MitjaGrecky/Shtuka-druka/hardware/README.md

# Hardware

KiCad 10 projects. Each board is generated by Python scripts in its `gen/` folder; CI (`.github/workflows/kicad.yml`)
runs ERC, DRC with schematic parity and exports BOM, Gerbers and placement files on every push.
Board map and reasoning: `docs/ru/29_board_map.md`.

| Board | What | Status | Spec |
|---|---|---|---|
| [`m1-screen-knobs`](m1-screen-knobs/) | 8 encoders with touch and 13-LED rings under the screen | rev 0.1, routing (see `UNROUTED`, `QUILTER.md`) | `docs/ru/30_m1_screen_knobs.md` |
| [`w1-levels`](w1-levels/) | Volume pots, P48 buttons, window for M5 | rev 0.1, routed | `docs/ru/31_w1_levels.md` |

License: CERN Open Hardware Licence Version 2 - Strongly Reciprocal (CERN-OHL-S-2.0), see `LICENSE`.
