MitjaGrecky/Shtuka-druka/hardware/for-routing/README.md

# Платы для самостоятельной разводки в EasyEDA Pro

*Подготовлено 12.11.2026. Что здесь: платы «Штуки Дрюка» с готовой схемой, контуром, крепёжными отверстиями и расстановкой деталей, которые задаёт панель. Осталось развести дорожки. Правила: [RULES.md](RULES.md), как платы соединяются: [SYSTEM.md](SYSTEM.md), детали: [COMPONENTS.md](COMPONENTS.md).*

## Состояние папки

| Плата | Что | Слои | Размер, мм | Готовность |
|---|---|---|---|---|
| [M1](M1/) | Модуль 8 ручек экрана, кольца из 12 огней, драйверы LP5864 | 4 | 224 × 34 | готова к разводке, импорт в EasyEDA проверен (M1_v2) |
| [W1](W1/) | Громкости, кнопки P48, окно под M5 | 2 | 92 × 126 | готова к разводке, импорт в EasyEDA проверен (W1_v4) |
| [M3](M3/) | Модуль Tempo + Swing: 2 энкодера, кольца из 12 огней, один LP5864, без касания (P102) | 2 | 92 × 34 | готова к разводке, импорт в EasyEDA проверен (M3_v5, rev 0.2: кольца r 15 по макету); собрана на ПК (KiCad 10, `tools/pack_easyeda.py`) |
| [M4](M4/) | Модуль FX Mix + Filter: 2 энкодера, кольца из 12 огней, один LP5864 | 2 | 70 × 34 | rev 0.2: кольца r 15 по макету, плата шире; импорт проверен (M4_v3) |
| [M5](M5/) | Модуль Gain 1 + 2 на наклоне в окне W1: кольца из 11 огней + 2 огня Clip, один LP5864 | 2 | 84 × 34 | rev 0.2: до x 99 (В1), кольца r 10,5; импорт проверен (M5_v3); окно в W1 расширяет облако |
| [W2](W2/) | Индикаторы уровня L и R на наклоне: 2 × 14 огней, два LP5864 | 2 | 35 × 126 | готова к разводке, импорт в EasyEDA проверен (W2_v4); DRC — в CI |
| [W3](W3/) | System на наклоне: Save, Project (по 2 огня), огонь записи у кармана USB/SD; один LP5864, один 74HC165 | 2 | 92 × 48 | импорт проверен (W3_v2); Power — панельная кнопка на проводе к Mini-ITX (В9), не на плате |
| [P1](P1/) | Левая дека: 19 кнопок по 2 огня, 2 × LP5864, 3 × 74HC165, мультиплексор I²C TCA9546A, шины к P2, M3, W1 | 2 | 92 × 258 | импорт проверен (P1_v2); по предложениям P99–P101 |
| [P4](P4/) | Правая дека: 20 кнопок по 2 огня, кроссфейдер (ADS1115), колесо (AS5600), мультиплексор I²C, шины к P2 и W3 | 2 | 92 × 293 | импорт проверен (P4_v2); по P99–P101, P104; деталь кроссфейдера не выбрана (P90) |
| [R2](R2/) | Управление у задней стенки: RP2350, хаб USB2514B, MIDI (DIN на гайках по кабелям, R141), 8 CV/Gate (2 × DAC80504), 4 CV-входа, синхро; 20 гнёзд 3,5 мм по 3D-модели (R142) | 4 | 175 × 103 (L, окно под DIN) | rev 0.4: расставлена, не разведена; импорт в EasyEDA — впереди |
| [P3](P3/) | Дека дорожек с ручками Level (R128: бывший M2 на этой же плате): 21 кнопка по 2 огня, 8 энкодеров с кольцами по 12 огней и касанием, 6 × LP5864, мультиплексор I²C, шины к P2, M4, W2 | 4 | 67,5 × 258 | rev 0.4, импорт проверен (P3_v5); по P99–P101 |
| M2 | ручки Level — на плате P3 (R128); `hardware/m2-levels` остаётся источником блока | — | — | отдельно не делается |
| P2 | хост | — | — | не по этому ТЗ |

Аудио (A1, R1), управление (R2), питание (PW) и наушники (F1) в эту папку не входят: по ним ещё нет утверждённых деталей.

## Что лежит в папке каждой платы

| Файл | Зачем |
|---|---|
| `<ID>_kicad7.zip` | **Это импортируем в EasyEDA Pro** (проект KiCad, формат 7: схема, плата, библиотеки) |
| `BOM.csv` | Список деталей в формате JLCPCB (Comment, Designator, Footprint, LCSC Part #) |
| `BOM_notes.csv` | То же с пометкой, проверен ли номер LCSC |
| `netlist.net` | Нетлист из схемы: сверка с тем, что получится в EasyEDA |
| `schematic.pdf` | Схема для чтения |
| `outline.dxf` | Контур платы с вырезами |
| `preview_top.png`, `preview_bottom.png` | Как выглядит плата |
| `board.json` | Размеры, отверстия, разъёмы (машинно читаемо) |

## Как открыть в EasyEDA Pro

**13.11.2026 все платы, кроме M1, импортированы заново по пунктам 7–8 ниже и проверены `tools/eda/eda_verify.py`** (цепи = netlist,
значения и LCSC на плате = design.py, DRC EasyEDA — только неразведённые связи; у W1, разведённой облаком, DRC 0). Проекты: M3_v5, M4_v3,
M5_v3, W1_v4, W2_v4, W3_v2, P1_v2, P3_v5, P4_v2; M1_v2 — референс (M1 не перепаковывалась). Старые проекты — в корзине Windows.

1. На стартовой странице EasyEDA Pro: **Файл → Импорт → KiCad** и выбрать `<ID>_kicad7.zip`. EasyEDA Pro принимает KiCad **ниже версии 10**; наши файлы в формате 7. Если импорт не примет архив целиком, соберите его сами упаковщиком KiCad (в KiCad: Файл → Архив проекта) и импортируйте результат.
2. После импорта проверьте: число деталей совпадает с BOM; в проекте две вкладки (схема и плата); размер платы по контуру совпадает с карточкой. Это первая проверка импорта; если что-то не так, пришлите мне скриншот, подправлю генератор.
3. Выгрузите нетлист (Allegro .tel) и сверьте его с `netlist.net`: число цепей и выводов должно совпасть. Расхождение значит, что импорт потерял соединение.
4. В схеме архива нет символов `PWR_FLAG`: EasyEDA превращает их в флаги с одним именем и замыкает +5V, +3V3 и GND (проверено 12.11.2026). Для KiCad они не нужны, цепи от этого не меняются.
5. **Заливки меди после импорта пересчитываются заново**: проверьте их и сделайте «Пересчитать все» (Менеджер заливок) после разводки.
6. Назначьте номера деталей LCSC там, где в BOM пусто: поиск в библиотеке EasyEDA по названию детали.
7. **Сразу после импорта, до разводки (проверено на M3, 13.11.2026):**
   - **Design → Import Changes from Schematic → Apply Changes**, затем Ctrl+S. Импорт из KiCad раздаёт деталям одного корпуса
     значение первой из них (у M3 на плате было C4 10u вместо 4.7u, C6 1u вместо 1n, C7 1u вместо 100n, R3 4.7k вместо 10k) —
     этот шаг берёт значения и LCSC из схемы. Детали не двигаются, цепи не меняются: в списке изменений только свойства.
     После него на сборочных слоях (Top/Bottom Assembly) видны имена библиотечных деталей — это не шелкография, на плату не идёт.
   - **Design → Design Rule → Physics → Via Size**: наружный диаметр мин. 0,5 / по умолч. 0,6 мм, отверстие (Via Inner Diameter)
     мин. 0,3 / по умолч. 0,3 мм. Импорт ставит их наоборот (наружный 0,3, отверстие 0,6), и автороутер EasyEDA отказывается работать.
   - Имена цепей схемы и платы в архиве уже согласованы (без «/», питание `+5V`, `GND`, `+3V3`, без цепей одиночных выводов),
     поэтому в DRC EasyEDA нет «Netlist Error». Остаются только «Clearance Error in the same footprint» у сборок резисторов
     4 × 0402 (RN): у корпуса площадки ближе общей нормы EasyEDA — так задумано производителем, не ошибка платы.
8. Автороутер EasyEDA на плотных платах (M3: LP5864 с шагом 0,4 мм) застревает на 70–80 % и дальше не идёт; дорожку по умолчанию
   для него лучше поставить 0,2 мм (Design Rule → Physics → Track). Разводку ведёт пользователь, см. «Порядок работы».

## Порядок работы (проверенный на M1/W1)

1. Сначала цепи, где важна форма (кольца огней, веера у драйверов): они уже нарисованы и закреплены, не двигать.
2. Потом питание и земля (в 4 слоях внутренний слой GND целиком).
3. Потом сигналы, самые длинные последними.
4. Встроенный автороутер EasyEDA: включить «Игнорировать сети» для GND/+5V, трассировать только внешние слои. Подробности в навыке `easyeda-pro` (раздел 10).
5. Перед отправкой: DRC, пересчёт заливок, сверка нетлиста с `netlist.net`.

## Как перегенерировать

`python3 tools/build_for_routing.py [M1 W1 ...]` из корня репозитория. Нужны KiCad 7+ (kicad-cli, pcbnew) и playwright. Исходные данные плат: `hardware/*/gen/design.py`.
