MitjaGrecky/Shtuka-druka/hardware/for-routing/SYSTEM.md

# Как платы соединяются

*По решениям R119–R124 (карта плат, документ 29; шина модулей, документ 30).*

## Шина модулей 2 × 7, шаг 1,27 мм (R123)

Одинакова на всех модулях энкодеров и на W1 (P82, ждёт ответа). Нечётные выводы в одном ряду, чётные в другом.

| Вывод | Сигнал | Вывод | Сигнал |
|---|---|---|---|
| 1 | +5V (огни) | 2 | +5V |
| 3 | GND | 4 | GND |
| 5 | +3V3 | 6 | GND |
| 7 | SDA | 8 | SCL |
| 9 | INT (открытый сток, активный 0) | 10 | GND |
| 11 | SR_LOAD (защёлка регистров, активный 0) | 12 | SR_CLK |
| 13 | SR_OUT (к хосту) | 14 | SR_IN (от следующего модуля) |

Подтяжки I²C и INT стоят на плате хоста; на модулях места под них оставлены, не запаиваются.

## Цепочка кнопок и энкодеров

Сдвиговые регистры 74HC165, вход подтянут к +3,3 В. Хост читает биты после защёлки: первым регистром своей платы, потом регистры следующего модуля (через SR_IN → SR_OUT). Порядок бит на M1: E1 A, E1 B, E1 кнопка, E2 A, … E8 кнопка (24 бита). На W1: D7 = P48 1, D6 = P48 2, D5–D0 = 1, затем регистры M5.

## Адреса I²C

| Устройство | Адрес | Где |
|---|---|---|
| LP5864 (драйвер огней) | адрес задаётся выводами ADDR1/ADDR0 (биты 1 0 0 ADDR1 ADDR0; A = 00, B = 01, C = 10, D = 11), на плате они заведены на GND или +3V3; числовой адрес сверить по даташиту | M1 и модули: A–D |
| CY8CMBR3108 (касание) | 0x37 | M1 (и M2): два модуля с касанием на разных шинах (R124) |
| ADS1115 | 0x48 | W1 |
| IS31FL3218 | 0x54 | W1 |

Больше четырёх LP5864 на одной шине быть не может: платы, где драйверов больше, нужно разводить по разным шинам или ставить коммутатор шины. **Это открытый вопрос системы** (в запись решений не вносил, предложение в `notes/handoff.md`).

## Питание

+5 В огней: до ≈ 0,7 А на модуль в худшем случае (всё белым на полную), обычно ≈ 0,1 А; +3,3 В: логика, регистры, касание. Прошивка ограничивает общий ток.
