MitjaGrecky/Shtuka-druka/hardware/for-routing/M1/IMPORT_CHECK.md

# M1: проверка импорта в EasyEDA Pro V3.2.209 (12.11.2026)

Импорт `M1_kicad7.zip` (KiCad 7) прошёл, проект открылся: схема и плата.

| Проверка | Результат |
|---|---|
| Детали | 163 из 163 (совпадают с `netlist.net`) |
| Цепи (выгрузка Allegro .tel против `netlist.net`) | 143 совпали полностью |
| Питание | **ОШИБКА**: GND (69 выводов), +3V3 (52), +5V (19) склеились в одну цепь `power_+3V3` (140 выводов; C1.1 и C1.2 в одной цепи) |
| Плата (контур 224 x 34, 7 отверстий, 8 энкодеров) | открылась, расположение сохранено |

Вывод: в схеме импорт принимает KiCad-символы питания (`power:GND`, `power:+3V3`, `power:+5V` со скрытым выводом) и склеивает их.
Нетлист платы после импорта не проверен (цепи платы EasyEDA берёт из `.kicad_pcb`, нужно сравнить на панели Net).
Предположение (не проверено): заменить символы питания на глобальные метки (`global_label`) или на порты питания EasyEDA в генераторе схемы.

## Причина и исправление (12.11.2026, вечер)
- ПК проверил через API: цепи **платы** после импорта верны (M1 146/146, W1 35/35), склейка только в **схеме**.
- Причина (ПК): три символа `PWR_FLAG` импортируются как флаги с одним именем `power_PWR_FLAG`, одно имя = одна цепь, поэтому +5V, +3V3 и GND замыкаются.
- Исправление: `tools/pack_for_routing.py` убирает `PWR_FLAG` из схемы в архиве для EasyEDA (в репозитории схема не меняется).
  Проверка в KiCad: схема из нового архива даёт те же цепи, что `netlist.net` (M1 149/149, W1 45/45).
- До повторной проверки в EasyEDA: в старых проектах M1_kicad7 / W1_kicad7 не делать «Обновить плату из схемы». Новые архивы импортировать заново.

## Повторная проверка (12.11.2026, ПК, через API)
Новые архивы без `PWR_FLAG`, проекты M1_v2 и W1_v2: схема и плата совпали с `netlist.net` полностью
(M1 146/146, W1 35/35 цепей с 2 и более выводами; 163/163 и 38/38 деталей). **M1 и W1 готовы к разводке в EasyEDA.**
