MitjaGrecky/Shtuka-druka/mockup/shtuka_druka_mockup_1to1.pdf

# SHTUKA DRUKA

Cardboard mockup 1:1 - panel v7 - body 515 x 460 mm, 68 mm front, 143 mm rear

PRINTING

Print at 100% / Actual size. Do NOT use "Fit to page". A4 paper.

Every sheet has a 100 mm bar at the bottom. Measure it before cutting.

JOINING SHEETS

Sheets overlap by 10 mm. On a sheet with a neighbour to the right or above,

the shaded GLUE band shows where the next sheet goes.

Trim the next sheet along its CUT edge, lay it on the band, align the drawing

and the 50 mm grid lines, glue. The mini map (top right) shows the sheet position.

PARTS

Top panel | 515 x 300 | 1 | printed
Screen panel | 515 x 150 | 1 | printed, cut out screen
Rear shelf | 515 x 30 | 1 | printed (rear jack labels)
Side profile | 460 x 143 | 2 | printed
Rear panel | 515 x 143 | 1 | printed
Front panel | 515 x 68 | 1 | printed
Base | 515 x 460 | 1 | cut by ruler
Wrist rest | 221.5 x 70, h 58/24 | 1 set | profile printed

ASSEMBLY

1. Glue the printed sheets onto cardboard (3-5 mm), then cut along the thick outer lines.
2. Base 515 x 460. Glue both side profiles on its left and right edges, standing up.
3. Glue the front panel (68 high) and rear panel (143 high) between the sides.

With board thickness t, shorten front, rear, top and screen panels by 2t in width.

4. Glue the top panel flat at 68 mm, the screen panel on the 30 deg slope, the rear shelf on top.
5. Glue the wrist rest in front of the device, between x = 110 and 331.5 mm (under the pads).
6. Knobs: bottle caps or coins on the circles. Wheel: 38 mm lid. Pads: 25.5 x 21 mm pieces.

WHAT TO CHECK

Sit as you normally work. Reach Capture, the 8 screen knobs, the wheel and Filter without stretching.

Two fingers on one pad: is 25.5 mm wide enough? Do palms on the touch strip get in the way?

Wheel next to the slope: is there room for your knuckles? Is the screen readable?

Do your wrists rest comfortably while playing the pads? Note anything awkward.

Positions from layout_v7.json (doc 27, decision R107). Internals are estimates.

SHTUKA DRUKA - cardboard mockup 1:1

Top panel - 1 pc - sheet 1 of 4 (column 1, row 1 from bottom)

CHECK: this bar must measure exactly 100 mm. If not, reprint at 100% / Actual size.

- Rec | ▶ Play | ■ Stop
Restart | Metronome | Tap
Capture | Resample
Undo | Redo | Delete
Duplicate | Double | New
◄ | touch strip 181.5 mm

FRONT EDGE

GLUE - next sheet (column 2) goes here

GLUE - next sheet (row 2) goes here

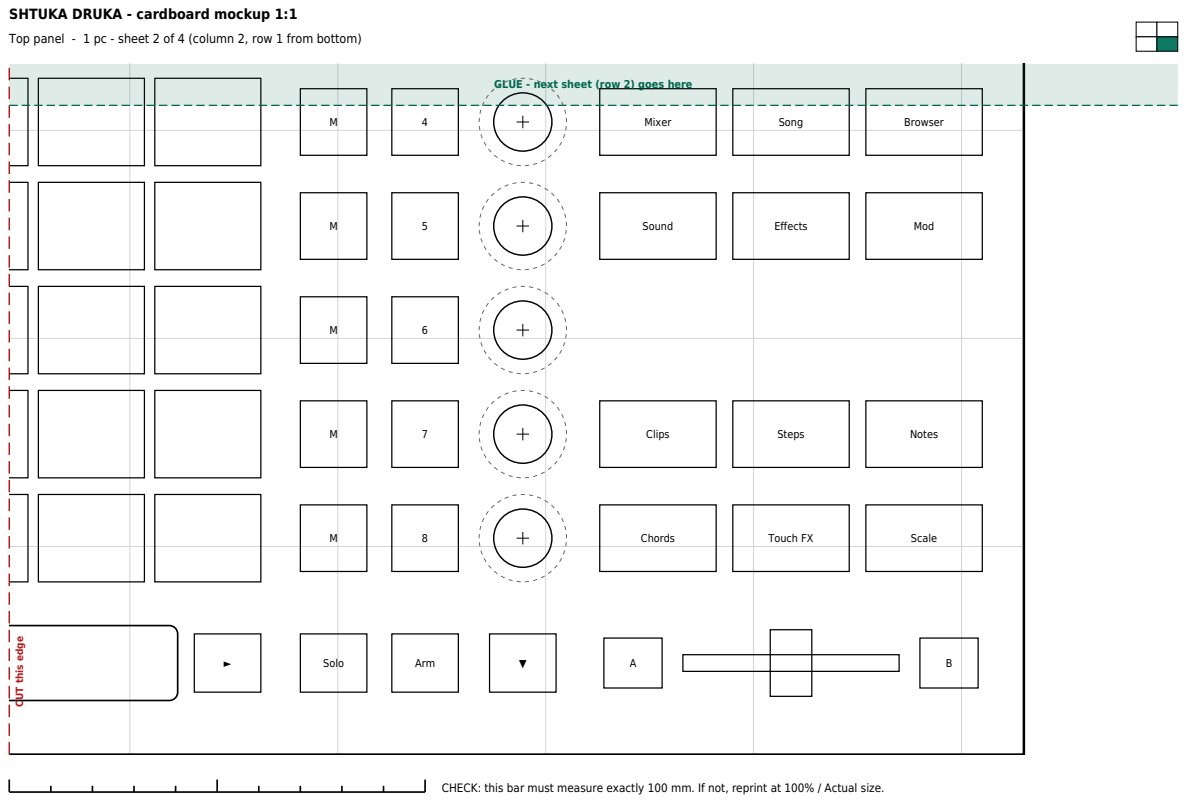
[picture p1: page 3]
touch strip 181.5 mm; Solo; Arm; Chords; Touch FX; Scale; Clips; Steps; Notes; Sound; Effects; Mod; Mixer; Song; Browser; FRONT EDGE

Top panel - 1 pc - sheet 2 of 4 (column 2, row 1 from bottom)

GLUE - next sheet (row 2) goes here

CUT this edge

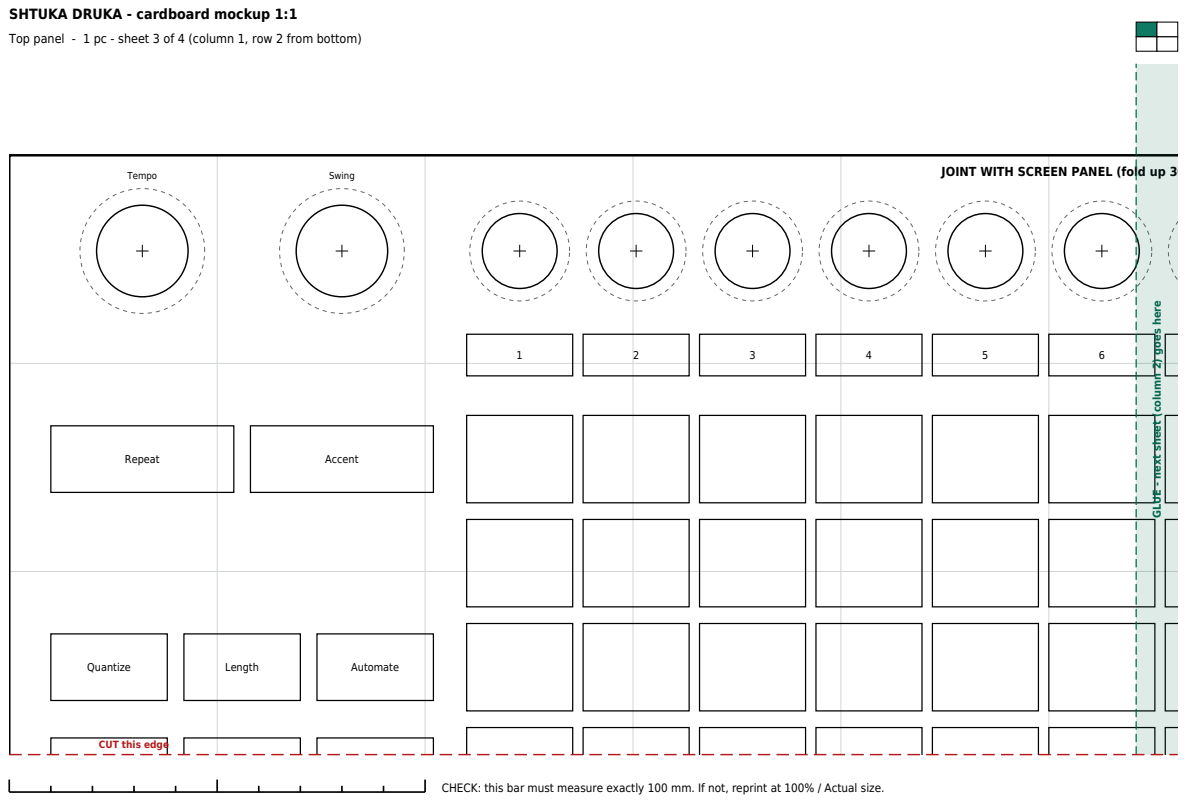
[picture p2: page 4]
Quantize; Length; Automate; Repeat; Accent; Tempo; Swing

Top panel - 1 pc - sheet 3 of 4 (column 1, row 2 from bottom)

JOINT WITH SCREEN PANEL (fold up 30 deg) GLUE ⁻ next sheet (column 2⁾ goes here

CUT this edge

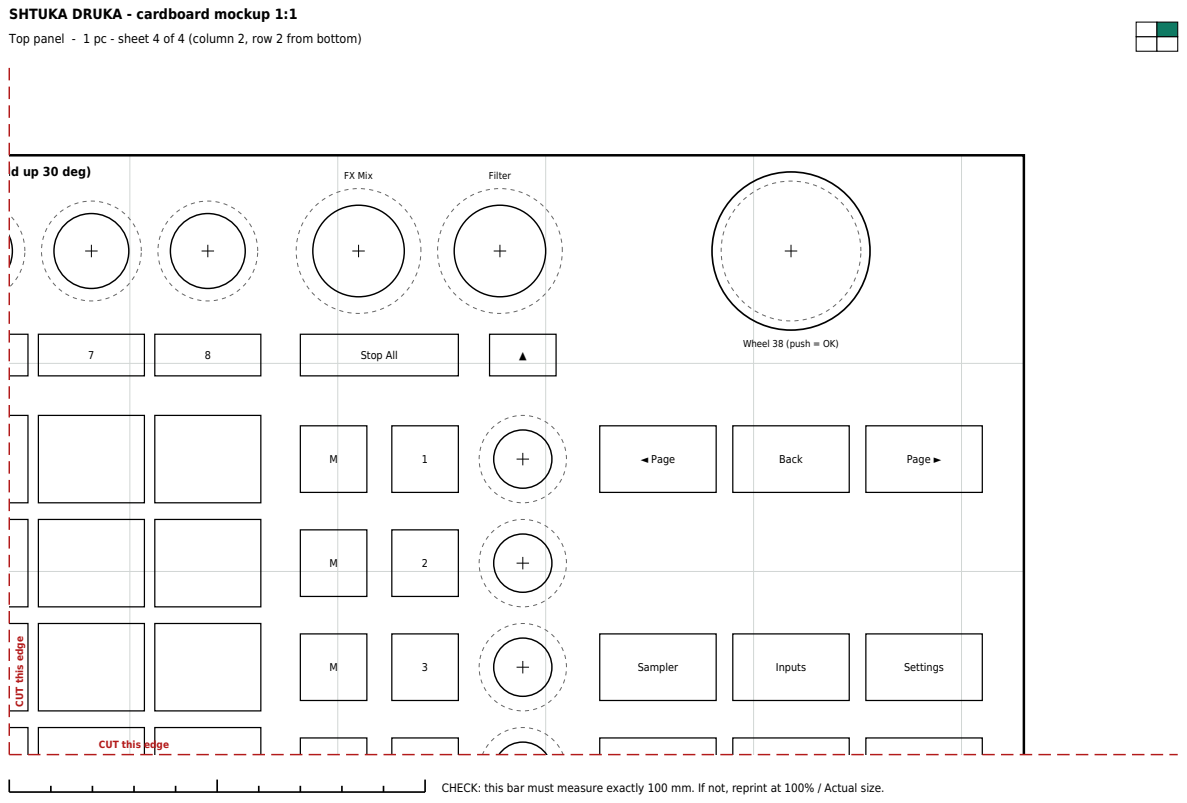
[picture p3: page 5]
Stop All; FX Mix; Filter; Sampler; Inputs; Settings; ◄ Page; Back; Page ►

Top panel - 1 pc - sheet 4 of 4 (column 2, row 2 from bottom)

JOINT WITH SCREEN PANEL (fold up 30 deg) CUT this edge

Wheel 38 (push = OK)

CUT this edge

Screen panel (30 deg slope) - 1 pc - sheet 1 of 2 (column 1, row 1 from bottom)

Main | Cue Mix
Phones 1 | Phones 2
Gain 1 | Gain 2
P48 | P48
CUT | OUT: screen window 223 x 141

dashed = active area 217.5 x 135.6 (10.1", 1280 x 800)

dotted = touch glass 239 x 147 behind the panel (Waveshare 10.1DP-CAPLCD)

ticks = screen columns, same x as the knobs and pad columns

GLUE - next sheet (column 2) goes here

Screen panel (30 deg slope) - 1 pc - sheet 2 of 2 (column 2, row 1 from bottom)

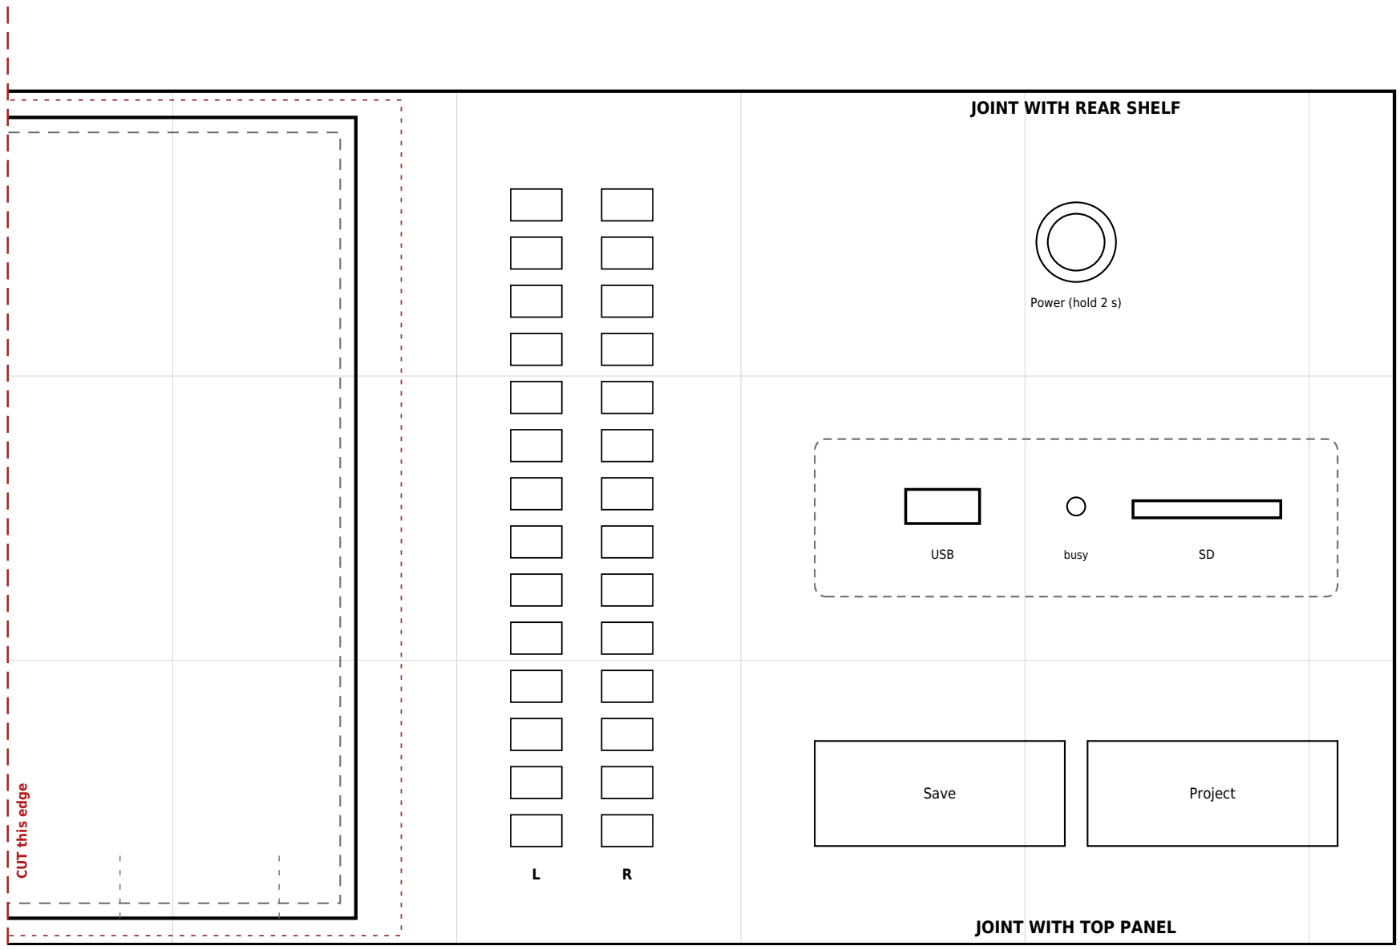
[picture p4: figure]
Save; Project; USB; busy; Power (hold 2 s); JOINT; WITH TOP PANEL; WITH REAR SHELF; CUT this edge

Rear shelf (rear jack labels, R73) - 1 pc - sheet 1 of 2 (column 1, row 1 from bottom)

Audio In

Mic/Line 1-2, Hi-Z 1-2

Line 1-8, Phono L R, GND

Audio Out

Main L R, Aux L R

RCA L R

JOINT WITH SCREEN PANEL

GLUE - next sheet (column 2) goes here

Rear shelf (rear jack labels, R73) - 1 pc - sheet 2 of 2 (column 2, row 1 from bottom)

Control

MIDI In 1-2, Out 1-4, TRS In, O1, O2

Clock, Reset, CV In 1-4, CV 1-8

Power / USB

LAN, USB-A, USB-C (PC)

DC 12-24V, On/Off

JOINT WITH SCREEN PANEL

CUT this edge

Side profile - 2 pcs - sheet 1 of 2 (column 1, row 1 from bottom)

Mini-ITX, ~45 high

panel PCB layer

FRONT 68

SIDE PROFILE - cut 2 (flip the second one)

GLUE - next sheet (column 2) goes here

Side profile - 2 pcs - sheet 2 of 2 (column 2, row 1 from bottom)

audio board

battery bay (right side)

rear jack board

REAR 143

### 30 deg

CUT this edge

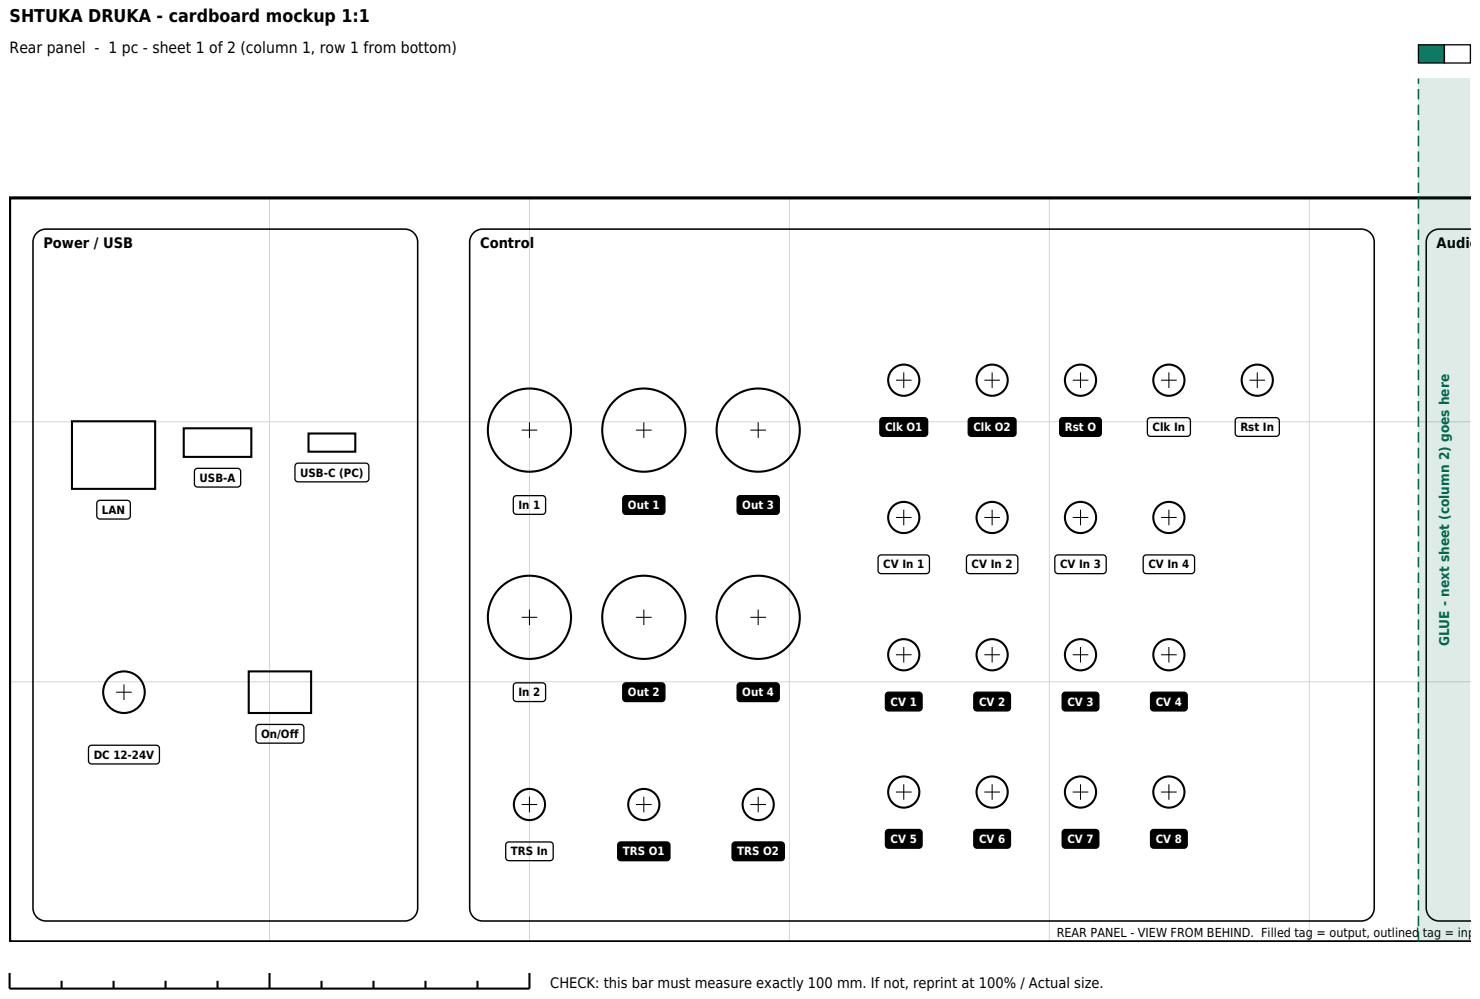
[picture p5: page 12]
Power / USB; LAN; USB-A; USB-C (PC); On/Off; Control; Out 1; Out 3; Out 2; Out 4; TRS In; TRS O1; TRS O2; Clk O1; Clk O2; Rst O; Clk In; Rst In; Audio Out

Rear panel - 1 pc - sheet 1 of 2 (column 1, row 1 from bottom)

REAR PANEL - VIEW FROM BEHIND. Filled tag = output, outlined tag = input. Circles = hole diameters. GLUE ⁻ next sheet (column 2⁾ goes here

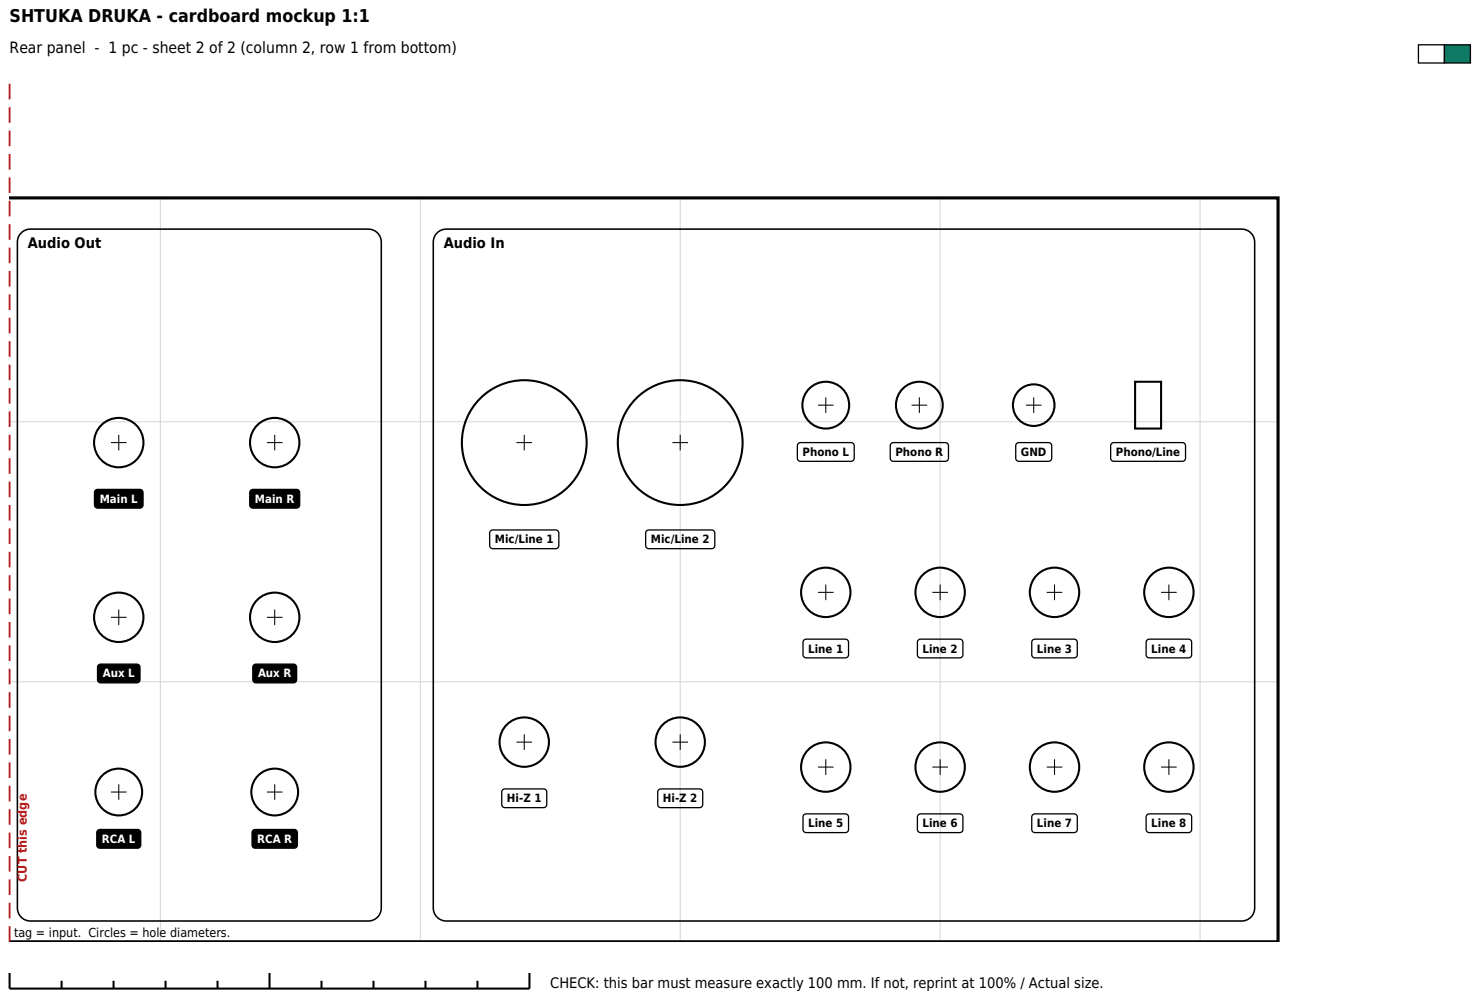
[picture p6: page 13]
Audio Out; Main L; Main R; Aux L; Aux R; RCA L; RCA R; Audio In; Mic/Line 1; Mic/Line 2; Phono L; Phono R; GND; Phono/Line; Line 1; Line 2; Line 3; Line 4; Line 5; Line 6; Line 7; Line 8

Rear panel - 1 pc - sheet 2 of 2 (column 2, row 1 from bottom)

REAR PANEL - VIEW FROM BEHIND. Filled tag = output, outlined tag = input. Circles = hole diameters. CUT this edge

Front panel - 1 pc - sheet 1 of 2 (column 1, row 1 from bottom)

Phones 1 | Phones 2

wrist rest goes here (x 110-331.5, as wide as the pad grid)

FRONT PANEL - VIEW FROM FRONT GLUE ⁻ next sheet (column 2⁾ goes here

Front panel - 1 pc - sheet 2 of 2 (column 2, row 1 from bottom)

FRONT PANEL - VIEW FROM FRONT CUT this edge

Wrist rest + parts cut by ruler - profile: 2 pcs - sheet 1 of 1 (column 1, row 1 from bottom)

WRIST REST PROFILE - cut 2

58

24

70

device side

CUT BY RULER (no template needed):

Base of the device 515 x 460

Wrist rest top 221.5 x 78 (sloped)

Wrist rest back 221.5 x 58

Wrist rest front 221.5 x 24

Wrist rest base 221.5 x 70
