MitjaGrecky/Shtuka-druka/docs/ru/README.md

# Штука Дрюка: документы — карта

*Что где лежит и что из этого стоит читать. Решения — в [`decisions/`](decisions/README.md), они главнее любого документа. Обновлено 06.11.2026.*

**Статусы:** **рабочий** — по нему сейчас делаем; **справка** — исследование, из которого выросли решения, читать нужный раздел, когда возвращаемся к теме; **частично** — часть разделов заменена (указано, какие); **архив** — заменён целиком, лежит в [`archive/`](archive/).

Номера документов не меняются: на них ссылаются решения («13, раздел 3.5»).

## Рабочие: по ним делаем сейчас

| № | Документ | Блок решений | Что внутри |
|---|---|---|---|
| 27 | [Панель v7](27_panel_v7_layout.md) | 03_panel | Действующая раскладка: дизайн-система, блоки в мм, проверки, объём при глубине 460 мм |
| 24 | [Какие кнопки нужны](24_panel_buttons_list.md) | 02_controls | Состав органов (75 кнопок, 22 энкодера…) по сценариям; логика Rec (раздел 6) |
| 29 | [Карта плат](29_board_map.md) | 08_boards | Какие платы, где, размеры, связи между ними |
| 30 | [M1 — ручки экрана](30_m1_screen_knobs.md) | 08_boards | Первая плата: кольца огней, касание, разъём модулей, плата, свет, файлы |
| 31 | [W1 Levels](31_w1_levels.md) | 08_boards | Следующая плата: потенциометры громкостей, P82–P85 |
| 32 | [Реальные детали в корпусе](32_fit_real_parts.md) | 04_enclosure | Кроссфейдер, колесо, экран, USB-A по даташитам; P90–P96 |
| 33 | [M1 — разбор и выводы](33_m1_review.md) | 08_boards | Почему M1 не разводится (тесно у U1), слабые места, ошибки планирования, 1/2/4 драйвера, пакет улучшений |
| 34 | [Платы задней стенки](34_rear_boards_research.md) | 06_audio, 05_io, 07_compute_power | R1, A1, R2, F1, PW: что на какой плате, живые микросхемы вместо снятых THAT, фантом, MIDI 3,3 В, CV, питание 19 В для Mini-ITX, номера LCSC |
| 19 | [Протокол SDP v0](19_panel_protocol.md) | 08_boards | Обмен платы ↔ вычислитель: кадр, сообщения, задержки, безопасность |
| 20 | [Звуковая карта для компьютера](20_usb_audio_interface.md) | 06_audio | Два порта xcore.ai, каналы, тактирование, 48/96 кГц |
| 21 | [Аудиоплата](21_audio_board.md) | 06_audio | **Частично:** блок-схема, тактирование, управление — действуют; микросхемы (раздел 2) заменены документом 28 |
| 28 | [Входы и преобразователи](28_mic_inputs_and_converters.md) | 06_audio | Входы с двумя путями, Cirrus Logic Pro (R116–R118) |
| 15 | [Аудиовыходы](15_outputs_research.md) | 06_audio, 05_io | Набор выходов, уровни, педальная петля |
| 16 | [Эффекты и открытый проект](16_effects_and_open_source.md) | 09_software, 01_project | Назначаемые эффекты, лицензии, урок самодельных прошивок |
| 18 | [Замер мощности](18_benchmark_m93.md) | 07_compute_power | Как мерить дорожки на M93; результат на Dell (раздел 5); ждёт запуска |

## Справка: исследования, из которых выросли решения

| № | Документ | Блок решений | Когда открывать |
|---|---|---|---|
| 09 | [Органы управления](09_controls_research.md) | 02_controls, 03_panel | Энкодеры (1), колесо (2), кнопки (3), кроссфейдер и полосы (4), сетка (5), 16+ дорожек (6). Раздел 6.2 и колесо по сетке из 6.3 устарели (R15, R94) |
| 11 | [Входы, выходы, форматы](11_io_formats_research.md) | 05_io, 06_audio | Входы (2), MIDI/CV/синхро (4), USB (5), хранилище (6), форматы (7), питание и земля (8). Раздел 3 заменён документом 15 |
| 13 | [Корпус и компоновка](13_enclosure_layout_research.md) | 04_enclosure, 05_io | Габариты конкурентов (1), нормы (2), **задняя панель (3) — действует**, Kickstarter (5). Макет v3 (раздел 4) устарел |
| 12 | [Вычислительная мощность](12_compute_research.md) | 07_compute_power | Платформы, бенчмарки, сменный модуль (5, 6) |
| 10 | [RGB и экран](10_rgb_and_screen_research.md) | 03_panel, 08_boards | Драйверы и шум (2, 4), светопроводы (5), экран (6). Расчёт раздела 3 сделан для старого варианта B |
| 22 | [Кнопки и навигация у других](22_buttons_navigation_research.md) | 02_controls | Как устроены чужие панели, общий «язык кнопок» |
| 23 | [Разбор v4 и наброски v5](23_v4_explained_v5_proposals.md) | 02_controls | **Принципы пользователя** (раздел 0, R89), частота (6, R90), фильтр высоты (7, R91), Push (8, R92), ориентация сетки (9, R93). Наброски v5 устарели |
| 25 | [Панель v5 в мм](25_panel_v5_layout.md) | 03_panel | **Частично:** как рисуем ручки (2.1, R98), полоса под пэдами (2.3, R105). Сама раскладка заменена v7 |
| 08 | [Модель управления](08_interaction_model.md) | 02_controls | **Частично:** правила логики, язык светодиодов, дисплей. Страницы-глаголы и «8 дорожек = 8 строк» устарели (R94, R11) |
| 06 | [Эргономика грувбоксов](06_ergonomics_research.md) | 01_project | Что нужно, что лишнее; классификация функций |
| 04 | [Отзывы о грувбоксах](04_doc_groovebox_reviews.md) | 01_project | Что хвалят, что раздражает, чего не хватает |
| 03 | [Открытые проекты](03_doc_open_source_analysis.md) | 09_software | OTTO, Zynthian, SamplerBox, разбор кода Behringer Kick |

## Архив: заменены целиком

| № | Документ | Чем заменён |
|---|---|---|
| 05 | [Панель v1](archive/05_panel_layout_draft.md) | v7 (27) |
| 07 | [Панель v2](archive/07_panel_layout_v2.md) | v7 (27) |
| 17 | [Аудит и макет v4](archive/17_layout_v4_ergonomics.md) | v5 → v7 (R94, R107); нормы эргономики из раздела 1 собраны в навыке `shtuka-druka-design-rules` |
| 26 | [Панель v6](archive/26_panel_v6_layout.md) | v7 (27) |

Документы 00 (инструкции для Claude) и 02 (личные данные) в репозиторий не выкладываются (R77).

## Где ещё что лежит

- `hardware/<плата>/` — KiCad, генераторы `gen/*.py`, `QUILTER.md`, `UNROUTED`.
- `mockup/` — шаблоны 1:1 и скрипты раскладки `layout/`. `model3d/` — 3D-модель и `fit/` (проверка деталей в Blender).
- `notes/handoff.md` — очередь задач между облачной и локальной сессиями Claude.
