MitjaGrecky/Shtuka-druka/hardware/for-routing/W1/README.md

# W1: Levels (наклон слева), ревизия 0.1

| | |
|---|---|
| Размер | 92 × 126 мм, 2 слоя, 1,6 мм |
| Закреплено | 4 потенциометра RK09K (валом в точку панели), 2 кнопки P48 с огнями, 6 отверстий M2, разъёмы J1 (к P1) и J2 (к M5) |
| Вырез | окно 85 × 35 мм под модуль M5 rev 0.2 (перемычки слева 4,5 мм, справа 2,5 мм пропускают питание, I²C и регистры) |
| Сверху | потенциометры, кнопки, огни; снизу микросхемы и разъёмы |
| Микросхемы | ADS1115 (громкости), 74HC165 (кнопки P48), IS31FL3218 (огни P48) |
| Деталей | 38 |

В репозитории (`hardware/w1-levels`) эта плата уже разведена Freerouting; здесь она без дорожек, чтобы вы развели сами. Заливка GND с обеих сторон после трассировки, сшивка ≈ 4 мм. Силовые 0,3 мм (к выводу QFN с шагом 0,5 мм 0,4 мм не подходит).
