MitjaGrecky/Shtuka-druka/docs/ru/decisions/README.md

# Штука Дрюка: решения — индекс

*Единственное место, где видно, что решено. Если документ противоречит решениям, правы решения; из двух решений прав больший номер R. Последнее обновление: 06.11.2026 — журнал разбит на блоки (раньше один файл `14_decisions_log.md`, 50 КБ); добавлены предложения P97 (крепление M1) и P98 (M1 из двух ячеек).*

## Как пользоваться

1. Этот файл читать всегда: он короткий, здесь приоритеты и где что лежит.
2. Файл блока открывать, только если задача его касается. В каждом блоке сверху то, что ждёт ответа, потом «Действует», внизу «Заменено» (историю можно не читать).
3. Архив (`99_archive.md`): судьба старых предложений, закрытые вопросы, устаревшие документы. Нужен только для истории.

## Блоки

| Файл | О чём | Решения | Ждёт ответа |
|---|---|---|---|
| [01_project](01_project.md) | Зачем Штука, этапы, открытость, лицензии, язык надписей | R1–R9, R20, R25, R27, R28, R45, R69, R77 | — |
| [02_controls](02_controls.md) | Логика работы: сетка, дорожки, режимы, навигация, запись, принципы кнопок | R7, R11–R17, R46–R53, R89–R97, R99, R111, R112 | — |
| [03_panel](03_panel.md) | Раскладка панели и органы: v7, экран, полоса, ручки | R10, R13, R18, R41–R42, R50, R62–R63, R74–R75, R98, R100–R108, R110, R113 | — |
| [04_enclosure](04_enclosure.md) | Корпус, отсек аккумулятора, макет, посадка реальных деталей | R43, R44, R109 | P90–P96 |
| [05_io](05_io.md) | Гнёзда: аудио, MIDI, CV, синхро, USB, задняя панель | R3, R8, R22–R26, R32–R39, R55–R56, R60, R68, R71–R73, R78–R81, R144–R145 | — |
| [06_audio](06_audio.md) | Электрика звука: преобразователи, входы, выходы, генераторы, USB-аудио | R16, R64–R67, R82–R84, R87–R88, R114, R116–R118, R135–R137 | — |
| [07_compute_power](07_compute_power.md) | Mini-ITX, стенд разработки, аккумулятор и питание | R19, R36, R40, R58, R59, R76, R146, R147 | — |
| [08_boards](08_boards.md) | Карта плат, RP2350, протокол, огни, модули M1–M5, W1, кто разводит | R51, R54, R85, R86, R115, R119–R134, R138–R143, R148 | P75, P82–P85, P97, P98, P101–P105 |
| [09_software](09_software.md) | Система, обновления, SDK, дорожка и эффекты, хранение, экспорт | R21, R29–R31, R38, R47, R57, R61, R70 | — |
| [99_archive](99_archive.md) | История: что во что превратилось, закрытые вопросы, устаревшие документы | — | — |

Свободные номера: следующее решение **R149**, следующее предложение **P106**. Номера не переиспользуются.

## Приоритеты: что ждёт ответа

**1. Блокирует текущую плату M1**
- **P98** — M1 из двух одинаковых ячеек по 4 ручки (свой драйвер огней в каждой); прототип — одна ячейка. Решает, что разводим дальше. → [08_boards](08_boards.md)
- **P97** — крепление M1: вставки M2 в световоде, +3 отверстия (x ≈ 56, 112, 168). Нужно до финальной разводки. → [08_boards](08_boards.md)
- **P75** — кто разводит платы (Claude: схемы, скрипты, проверки; сложное — Quilter). Фактически так уже работаем, нужно формальное «да» или правка. → [08_boards](08_boards.md)

**2. Следующая плата W1 Levels** (документ 31)
- **P82–P85** — шина 2 × 7 вместо аналогового шлейфа, огни Clip на M5, кнопки P48, высота 8,5 мм. → [08_boards](08_boards.md)

**2а. Остальные цифровые платы** (ТЗ `hardware/for-routing/SPEC_boards.md`, 12.11.2026)
- **P99–P105** — мультиплексоры I²C на деках, шина дек 2 × 8, 2 огня на кнопку, модули без касания, M5 с огнями Clip, кроссфейдер и колесо на P4, карман USB/SD. → [08_boards](08_boards.md)

**3. Механика корпуса** (документ 32; нужно до картонного макета и заказа деталей)
- **P90–P96** — кроссфейдер, колесо, сдвиг экрана на 1 мм, USB-A в System, плата F1, разъёмы экрана (угловые HDMI или шлейф), слот SD. → [04_enclosure](04_enclosure.md)

## Открытые вопросы

| № | Вопрос | Когда нужен ответ | Где |
|---|---|---|---|
| В8 | Задняя панель после R32–R37: проверить раскладку на прототипе корпуса | на картонном макете (R43) | 13, раздел 3.5 |
| В9 | Сколько эталонных дорожек тянет M93 (уровень Pi 5) и N100. Dell i7-8650U: ≈ 64 на 8 потоках, стабильно только под Linux | до выбора платы Mini-ITX | 18 |

## Где мы сейчас

- Панель v7 принята предварительно (R107), карта плат — R119, R120.
- **Первая плата M1** (R121–R127): схема и расстановка готовы, разводка упёрлась в один драйвер на 104 огня (до 44 цепей в щели между энкодерами). Quilter job C остановлен 06.11 (2 ч, 0 разведённых кандидатов). Предложено деление на две ячейки (P98) и крепление (P97); анализ на ПК — `notes/handoff.md` #4.
- Дальше: W1 Levels (документ 31), картонный макет 1:1 (R43), проверка корпуса в Blender (`model3d/fit`).

## Правила ведения

- В R — только то, что сказал пользователь, лучше с цитатой «…». Свои выводы — в P. «Наверное», «скорее» — R с пометкой «предварительно».
- Короткое «да», «окей», «принимаю» на прямой вопрос о P — перенос P в R; строка P уходит из блока, в архив дописывается «Pn — как Rm».
- Новое R, отменяющее старое: старую строку не править по смыслу, перенести в «Заменено» своего блока со стрелкой «→ Rm», в устаревший документ — пометку «> **Обновление ДД.ММ.ГГГГ:** …».
- Каждое решение — ровно в одном блоке. Если касается двух, кладём туда, где его будут искать при работе, а в другом блоке ничего не дублируем.
- После изменения: обновить строку блока в таблице выше, приоритеты и «Где мы сейчас».
