MitjaGrecky/Shtuka-druka/hardware/for-routing/SPEC_boards.md

# ТЗ: принципиальные схемы цифровых плат (M3–M5, P1, P3, P4, W2, W3)

*Обновлено 13.11.2026 по решениям R128–R134: ручки Level (бывший M2) на плате P3, P99/P100 приняты (R129, R130), радиус колец по макету (R131), M5 до x 99 (R132), Power на проводе (R133), задел под нажатие колеса (R134).*

*12.11.2026, облако → локальная сессия. Исполнитель пишет генераторы и схемы. Источник координат — `mockup/layout/layout_v7.json`
(x — от левого края панели, y — от переднего края; кнопки и ручки заданы центром). Всё, что помечено **P101–P105**, —
предложения облака (ещё не решения пользователя): делать по ним, но так, чтобы их было легко поменять одной константой.*

## 1. Как делать (образец — W1)

- Каждая плата — своя папка `hardware/<id>-<name>/` с `gen/design.py` (детали, цепи, места), `gen/make_sch.py`, `gen/make_pcb.py`,
  `gen/check_netlist.py`, как у `hardware/w1-levels/`. Писатель схемы и платы — общий из `hardware/m1-screen-knobs/gen/`
  (W1 показывает, как его подключить). Повторяющиеся блоки лучше вынести в общий модуль `hardware/common/gen/kit.py`:
  разъём шины, LP5864 с обвязкой, цепочка 74HC165 с подтяжками, кнопка с 2 RGB, кольцо огней, отверстия.
- Формат файлов KiCad 7 (как сейчас), библиотека проекта — `hardware/m1-screen-knobs/lib/` (LP5864, XL-1615RGBC-RF,
  энкодер EC11E с кольцом, VQFN-32). Новые символы и посадочные места — туда же.
- **`PWR_FLAG` можно ставить** (для ERC KiCad): упаковщик для EasyEDA их убирает.
- Готовность схемы: ERC KiCad 10 без ошибок; `check_netlist.py` — нетлист схемы = `design.py`, 0 расхождений.
- Плата (желательно, если успеваете): контур, отверстия, закреплённые органы панели на своих местах (кнопки, огни, энкодеры, разъёмы),
  прочие детали рядами на нижней стороне, без разводки. Это и есть «макет с креплениями» для ручной разводки.
- Упаковка: добавить платы в `tools/boards_extra.py` (словарь `BOARDS` как в `tools/build_for_routing.py`), запустить
  `python tools/build_for_routing.py <ID>`; проверить импорт в EasyEDA через мост (как M1_v2).
- Надписи на плате только английские (R45). Детали — розничные (R28), номера LCSC брать из `hardware/for-routing/COMPONENTS.md`.

## 2. Общие узлы

| Узел | Деталь | LCSC | Как |
|---|---|---|---|
| Огни | XL-1615RGBC-RF (1 красный катод, 2 общий анод, 3 зелёный, 4 синий) | C965840 | Анод на линию SW драйвера, катоды на тройку CS |
| Драйвер огней | TI LP5864RSMR, VQFN-32 | C5220564 | 4 SW × 18 CS = 24 RGB. Выводы как в M1 rev 0.5 (`m1-screen-knobs/gen/design.py`, ветка `LP`): 1 VCC +5V, 15 VLED +5V, 25 VCAP, 26/27/33 GND, 28 SCL, 29 SDA, 30 ADDR0, 31 ADDR1, 32 VIO_EN +3V3, CS0–8 = выводы 2–10, CS9–17 = 16–24, SW0–3 = 11–14. Обвязка: 1 мкФ VCC, 4,7 мкФ VLED, 1 мкФ VCAP, 1 нФ VIO_EN. Адрес — ADDR1/ADDR0 на GND или +3V3 |
| Кнопки | Тактовая TS-1187A-B-A-B на землю | C318884 | Подтяжка 10 кОм (сборка 4 × 10 кОм C25725) к +3V3, вход 74HC165 |
| Подсветка кнопки (P84) | 2 × XL-1615 слева и справа от кнопки, ±6,5 мм от центра по x (у кнопок шириной 16 мм — ±5,5) | — | Оба огня кнопки на одной SW и одной тройке CS не обязательно; удобная раскладка — на усмотрение исполнителя |
| Чтение кнопок и энкодеров | 74HC165PW, TSSOP-16 | C80696 | Цепочка: Q7 первого регистра → SR_OUT разъёма; DS последнего ← SR_IN (подтяжка 10 кОм к +3V3); неиспользуемые входы на +3V3; 100 нФ на каждый |
| Энкодеры | Alps EC11E гладкий с кнопкой, `ShtukaDruka:RotaryEncoder_Switch_Touch` | — | A, B, кнопка → 74HC165; общий C и S2 на GND; MP — на касание (M2) или на GND (M3–M5) |
| Кольца | 12 огней на дуге 270°, пара колец = один LP5864, раскладка как `led_matrix()` M1 rev 0.5 | — | **Радиус кольца = поле `ring` в `layout_v7.json` / 2 (R131)**: M3, M4 — 15 мм; M5 и Level — 10,5 мм |
| Отверстия | M2, `MountingHole_2.2mm_M2` | — | По углам (2,6 мм от краёв) и не реже чем через 60 мм вдоль длинной стороны; не под органами панели |

**Шина модулей 2 × 7, 1,27 мм (R123)**, разъём C5372811 (выводной PZ127-2-07-Z; C3975190 — SMD-вариант, не брать): 1/2 +5V, 3/4/6/10 GND, 5 +3V3, 7 SDA, 8 SCL, 9 ~INT, 11 ~SR_LOAD, 12 SR_CLK,
13 SR_OUT (к хосту), 14 SR_IN (от следующего). Подтяжки I²C и INT — только на P2 (на модулях места DNP, как у M1).

**R130 (было P100) — шина дек 2 × 8, 1,27 мм (P2 ↔ P1, P3, P4):** выводы 1–14 как у шины модулей, 15 — AUX (не используется, резерв), 16 — GND.
По +5V через два провода шлейфа идёт ток огней деки и её модулей; посчитать худший случай и записать в README платы.

**R129 (было P99) — I²C через мультиплексор на каждой деке:** на P1, P3, P4 стоит TCA9546A (4 канала, TSSOP-16; адреса 0x70 P1, 0x71 P3, 0x72 P4,
A2–A0 перемычками). Канал 0 — устройства самой деки, каналы 1–3 — разъёмы модулей по одному на канал. Тогда на любом канале не больше
4 драйверов LP5864, а контроллеры касания (у всех 0x37) не встречаются. ~INT модулей идут насквозь на разъём деки. Номер LCSC TCA9546A
найти и записать в COMPONENTS.md со статусом «проверить». Вариант без мультиплексора — разные адреса LP5864 перемычками и не больше 4 на шину;
он не сходится для P3 (M2 сам по себе 4 драйвера).

**Цепочка регистров деки:** хост (P2) → SR_OUT деки; дека читает сначала свои кнопки, потом модули в порядке, указанном у платы ниже:
DS последнего регистра деки ← SR_OUT первого модуля; SR_IN первого модуля ← SR_OUT второго и т. д.; SR_IN последнего — подтяжка на модуле.

## 3. Платы

### M2 — Level 1–8: отменён как отдельный модуль (R128)
- Ручки Level 1–8 стоят на плате P3 (см. P3). Блок схемы — `hardware/m2-levels/gen/design.py`, P3 берёт его с переименованием.

### M3 — Tempo + Swing (модуль, 2 ручки)
- Ручки x 32 и 80, y 277, ⌀ 22, кольца 12 огней. Плата x 10–102, y 263–297 (92 × 34), как полоса M1.
- 1 × LP5864, 1 × 74HC165 (A, B, кнопка × 2, остальные входы +3V3), J1. **P102:** без касания (MP на GND).

### M4 — FX Mix + Filter (модуль, 2 ручки)
- Ручки x 355 и 389, y 277, ⌀ 22. Плата x 337–407, y 263–297 (70 × 34, rev 0.2). Состав как M3.

### M5 — Gain 1 + 2 (модуль на наклоне, в окне W1)
- Ручки x 32 и 80, y 379 (на наклоне, пересчёт s = (y − 300)/cos 30°), ⌀ 16; огни Clip 1 и Clip 2 (x 48 и 96, y 386, P83).
- Плата 84 × 34 мм, панель x 15–99 (R132, rev 0.2), по окну W1 (`w1-levels/gen/design.py`: `M5_X = (5, 89)`, окно до W1 x 89,5); J1 — напротив J2 W1.
- **P103:** кольца по 11 огней + 2 огня Clip = 24 RGB на одном LP5864. Без касания (P102). 1 × 74HC165.

### P1 — Left (дека)
- 19 кнопок: ● Rec, ▶ Play, ■ Stop, Restart, Metronome, Tap, Capture, Resample, Undo, Redo, Delete, Duplicate, Double, New, Quantize, Length, Automate, Repeat, Accent (координаты — `layout_v7.json`, группа x ≤ 102, y ≤ 252).
- Плата x 10–102, y 4–262. Огни: 38 RGB → 2 × LP5864 (**P101**: 2 огня на кнопку). 3 × 74HC165 (19 кнопок + 5 входов на +3V3).
- TCA9546A 0x70 (P99): канал 0 — свои LP5864; канал 1 — J2 к M3; канал 2 — J3 к W1 (через сгиб); канал 3 — свободен.
- Разъёмы: J1 к P2 (2 × 8, P100), J2 к M3 (2 × 7, у заднего края y ≈ 258), J3 к W1 (2 × 7, у заднего края). Цепочка: кнопки P1 → M3 → W1 (W1 сам продолжает на M5).

### P3 — Tracks (дека)
- 21 кнопка: Solo, Arm, Arrow ▼, Mute 1–8, Select 1–8, Stop All, Arrow ▲ (x 339–405).
- **R128:** ручки Level 8…1 (x 394,5, y 52 + 25k, ⌀ 14, кольца 12 огней r 10,5, касание CY8CMBR3108, 4 × LP5864) — на этой же плате.
- Плата x 339–406,5 (67,5 × 258), y 4–262, **4 слоя**, без выреза. Огни кнопок 42 RGB → 2 × LP5864. 3 × 74HC165 кнопок + регистры ручек.
- TCA9546A 0x71 (R129): канал 0 — свои LP5864; 1 — блок ручек Level (4 LP5864, касание); 2 — J3 к M4; 3 — J4 к W2 (через сгиб). Цепочка: кнопки P3 → ручки Level → M4 (W2 без кнопок, в цепочку не входит).

### P4 — Right (дека)
- 20 кнопок: Scene A, Scene B, Chords, Touch FX, Scale, Clips, Steps, Notes, Sound, Effects, Mod, Mixer, Song, Browser, Sampler, Inputs, Settings, Page ◄, Back, Page ►.
- Кроссфейдер (x 459, y 22, ход ≈ 45 мм; деталь не выбрана — P90): движок → RC 1 кОм/100 нФ → **ADS1115** (0x48) на канале 0 (**P104**: оцифровка на P4, как у W1, аналог по шлейфу не идёт). Поставить посадочное место ходового кроссфейдера 45 мм, в README — «деталь уточнить».
- Колесо (x 459, y 277, ⌀ 38): **AS5600** (SOIC-8, I²C 0x36) под магнитом колеса, канал 0. Плата P4 поэтому доходит до y 297 (вырез под M-модулей нет).
- **R134:** нажатие колеса — задел остаётся: вход регистра с подтяжкой и разъём JST PH 2 вывода; механизм выбрать позже.
- Плата x 413–505, y 4–297. Огни 40 RGB → 2 × LP5864. 3 × 74HC165 (20 + 4). TCA9546A 0x72: канал 0 — свои, 1 — J3 к W3.
- Разъёмы: J1 к P2 (2 × 8), J3 к W3 (2 × 7, через сгиб).

### W2 — Meters (наклон)
- 2 столбца по 14 огней: x 364 и 380, y 313–417 (центр 365, высота 104; шаг ≈ 7,4 мм по наклону). Плата x 355–390 по панели, вдоль наклона ≈ 120 мм.
- 28 RGB → 2 × LP5864 (L и R, по 14). Кнопок нет: SR_OUT ← SR_IN напрямую (дорожкой), чтобы цепочка не рвалась. J1 к P3.

### W3 — System (наклон)
- Кнопки Save, Project (2 RGB каждая), огонь записи. Плата x 413–505 по панели, вдоль наклона как W1.
- **R133:** Power (x 459, y 407, ⌀ 14) — панельная кнопка на проводе прямо к PWR_SW Mini-ITX, на W3 её нет; состояние не читается.
- **P105:** USB-A и SD (карман x 459, y 365) — розничный модуль-удлинитель USB-A + кардридер, на W3 только крепёж и вырез; электрически к W3 не подключается.
- 1 × LP5864 (5 RGB), 1 × 74HC165. J1 к P4.

### P2 — не в этом заходе
RP2350, 64 FSR-пэда, полоса — отдельная задача после ответа по P99/P100.

## 4. Что вернуть

- Папки плат с генераторами и схемами (`.kicad_sch`), ERC и `check_netlist` — в README каждой платы.
- Пакеты в `hardware/for-routing/<ID>/` через `tools/build_for_routing.py`, строка в таблице `hardware/for-routing/README.md`.
- Вопросы и расхождения с этим ТЗ — в `notes/handoff.md`, раздел ПК; сами решения в `docs/ru/decisions/` не менять.
