MitjaGrecky/Shtuka-druka/hardware/for-routing/RULES.md

# Правила разводки (для всех плат)

*Источники: `docs/ru/30_m1_screen_knobs.md` (раздел 7), `31_w1_levels.md` (раздел 3), возможности JLCPCB (https://api.jlcpcb.com/capabilities/Capabilities, проверено в работе над M1). Значения ниже — рабочие, с запасом над минимумами фабрики.*

## Общее

| Что | 2 слоя | 4 слоя |
|---|---|---|
| Толщина платы | 1,6 мм | 1,6 мм |
| Дорожка / зазор (сигнал) | 0,15 / 0,15 мм (минимум фабрики 0,127) | 0,12 / 0,13 мм (минимум 0,09) |
| Питание (+5 В, GND) | 0,3 мм | 0,3 мм |
| Переходное | 0,6 / 0,3 мм (диаметр / отверстие) | 0,45 / 0,2 мм |
| Отверстие переходного до дорожки | ≥ 0,254 мм (фабрика) | ≥ 0,254 мм |
| Медь до края платы | ≥ 0,3 мм | ≥ 0,3 мм |
| Заливка земли | с обеих сторон, сшивка переходными шагом ≈ 4 мм | внутренний слой 1 — сплошная GND |
| Слои | Top, Bottom | Top (огни, выводы энкодеров), In1 = GND, In2 и Bottom = сигналы |
| Сборка | двусторонняя на заводе (R115) | двусторонняя на заводе |

## Что нельзя двигать

* Детали, которые задаёт панель: энкодеры, потенциометры, кнопки, огни, разъёмы, отверстия. В импортированном файле они закреплены; в EasyEDA включите блокировку позиции.
* Дуги колец огней и веера у драйверов (M1): нарисованы скриптом, это самая тесная часть.
* Контур и вырезы.

## Особенности

* **Касание ручек (M1, M2):** под корпусом энкодера (12,4 × 8,8 мм) на **всех слоях** нет дорожек и переходных; медь земли вырезана под рамкой энкодера. Корпус и вал энкодера — электрод касания.
* **Огни:** общий анод (+5 В через SW-строки драйвера), катоды по три на огонь. Линии SW несут до ≈ 0,3 А на драйвер: ширина ≥ 0,25 мм.
* **Драйвер LP5864 (VQFN-32, шаг 0,4 мм):** выводы расходятся веером, который уже нарисован; не менять порядок выводов.
* **Высота:** детали сверху только энкодеры, огни, потенциометры и кнопки (то, что видно под обшивкой); микросхемы и разъёмы снизу.
* **Надписи на плате только английские** (R45).
* Лицензия: CERN-OHL-S-2.0. На шёлке оставить строку с названием платы и ревизией.
