MitjaGrecky/Shtuka-druka/notes/handoff.md

# Передача хода: облако ⇄ ПК

Формат записи: `- [ ] #N кому: задача. Контекст/файлы.` Закрытие: `- [x] #N результат (коммит/файл)`.
Старые закрытые записи переносить в «Архив». Решения здесь не принимаются, только предлагаются.

## Очередь: ПК (локальная сессия, KiCad MCP)
- [x] #25 ПК, 14.11: сделано — R2 rev 0.5, отчёт в «Отчётах». Было: #25 ПК (от облака, 14.11): **R2 — линии ATT1/ATT2 для реле-аттенюаторов R1.** Разъём «to A1/R1» расширить с 2×5 до **2×7**: пины 1–10 как были, 11 = ATT1, 12 = GND, 13 = ATT2, 14 = GND (ответная часть на R1 rev 0.3, `Conn_02x07`, PinHeader 2×7). Два GPIO RP2350 (3,3 В, по умолчанию низкий = без аттенюатора; при загрузке подтянуть вниз, как остальные линии), в README R2 — строка таблицы; прошивка/меню «входы» — позже. Проверить по CI, пуш с зелёным CI.
- [ ] #21 ПК (от облака, 14.11; ветка целиком в m1-two-cells, удаление ждёт слова пользователя): удалить временные ветки `ci-check-20`, `ci-check-22`, `ci-check-23` и `ci-check-24` и `ci-check-25` на GitHub (`git push origin --delete ci-check-20 ci-check-22 ci-check-23 ci-check-24 ci-check-25`; все целиком в m1-two-cells, CI зелёные). Облако через неё проверило CI до пуша в m1-two-cells (зелёный, прогон 43566595775), а удалять ветки прокси облака не даёт.
- [x] #19 (ПК, 13.11; ответ В11 — (а)): контур энкодера `ShtukaDruka:RotaryEncoder_Alps_EC11E-Switch_Vertical_H20mm_Ring` = корпус F.Fab 12,1 × 11,7 + 0,25
  с выступами только у выводов A B C, S1 S2 и лапок корпуса (у A и C фаска 0,3). Реальные зазоры до правки: корпус энкодера ↔ огонь ~1 мм, медь ≥ 0,44 мм.
  M3, M4, M5, P3 пересобраны (площадки 1:1 с прежними, другой только контур и порядок в файле), пакеты перепакованы.
  Проверка ПК многоугольниками контуров (как DRC; до правки она нашла те же 16 и 2): пересечений 0 на M3, M4, M5, P3 и на M1.
  `hardware/m2-levels`: оставлены `gen/design.py` (блок для P3) и README; файлы платы и генераторы убраны — CI больше не видит .kicad_pro.
  Облаку: подтвердить DRC M5 и P3 по CI. Было: (от облака, CI 43477566859): **перекрытие контуров энкодер ↔ огонь кольца** после R131 (r = 10,5): M5 — 2 ошибки DRC (напр. ENC2 / D13), P3 — 16 (ENC1–8 с огнями колец, напр. ENC5 / D92). У M3, M4 (r 15) ошибок нет; медь не задета — контур EC11E шире корпуса. Варианты (выбирает пользователь, вопрос в «Вопросах»): (а) поджать контур энкодера в библиотеке до корпуса 12 × 13 мм + 0,25; (б) убрать огни кольца под углами корпуса; (в) оставить и пометить исключением DRC. Ещё: `hardware/m2-levels/` по R128 уже не плата, а CI проверяет её как проект — по правилу «Версии» оставить только `gen/design.py` блока (убрать .kicad_pro/.kicad_pcb/.kicad_sch), чтобы CI её пропускал.
- [x] #17 (ПК, 13.11): `almost/` возвращена локально из 5f71d53 (21 файл), `git check-ignore` её видит, `git status` чист.
  #12 не начат: это разводка M1 (пользователь: «разводнюкой займёмся позже»), итоговый DRC — не на ПК.
  Было: ПК, **до или сразу после ближайшего `git pull`**: `hardware/m1-screen-knobs/almost/` убран из GitHub по слову пользователя (13.11): это его локальная копия, чтобы играть руками. Папка теперь в `.gitignore`. Pull удалит её из рабочей копии; вернуть локально, не добавляя в git: `git restore --source=5f71d53 --worktree -- hardware/m1-screen-knobs/almost` (или до pull скопировать папку в сторону и положить обратно). Проверить, что `git status` её не показывает.
- [x] #16 (ПК, 13.11, a7fa2ef): `boardkit.pin_name()` заменяет «/» на `{slash}` (так делают и `module_pcb.py`, и `m3-tempo-swing/gen/make_pcb.py`);
  P4 пересобрана: `unconnected-(U7-ALERT{slash}RDY-Pad2)`. На других платах выводов с «/» в пустых цепях нет. Проверка parity — CI.
  Было: ПК (от облака, CI 13.11, прогон 43427274603): P4 — 1 расхождение плата ↔ схема. Имена пустых цепей `unconnected-(…)` в `module_pcb.py` строить с заменой «/» на `{slash}`, как KiCad: на плате `unconnected-(U7-ALERT/RDY-Pad2)`, в схеме `ALERT{slash}RDY` (ADS1115 U7, вывод 2). Ошибок DRC у P4 нет.
- [x] #15 (ПК, 13.11): (1) W2 rev 0.1c — драйверы ровно между 7-м и 8-м огнём столбца (y 62,95), отверстия площадки 33 в 3,08 мм от площадок огней
  (было 0,73); EasyEDA **W2_v3** 40/40 и 40/40. (2) `boardkit.flip_bottom()`: KiCad 9+ — явно `FLIP_DIRECTION_TOP_BOTTOM`, KiCad 7 — `Flip(True)` + 180°;
  в KiCad 10 результат прежний (P1: 110 из 110 деталей площадка в площадку). Использует `module_pcb.py` и `m3-tempo-swing/gen/make_pcb.py`. (3) ждёт В1.
  Было: ПК (от облака, по CI 13.11): правки генераторов.
  (1) **W2: 6 ошибок DRC.** Переходные в центральной площадке (pad 33) LP5864 U1, U2 на нижней стороне — сквозные и выходят наверх
      прямо под огни D8 и D22: зазор 0,127 мм при норме 0,15 и «PTH inside courtyard». Сдвинуть U1/U2 вдоль столбца, чтобы переходные
      легли между огнями (шаг огней 8,58 мм), или убрать переходные из этой площадки на W2.
  (2) **Переворот нижних деталей зависит от версии KiCad.** `fp.Flip(pos, True)` в `common/gen/module_pcb.py`: в KiCad 7 это зеркало слева
      направо, в KiCad 9+ (`FLIP_DIRECTION`) — сверху вниз. Тот же генератор в KiCad 7 даёт нижние детали, повёрнутые на 180°
      (у разъёмов шины вывод 1 на другом конце). Эталон — сборка ПК (KiCad 10, проверена в EasyEDA). Предложение: явно задать
      направление переворота или после `Flip` в KiCad < 9 повернуть деталь на 180° (разъёмы J* — вокруг центра площадок).
      Так облако сделало копии для превью и проверило: все площадки шести плат совпали с файлами ПК.
  (3) P4 — вынесено в #16.
  (4) M5: 2 ошибки края (Clip 2), ждём ответ В1. Остальное в отчётах только предупреждения (см. отчёт облака по #14), править по желанию.
- [ ] #12 ПК: довести `quilter/results/I2_rev031_cand1_1/fixed.kicad_pcb` до готовой платы → `final.kicad_pcb` в той же папке (fixed не менять).
  (1) Развести 5 открытых связей: A_CS4, B_CS4, B_CS7, B_CS9, E7_A — убрать одну-две соседние трассы, провести заново, вернуть соседей;
  норма проекта (0,12 / зазор 0,13), тоньше 0,1 не опускаться. Вспомни, где роутер останавливался (в #11: сетка 0,05 и 0,025).
  (2) Острова земли GND на B.Cu и In1: все куски должны иметь переходные к In1, лишние островки без цепи убрать/зашить.
  (3) Длинные обходы энкодеров из #11 (E6_B 44,7 мм/8 via, SR_CLK 57,3 мм/8 via, E2_B 34 мм/4 via): переразвести короче, если можно без новых нарушений.
  (4) Итог: `kicad-cli pcb drc --schematic-parity` — цель: ошибок 0, неразведённых 0, parity 0. Картинка `final.png`, отчёт `final_drc_kicad10.rpt`.
  (5) Не заменять `hardware/m1-screen-knobs/almost/`: только предложить в отчёте (решает пользователь). Решения не менять, в Quilter не загружать.
- [x] #1 DRC повторён, цифры CI подтверждены (11 unconnected / 0 / 0). (263.7, 73.7) не место островов, а первая
  вершина контура зоны GND B.Cu. Острова: заливка B.Cu рвётся трассами у U1/U2/U4 на куски без GND-переходных. Подробно
  в «Отчётах» от 2026-11-06. Плата не менялась.
- [x] #4 Анализ M1 перед P98 готов, плата не менялась. Цифры облака подтверждены точно, но щели не узкое место
  (ёмкость в 2–4 раза больше нужды); узкое место — разветвление выводов U1. Подробно в «Отчётах» от 2026-11-06 (#4).
- [x] #5 закрыт отметкой (ПК, 07.11): причина падения D и D retry была в дугах (PCB_ARC); F с хордами прошёл (кандидат 1.1,
  97%). Бисекция не понадобилась. Было: ПК (ночной, запасной): если облако в 03:00 пометит все Quilter-задачи M1 rev 0.2 как упавшие (D, D retry, F; возможно G) —
  разобраться без пользователя. Факты: jobs D 6aee201427e5a51dd6530c07 и retry 6aee4c279d195808d04dfb3e упали (консоль:
  router unexpected error + board data could not be validated); F 6aee5986db018c21260eb2e4 = то же с хордами вместо дуг
  (`gen/make_quilter.py`, `arcs_to_chords`). Файлы: `C:\Users\karpa\Documents\ShtukaDruka\quilter\{D_rev02_route_only,F_chords,G_chords}`.
  Сделать: (1) прогнать DRC и `kicad-cli pcb export` на каждом файле, найти то, что Quilter «не валидирует» (лишние/дублирующиеся
  объекты, зоны, ключи, длинные имена цепей, вырезы, via на краю, нулевые трассы, дубли GND); (2) бисекция: убрать по классу
  (кольцевые трассы, vias, зоны, надписи) и найти минимальный состав, который проходит валидацию; (3) собрать вариант и
  положить в `quilter/H_*`; (4) отчёт в «Отчётах». Не загружать в Quilter сам, это делает облако.

## Очередь: облако (claude.ai)
- [ ] #26 облако (от ПК, 14.11): **A1 — сверка по даташитам** (`hardware/a1-digital/` rev 0.1, README «To check»). Конденсаторы и стяжки вокруг CS5308P/5304P/4308P по типовым
  схемам подключения (VMID, FILT, LDO, VDD_D, CONFIG в режиме SPI), тип 68 мкФ; PLL_AVDD и последовательность питания у XU316, кварц, домен 1,8 В, размер флеша, план портов
  под lib_xua (TDM-мастер, асинхронный USB, PDM); питание VDD1/VDD2, кварц и корпус ADuM4166; номера JLC для генераторов 24,576 и 22,5792 МГц;
  номер LCSC/посадка CS4308P. Правки — в `gen/design.py`, пересборка `make_sch.py` (`KICAD_SYMBOL_DIR=<repo>/hardware/common/sym7`), `tools/sch_netcheck.py hardware/a1-digital`.
  Не создавать новых временных веток: проверка через основную ветку.
- [x] #24 облако, 14.11: сделано — отчёт в «Отчётах» от 2026-11-14 (облако, #24); вопрос В16. R1 rev 0.2. Было: **R1 — сверка уровней и номиналов** (`hardware/r1-audio/` rev 0.1, README «To check»). Полная шкала
  CS5308P/CS5304P и буфер AN0635 (принято 2,0 Vrms дифф.), коэффициенты путей мик/Hi-Z (громкий/тихий +40 дБ), уровень линии на TRS
  комбо (нужен ли аттенюатор), сеть RIAA (сейчас приближённая — посчитать), рампа фантома, фильтр 49,9 Ом + 1 нФ. Правки — в `gen/design.py`,
  пересборка `make_sch.py`, `tools/sch_netcheck.py hardware/r1-audio`. Отдельно: CS4308P — токовый выход (AN0679), I-V на A1 (уточнение R136).
- [x] #23 облако, 14.11: сделано — отчёт в «Отчётах» от 2026-11-14 (облако, #23); вопросы В14, В15. PW rev 0.2.
- [x] #22 облако, 14.11: сделано — отчёт в «Отчётах» от 2026-11-14 (облако, #22). CI 43585144247 зелёный: R2 — 0 ошибок DRC, parity 0.
- [x] #20 облако, 14.11: сделано — отчёт в «Отчётах» от 2026-11-14 (облако, #20); вопросы В12, В13. R2 rev 0.2.
- [x] #18 облако, 13.11: сделано — отчёт в «Отчётах» от 2026-11-13 (облако, #18). Коммиты 37ae15e, 537891d, 4759897, b7de7e9; CI 43477566859 зелёный.
- [x] #2 Quilter job C остановлен 06.11 в 19:55 по решению пользователя: 2 ч, 6 размещений, роутер встал на 33/39,
  разведённых кандидатов 0. Причина тупика — один драйвер на 104 огня (см. P98), не настройки Quilter.
- [x] #6 облако: закрыто 13.11.2026, устарело: ночной Quilter F/G давно разобран. Было: в 03:00 проверить F; упал -> запустить G; упали все -> письмо в поддержку Quilter с id задач; затем прочесть отчёт ПК по…
- [x] #3 облако: закрыто 13.11.2026, устарело: рисунок для rev 0.2, M1 сейчас rev 0.5. Было: перегенерировать `hardware/m1-screen-knobs/mech/m1_fixed_vs_movable.png` (U1-U5 как зафиксированные якоря).…
- [x] #14 облако, 13.11: сделано (вместе с P4, добавленной ПК по ходу). Отчёт в «Отчётах» от 2026-11-13 (облако, #14). Коммиты 5939ba4, 554f658, fe5ed0b и следующий.
  CI теперь печатает полные отчёты ERC/DRC в лог (артефакт `kicad-out` из облака не скачать: прокси не пускает к хранилищу GitHub)
  и не проверяет папки `quilter/`, `quilter_raw/`. CI ещё красный из-за `hardware/m1-screen-knobs/almost/` (это #12).

## Вопросы пользователю (решает он)
- **В17 (14.11, ПК): P2 — как читаем 64 пэда (FSR, доки 09, 29).** Остальное в P2 понятно из документов (RP2350 панели, один драйвер огней на 99 RGB, 8 сцен, ◄ ►,
  разъёмы Trill Bar ×2, шины к P1/P3/P4 по R130, разъём M1, USB к хабу R2, INA226 от PW через PH 4 с подтяжками 3,3 В), а вот способ считывания решений не имеет.
  Предлагаю (а): **8 × аналоговый мультиплексор 74HC4051** (по 8 пэдов, делитель с резистором у каждого пэда) → **один 8-канальный АЦП по SPI ADC128S102** (12 бит, 8 каналов
  параллельно читают 8 мультиплексоров): полный проход 64 пэдов ≈ 130 мкс (до ~7 кГц), хватает на velocity и давление; адреса мультиплексоров общие (3 вывода GPIO), АЦП — SPI (4 вывода).
  Варианты: (б) строки-столбцы матрицей без АЦП на пэд — дешевле, но хуже давление и «призраки»; (в) пока без FSR на плате, сетка внешняя (как в доке 09 для прототипа) — плата P2 проще, пэды позже.
  Рекомендую (а). Скажите, брать (а), (б) или (в).
- ~~**В14.**~~ Ответ 14.11: (а) INA226 → R146. **В14 (14.11, облако, #23): как прошивка узнаёт, сколько можно на огни.** (а) INA226 на шине BUS (I²C к R2) — меряет вход целиком, огни ограничиваются по факту (рекомендую: работает с любым источником и аккумулятором); (б) I²C TPS25730 к R2 — читать договорённую мощность PD (только для USB-C); (в) только сигналы «какой источник» от трёх LM74700 и таблица лимитов в прошивке.
- ~~**В15.**~~ Ответ 14.11: да, 12 В — с урезанными огнями; позже, может, ограничим частоту процессора → R147. **В15 (14.11, облако, #23): DC 12 В.** Гнездо DC рассчитано на 5 А: от адаптера 12 В — 60 Вт, без огней уже впритык. Пишем в инструкции «адаптер 19–24 В», а 12 В — только с урезанными огнями?
- ~~**В16.**~~ Ответ 14.11: (б) реле-аттенюатор −12 дБ → R1 rev 0.3 (облако), ПК — #25. **В16 (14.11, облако, #24): линия на комбо-гнезде.** Тракт Mic/Line звучит до +13,6 dBu (+11,9 dBu — полная шкала громкого пути); профессиональная линия +24 dBu на TRS комбо упрётся. Варианты: (а) оставить: комбо — микрофон и инструменты, линии +24 dBu идут в линейные входы 1–8 (рекомендую); (б) добавить переключаемый аттенюатор −12 дБ на реле (+ реле, место, управление с R2).
- ~~**В12.**~~ Ответ 14.11: (а) полка R2b → R139. **В12 (14.11, облако, #20): угловые разъёмы R2.** DIN-5 SDS-50J, оба USB-C, USB-A и DC — угловые, на вертикальной плате у стенки смотрят вбок, а не наружу.
  Варианты: (а) **нижняя горизонтальная «полка» R2b** с угловыми разъёмами в один ряд (DIN 6 × 23 ≈ 140 мм + USB/DC ≈ 60 мм), соединена с R2 гребёнкой — DIN тогда в 1 ряд, не 2 × 3;
  (б) всё вертикального монтажа: DC Kycon KLDVHCX есть (на LCSC нет в наличии), USB-C вертикальный только на 3 А (PD до 60 Вт вместо 65–100), DIN-5 вертикальный не найден;
  (в) DIN-5 на панель (на гайках), провода к R2; USB и DC — как в (а) или (б). Рекомендую (а): всё паяется на заводе, ток 5 А сохраняется.
- ~~**В13.**~~ Ответ 14.11: да, за основу → R140. **В13 (14.11, облако, #20): задняя панель v1** (`docs/ru/img/rear_panel_v1.png`) — берём за основу? Зоны и ряды, подписи CLK/RESET, порядок: питание/USB, MIDI, CV/синхро, выходы, входы.
- ~~**В11.**~~ Ответ 13.11: (а) точный контур энкодера — сделано (#19). **В11 (13.11, облако):** M5 и P3 — контуры энкодеров перекрываются с огнями колец r 10,5 (18 ошибок DRC, медь цела). Как лечим: (а) поджать контур энкодера в библиотеке, (б) убрать огни у углов корпуса, (в) исключение DRC? Подробно — #19.
- P98 M1 из двух ячеек, P97 крепление M1 (вставки M2 в световоде, +3 отверстия), P75, P82–P85, P90–P96: список по приоритету в `docs/ru/decisions/README.md`.

### Стопка вопросов ПК (схемы по SPEC_boards, обновляется по ходу; ответ — строкой «В#: ...» сюда или в чат)
- ~~**В1.**~~ Ответ 13.11: (а) — M5 rev 0.2 до x 99 сделана, окно W1 — облаку (#18). Было: **M5, огонь Clip 2 у края.** По макету x 96, плата M5 (по окну W1) кончается на x 97: медь в 0,15 мм от края при норме 0,3 (DRC 2 ошибки).
  Варианты: (а) расширить M5 и окно W1 до x 99 (у W1 справа останется обод 2,5 мм); (б) сдвинуть Clip 2 на x 94. Рекомендую (а): панель не меняется.
- ~~**В2.**~~ Ответ 13.11: поле `ring` макета (r = ring/2, `kit.ring_r`): M3, M4 — 15 мм, M5 и Level — 10,5 мм. Было: **Радиус колец.** ТЗ: r = ⌀/2 + 3 (14 мм у ⌀ 22, 11 мм у ⌀ 16). В layout_v7 у колец своё поле `ring` (30 и 21 мм). Для M3/M4 сходится, у M5 кольцо выходит на ~1 мм шире макета.
  Что главнее: формула ТЗ или `ring` из макета? Рекомендую `ring` из макета (это то, что видно на панели).
- ~~**В3.**~~ Ответ 13.11: да, так (W2 126 мм вдоль наклона, шаг 8,58). Было: **W2 по наклону.** Столбцы индикаторов 104 мм в проекции = 120,1 мм вдоль наклона, поэтому плата 126 мм (как W1), а не «≈ 120», шаг огней 8,58 мм вдоль наклона («≈ 7,4» в ТЗ — это шаг в проекции). Подтвердить.
- ~~**В4.**~~ Ответ 13.11: P99 и P100 приняты → R129, R130 (там же R131–R134 — ответы В1, В2, В9, В10). Было: **Предложения P99–P105.** Для M3–M5 и W2 достаточно P102, P103. Для дек (P1, P3, P4) нужны ответы по **P99** (мультиплексор I²C TCA9546A на каждой деке) и **P100** (шлейф 2 × 8 к P2): без них схемы дек будут «по предложению».
- ~~**В5.**~~ Закрыт 13.11 решением **R128**: ручки Level (M2) на одной 4-слойной плате с P3, край x 406,5. Было: полоса ручек Level выходит за край P3 (x 405), а ▲/▼ стоят на P3. Окно в P3 под M2 и край P3 на x 409?
- ~~**В6.**~~ Закрыт 13.11: номера найдены в библиотеке EasyEDA (см. отчёт «номера деталей по библиотеке EasyEDA»). Было: **Номера LCSC** для 4,7 мкФ 0805, 1 нФ 0402 (и 560 Ом 0402 у M1/M2) в проекте не выбраны — в BOM стоит «выбрать деталь». Выбрать мне (через EasyEDA/LCSC) или облаку?
- ~~**В7.**~~ Ответ 13.11: удалить все 14 — сделано (файлы `.eprj2` в корзине Windows, папки `*_backup` EasyEDA не тронуты; в EasyEDA 10 рабочих проектов). Было: **Лишние проекты в EasyEDA:** M1_kicad7, W1_kicad7 (склеенное питание), M3_v1 (без цепей), M3_v1b, M3_v2 (служебный текст на плате), W2_v1, W2_v2 (старые ревизии), M2_v1 (склейка в схеме), M2_v2 и P3_v1 (до слияния R128), M3_v3, M4_v1, M5_v1, P3_v2 (до В1/В2). Рабочие: M1_v2, W1_v3, M3_v4, M4_v2, M5_v2, W2_v3, W3_v1, P1_v1, P4_v1, P3_v3. Удалить лишние? (без слова не удаляю)
- ~~**В9.**~~ Ответ 13.11: (б) — панельная кнопка на проводе к Mini-ITX, без платы. Было: **W3 и кнопка Power.** Карман USB-A + SD (92 × 24 по макету) во всю ширину колонки W3: плата с вырезом под него распалась бы на две.
  W3 сделана до кармана (Save, Project, огонь записи); Power (x 459, y 407) стоит за карманом. Варианты: (а) маленькая плата W3b под Power
  (тактовая кнопка + разъём 2 вывода к PWR_SW Mini-ITX + 2 отверстия); (б) панельная кнопка ⌀ 14 на проводе прямо к Mini-ITX, без платы.
  Рекомендую (б): меньше деталей, «гальванически только кнопка» как в ТЗ. Состояние Power модуль не читает (Mini-ITX видит кнопку сама).
- ~~**В10.**~~ Ответ 13.11: задел оставить, механизм нажатия выбрать позже. Было: **Нажатие колеса (P4).** В описании панели у колеса «нажатие — OK», в ТЗ его нет. Сделан задел: вход регистра WHEEL_PUSH (бит 21),
  подтяжка и разъём J4 (JST PH 2 вывода) для кнопки в механизме колеса. Механизм нажатия (кнопка где, как стоит над AS5600) — выбрать; задел убирается константой `WHEEL_PUSH`.
- ~~**В8.**~~ Ответ 13.11: оставить KiCad 10 (CI тоже KiCad 10). Было: **Формат плат в репозитории.** ПК пишет `.kicad_pcb` в формате KiCad 10 (облачный KiCad 7 их не откроет, но пересоберёт из `make_pcb.py`). Оставить так или ПК коммитит только генераторы, схему и пакет для EasyEDA?

## Отчёты
(новые записи сверху: дата, кто, что сделано, где результат)

### 2026-11-14, ПК: A1 rev 0.1 — схема цифровой аудиоплаты
- `hardware/a1-digital/` (608 деталей, 388 цепей): 2 × CS5308P + CS5304P (20 каналов), буферы Cirrus ×¼ на OPA1656 (R1 даёт 8 Vrms), ЦАП CS4308P с I-V каскадами (AN0679) на 8 каналов
  (Main, Aux → R1; Phones 1/2 → F1 по 2×6), два XU316 (A: TDM-мастер, SPI к преобразователям, порт A через хаб R2; B: порт B через ADuM4166, PDM), два генератора с разрешением,
  питание: TPS7A4701 3,3 В аналог, AP2112K 3,3 и 1,8 В, 2 × TLV62568 на ядра 0,9 В. ±12 В и +5 В — через разъём R1.
- Новые символы (CS5308P, CS5304P, CS4308P, XU316, ADuM4166) — `hardware/common/gen/ic_symbols.py` в проектной библиотеке; посадка XU316 — из библиотеки LCSC
  (конвертер `tools/eda/lcsc_fp.py` теперь умеет поверхностные площадки и повороты). `sch_netcheck`: 1889 выводов, 0. ERC — CI.
- Облаку — #26 (сверка по даташитам). Открыто: у CS4308P нет номера LCSC, генераторы без номеров.

### 2026-11-14, ПК: F1 rev 0.1 — схема наушников
- `hardware/f1-phones/` (52 детали): два гнезда **Neutrik NMJ6HCD2** (правоугольные, плата лежит горизонтально, P94) и по одному **OPA1622** на гнездо.
  Разностный каскад ×2 (10k / 20k, 0,1 %): 2 Vrms дифф. от A1 → 4 Vrms (R67: ≥ 4 В на 600 Ом). Громкость — цифровой аттенюатор ЦАП (R87), на F1 регуляторов нет.
  Тишина при включении: реле G6K-2 на каждое гнездо (замыкаются при MUTE и R2_OK, как на R1) + вывод EN у OPA1622 по MUTE (порог 0,78/0,82 В).
- Контракт разъёмов: от A1 — 2×6 (пары L+/L−/GND/R+/R−/GND на гнездо, 12 контактов) — **для схемы A1**; от PW — JST PH 4 (PW rev 0.5: «to F1» + 5 В
  на катушки); от R1 — JST PH 3 «to F1 (mute)» (R1 rev 0.4: MUTE, R2_OK, GND).
- Вопрос по замечанию codex про ориентацию: NMJ6HCD2 — гнездо для горизонтального монтажа, а F1 по P94 горизонтальная — сходится; вертикальной F1 в модели не требуется.
- `sch_netcheck`: F1 157 выводов, PW 577, R1 1216 — 0 расхождений. ERC — CI.

### 2026-11-14, ПК: R2 крепёж (rev 0.6) и M1 один исходник (R148)
- **M1.** Расхождение было из-за генератора: основной файл остался rev 0.3 (2 × IS31FL3741A, 8 отверстий 28/84/140/196, предшествует P97), а пакет EasyEDA
  собирается с `M1_LP=1` (rev 0.5: 4 × LP5864, 7 отверстий 56/112/168 = P97). **R148:** единственный исходник — rev 0.5; `M1_LP=1` теперь по умолчанию (`M1_LP=0` — старая rev 0.3),
  основной KiCad перегенерирован: 163 детали, 4 × LP5864, 7 отверстий, контур 224 × 34 — то же, что в пакете. Генератор под KiCad 10/Python 3.11 починен
  (f-строка, класс цепей, поля деталей, зоны, булевы операции). `sch_netcheck` M1: 765 выводов, 0. ERC перегенерированной схемы — только CI.
- **R2 rev 0.6.** 7 × M3 на стойках к стенке: углы (80, 4), (162, 4), (171, 99), (4, 99), полоса между TRS (23, 79) и два внутри (126,5, 56), (92,5, 34) в зазорах
  7,5 мм между колонками гнёзд. Усилие штекера держат гайки гнёзд, стойки — изгиб и тяга кабелей. Проверка: `pcb_geomcheck` 0 (первая попытка нашла два
  попадания на площадки — сдвинул), выводы = площадки, `sch_netcheck` 0. Точки уточнить с корпусом.

### 2026-11-14, ПК: разбор обзора codex (`compute-and-display-2026-11-14.md`)
Проверил замечания по своим файлам; подтвердились и исправлены:
- **R1 → A1, уровни:** R1 rev 0.2+ отдаёт 8 Vrms дифф. (схема Cirrus, усиление ¼), а `a1-digital/PLAN.md` писал «2 Vrms, усиление 1» — расхождение 12 дБ.
  План исправлен: на A1 буфер Cirrus (300 Ом / 1,2 кОм, 680 пФ, 68 мкФ на плечо), не усиление 1.
- **PW, INA226:** VIH = 0,7 × VS = 3,5 В при питании 5 В (проверено по таблице TI), подтяжки на P2 к 3,3 В. PW rev 0.4: датчик питается от своего
  3,3 В (AP2112K-3.3 от +5V). `sch_netcheck` 0.
- **#25:** способ управления выбран (74HC595 на DAC_SCK/DAC_SDI, защёлка GPIO 23, /OE GPIO 24 с подтяжкой вверх, GPIO 25 свободен; MUTE и R2_OK —
  прямые). Замечание «показать, какие линии общие и сколько GPIO освобождает» учтено в отчёте #25.
Остаётся открытым (решать вместе с пользователем / механикой):
- ~~R2: крепёж~~ — сделано, R2 rev 0.6: 7 × M3 (см. отчёт ниже; точки уточнить с корпусом).
- ~~M1: исходник~~ — сделано, **R148**: rev 0.5 единственный, основной файл перегенерирован.
- **P2: адрес INA226 0x40** может совпасть с LP5864 в одном сегменте I²C — при проектировании P2 выделить сегмент или переставить A0/A1 (0x41…).
- **Бюджет PD:** INA226 не знает, договорён контракт 65 или 100 Вт; нужен замер и консервативный профиль слабого источника (R147).
- **F1:** NMJ6HCD2 — гнездо горизонтального монтажа, а плата в модели вертикальная; решить ориентацию до схемы F1.
- **Вычислитель и экран** (ODROID-H5/H4 Ultra против ASRock N100DC-ITX; LESOWN 2560 × 1600, Waveshare EP, Wisecoco 4K): решения пользователя, тесты на xruns
  — отдельный стенд; не трогал.

### 2026-11-14, ПК: #25 — R2 rev 0.5, линии ATT1/ATT2
- Разъём «to A1/R1» теперь 2×7 (11 = ATT1, 13 = ATT2, чётные — GND), как на R1 rev 0.3.
- Свободных GPIO у RP2350A не было (30 из 30), поэтому вместо «двух GPIO» — **74HC595** (C5947) на линиях SPI ЦАПов (DAC_SCK, DAC_SDI):
  QA PH48_1, QB PH48_2, QC PHONO, QD ATT1, QE ATT2, три выхода запасных. GPIO 23 — защёлка, GPIO 24 — /OE (подтянут вверх:
  до команды прошивки выходы в третьем состоянии, линии держат стяжки 100k), GPIO 25 освободился.
  Прошивке: после старта вдвинуть нули, защёлкнуть, опустить /OE; обмен с ЦАПами регистр только сдвигает — после каждой записи
  в ЦАП перед защёлкой заново вдвигать байт состояния.
- `sch_netcheck` 0, `pcb_geomcheck` 0, пакет R2 пересобран. Дальше у ПК — схема A1 (план в `hardware/a1-digital/PLAN.md`).

### 2026-11-14, облако: R1 rev 0.3 — реле-аттенюатор на комбо-гнёздах (ответ на В16)
- Решение пользователя: аттенюатор −12 дБ на реле. На каждое комбо G6K-2F-Y после фантомных конденсаторов и 10 Ом, перед клампами и каскадом OPA1612:
  15k + 4,99k на ножку (0,1 %, ослабление 12,0 дБ); без питания — напрямую (микрофон). +24 dBu на комбо после аттенюатора = +12 dBu в каскад — в пределах 11,9 dBu полной шкалы громкого пути.
- Управление: ATT1/ATT2 от R2 (3,3 В) через 2N7002 + диод. Разъём R2→R1 теперь **2×7** (пины 11/13), R2 не трогал — #25 для ПК. Программно с R2 (меню «входы»), физического переключателя нет.
- Схема 444 детали, 264 цепи, netcheck 0. Проверка CI через ветку ci-check-25.

### 2026-11-14, ПК: R146, R147 — PW rev 0.3 с датчиком мощности
- В14 → **R146**: INA226 на шунте 5 мОм после выключателя (BUS_SW → BUS), адрес 0x40, кабель JST PH 4 (SDA, SCL, ALERT, GND) к **P2** —
  огни ведёт хаб панели, а у RP2350 на R2 свободных выводов нет. В15 → **R147**: адаптер 19–24 В, от 12 В — с урезанными огнями.
- `hardware/pw-power` rev 0.3: 185 деталей, `sch_netcheck` 0. Для P2 (когда до него дойдём): I²C к INA226 и подтяжки 3,3 В.
### 2026-11-14, облако: #24 — R1, сверка уровней и номиналов → rev 0.2
- **Полная шкала АЦП (главная находка).** По DS1397 (семейство CS5304P/8P) 0 dBFS = 2,0 Vrms дифф. **на выводах АЦП**, а рекомендованный буфер AN0635 (инвертирующий,
  1,2 кОм / 300 Ом, 68 мкФ) ослабляет в 4 раза: на его входе полная шкала **8 Vrms дифф.** В ревизии 0.1 принято 2 Vrms — все усиления на R1 были занижены в 4,17 раза.
  Теперь драйверы R1 отдают 8,33 Vrms (8 × 1249,9 / 1200, учтены 49,9 Ом). Фильтр 49,9 Ом + 1 нФ — 1,6 МГц, оставлен.
- **Пересчитаны пути:** линии 1–8 ×0,674 (FS +24,1 dBu, R135); Mic/Line — каскад на OPA1612 ×4,01 (499/332, шум Rg ниже), громкий ×0,681 (FS +11,9 dBu),
  тихий ×68,1 (+40 дБ, FS −28,1 dBu); Hi-Z ×1,37 / ×137 (+17,9 / −22,1 dBu); фоно-линия ×4,12 (+8,3 dBu).
  Каскад Mic/Line клипует около +13,6 dBu, **аттенюатор не нужен**, если комбо — микрофон и инструмент (вопрос В16).
  Клампы на линейных входах не ставим (+24 dBu = 17 Vpk превысит ±12 В).
- **RIAA посчитана:** 68,1k ∥ 47 нФ + 7,42k над 130 Ом + 470 мкФ (3180/318 мкс), 75 мкс пассивно 787 Ом + 100 нФ перед FDA; +35,0 дБ на 1 кГц,
  ошибка < 0,05 дБ в 20 Гц…20 кГц (номиналы), FS 36 мВ (7× запас к 5 мВ). С 0,1 % резисторами и 1 % C0G около ±0,1 дБ.
- **Фантом:** конденсатор Миллера 2,2 мкФ база–коллектор MMBTA92 вместо 10 мкФ на эмиттере; рампа ~0,1–0,2 с, ток базы 0,45 мА (≥ 11 мА при h21э 25);
  **MMBT3904 (40 В) заменён на MMBTA42 (300 В)** — его коллектор видит 48 В. Оценка расчётом, не симуляцией.
- **ЦАП:** CS4308P токовый выход 1,67 мА rms × 1,2 кОм = 2,0 Vrms дифф. (DS1317, AN0679), I–V на A1; R1 ×3,09 → 6,19 Vrms = +18,0 dBu. Уточнение R136 подтверждено.
- **Схема:** 426 деталей, 250 цепей, `sch_netcheck` 0 расхождений; `sym7.py` теперь берёт символы из установленной библиотеки KiCad и пропускает отсутствующие (+ MMBTA42).
  README R1: раздел «Level plan», «Still open» (оценка шума EIN, механика гнёзд, фоно/линия модель vs R118).
- Открыто: В16; реальный шум проверим на первой плате. Ветка проверена через `ci-check-24`, удалить — в #21.

### 2026-11-14, облако: #22 — DRC R2 по логу CI
- **CI печатал в лог только первые 400 строк** отчёта — у R2 547 нарушений, хвост терялся. Теперь в группе «DRC <плата>» каждый тип нарушения
  с числом (`COUNT [тип]: N`) и тремя примерами (`kicad.yml`, коммит 7a02641).
- **R2 до правок** (прогон 43584932948, без неразведённых связей): `drill_out_of_range` **2 ошибки** — переходные 0,2 мм в центральной площадке
  DAC80504 U9, U10 (посадка `..._ThermalVias`) при минимуме отверстия 0,3 мм; `net_conflict` 17 — имена однопиновых цепей
  `unconnected-(J17--PadTN)` с пустым именем вывода; шелкография 149 + 197; «библиотека не подключена» 199.
- **Правки:**
  (1) `boardkit.write_project(…, layers)`: у 4-слойных плат минимум отверстия 0,2 мм и переходного 0,45 мм — как в `RULES.md`
  (раньше всем платам ставились 2-слойные 0,3 / 0,5). Переписаны `.kicad_pro` R2, PW, P3 — меняются только эти два числа; вызовы в `module_pcb`,
  `make_sch` R2 и PW, `make_pcb` M3 передают `design.LAYERS`.
  (2) `boardkit.unconnected_net()`: у вывода без имени — `unconnected-(REF-PadN)`, как пишет KiCad; используется в `module_pcb` и генераторе M3;
  17 имён в файле платы R2 поправлены на месте (плату не пересобирал — она ПК, KiCad 10).
- **R2 после** (прогон 43585144247): **0 ошибок DRC, parity 0**; остались предупреждения — шелкография 149 + 197 (подписи поверх площадок,
  для заказа не мешают), библиотеки 199 (в CI нет таблиц библиотек). P3 и M3 тоже parity 0, без ошибок.

### 2026-11-14, ПК: R1 rev 0.1 — схема аудиоплаты у стенки
- `hardware/r1-audio/` (424 детали): каждый вход уходит на A1 дифференциальной парой с полной шкалой 2 Vrms; буферы Cirrus у АЦП/ЦАП —
  на A1 (AN0635, AN0679). Mic/Line 1–2 (NCJ6FI-V, фантом по каналу на MMBTA92, OPA1612 ×4, OPA1637 громкий/тихий), Hi-Z 1–2 (OPA1642,
  два пути), фоно (реле фоно/линия, RIAA на OPA1612), линии 1–8 (OPA1637, +24 dBu), выходы Main/Aux/RCA (OPA1612 ×3,09 → +18 dBu,
  импедансный баланс, реле G6K-2 по MUTE и R2_OK). Гнёзда вертикального монтажа Neutrik (NCJ6FI-V, NJ3FD-V) — плата одна, без полок.
- Символ OPA1637 — в проектной библиотеке (`make_lib.py`, `opa1637()`). Находка: CS4308P — **токовый выход** (AN0679), уточнение в R136.
- Облаку — #24.

### 2026-11-14, облако: #23 — PW, сверка по даташитам → rev 0.2
`gen/design.py` поправлен, схема пересобрана (`KICAD_SYMBOL_DIR` = копия sym7), `tools/sch_netcheck.py hardware/pw-power`: 178 элементов, 543 вывода, 0 расхождений.
ERC — CI (временная ветка, затем пуш). Даташиты: TPS25730A (таблицы стяжек и емкостей; у D без «A» в выдаче TI только фрагменты — считаю их одинаковыми, проверить на плате),
LM5176 SNVSAI1D, TPS54560 (пример 8.2), TPS7A33 SBVS169, LM5156H SNVSBV2, TPS7A4101 SBVS183.

| Узел | Как было (rev 0.1) | Как в даташите | Правка |
|---|---|---|---|
| TPS25730 VIN_3V3 | вывод с 10 мкФ, без питания | «Tie to GND if device is VBUS powered only» | **VIN_3V3 на GND**, конденсатор снят |
| TPS25730 I2Ct_SDA/SCL | на GND | «May be grounded if unused» | — |
| TPS25730 RESERVED | 10 кОм на GND | «Tie to ground or LDO_3V3» | — |
| TPS25730 ADCIN1…4 | 42,2k/10k (0,19 → 3), ADCIN2 на LDO_3V3 (7), ADCIN3 = ADCIN4 = 3 | 3 → мин. 15 В; 7 → макс. 20 В; ADCIN3 = 3 → 3 А; ADCIN4 = 3 → 5 А | — (совпадает) |
| TPS25730 конденсаторы | LDO_3V3 10 мкФ, LDO_1V5 4,7, VBUS 4,7, CC 330 пФ, PPHV 2 × 22 + 10 мкФ керамика 25 В | 5–25; 4,5–12; 1–10; 200–480 пФ; **PPHV 47–100 мкФ** | + полимер 47 мкФ 35 В на PPHV (керамика 25 В при 20 В теряет бо́льшую часть ёмкости) |
| **LM5176 MODE** | 93,1k **от MODE к VCC** | «RMODE to AGND = 93.1 kΩ»: 1,38–2,22 В = CCM с hiccup; к VCC = CCM без hiccup | **93,1k на AGND** (защита hiccup при КЗ) |
| LM5176 Rsense 8 мОм | «check для 12 В / 5 А» | бак: Rs ≤ 80 мВ / Iout = 16 мОм; буст: порог 100–140 мВ | Порог 12,5–17,5 А > пика 9,9 А при 12 В на входе; ≈ 0,6 Вт — ок, без правки |
| LM5176 SLOPE, VCC, DITH, ISNS, BIAS | 220 пФ; 1 мкФ; DITH на GND; ISNS± на VOUT; BIAS от VOUT | Cslope = L·gm/(Rs·Acs) = 235 пФ; VCC 1–4,7 мкФ ≥ 16 В; DITH на AGND = без дизеринга; ISNS± закоротить = петля выкл.; BIAS 8–36 В | Без правок (VCC — пометка 25 В) |
| LM5176 дроссель | 4,7 мкГн, Isat ≥ 16 А | ток ограничения до 17,5 А | Isat ≥ 18 А (деталь выбрать) |
| LM5176 компенсация | 10k / 33n / 560p (пример 12 В 6 А) | своя для 19 В 5 А по формулам 8.2.2 | Оставил как в примере; **проверить петлю на плате** |
| TPS54560B ×2 | RT 243k, EN 442k/90,9k, 16,9k/4,7n/47p, 3 × 47 мкФ, B560C, 8,2 мкГн | Пример 8.2: всё то же; RT = 101756·f^−1,008 = 242k (400 кГц); дроссель 7,2 мкГн, Isat 7,9 А | Только пометки (8,2 мкГн, Isat ≥ 8 А) |
| LMR33640 инвертирующий | VIN–земля микросхемы 19 + 14 = 33 В | VIN до 36 В | Запас 8 % — оставил; если на плате будут выбросы, поставить 60-вольтовый (LMR36015) — вопрос не к схеме, а к измерению |
| **TPS7A3301 термопад** | на IN (−14 В) | «Connect the thermal pad to a large-area ground plane» | **Термопад на GND** |
| TPS7A3301 EN, NR/SS, FB, выход | EN на IN; 1 мкФ; —; 10 мкФ | EN к IN можно (по модулю EN ≤ IN); 1 мкФ; **10 нФ FB–OUT**; выход ≥ 10 мкФ, рекомендовано 47 | + 10 нФ FB–OUT; выход 47 мкФ |
| TPS7A4701 NR | 1 мкФ | раздел 7.2.2.1.2 не открылся | Не проверено |
| **LM5156H DITHOFF** | на GND | GND = дизеринг **включён**, VCC = выключен | **DITHOFF на VCC** (у фантома ровная частота) |
| LM5156H RT, CS, VCC, FB | 49,9k; 0,1 Ом; 1 мкФ; 1,0 В | f = 2,21·10¹⁰/(RT + 955) = 435 кГц; порог 93–107 мВ → 0,93–1,07 А; VCC 1–4,7 мкФ; VREF 1,000 В | Без правок: пик ≈ 0,7 А при 40 мА (прерывистый ток) |
| LM5156H ключ | IRLML2060, 60 В | узел ≈ 49 В | **IRLML0100TRPBF 100 В 1,6 А, C53658** (8150 шт.) |
| **Буст и TPS7A4101** | 49,7 В → 47,8 В | вход 7–**50** В; VREF 1,173 В (не 1,161); падение до 1,3 В при 50 мА; ток ограничения 51–200 мА | **48,5 В (475k) → 46,1 В (383k)**: запас 1,5 В до 50 В, падение 2,4 В; P48 = 44–52 В |

**Бюджет 100 Вт от PD (оценка).** Без огней на выходах 44–64 Вт (Mini-ITX 25–45, экран 4, звук 10, фантом 2, логика 3) ≈ 49–71 Вт на входе при КПД ~90 %.
На огни остаётся: PD 100 Вт — 26–46 Вт (полная яркость 28 Вт помещается почти всегда); **PD 65 Вт и DC 12 В** (гнездо 5 А = 60 Вт) — 0–15 Вт; DC 24 В (120 Вт) — без ограничений.
Прошивке нужно знать источник и потребление: сейчас этого сигнала на PW нет (I²C TPS25730 на земле) → вопрос В14.

### 2026-11-14, ПК: R145 — два USB-C; PW rev 0.1 — схема питания
- **R145:** USB-C (PC) — только данные, развязан; отдельный **USB-C Power** (PD до 100 Вт) во втором ряду блока Power/USB
  (DC, USB-C Power, On/Off) — модель, рендер, v3, артефакт модели (версия 15).
- `hardware/pw-power/` rev 0.1 (только схема, 177 деталей, 95 цепей): DC / USB-C PD (TPS25730D без I²C: 15–20 В, 3/5 А) / аккумулятор
  через идеальные диоды LM74700 → выключатель на стенке → BUS 12–24 В → 19 В 5 А для Mini-ITX (LM5176), +5V_PANEL и +5V
  (2 × TPS54560B по 5 А), ±14 В (LMR33640, второй инвертирующий) → ±12 В (TPS7A4701 / TPS7A3301), +48 В (LM5156H + TPS7A4101).
  Все символы — из KiCad; в копиях sym7 два исправления типов выводов (второй OUT у TPS7A4701 — passive, VOSNS у LM5176 — input).
  Флаги питания в общем писателе теперь сеткой по три слева от деталей. `sch_netcheck` — 0, все выводы символов перечислены.
- Облаку — #23 (сверка PW по даташитам).

### 2026-11-14, ПК: R144 уточнено — Thru на любом выходе, надписей Thru на панели нет
- Пользователь: «надписи на двух портах, а реализовать можем везде — глупо» → Thru — режим любого MIDI-выхода (DIN 1–4, TRS O1/O2)
  в меню, подписи на стенке снова Out 1–4 (модель, рендер, v3, артефакт модели). Прошивке: PIO-копия MIDI_RX1/2 → любой MIDI_TX.

### 2026-11-14, ПК: R144 — MIDI Thru программно, Out/Thru 3 и 4 (заменено записью выше)
- Пользователь: входы и выходы DIN — оба «мамы» (так и есть, разница в распайке и разъёмах кабелей: выход PH 3, вход PH 2);
  отдельного Thru нет → **R144**: Out 3 и Out 4 в меню становятся Thru от In 1 или In 2, копию делает PIO RP2350 побитно.
  На панели подписи **Out/Thru 3**, **Out/Thru 4**: `model3d/index.html`, `tools/rear_panel_render.py`, `tools/rear_panel.py`.
- Прошивке (R2): режим Thru у Out 3/4 — PIO-программа «вход → выход» на пинах MIDI_RX1/2 → MIDI_TX3/4, выбор источника в меню.

### 2026-11-14, ПК: R141–R143 — задняя стенка как в 3D-модели, гнёзда на гайках, R2 rev 0.4, R2b снята
- Пользователь: блоки разъёмов в модели нравятся больше (MIDI на v2 «ушли от задумки»). **R142**: стенка = 3D-модель панели v7
  (`model3d/index.html`), `tools/rear_panel.py` v3 → `docs/ru/img/rear_panel_v3.png`. **R141** (заменяет R139): DIN × 6, USB-C (PC),
  USB-A, LAN, DC — панельные на гайках с кабелями; полка R2b удалена (`hardware/r2b-jacks`, пакет R2b). **R143**: MIDI TRS —
  стерео со склада JLC **Hroparts PJ-3920-3A** (C707259; распиновка по Flux: 1 гильза, 2 кончик, 3 кольцо — проверить гильзу на образце).
- R2 rev 0.4: контур — блок Control (rear x 88–263, z 10–113) без окна за DIN, буквой L 175 × 103; 20 гнёзд 3,5 мм по модели (F);
  на B — 6 разъёмов JST PH под кабели DIN вдоль окна, кабельные разъёмы у правого края, остальное пакуется у своих ИС и гнёзд.
  `pcb_geomcheck` 0, выводы = площадки, `sch_netcheck` 0. Пакет `hardware/for-routing/R2` пересобран.
- Расхождение на будущее (PW): в модели в блоке Power/USB **один** USB-C (PC) «с питанием PD», а в R2 rev 0.1–0.3 был отдельный
  USB-C PD. Решить вместе с PW. Ещё: панельные DIN на шаге 22 мм — подобрать с круглым фланцем.

### 2026-11-14, ПК: R2 и R2b — платы расставлены, пакеты для EasyEDA
- **R2b rev 0.2:** плата 245 × 30, гнёзда лицом на кромку у стенки (y = 0) по панели v2. Посадки DIN-5 SDS-50J и запирающего DC
  **Kycon KLDHCX-0202-BC-1** (C19842566, 2,5 мм, 5 А 24 В) сняты из библиотеки LCSC/EasyEDA новым `tools/eda/lcsc_fp.py`
  (в `ShtukaDruka.pretty`). USB-C PC — на символе 16P (у посадки HRO есть SBU A8/B8).
- **R2 rev 0.3:** плата 258 × 75 + язычок 20 мм вниз до z 11 с розеткой гребёнки (низ). Гнёзда — по панели v2; MCU, хаб и разъёмы
  кабелей — слева (верх); обвязка каналов CV/синхро — на низу за своим гнездом; ЦАП и ОУ — между колонкой TRS и CV; MIDI CA-033 — на
  язычке. Раскладчик `hardware/common/gen/packer.py` (группы вокруг якоря, спиральный поиск места).
- **MIDI TRS — стерео:** PJ398SM моно, без кольца. Взят стерео-Thonkiconn **PJ366ST** (по Thonk: посадка та же, вывод TN = кольцо;
  на LCSC нет, пайка вручную, как и PJ398SM — у него на LCSC только пользовательский C9900009788). Посадка
  `ShtukaDruka:Jack_3.5mm_QingPu_WQP-PJ366ST_Vertical_CircularHoles`. Моно-гнёзда — символ AudioJack2_SwitchT (S, T, TN).
- Проверки без kicad-cli: `tools/pcb_geomcheck.py` (новый: курт­ярды по сторонам, сквозные площадки против SMD, площадки у края) —
  0 проблем на R2 и R2b; выводы символов = площадки посадок у всех деталей; `sch_netcheck` — 0.
- Пакеты `hardware/for-routing/R2`, `R2b` (`pack_easyeda.py --no-cli`; netlist из design.py; PDF/DXF — на CI). Импорт через API
  (`eda_import.py`) в EasyEDA 3.2 не работает (возвращает null) — нужен GUI-импорт R2_v1, R2b_v1.

### 2026-11-14, ПК: R139/R140 — полка R2b, R2 rev 0.3, задняя панель v2
- Ответы пользователя: В12 → (а) полка R2b (**R139**), В13 → панель v1 за основу (**R140**).
- `hardware/r2b-jacks/` rev 0.1 (новая плата, только схема): DIN-5 × 6 (SDS-50J), USB-C к ПК (HRO, Rd, USBLC6) → кабель к A1 порт B,
  USB-A (USBLC6) → кабель к Mini-ITX, USB-C PD **GCT USB4105-GF-A-060 5 А** (C3025063), DC (запирающее 5 А — выбрать) → 2×5 к PW.
  К R2 — гребёнка 2×7 только с линиями DIN (1–8 выходы 1–4 выводы 4/5, 9–12 входы 1–2, 13–14 GND). 18 деталей, 25 цепей.
- `hardware/r2-control/` rev 0.3: гнёзда и их ESD ушли на R2b, вместо них розетка 2×7; резисторы CA-033 и оптроны остались на R2. 216 деталей, 157 цепей.
- `tools/sch_netcheck.py`: R2 — 675 выводов, R2b — 118, расхождений 0. В sym7 добавлен символ USB_C_Receptacle_USB2.0_16P.
- Задняя панель v2: `docs/ru/img/rear_panel_v2.png/.svg` (`tools/rear_panel.py`, v1 оставлен). R2b — нижний ряд z 18; R2 — z 38–113,
  колонка MIDI TRS над DIN, CV/синхро 6 × 3 с шагом 20 мм. Таблица гнёзд — в README R2. Карта плат (док. 29) дополнена строкой R2b.

### 2026-11-14, облако: #20 — R2: CI, даташиты, гнёзда, задняя панель

**1. CI.** Прогон 43564302094 на dd739e9 — зелёный. R2: ERC 0 ошибок (только предупреждения библиотек). P3 rev 0.4: DRC 0 ошибок
(16 «огонь не как в библиотеке», 116 «библиотека не подключена»), соответствие схеме 0.

**2. Сверка R2 по даташитам → rev 0.2** (`gen/design.py`, схема пересобрана, `tools/sch_netcheck.py`: 244 элемента, 763 вывода, 0 расхождений;
ERC — CI на этом коммите).

| Узел | Как было (rev 0.1) | Как в даташите | Правка |
|---|---|---|---|
| RP2350 VREG: дроссель | 3,3 мкГн, NR-30xx, «≥ 1,4 А, check» | Минимальная схема: AOTA-B201610S3R3-101-T, 3,3 мкГн, 2,1 А, 0806; полярный — ставить как на эталоне | L1 → AOTA (C42411119; на LCSC 10 шт. на 14.11), посадка `L_Abracon_AOTA-B201610S` |
| VREG_AVDD, VREG_VIN, DVDD, FB, PGND | 33 Ом + 4,7 мкФ; 4,7 мкФ; 4,7 мкФ; FB на DVDD; PGND на GND | Так же | — |
| IOVDD, QSPI_IOVDD, USB_OTP_VDD | 6 × 100 нФ | 100 нФ на вывод, выводы 53 и 54 — один общий | +1 × 100 нФ (итого 7) |
| ADC_AVDD | 33 Ом + 1 мкФ | В минимальной схеме только 100 нФ | Оставлено (свой фильтр, не мешает) |
| Кварц 12 МГц | C9002 (X322512MSB4SI, нагрузка 20 пФ) + 2 × 15 пФ + 1 кОм на XOUT | ABM8-272-T3, нагрузка 10 пФ, 2 × 15 пФ, 1 кОм | Кварц → ABM8-272-T3 (C20625731) |
| QSPI, BOOTSEL | 10 кОм на QSPI_SS, кнопки нет | 10 кОм — DNF; кнопка BOOTSEL на QSPI_SS через 1 кОм | + кнопка TS-1187A (C318884) и 1 кОм; 10 кОм оставлен |
| RUN, SWD, USB | 10 кОм + 100 нФ; разъём SWD; 27 Ом | Кнопка RUN по желанию; SWD; 27 Ом у микросхемы | — |
| DAC80504 GAIN, RSTSEL, LDAC | VIO, VIO, GND | GAIN = VIO → ×2; RSTSEL = VIO → середина шкалы; LDAC можно держать на GND (обновление по CS) | — |
| **DAC80504 REFDIV** | GND (опорное 2,5 В без деления, ×2 → 0…5 В) | Без делителя нужно VREF ≤ VDD/2, т. е. **VDD ≥ 5,0 В**; иначе тревога REF-ALM — **все выходы 0 В**; 5 В на выходе ещё и требует запаса над VDD | **REFDIV = VIO** (÷2, ×2 → 0…2,5 В), середина 1,25 В |
| Разностные каскады CV | Vout = 4,02 · (Vdac − 2,5), 10k / 40,2k, опорное REF | — | **Vout = 8,06 · (Vdac − 1,25)** = −10,1…+10,1 В: 10k / **80,6k** (0,1 %), опорное = буфер REF/2 (делитель 10k/10k 0,1 % + 100 нФ). Шаг тот же 0,31 мВ, шум ЦАП на выходе ×2 |
| DAC80504 SPI | — | 24 бита: R/W, 3 нуля, адрес 4 бита, данные 16; SDI читается по спаду SCLK; запись до 50 МГц | Для прошивки |
| DAC80504 номер | C2859652 (страница не открылась — не проверен) | DAC80504RTET — C2862796 (79 шт., от $16) | → C2862796 |
| OPA4197 | ±12 В, 1 кОм на выходе | Rail-to-rail вход и выход, 4,5–36 В (описание TI; ёмкостную нагрузку по даташиту не перепроверял) | — |
| USB2514B стяжки | CFG_SEL0/1, NON_REM0/1 — один общий 10 кОм на GND | «Strap low» — без деталей (внутренние подтяжки вниз); HS_IND и SUSP_IND после сброса — выходы светодиодов: общий узел их замыкает | Стяжки сняты, 4 вывода не подключены (CFG_SEL = 00: настройки по умолчанию) |
| USB2514B CRFILT, PLLFILT | 1 мкФ | «до 0,1 мкФ, low ESR» | → 100 нФ |
| USB2514B VBUS_DET | 10k / 20k от 5 В (3,33 В) | Делитель 2:1, «два по 100 кОм» | → 100k / 100k |
| USB2514B прочее | RBIAS 12k 1 %, 24 МГц + 2 × 18 пФ, TEST на GND, RESET_N 10k + 1 мкФ, 4 × 100 нФ | RBIAS 12,0k 1 %; нагрузка «около 18 пФ»; TEST — не подключать или на GND; RESET_N ≥ 1 мкс; 6 выводов питания | Кварц → X322524MOB4SI 12 пФ (C70590); 100 нФ → 6 шт. |
| TLP2361 | Питание 3,3 В, выход без подтяжки | 2,7–5,5 В, выход двухтактный, **инвертирующий**; IFHL ≤ 1,6 мА | — (светодиод горит = «0» MIDI → выход 0: полярность верна; от передатчика 3,3 В ток ≈ 6 мА) |
| MIDI DIN выход | 33 Ом 0,5 Вт + 10 Ом | CA-033, 3,3 В | — |

Номера и склад LCSC (14.11.2026): RP2350A C42411118 — Extended, 5380 шт., от $1,13; USB2514B-I/M2 C220679 — 965 шт.; DAC80504RTET C2862796 — 79 шт.;
OPA4197IPWR C2057327 — 1637 шт.; TLP2361 C107626 — 27 610 шт.; дроссель C42411119 — **10 шт.**; ABM8-272-T3 C20625731 — 315 шт.;
W25Q128JVSIQ C97521 и X322524MOB4SI C70590 — страницы склада облаку не открылись. Basic/Extended виден только у RP2350A (Extended).
Без номера пока: резисторы 0,1 % (10k, 80,6k), 33 Ом 1206 0,5 Вт, обычная обвязка — подобрать при BOM.

**3. Гнёзда R2.** Главное: **на вертикальной плате у стенки гнёзда должны быть «вертикального» монтажа** (ось перпендикулярно плате), как PJ398SM.
- DIN-5 **CUI SDS-50J — угловой** (по таблице Same Sky: PCB, right angle); Cliff FM6725 — тоже угловой. Вертикальный DIN-5 на LCSC не нашёл. → вопрос В12.
- DC запирающееся 5 А: **Kycon KLDVHCX-0202-A** — запирающееся, 5 А, 24 В, вертикальное (перпендикулярно плате); LCSC C19842581 — **нет в наличии** (есть у Digikey).
- USB-C 5 А для PD: вертикального на 5 А не нашёл; вертикальный SHOU HAN TYPE-C 16PLT-H10.0 (C3151749) — **3 А** (PD до 60 Вт при 20 В);
  на 5 А только угловые: GCT USB4105-GF-A-060 (C3025063, 5 А, 20 В), HCTL HC-TYPE-C-16P-FLS7.2-5A-11 (C5379115, 566 шт.). У HRO TYPE-C-31-M-12 ток не проверил.
- В схеме rev 0.2 USB-C ×2 (HRO), USB-A (Molex 67643) и DC (CUI PJ-063AH) тоже угловые — меняются вместе с ответом на В12.
- Высота: задняя стенка **143 мм** (R44; 105 мм в документе 13, 3.5 устарело), плата у стенки до 104 мм (док. 34), верх гнёзд ниже ≈116 мм (док. 13, 3.6). PJ398SM в 3 ряда (z 30/55/80) и DIN в 2 ряда (z 35/70) помещаются.

**4. Задняя панель, предложение v1** — `docs/ru/img/rear_panel_v1.png`, `.svg` (генератор `tools/rear_panel.py`), таблица гнёзд R2 — в README R2.
Вид сзади слева направо: ПИТАНИЕ/USB (x 5–63) → MIDI (DIN 3 × 2 + колонка TRS, x 71–167) → CV/СИНХРО (6 × 3 по 14,5 мм, x 175–263) — это R2, ровно 258 мм;
дальше R1: ВЫХОДЫ (x 273–343) → ВХОДЫ (x 353–511). Входы в рамке, выходы с заливкой (R26). Подписи CLK/RESET — сокращения, чтобы влезть в шаг 14,5 мм.
Контур R2 и `placement()` — после ответов В12, В13.

### 2026-11-14, ПК: R2 (управление) rev 0.1 — схема
- `hardware/r2-control/` (R138): RP2350A + флеш 16 МБ, хаб USB2514B (вверх Mini-ITX; вниз RP2350, P2, A1 порт A, запасной), USB-C к компьютеру
  (на A1 порт B), USB-A (к Mini-ITX), гнёзда питания (USB-C PD и DC → PW по 2×5), MIDI DIN 2 вх / 4 вых и TRS 1 вх / 2 вых по CA-033 на 3,3 В,
  8 CV/Gate ±10 В (2 × DAC80504 + 3 × OPA4197, разностные каскады ×4,02), 4 CV-входа на АЦП RP2350, синхро 3 вых / 2 вх, линии к A1/R1
  (фантом × 2, фоно, MUTE реле, R2_OK). 225 деталей, 168 цепей. **Только схема:** плата — вместе с раскладкой задней панели (док. 13, 3.5).
- ЦАП: 2 × TI DAC80504 (4 канала, INL ±1 LSB) вместо AD5676R — у AD5676R нет символа в библиотеке KiCad; 8 каналов те же.
- Общий писатель `module_sch.write_grid`: многосекционные символы (ОУ) ставятся по секциям; ячейки по размеру выводов; флаги питания
  `PWR_FLAG_NETS` / `NO_PWR_FLAG` из design.py. Новая проверка без kicad-cli: `tools/sch_netcheck.py` (R2: 749 выводов, 0 расхождений; P4 — 0).
- **Облаку:** ERC R2 по CI (платы нет — CI делает только ERC); проверить по даташитам места с пометкой «check» в README R2.

### 2026-11-13, ПК: решения R135–R138, EasyEDA переимпортирована, P3 rev 0.4; начата R2
- Ответы пользователя на вопросы документа 34: **R135** линейные входы до +24 dBu; **R136** ЦАП CS4308P (своя посадка; ES9039PRO/AK4499EX —
  токовый выход, отказались); **R137** ключи выходов — реле; **R138** платы задней стенки начинаем с R2 (управление).
- **EasyEDA:** M3_v5, M4_v3, M5_v3, W1_v4, W2_v4, W3_v2, P1_v2, P3_v5, P4_v2 — импорт + Import Changes + правило Via Size, проверка
  `tools/eda/eda_verify.py` (новый): цепи = netlist у всех, 0 расхождений значений/LCSC, DRC EasyEDA — только неразведённые связи
  (W1, разведённая облаком, — DRC 0). Старые проекты — в корзине Windows по слову пользователя; M1_v2 оставлена референсом.
- **P3 rev 0.4:** DRC EasyEDA нашёл 4 ошибки «Device to TH Pad»: сквозные отверстия под площадкой драйверов U7–U10 (блок Level) вплотную
  к огням D48/D72/D96/D120 (после R131 кольца r 10,5 подошли ближе, как было у W2 в #15). Драйверы поставлены в середину свободной от огней
  полосы между кольцами (`m2-levels/gen/design.py`): от отверстия до огня 1,38 мм. **Облаку:** DRC/parity P3 rev 0.4 по CI, pdf/dxf/превью.

### 2026-11-13, ПК: подготовка пакетов к EasyEDA (разводку ведёт пользователь сам, позже)
- Пользователь: «пока только готовь принципиальные схемы и подготовку для easyeda. Роутингом я займусь позже сам, с твоей помощью».
  Пробы автороутера EasyEDA и Freerouting на M3 остановлены, M3_v4 возвращена в неразведённое состояние.
- **Найдено на M3 в EasyEDA** (проба M3_test, подробности — `hardware/for-routing/README.md`, п. 7–8 «Как открыть»):
  1. DRC EasyEDA «Netlist Error»: на плате цепи с «/» и `unconnected-(…)`, в схеме EasyEDA питание называется по символу — `power_+5V`.
  2. Импорт раздаёт деталям одного корпуса значение первой: на M3 C4 10u (надо 4.7u), C6 1u (1n), C7 1u (100n), R3 4.7k (10k) — у всех
     импортированных проектов значения на платах, скорее всего, такие же неверные. Лечится **Design → Import Changes from Schematic → Apply**
     (только свойства; детали и цепи не трогает, проверено: 0 сдвигов, 38/38, все LCSC и значения = design.py).
  3. Правило Via Size после импорта перевёрнуто (наружный 0,3, отверстие 0,6) — автороутер не стартует; поправить вручную.
- **`tools/pack_for_routing.py`** (общий для облака и ПК): `easyeda_sch()` — символы питания без «power:», `easyeda_pcb()` — цепи платы
  без «/» и без `unconnected-(…)`. После этого имена цепей схемы и платы в EasyEDA совпадают (39/39 на M3), «Netlist Error» нет.
  Перепакованы M3, M4, M5, W1, W2, W3, P1, P3, P4 (`--no-cli`; netlist.net от kicad-cli не тронуты). M1 не перепаковывалась.
- Инструменты на будущее: `tools/eda/eda_exec.py` (JS в окне нужного проекта), `tools/eda/js/pcb_drc.js`, `pcb_parts.js`, `pcb_state.js`;
  `hardware/common/gen/routing.py` (Freerouting + заливки GND + сшивка), `quilter_inputs.py` (вход для Quilter: плата, схема, проект, 3 CSV).
- **Облаку:** при следующей сборке пакетов ничего делать не нужно — правки уже в `pack_for_routing.py`; проверить, что CI не задевает.

### 2026-11-13, облако: #18 — окно W1, проверки W1/M3/M4/M5/P3, ТЗ
**CI KiCad 10, прогон 43477566859 (b7de7e9), зелёный.** ERC — 0 ошибок у всех пяти; соответствие схеме — 0 у всех пяти.

| Плата | DRC ошибки | Неразведённых | Parity | Прочее (предупреждения) |
|---|---|---|---|---|
| W1 rev 0.2 | 0 | **0** | 0 | 34 «библиотека не подключена», 5 шелкография |
| M3 rev 0.2 | 0 | (не разведена) | 0 | шелкография 13, 4 огня «не как в библиотеке» |
| M4 rev 0.2 | 0 | (не разведена) | 0 | шелкография 12, те же 4 огня |
| M5 rev 0.2 | **2** перекрытие контуров ENC ↔ огонь | (не разведена) | 0 | шелкография 12 |
| P3 rev 0.3 | **16** перекрытие контуров ENC ↔ огни колец | (не разведена) | 0 | 16 огней «не как в библиотеке» |

1. **W1 rev 0.2** (R132): `M5_X = (5, 89)`, окно 85 × 35 мм (W1 x 4,5–89,5; контур M5 rev 0.2 с зазором 0,5 со всех сторон — по построению `window()`),
   правый обод 2,5 мм, через него одна дорожка. Полная пересборка: Freerouting 1.9, 100 проходов (22 мин), 555 дорожек и переходных + 353 сшивки.
   `check_netlist` 141 вывод, 0 расхождений. **Попутно:** KiCad 10 давал на W1 127 предупреждений соответствия (и на rev 0.1): имена цепей без «/»,
   нет полей LCSC/Note, однопиновые цепи без имени, отверстия вне BOM. В `w1-levels/gen/make_pcb.py` добавлен `parity_fix()` — теперь 0.
   Пакет `for-routing/W1` пересобран после правки (имена цепей с «/», как у плат ПК, которые EasyEDA импортирует без ошибок); повторный импорт W1 в EasyEDA не делал.
2. **M3, M4, M5, P3**: `check_netlist` в облаке — 0 расхождений (по 202 вывода, P3 1216). Ошибки M5 и P3 — задача ПК **#19**.
   В пакетах заменены `schematic.pdf`, `outline.dxf`, превью (у P3 добавлены); копии KiCad 7 совпали с платами ПК по всем площадкам.
3. **ТЗ** `SPEC_boards.md` по R128–R134.

### 2026-11-13, ПК: W1 rev 0.2 в EasyEDA, #19 (В11) сделан
- EasyEDA **W1_v3** (W1 rev 0.2 из пакета облака): 38/38 деталей, 35/35 и 35/35 цепей; W1_v2 — в корзину (с согласия пользователя).
- #19: контур энкодера по корпусу (ответ В11 (а)), пересечений контуров 0 на M1, M3, M4, M5, P3; M2 как плата убрана из репозитория.
- Повторный импорт M3–M5 и P3 в EasyEDA не делался: цепи и площадки те же, изменился только контур (courtyard).

### 2026-11-13, ПК: ответы В3, В4, В7, В8 — стопка вопросов ПК пуста
- В4 → решения R129 (P99), R130 (P100); ответы В1, В2, В9, В10 записаны решениями R131–R134 (`docs/ru/decisions/08_boards.md`).
- В7: 14 устаревших проектов EasyEDA удалены в корзину (EasyEDA держала файлы открытых проектов — закрыты её окна).
- В3, В8: подтверждено, без изменений.
- Пользователь: GitHub-агент шлёт письма на каждую ошибку — эксперименты держать локально, пушить пачками и зелёным CI.

### 2026-11-13, ПК: ответы В1, В2, В9, В10 — M3, M4, M5, P3 пересобраны
- **В2 (кольца по макету):** `kit.ring_r(name)` = поле `ring` / 2. M3 и M4: r 15 (было 14), M5: 10,5 (было 11), Level на P3: 10,5 (было 10).
- **M4 rev 0.2:** при r 15 огни выходили за край 339–405 → плата 70 мм, x 337–407 (до M1 4,25 мм, до P4 6 мм), детали от середины платы — на местах.
- **В1:** M5 rev 0.2 — 84 мм, панель x 15–99, Clip 2 в 3 мм от края. Окно W1 — облаку (#18), W1 разведена и в формате KiCad 7, на ПК её не трогаю.
- **P3 rev 0.3:** кольца Level 10,5; отверстие у кольца Level 8 справа перенесено на y 223,5 (было в 1,9 мм от огня).
- Проверки ПК: снизу пересечений нет, огни внутри контура, отверстия не ближе 2,3 мм к площадкам (у отдельной M2 углы у Level 8 — 1,9 мм, но она не делается).
  EasyEDA: **M5_v2, M4_v2, M3_v4** — 38/38 и 38/38, 46/46; **P3_v3** — 226/226 и 226/226, 276/276.
- **В9:** W3 не меняется (README). **В10:** задел колеса остаётся (README P4).
- Лишние проекты EasyEDA пополнились: M3_v3, M4_v1, M5_v1, P3_v2 (В7).

### 2026-11-13, ПК: P3 rev 0.2 — P3 и M2 на одной плате (решение пользователя R128, В5 закрыт)
- Пользователь: «Да и пусть она будет 4 слойная, но одна. Две двуслойные мне кажется дешевле не будет, шлейфы, разъёмы... сливай».
- `hardware/p3-tracks/` rev 0.2: 67,5 × 258 (x 339–406,5), **4 слоя**, 276 деталей. Выреза, J2 и шлейфа к M2 больше нет.
  Блок ручек берётся из `hardware/m2-levels/gen/design.py` (детали и раскладка, сдвиг (43,5; 17)), номера деталей — после своих у P3,
  ячейки огней A–D → LA–LD, SR_Q1/2 → SR_L1/2; I²C блока — канал 1 мультиплексора (у блока свои LP5864 0x40–0x43, поэтому отдельный канал).
  Цепочка: кнопки P3 → ручки (Level 8 первым) → M4. Отверстия: 19 (правый край в 7 местах), до любой площадки не ближе 2,3 мм.
- Проверки ПК: снизу пересечений корпусов нет; EasyEDA **P3_v2**: 226/226 и 226/226 цепей, 276/276 деталей.
- `tools/pack_easyeda.py --no-cli`: netlist.net, ранее собранный им же из `design.py`, теперь пересобирается
  (у P3 сначала сверялся старый netlist rev 0.1); netlist от kicad-cli не трогается.
- M2 как отдельная плата не делается: пакет `hardware/for-routing/M2` удалён, M2 убран из `tools/boards_extra.py`; `hardware/m2-levels` остаётся источником блока.
- **Облаку:** ERC/DRC, `check_netlist.py`, pdf/dxf/превью для P3 rev 0.2 (вместо отдельных P3 и M2). В ТЗ (`SPEC_boards.md`) M2 и P3 — поправить по R128.

### 2026-11-13, ПК: M2 Levels — все цифровые платы по ТЗ готовы, кроме P2
- `hardware/m2-levels/` (24 × 205, 4 слоя, 166 деталей): 8 энкодеров Level 8…1 (x 394,5, y 52 + 25k), кольца по 12 огней r = 10 мм,
  4 × LP5864 (ячейки A–D, 0x40–0x43, по паре колец: Level 8+7, 6+5, 4+3, 2+1), CY8CMBR3108 (касание через 560 Ом на корпус MP, как M1),
  3 × 74HC165 (Level 8 первым, A, B, кнопка), J1 шина модулей.
- Раскладка снизу: выводы энкодера стоят по x (4,5 и 19 мм), лапки корпуса по y ±5,6, поэтому между энкодерами свободна полоса 11,8 мм.
  Драйверы стоят в полосе между кольцами своей пары. J1 — в полосе Level 5/4 (y платы 105,5 = панель y 139,5, напротив J2 платы P3 на y 139).
  Касание — в полосе Level 7/6. Регистры и сборки подтяжек — под энкодерами, в свободной колонке x 6–17.
  Отверстия: 4 угла + по бокам в трёх полосах (шаг ≤ 53 мм). Пересечений корпусов снизу и деталей на выводах энкодеров нет (проверка скриптом pcbnew).
- CMOD 2,2 нФ — C1531 (FH 0402B222K500NT X7R, Extended, найден в библиотеке EasyEDA).
- EasyEDA **M2_v2**: плата 146/146 и схема 146/146 цепей, 166/166 деталей. В **M2_v1** схема склеивала цепи соседних энкодеров:
  в общем писателе схем (`module_sch.write_grid`) у символа энкодера была ячейка 6 клеток при выводах на ±3. Исправлено (ячейка 12);
  P1 и P4 при следующей генерации получат ту же ширину. M2_v1 — лишний проект, добавлен в **В7**.
- Внимание: `gen/check_netlist.py` вызывает kicad-cli — на ПК его не запускать (упал сразу, схемы ещё не было).
- **Облаку:** ERC/DRC, `check_netlist.py` и pdf/dxf/превью для M2 и P3 (как #14).

### 2026-11-13, ПК: P3 Tracks; #15 сделан
- `hardware/p3-tracks/` (66 × 258, 120 деталей): 21 кнопка по 2 огня, 2 × LP5864, 3 × 74HC165, TCA9546A 0x71 (ch1 → M2, ch2 → M4, ch3 → W2),
  J1 2 × 8 к P2 у левого края, J2 к M2 у кромки выреза, J3 к M4 и J4 к W2 у заднего края. Цепочка P3 → M2 → M4 (W2 вне цепочки).
- **Вырез под M2** открыт к правому краю (x 43–66, y 16,5–222,5 по плате): полоса ручек M2 по ТЗ выходит за край x 405, ▼ и ▲ — на перемычках спереди и сзади.
  Контур — многоугольник `OUTLINE` в `design.py` (общий писатель платы теперь умеет произвольный контур). Край 405 или 409 — **В5**.
- EasyEDA **P3_v1**: 90/90 и 90/90, 120/120 (эталон из `design.py`). **Облаку:** ERC/DRC из лога CI и pdf/dxf/превью для P3 (как #14).
- #15 — см. отметку в очереди ПК (W2 rev 0.1c, `flip_bottom`). Дальше по ТЗ — M2.

### 2026-11-13, облако: #14 — отчёты CI шести плат ПК, пакеты, разъём M1/W1
**1. CI (KiCad 10, прогон 43426923909 на fe5ed0b), всё кроме неразведённых связей.** Соответствие схеме (parity) у всех шести — 0 расхождений; ERC — 0 ошибок.

| Плата | Ошибки DRC | Предупреждения DRC | ERC (только предупреждения) |
|---|---|---|---|
| M3 | 0 | шелкография 13 (подпись J1 на C1 и маске), 4 огня «не совпадает с копией в библиотеке» (D7, D9, D19, D21) | одинокая метка ~INT |
| M4 | 0 | шелкография 12, те же 4 огня (D7, D9, D19, D21) | одинокая метка ~INT |
| M5 | **2**: медь огня D24 (Clip 2) в 0,15 мм от края при норме 0,3 (вопрос В1) | шелкография 12 | одинокая метка ~INT |
| W2 | **6**: переходные в центральной площадке LP5864 U1, U2 (снизу) выходят под огни D8, D22 сверху: зазор 0,127 мм при норме 0,15 (4), сквозное отверстие в контуре огня (2) | шелкография 28 | одинокие метки ~INT, ~SR_LOAD, SR_CLK (на W2 нет регистров, это ожидаемо) |
| W3 | 0 | шелкография 14 | одинокая метка ~INT |
| P1 | 0 | шелкография 42 | одинокая метка SR_IN (на деке цепочка кончается, ожидаемо) |
| P4 (прогон 43427274603) | 0 | шелкография 34; **соответствие схеме — 1 расхождение**: имя пустой цепи вывода 2 ADS1115 U7 `unconnected-(U7-ALERT/RDY-Pad2)` на плате, а схема пишет `ALERT{slash}RDY` | одинокая метка SR_IN (ожидаемо) |

- У всех плат ещё «библиотека не подключена в конфигурации» (символы и посадочные места): в CI нет таблиц библиотек, так же у M1, W1. Не ошибка.
- «Огонь не совпадает с копией в библиотеке» (M3, M4: по 4 огня под углами 0/180°) — вероятно, округление повёрнутой копии; не проверял.
- Шелкография: подписи деталей поверх соседних площадок и контуров. Для EasyEDA поля и так скрыты; править по желанию.
- Правки в генераторах — задача ПК **#15** (W2, переворот нижних деталей; M5 ждёт В1).
- Как читать CI из облака: артефакт `kicad-out` не скачивается (прокси облака не пускает в хранилище GitHub), поэтому `kicad.yml` теперь
  печатает ERC и DRC всех уровней в лог группами «ERC/DRC <плата>» (без неразведённых), отчёты в артефакте прежние.
  Из CI убраны папки `quilter/` и `quilter_raw/` (предложение ПК). CI остаётся красным только из-за `m1-screen-knobs/almost/` (идёт #12).
  Предложение: положить в `almost/` файл `UNROUTED`, пока #12 не закончен, — тогда новые ошибки плат будут видны по цвету прогона.

**2. Пакеты for-routing.** У W3, P1 и P4 добавлены `schematic.pdf` и `outline.dxf`, у всех семи (с P4) — `preview_top.png`, `preview_bottom.png`.
`<ID>_kicad7.zip`, `BOM*.csv`, `netlist.net` шести плат не трогал. Платы пересобраны в KiCad 7 через `gen/make_pcb.py` (только для картинок и контура,
в репозиторий не кладутся). **Найдено:** KiCad 7 переворачивает нижние детали иначе, чем KiCad 10, — копия получилась с нижними деталями,
повёрнутыми на 180° (разъёмы — выводом 1 в другую сторону). Копии повёрнуты обратно и сверены: все площадки семи плат (с P4) на тех же местах, что в файлах ПК. Генератор — #15 (2).

**3. M1 и W1: разъём шины C5372811** (выводной PZ127-2-07-Z) вместо C3975190 (SMD). Изменены `w1-levels/gen/design.py` и схема W1 (только поле LCSC),
запасной номер в `tools/pack_for_routing.py` (2 × 7 → C5372811, 2 × 8 → C5372812), ТЗ и документ 31. Пакеты M1 и W1 пересобраны:
отличаются только номером разъёма (детали, места, цепи те же; проверено сравнением плат). Импорт в EasyEDA повторять не нужно: проекты M1_v2, W1_v2
можно оставить, номер разъёма поправить в BOM при заказе.

### 2026-11-13, ПК: P4 Right
- `hardware/p4-right/` (92 × 293, 123 детали): 20 кнопок по 2 огня, 2 × LP5864, 3 × 74HC165, кроссфейдер → 1k/100n → ADS1115 0x48 (P104),
  AS5600 0x36 под осью колеса (режим 3,3 В), TCA9546A 0x72 (ch0 свои + АЦП + датчик, ch1 → W3), J1 2 × 8 к P2 у левого края, J3 к W3 у заднего края, J4 — кнопка колеса (**В10**).
  EasyEDA **P4_v1**: 84/84 и 84/84, 123/123 (эталон из `design.py`). ERC/DRC — облако/CI (#14, добавить P4).
- Символ AS5600 нарисован в `hardware/common/lib/Common.kicad_sym` (в библиотеках KiCad его нет), `m1compat` берёт `Common:*` оттуда.
- Номера из библиотеки EasyEDA: AS5600-ASOM C79815, PTA4543-2015DPB103 C17444183 (заглушка кроссфейдера, P90), JST B2B-PH-K-S C20504437.

### 2026-11-13, ПК: номера деталей по библиотеке EasyEDA (просьба пользователя «проверяй библиотеки easyeda»)
- Новый `tools/eda/eda_parts.py KEY...` ищет детали в системной библиотеке EasyEDA (база LCSC/JLCPCB) через мост: номер LCSC, корпус, класс JLCPCB (Basic/Extended).
  Наличие и цену библиотека не отдаёт.
- **Ошибка в разъёме шины:** C3975190 = HCTL PZ127-2-07-S — **SMD**, а посадочное место во всех платах (и M1, W1) — выводное.
  Выводной той же серии: PZ127-2-07-Z **C5372811**; для 2 × 8 (P100) — PZ127-2-08-Z **C5372812**. В M3–M5, W2, W3, P1 исправлено; **M1, W1 — облаку**.
- Найдено и вписано (COMPONENTS.md, lcsc_status.json, `kit.py`): TCA9546APWR **C201653**; 4,7 мкФ 0805 **C1779**, 1 нФ 0402 **C1523**, 0 Ом **C17168** (Basic);
  560 Ом **C25126** (Extended, для M1/M2); энкодер Alps EC11E1834403 **C361165** (гладкий 0/18, с кнопкой). Подтверждены прежние «проверить»: C1525, C52923, C15850, C25744, C25900, C11702.
- Пакеты M3, M4, M5, W2, W3, P1 пересобраны (без kicad-cli): строк без номера в BOM нет. Проекты в EasyEDA не переимпортировались (связи те же, менялись только поля LCSC).
- В6 из стопки вопросов закрыт.

### 2026-11-13, ПК: P1 Left
- `hardware/p1-left/` (92 × 258, 110 деталей, 2 слоя): 19 кнопок с 2 огнями (P101), 2 × LP5864 на канале 0 мультиплексора, 3 × 74HC165,
  TCA9546A 0x70 (P99: ch1 → M3, ch2 → W1, ch3 свободен), J1 2 × 8 к P2 (P100), J2/J3 2 × 7 к M3 и W1 у заднего края. Цепочка P1 → M3 → W1 → M5.
  EasyEDA **P1_v1**: 83/83 и 83/83, 110/110. Без kicad-cli (эталон из `design.py`), ERC/DRC — CI.
- Общие блоки в `kit.py`: `deck_inputs` (кнопки + огни + цепочка регистров), `i2c_mux` (TCA9546A с подтяжками и перемычками адреса), `deck_bus`.
- Символы TCA9546APW и Conn_02x08 переведены из библиотек KiCad 10 в формат KiCad 7 (`sym7.py`, словарь `EXTRA`).
- Открыто: номер LCSC TCA9546APWR (в COMPONENTS.md со статусом «проверить» — ПК не открывает LCSC); J1 у правого края (к P2) — место условное до P2.

### 2026-11-13, ПК: W3 System
- `hardware/w3-system/` (92 × 48,2 по наклону, 27 деталей): Save и Project (по 2 огня, P84), огонь записи D5 у задней кромки к карману,
  LP5864 0x40 (5 RGB), 74HC165 (Save, Project), J1 к P4. Плата кончается за 1 мм до кармана USB/SD (он во всю ширину колонки) — **В9** про Power.
- Без `kicad-cli`: схема и плата — Python; эталонный нетлист — из `design.py` (`tools/pack_easyeda.py --no-cli` пишет `netlist.net`, если его нет).
  EasyEDA **W3_v1**: плата 22/22, схема 22/22, 27/27 деталей. ERC/DRC/parity — CI. В пакете пока нет `schematic.pdf` и `outline.dxf` (нужен kicad-cli: облако или CI).
- `eda_check.py` теперь повторяет чтение, если плата ещё грузится (все площадки без цепей).

### 2026-11-13, ПК: W2 Meters; **на ПК не запускать kicad-cli**
- **ПК падает с синим экраном** (0x1E, 0xEF; в журнале ещё сбои видеоядра 0x141 и неожиданные перезагрузки с 7.11). Последние 4 падения — во время
  `kicad-cli` (DRC, экспорт контура), генераторы на Python (pcbnew) и EasyEDA проходят. Пользователь проверил систему (sfc/DISM и т. п.).
  До выяснения **ПК не запускает `kicad-cli`** (DRC, parity, экспорт netlist/pdf/dxf): DRC и parity делает CI на push, остальное — облако или Python.
  Это касается `tools/pc_check.py`, `night_check.py`, `pack_easyeda.py`, `run_board.ps1` и ночной задачи Планировщика.
- **W2** `hardware/w2-meters/` (35 × 126 по наклону, 49 деталей, 2 × LP5864 0x40/0x41, 2 × 14 огней): ERC 0 ошибок, `check_netlist` 204/204.
  DRC/parity локально не прошли (падение) — ждём CI. Пакет `for-routing/W2/` собран до падения; `BOM.csv` при падении обнулился — переписан из `design.py`
  (функция упаковщика, без KiCad), остальные файлы проверены на целостность. EasyEDA **W2_v1**: плата 40/40, схема 40/40, 49/49 деталей.
- **W2 rev 0.1b** (по замечанию пользователя): драйверы стояли между столбцами в шахматном порядке (U1 сверху вёл левый столбец, U2 снизу — правый),
  связи нижних левых огней тянулись наискосок к дальнему U1. Теперь каждый LP5864 под своим столбцом на обратной стороне, на середине высоты:
  столбцы — два независимых одинаковых пучка, без пересечений. Схема и цепи не менялись (только расстановка). EasyEDA **W2_v2**: 40/40 и 40/40.
  Пакет собран `tools/pack_easyeda.py --no-cli` (без kicad-cli: netlist/pdf/dxf прежние, т. к. связи и контур те же).
- **CI красный с ab00aed, но не из-за новых плат**: M3, M4, M5, W2 дают предупреждение «not routed yet, DRC report kept» (UNROUTED).
  Падают проекты-результаты Quilter (`hardware/m1-screen-knobs/quilter/results/*`, в каждой папке `.kicad_pro`): «DRC errors in m1-screen-knobs / fixed / quilter_I_cand2_1».
  Предложение облаку (workflow не правлю): в `kicad.yml` исключить `*/quilter/*` из поиска проектов, как `*/backups/*`.
- Импорт через API (`SYS_FileManager.importProjectByProjectFile`, бета) молча не создаёт проект — оставил `tools/eda/eda_import.py` как заготовку, импорт пока через окно.
- Вопросы: В3 (W2 по наклону 126 мм, шаг 8,58) — в стопке выше.

### 2026-11-13 ночь, ПК: M4 и M5 готовы и проверены в EasyEDA
- Общий модуль «две ручки» `kit.knob_pair()` + писатели `common/gen/module_sch.py`, `module_pcb.py`; прогон одной командой на ПК:
  `powershell -File hardware/common/gen/run_board.ps1 <папка> <ID>` (символы, схема, нетлист, ERC, плата, DRC/parity, пакет).
- **M4** `hardware/m4-fx-filter/` (66 × 34, 46 деталей): ERC 0 ошибок, нетлист 202/202, DRC 0, parity 0; EasyEDA **M4_v1**: 38/38 и 38/38.
  Кольца r 14 при шаге ручек 34 мм оставляют между собой 6 мм: микросхемы стоят снизу между выводами энкодеров.
- **M5** `hardware/m5-gain/` (82 × 34, наклон, окно W1; 11 + 11 огней + Clip 1, Clip 2 на одном LP5864, P103): ERC 0, нетлист 202/202, parity 0;
  EasyEDA **M5_v1**: 38/38 и 38/38. **DRC 2 ошибки**: Clip 2 (x 96 по макету) в 0,15 мм от правого края платы (x 97), норма 0,3.
- **Вопросы пользователю** (решения не менял):
  1. M5, Clip 2 у края: (а) расширить M5 и окно W1 до x 99 (у W1 останется 2,5 мм обода справа) или (б) сдвинуть Clip 2 на x 94.
  2. Радиус колец: формула ТЗ r = ⌀/2 + 3 даёт 14 мм (Tempo, FX) и 11 мм (Gain); в layout_v7 кольцо Gain нарисовано ⌀ 21 (r ≈ 10). Для M3/M4 сходится, для M5 кольцо на ~1 мм больше макета.
- Дальше по ТЗ: W2, W3, P1, P4, P3, M2. Для дек нужны новые символы (TCA9546A, AS5600, разъём 2 × 8) — в формате KiCad 7 их на ПК пока нет, придётся конвертировать из библиотек KiCad 10.

### 2026-11-12 ночь, ПК: M3 Tempo + Swing готова и проверена в EasyEDA; ПК теперь сам собирает пакеты для EasyEDA
Пользователь (12.11): основная программа — **EasyEDA Pro** (проще в освоении и разводке). Поэтому каждая плата доводится до проекта EasyEDA.
- **M3** (`hardware/m3-tempo-swing/`, rev 0.1): 46 деталей, 2 слоя, 92 × 34. LP5864 0x40, 74HC165, кольца r 14 мм (⌀ 22/2 + 3), MP на GND (P102),
  5 отверстий (углы + между ручками). ERC 0 ошибок; `check_netlist` 202/202; DRC 0 ошибок, parity 0, 163 неразведено; пакет `hardware/for-routing/M3/`;
  EasyEDA проект **M3_v3**: плата 38/38, схема 38/38. Картинка `for-routing/M3/preview_easyeda.jpg` (PNG-превью через playwright на ПК нет).
- Общие блоки: `hardware/common/gen/kit.py` (шина, LP5864, 74HC165, энкодер, кольца, отверстия), `boardkit.py`, общий `check_netlist.py`.
  M4 и M5 соберутся из них же.
- **Важно для обеих сторон:**
  1. Генераторы облака на ПК (KiCad 10, Python 3.11) не шли: писатель схемы M1 — f-строка только для Python 3.12; библиотеки символов KiCad 10 в другом формате.
     Решено без правки чужих файлов: `common/gen/m1compat.py` (загрузка с правкой строки в памяти), `common/gen/sym7.py` (символы в формате KiCad 7 из схем M1/W1).
  2. **EasyEDA теряет все цепи платы в формате KiCad 9/10** (детали на месте, площадки без цепей; проверено на M3_v1). Причина: в KiCad 9+ у площадок `(net "имя")` без номера и нет таблицы цепей.
     `common/gen/pcb_netnums.py` дописывает номера как в KiCad 7 — после этого 38/38 (M3_v1b, M3_v3). `tools/pack_easyeda.py` = `pack_for_routing.py` + это + без playwright.
  3. Поля деталей на плате в KiCad 10 по умолчанию видимые на шелкографии: EasyEDA рисует номера LCSC поверх платы (M3_v2). Теперь скрыты и на слое Fab.
  4. `kicad-cli` 10 пишет нетлист многострочно, `outline.dxf` — папкой: `check_netlist` и `tools/eda/netcompare.py` понимают оба формата, `pack_easyeda` кладёт dxf файлом.
- Номера LCSC для 4,7 мкФ 0805 и 1 нФ 0402 в проекте не выбраны (как в M1: «номера нет»), в BOM_notes так и стоит.
- Проекты EasyEDA M3_v1 (без цепей на плате), M3_v1b, M3_v2 — промежуточные проверки; рабочий M3_v3. Не удалял (нужно слово пользователя).
- Вопросы к ТЗ: нет. Дальше M4, M5.

### 2026-11-12 ночь, ПК: скрипты для рутинных проверок; #13 и DRC кандидатов K
Новые скрипты (Python, только стандартная библиотека; на ПК запускать `C:\Program Files\KiCad\10.0\bin\python.exe`):
- `tools/pc_check.py BOARD... [--sch-from DIR] [--details] [--md OUT]`: DRC KiCad 10 + parity + длина меди и via одной таблицей.
  Плата не меняется (DRC во временной папке, заливки перезаливаются там). `--sch-from`: схема и `.kicad_pro` проекта, для результатов Quilter.
  Полные JSON-отчёты в `logs/pc_check/` (в git не идут).
- `tools/quilter_intake.py JOB --match TEXT [--sch-from DIR]`: архивы Quilter из «Загрузок» → `hardware/<board>/quilter/results/<JOB>_cand<a>_<b>/`
  (только .kicad_pcb и .kicad_pro), одинаковые кандидаты отсеиваются по md5, затем `pc_check`.
- `tools/eda/eda_check.py ID [--project ИМЯ]`: сверка открытого проекта EasyEDA (схема и плата) с `hardware/for-routing/<ID>/netlist.net`
  одной командой, сам запускает мост. Как пользоваться и что делать при «no connection sees them»: `tools/eda/README.md`.
  Проверено: W1_v2 35/35 и 35/35; старый M1_kicad7 даёт склейку 140 выводов и 3 `PWR_FLAG`, ровно как .tel облака (143/146).
- `.gitignore`: `~*.lck`, `.history/`, `/logs/`.

Результаты, полученные попутно (KiCad 10.0.8, перезаливка зон):

| Плата | Ошибки | Неразведено | Parity | Медь, мм | Via |
|---|---|---|---|---|---|
| L_rev05 вход Quilter (#13), своя схема | 0 | 365 (вход, не разведён) | 0 | 1725 | 320 |
| I2 fixed (схема I2_two_chips) | 0 | 5 | 0 | 9529 | 584 |
| K cand1_1 (= 4_1), схема K_rev04 | 86 (84 items_not_allowed, 2 hole_clearance) | 12 | 0 | 9106 | 551 |
| K cand2_1 (= 5_1), схема K_rev04 | 117 (114 items_not_allowed, 3 hole_clearance) | 8 | 0 | 9208 | 550 |

- #13 закрыт: parity 0, ошибок 0.
- K: обе платы хуже I2 fixed по неразведённым (12 и 8 против 5) и с ошибками `items_not_allowed` (медь в запретных зонах; какие зоны, не разбирал).
  Кандидаты 1_1 и 2_1 сохранены в `hardware/m1-screen-knobs/quilter/results/K_rev04_cand*` (4_1 и 5_1 побайтно те же).

### 2026-11-12 вечер, ПК: архивы без PWR_FLAG импортированы как M1_v2 и W1_v2, склейки нет
Архивы из `for_routing\` (md5 совпадают с `hardware/for-routing/<ID>/`). Импорт по умолчанию («Import Document»), новые проекты M1_v2 и W1_v2;
старые M1_kicad7 и W1_kicad7 не тронуты. В проектах ничего не менялось и не сохранялось. Проверка та же: плата по площадкам через API,
схема геометрическим сборщиком, сравнение с `netlist.net` по наборам выводов (цепи с 2 и более выводами).

| Плата | Детали (схема / плата) | Схема EasyEDA | Плата EasyEDA |
|---|---|---|---|
| M1_v2 | 163 / 163 | 146 / 146 совпали | 146 / 146 совпали |
| W1_v2 | 38 / 38 | 35 / 35 совпали | 35 / 35 совпали |

- Флагов `power_PWR_FLAG` больше нет; GND, +3V3, +5V в схемах отдельными цепями. Расхождений нет.
- Облако считало 149 и 45 цепей вместе с цепями из одного вывода; здесь считаются только цепи из 2 и более выводов, поэтому 146 и 35.
- H1–H7 (M1) и H1–H6 (W1) в схеме есть, но выводов у них нет, поэтому в сравнении цепей не участвуют.
- Теперь в схеме M1 проверка шла моим сборщиком (в прошлый раз брались цифры облака по .tel).

### 2026-11-12, ПК: импорт M1 и W1 в EasyEDA Pro 3.2.209, сверка цепей через API (только чтение)
Мост: `easyeda/easyeda-api-skill` (node, 127.0.0.1:49620) + расширение run-api-gateway 1.0.5 (Allow External Interaction, Show in Top Menu).
Цепи платы: выводы площадок через `pcb_PrimitiveComponent`. Цепи схемы: `sch_Netlist.getNetlist()` виснет (30 с),
поэтому собраны по геометрии (выводы + провода + флаги, одинаковые имена = одна цепь). Сравнение с `netlist.net` по наборам выводов, без имён.

| Плата | Детали | Плата EasyEDA: цепи (≥2 вывода) | Схема EasyEDA: цепи |
|---|---|---|---|
| M1 | 163 / 163 | 146 / 146 совпали, склеек нет | 143 / 146 (данные облака, .tel); GND + 3V3 + 5V склеены |
| W1 | 38 / 38 (H1–H6 без выводов) | 35 / 35 совпали, склеек нет | 32 / 35; GND (31) + 3V3 (20) + 5V (13) склеены в одну цепь из 64 выводов |

- **Где склейка:** только в СХЕМЕ, в обеих платах. Документ платы EasyEDA берёт цепи из `.kicad_pcb`, там всё верно.
- **Причина** (проверено на схеме M1 по координатам): дело не в символах `power:GND/+3V3/+5V`, они импортируются как отдельные флаги
  `power_GND`, `power_+3V3`, `power_+5V`. Склеивают три символа `PWR_FLAG`: все три стали флагами с одним именем `power_PWR_FLAG`,
  и каждый стоит в одной точке со своим флагом (+5V в (140,−340), +3V3 в (180,−340), GND в (220,−340)). Одно имя = одна цепь → три шины замкнуты.
- Риск: «Обновить плату из схемы» в EasyEDA перенесёт склейку и на плату. До исправления плату из схемы не обновлять.
- Предложение облаку (не решение): в архиве для EasyEDA не ставить `PWR_FLAG` (или убрать их при упаковке `tools/pack_for_routing.py`);
  символы питания можно оставить. После правки ПК может повторить ту же проверку за пару минут.
- В EasyEDA: создан проект W1_kicad7 (импорт по умолчанию, «Import Document»). В M1_kicad7 и W1_kicad7 ничего не менялось и не сохранялось.
  Ограничение: геометрический сборщик для схемы M1 не прогонялся (для M1 взяты цифры облака по .tel).
- Попутно: в мосте ошибка, `POST /eda-windows/select` роняет сервер (переменная `activeWindowId` не объявлена); окно надо передавать полем `windowId` в `/execute`.
  После открытия или смены проекта расширение видит старые вкладки: помогает API Gateway → Reconnect (или выключить и включить расширение).

### 2026-11-12, облако: Quilter K дал результат, подготовлена ревизия 0.5 (job L: четыре LP5864, 12 светодиодов на кольцо)
- Job K (rev 0.4, 4 × IS31FL3741A по одному на пару колец) 6af496a91a10ff2500b2a94d, запуск 11.11 18:31, первый результат через 3 ч 06 мин.
  Кандидаты: 1.1 и 4.1 — 98 % (52 / 12 / 4), 2.1 и 5.1 — 99 % (54 / 8 / 2), 3 и 6 — только расстановка. Не скачаны, сравнение с I2 fixed впереди (`tools/board_stats.py`).
- Решение пользователя (12.11): вариант A. 12 светодиодов на кольцо (шаг 24,5°), на пару колец один TI LP5864 (24 RGB = 4 SW × 18 CS, VQFN-32 4×4, 0,4 мм, LCSC C5220564).
  Документов и решений не менял (P98/P97/R122 за пользователем): R122 «13 на кольцо» пока в силе, генератор включает 12 переменной `M1_LP=1`.
- Данные LP5864 из даташита SNVSC52A: выводы 1 VCC, 2–10 CS0–8, 11–14 SW0–3, 15 VLED, 16–24 CS9–17, 25 VCAP, 26 IFS (на GND = I²C), 27 VSYNC, 28 SCL, 29 SDA,
  30 ADDR0, 31 ADDR1, 32 VIO_EN, 33 EP. Адрес: биты `1 0 0 ADDR1 ADDR0`, до 4 чипов на шине. Ток CS задаёт внутренний регистр (3–50 мА), REXT не нужен.
  Обвязка: 1 мкФ на VCC, 1 мкФ на VCAP, 1 нФ на VIO_EN, VLED 4,7 мкФ; подтяжки SDA/SCL 1,8–4,7 кОм (на хосте). ШИМ 125 кГц.
- Генератор (`M1_LP=1`): `design.py` (led_matrix: серпантин, серии по 4 огня на тройку CS, лево = CS9–17, право = CS0–8; ячейки A–D = U1, U6, U7, U8; ADDR на GND/+3V3 прямо),
  `make_lib.py` (символ LP5864 и футпринт VQFN-32), `make_pcb.py` (разведение выводов на 8 выводов стороны, ориентация 180), `make_sch.py`, `make_quilter.py` (job L, bypass, POWER).
  Входы: `quilter_inputs/L_rev05/` на ПК. Проверка вокруг драйверов: нарушений зазора нет; полный DRC KiCad 10 и parity пока не гонялись.
- Job L запущен 12.11 в 10:03 (Riga): id 6af571a705fb406688265f0a, проект «Shtuka Druka M1 one chip» (перенос сэкономил 546 выводов биллинга), полный режим, 816 выводов (546 на разводку), 163 детали, 47 на расстановку.
  Настройки: JLCPCB 4-Layer 4/4 мил, In2 = Signal, зазор 0,13, via 0,45/0,2, поля 0,3; таблицы токов (20 строк) и обходных конденсаторов (25 строк, уверенность полная) из CSV. Жду кандидатов (1–10 часов).
- [x] #13 (ПК, 12.11): parity 0, ошибок 0, неразведено 365 (вход). Отчёт «2026-11-12 ночь, ПК: скрипты». Было: ПК: прогнать `kicad-cli pcb drc --schematic-parity` на `quilter_inputs/L_rev05/m1-screen-knobs.kicad_pcb` (KiCad 10); ждём 0 ошибок parity и осмысленный остаток (нераспаянные связи).

### 2026-11-08, ПК: #11 доводка Quilter I2 1.1 (rev 0.3.1) → `quilter/results/I2_rev031_cand1_1/fixed.kicad_pcb`
Оригинал не тронут, `almost/` не менял. Проверки: KiCad 10.0, `kicad-cli pcb drc --schematic-parity`, схема и `.kicad_pro` из
`hardware/m1-screen-knobs/` (зазор 0,13, дорожка 0,12, via 0,45/0,2, отверстие 0,254, NPTH 0,35). Решения не менял, в Quilter ничего не загружал,
из интернета ничего не скачивал.

**Итог DRC (KiCad 10, нормы проекта):**

| Плата | Ошибки DRC | Неразведённые | Parity |
|---|---|---|---|
| I2 1.1 как выдал Quilter | 132 (121 в зонах энкодеров/In1, 11 отверстие до меди) | 9 | 0 |
| **I2 1.1 после доводки (`fixed.kicad_pcb`)** | **0** | **5** | **0** |
| `almost/` (I 2.1 + ПК, 07.11) | 36 (18 TOUCH-отрезков под рамкой) | 3 | 0 |

Предупреждения в `fixed`: 46 корпус отличается от библиотеки, 12 шелкография на меди, 12 наложение шелкографии, 13 висячих дорожек
(остались только те, что держат соединения: снятие любой из них добавляет неразведённую связь — проверено поштучно).
KiCad 10 считает неразведённые по цепям-островкам, поэтому у сырого I2 их 9, а не 25, как у KiCad 7 в облаке (там пад-связи).
Parity 0 сразу, без скриптов: исправления генератора rev 0.3.1 работают. Вывод 25 (+5V) у U1/U6 подключён — исправление веера сработало.

**Что сделано** (скрипты в `gen/experiments/pc_fix_I/`: `fix1.py`, `rm.js`, `route.py`, `tjunc.py`, `gndstub.py`, `clean2.sh`, `bisect.sh`, `pipe2.sh`):
1. Слои и заливки: имена и типы как в генераторе; заливка In1 с параметрами генератора; **нижняя заливка GND (B.Cu) Quilter снова удалил** —
   создана заново из контура генератора. После перезаливки «отверстие до меди» от заливки ушло (8 из 11).
2. Parity: уже 0, ничего не делал.
3. Сняты все 60 отрезков In2 в зонах под энкодерами (в т. ч. TOUCH0/2/7 — в rev 0.3.1 перемычка под рамкой не нужна) и 3 дорожки у отверстий
   H6/H7 (+3V3, SCL, +5V). Переразведена в обход зон и отверстий 31 связь (+3V3 ×2, SCL, SR_IN, SR_CLK, E0_A, E1_SW, E2_A/B/SW, E4_A/B/SW ×2,
   E5_B, E6_A/B/SW ×2, E7_A/B/SW, TOUCH0/2/7, A_SW7/9, B_SW6, B_CS6/8/16); +5V у H6 переложен шириной 0,3 мм (57,8 мм, 2 via).
4. GND вывод 12 у U1 и U6 (у Quilter не подключён): короткий отвод 1 мм, ширина 0,2, по оси пада в центральную площадку GND.
5. Висячие: из 44 снят 31 (группами, с откатом при разрыве).
6. Переходных 584 (было 540 у Quilter, 561 у `almost/`).
- Поправил у себя ошибку: разрезка Т-стыков раньше могла сдвинуть чужой отрезок Quilter (неточный стык) на 0,05 мм — давала нарушения зазора.
  Теперь двигаются только концы моих новых дорожек; в `fixed` таких нарушений нет.
- Честно о качестве: обходные трассы энкодеров длинные и с переходами по слоям (E6_B 44,7 мм и 8 via, SR_CLK 57,3 мм и 8 via, E2_B 34 мм и 4 via,
  TOUCH0 28 мм, TOUCH7 26 мм с 2 via). Электрически допустимо (это логика энкодеров и регистров, не ШИМ), но аккуратнее их развести вручную.

**5 неразведённых в `fixed`** (все длинные, 25–38 мм, из ячейки драйвера к кольцам; роутер не нашёл пути ни сеткой 0,05, ни 0,025, ни дорожкой 0,1):
A_CS4 (U1 вывод 29 → кольцо у x 128), B_CS4 (U6 вывод 29 → x 240), B_CS7 (U6 вывод 32 → x 233), B_CS9 (U6 → x 232), E7_A (энкодер 8 → x 205).
A_CS4, B_CS4, B_CS7 не довёл и Quilter; у B_CS9 и E7_A были куски In2 под энкодерами, я их снял, а обход не нашёлся.
Похоже на тесноту у восточной стороны U6 и в щели между кольцами 6–7.

**Сравнение с `almost/` и предложение (решает пользователь):**
- `fixed` I2: ошибок DRC 0 против 36; parity 0 у обоих; неразведённых 5 против 3; схема и библиотеки текущие (rev 0.3.1), а `almost/` на rev 0.3.
- Разрывы `almost/`: +5V вывод 25 у обоих драйверов (питание микросхем, без переделки веера не добить) и A_ADDR к непаяемым R4/R5.
  Разрывы `fixed` I2: 4 линии катодов CS и одна линия энкодера — обычные сигнальные, их можно довести вручную в KiCad (убрать 1–2 соседние трассы).
- Моё мнение: **I2 `fixed` лучше как основа** — нет нарушений DRC, питание драйверов подключено, всё на текущем генераторе; осталось
  довести 5 сигнальных линий руками. Предлагаю заменить `almost/` на I2 `fixed` (вместе со схемой и библиотеками rev 0.3.1), после того как
  эти 5 линий будут разведены — или сразу, с пометкой в README. `almost/` я не трогал.

### 2026-11-08, облако: Quilter I2 и J2 закончили (rev 0.3.1)
- Файлы: `quilter/results/I2_rev031_cand1_1/` (два чипа, 99 %) и `quilter/results/J2_rev031_cand5_1/` (один чип, 98 %), в каждой `drc_kicad7_cloud.rpt` (pcbnew 7, нормы проекта).
- I2 1.1: 25 неразведённых пад-связей, 61 «объект в запрещённой зоне» (энкодеры, In2), 7 отверстие до меди, 15+14 висячих. J2 5.1: 17 неразведённых (в т. ч. SDA/SCL у U2, TR1/3/4/7, A_ADDR), 58 в зонах, 13 отверстие до меди.
  Quilter считает: I2 1.1 и 4.1 — 99 % (8 незавершённых цепей, коллизий нет), J2 5.1 — 98 % (17 незавершённых, 2 ошибки размеров). У I2 6 финальных, у J2 6 финальных; лучшие J2 после 5.1: 3.1 97 %.
- Parity и DRC KiCad 10 не считались (нужен ПК).
- [x] #11 выполнено (ПК, 08.11): `fixed.kicad_pcb` в `quilter/results/I2_rev031_cand1_1/`: ошибок DRC 0, 5 неразведённых, parity 0.
  Отчёт «ПК: #11» выше. Было: #11 ПК: довести `I2_rev031_cand1_1` тем же путём, что I 2.1 (`gen/experiments/pc_fix_I/`): слои, заливки, parity, 61 объект в зонах энкодеров, неразведённые; сравнить с `almost/` (3 неразведённых, parity 0, 36 TOUCH-ошибок). Если лучше — предложить заменить `almost/`. Решения не менять, в Quilter не загружать.

### 2026-11-07, облако: лучшая плата собрана в `hardware/m1-screen-knobs/almost/`
- По просьбе пользователя: всё по лучшему результату (Quilter I 2.1 + доводка ПК #10) в одной папке: плата KiCad 10,
  схема, правила, библиотеки на коммит 53f2958, сырой результат Quilter, отчёты DRC, скрипты ПК, README со списком того,
  что осталось до заказа (+5V вывод 25 ×2, A_ADDR, TOUCH-отрезки, острова GND на B.Cu, крепление P97).
- Поправка к моим словам в чате 20:07–20:15: драйверы у заднего края не мешают разводке — I 2.1 разведён на 99 %,
  ближайшее переходное в 1,2 мм от края (не 0,3). Удлинять плату, второй этаж и 6 слоёв не нужно.

### 2026-11-07, облако: J отменён, запущены I2 и J2 (rev 0.3.1)
- По слову пользователя J (rev 0.3, с той же ошибкой вывода 25) отменён.
- I2 (два чипа) 6aef4e2027e5a51dd6530cb7, 18:18, проект «Shtuka Druka M1 rev 0.2»; J2 (один чип) 6aef4f929d195808d04dfc13,
  18:24, проект «Shtuka Druka M1 one chip». Генератор rev 0.3.1: via для +5V выводов, неявные цепи `unconnected-(...)`,
  передняя лапка рамки энкодера без номера. DRC входов (KiCad 7): чисто. Нормы в мастере: 0,13 / via 0,45/0,2, In2 Signal.

### 2026-11-07, облако: разбор отчёта ПК #10, правки генератора (rev 0.3.1)
- Принято: `fixed.kicad_pcb` — 3 неразведённых, parity 0, ошибки только 18 TOUCH-отрезков. Спасибо.
- Генератор (обе схемы, два и один драйвер):
  - выход из-под драйвера и для выводов +5V (14, 15, 25) — вывод 25 больше не зажат;
  - неподключённым выводам — неявные цепи KiCad `unconnected-(REF-ИМЯ-PadN)` (45 шт.) → parity должна быть 0 без скриптов;
  - энкодер: передняя лапка рамки без номера (`pad ""`), рамка и так одна металлическая деталь. TOUCH идёт к задней лапке,
    перемычка 9 мм по In2 под корпусом больше не нужна (это были все 36 оставшихся ошибок).
- A_ADDR к непаяемым R4/R5: оставляем (не влияет на сборку), отмечу в BOM-заметке. Если мешает DRC — решение пользователя.
- Следующий прогон Quilter делаю после сравнения I и J (J запущен 17:27), на выбранной схеме.

### 2026-11-07, ПК: #10 (и #9) правка результата Quilter I 2.1 → `quilter/results/I_rev03_cand2_1/fixed.kicad_pcb`
Оригинал `m1-screen-knobs.kicad_pcb` в той же папке не тронут. Проверки: KiCad 10.0, `kicad-cli pcb drc --schematic-parity`
со схемой и `.kicad_pro` из `hardware/m1-screen-knobs/` (нормы проекта: зазор 0,13, дорожка 0,12, via 0,45/0,2, отверстие 0,254, NPTH 0,35).
Решения не менял, в Quilter ничего не загружал.

**1. DRC результата как выдан** (нормы проекта и нормы Quilter дали одно и то же): 190 замечаний, из них ошибок 119:
99 «объект в запрещённой зоне» (98 дорожек In2 под энкодерами + заливка In1 в зоне под ENC2), 14 отверстие до меди
(8 — заливка In1 у H1–H8, 6 — дорожки у H6–H8), 4 зазора и 2 мостика маски (GND у падов 52–54 U1/U6); 5 неразведённых
(+5V у U1 и у U6 считаются раздельно, A_SW3, A_ADDR, A_CS1); **parity 45**.
- Parity 45 (#9): ровно та же цифра у собственной платы генератора `hardware/m1-screen-knobs/m1-screen-knobs.kicad_pcb`.
  Все 45 одного вида «Pad missing net given by schematic (unconnected-(U1-CS34-Pad1))»: у неподключённых выводов в схеме
  есть неявные цепи `unconnected-(REF-PIN-PadN)`, а генератор оставляет пады без цепи. Выводы: CS19–39 у U1 и U6 (21 + 21),
  ~Q7 у U3/U4/U5. Облаку: в `make_pcb` назначать падам эти имена цепей (так делает «Update PCB from Schematic»). В `fixed` я
  это сделал скриптом — parity 0.

**2–5. Что сделано в копии** (скрипты: `hardware/m1-screen-knobs/gen/experiments/pc_fix_I/` — `fix1.py` слои/зоны/parity и списки,
`rm.js` снятие по uuid, `route.py` роутер, `tjunc.py` разрезка Т-стыков и перезаливка, `refill.py`):
- Слои: имена и типы как в генераторе (F.Cu / In1.Cu power / In2.Cu / B.Cu), Quilter их переименовал в «Top Layer», «Ground Layer 1/2».
- Заливки: на In1 Quilter оставил свою (зазор 0,13, мин. ширина 0,025, перемычка 0,13) — вернул параметры генератора (0,3 / 0,2 / 0,5 / 0,5).
  **Нижнюю заливку GND на B.Cu Quilter удалил совсем** — создал заново из контура генератора (с вырезами под энкодеры), приоритет 1.
  Перезалито. Ошибки «отверстие до меди» от заливки ушли. Внимание: на B.Cu она ложится кусками (низ плотно занят дорожками), см. `fixed.png`.
- GND у падов 52–54: снято 4 отрезка GND (2 у U1, 2 у U6); GND не разорвалась.
- In2 под энкодерами: снято 33 отрезка (30 по списку, ещё 3 по итогам DRC) (+3V3, E0_A/B, E1/E2/E4/E7_SW, E3_A, B_CS6/8/9, A_CS18, SR_LOAD) и 6 дорожек у отверстий
  H6–H8 (B_SW4, B_SW5, SDA ×2, ~INT, +5V); всё переразведено в обход зон и отверстий моим роутером с нормами проекта
  (0,12 / 0,13–0,14, via 0,45). +5V у H7 переложен шириной силового класса 0,3 мм, 53,6 мм, 2 via, по In2 вдоль заднего края.
  Переходных стало 561 (было 540). Висячие хвосты после снятия (17 отрезков и via) убраны, переходной-дубль убран.
- **TOUCH-линии оставлены** (как разрешено): 18 отрезков In2, по 3 на TOUCH0, TOUCH2, TOUCH3, TOUCH4, TOUCH5, TOUCH7 — прямая 9 мм между
  двумя лапками MP рамки своего же энкодера (ENC1, 3, 4, 5, 6, 8) под его корпусом. Обход пробовал: у 3 из 6 вышел 20–23 мм вдоль
  колец огней, у 3 пути нет. Длинная линия касания рядом с ШИМ хуже короткой под собственной рамкой (она и есть электрод), поэтому оставил все.
  Они дают все 36 оставшихся ошибок (каждый отрезок попадает и в `under_encoder_N`, и в копию `_In2`).
- 4 связи из задания: **A_SW3 — добита** (7,1 мм по B.Cu); **A_CS1 — добита**, но дорожкой 0,1 мм (тоньше класса 0,12, в пределах
  min_track 0,1; на 0,12 пути нет), 8,4 мм, 1 via; **+5V вывод 25 U1 и U6 — не добить**: вывод 25 зажат закреплёнными отводами веера
  соседних выводов 24 (SW9) и 26 (CS1) в 0,4 мм, с другой стороны открытая площадка GND, места под via нет ни на одном слое
  (проверено сеткой 0,025 и точными нормами). Облаку: в `make_pcb.driver_fanout` дать выход и выводу 25 (+5V), как сигнальным.
  **A_ADDR — не добить**: оставшийся разрыв соединяет вывод 8 U1 только с R4 и R5, а они в ячейке A непаяемые (адрес 0x30 даёт R3);
  в сборке не влияет, но DRC его показывает. Путь от их стороны к via веера вывода 8 не нашёлся.

**6. Итог DRC `fixed.kicad_pcb`** (`fixed_drc_kicad10.rpt`): 105 замечаний, **ошибок 36** — только оставленные TOUCH-линии; зазоров,
отверстий, мостиков, коротких 0; предупреждения: 46 корпус отличается от библиотеки, 10 шелкография на меди, 13 наложение шелкографии;
**неразведённых 3** (+5V у U1, +5V у U6, A_ADDR к непаяемым R4/R5); **parity 0**.
Сделать облаку до замены основной платы: выход вывода 25 в генераторе (тогда +5V добивается), цепи `unconnected-(...)` в генераторе;
решить про TOUCH-линии под рамкой (разрешить правилом или вести иначе в генераторе).

### 2026-11-07, облако: Quilter job J (опыт: один драйвер ромбом) запущен 17:27
- J 6aef42429d195808d04dfc01, отдельный проект «Shtuka Druka M1 one chip». Генератор: `M1_ONE_CHIP=1 python3 gen/make_quilter.py OUT`
  (основная плата и схема в репо не меняются, остаются на двух драйверах P98).
- Один IS31FL3741A U1 ромбом снизу в промежутке 4 (x 112, y 6,6), угол 315°: стороны 2+3 (SW, CS1–18) смотрят вправо
  (кольца 5–8), стороны 4+1 (CS20–37) влево (кольца 1–4); CS19 не используется. Выход со всех сигнальных выводов (51 via)
  закреплён. SW по 700 мА (36 CS). Всё остальное как в I. DRC входа (KiCad 7): чисто.
- Цель: сравнить с I 2.1 и решить P98 (пользователь: «нужно понимать, что сработает»).

### 2026-11-07, облако: Quilter job I — кандидат 2.1 разведён на 99% (лучший результат)
- Файл: `hardware/m1-screen-knobs/quilter/results/I_rev03_cand2_1/` (+ `drc_kicad7_cloud.rpt`, DRC движком KiCad 7 в облаке).
- Не разведены 4 связи, все в ячейке A: +5V, /A_SW3, /A_ADDR, /A_CS1 (было 20 у F). Выход из-под драйверов сработал.
- Деталей под энкодерами нет; снизу 32 мелочи, сверху 21 (C1–C4, C14–C17 у драйверов, RN1/4/5/6, часть R) — нужен
  карман в световоде над ними.
- Ошибки, которые надо чинить руками:
  - 50 дорожек на In2 под энкодерами (Quilter игнорирует запреты на внутренних слоях, даже отдельные зоны только на In2):
    TOUCH0–7 (по 3), E*_SW / E*_A / E*_B, B_CS6/8/9, A_CS18, +3V3, SR_LOAD, GND;
  - 6 зазоров: дорожки GND снизу у свободных падов 52–54 U1/U6 (+2 мостика маски там же);
  - 14 «отверстие до меди»: заливка GND на In1 у H6–H8 (перезалить), 3 дорожки рядом с отверстиями;
  - 12 «объект на выключенном слое» у правил-зон (Quilter переименовал слои) — косметика.
- [x] #10 выполнено (ПК, 07.11): `fixed.kicad_pcb` + `fixed.kicad_pro` (нормы проекта) + `fixed_drc_kicad10.rpt` + `fixed.png`;
  итог 3 неразведённых (2 × +5V вывод 25, A_ADDR к непаяемым R4/R5), 36 ошибок = только 18 оставленных TOUCH-отрезков,
  parity 0. Отчёт «ПК: #10» выше. Было: #10 ПК: на копии `I_rev03_cand2_1` (результат не трогать): KiCad 10 DRC с parity; добить 4 связи; убрать GND у падов
  52–54; перезалить зоны с параметрами исходника; увести дорожки In2 из-под энкодеров (TOUCH-линии к своей рамке можно
  оставить, если иначе никак — отметить отдельно); вернуть имена/типы слоёв. Сохранить как `hardware/m1-screen-knobs/
  m1-screen-knobs.kicad_pcb`? НЕТ — сначала отдельным файлом `quilter/results/I_rev03_cand2_1/fixed.kicad_pcb` и отчёт.

### 2026-11-07, облако: M1 rev 0.3 и Quilter job I (запуск 15:05)
- I 6aef209f9d195808d04dfbda, Full layout. Что учтено (подробно в `hardware/m1-screen-knobs/QUILTER.md`, блок rev 0.3):
  хорды вместо дуг; U1/U6 ромбом 45° снизу (y 6 мм, промежутки 2 и 6) со скриптовым закреплённым выходом всех сигнальных
  выводов на via в два ряда (`make_pcb.driver_fanout`, картинка `mech/m1_r03_driver_fanout.png`); CS-карта развёрнута под
  выход (правая пара колец на CS1–9); остальные 51 деталь свободны на обеих сторонах; снизу под энкодерами детали запрещены;
  копии запретов дорожек на In2; нормы 0,13 / via 0,45/0,2, In2 = Signal; parity: имена цепей `/NAME`, поля символов на
  корпусах, отверстия и непаяемые вне BOM (флаг DNP не пишем: KiCad 7 и Quilter его не читают). DRC входа (движок KiCad 7):
  ошибок зазоров и отверстий нет.
- Job H отменён (лучший кандидат 93%, U2 стоял под ENC4), старый проект `Shtuka dryka` (rev 0.1) в архиве — по слову пользователя.
- [x] #9 выполнено вместе с #10 (ПК, 07.11): parity генератора rev 0.3 = 45 замечаний, все одного вида (см. отчёт «ПК: #10», п. 1).
  Было: #9 ПК (когда будет результат I): DRC KiCad 10 с parity на результате; заодно проверить parity самого генератора rev 0.3
  (`kicad-cli pcb drc --schematic-parity` на `hardware/m1-screen-knobs/m1-screen-knobs.kicad_pcb`).

### 2026-11-07, облако: Quilter job H запущен (полная свобода расстановки)
- H 6aeef72f27e5a51dd6530c86, запуск 12:21, Full layout. Закреплены только ENC1–8, D1–D104 с хордами колец, J1, H1–H8.
  Остальные 53 детали (в т. ч. U1/U6) вне платы, без областей: Quilter ставит их сам, с любой стороны (решение пользователя 07.11).
- Нормы: зазор 0,13 (было 0,102), via 0,45/0,2; In2 = Signal. Генератор: `gen/make_quilter.py` job `H_free_any_side`.
- Повороты 45° (драйвер) и 180° (огни) пока не делал: закреплённый под 45° драйвер перестаёт быть свободным; поворот огня
  на 180° переносит via на другой край огня, но число отверстий не меняет (2 на огонь). Вернуться, если H упрётся в выход U1/U6.

### 2026-11-07, облако: разбор отчётов ПК (#7, Freerouting, проходы 01–12)
- Лучшая разводка пока у Quilter F 1.1: 20 неразведённых против 37–91 у Freerouting. Freerouting годится как второе мнение,
  но не как основной инструмент для M1.
- Сравнение одного драйвера (rev 0.1) с двумя (P98) по Freerouting не решающее: разница в основном из островов GND (25–28 против 2–6),
  которые закрываются переходными в In1.Cu. По сигнальным цепям 32–39 против 39–40, это в пределах шума роутера.
  Против одного драйвера остаётся Quilter job C (0 кандидатов). Пересматривать P98 по этим данным нет оснований.
- Узкое место одно и то же у обоих роутеров: выход 17 линий CS с восточной колонки падов U1/U6 (QFN-60, шаг 0,4).
  Лечится не роутером, а генератором: выход из-под корпуса (fanout) рисовать скриптом и закреплять, как кольца
  (только прямые отрезки, без дуг), порядок CS на падах согласовать с порядком колец, при необходимости поворот U1/U6.
- Ошибки 1.1 в основном наши настройки: в Quilter стоял пресет 4 mil (зазор 0,1016), а не нормы проекта. 499 зазоров (0,102–0,13)
  в пределах фабрики, но 81 «отверстие до меди» (0,23 < 0,254) это нарушение. В следующем прогоне фабричные ограничения
  выставить по `QUILTER.md`.
- Quilter не соблюдает запретные зоны на внутреннем сигнальном слое: правила-зоны `under_encoder_*` в исходнике на всех 4 слоях,
  F/B он соблюл, In2 нет (61 нарушение). Обход: убрать In2 из доступных для трасс под энкодерами иначе (например, In2 = только
  земля/сигнал без зон, а запрет обеспечить локальной заливкой или вырезом) или чистить In2 после Quilter. Варианты проверить.
- Parity 341: ошибка генератора rev 0.2 (имена цепей без `/`, поля символов, BOM/DNP у отверстий). Чинит облако в `gen/`.
- [x] #8 облако: закрыто 13.11.2026, устарело: rev 0.3 заменена rev 0.4/0.5. Было: генератор rev 0.3 (fanout U1/U6 скриптом, порядок CS, parity), затем Quilter job H с нормами `QUILTER.md`.…

### 2026-11-07, ПК: сводка по всем заданиям (итог на конец дня; подробности в записях ниже)
| Задание | Статус | Где |
|---|---|---|
| #1 острова GND на m1-screen-knobs | выполнено 06.11 | запись «#1 острова GND» |
| #4 анализ M1 перед P98 | выполнено 06.11 | запись «#4 анализ M1» |
| Разбор «что заложено неверно» и простые решения | выполнено 06.11, пользователь отклонил поворот огней на 90° | запись «M1 — что заложено неверно» |
| #5 ночной запасной (причина падения D) | закрыт отметкой: дуги PCB_ARC, F с хордами прошёл | очередь ПК |
| #7 проверка Quilter job F, кандидат 1.1 | выполнено: DRC+parity, закреплённое не двигалось, 20 связей перечислены, зона GND восстановлена в копии `_pc`, добита 1 из 20 | запись «#7 проверка Quilter job F» |
| Java + Freerouting 1.9.0 на ПК | установлено (Temurin JRE 17, `tools/freerouting/` в локальной папке) | запись «#7», п. 7 |
| Разводка «с развязанными руками», 12 проходов со скриншотами | выполнено; лучший: один драйвер (схема rev 0.1) снизу ромбом 45°, 37 неразведённых, 5 ошибок; чистой платы нет | `experiments/2026-11-07_routing_passes/README.md` |
Не выполнено или открыто: нет платы без неразведённых связей; вопрос «via 0,4 мм» без ответа; выбор основы (один драйвер rev 0.1 или две ячейки P98)
за пользователем; задачи облака #3 и #6 не мои. В Quilter ничего не загружалось, решения P97, P98, P75 не менялись.

### 2026-11-07, пользователь и ПК: свобода расстановки M1 и прогон Freerouting «с нуля»
Слова пользователя в чате (разрешения для расстановки, решений в журнале ещё нет, внести в журнал должен он):
- Кольца можно менять; светодиоды можно вращать на 180°; энкодеры можно вращать (нулевого положения нет).
- Рассыпуху (и вообще остальные детали) можно ставить с ЛЮБОЙ стороны платы, в том числе сверху, если это сокращает проходы через плату.
- Модель световода можно менять, физически его ещё нет: верх платы ограничивает только высота до обшивки (≈5,9 мм до верха огня,
  6,5 мм корпус энкодера), в световоде делаются карманы/канавки под детали сверху. Облаку: ограничение «сверху только энкодеры и огни» снято.
  Микросхемы U1/U6 тоже можно на верх, как и совершенно любые детали, кроме позиций энкодеров и светодиодов; драйверы можно двигать
  и вращать шагом 45°, остальные детали шагом 90° (светодиоды 180°, энкодеры любой угол). Пользователь просил проверить ромб 45°
  и вариант с ОДНИМ драйвером «разделённым на две стороны платы».
- Все проходы разводки со скриншотами слоёв и описанием: `hardware/m1-screen-knobs/experiments/2026-11-07_routing_passes/README.md`
  (12 проходов, платы 04–12 в архивах). Коротко, неразведённых связей (в скобках острова GND), Freerouting без ограничений:
  два драйвера снизу 84 (28), сверху 66 (26), сверху 45° 64 (25), снизу 45° 62 (26, есть короткие цепи), драйверы и мелочь сверху 67 (28);
  ОДИН драйвер (схема rev 0.1) сверху без вращения 53 (4), сверху ромб 45° 41 (2), ромб и его мелочь сверху 53 (6),
  **снизу ромб 45° 37 (5)**, ошибок DRC 5. Ромб реально помогает (53 → 41 → 37), перенос мелочи на верх нет. Решения (P98 и др.) не принимал:
  один драйвер это схема rev 0.1, а не P98. Чистой платы (0 неразведённых и 0 ошибок) нет ни в одном проходе; во внутреннем слое
  остаются длинные пучки линий поперёк всей платы.

**Прогон Freerouting с нуля** (ПК, копия исходника `F_chords` до Quilter; 2494 трассы и via колец закреплены; правила проекта: зазор 0,13,
дорожка 0,12, via 0,45; Freerouting 1.9.0, 8 проходов, 15 мин + оптимизация 9 мин): нарушений DRC 0 (ни зазора, ни отверстий, ни зон),
но **91 неразведённая связь** (50 цепей; из них 28 — острова GND, их закрывают переходными, остальные 63 — сигнальные: A_CS/A_SW 29, шина
SDA/SCL/INT/SR_*, +3V3 6, касание, энкодеры). Для сравнения Quilter 1.1 оставил 20, но с 499 нарушениями зазора и 199 по отверстиям.
Итого: при нынешней расстановке (драйвер в задней полосе, мелочь снизу) Freerouting чисто не разводит. Что вижу как причину
(в `design.py` rev 0.2): U1 — QFN-60, пады 0,2 × 0,8 мм, шаг 0,4; для выхода 45 линий нужен веерный выход (через один: короткий
отвод и via на двух расстояниях от корпуса, «шахматка»), его роутеры сами строят плохо. В `.kicad_pro` исходника min_via_diameter = 0,4,
а в документе 30 via 0,45: при 0,45 шахматка не проходит по зазору 0,13 (нужно 0,415 между отводом и соседним via, есть 0,4).
Что сделано дальше (обновление, 07.11): веерный выход (шахматка, via 0,4) был только пробой скриптом `fan.py`: вокруг U1 он конфликтует с
развязывающей мелочью (зазоры 0,06–0,08), в плату и в проходы не вошёл, via везде остались 0,45 как в документе 30; вопрос про via 0,4
остаётся открытым. Вместо него разведены свободные варианты расстановки (ниже, проходы 04–12). Огни и энкодеры не вращал; драйверы
вращал на 45° и переносил на верх; поворот энкодеров и огней на 180° остаётся неиспользованным резервом.

### 2026-11-07, ПК: #7 проверка Quilter job F, кандидат 1.1 (плата: `quilter/results/F_chords_cand1_1/`)
Коротко: закреплённое не сдвинулось, GND-заливка на месте, но плату в таком виде делать нельзя: 17 линий CS и ещё 3 связи
не разведены и заперты соседними трассами, на слое In2.Cu 61 нарушение зон под энкодерами, при проектных нормах 499
нарушений зазора и 199 по отверстиям. Решения (P97, P98, P75) не менял, в Quilter ничего не загружал и не удалял.
Результат не трогал; правки только в копии `quilter/results/F_chords_cand1_1_pc/` (плата + .kicad_pro исходника).

**1. DRC KiCad 10.0 (`kicad-cli pcb drc --schematic-parity`), схема из исходника `F_chords`** (та же, что в репозитории, без учёта CRLF):

| набор норм | ошибки | предупреждения | unconnected | parity |
|---|---|---|---|---|
| .pro из результата Quilter (зазор 0,1016, отверстие 0,1016) | 69: 61 items_not_allowed + 8 hole_clearance | 225 | 20 | 341 |
| .pro проекта (зазор класса 0,13, отверстие 0,254; `QUILTER.md`) | 760: 62 items_not_allowed + 499 clearance + 199 hole_clearance | 225 | 20 | 341 |
| исходник F_chords (до Quilter) для сравнения | 0 | 370 (в т. ч. 104 via_dangling) | 380 | 341 |

- clearance при проектных нормах: все 499 между 0,1021 и 0,13 мм, то есть выше фабричного минимума 0,09 (JLCPCB), но ниже класса 0,13.
- hole_clearance при проектных нормах: 199, минимум 0,2308 мм против 0,254 (в таблице `QUILTER.md`: via hole to track ≥ 0,254).
  Это нарушение фабричного предела, а не вкус. Часть (≈120) была от тонкой заливки (см. п. 4): после восстановления зоны остаётся 81.
- items_not_allowed: 61 штука, все на In2.Cu (Quilter её назвал «Ground Layer 2») внутри зон `under_encoder_*`: цепи TOUCH0/1/3/4/5/7, E*_A/B/SW,
  +3V3, SDA, SR_CLK, SR_OUT, ~SR_LOAD, A_CS17, B_CS16, B_CS18 (эти дорожки идут под корпусами энкодеров, где по правилам медь запрещена:
  рамка энкодера — электрод касания). Зоны на F.Cu и B.Cu Quilter соблюл, на In2.Cu нет.
  8 из hole_clearance при нормах Quilter: дорожки/via у отверстий H5–H8 (новые отверстия у верхнего края, x 68/124/180/236, y 42,6):
  зазор 0,11–0,31 против 0,35.
- parity 341 есть и в исходнике, и в собственной плате репозитория, то есть не от Quilter. Состав: 199 net_conflict (все до одного:
  в плате `NAME`, в схеме `/NAME`, только префикс), 125 «нет поля символа в корпусе», 17 различий атрибутов
  (BOM-исключение у H1–H8, DNP у 9 деталей). На rev 0.1 parity был 0, значит это новое у генератора rev 0.2; когда уберут `UNROUTED`, CI упадёт на parity.

**2. Закреплённые детали против исходника F_chords** (pcbnew, позиция, поворот, сторона, замки, цепи падов):
- ENC1–8: 0 из 8 сдвинулось. D1–D104: 0 из 104. J1: 0. H1–H8: 0 из 8 (позиции те же, включая новые H5–H8). Замки сохранены.
- Контур Edge.Cuts одинаков. Цепи падов: 0 изменений. U1–U6, R, RN, C тоже не двигались (job F только разводка).
- Кольцевые трассы (хорды): в исходнике 2528 отрезков и 208 via. Из отрезков 1824 (все F.Cu, ширина 0,12) остались как были бит в бит.
  704 отрезка (в основном R-катоды на In2.Cu: CS1, CS4, CS7, CS10, CS13, CS16 обеих ячеек, A_ и B_) Quilter переписал: сдвиг
  до 0,05 мм у 2, до 0,15 у 186, до 0,5 у 219, больше 0,5 мм у 297 (макс. около 1,2 мм), то есть дуги на In2.Cu больше не лежат на кольце.
  Все 208 via сохранены, добавлено 271 (всего 479, все 0,45/0,2). Пропавших цепей и отрезков, не покрытых новой медью, кроме этих R-дуг, нет.
- Ширины: у Quilter 0,102 (2058 отр.), 0,107 (1138), 0,145 (281), 0,278 (32) и 1824 по 0,12; класс Default в проекте 0,12.

**3. 20 неразведённых связей** (KiCad, «пад ↔ конец трассы, где остановился Quilter»). 17 из них — линии катодов CS между драйвером и
кольцами: пад драйвера на восточной колонке (x 99,45 у U1, x 211,45 у U6), а конец готовой дуги кольца в 10–30 мм от пада (линия не доведена вовсе).
- U1 (ячейка A): CS1 пад 26 (97,20; 45,05) ↔ трасса F.Cu (62,38; 50,74); CS3 пад 28 (98,00; 45,05) ↔ F.Cu (62,59; 52,29);
  CS9 пад 34 (99,45; 46,90) ↔ F.Cu (71,59; 55,01); CS10 пад 35 (99,45; 47,30) ↔ B.Cu (103,00; 50,70);
  CS11 пад 37 (99,45; 48,10) ↔ F.Cu (101,21; 50,29); CS13 пад 39 (99,45; 48,90) ↔ In2.Cu (127,92; 52,63);
  CS14 пад 40 (99,45; 49,30) ↔ F.Cu (129,21; 50,29); CS16 пад 42 (99,45; 50,10) ↔ B.Cu (120,07; 57,36);
  CS18 пад 44 (99,45; 50,90) ↔ F.Cu (120,28; 56,38). Имена цепей `A_CSn`.
- U6 (ячейка B): CS3 пад 28 (210,00; 45,05) ↔ F.Cu (174,59; 52,29); CS9 пад 34 (211,45; 46,90) ↔ F.Cu (183,95; 55,78);
  CS10 пад 35 (211,45; 47,30) ↔ B.Cu (214,52; 47,44); CS11 пад 37 (211,45; 48,10) ↔ F.Cu (213,21; 50,29);
  CS13 пад 39 (211,45; 48,90) ↔ In2.Cu (239,82; 50,98); CS15 пад 41 (211,45; 49,70) ↔ F.Cu (242,29; 51,41);
  CS16 пад 42 (211,45; 50,10) ↔ In2.Cu (228,48; 61,22); CS17 пад 43 (211,45; 50,50) ↔ F.Cu (233,76; 55,80). Цепи `B_CSn`.
- Остальные 3: SCL — пад 10 U1 (92,55; 47,70) ↔ трасса F.Cu (87,41; 51,50); B_SDB — пад 1 R20 (201,11; 44,20) ↔ пад 11 U6 (204,55; 47,30);
  TR0 — пад 1 R7 (144,50; 44,51) ↔ пад 1 U2 (159,46; 43,25).

**4. Зоны и заливки.** Правила-зоны (8 `under_encoder_*`, 4 `edge`) на месте. GND-заливка на In1.Cu есть, залита, но Quilter её
заменил: имя `GND.LAYER_1`, зазор 0,3 → 0,1016, мин. ширина 0,2 → 0,0254, термо-зазор и перемычка 0,5 → 0,0254 / 0,1016, способ
связи с падами другой. Слои Quilter переименовал: In1 «GND» (power) → «Ground Layer 1» (signal), In2 «Signal» → «Ground Layer 2»
(это сигнальный слой с трассами, имя вводит в заблуждение), F/B → «Top Layer»/«Bottom Layer». Отдельных GND-островов нет
(в списке неразведённых GND нет). В копии `_pc` я вернул имена и тип слоёв и параметры зоны из исходника, зону перезалил:
unconnected остался 20, hole_clearance упал с 199 до 81, других изменений нет.

**5. Что удалось добить.** Копия: `quilter/results/F_chords_cand1_1_pc/` (результат + восстановленные слои и зона + одна связь).
Нет Java/Freerouting (скачивать без разрешения нельзя), поэтому я написал небольшой роутер: сетка 0,05 мм, слои F/In2/B, via 0,45/0,2,
зазор 0,14 → 0,11 мм, ширина 0,12 → 0,102, обход чужой меди, зон и краёв (`gen/experiments/pc_close_unrouted.py`).
- Добита **1 из 20**: TR0 (R7.1 ↔ U2.1), 24,9 мм вместо прямых ~15, 14 отрезков, 4 via, слои B.Cu → In2.Cu → B.Cu → F.Cu → B.Cu, ширина 0,102.
  Нарушений, где участвует TR0, ноль, unconnected 20 → 19. Это найдено программой, а не руками: линия касания с 4 переходами и выходом на F.Cu,
  я бы её переразвёл вручную. Если не нравится, возьмите плату `F_chords_cand1_1` без неё.
- **19 не добиваются**: путей нет. Проверено на B_SDB и A_CS9 с сеткой 0,025 и нормами самого Quilter (0,1016), остальные на сетке 0,05.
  Пады U1/U6 (QFN шаг 0,4) заперты трассами соседей: у B_SDB пад 11 U6 окружён своими же соседями с трёх сторон, коридор — карман в 0,6 мм.
  Значит это не недоработка Quilter, а упёртость выхода из-под корпуса. Нужна рип-ап: убрать часть соседних трасс у восточных колонок
  U1/U6 и развести 17 CS заново либо вручную в KiCad, либо новым прогоном Quilter с уже стоящими кольцами.

**6. Что я предлагаю** (решает пользователь, решения не менял):
- Не принимать кандидата 1.1 как плату: 61 нарушение зон на In2.Cu и 199 (после правки зоны 81) по отверстиям — нарушения фабричных
  пределов из `QUILTER.md`; при классе 0,13 ещё 499.
- В следующем прогоне Quilter выставить нормы как в `QUILTER.md` (зазор 0,13, via hole to track 0,254) и проверить, что In2.Cu получила
  правила-зоны (Quilter назвал её «Ground Layer 2», и зоны на неё не действовали). Лучше увести вручную 61 кусок из-под энкодеров.
- Сначала сделать так, чтобы 17 CS-линий были заведомо проходимы: ослабить скученность у восточных пад-колонок U1/U6 (например, выход CS на два
  слоя, разнести via второго ряда) — подсказка для облака, в генератор я не лез.

**7. Freerouting (дополнение, по просьбе пользователя).** На ПК поставлены Java (Temurin JRE 17, winget) и Freerouting 1.9.0
(`C:\Users\karpa\Documents\ShtukaDruka\tools\freerouting\freerouting-1.9.0.jar`, официальный релиз, SHA-256 `9084a488…e3102`).
Прогон на копии `_pc` (экспорт DSN из KiCad 10, правила проекта, `-mp 3`, 8 минут, импорт SES): **не помог.** Неразведённых по-прежнему 19
(те же 17 CS + SCL + B_SDB), DRC при проектных нормах: items_not_allowed 61 → 50, hole_clearance 81 → 75, clearance 499 без изменений,
плюс 13 новых `track_dangling`. То есть Freerouting тоже не смог выдавить соседние трассы у восточных колонок U1/U6, вывод п. 5
подтверждён вторым инструментом. Результат прогона в репозиторий не клал (кольца и закреплённое он не защищает, я это не проверял).
Первый прогон с 15 проходами не уложился в 25 минут. Вывод: тупик в самом расположении выходов U1/U6, а не в роутере; нужен ручной
рип-ап или изменение схемы выходов (см. п. 6).

Скрипты: `gen/experiments/pc_close_unrouted.py` (роутер), `pc_compare_fixed.py` (позиции, отверстия, контур, via), `pc_compare_tracks_zones.py` (покрытие хорд, зоны).

### 2026-11-07, облако: Quilter job F дал результат (хорды вместо дуг сработали)
- F 6aee5986db018c21260eb2e4: закончен 03:54, 1h08m до первого результата, кандидат 1.1 разведён на 97% (20 неразведённых связей, 1.2α 91%).
  Значит причина падения D и retry — дуги (PCB_ARC), гипотеза подтверждена. #5 про поиск причины можно закрыть этим.
- Файл: `hardware/m1-screen-knobs/quilter/results/F_chords_cand1_1/` (pcb + pro, 174 корпуса, 5812 трасс/via).
- [x] #7 ПК: DRC KiCad 10 + parity со схемой, сравнить зафиксированные детали с исходником, список 20 неразведённых связей,
  восстановить зоны/заливки, если Quilter убрал. Готово 07.11, отчёт ниже («ПК: #7 проверка Quilter job F»).

### 2026-11-06, облако: опыт с одним кольцом (рисунок огней не менялся)
- Копия платы, кольцо 1 (D1–D13), вся медь в радиусе 15 мм снята; дуги нарисованы скриптом
  `hardware/m1-screen-knobs/gen/experiments/ring1_arcs.py` (pcbnew 7.0.11), картинка `mech/ring1_arcs_test.png`.
- Схема: G — дуга на F.Cu снаружи (r 13,1), B — дуга на F.Cu внутри (r 10,9), R — переходной рядом с падом и дуга
  на In2.Cu (r ≈ 12,5), анод — один переходной рядом с падом и вниз. **2 переходных на огонь** вместо ~3,4 сейчас.
- DRC (pcbnew 7, в радиусе 15 мм): 0 нарушений от самих колец. Одно столкновение: анодный переходной SW2 у D? попал
  на пады U3 (74HC165) снизу — сдвинуть переходной или U3. Обрывы ожидаемы (медь вокруг снята).
- Аноды выходят прямо вниз: шина SW (9 линий) может идти одна на B.Cu, In2 под кольцом занят только дугой R.
  Проверить на ПК в KiCad 10 тем же скриптом, если нужно (DRC kicad-cli 7 не умеет).

### 2026-11-06, облако: сводка выводов по M1
- Пользователь: «Давай все выводы сделаем сначала, а потом комплекс мероприятий по улучшениям проведём».
  Сводка всех выводов (оба отчёта ПК + замеры облака) — `docs/ru/33_m1_review.md`. Обоснование P98 поправлено:
  тесно у U1, а не в щелях.
- Поворот на 180° пересечение R/G не снимает (пады меняются крест-накрест, R и G снова в одном ряду). При текущем
  рисунке — увести одну дугу (R или G) переходным на внутренний слой: ~2 переходных на огонь. Проверить на копии
  одного кольца с DRC — кандидат в пакет улучшений, ждёт решения пользователя.

### 2026-11-06, пользователь: замечание к разбору ПК ниже
- Поворот огней на 90° (п. 1 простых решений) **не принимается**: теряется рисунок установки элементов. Поворот на 180° допустим.
  Остальное из разбора облако изучает и правит само. ПК-сессия по этому пункту ничего не меняла.
- Адресные светодиоды (WS2812/SK6805): пользователь не уверен, решения нет. R51 остаётся в силе.

### 2026-11-06, ПК: M1 — что заложено неверно и как собрать без «комков» (по просьбе пользователя)
Плата и `gen/design.py` на коммите 6925159, замеры pcbnew. Ничего не менял, это предложения.

**Что заложено неверно (по важности):**
1. **Поворот огней.** XL-1615 — общий анод, пады 2 × 2: столбцы (R,A) и (G,B), щель между столбцами 0,8 мм,
   между рядами 0,3 мм. Сейчас (`rot = a − 90`) ряды смотрят по радиусу: снаружи R и G, внутри A и B.
   По карте матрицы у 9 соседних огней общие R, G, B и разные A. Дуги R и G лежат на одном радиусе и
   перекрещиваются у каждого огня — отсюда переходные: 354 переходных на матрицу (~3,4 на огонь), всего 867.
2. **Линии SW тонкие.** SW — общий анод строки: по нему одновременно идёт ток до ~35 каналов × 19 мА (R1 = 20k)
   ≈ 0,66 А в пике. Сейчас SW 0,12 мм, ~350–400 мм на цепь, в основном на In2.Cu. Если внутренняя медь 0,5 oz
   (стандарт JLCPCB — проверить в заказе), 110 мм до дальнего кольца ≈ 0,9 Ом → просадка 0,3–0,6 В. Синему (Vf ~3 В)
   при 5 В это может съесть запас: дальние кольца тусклее или с другим оттенком. Проверить по даташиту
   IS31FL3741A запас по напряжению на CS.
3. **Развязка далеко от выводов** (по `cut_count.py`): C6 (VREG у CY8CMBR3108) 12 мм, C9/C10 (74HC165) ~8 мм,
   C3 (U1) 7 мм, C13 26 мм. VREG и CMOD у CMBR3108 по даташиту ставят вплотную.
4. **Земля:** куски заливки B.Cu без переходных (#1).
5. **Касание:** TOUCH0 ~146 мм (In2 + B.Cu), идёт по тому же In2, что и шина SW с ШИМ. Риск ложных касаний
   и предел паразитной ёмкости CMBR3108 (проверить по даташиту).
6. **Один драйвер на 224 мм** — длинные линии неизбежны при любой разводке (см. #4).

**Состав деталей** в целом полный: подтяжки энкодеров (RN1–6, 10k), SDB, REXT, ADDR, развязка, ESD-резисторы касания
560 Ом. Не хватает только того, что выше (широкие SW, близкая развязка). Ещё проверить: питание при полном белом —
одна строка всегда горит, ~0,66 А × 5 В ≈ 3,3 В·А с модуля. Ограничить глобальным током (GCC) в прошивке
и учесть в бюджете хоста.

**Идея пользователя «земля внутрь одним кольцом».** У этих огней нет земляного вывода: общий провод — анод (SW)
или катоды (CS), смотря по карте матрицы. Проверил оба варианта:
- «кольцо = одна SW» (кольцо анодов, как в P76): анодное кольцо одной дугой, но у каждого огня 3 своих катода
  → 3 переходных на огонь и шина из 39 CS по всей плате. Хуже.
- **текущая карта (общие R,G,B у 9 соседей) + поворот огня на 90°** — лучше, см. п. 1 ниже.

**Простые решения (без смены схемы и решений):**
1. **Повернуть огни на 90°:** `rot = a` вместо `a − 90` в `led_xy`, одна строка. Тогда столбцы смотрят по радиусу:
   снаружи G и B, внутри R и A, а щель 0,8 мм между столбцами идёт вдоль кольца (дорожка 0,12/0,13 туда проходит,
   нужно 0,38 мм). Получаются три непересекающиеся дуги на F.Cu, без единого переходного:
   - B — дуга снаружи, r ≈ 13,1 мм (касается B, обходит G снаружи, зазор 0,14 мм);
   - G — дуга по щели под огнями, r = 12 мм;
   - R — дуга внутри, r ≈ 10,9 мм (зазор до пада A 0,19 мм).
   Анод выходит вбок в промежуток между огнями (шаг огней 4,7 мм, свободно ~3 мм). Там одно переходное на r ≈ 11,45
   (до дуг G и R по 0,55 мм при нужных 0,415). Внутренняя дуга не задевает зону энкодера (её угол на r 7,6)
   и выводы энкодера (до r ~9). Между кольцами соседей остаётся 1,8 мм.
   Итог: 1 переходное на огонь вместо ~3,4, дуги короткие и одинаковые. **Расчёт по размерам падов,
   DRC на копии ещё не делал.**
2. **Кольца разводит генератор, не автороутер.** Дуги и переходные анодов строго периодичны: `make_pcb.py`
   рисует их сам. Автороутеру остаются только шина SW (9 линий), концы дуг CS к драйверу и логика.
3. **Класс цепей для SW** 0,3 мм (лучше по наружному слою или B.Cu, 1 oz).
4. **Развязку вплотную к выводам** (C5, C6 у U2; C9–C11 у 74HC165; C1–C4 у U1) + GND-переходные у каждого её пада.
5. **Карту CS выровнять по кольцам** (необязательно, но дуги станут цельными). Пара колец (1,2), (3,4)…
   получает 3 тройки CS:
   - 1-е кольцо: точки 0–8 (SW1–9);
   - 2-е кольцо: точки 4–12 (SW1–9);
   - общая тройка: точки 9–12 первого кольца и 0–3 второго (SW1–8). Концы колец рядом внизу, в разрыве дуги
     270°, между ними 11 мм по F.Cu.

   Всего 12 троек = 36 CS, как сейчас. Сейчас тройки режут кольцо где придётся (`n // 9`), по 2–3 тройки на кольцо.

**Сложнее (поверх простых, решает пользователь):**
6. **P98 — 2 драйвера:** 27 линий на драйвер вместо 45, длины вдвое короче. Выравнивание троек из п. 5 ложится
   на ячейку из 4 колец как есть.
7. **4 драйвера, по одному на пару колец.** Адресов у IS31FL3741A ровно 4 (0x30–0x33, R3–R6). У каждого 26 огней =
   3 тройки × 9 SW = 18 линий. Драйвер стоит в щели между своими двумя кольцами, самая длинная линия ~30 мм.
   Через щели между парами идёт только шина (I²C, цепочка, INT, питание). Это самая «чистая» плата на матричных
   драйверах (R51 сохраняется). Цена: +3 × ~3,7 $ на модуль; SW-ток делится на 4, вопрос п. 2 снимается.
   С P98 сравнить по цене и по касанию (CMBR3108 один у центра).
- WS2812/SK6805-цепочка дала бы самую простую разводку, но это против R51 (матричные драйверы ~29 кГц) —
  не предлагаю, если пользователь сам не вернётся к R51.

**Что предлагаю сделать первым** (если согласны): на копии платы скриптом повернуть огни, нарисовать дуги
и переходные анодов для одного кольца и прогнать DRC. Это проверит п. 1 за час, до любых решений по P98.

### 2026-11-06, ПК: #4 анализ M1 перед P98
Плата: `m1-screen-knobs.kicad_pcb` с диска (коммит e8600b2), уже разведённая Freerouting (4 обрыва из `UNROUTED`).
Замеры — pcbnew KiCad 10 по реальным трассам, переходным и падам; правила Default 0,12/0,13, via 0,45/0,2.
Плату не менял.

**1. Цифры облака подтверждены точно.** `cut_count.py` и pcbnew дают одно и то же: 14/27/31/44/41/28/23 сигнальных
цепей, из них матрица 11/18/21/27/27/21/18. Разведённые трассы пересекают щели теми же цепями (44 в щели x=144,5;
40 из 41 в x=172,5 — одна цепь из обрывов). Метрика «пады цепи по обе стороны» здесь точная: каждая такая цепь
обязана пересечь линию щели.

**2. Ёмкость щелей много больше нужды.** Линия x между энкодерами не задевает запретные зоны энкодеров
(x ±6,2 мм от оси) и кольца огней, то есть идёт почти по всей высоте платы (33,4 мм минус 0,3 мм у края).
Что занято сейчас и сколько ещё дорожек 0,12/0,13 (шаг 0,25 мм) помещается в свободные промежутки:

| щель x | цепей | In2.Cu: трасс / свободно мм / +дорожек | B.Cu: трасс / свободно / + | F.Cu: трасс / свободно / + |
|---|---|---|---|---|
| 60,5 | 14 | 16 / 22,3 / +89 | 2 / 26,8 / +108 | 2 / 26,8 / +107 |
| 88,5 | 27 | 24 / 20,8 / +83 | 8 / 25,3 / +101 | 4 / 26,8 / +107 |
| 116,5 | 31 | 25 / 20,3 / +81 | 10 / 24,7 / +99 | 3 / 27,1 / +108 |
| **144,5** | **44** | 39 / 13,6 / **+57** | 6 / 20,9 / +82 | 10 / 22,5 / +90 |
| 172,5 | 41 | 25 / 19,4 / +78 | 15 / 22,0 / +88 | 5 / 25,0 / +99 |
| 200,5 | 28 | 20 / 21,3 / +86 | 10 / 24,2 / +98 | 3 / 26,7 / +107 |
| 228,5 | 23 | 20 / 21,0 / +82 | 0 / 27,6 / +110 | 4 / 26,4 / +107 |

В худшей щели сверх уже проложенных 44 цепей помещается ещё ~57 дорожек на одном In2.Cu и ~80 на B.Cu
(заливка GND B.Cu уступает трассам, In1.Cu — сплошная GND, её не считал). Значит «44 против ~25» сравнивать
с ёмкостью бессмысленно: обе цифры в 3–5 раз меньше ёмкости. Довод P98 «щель переполнена» замером не подтверждается.

**Где на самом деле тесно — у U1** (QFN-60, шаг 0,4 мм, 45 линий матрицы + 6 прочих сигнальных выводов).
Заполнение In2.Cu трассами в квадрате ±4 и ±6 мм вокруг U1 ~80 %, в ±10 мм ~54 %, в ±14 мм ~38 %. Все 4 обрыва
(`UNROUTED`) — у выводов U1 или рядом (SW5 pin 20, CS29 pin 56, SW3→D57, C4). Там же рвётся заливка GND (#1).
Между падами 0,4 мм дорожка 0,12/0,13 не проходит (нужно 0,38 мм), переходные 0,45 мм у QFN — только в два ряда:
узкое место — выход выводов из-под корпуса, а не щели между ручками.

**3. Мнение по P98** (решает пользователь).
- P98 всё равно помогает, но по другой причине: каждому драйверу нужно 52 RGB = 156 каналов = 9 SW + 18 CS = 27 линий
  вместо 45. Плотность у каждого U1 почти вдвое ниже, это и снимает тупик. Обоснование в журнале лучше поправить
  («тесно у драйвера», а не «тесно в щели»).
- Есть дешёвая альтернатива без деления (не проверял, мнение): плата уже разведена кроме 4 цепей у U1. Довести их
  руками в KiCad (отодвинуть часть переходных, вывести 2–3 линии на F.Cu или B.Cu) + GND-переходные из #1.
  Это день работы на ПК против переделки схемы, генератора и разводки. Стоит сравнить до решения по P98.
- Что в P98 не учтено:
  - **74HC165:** ячейке с 4 ручками нужно 12 бит, это 2 микросхемы (4 входа пустые), всего 4 вместо 3.
    Хосту читать 32 бита вместо 24, карту битов в прошивке/протоколе поменять.
  - **Адреса драйверов:** «копия из генератора» не должна копировать R3–R6 вслепую: в одной ячейке R3 (0x30), в другой R4 (0x31).
  - **Общий ~INT:** сейчас на нём U1 (pin 7) и U2 (pin 16). С двумя драйверами (и, может, двумя U2) на одной линии
    проверить по даташитам, что все выходы с открытым стоком.
  - **Синхронизация ШИМ двух IS31FL3741A:** генераторы независимы. Проверить по даташиту, есть ли вывод синхронизации.
    Если нет — на глаз, скорее всего, незаметно, на камере возможны биения между половинами.
  - **Прототип 112 × 34 (R121):** нужны свой J1, свои отверстия и половинка световода — это отдельная плата, не «половина».
- **Касание:** в корпусе QFN-16 у CY8CMBR3108 нет ни вывода адреса, ни XRES (в схеме заняты все 16 выводов).
  Два чипа включаются оба на 0x37, и сменить адрес одному через I2C_ADDR можно только когда второй не отвечает.
  На общей шине без отдельного питания или ключа это не сделать. Варианты:
  - (а) один CMBR3108 у стыка на все 8 ручек — проще всего. Самая длинная линия касания ~100 мм против ~134 мм сейчас
    (U2 на x=180, ENC1 на x=46,5). Минус: 4 линии TOUCH идут через стык, ячейки не совсем одинаковые.
  - (б) два чипа + отдельное питание второго через перемычку/ключ на первое включение — хрупко на сборке.
  - (в) два чипа + ключ I²C (2 канала) — +1 деталь и её адрес.
  Моё мнение: (а). Длину и соседство линий TOUCH с линиями ШИМ проверить по допуску на паразитную ёмкость
  в даташите CMBR3108.

**4. 6 слоёв не нужны.** В щелях запас и так в 2–4 раза на каждом сигнальном слое. У U1 предел задаёт шаг выводов 0,4 мм
и первый ряд переходных, а не число слоёв: два лишних слоя дают немного больше мест для переходных второго ряда,
но тупик у QFN сами не снимают. Дороже на всю серию; с одним драйвером лучше довести разводку руками (см. п. 3).

Скрипты замеров (pcbnew, не в репозитории): разрез по щелям с учётом трасс, переходных и падов на каждом слое
и плотность вокруг U1. Если нужно, оформлю как `gen/cut_capacity.py`.

### 2026-11-06, ПК: #1 острова GND на m1-screen-knobs
- Плата открыта из репозитория (коммит 028b89e), `discard_or_reload`. DRC как в CI
  (`kicad-cli pcb drc --severity-error --schematic-parity --refill-zones`, KiCad 10.0): 0 нарушений, 11 unconnected, 0 parity.
- 4 известны (`UNROUTED`): C4 GND, SW3→D57, SW5 у U1 pin 20, CS29 у U1 pin 56.
- 7 остальных: зона GND B.Cu (priority 1) с зоной In1.Cu и сама с собой. Координата (263.7, 73.7) у всех одинаковая:
  это первая вершина контура зоны, а не угол у H4. Сам угол ни при чём.
- Реальная причина (pcbnew, перезаливка копии): заливка GND на B.Cu рвётся на 20 кусков. Куски без сквозной связи
  (нет GND-переходного или THT-пада) и пады в них:
  U4.15 (121.1, 55.4), R3.2 (144.1, 46.4), C3.2 (158.9, 44.2), C1.2 (161.8, 42.3), C2.2 (158.9, 42.0), C4.2 (158.9, 46.4),
  а также куски с C5.2/C6.2 (176–181, 41–46) и U2.17 (180.0, 57.0), связанные только короткими трассами B.Cu.
  Почти все это земли развязывающих конденсаторов около U1 (x 143–181, y 41–51): плотная разводка на B.Cu отрезает
  их кусочки заливки от основной, а переходных на In1.Cu (сплошная GND) у них нет.
- Предложение (не делал, решает пользователь; пересекается с Quilter job C из #2): по одному GND-переходному
  у каждого из перечисленных падов на In1.Cu, либо учесть это в следующем прогоне Quilter.
- Попутно: `run_drc` из KiCad MCP не показывает unconnected и parity и кладёт `*_drc_violations.json` в папку платы.
  Для сверки с CI нужен `kicad-cli`.

## Архив

## 2026-11-12: K (rev 0.4, 4 драйвера) — кандидаты скачаны (облако)
- Скачаны 1.1, 2.1, 4.1, 5.1 → quilter/results/K_rev04/cand_*. Файлы попарно идентичны (1.1=4.1, 2.1=5.1 по md5), уникальных платы две.
- Quilter: 1.1 — 98% routed; 2.1 — 99%, Incomplete Net Routing 7.
- board_stats (1.1 / 2.1): LED CS детур 1.37/1.36, LED SW 1.27/1.27 (I2 fixed: 1.46), vias 581/580 (I2: 584), unrouted у I2 было 5.
- DRC/parity не запускался (kicad-cli 7 в облаке). ЗАДАЧА ДЛЯ ПК: KiCad 10 DRC --schematic-parity для cand_2_1 и cand_1_1 (инсталлятор kicad-10.0.8 лежит в Downloads), затем сравнить число unrouted с I2 fixed.
- Job L (LP5864, rev 0.5) идёт, id 6af571a705fb406688265f0a.

## 2026-11-12: папка для ручной разводки в EasyEDA Pro (облако)
- Запрос пользователя: схемы и подготовленные платы с креплениями, правила, компоненты, файлы для загрузки; EasyEDA Pro установлен на ПК; цифровые платы; крепёж P97 включить.
- Сделано: `hardware/for-routing/` (README, RULES, SYSTEM, COMPONENTS, M1 rev 0.5 с LP5864, W1 без разводки), `tools/pack_for_routing.py`, `tools/build_for_routing.py`. Формат архива KiCad 7 (EasyEDA Pro принимает KiCad ниже 10).
- Не сделано: M2–M5, P1–P4, W2, W3 (платы и схемы с нуля, нужен общий генератор), P2 (RP2350, FSR). Аудио, R2, PW, F1 вне объёма.
- Не проверено: сам импорт в EasyEDA Pro (нет EasyEDA в облаке). ПК: импортировать M1_kicad7.zip и W1_kicad7.zip, сверить число деталей и нетлист, результат записать сюда.
- Предложение (не решение): I²C-шина для плат с более чем 4 драйверами LP5864 (M2: 4 драйвера + P3 + M4) — отдельные каналы через TCA9548A или отдельные линии; решает пользователь.
- Навык `easyeda-pro` (v0id-byte, MIT) предложен карточкой; шлюз `run-api-gateway` 1.0.5 пользователь прислал, мост на ПК не запущен.

## 2026-11-12 Облако -> ПК: прямой доступ к EasyEDA Pro (нужна локальная сессия)
- Облако через экран импортировало M1 в EasyEDA Pro: 163 детали верно, но питание склеилось (см. `hardware/for-routing/M1/IMPORT_CHECK.md`).
- Просьба ПК-стороне: запустить мост easyeda-api-skill (node, порты 49620-49629) с расширением run-api-gateway в EasyEDA (Allow External Interaction), затем: (1) сравнить цепи PCB-документа с `hardware/for-routing/M1/netlist.net`; (2) проверить, где склеилось питание (схема или плата); (3) то же для W1.
- Правки генератора схемы (символы питания) делает облако после вашего отчёта. Отчёт писать в этот файл.
- [x] ПК, 12.11: сделано. Склейка только в схеме, причина в трёх `PWR_FLAG` с общим именем. Отчёт в «Отчётах» от 2026-11-12 (ПК, EasyEDA).

## 2026-11-12 вечер, облако: PWR_FLAG убран из архивов EasyEDA
- [x] Отчёт ПК принят. `tools/pack_for_routing.py` теперь убирает `PWR_FLAG` из схемы в `<ID>_kicad7.zip`; M1 и W1 пересобраны, новые архивы лежат и в `C:\Users\karpa\Documents\ShtukaDruka\for_routing\`.
- Проверка в облаке (KiCad 7): схема из архива = `netlist.net` (M1 149/149, W1 45/45 цепей).
- [x] ПК: импортировать новые M1_kicad7.zip и W1_kicad7.zip как новые проекты (старые не трогать или удалить с разрешения пользователя), повторить сверку схемы и платы через API, отчёт сюда.
- [x] ПК, 12.11 вечер: M1_v2 и W1_v2 импортированы, схема и плата совпали с `netlist.net` полностью (146/146, 35/35). Отчёт в «Отчётах».
- Ошибку моста (`/eda-windows/select`, `activeWindowId`) облако не правит: это чужой репозиторий; при желании пользователя можно завести issue.

## 2026-11-12 ночь, облако → ПК: принципиальные схемы остальных цифровых плат
- По слову пользователя схемы M2–M5, P1, P3, P4, W2, W3 делает ПК-сессия. ТЗ: `hardware/for-routing/SPEC_boards.md`.
- Предложения P99–P105 записаны в `docs/ru/decisions/08_boards.md` (ждут пользователя); в схемах делать по ним, но через константы.
- [x] ПК: генераторы и схемы по ТЗ (сделано: M2–M5, P1, P3, P4, W2, W3), ERC + check_netlist, пакеты for-routing, импорт в EasyEDA через мост. Порядок: M3, M4, M5 (простые, один образец), W2, W3, P1, P4, P3, M2.
