MitjaGrecky/Shtuka-druka/docs/ru/29_board_map.md

# Штука Дрюка: карта плат

*01.11.2026. **Принято предварительно (R119–R121): «Да, пока так подходит. Если что, будем править».** Уточнения по модулям энкодеров — в документе 30: разъём 2 × 7 (P77), свой драйвер огней и касание на модуле (P78), тогда у P2 один драйвер огней вместо двух. Основа — панель v7 (R107, документ 27), архитектура R85–R86 (документ 19), аудио R116–R118 (документ 28), корпус R44/R107, отсек аккумулятора R109, экран R110. **Факт** — из источника, **вывод** — моя логика, **решено** — решение пользователя.*

## 0. Коротко

- **17 своих плат (из них 5 — маленькие модули энкодеров) + 3 покупных узла** (Mini-ITX, экран, две Trill Bar). Платы режутся по тем же четырём полосам, что и панель, и по плоскостям корпуса: верх, наклон, задняя стенка, низ.
- **Панель:** один микроконтроллер RP2350 на центральной плате сетки (R85); три боковые платы и три платы наклона — без своих микроконтроллеров, связаны с ней плоскими шлейфами. Ручки — на сменных модулях энкодеров с одинаковым разъёмом (R54, R74).
- **Задняя стенка:** две вертикальные платы вместо одной — **аудио** (гнёзда аудио + входные каскады прямо за ними) и **управление** (MIDI, CV, синхро, питание, USB с RP2350 платы управления). Так MIDI и CV не идут шлейфом мимо аудио (довод документа 19).
- **Аудиоплата** стыкуется с вертикальной аудио-платой разъёмом «плата в плату» под прямым углом — без шлейфов для тихих сигналов.
- **Первая плата для отладки всей цепочки** — по-прежнему простая, но не «разъёмная целиком»: предлагаю начать с **платы наклона Levels** или **модуля энкодеров** (раздел 5).

## 1. Вид сверху: где какие платы

```
 x:  10      102 110                     331 339    405 413      505
     ┌─────────┐ ┌─────────────────────────┐ ┌────────┐ ┌─────────┐   задняя стенка (вертикально):
     │ W1      │ │   экран (покупной)      │ │ W2     │ │ W3      │   R1 аудио (слева) | R2 управление (справа)
     │ Levels  │ │                         │ │ Meters │ │ System  │   наклон 30°
     └─────────┘ └─────────────────────────┘ └────────┘ └─────────┘   сгиб 300
     ┌─────────┐ ┌─────────────────────────┐ ┌────────┐ ┌─────────┐
     │ P1      │ │ P2  Сетка (RP2350)      │ │ P3     │ │ P4      │   плоская часть, слой ≈ 15 мм
     │ Left    │ │ пэды, сцены, полоса,    │ │ Tracks │ │ Right   │   под обшивкой
     │         │ │ ручки экрана            │ │        │ │         │
     └─────────┘ └─────────────────────────┘ └────────┘ └─────────┘
       F1 наушники (передний торец, x 32 и 80)
 Внизу корпуса: Mini-ITX под сеткой; под наклоном — аудиоплата A1, питание PW, отсек аккумулятора.
```

## 2. Список плат

| № | Плата | Где, размер (оценка) | Слои | Что на ней |
|---|---|---|---|---|
| P1 | Left | x 10–102, ≈ 94 × 290 мм | 2 | 19 кнопок, разъёмы модулей Tempo и Swing, сдвиговые регистры, драйвер огней |
| P2 | Сетка (главная плата панели) | x 110–331,5, ≈ 224 × 290 мм | 4 | **RP2350** с USB, 64 пэда (датчики давления FSR прямо на плате — гребёнки дорожек, документ 09), огни пэдов, 8 кнопок сцен, ◄ ►, места под 2 Trill Bar, разъём модуля 8 ручек экрана, оцифровка пэдов (мультиплексоры + АЦП), 2 драйвера огней |
| P3 | Tracks | x 339–405, ≈ 68 × 290 мм | 2 | 21 кнопка (Mute, Select × 8, Solo, Arm, ▲ ▼, Stop All), разъёмы модулей 8 ручек Level и FX Mix/Filter, 2 драйвера огней (кольца) |
| P4 | Right | x 413–505, ≈ 94 × 290 мм | 2 | 20 кнопок, кроссфейдер, колесо на магнитном датчике AS5600 (R74), драйвер огней |
| M1–M5 | Модули энкодеров | маленькие, один разъём | 2 | M1: 8 ручек экрана; M2: 8 ручек Level; M3: Tempo + Swing; M4: FX Mix + Filter; M5: Gain 1 + 2. Энкодер, кнопка нажатия, касание (где нужно), кольцо огней |
| W1 | Levels (наклон) | x 10–102, ≈ 92 × 120 мм по наклону | 2 | 4 потенциометра громкости, разъём модуля Gain, 2 кнопки P48, огни перегруза |
| W2 | Meters (наклон) | x 355–390, ≈ 35 × 120 мм | 2 | 2 × 14 огней индикаторов L/R |
| W3 | System (наклон) | x 413–505, ≈ 92 × 120 мм | 2 | Save, Project, Power, карман USB-A + SD (кардридер на USB-разъём Mini-ITX, R80–R81), огонь записи |
| R1 | Аудио, задняя стенка | вертикально, левая часть стенки (вид спереди x ≈ 5–243), высота до 104 мм | 4 | Гнёзда Audio In и Audio Out, защита и фильтры входов, фантом 48 В (ключи), входные каскады с двумя путями (R117) |
| A1 | Аудиоплата (цифра и преобразователи) | под наклоном слева, ≈ 220 × 100 мм, стыкуется с R1 под прямым углом | 4–6 | CS5308P × 2 + CS5304P, CS4308P, выходные каскады, 2 × xcore.ai, ADuM4166, два генератора (R114), тихие стабилизаторы |
| R2 | Управление, задняя стенка | вертикально, правая часть стенки (вид спереди x ≈ 252–510) | 4 | **RP2350 платы управления** (R85): MIDI DIN/TRS с оптронами, 8 CV/Gate (ЦАП), 4 CV-входа, синхро; **внутренний USB-хаб**; DIN, USB, LAN и DC — панельные гнёзда на гайках с кабелями (R141), раскладка стенки — по 3D-модели (R142) |
| PW | Питание | под наклоном справа, рядом с отсеком аккумулятора | 4 | Вход DC 12–24 В и USB-C PD с защитой (R72), питание Mini-ITX, +5 В панели и огней (отдельная ветка), ±12 В (аудио), +48 В фантом, разъём аккумулятора (R109) |
| F1 | Наушники (передний торец) | x ≈ 15–100, высота до ≈ 50 мм | 2 | 2 гнезда 6,3 мм, усилители наушников OPA1622 рядом с гнёздами |
| — | Покупное | — | — | Mini-ITX ASRock N100DC-ITX (R36); экран Waveshare 10.1DP-CAPLCD (R110); 2 × Bela Trill Bar (R113) |

**Подсчёт огней (вывод):** P1 — 19 кнопок + 2 кольца × 15 = 49; P2 — 64 пэда + 8 сцен + 2 стрелки + 25 огней полосы + 8 колец × 15 = 219; P3 — 21 + 10 × 15 = 171; P4 — 20; итого ≈ 459 RGB → 5 драйверов IS31FL3741 по 117 RGB (R51), плюс индикаторы W2 и огни W1/W3.

**Подсчёт входов панели (вывод):** 74 кнопки + 22 энкодера × 2 линии + 22 нажатия = 140 цифровых входов → 18 сдвиговых регистров 74HC165; аналоговых: 64 пэда + 4 потенциометра + кроссфейдер = 69.

## 3. Связи между платами

| Откуда → куда | Разъём (предложение) | Что идёт |
|---|---|---|
| P2 ↔ P1, P3, P4 | Плоский шлейф 2 × 8, шаг 1,27 мм | +5 В, +3,3 В, земля × 3, I²C огней, цепочка сдвиговых регистров (такт, защёлка, данные), аналоговая линия (кроссфейдер с P4) |
| P1 ↔ W1, P3 ↔ W2, P4 ↔ W3 (через сгиб) | Шлейф 2 × 5 | Питание, I²C, цепочка регистров, 4 аналоговые линии громкостей (W1) |
| Модули M1–M5 → свои платы | Одинаковый разъём 2 × 6 (R74) | +3,3 В, земля, A/B энкодеров, нажатия, касание, I²C огней кольца |
| P2 → хаб на R2 | Кабель USB 2.0 | Панель: USB MIDI + SDP (R86) |
| R2 (хаб) ↔ Mini-ITX | Кабель на USB-разъём платы | Хаб вверх по течению; R2 и A1 — вниз |
| R2 (хаб) → A1 | Кабель USB 2.0 High-Speed | Порт A аудиоплаты (R82) |
| Гнездо USB-C (PC) на R2 → A1 | Кабель USB 2.0 High-Speed | Порт B аудиоплаты через развязку ADuM4166 |
| R2 → A1 | Шлейф 2 × 5 | Включение фантома × 2, фоно/линия, ключи выходов, сторож (R118) |
| A1 ↔ R1 | Разъём «плата в плату» под прямым углом | Все входы и выходы аудио, питание каскадов, управление фантомом |
| A1 → F1 | Экранированная витая пара, 2 стерео-пары + питание ±12 В | Сигнал наушников 1 и 2 (дифференциально от ЦАП) |
| PW → все | Разъёмы питания с фиксацией | Mini-ITX (12–19 В), +5 В панели и огней, ±12 В и +48 В на A1/R1, +5 В экрана |
| W3 → Mini-ITX | Кабель на USB-разъём платы + кабель кнопки питания | USB-A и SD (R80–R81), Power |
| Mini-ITX → экран | HDMI + USB (тач) | R110 |
| Mini-ITX → задняя стенка | Кабели-удлинители для LAN и USB-A | Порты Mini-ITX смотрят назад, но стоят под сеткой |

## 4. Почему так (вывод)

- **По полосам, а не одной большой платой:** верх и наклон — разные плоскости; четыре полосы панели (R107) дают платы разумного размера, которые можно переделать по отдельности; большая многослойная плата во всю панель дорогая и рискованная.
- **Один микроконтроллер на панель** (R85): одна прошивка, один USB; боковые платы — только кнопки, регистры и драйверы огней, их легко заменить при переделке раскладки.
- **Задняя стенка из двух плат:** аудио отдельно от MIDI, CV и импульсного питания; входные каскады рядом с гнёздами — короче тихие провода.
- **Хаб на плате управления:** она и так у задней стенки рядом с Mini-ITX и аудиоплатой.
- **Наушники — свой усилитель у гнезда:** до переднего торца идёт линейный сигнал, а не ток наушников.

## 5. С чего начать

| Вариант первой платы | Плюсы | Минусы |
|---|---|---|
| **M1 — модуль 8 ручек экрана** (предлагаю) | Маленькая и дешёвая; сразу проверяем ручку, касание и кольцо огней — то, к чему ты прикасаешься постоянно; разъём модуля общий для всех ручек | Нужна P2 или временный переходник к отладочной плате RP2350 |
| W1 — Levels | Простая, потенциометры и кнопки | Мало что проверяет |
| R1 — аудио у задней стенки | Самая важная для звука | Зависит от A1, нужна последней из простых |

## Открытые вопросы

1. ~~Панель по полосам~~ — R119.
2. ~~Задняя стенка из двух плат~~ — R120.
3. ~~Первая плата~~ — M1, R121.
