MitjaGrecky/Shtuka-druka/docs/ru/34_rear_boards_research.md

# Штука Дрюка: платы задней стенки — входы, предусилители, выходы, управление, питание

*13.11.2026. Исследование по запросу пользователя: «начинай исследование предусилительных плат, а так же входных и всех остальных, что связаны с задней панелью». **Факт** — из источника (ссылка), **вывод** — моя инженерная логика, **решено** — решение пользователя. Основа: карта плат (документ 29, R119–R120), аудиоплата (21), входы и преобразователи (28, R116–R118), выходы (15, R64–R67), входы/выходы и синхро (11, R32–R37), корпус (R44: сзади 143 мм). Это следующий шаг после концепции: какие узлы на каких платах, какие микросхемы сейчас живы и есть в библиотеке EasyEDA/LCSC, где риски. Не принципиальная схема.*

## 0. Коротко

- **Платы задней стенки** (R120, документ 29): **R1** — гнёзда аудио и входные каскады; **A1** — преобразователи и xcore.ai (под наклоном, стыкуется с R1 под прямым углом); **R2** — управление (RP2350, MIDI, CV, синхро, USB-хаб, гнёзда питания); **F1** — наушники спереди; **PW** — питание. Высота задней стенки 143 мм (R44) — гнёзда в 3 ряда помещаются (документ 13, раздел 3.6).
- **Главная находка по снабжению (факт):** THAT Corporation сняла с производства выходные каскады 1606/1646 и входные InGenius 120x–129x (документ 28). Замена есть у TI, все **Active** и есть в библиотеке EasyEDA: балансный драйвер **DRV134/DRV135**, приёмник линии **INA1650**, полностью дифференциальный усилитель **OPA1637**, сдвоенный ОУ с согласованными резисторами **INA1620**.
- **Вход АЦП CS5308P — дифференциальный (факт)**, значит, перед каждой парой каналов нужен дифференциальный драйвер с фильтром. Предлагаю **OPA1637** (TI прямо пишет: делает дифференциальный сигнал «для высококачественных АЦП»). Точную схему буфера Cirrus даёт в заметке AN0556 — её надо взять до схемы (открытый вопрос 1).
- **Фантом 48 В:** готовая эталонная схема TI — TPS61391 + TPS7A4101, 48 В, 20 мА, пульсации ≈ 8 мВ (факт). Ровно на два канала.
- **Питание:** USB-C PD 100 Вт без прошивки — **TPS25730** (факт). **Новое ограничение (факт):** ASRock для N100DC-ITX официально пишет только «адаптер 19 В», диапазон 12–19 В — лишь в сторонней таблице. Значит, Mini-ITX кормим стабильными **19 В** через повышающе-понижающий преобразователь — от DC 12–24 В, от PD 20 В и от аккумулятора 4S (12,8–16,8 В).
- **MIDI на 3,3 В (факт, CA-033):** выход — резисторы 33 Ом / 0,5 Вт и 10 Ом, петля 5 мА; вход — оптрон с питанием 3,3 В (PC900V/H11L1 или SMD TLP2361).
- **CV 8 × 16 бит:** AD5676R (внутренняя опора 2 ppm/°C, INL ±3 LSB, факт) + масштаб на ±10 В от ±12 В. Шаг 0,305 мВ = 0,37 цента при 1 В/окт (расчёт ниже).
- **Нет в библиотеке EasyEDA:** ЦАП **CS4308P** (АЦП CS5308P и CS5304P есть) — для него свой символ и посадочное место или запасной AK4458 (есть, C1520729; открытый вопрос 2). Остальные ключевые детали найдены — номера в таблицах.

## 1. Что на какой плате (вывод, по R120 и документу 29)

| Плата | Где | Слои | Что на ней | Что идёт наружу |
|---|---|---|---|---|
| R1 «Аудио» | Задняя стенка слева, вертикально, высота ≤ 104 мм | 4 | Гнёзда Audio In / Audio Out; защита входов; фантом по каналам (ключи); входные каскады (мик/Hi-Z — постоянное усиление, два пути, R117); приёмники линейных входов; RIAA; выходные каскады и ключи отключения | Комбо XLR/TRS × 2, Hi-Z × 2, фоно L/R + земля, линейные 1–8, Main L/R, Aux L/R, RCA L/R |
| A1 «Цифра» | Под наклоном слева, ≈ 220 × 100 мм | 4–6 | CS5308P × 2 + CS5304P, CS4308P, драйверы АЦП, 2 × xcore.ai, ADuM4166, два генератора (R114), тихие стабилизаторы 3,3 В | — (разъём «плата в плату» к R1, USB к R2, витая пара к F1) |
| R2 «Управление» | Задняя стенка справа, вертикально | 4 | RP2350 (R85), MIDI DIN 2 вх / 4 вых + TRS 1 вх / 2 вых (R32, R34), 8 CV/Gate (R35), 4 CV-входа, «Синхро» 5 гнёзд (R33), USB-хаб, гнёзда питания и USB | Питание DC и USB-C PD, USB-C к компьютеру, USB-A, MIDI, CV, синхро |
| F1 «Наушники» | Передний торец, горизонтально (P94) | 2 | 2 × OPA1622 рядом с гнёздами | 2 гнезда 6,3 мм |
| PW «Питание» | Под наклоном справа, у отсека аккумулятора | 4 | Вход PD/DC, выбор источника, 19 В для Mini-ITX, +5 В панели и огней, ±12 В аудио, +48 В фантом, разъём аккумулятора (R109) | — |

**Вывод о границе R1/A1:** аналоговое — на R1 у гнёзд (короткие пути от гнезда до первого каскада, защита у разъёма), цифровое и преобразователи — на A1. Между ними идут уже усиленные дифференциальные сигналы на разъёме «плата в плату» — это самый устойчивый к наводкам вид сигнала.

## 2. Входы (R1 → A1)

### 2.1 Каналы АЦП (решено R116, R117; документ 28)

| Вход | Сколько | Путь | Каналов АЦП |
|---|---|---|---|
| Mic/Line 1–2 (комбо XLR/TRS), фантом только на XLR (R72) | 2 | Защита → каскад с постоянным усилением (OPA1612) → «громкий» ×1 и «тихий» ≈ +40 дБ | 4 |
| Hi-Z 1–2 (1 МОм) | 2 | Буфер OPA1642 (JFET) → два пути | 4 |
| Фоно L/R (MM, RIAA, переключатель фоно/линия, клемма земли) | 2 | RIAA на OPA1612 | 2 |
| Линейные 1–8 (TRS 6,3 мм, балансные) | 8 | Приёмник → драйвер АЦП | 8 |
| Запасные (R88) | 2 | — | 2 |
| **Итого** | | | **20 = CS5308P × 2 + CS5304P** |

### 2.2 Микросхемы входной части (факт — статус и номер в библиотеке EasyEDA/LCSC, 13.11.2026)

| Узел | Деталь | Факт | LCSC | Почему |
|---|---|---|---|---|
| Малошумящий каскад мик, RIAA | TI OPA1612 | 1,1 нВ/√Гц, Active ([TI](https://www.ti.com/product/OPA1612)) | C94590 | Уже выбран (документы 21, 28) |
| Буфер Hi-Z | TI OPA1642 | JFET, ток смещения 2 пА ([TI](https://www.ti.com/product/OPA1642)) | C67640 | Не нагружает пьезо и звукосниматель |
| Драйвер АЦП (дифференциальный) | TI OPA1637 | Полностью дифференциальный, 36 В, 3,7 нВ/√Гц, THD+N −120 дБ, VSSOP-8, Active; «делает дифференциальный сигнал для высококачественных АЦП» ([TI](https://www.ti.com/product/OPA1637)) | C2860968 | Вход CS5308P дифференциальный ([Cirrus](https://www.cirrus.com/products/cs5308p/)) |
| Приёмник балансной линии | TI INA1650 | Сдвоенный приёмник SoundPlus, CMRR 91 дБ, Production Data ([TI](https://ti.com/document-viewer/INA1650/datasheet)) | C553130 | Замена снятым THAT InGenius |
| Сдвоенный ОУ с согласованными резисторами | TI INA1620 | 2,8 нВ/√Гц, THD+N −119 дБ, резисторы согласованы до 0,004 %, ±2…±18 В, WQFN-24, Active ([TI](https://www.ti.com/product/INA1620)) | C2058735 | Дифференциальный каскад без россыпи точных резисторов |
| АЦП 8 + 8 каналов | Cirrus CS5308P | Дифференциальный вход, 123 дБА, THD+N −110 дБ, 3,3 В, QFN-48, Active; буфер — заметка AN0556 ([Cirrus](https://www.cirrus.com/products/cs5308p/)) | C42457798 | R116 |
| АЦП 4 канала | Cirrus CS5304P | — | C49192888 (CS5304P-DN) | R116 |

**Вывод — схема линейного входа:** гнездо → RC-фильтр и диоды на шины → **OPA1637** в включении «дифференциальный вход — дифференциальный выход» с ослаблением под полную шкалу АЦП и RC-фильтром по AN0556. Один корпус на канал, приёмник INA1650 отдельно не нужен: OPA1637 сам принимает балансный сигнал. INA1650 оставляю запасным вариантом, если в AN0556 окажется, что драйвер АЦП лучше ставить отдельно от приёмника. **Нужно до схемы:** полная шкала CS5308P в вольтах и желаемый запас линейного входа (+18 или +24 dBu) — это задаёт ослабление (открытый вопрос 1).

**Вывод — мик/Hi-Z с двумя путями (R117):** входной каскад OPA1612 с постоянным усилением → два OPA1637: один ×1 («громкий»), второй с дополнительным усилением («тихий»). Одинаковые фильтры в обоих путях — условие склейки без ступеньки фазы (документ 28, раздел 3).

### 2.3 Фантом 48 В и защита микрофонного входа

| Что | Факт | LCSC |
|---|---|---|
| Повышающий TPS61391 + малошумящий стабилизатор TPS7A4101: 48 В, 20 мА от 5 В, пульсации ≈ 8,4 мВ — эталонная схема PMP40871 / TIDT235 (2021) ([TI](https://ti.com/tool/PMP40871)) | TPS61391 C1852151, TPS7A4101 C111739 |
| ADI: фантом на LT8362; ток мал, но шум критичен — буферы микрофонов плохо давят пульсации питания ([ADI, по поиску](https://www.radiolocman.com/shem/schematics.html?di=618795)) | — |

**Расчёт (вывод).** Микрофон по P48 потребляет до ≈ 10 мА; два канала — 20 мА, ровно предел эталонной схемы при входе 5 В. При коротком замыкании жилы на землю ток канала ограничен парой резисторов 6,81 кОм: 48 В / 3,4 кОм ≈ 14 мА, на два канала ≈ 28 мА — больше 20 мА, поэтому у стабилизатора нужно ограничение тока (у TPS7A4101 оно есть) или питание повышающего от 12 В с запасом. Проверить на макете.

**Вывод — как включать по каналам (R118):** ключ P-MOSFET на +48 В каждого канала с медленным нарастанием (RC на затворе, ≈ 0,5–1 с), при старте выключен; управляет R2 по шлейфу к R1. Защита входа — классическая: развязывающие конденсаторы 47 мкФ / 63 В в каждой жиле, последовательные резисторы и диоды на шины ±12 В перед первым каскадом (защита от удара при включении фантома и при втыкании кабеля под фантомом). Номиналы — при схеме.

### 2.4 Фоно

**Вывод:** аналоговая RIAA на OPA1612 (документ 11, раздел 2.5); переключатель «фоно/линия» — сигнальное реле на R1 по команде R2 (R118). Клемма земли — на шасси рядом с гнёздами фоно.

## 3. Выходы (A1 → R1, F1)

| Узел | Деталь | Факт | LCSC |
|---|---|---|---|
| ЦАП 8 каналов | Cirrus CS4308P | 123 дБА, THD+N −115 дБ, дифференциальный выход 2 В rms, Active (документ 28) | **нет в библиотеке EasyEDA** |
| Выходной каскад, импедансно-балансный (R64) | TI OPA1612 | см. выше | C94590 |
| Балансный драйвер (если понадобится настоящий баланс) | TI DRV135 (DRV134 — та же схема, другой корпус) | 17 В rms на 600 Ом, ±4,5…±18 В, 0,0005 %, Active; совместим по выводам с THAT1646 и SSM2142 ([TI](https://www.ti.com/product/DRV134)) | DRV135UA C431073 |
| Наушники (F1) | TI OPA1622 | +145/−130 мА, THD+N ≈ −119 дБ на 32 Ом (документ 21) | C2876559 |

**Вывод:** решение R64 (импедансно-балансные Main и Aux на ±12 В, ≥ +18 dBu) остаётся — делается на OPA1612 без THAT. DRV135 — запасной путь, если на макете захочется настоящего баланса: он совместим по выводам со снятым THAT1646, значит, старые схемы применимы. **Ключи отключения (R66):** нормально разомкнутые сигнальные реле на каждой паре — размыкаются сами при пропадании питания, что и требует R66; управление от R2 со сторожем. Конкретное реле — выбрать.

**Расчёт выхода (повтор документа 21, раздел 6):** +18 dBu = 0,775 × 10^(18/20) ≈ 6,16 В rms, пик ≈ 8,7 В — от ±12 В с запасом ≈ 3 В.

## 4. Управление (R2)

| Узел | Деталь | Факт | LCSC |
|---|---|---|---|
| Микроконтроллер | RP2350A (R85) | — | в библиотеке есть (C9900136995 — номер библиотеки EasyEDA, не склада LCSC; проверить складской) |
| USB-хаб | Microchip USB2514B, 4 порта High-Speed | «In Production» ([Microchip](https://www.microchip.com/en-us/product/USB2514B)) | C633338 |
| MIDI выход 3,3 В | 2 резистора на гнездо | CA-033 (2014): при 3,3 В ± 5 % — 33 Ом / 0,5 Вт и 10 Ом; при 5 В — 220 / 220 Ом; петля 5 мА, фронты < 2 мкс; ферритовые бусины 1 кОм на 100 МГц — по желанию ([MIDI.org, CA-033](https://midi.org/wp-content/uploads/wpforo/default_attachments/1709416667-ca33-MIDI-10-Electrical-Specification-Update.pdf)) | — |
| MIDI вход | Оптрон на 3,3 В: TLP2361 (SMD) или H11L1 / PC900V | 6N138 от 3,3 В — вне даташита; на 3,3 В советуют H11L1 или 3,3-вольтовые TLP2361, HCPL-260L ([mt32-pi wiki](https://github.com/dwhinham/mt32-pi/wiki/GPIO-MIDI-interface), [MIDI.org форум](https://midi.org/community/midi-hardware/best-optoisolator-for-3-3v)) | TLP2361 C107626, H11L1 C255760 |
| CV/Gate 8 выходов | ADI AD5676R + масштабирующие ОУ на ±12 В | 8 × 16 бит, опора 2 ppm/°C, INL ±3 LSB, выход 0…Vref или 0…2Vref ([ADI](https://www.analog.com/en/products/ad5676r.html)); запасной TI DAC8568 (INL 4 LSB) | AD5676RBRUZ C488149, DAC8568ICPW C2868758 |
| CV-входы 4 | Делитель и сдвиг ±10 В → 0…3,3 В, АЦП RP2350 | вывод | — |
| Гнёзда 3,5 мм (MIDI TRS, CV, синхро) | Тип PJ398SM («Thonkiconn») | в библиотеке — WQP-PJ398SM | C9900009788 (номер библиотеки, проверить склад) |

**Расчёт CV (вывод).** Диапазон −10…+10 В = 20 В; шаг 16 бит: 20 В / 65 536 ≈ 0,305 мВ. При 1 В/окт полутон = 1000 / 12 ≈ 83,3 мВ, цент ≈ 0,833 мВ → шаг ЦАП ≈ 0,37 цента. Ошибка ±3 LSB ≈ ±0,9 мВ ≈ ±1,1 цента — убирается калибровкой (R35).

**Вывод — порты хаба:** вверх — Mini-ITX; вниз — панель P2 (R86), A1 порт A (R82), RP2350 на R2; четвёртый свободен. Экран (тач) идёт прямо в Mini-ITX (R110). Четырёх портов хватает.

## 5. Питание (PW)

| Узел | Деталь | Факт | LCSC |
|---|---|---|---|
| USB-C PD (приёмник) | TI TPS25730D | Только приём, PD 3.1, 5–20 В, до 5 А (100 Вт), настройка резисторами — без прошивки и EEPROM; вариант D со встроенным ключом, S — с драйвером внешнего ([TI](https://www.ti.com/document-viewer/TPS25730/datasheet)) | C22438973 |
| ±12 В тихие | Импульсный + TPS7A4701 (+) и TPS7A3301 (−) | Эталонная схема TI TIDA-01458: ±2,5…±12 В из 24 В, импульсный + LDO как фильтр; TPS7A47 — 36 В, 4 мкВ rms, 1 А ([TI](https://www.ti.com/tool/TIDA-01458), [TI](https://ti.com/product/TPS7A47)) | C90084, C90082 |
| +48 В фантом | TPS61391 + TPS7A4101 | раздел 2.3 | C1852151, C111739 |
| Питание Mini-ITX | Повышающе-понижающий на 19 В | ASRock: «совместима с адаптером 19 В», разъём 5,5 × 2,5 ([ASRock](https://www.asrock.com/MB/Intel/N100DC-ITX/index.asp)); 12–19 В — только в сторонней таблице ([mini-ITX.com](https://www.mini-ITX.com/~N100DC-ITX)) | выбрать |

**Вывод — источники:** DC 12–24 В с фиксацией, USB-C PD 20 В / 100 Вт и аккумулятор 4S (≈ 12,8–16,8 В, R109) сходятся через «идеальные диоды» на общую шину 12–24 В. От неё: повышающе-понижающий **19 В** для Mini-ITX (вход шины и выше и ниже 19 В), понижающий +5 В панели и огней (отдельная ветка, документ 10), ±12 В по схеме TIDA-01458 (импульсный + LDO), +48 В фантом. Ошибкой было бы полагаться на то, что плата съест 12–16 В аккумулятора напрямую: официально это не обещано.

**Вывод — шины для LDO:** TPS7A47 нужно на входе ≈ +13…+14 В, чтобы дать чистые +12 В, — импульсный каскад ставим на ±14 В, а не на ±12 В (так же сделано у пользователя E2E с TPS65131: 5 → ±14 → ±12 В).

## 6. Гнёзда задней стенки (из библиотеки EasyEDA)

| Гнездо | Деталь | LCSC | Заметка |
|---|---|---|---|
| Комбо XLR/TRS | Neutrik NCJ6FI-H (горизонтальный монтаж — плата R1 вертикальна, гнездо смотрит наружу) | C368484 | Есть и вертикальный NCJ6FI-V-0 (C368503) |
| 3,5 мм (MIDI TRS, CV, синхро) | PJ398SM | см. раздел 4 | Еврорек-стандарт |
| MIDI DIN 5 | Пример из CA-033 — Switchcraft 57PC5F | не найдено общим поиском | Подобрать по номеру |
| TRS 6,3 мм (линейные, Hi-Z, выходы) | Neutrik NMJ6HCD2 | C368502 | Тип монтажа сверить с вертикальной платой |

## 7. Что проверить на макете (вывод)

1. Склейка двух путей мик/Hi-Z: уровень и фаза (документ 28).
2. Полная шкала и буфер CS5308P по AN0556 — шум и искажения с OPA1637.
3. Фантом: шум на выходе и поведение при коротком замыкании двух каналов.
4. Питание: шум ±12 В после LDO при работе импульсных 19 В и +5 В огней рядом.

## Открытые вопросы

> **Ответы 13.11.2026:** 1 — +24 dBu (R135); 2 — CS4308P со своей посадкой (R136; ES9039PRO и AK4499EX — токовый выход, отказались); 3 — реле (R137); 4 — начинаем с R2 (R138).

1. **Запас линейных входов:** +18 dBu или +24 dBu? От этого и от полной шкалы CS5308P (даташит DS1314F2, заметка AN0556 — взять) зависит ослабление в драйвере АЦП.
2. **ЦАП CS4308P нет в библиотеке EasyEDA:** рисуем символ и посадочное место сами (корпус QFN, по даташиту) или берём запасной AKM AK4458 — он в библиотеке есть (AK4458VN, C1520729), но хуже по цифрам (115 против 123 дБА, документ 28)? Предлагаю CS4308P со своей посадкой.
3. **Ключи выходов:** реле (размыкаются сами без питания, R66) — или полевые ключи (тише, но без питания не гарантированно разомкнуты)? Предлагаю реле.
4. **Порядок работы:** начинаю схемы с R2 (цифровая, без риска для звука) или с макета входного узла R1 (самое рискованное — склейка путей)?

Sources:
- [TI OPA1612](https://www.ti.com/product/OPA1612), [TI OPA1642](https://www.ti.com/product/OPA1642), [TI OPA1637](https://www.ti.com/product/OPA1637), [TI INA1620](https://www.ti.com/product/INA1620), [TI INA1650](https://ti.com/document-viewer/INA1650/datasheet), [TI DRV134](https://www.ti.com/product/DRV134)
- [Cirrus CS5308P](https://www.cirrus.com/products/cs5308p/)
- [TI PMP40871 (фантом 48 В)](https://ti.com/tool/PMP40871), [TI TIDT235](https://ti.com/lit/pdf/tidt235), [ADI фантом на LT8362](https://www.radiolocman.com/shem/schematics.html?di=618795)
- [TI TIDA-01458 (±12 В)](https://www.ti.com/tool/TIDA-01458), [TI TPS7A47](https://ti.com/product/TPS7A47), [TI E2E: TPS65131 5 → ±14 → ±12 В](https://e2e.ti.com/support/power-management-group/power-management/f/power-management-forum/1419211/tps65131-request-for-schematic-review)
- [TI TPS25730](https://www.ti.com/document-viewer/TPS25730/datasheet)
- [ASRock N100DC-ITX](https://www.asrock.com/MB/Intel/N100DC-ITX/index.asp), [mini-ITX.com N100DC-ITX](https://www.mini-ITX.com/~N100DC-ITX)
- [MIDI CA-033 (2014)](https://midi.org/wp-content/uploads/wpforo/default_attachments/1709416667-ca33-MIDI-10-Electrical-Specification-Update.pdf), [mt32-pi: GPIO MIDI](https://github.com/dwhinham/mt32-pi/wiki/GPIO-MIDI-interface), [MIDI.org: оптрон для 3,3 В](https://midi.org/community/midi-hardware/best-optoisolator-for-3-3v)
- [ADI AD5676R](https://www.analog.com/en/products/ad5676r.html), [TI DAC8568](https://www.ti.com/lit/gpn/dac8568)
- [Microchip USB2514B](https://www.microchip.com/en-us/product/USB2514B)
- Номера LCSC — библиотека EasyEDA Pro через `tools/eda/eda_parts.py`, 13.11.2026.
