MitjaGrecky/Shtuka-druka/docs/ru/33_m1_review.md

# Штука Дрюка: M1 — разбор, почему плата не разводится, и выводы

*06.11.2026. Сводка перед пакетом улучшений: пользователь — «Давай все выводы сделаем сначала, а потом комплекс мероприятий по улучшениям проведём». Основа: замеры облака (`hardware/m1-screen-knobs/gen/cut_count.py`), разбор и замеры ПК-сессии в pcbnew KiCad 10 (`notes/handoff.md`, отчёты от 06.11), документ 30. **Факт** — замер или даташит, **вывод** — инженерная логика, **решено** — решение пользователя. Ничего на плате не менялось.*

## 0. Коротко

- **Тесно у драйвера огней, а не между ручками.** К одному IS31FL3741A (QFN-60, шаг 0,4 мм) сходятся 45 линий матрицы на 104 огня. Вокруг него слой In2.Cu занят трассами на ~80 %, все 4 обрыва и рваная земля — там же. В щелях между энкодерами запас в 2–4 раза (**факт**, замер ПК).
- **Моя ошибка:** в P98 я обосновал деление «переполненными щелями» (44 цепи). Замер ПК это опроверг: 44 цепи — четверть ёмкости щели. Деление всё равно помогает, но по другой причине: меньше линий на один драйвер.
- **Ещё пять слабых мест** найдены разбором ПК: огни повёрнуты так, что дуги R и G перекрещиваются (≈ 3,4 переходных на огонь, 867 на плате); линии SW тонкие для их тока; развязка в 7–26 мм от выводов; куски земли без переходных; линии касания длинные и идут рядом с ШИМ.
- **Планирование:** крепление (P97) решалось после разводки; ток и плотность выводов не прикидывались до трассировки; Quilter получал задачу с тем же узким местом.
- **Варианты:** довести текущую плату руками; 2 драйвера (P98); 4 драйвера — по одному на пару колец. Сравнение в разделе 5, пакет улучшений — в разделе 6.

## 1. Что произошло

| Попытка | Результат |
|---|---|
| Freerouting 1.9, наша расстановка | разведено всё, кроме 4 соединений у U1 (`UNROUTED`); DRC: 11 unconnected (4 + 7 кусков земли) |
| Quilter job A (только трассировка) | 1 ч 28 мин, 1 кандидат, 12 неполных цепей, 8 из 13 конденсаторов развязки отмечены |
| Quilter job B (расстановка снизу) | отказ через 8 мин: «деталь слишком велика для области» |
| Quilter job C (мелочь подвижна) | 2 ч, 6 расстановок, роутер встал на 33/39, остановлен 06.11 в 19:55 |

**Вывод:** два разных трассировщика упёрлись в одно место. Значит, дело в задаче, а не в инструменте.

## 2. Где на самом деле тесно

**Факт (ПК, pcbnew):** цифры облака по щелям совпали точно — 14/27/31/44/41/28/23 сигнальных цепей, из них линий матрицы 11/18/21/27/27/21/18. Но свободного места в щели много:

| Щель x, мм | Цепей | Ещё помещается дорожек 0,12/0,13 мм: In2.Cu | B.Cu | F.Cu |
|---|---|---|---|---|
| 144,5 (худшая) | 44 | +57 | +82 | +90 |
| 172,5 | 41 | +78 | +88 | +99 |
| остальные | 14–31 | +81…+89 | +98…+110 | +107…+108 |

**Факт:** заполнение In2.Cu трассами вокруг U1: ±4–6 мм — ~80 %, ±10 мм — ~54 %, ±14 мм — ~38 %. Между падами с шагом 0,4 мм дорожка 0,12/0,13 не проходит (нужно 0,38 мм), переходные 0,45 мм ставятся у QFN только в два ряда.

**Вывод:** предел — выход 45 линий из-под корпуса 7 × 7 мм, а не ширина платы и не число слоёв. Поэтому 6 слоёв не нужны (ПК): они добавляют немного мест под переходные, но не снимают шаг выводов.

## 3. Слабые места схемы и расстановки

| № | Что | Факт / расчёт | Последствие |
|---|---|---|---|
| 1 | **Поворот огней.** XL-1615 — пады 2 × 2: столбцы (R, A) и (G, B). Сейчас снаружи кольца R и G, внутри A и B | 354 переходных на матрицу (~3,4 на огонь), всего 867 (ПК) | Дуги R и G на одном радиусе перекрещиваются у каждого огня |
| 2 | **Линии SW тонкие.** SW — общий анод строки, до ~35 каналов × 19 мА ≈ 0,66 А в пике | R = ρ·L / (w·t) = 1,72·10⁻⁸ Ом·м × 0,110 м / (0,12 мм × 17,5 мкм) ≈ 0,9 Ом (внутренний слой 0,5 oz — проверить в заказе JLCPCB); падение до 0,3–0,6 В | Дальние кольца тусклее или другого оттенка, синему (Vf ≈ 3 В) может не хватить запаса |
| 3 | **Развязка далеко** | C1–C4 у U1 — 7–9 мм, C5–C8 — 12–13 мм, C9–C11 у 74HC165 — ~8 мм, C13 — 26 мм; нужно 1–3 мм. VREG и CMOD у CY8CMBR3108 по даташиту — вплотную | Помехи, «8 из 13 отмечены» в Quilter |
| 4 | **Земля** | Заливка B.Cu рвётся на 20 кусков, у земляных падов C1–C6, R3, U2.17, U4.15 нет переходного на In1.Cu (отчёт #1) | 7 из 11 unconnected в DRC |
| 5 | **Касание** | TOUCH0 ~146 мм, идёт по In2.Cu рядом с шиной SW (ШИМ ~29 кГц). Допуск контроллера 5–45 пФ (документ 30) | Риск ложных касаний; ёмкость дорожки оценить по даташиту |
| 6 | **Питание при полном белом** | Одна строка горит всегда: ~0,66 А × 5 В ≈ 3,3 Вт с модуля | Ограничить глобальным током (GCC) в прошивке, учесть в бюджете хоста |

**Поворот огней (решено пользователем 06.11):** поворот на 90° **не принимается** — «теряется рисунок установки элементов»; 180° допустим.
**Вывод (проверил по геометрии падов):** поворот на 180° пересечение не снимает. Пады меняются местами крест-накрест: снаружи окажутся B и A, внутри G и R — R и G снова в одном ряду рядом и снова пересекаются. При текущем рисунке пересечение можно убрать иначе: одну из дуг (R или G) увести переходным на внутренний слой. Это ~2 переходных на огонь вместо 3,4; проверить на копии одного кольца с DRC.

## 4. Ошибки планирования

| Что | Как было | Как надо |
|---|---|---|
| Крепление | P97 (3 отверстия, одно на x = 168, рядом с U1) предложено после разводки, в плате их нет | Механику (крепёж, световод, вырезы) замораживать до разводки |
| Плотность у микросхем | Не считали, сколько линий выходит из каждой микросхемы | До разводки: линий на миллиметр периметра корпуса; у QFN 0,4 мм — больше ~1 линии на вывод по кругу не выйдет без второго ряда переходных |
| Токи | Все сигнальные цепи 0,12 мм | До разводки: ток каждой цепи → ширина и слой |
| Задача трассировщику | Quilter и Freerouting получали ту же расстановку с тем же узким местом | Сначала замер узких мест (скрипт), потом трассировщик |
| Проверка идеи | Сразу вся плата на 8 ручек | Сначала одно кольцо или одна ячейка на копии, DRC, потом размножить |

## 5. Варианты архитектуры

| | Довести текущую | 2 драйвера (P98) | 4 драйвера |
|---|---|---|---|
| Линий матрицы на драйвер | 45 | 27 (9 SW + 18 CS) | 18 (9 SW + 9 CS) |
| Самая длинная линия матрицы | ~111 мм | ~55 мм | ~30 мм |
| Ток SW в пике | ~0,66 А | ~0,33 А | ~0,17 А |
| Падение на SW 0,12 мм, 0,5 oz (оценка) | 0,3–0,6 В | ~0,1–0,15 В | ~0,04 В |
| Цена сверху на модуль | 0 | +1 × 3,68 $ | +3 × 3,68 $ ≈ 11 $ |
| Адреса I²C | 1 из 4 | 2 из 4 (перемычки R3–R6, разные у ячеек) | все 4 (0x30–0x33) — следующему модулю на этой шине не останется |
| 74HC165 | 3 | 4 (по 12 бит на ячейку, 4 входа пустые) | 3, общие на плату |
| Касание | U2 на x = 180, до ~134 мм | один CY8CMBR3108 у стыка, до ~100 мм | один у центра, до ~100 мм |
| Работа | ~день руками на ПК + исправления п. 2–5 всё равно нужны | генератор: ячейка + копия | генератор: ячейка из 2 колец + 3 копии |
| Риск | Тонкие SW, касание у ШИМ, 4 обрыва в самом тесном месте | ШИМ двух драйверов не синхронны | То же; адреса кончаются на M1 |

**Касание в любой схеме деления (факт, ПК):** у CY8CMBR3108 в QFN-16 нет вывода адреса и XRES. Два чипа включаются оба на 0x37, сменить адрес одному (регистр I2C_ADDR) можно, только когда второй молчит. Поэтому разумнее один чип на все 8 ручек.

**Адреса (вывод):** R124 разводит модули с касанием по разным шинам. Если M1 займёт все 4 адреса IS31FL3741A, у M1 своя шина I²C обязательна — проверить по карте шин (документ 30, раздел 6).

## 6. Пакет улучшений (кандидаты, решает пользователь)

Не зависят от выбора архитектуры:
1. Развязку — вплотную к выводам, у каждого земляного пада переходной на In1.Cu.
2. Класс цепей SW — шире (0,3 мм там, где можно, сужение у выводов QFN).
3. Кольца огней рисует генератор (дуги и переходные периодичны), автороутеру остаются шина и логика. Сначала — одно кольцо на копии платы, DRC.
4. Карту CS выровнять по кольцам (ПК, п. 5 разбора): тройки не режут кольцо где придётся.
5. Крепление (P97) — в генератор до разводки.
6. Линии касания — по слою, где нет ШИМ, или с землёй между ними.

Зависит от выбора: число драйверов (раздел 5).

## 7. Открытые вопросы

1. Сколько драйверов: 1, 2 или 4 (раздел 5).
2. Есть ли у IS31FL3741A вход синхронизации ШИМ; если нет — видны ли биения между драйверами (камера).
3. Медь внутренних слоёв в заказе JLCPCB: 0,5 или 1 oz.
4. Ёмкость линии касания ~100 мм против допуска CY8CMBR3108.
5. Свободные адреса I²C на шине M1 при 4 драйверах.

Sources: [Infineon Community: CY8CMBR3xxx I2C slave address collision](https://community.infineon.com:443/t5/CAPSENSE-MagSense/CY8CMBR3xxx-CapSense-IIC-Slave-Address-collision/td-p/333476); даташит IS31FL3741 ([Mouser](https://www.mouser.com/datasheet/2/198/IS31FL3741-1275466.pdf)); замеры — `notes/handoff.md`.
