MitjaGrecky/Shtuka-druka/docs/ru/14_decisions_log.md

# Штука Дрюка: журнал решений

> **Обновление 06.11.2026:** журнал разбит на блоки и переехал в [`decisions/`](decisions/README.md). Начинать с [`decisions/README.md`](decisions/README.md): там приоритеты, открытые вопросы и где какой блок. Номера R и P не менялись. Старый файл целиком сохранён в истории git.
