MitjaGrecky/Shtuka-druka/docs/ru/30_m1_screen_knobs.md

# Штука Дрюка: модуль ручек экрана M1 — первая плата

*01.11.2026. Продолжение R121 («Первая плата — модуль 8 ручек экрана M1»). Основа: панель v7 (R107, документ 27), карта плат (R119, документ 29), энкодеры R74, огни R10 и R51, касание и отсев ладони R111. **Факт** — из источника, **вывод** — моя логика, **решено** — решение пользователя. **Решено 01.11.2026: «Хорошо. Меня устраивает, работаем дальше» — P76–P80 → R122–R126.***

## 0. Коротко

- **Плата 224 × 34 мм, 4 слоя** (при разводке выросла с 28 мм, R127). Сверху — только 8 энкодеров и 104 RGB-огня (8 колец по 13). Всё остальное — снизу, в промежутках между энкодерами. Так сверху ничего не мешает световоду под обшивкой.
- **Детали — из того, что сейчас продаётся:** драйвер огней Lumissil IS31FL3741A, контроллер касания Infineon CY8CMBR3108, светодиоды XINGLIGHT XL-1615RGBC-RF, три сдвиговых регистра 74HC165, энкодеры Alps EC11E (гладкие, R74). Наличие проверено сегодня (раздел 1).
- **Плата разведена, кроме 4 соединений у драйвера огней** (из ≈ 600): выводы SW5 и CS29 драйвера, SW3 к одному огню и земля одного конденсатора. Перестановка выводов драйвера и местная переразводка своим скриптом не помогли — у драйвера слишком тесно. Следующий шаг — отдать плату Quilter: детали, которые задаёт панель (энкодеры, огни, разъём, отверстия), в файле закреплены, правила — в `hardware/m1-screen-knobs/QUILTER.md`.
- **Схема и плата собраны кодом** из одного файла с данными (`hardware/m1-screen-knobs/gen/design.py`): все 710 соединений нетлиста KiCad совпали с исходными данными, расхождений 0.
- **Проверка в 3D (Blender):** M1 в корпусе помещается. По всему корпусу найдены одно столкновение и три тесных места — не на M1 (раздел 9).
- **Решено:** 13 огней на кольцо (R122), общий разъём модулей 2 × 7 (R123), свой драйвер огней на каждом модуле (R124), вся электроника на нижней стороне (R125), световод-проставка (R126).

## 1. Что на плате

| Узел | Деталь | Корпус | LCSC | Наличие (факт, 01.11.2026) | Зачем |
|---|---|---|---|---|---|
| Драйвер огней | Lumissil **IS31FL3741A**-QFLS4-TR | QFN-60, 7 × 7 мм | C2940604 | LCSC — 2 177 шт., 3,68 $ ([LCSC](https://www.lcsc.com/product-detail/C2940604.html)); Mouser — 9 894 шт., 2,52 £ ([Mouser](https://www.mouser.co.uk/en/ProductDetail/Lumissil/IS31FL3741A-QFLS4-TR?qs=vHuUswq2%252BswTP7dMFLQAvQ%3D%3D)); на складе сборки JLCPCB — 0, деталь подтянут с LCSC | Матрица 39 × 9, I²C, ШИМ 29 кГц (R51) |
| Касание | Infineon **CY8CMBR3108**-LQXIT | QFN-16, 3 × 3 мм | C462528 | LCSC — 690 шт., от 0,36 $ ([LCSC](https://www.lcsc.com/product-detail/C462528.html)) | 8 каналов касания, I²C, сам подстраивается под ёмкость |
| Огни колец | XINGLIGHT **XL-1615RGBC-RF** | 1,6 × 1,5 мм | C965840 | LCSC — 325 400 шт., от 0,012 $ ([LCSC](https://www.lcsc.com/product-detail/C965840.html)) | RGB с общим анодом (R10) |
| Энкодеры | Alps **EC11E1834403** или другой гладкий EC11 с кнопкой и металлическим валом | выводной | — | Mouser — 30 шт., следующая поставка 1 200 шт. 23.12.2026 (проверено ранее) — на один модуль хватает | R74 |
| Чтение энкодеров | **74HC165** × 3 | TSSOP-16 | — | Ходовая деталь | 24 входа: A, B, нажатие × 8 |
| Разъём | Штыри 2 × 7, шаг 1,27 мм | выводной, снизу | — | Ходовая деталь | P77 |

Плюс резисторные сборки 4 × 10 кОм, 560 Ом на линии касания, конденсаторы развязки. Полный список — BOM, который GitHub собирает при каждом изменении.

**Почему не CAP1188 (факт):** у LCSC его нет в наличии ([LCSC](https://lcsc.com/product-detail/Touch-Sensors_Microchip-Tech-CAP1188-1-CP-TR_C2652057.html)). CY8CMBR3108 есть и в библиотеке KiCad.

**Как я сверил распиновку огня (факт):** открыл даташит XL-1615RGBC-RF у LCSC и посмотрел чертёж: вывод 1 — красный катод, 2 — общий анод, 3 — зелёный, 4 — синий; площадки 0,45 × 0,65 мм с зазорами 0,8 и 0,3 мм. По нему сделан символ и посадочное место. Выводы IS31FL3741A сверены по двум независимым открытым библиотекам; формула тока и пороги логики — из даташита ([Mouser, даташит](https://www.mouser.com/datasheet/2/198/IS31FL3741-1275466.pdf)).

## 2. Кольца: 13 огней (R122)

**Факты из даташита IS31FL3741A:** 39 линий CS × 9 линий SW = 351 огонь = 117 RGB; ток в пике на CS = 383 / R_EXT (кОм) × GCC/256 × SL/256, не больше 38 мА; средний ток огня = пик / 10,125 × ШИМ/256; логическая «1» — от 1,4 В при питании до 5,5 В.

**Вывод:**
- 8 колец по 15 огней = 120 RGB — на 3 больше, чем умеет одна микросхема. По 13 огней — 104 RGB, одна микросхема на модуль.
- **Как огни разложены по матрице (вывод, уточнено при разводке):** огни пронумерованы вдоль платы (n = 13 × кольцо + точка) и заполняют матрицу по девять: тройка CS номер n / 9, линия SW номер n mod 9. Тогда вдоль всей платы идут только 9 линий SW, а каждая тройка CS обслуживает 9 соседних огней в одном-двух кольцах — пучок CS тоньше к краям платы. При простой раскладке «кольцо = своя линия SW» через всю плату шли бы все 39 линий CS, и автороутер с этим не справился. Для прошивки это просто таблица «кольцо, точка → SW, CS». Используются CS1–CS36.
- 13 огней на дуге 270° — шаг 22,5°, расстояние между огнями 4,7 мм при радиусе 12 мм (кольцо ⌀ 24 из `layout_v7.json`). Столько же точек у колец Behringer X-Touch. Промежуточные значения прошивка показывает яркостью двух соседних огней.
- **R_EXT = 20 кОм:** не больше 19 мА в пике на канал, в среднем до 1,9 мА на цвет. Худший случай — всё белым на полную: ≈ 0,7 А от +5 В на модуль; обычная картина (значения одним цветом, половина яркости) — около 0,1 А. Прошивка ограничивает общий ток через GCC.
- 3D-модель и чертежи панели переведены на 13 точек.

## 3. Касание ручки

- **Электрод** — металлический корпус и вал энкодера (вывод MP). К нему через 560 Ом идёт канал CY8CMBR3108 (рекомендация даташита). Колпачок — металлический или с проводящим покрытием, винт колпачка касается вала.
- **Факт из даташита:** паразитная ёмкость датчика — 5–45 пФ, контроллер сам подстраивается (SmartSense) и хранит настройки в своей памяти; вход прерывания HI — открытый сток, активный ноль.
- **Вывод:** чтобы не набрать лишнюю ёмкость, медь земли во внутреннем слое и снизу вырезана под каждым энкодером (19 × 16 мм).
- **Риск:** если обшивка металлическая, гайка энкодера замкнёт электрод на корпус. Тогда нужна пластиковая шайба под гайку или пластиковая обшивка. Это первое, что проверяем на собранном модуле — для этого M1 и делается первым (R121).
- Отсев ладони (R111) — в прошивке: касание засчитывается, только если ручка ещё и повернулась или касание короткое и одиночное.

## 4. Энкодеры и кнопки

Три 74HC165 в цепочке, вход подтянут к +3,3 В. Плата панели читает 24 бита через PIO RP2350 (R85). После защёлки биты идут в таком порядке:

| Регистр | D7 → D0 |
|---|---|
| U3 (первым) | E1 A, E1 B, E1 кнопка, E2 A, E2 B, E2 кнопка, E3 A, E3 B |
| U4 | E3 кнопка, E4 A, E4 B, E4 кнопка, E5 A, E5 B, E5 кнопка, E6 A |
| U5 | E6 B, E6 кнопка, E7 A, E7 B, E7 кнопка, E8 A, E8 B, E8 кнопка |

Вход цепочки выведен на разъём: следующий модуль продолжает её без доработок.

## 5. Разъём модулей (R123)

Штыри 2 × 7 с шагом 1,27 мм и плоский шлейф — одинаковые на всех модулях энкодеров (R54, R74). Против 2 × 6 из документа 29 добавлены второй вывод +5 В и ещё одна земля: ток колец до 0,7 А на модуль.

| Вывод | Сигнал | Вывод | Сигнал |
|---|---|---|---|
| 1 | +5V (огни) | 2 | +5V |
| 3 | GND | 4 | GND |
| 5 | +3V3 | 6 | GND |
| 7 | SDA | 8 | SCL |
| 9 | INT (общий, открытый сток) | 10 | GND |
| 11 | SR_LOAD | 12 | SR_CLK |
| 13 | SR_OUT (к плате) | 14 | SR_IN (от следующего модуля) |

Подтяжки I²C и INT — на плате панели; на модуле для них оставлены места (не запаиваются).

## 6. Свой драйвер на каждом модуле, адреса I²C (R124)

- **Вывод:** у модуля свой драйвер огней и свой контроллер касания. Тогда по шлейфу идёт шина, а не 48 линий матрицы, и модуль можно поменять, не трогая основную плату.
- **Следствие для документа 29:** плате сетки P2 хватит одного драйвера огней вместо двух — кольца ушли на M1.
- **Адреса:** у IS31FL3741A их четыре, выбор — перемычкой 0 Ом (на M1 по умолчанию 0x30). У CY8CMBR3108 адрес по умолчанию 0x37 у всех, поэтому два модуля с касанием (M1 и M2) сажаем на разные шины I²C: M1 — на шину платы P2, M2 — на шину боковых плат. У RP2350 два аппаратных I²C, при нужде ещё одна шина на PIO. Больше четырёх драйверов огней на одной шине не бывает — шины делим по платам.

## 7. Плата (R125)

| Что | Как |
|---|---|
| Размер | 224 × 34 мм — 8 шагов по 28 мм; на панели x 108,75–332,75, y 263–297 (ручки на 277, сгиб панели на 300) |
| Слои | 4: верх — огни и выводы энкодеров; 2-й — сплошная земля с вырезами под энкодерами; 3-й и низ — сигналы |
| Сверху | Только 8 энкодеров и 104 огня |
| Снизу | Драйвер, контроллер касания, три регистра, мелочь и разъём — в промежутках 11 мм между энкодерами |
| Сборка | На заводе (R115) с двух сторон: SMD сверху и снизу; энкодеры и разъём — выводные |
| Правила | Дорожки 0,12 мм, зазор 0,13 мм, переходные 0,45/0,2 мм, питание и земля 0,3 мм. **Факт:** у JLCPCB для 4 слоёв минимум 0,09 мм дорожка и зазор, отверстие переходного от 0,2 мм, от отверстия переходного до дорожки 0,254 мм ([JLCPCB](https://api.jlcpcb.com/capabilities/Capabilities)); доплату за мелкие переходные покажет калькулятор при заказе |

**Почему всё снизу (вывод):** сверху над платой только световод и обшивка, а промежутки между кольцами — 2–4 мм, туда микросхема не встаёт. Снизу между выводами соседних энкодеров — 11 мм свободно. Двусторонняя сборка дороже односторонней на одну наладку.

**Почему 34, а не 28 мм (R127, «Хорошо, продолжай»):** у драйвера огней 60 выводов с шагом 0,4 мм. Между энкодерами ему оставалось по 4 мм с каждой стороны, и автороутер не смог вывести все линии — два десятка соединений остались неразведёнными. Плата выросла на 6 мм назад, к сгибу панели, и драйвер переехал в эту полосу за кольцами. Проверка в 3D: до сгиба остаётся 3 мм, экран и обшивка не задеты.

**Разводка:** Freerouting 1.9 по правилам выше; под корпусами энкодеров (12,4 × 8,8 мм) дорожек и переходных нет — там электрод касания; медь земли вырезана только под рамкой энкодера, выводы земли энкодеров садятся на внутренний слой.

## 8. Свет (R126)

**Вывод:** верх светодиода окажется в ≈ 5,9 мм под обшивкой (корпус энкодера держит плату в 6,5 мм под ней). Без световода свет расплывётся пятном.

**Сделано:** проставка-световод — пластина по контуру платы 224 × 34 × 6,4 мм, печать чёрным PETG или PLA слоем 0,2 мм. В ней:
- отверстие ⌀ 2,4 мм над каждым из 104 огней — каждая точка остаётся точкой;
- вырезы 13 × 14,2 мм под корпуса энкодеров;
- отверстия ⌀ 2,4 мм под винты M2 в углах платы;
- карман 11,5 × 4 × 2 мм снизу — под концы штырей разъёма J1.

Файл для печати — `hardware/m1-screen-knobs/mech/m1_light_guide.stl`; собирается скриптом `gen/make_light_guide.py` из тех же координат, что и плата. В обшивке над отверстиями — 13 отверстий на кольцо с молочной вставкой или сплошное молочное кольцо; это решим вместе с материалом обшивки.

## 9. Проверка в 3D (Blender)

Модель собирается скриптом `model3d/fit/build_blend.py` из тех же данных: корпус 515 × 460 по R107, четыре платы панели, M1 с энкодерами и разъёмом, Mini-ITX, экран, платы наклона, аудиоплата, питание, отсек аккумулятора, задняя стенка — 353 детали. Каждая пара деталей проверяется на столкновение и на зазор меньше 1 мм.

| Что | Результат | Что делать |
|---|---|---|
| M1 целиком | Помещается: корпус энкодера упирается в обшивку, как задумано; разъём со шлейфом снизу уходит до высоты 49 мм, под ним пусто (Mini-ITX кончается на y 215) | — |
| Гнездо USB-A в кармане System (оценка) | **Столкновение 9 мм**: обычное вертикальное USB-A — около 15,5 мм над платой, а под наклонной обшивкой у W3 6,5 мм | Вырез в W3 и маленькая плата кармана ниже, или горизонтальное гнездо |
| Стекло экрана у полки | Зазор 0,37 мм у верхнего края | Стык наклона с полкой не должен залезать внутрь |
| Кроссфейдер и подшипник колеса (оценка) | Касаются обшивки | Сверить высоту по выбранным деталям |

Детали с пометкой «оценка» — прикидка, их надо заменить размерами из даташитов или замером.

## 10. Файлы

- `hardware/m1-screen-knobs/` — проект KiCad (открывается в KiCad 10; файлы в формате KiCad 7, при сохранении KiCad 10 их обновит). `gen/` — скрипты: `design.py` (данные), `make_lib.py` (символы и посадочные места), `make_sch.py` (схема), `make_pcb.py` (плата и автотрассировка).
- `hardware/m1-screen-knobs/mech/m1_light_guide.stl` — световод для печати (раздел 8).
- `model3d/fit/` — проверка корпуса: `fit_model.py` (детали и проверка без Blender), `build_blend.py` (сцена Blender и картинки).

## Открытые вопросы

1. ~~P76–P80~~ — R122–R126.
2. Вал EC11E1834403 должен быть металлическим и соединённым с корпусом — проверить по даташиту Alps или на образце.
3. Материал обшивки (металл или пластик) — от него зависит изоляция гайки энкодера.
4. Карман USB-A + SD на W3 — переделать по итогам проверки в 3D.

Sources: ссылки в тексте; даташит XL-1615RGBC-RF — [LCSC](https://www.lcsc.com/datasheet/C965840.pdf); CY8CMBR3108 — [даташит](https://static.chipdip.ru/lib/907/DOC028907904.pdf).
