MitjaGrecky/Shtuka-druka/docs/ru/28_mic_inputs_and_converters.md

# Штука Дрюка: входы без перегруза и свежие преобразователи

*01.11.2026. Ответ на замечание пользователя: «PGA2500 — если их немного, значит должна была появиться альтернатива… если я соберу в течение года и они кончатся, нахрен мне это нужно. Нужны актуальные решения». Пересматривает P49 и P51 из документа 21. **Решено 01.11.2026: «Принимаю» — P73 → R116, P74 → R117, P51 → R118.** **Факт** — из источника, **вывод** — моя логика, **решено** — решение пользователя.*

## 0. Коротко

- **Сборка плат на заводе** — решено пользователем (R115). Значит, корпуса QFN не ограничение.
- **Моя ошибка в прошлом ответе:** я написал, что PGA2500 «на складах немного». Это так для упаковки в тубах (Mouser — 169 шт.), а в ленте на катушке у авторизованных дистрибьюторов больше 340 тысяч ([Octopart](https://octopart.com/part/texas-instruments/PGA2500IDB)). Но вывод пользователя верен по другой причине: микросхеме 23 года (даташит 2003 года, [TI](https://www.ti.com/lit/ds/symlink/pga2500.pdf)), и строить новую вещь на ней — плохая ставка.
- **Предлагаю (P74):** вообще без микросхемы-предусилителя. Входы Mic/Line 1–2 и Hi-Z 1–2 — с постоянным усилением на обычных операционных усилителях и двумя каналами АЦП на вход: тихий путь и громкий путь склеиваются в цифре. Так сделаны рекордеры с 32-bit float (Zoom F6, Sound Devices MixPre II) и аудиоинтерфейс Zoom UAC-232: **перегрузить вход нельзя**, ручка Gain становится чисто цифровой.
- **Преобразователи (P73):** вместо AKM 2016 года — новая линейка Cirrus Logic Pro 2024–2025 годов: АЦП CS5308P × 2 + CS5304P × 1 (20 каналов), ЦАП CS4308P. Их ставит Focusrite в свои USB-интерфейсы.
- **P51 упрощается:** аналогового усиления больше нет; плата управления ведёт только фантом, переключатели и ключи выходов, цифровое усиление и склейка — в xcore.ai.

## 1. Что происходит с микросхемами-предусилителями (факты)

| Что | Факт |
|---|---|
| TI PGA2500 | Статус «Active», но разработка 2003 года ([TI](https://ti.com/product/PGA2500/part-details/PGA2500IDBR)) |
| THAT Corporation | Закрывает свою фабрику пластин. С 3 сентября 2026 сняты с производства, среди прочего, микрофонные предусилители 1510, 1512, 1593, входные каскады InGenius 120x–129x, VCA 2162/2180/2181, выходные каскады 1606/1646, транзисторные сборки 300; последний заказ — 30 сентября 2026, последние отгрузки — до конца 2027 ([Profusion](https://eu.profusion.uk/at/blog/post/that-corporation-end-of-life)) |
| THAT 1580/1583 + 5263 (цифровой предусилитель) | В списке снятых их нет, но на странице продукта висит объявление о снятии части микросхем; усиление 0–60 дБ шагом 3 дБ ([THAT](https://thatcorp.com/that-1580-5263-digitally-controlled-microphone-preamplifier/)) |
| THAT 6261/6263/6266 | Только −8…+34 дБ — для динамического микрофона нужен ещё каскад ([Mouser](https://www.mouser.fi/new/that-corporation/that-6261-6263-6266/)) |

**Вывод:** специализированные микросхемы микрофонных предусилителей — уходящий класс: у TI одна старая, у THAT — закрытие фабрики. Надёжнее строить вход на обычных малошумящих операционных усилителях, которые делают и будут делать многие производители.

## 2. Как это делают сейчас (факты)

| Подход | Где | Как работает | Цифры |
|---|---|---|---|
| **Два АЦП на вход, 32-bit float** | Zoom F6 (2019), Sound Devices MixPre II (2019), Zoom UAC-232 (интерфейс, драйвер 2023), DiGiCo SD 32-bit | Сигнал делится на «громкий» путь (малое усиление) и «тихий» (большое); оба оцифровываются и склеиваются автоматически. «Единственное решение во время записи — писать или нет» ([Zoom](https://zoomcorp.com/en/jp/news/f6-development-story/)) | UAC-232, измерено: динамический диапазон XLR 134,3 дБ, шум на входе ≈ −127,7 dBu, ручки усиления нет, переход между АЦП около −35 dBFS за ≈ 0,5 мс ([Virtins](https://virtins.com/doc/ZOOM-UAC-232-Test-Report-using-Multi-Instrument.pdf)); DiGiCo — два преобразования на канал, 123 дБА ([DiGiCo](https://digico.biz/rackmodules/sd-32-bit-mic-pre-amp/)) |
| **Аналоговое усиление переключается цифрой + Auto Gain и Clip Safe** | Focusrite Scarlett 4-го поколения (2023) | Ручка — энкодер, 69 дБ усиления; Auto Gain ставит пики на −12 dBFS; Clip Safe сам убавляет при угрозе перегруза ([Sound On Sound](https://www.soundonsound.com/reviews/focusrite-scarlett-4th-gen)) | Шум на входе −127 dBu(A), динамический диапазон микрофонного входа 116 дБ |
| **Цифровая микросхема-предусилитель** | Старые пульты и интерфейсы | PGA2500/THAT по SPI | См. раздел 1 |

**Вывод:** по шуму все три подхода одинаковы (≈ −127…−128 dBu). У двух АЦП на вход динамический диапазон на ≈ 18 дБ больше, чем у Scarlett, и он один не требует вообще ничего крутить перед записью.

## 3. Предложение P74: входы с двумя путями

**Как устроено (вывод):**

```
XLR / Hi-Z ─► защита, фантом (только XLR) ─► малошумящий каскад, усиление постоянное
                                               ├─► путь «громкий»: ×1      ─► канал АЦП 1
                                               └─► путь «тихий»: +≈ 40 дБ  ─► канал АЦП 2
xcore.ai A: склейка двух каналов в один с запасом ≈ 150 дБ ─► ручка Gain (цифровая) ─► дорожка
```

- **Каскады** — на TI OPA1612 (шум 1,1 нВ/√Гц, уже есть в документе 21). Оценка шума на входе при источнике 150 Ом: источник 1,57 нВ/√Гц, пара усилителей ≈ 1,56 нВ/√Гц, резисторы ≈ 0,9 нВ/√Гц → ≈ 2,4 нВ/√Гц × √20 000 Гц ≈ 0,34 мкВ → **≈ −127 dBu**, как у PGA2500 и Scarlett. Точнее — на макете.
- **Ручка Gain** (R16) остаётся: теперь это точное цифровое усиление — запоминается, есть авто-подстройка, а защита от перегруза получается сама собой.
- **Склейка** — в xcore.ai A: пока «тихий» путь не близок к перегрузу, берётся он, дальше — «громкий» с плавным переходом. Zoom честно пишет, что пришлось решать разницу фаз и уровней двух путей и шум при переключении — значит, нужна калибровка путей и одинаковые фильтры; это проверяем на макете первым делом.
- **По USB** склеенный сигнал идёт как обычное 32-битное целое: 32 бита вмещают ≈ 190 дБ, так что 32-bit float на проводе не нужен, и внешний компьютер работает с обычным драйвером.
- **На какие входы:** Mic/Line 1–2 и Hi-Z 1–2 — у них источник заранее неизвестен (контактные микрофоны на предметах, гитара, голос). Фоно и линейные 1–8 — с постоянным усилением, у них уровень известен.

**Каналы АЦП (вывод):**

| Что | Каналов |
|---|---|
| Mic/Line 1–2, по два пути | 4 |
| Hi-Z 1–2, по два пути | 4 |
| Фоно L/R | 2 |
| Линейные 1–8 | 8 |
| Запасные (R88) | 2 |
| **Всего** | **20 = CS5308P × 2 (16) + CS5304P × 1 (4)** |

## 4. Предложение P73: преобразователи Cirrus Logic Pro

| Узел | Было (P49) | Предлагаю | Факты |
|---|---|---|---|
| АЦП | AKM AK5578 × 2 (2016), 121 дБ, аналог 5 В | **Cirrus CS5308P × 2 + CS5304P × 1** | CS5308P: 8 каналов, 123 дБА, THD+N −110 дБ, TDM, одно питание 3,3 В, QFN-48, статус Active, ≈ 13,6 $ от 1000 шт. ([Cirrus](https://www.cirrus.com/products/cs5308p)); в каталоге DigiKey как новинка ([DigiKey](https://www.digikey.lv/en/products/detail/cirrus-logic-inc/CS5308P-DN/26753129)) |
| ЦАП | AKM AK4458 (2016), 115 дБ | **Cirrus CS4308P × 1** | 8 каналов, 123 дБА, THD+N −115 дБ, дифференциальные выходы 2 В rms, TDM, 3,3 В, Active, ≈ 10,3 $ от 1000 шт. ([Cirrus](https://cirrus.com/products/cs4308p)); линейка вышла 25.06.2024, Focusrite использует её в USB-интерфейсах ([ProSoundWeb](https://www.prosoundweb.com/cirrus-logic-unveils-latest-additions-to-its-family-of-audio-converters/)) |
| Операционные усилители, xcore.ai, ADuM4166, PDM-микрофон | Как в документе 21 | Без изменений | — |
| PGA2500 × 2 | Было | **Убираем** (P74) | — |

**Почему Cirrus (вывод):** линейка новая (2024–2025), значит, проживёт дольше старых AKM; лучше по цифрам (123 дБ против 121 и 115); одно питание 3,3 В вместо отдельных 5 В для аналоговой части — проще плата питания; ±5 В для PGA2500 тоже больше не нужны.

**Честно о наличии:** у DigiKey CS5308P значится как новинка, количество на складе страница мне не показала; цены выше — ориентир Cirrus для партий от 1000 шт., за штуку будет дороже. Образцы Cirrus выдаёт; отладочные платы есть (DC5308P-ADC 430 $, DC4308P-DAC 660 $). AKM остаётся запасным вариантом: AK5578 есть на Mouser (860 шт.), AK4458 — ≈ 2 270 шт.

## 5. P51 после этого

- **Плата управления (RP2350):** фантом 48 В по каналам (плавное включение, при старте выключен), переключатель фоно/линия, ключи выходов, сторож (R86). Аналогового усиления больше нет — нет и шлейфа SPI к предусилителям; хватит нескольких линий управления или расширителя портов.
- **xcore.ai A:** склейка путей и цифровое усиление входов (ручки Gain приходят от панели через вычислитель).

## Открытые вопросы

1. ~~Входы с двумя путями~~ — R117.
2. ~~Преобразователи Cirrus~~ — R116.
3. ~~P51 в упрощённом виде~~ — R118.
4. Склейка путей: калибровка уровня и фазы — первое, что проверяем на макете входа.

Sources: ссылки в тексте.
