MitjaGrecky/Shtuka-druka/docs/ru/21_audio_board.md

# Штука Дрюка: аудиоплата — блок-схема и выбор микросхем

> **Обновление 01.11.2026:** выбор микросхем пересмотрен — см. документ 28: входы Mic/Line и Hi-Z с двумя путями без PGA2500 (P74), преобразователи Cirrus Logic Pro вместо AKM (P73), P51 упрощено.

*31.10.2026. **Факт** — из источника, **вывод** — моя инженерная логика, **решено** — решение пользователя. Основа: R16 (цифровой предусилитель), R37 (8 линейных входов), R64–R67 (выходы, ключи, наушники), R82–R84 (два USB, каналы, 96 кГц), документы 11, 15, 20. Это концепция для макета, не принципиальная схема.*

## 0. Коротко

- **АЦП:** 2 × AKM AK5578 (8 каналов, 121 дБ) = 16 каналов. **ЦАП:** 1 × AKM AK4458 (8 каналов, 115 дБ) = Main, Aux, Наушники 1, Наушники 2.
- **Предусилители микрофона:** 2 × TI PGA2500 (10–65 дБ шагом 1 дБ — ровно «1 щелчок энкодера = 1 дБ»).
- **USB:** 2 × XMOS xcore.ai (R82), порт к внешнему компьютеру — через гальваническую развязку ADuM4166 (480 Мбит/с). Это закрывает вопрос о гуле по земле.
- **Тактирование:** один генератор 24,576 МГц на всё (48 и 96 кГц).
- **Найдено при проверке:** популярный 8-канальный АЦП Cirrus CS5368 снят с производства — поэтому AKM.
- Усиление, фантом и ключи выходов управляются платой управления (RP2350, R85) — там же сторож на случай зависания (R86).

## 1. Требования (из журнала)

| Что | Сколько | Откуда |
|---|---|---|
| Мик/линия (комбо XLR/TRS), цифровое усиление, P48 только на XLR | 2 | R16, R72 |
| Hi-Z 1 МОм | 2 | P12 → R55, документ 11 |
| Фоно MM, RIAA, переключатель фоно/линия, клемма земли | 2 (L/R) | документ 11 |
| Линейные балансные TRS | 8 | R37 |
| Встроенный микрофон | 1 | P12 → R55 |
| Main L/R, Aux L/R: импедансно-балансные, шины ±12 В, ≥ +18 dBu | 4 | R64 |
| RCA — копия Main после громкости | 2 | R23 |
| Наушники ×2: ≥ 4 В на 600 Ом, ≥ 30 мА на 32 Ом, Main/Cue | 4 | R67 |
| Ключи отключения на всех выходах | все | R66 |
| Частота: железо под 96 кГц, работа на 48 кГц | — | R84 |
| USB A (Mini-ITX) и USB B (внешний компьютер, 32 × 16) | 2 | R82, R83 |

## 2. Микросхемы

| Узел | Кандидат | Ключевые параметры (факт) | Почему |
|---|---|---|---|
| АЦП | AKM AK5578 × 2 | 8 каналов, динамический диапазон 121 дБ, S/(N+D) 112 дБ, до 768 кГц, TDM ([DigiKey](https://www.digikey.ph/en/product-highlight/a/akm-semi/ak5578en-32-bit-premium-adc)) | 16 входных каналов двумя корпусами; TDM — меньше проводов |
| ЦАП | AKM AK4458 × 1 | 8 каналов, 115 дБ, THD+N −107 дБ, до 768 кГц, TDM, дифференциальные выходы, питание 3,0–5,5 В аналог ([Utmel](https://www.utmel.com/components/ak4458vn-32-bit-8ch-premium-dac-115db-768khz-48-pin-qfn-akm-dac?id=1261)); у каждого канала цифровой аттенюатор −127,5…0 дБ шагом 0,5 дБ ([драйвер Linux](https://github.com/torvalds/linux/blob/master/sound/soc/codecs/ak4458.c)) | 8 выходов одним корпусом; громкость можно делать в ЦАП |
| Мик-предусилитель | TI PGA2500 × 2 | Активен; 0 и 10–65 дБ шагом 1 дБ; EIN −128 dBu (150 Ом, 30 дБ); THD+N 0,0004 %; ±5 В; последовательное управление цепочкой ([TI](https://ti.com/product/PGA2500)) | Хватает для динамических микрофонов (≈ 60 дБ); шаг совпадает с щелчком энкодера |
| Альтернатива предусилителю | THAT 6261 | 2 канала, −8…+34 дБ шагом 1 дБ, EIN −127 dBu, встроенный драйвер АЦП ([Mouser](https://www.mouser.co.cr/that-6261-6263-6266)) | Максимум 34 дБ мало для динамических микрофонов без дополнительного каскада |
| Hi-Z | TI OPA1642 | JFET-вход, ток смещения 2 пА, шум 5,1 нВ/√Гц, ±2,25…±18 В ([TI](https://www.ti.com/product/OPA1642)) | Вход 1 МОм не нагружает звукосниматель и пьезо |
| Фоно, линейные приёмники, выходные каскады | TI OPA1612 | Шум 1,1 нВ/√Гц, THD+N 0,000015 %, ±2,25…±18 В ([TI](https://www.ti.com/product/OPA1612)) | Малый шум для RIAA (вход ≈ 5 мВ) |
| Наушники | TI OPA1622 × 2 | Выход +145/−130 мА, ±2…±18 В, THD+N ≈ −119 дБ на 32 Ом при 100 мВт ([TI](https://ti.com/product/OPA1622)) | Тянет и 32, и 600 Ом от ±12 В |
| USB | XMOS xcore.ai (XU316) × 2 | Продаётся в рознице ([DigiKey](https://www.digikey.lv/en/products/detail/xmos/XU316-1024-QF60B-C32/16839837)); эталонная прошивка UAC2 (документ 20) | R82 |
| Развязка порта B | ADI ADuM4166 | Low/Full/High speed (480 Мбит/с) с автоопределением, изоляция 5,7 кВ rms, «рекомендован для новых разработок» ([ADI](https://www.analog.com/en/products/adum4166.html)) | Земля компьютера не соединяется с землёй Штуки → нет гула (документ 20) |
| Встроенный микрофон | MEMS с выходом PDM прямо в xcore.ai A | lib_xua принимает PDM-микрофоны напрямую, до 8 штук; частоты по умолчанию 16/32/48 кГц ([XMOS](https://www.xmos.com/documentation/XM-012296-UG/html/doc/rst/sw_pdm.html)) | Без отдельного АЦП; в режиме 96 кГц — проверить |

**Факт о снабжении:** завод AKM в Нобеоке сгорел в октябре 2020 года; AK4458 и AK5578 вернулись в 2022 году, выпускаются на внешней фабрике ([audioXpress](https://audioxpress.com/news/akm-resumes-sample-shipments-of-13-velvet-sound-dac-adc-products)). **Факт:** Cirrus CS5368 (8 каналов, 114 дБ) снят с производства ([Cirrus](https://cirrus.com/products/cs5364-66-68)). **Вывод:** держим запасной вариант АЦП — 4-канальные ESS (ES9842PRO, [ESS](https://www.esstech.com/products-overview/analog-to-digital-converters/)): 4 корпуса вместо 2.

## 3. Раскладка каналов

| АЦП | Каналы 1–8 |
|---|---|
| AK5578 №1 | Мик/Лин 1, Мик/Лин 2, Hi-Z 1, Hi-Z 2, Фоно L, Фоно R, 2 запасных |
| AK5578 №2 | Линейные 1–8 |
| PDM в xcore.ai A | Встроенный микрофон |

| ЦАП AK4458 | Канал |
|---|---|
| 1–2 | Main L/R → балансные выходы и копия на RCA |
| 3–4 | Aux L/R (режим «Педали», R65) |
| 5–6 | Наушники 1 (источник Main или Cue — выбирается в цифре) |
| 7–8 | Наушники 2 |

**Вывод:** у каждых наушников своя пара ЦАП, поэтому «Main/Cue» и отдельная громкость решаются без аналоговых переключателей.

## 4. Тактирование и шина

- Один генератор **24,576 МГц** (кратен 48 и 96 кГц) → MCLK для двух АЦП, ЦАП и обоих xcore.ai. Ведущий шины — xcore.ai A.
- **Расчёт TDM:** 8 каналов × 32 бита × 96 000 = 24,576 Мбит/с на линию — тактовая шины равна MCLK, укладывается. При 48 кГц — 16 каналов на линию с той же частотой.
- Между xcore.ai A и B — несколько линий TDM или межчиповый канал xLINK; выбрать на отладочной плате.
- **Сэмплы 44,1 кГц работают в любом случае:** при загрузке звуковой движок пересчитывает их в частоту проекта, как это делают все DAW (вывод).
- **Второй генератор 22,5792 МГц** нужен, чтобы сам проект и USB-связь с компьютером могли работать на 44,1/88,2 кГц без пересчёта. **Решено (R114):** ставим оба генератора, частота — настройка проекта (по умолчанию 48 кГц, R84).

## 5. Управление и безопасность

| Что | Кто управляет | Как |
|---|---|---|
| Усиление PGA2500 | Плата управления (RP2350) | SPI по внутреннему шлейфу; команда SDP `PREAMP_GAIN` |
| Фантом P48 по каналам | Плата управления | Ключ + плавное нарастание; команда `PHANTOM` |
| Фоно/линия | Плата управления | Реле или ключ; команда `INPUT_MODE` |
| Ключи отключения выходов | Плата управления | Уже в SDP: `MUTE` (документ 19) |
| Громкость Main и наушников | Потенциометры (R13) → панель → вычислитель → аттенюатор AK4458 | 0,5 дБ шаг; если вычислитель завис — сторож платы управления глушит выходы ключами |

**Тихий старт (документ 11):** при включении PGA2500 на минимуме и заглушен, фантом выключен, выходные ключи разомкнуты 1–2 с. Сохранённые значения выставляются, только когда весь тракт готов.

**Почему громкость в ЦАП, а не потенциометр в звуковом тракте (вывод):** потенциометры стоят спереди слева на панели, а аудиоплата сзади. Аналоговый звук по длинному шлейфу через корпус с цифровыми платами ловит наводки. Потенциометр читает панель, значение уходит в аттенюатор ЦАП. Цена — громкость зависит от софта; страховка — сторож и ключи.

## 6. Расчёты

**Выход +18 dBu на импедансно-балансном выходе:** U = 0,775 · 10^(18/20) ≈ 6,16 В rms, пик ≈ 8,7 В (документ 15). OPA1612 от ±12 В — запас до шин ≈ 3 В (по типовому размаху до ≈ 1,5 В от шины на нагрузке 2 кОм; уточнить по даташиту).

**Наушники:**
- 600 Ом, 4 В rms: пик 5,66 В, ток 5,66 / 600 ≈ 9,4 мА — легко.
- 32 Ом, 30 мА rms: напряжение 0,96 В rms, мощность 0,03² · 32 ≈ 28,8 мВт, пиковый ток ≈ 42 мА — меньше 130 мА у OPA1622.

**Фантом:** 2 × 48 В × 10 мА ≈ 0,96 Вт плюс потери преобразователя (документ 11).

**Шум микрофонного входа:** EIN −128 dBu у PGA2500 — на уровне лучших отдельных предусилителей; динамический диапазон АЦП 121 дБ не станет узким местом при усилении от 10 дБ (вывод).

## 7. Питание (концепция)

| Шина | Для чего | Из чего |
|---|---|---|
| ±12 В (тихие) | Операционные усилители, выходы, наушники | Импульсный преобразователь от 12–24 В + линейные стабилизаторы |
| ±5 В | PGA2500 | Линейные от ±12 В |
| +5 В аналог | АЦП и ЦАП (аналоговая часть) | Линейный |
| +3,3 В и ядро xcore.ai | Цифра | Отдельный импульсный |
| +48 В | Фантом | Повышающий преобразователь с фильтром |
| Изолированная сторона порта B | ADuM4166 со стороны компьютера | Питание от VBUS компьютера |

Земли: аналоговая и цифровая соединяются в одной точке у АЦП/ЦАП; светодиоды панели — отдельная ветка (документ 10).

## 8. План проверки

1. Отладочная плата xcore.ai: сколько каналов на чип при 48 и 96 кГц (документ 20).
2. Отладочные платы AK5578 и AK4458 (или макет): шум и уровни с реальными входными каскадами.
3. ADuM4166: проверить, что изоляция не ломает асинхронный режим и не добавляет щелчков.
4. Макет фоно-корректора на OPA1612 против цифровой RIAA (документ 11, раздел 2.5).

## 9. Перепроверка 01.11.2026 (P49, P51)

### 9.1 Есть ли микросхемы в продаже

| Микросхема | Статус и наличие (факт) | Вывод |
|---|---|---|
| AKM AK5578EN (АЦП) | Mouser: 860 шт. на складе, $21,26 за 1 шт., срок под заказ 4 недели; в июне 2026 выходили уведомления только об упаковке ([Mouser](https://www.mouser.com/en/ProductDetail/Asahi-Kasei-Microdevices/AK5578EN?qs=vvQtp7zwQdM7H1iCPGIZ0A%3D%3D)) | Выпускается, есть в рознице |
| AKM AK4458VN (ЦАП) | ≈ 2 270 шт. на складе ([EmbeddedRelated](https://www.embeddedrelated.com/parts/p/AK4458VN)) | Есть в рознице |
| TI PGA2500 (мик-предусилитель) | TI: «Active», в магазине TI сейчас нет; Mouser: 169 шт., $26,06 ([TI](https://ti.com/product/PGA2500/part-details/PGA2500IDBR), [Octopart](https://octopart.com/part/texas-instruments/PGA2500IDB)) | Есть, но запас у дистрибьюторов небольшой — купить сразу на макет и плату |
| THAT 6261 / 6263 / 6266 (альтернатива) | 2 канала, усиление только −8…+34 дБ (шаг 1, 3 или 6 дБ), SPI, выходы для фантома и pad ([Mouser](https://www.mouser.fi/new/that-corporation/that-6261-6263-6266/)) | Для динамического микрофона (≈ 60 дБ) нужен ещё каскад с постоянным усилением. PGA2500 проще: 10–65 дБ одним корпусом |

**Вывод по P49:** состав остаётся прежним. Единственное следствие: АЦП, ЦАП и xcore.ai — в корпусах QFN, руками их не запаять; плату собирать на заводе (JLCPCB, PCBWay) или паять феном/печкой. PGA2500 (SSOP-28) и операционные усилители в SOIC паяются паяльником, кроме OPA1622 (корпус 3 × 3 мм с теплоотводящей площадкой).

### 9.2 Кто управляет предусилителями и фантомом (P51)

| Вариант | Плюсы | Минусы |
|---|---|---|
| **A. Плата управления (RP2350)** — предлагаю | Всё, что может навредить (48 В фантома, ключи выходов), в одном месте со сторожем 500 мс (R86); команды SDP уже есть; тихий старт в одной прошивке; сторож глушит всё сразу | Короткий шлейф SPI до аудиоплаты (10–20 см, медленный SPI — без проблем) |
| B. xcore.ai A на аудиоплате | Провода короче, xcore.ai и так настраивает АЦП и ЦАП | Безопасность смешивается с прошивкой USB-аудио; сторож пришлось бы делать второй раз; правки — в среде XMOS, она сложнее |
| C. Плата панели (RP2350) | Ручки Gain и кнопки P48 на ней | Сигналы через весь корпус к аудиоплате; панель — первое, что меняют при переделке раскладки |

**Вывод по P51:** вариант A. Путь команды: ручка Gain → плата панели → вычислитель → плата управления → SPI → PGA2500. Если вычислитель завис, усиление просто не меняется, а сторож глушит выходы; фантом при включении всегда выключен.

## Открытые вопросы

1. ~~Громкость~~ — решено R87: софтом, потенциометр конечный и однозначный.
2. ~~44,1/88,2 кГц~~ — решено R114: второй генератор ставим.
3. ~~Запасные каналы~~ — решено R88: свободные, назначаемые.
4. P49 (состав микросхем) и P51 (управление через плату управления) — ждут «да» после перепроверки (раздел 9).
