MitjaGrecky/Shtuka-druka/docs/ru/24_panel_buttons_list.md

# Штука Дрюка: какие кнопки нужны (до раскладки)

*31.10.2026. Первый шаг новой панели. Сначала только список органов: что делает, как часто нужен, что заменяет. Где стоит — позже, отдельным шагом. **Факт** — из источника, **вывод** — моя логика, **решено** — решение пользователя.*

## 0. Задача (решено, R95)

Пользователь: «Начни не с дизайна. Начни с нужных кнопок. Добавляй кнопки, если они могут пригодиться и упростят навигацию, чтобы не ползать в меню и не использовать комбинации с Shift».

**Что считаем «комбинацией» и чего не будет (вывод, предложение P58):**
- **Не будет кнопки Shift** и вторых функций по Shift.
- **Не будет вторых функций по двойному нажатию** (как у MPC).
- **Не будет «кодов»** из нескольких кнопок, которые надо помнить.

**Что остаётся допустимым (вывод, предложение P58):**
- **«Действие + цель».** Держишь Duplicate и жмёшь пэд — копируется этот клип; держишь Delete и жмёшь шаг — шаг удалён. Кнопка всегда делает одно и то же, а цель видна и подсвечена. Так работают Push и Maschine.
- **Удержание стрелки — тот же сдвиг, только на 8.** Смысл кнопки не меняется.
- **Касание экрана** — для того, что бывает редко.

## 1. Как у других (факт)

| Устройство | Что сделали с кнопками | Источник |
|---|---|---|
| Maschine MK3 | Самые частые функции вынесли с Shift на отдельные кнопки: «вместо того чтобы прятаться за Shift, они теперь доступны одним нажатием». Отдельные Note Repeat, Fixed Velocity, Lock, Follow, Tap, Save и Open, кнопки Arranger, Mixer, Browser, Sampler | [Native Instruments](https://www.native-instruments.com/en/products/maschine/production-systems/maschine/whats-new-in-mk3/) |
| MPC Live III | Почти у каждой кнопки вторая функция — через Shift или двойное нажатие. Обозреватель хвалит отдельные кнопки режимов, но жалуется: нет отдельной Clip Stop, нужны модификаторы Copy и Erase для клипов, интерфейс «фрагментированный» | [Sound On Sound](https://www.soundonsound.com/reviews/akai-mpc-live-iii) |
| Synthstrom Deluge | Критика: секвенсор держится на «куче безумных неподписанных комбинаций, как коды Konami», которые меняются от режима к режиму; часть функций доступна только через сочетания | [Sean Luke, GMU](https://people.cs.gmu.edu/~sean/projects/synth/deluge.html) |
| Push 3 | Отдельные Play, Record, Fixed Length, Metronome, Tap, Capture, Undo, Delete, Duplicate, Quantize, New, Mute, Solo, Session/Note, Device, Mix, Clip; Shift всё же есть | документ 22 |
| Launchpad Pro MK3 | Ряд «что делают кнопки дорожек»: Record Arm, Mute, Solo, Volume, Pan, Sends, Device, Stop Clip | документ 22 |

**Вывод:** лучшие отзывы получают отдельные кнопки для частого; худшие — сочетания, которые надо помнить. Наш список строим как Maschine MK3, только без Shift совсем.

## 2. Список по сценариям работы

Частота: **постоянно** — во время игры всё время; **часто** — десятки раз за сессию; **иногда** — несколько раз; **редко** — при настройке. «В долю» — нажатие должно попасть в ритм.

### 2.1 Транспорт и время (левая рука)

| Надпись | Что делает | Как часто | Что заменяет у других |
|---|---|---|---|
| ● Rec | Запись в клип выбранной дорожки (поверх петли) | часто, в долю | — |
| ▶ Play | Старт | часто, в долю | — |
| ■ Stop | Стоп | часто, в долю | Второе нажатие Stop «в начало» (двойное нажатие) |
| Restart | Играть с начала | иногда, в долю | Shift + Play / двойной Stop |
| Metronome | Метроном вкл/выкл | иногда | Shift + Tap |
| Tap | Темп постукиванием | иногда, в долю | — |
| Tempo (ручка) | Темп точно | иногда | Меню |
| Swing (ручка) | Свинг | редко | Меню или Shift + ручка |

### 2.2 Добыча звука — ядро концепции (левая рука)

| Надпись | Что делает | Как часто | Что заменяет |
|---|---|---|---|
| Capture | Забрать последние секунды — и звук со входов, и сыгранные на пэдах ноты (как Capture у Push 3 и Skip Back у SP-404) | часто | Ручная запись «на всякий случай» |
| Resample | Записать выход дорожки или мастера в новый сэмпл (бывший Freeze) | иногда | Меню маршрутизации + запись |

### 2.3 Правка (левая рука; «действие + цель»)

| Надпись | Что делает | Как часто | Что заменяет |
|---|---|---|---|
| Undo | Отменить | часто | — |
| Redo | Вернуть отменённое | иногда | Shift + Undo |
| Duplicate | Держать + источник + куда: клип, сцена, шаги, дорожка | часто | Copy/Paste через меню |
| Delete | Держать + цель: клип, шаг, ноты пэда на ходу, дорожка; Delete + касание ручки — значение по умолчанию | часто | Erase, Clear, Shift + ручка |
| Quantize | Выровнять выбранное по сетке | иногда | Меню |
| Double | Удвоить длину петли с содержимым (как Push) | иногда | Меню |
| New | Новый пустой клип в дорожке или новая сцена из того, что играет | иногда | Меню |
| Length | Длина петли до записи: 1, 2, 4, 8 тактов (выбор на экране) | иногда | Fixed Length у Push |
| Automate | Запись движений ручек вкл/выкл — чтобы не записать случайно | иногда | Shift + Rec |

### 2.4 Сетка: что делают пэды (у сетки)

| Надпись | Что делает | Как часто | Что заменяет |
|---|---|---|---|
| Clips | Клипы: строки — дорожки, столбцы — сцены | часто | — |
| Steps | Шаги: строки — дорожки, столбцы — шаги, как у драм-машины | часто | — |
| Notes | Играть нотами (у ударных — пэдами набора) | часто | — |
| Chords | Аккорды в ладу на пэдах (как Chord у Launchpad Pro) | иногда | Нет у многих |
| Touch FX | Пэды — эффекты в реальном времени: повтор, срез, фильтр | иногда | Shift-режимы |
| Scale | Выбрать лад и тонику для Notes и Chords (на экране) | иногда | Меню |
| Repeat | Держать — повтор нот при игре (Note Repeat); шаг на экране | часто | — |
| Accent | Все удары на полную силу вкл/выкл (Fixed Velocity у Maschine) | иногда | Меню |
| ▲ ▼ ◄ ► | Сдвиг окна сетки на строку или столбец; удержание — на 8 | часто | — |

### 2.5 Дорожки — у каждой строки свои (8 строк)

| Надпись | Что делает | Как часто | Что заменяет |
|---|---|---|---|
| Select ×8 | Выбрать дорожку — экран и ручки показывают её | постоянно | — |
| Mute ×8 | Заглушить дорожку одним нажатием | постоянно, в долю | Режим Mute над кнопками дорожек |
| Solo ×8 | Соло дорожки | иногда | Режим Solo |
| Arm ×8 | Готовность к записи входа | иногда | Режим Arm |
| Level ×8 (ручка) | Громкость дорожки | часто | — |

Пустой пэд в строке в режиме Clips останавливает клип этой дорожки, как пустая ячейка в Ableton.

### 2.6 Сцены

| Надпись | Что делает | Как часто | Что заменяет |
|---|---|---|---|
| Scene 1–8 | Запустить сцену (в режиме Steps — страница шагов) | часто, в долю | — |
| Stop All | Остановить все клипы в конце такта | иногда | Shift + Stop; у MPC Live III отдельной кнопки нет — жалоба обозревателя |

### 2.7 Экран: что видно и что крутят 8 ручек (правая рука)

| Надпись | Что на экране | Как часто | Что заменяет |
|---|---|---|---|
| Sound | Источник выбранной дорожки: синтез, сэмпл, вход | часто | — |
| Effects | Фильтр, слот 1, слот 2, посылы A–D | часто | — |
| Mod | Модуляция: LFO, огибающие, кто чем управляет (синтез важнее пэдов, R5) | иногда | Глубокое меню |
| Mixer | Все дорожки: панорама, посылы, уровни | часто | — |
| Sampler | Захваченное и сэмплы: обрезка, нарезка, вейвтейбл | часто | — |
| Song | Сцены, аранжировка, мини-карта всех дорожек | иногда | — |
| Inputs | Все ≈ 14 входов: уровень, мониторинг, на какую дорожку | иногда | Кнопка Input из v4 |
| Browser | Сэмплы, пресеты, избранное | часто | — |
| Page ◄ ► | Следующая и предыдущая страница внутри экрана, если параметров больше 8 | часто | Касание вкладок или меню |
| 8 ручек | Параметры текущей страницы; касание — показать значение | постоянно | — |
| Колесо (с нажатием) | Листать и выбирать на экране, нажатие — OK | часто | — |
| Back | Шаг назад, отмена | часто | — |

### 2.8 Игра вживую (правая рука)

| Надпись | Что делает | Как часто |
|---|---|---|
| Filter (ручка) | Фильтр на мастере, всегда одна функция | часто |
| FX Mix (ручка) | Глубина посылов на эффекты | часто |
| Кроссфейдер | Смешать сцену A и сцену B | иногда |
| Scene A, Scene B | Держать + сцена — назначить сторону кроссфейдера | иногда |
| Сенсорная полоса под пэдами | Notes, Chords — модуляция; Clips, Steps — прокрутка вправо-влево; Touch FX — глубина эффекта (R105) | часто |

### 2.9 Уровни (блок «Уровни», R94)

| Надпись | Что делает | Как часто |
|---|---|---|
| Main (потенциометр) | Громкость мониторов | редко, но аварийно |
| Phones 1, Phones 2 (потенциометры) | Громкость каждого из двух выходов наушников (R22) — отдельные, чтобы играть вдвоём | иногда |
| Cue Mix (потенциометр) | В наушниках: Main ↔ Cue | редко |
| Gain 1, Gain 2 (ручки) | Усиление комбо-входов | редко |
| P48 1, P48 2 | Фантомное питание, защищены от случайного нажатия | редко |
| Индикаторы L / R | Уровень мастера в стерео | всегда видны |
| Индикаторы перегруза входов | Возле Gain | всегда видны |

### 2.10 Система

| Надпись | Что делает | Как часто | Что заменяет |
|---|---|---|---|
| Save | Сохранить проект | иногда | — |
| Project | Открыть, создать, экспортировать проект | редко | Меню File |
| Settings | Настройки устройства: MIDI, CV, клок, экран | редко | Меню |
~~| Help |~~ — убрана (R99): «Help тоже будто бы незачем».
~~| Panic |~~ — убрана (R99). Это была кнопка «снять зависшие ноты»: если внешний синт не получил «отпусти ноту» (выдернули кабель, сбой), нота звучит бесконечно. Вместо кнопки (P63): Stop всегда отпускает все ноты, которые Штука включила на выходах MIDI и CV; на крайний случай — пункт «All Notes Off» в Settings.
| Power | Питание, удержание 2 с | редко | — |
| Гнездо USB-A и SD с индикатором записи | Носители (R81) | иногда | — |

## 3. Что сознательно оставляем экрану

Отсчёт перед записью, следование экрана за курсором, детали лада, экспорт, настройки MIDI, CV и клока, режим «заменять или дописывать» при записи. Это настраивают раз за проект или реже, а кнопка ради них заняла бы место у частого.

## 4. Итог

| Группа | Кнопок | Ручек и другого |
|---|---|---|
| Транспорт и время | 6 | 2 ручки |
| Добыча звука | 2 | — |
| Правка | 9 | — |
| Сетка | 8 + 4 стрелки | — |
| Дорожки | 32 | 8 ручек |
| Сцены | 9 | — |
| Экран | 8 + 2 + Back | 8 ручек, колесо |
| Игра вживую | 2 | 2 ручки, кроссфейдер |
| Уровни | 2 | 4 потенциометра, 2 ручки, индикаторы |
| Система | 6 | гнездо USB и SD |
| **Всего (4 кнопки у строки)** | **91** | **≈ 26 ручек и потенциометров, колесо, кроссфейдер, 64 пэда** |

**После P60 и R99:** у строки Select и Mute, без Panic и Help — **75 кнопок**. Для сравнения: в макете v4 было 45 кнопок. Самая большая прибавка — 32 кнопки дорожек: Mute, Solo, Arm и Select у каждой строки вместо режимов «что делают кнопки дорожек».

## 5. Как этим управлять — концепция в трёх вопросах

В любой момент на панели горят три ответа (вывод):
1. **Какая дорожка?** — горит Select её строки. Экран и ручки говорят про неё.
2. **Что делают пэды?** — горит одна из кнопок Clips, Steps, Notes, Chords, Touch FX.
3. **Что на экране и что крутят 8 ручек?** — горит одна из Sound, Effects, Mod, Mixer, Sampler, Song, Inputs, Browser.

Всё остальное — «одна кнопка — одно действие» (Play, Capture, Undo, Mute…) или «действие + цель» (держать Duplicate и нажать пэд).

| Сценарий | Что жмёшь по шагам |
|---|---|
| Бит с нуля | Select строки 1 → Browser, колесо, загрузить набор → Notes, стучишь → Length, Metronome, Rec, Play → Steps, правка шагов, Delete + пэд → Quantize, Undo, Redo |
| Звук снаружи | Inputs, выбрать вход (он становится дорожкой) → Gain, P48 для микрофона → играешь, Capture забирает последние секунды → Sampler, 8 ручек режут → Notes, играешь кусками |
| Синт и мелодия | Select строки 2 → Sound, 8 ручек, Page ◄ ► → Mod → Scale, Notes, ▲▼ октава → Chords → Rec |
| Живая игра | Clips: пэд запускает клип, пустой пэд останавливает → Scene 1–8, Stop All → Mute у строк → Filter, FX Mix → Repeat, Touch FX → Scene A, Scene B, кроссфейдер |
| Правка | Undo, Redo → Duplicate + клип + пустая ячейка → Delete + пэд, Delete + касание ручки → Double, New → Solo + Select, Arm + Select → Save |
| Сведение | Level у строк → Mixer, 8 ручек → Select + Effects → Resample → Main, Phones 1/2, Cue Mix |

**Решено (R96):** «действие + цель» — нормально (ответ на вопрос 2).

**Вывод отсюда (P60):** раз «действие + цель» допустимо, Solo и Arm могут быть такими действиями: держишь Solo и жмёшь Select строки. У каждой строки тогда остаются только Select и Mute — Mute жмут в долю во время игры, поэтому он отдельный. Кнопок становится 77 вместо 91, колонка дорожек уже ≈ на 40 мм.

## 6. Как работает Rec (предложение P61)

**Как у Push 3 (факт, [руководство Ableton](https://www.ableton.com/en/push/manual/)):**
- «В режиме Note дорожки MIDI автоматически готовы к записи, когда выбраны». В режиме Session дорожки надо готовить вручную: двойным нажатием кнопки дорожки или «держать Record + кнопка дорожки».
- Record по кругу: первое нажатие — запись, второе — запись стоп, клип играет, третье — дозапись (overdub), дальше переключает «играть / дописывать».
- С Fixed Length создаётся пустой клип нужной длины; запись идёт с его начала.
- Capture забирает сыгранное без нажатия Record — в новый клип, и он сразу играет.

**У нас (вывод):**

| Что | Как | Отличие от Push |
|---|---|---|
| Какая дорожка пишется | Выбранная (горит Select). Синт, сэмплер и MIDI-дорожка готовы к записи сами, как в Note у Push | — |
| Входы (TD-3, микрофон, другие синты) | Готовятся вручную: держать Arm и нажать Select нужных строк — можно сразу несколько, чтобы записать джем с нескольких синтов на свои дорожки | У Push — двойное нажатие; у нас двойных нажатий нет (R96) |
| Куда пишется | В ячейку выбранной дорожки в текущем столбце: пустая — новый клип, с клипом — дозапись поверх | — |
| Нажатия Rec | Два состояния: включил — пишет, выключил — играет. Если в клипе уже что-то есть, запись дописывает поверх, не стирая. Режим «заменять» — в настройках | У Push три состояния по кругу (запись → стоп → дозапись) |
| Длина | Length задаёт длину заранее: запись идёт ровно столько тактов и дальше петля играет; Rec снова — дозапись | Как Fixed Length |
| В конкретную ячейку | Держать Rec и нажать пустой пэд в Clips — запись сразу туда | Как «действие + цель» |
| Не записал заранее | Capture — последние секунды и ноты становятся клипом | Как Capture у Push, плюс звук со входов |
| Видно, что пишется | Select готовых строк красный; во время записи мигает | — |

## Открытые вопросы

1. **Дорожки:** у строки Select и Mute, а Solo и Arm — «действие + цель» (P60, 77 кнопок)? Или всё же 4 кнопки у строки (91)?
2. ~~«Действие + цель»~~ — решено: нормально (R96).
3. Логика Rec из раздела 6 (P61) — подходит?
4. Необязательные (Chords, Accent, Length, Automate, Page ◄ ►) — решать после того, как концепция станет понятна по сценариям; пока оставляем все.
