MitjaGrecky/Shtuka-druka/docs/ru/08_interaction_model.md

# Штука Дрюка: модель управления (кнопки, экран, светодиоды)

> **Обновление 31.10.2026:** четыре страницы-глагола заменены двумя осями — режимы сетки и режимы экрана (R94, документ 23).

*Обновление 28.10.2026: решено 16+ дорожек и RGB везде. Правило «8 дорожек = 8 строк…» и расчёт светодиодов на WS2812 ниже устарели. Варианты компоновки дорожек — в документе 09, подсветка — в 10, текущие решения — в журнале 14. Эффекты решено сделать назначаемыми: «фиксированная цепочка» ниже заменена на «места фиксированные, содержимое назначаемое» — документ 16.*

*28.10.2026. Развивает макет v2 (документ 07) и вытекает из исследования (документ 06). Это предложение для обсуждения: пометка «вывод» означает мою логику, не данные из источников. Названия страниц и количество дорожек пока рабочие.*

## Идея в одной фразе

Любой звук (генератор, вейвтейбл, сэмпл, живой вход) живёт на дорожке и проходит одну и ту же цепочку обработки. Любую дорожку в любой момент можно заморозить в материал, а материал снова сделать источником. Сцена — снимок всех настроек, песня — путь между снимками.

Синтезатор даёт источники и ручки, сэмплер даёт материал и заморозку, DAW даёт дорожки, сцены и автоматизацию. Но это один объект, а не три режима.

## Чем это не клон (вывод)

| Устройство | Центральная идея | Наша идея |
|---|---|---|
| Akai Force / Ableton Push | Сетка клипов: дорожки × сцены | Сетка меняет смысл по странице; клипы только на странице «Собрать» |
| Novation Circuit | Фиксированные дорожки: два синтеза и четыре сэмпла | Любая из 8 дорожек может быть любым источником, включая живой вход |
| MPC | Пэды и программы сэмплов | Пэды лишь один из видов игры; материал берётся из захвата и заморозки |
| Elektron Octatrack | Сцены и кроссфейдер, но сложный интерфейс | Те же сцены, но с подписями, кольцами и без скрытых комбинаций |

Особенности: (1) вход — полноценная дорожка; (2) две разные заморозки; (3) сцены/кроссфейдер как основа песни, а не дополнение; (4) единая цепочка обработки для всех источников.

## Правила логики

1. **Одна модель дорожки.** 8 дорожек = 8 строк сетки = 8 ручек уровня = 8 кнопок дорожек. Тип источника: генератор, вейвтейбл, сэмпл, вход, ресэмплинг.
2. **Фиксированная цепочка.** Источник → фильтр → драйв → дилей → реверб → выход. Порядок один, чтобы ручки всегда были на своих местах. Свободный роутинг (модульный) возможен позже.
3. **Вход такая же дорожка.** Микрофон, линия, фоно и гитара проходят ту же цепочку; звук идёт вживую и одновременно пишется в буфер.
4. **Две заморозки.** Capture берёт звук снаружи (из выбранного входа). Freeze берёт звук изнутри (выход выбранной дорожки вместе с эффектами). Результат: сэмпл, цикл или заготовка вейвтейбла.
5. **Сцена — снимок.** Все параметры и клипы. Кроссфейдер плавно смешивает сцену A и сцену B. Песня — список сцен со временем перехода.
6. **Страница меняет всё сразу.** Экран, энкодеры, сетка и подсветка меняются вместе. Не бывает частичных режимов.
7. **Нет скрытых комбинаций.** Единственный модификатор — удержание кнопки, а экран всегда показывает, что изменится.

## Четыре страницы (кнопки-глаголы)

| Страница | Вопрос | Экран | Энкодеры 1–8 | Сетка 8×8 |
|---|---|---|---|---|
| **Взять** | Откуда звук? | Источник дорожки: волна или вход, буфер, нарезка | Параметры источника (старт, длина, питч, позиция в вейвтейбле) | Нарезки, слоты материала, ноты |
| **Лепить** | Как он звучит? | Цепочка дорожки, отклик блока | Параметры выбранного блока (восемь колонок на экране) | Ноты для прослушивания |
| **Играть** | Что делаем сейчас? | Сцены A/B, уровни, петля | Макро: скорость, питч, глубина эффектов | Пэды, панель эффектов, сцены в верхнем ряду |
| **Собрать** | Как это держится во времени? | Шаги или таймлайн сцен | Параметры шага (вероятность, микротайминг, длина, параметр-локи) | 64 шага выбранной дорожки или клипы |

## Кнопки

| Группа | Кнопки | Подсветка |
|---|---|---|
| Страницы (4, крупные) | Взять, Лепить, Играть, Собрать | Цвет типа выбранной дорожки; активная яркая, остальные тусклые |
| Захват | Capture, Freeze | Тусклая: готов; пульс: идёт запись; мигает быстро: перегруз входа |
| Выбор входа (5) | Микрофон, Линия, Фоно, Гитара, Внутренний | Горит выбранный; рядом индикатор уровня |
| Транспорт (3) | Play, Stop, Rec | Play зелёная при ходе, Rec красная при записи |
| Правка (2) | Undo, Save | Save мигает при несохранённых изменениях |
| Дорожки (8, справа от сетки) | Выбор дорожки; удержание — заглушить | Яркая: выбрана; пульс в такт сигналу; тусклая: заглушена |
| Сцены (2) | A, B (назначить сцену на край кроссфейдера) | Горит, пока ждёт нажатия на пэд-сцену |
| Колесо | Клик — подтвердить | Без подсветки |

Удержание Capture выбирает длину захвата (4, 8, 16 или 24 с), удержание Freeze выбирает цель (сэмпл, цикл, вейвтейбл). В обоих случаях выбор виден на экране.

Изменения к v2: колонка из 8 кнопок справа от сетки теперь кнопки дорожек (в v2 я назвал их «сценами», это было неточностью); кнопка Commit теперь Freeze; ряд режимов сетки заменён четырьмя страницами; шесть макро-ручек должны быть энкодерами с кольцами, а не потенциометрами, иначе при смене дорожки значение «прыгает».

## Дисплей (10,1″, 1280×800)

Раскладка сверху вниз:

1. **Полоса состояния:** страница, дорожка и тип источника, темп, заполнение буфера, загрузка и питание.
2. **Колонки параметров:** восемь колонок, каждая выровнена с энкодером над экраном. В колонке название, значение и полоска. Глаз не ищет, какая ручка что делает.
3. **Рабочая область:** волна, отклик фильтра, шаги или таймлайн в зависимости от страницы.
4. **Цепочка дорожки:** шесть блоков со стрелками; выбранный подсвечен.

Правила: параметры в реальном времени только руками, сенсор — для выбора, перетаскивания волны и браузера; в одном состоянии не больше восьми значений; текст не мельче 12 пунктов; касание энкодера увеличивает его значение на экране.

## Язык светодиодов

**Цвет = тип источника дорожки** (вывод, один цвет на экране, кольцах, строке сетки и кнопке дорожки):

| Источник | Цвет |
|---|---|
| Генератор | Синий |
| Вейвтейбл | Фиолетовый |
| Сэмпл | Бирюзовый |
| Вход (живой) | Оранжевый |
| Ресэмплинг | Жёлтый |

Кольцо энкодера:

| Состояние | Вид |
|---|---|
| Значение | Дуга от минимума до текущего значения |
| Биполярный параметр | Дуга от центра |
| Значение в сцене B | Белая точка на кольце |
| Модуляция | Дуга движется, вокруг тонкий пунктир |
| Параметр-лок на шаге | Белая дуга |
| Недоступно для этого источника | Тусклое пунктирное кольцо |

Сетка: цвет строки = тип источника; тусклый — пусто; яркий — есть материал; белый — сейчас играет; вспышка — срабатывание.

## Инженерная оценка светодиодов (оценка, проверить по даташиту)

Допущения: адресуемые RGB-светодиоды класса WS2812/SK6812, до 60 мА на светодиод при белом на полную яркость, питание 5 В.

| Элемент | Светодиоды |
|---|---|
| 8 колец энкодеров × 16 | 128 |
| 6 макро-энкодеров × 12 | 72 |
| 8 колец уровня × 12 | 96 |
| Пэды 8×8 | 64 |
| Кнопки (около 36) | 36 |
| **Всего** | **396** |

- Максимум: P = N·I·U = 396 × 0,060 А × 5 В ≈ 119 Вт. Такого не бывает на практике, но прошивка обязана ограничивать яркость.
- Типично при среднем токе 10 мА: P = 396 × 0,010 А × 5 В ≈ 20 Вт, то есть около 4 А по линии 5 В.
- Время кадра: 24 бита × 1,25 мкс = 30 мкс на светодиод; 396 × 30 мкс ≈ 11,9 мс, то есть до 84 кадров в секунду. Для запаса линию данных лучше разбить на 2–3 цепочки.
- Вывод: питание светодиодов нужно закладывать отдельной веткой с лимитом (например, не более 3 А) и заранее проверить влияние на шум аналоговой части.

## Что остаётся неясным

- Цвет по типу источника или цвет по блоку цепочки? Я выбрал первое, второе даёт другую логику.
- 8 дорожек хватит или нужно 16?
- Цепочка фиксированная или свободная?
- Нужна ли отдельная кнопка Menu или хватит экрана?
