MitjaGrecky/Shtuka-druka/docs/ru/17_layout_v4_ergonomics.md

# Штука Дрюка: эргономический аудит и макет v4

> **Обновление 31.10.2026:** принято направление панели v5 (R94) — документ 23. Страницы Grab/Shape/Perform/Arrange, 6 Macro, колесо со стрелками рядом и громкости спереди ниже устарели. Зоны досягаемости и нормы остаются в силе.

*31.10.2026. **Факт** — из источника, **вывод** — моя инженерная логика, **решено** — решение пользователя. Заменяет раскладку верхней панели из документа 13 (раздел 4, макет v3). Задняя панель — документ 13, раздел 3.5.*

## 1. Нормы, по которым проверяем

| Норма | Значение | Источник |
|---|---|---|
| Приоритеты размещения | Частые и важные элементы — в рекомендуемой зоне A, редкие — в B, совсем редкие — в C. Порядок определяют последовательность, частота и важность использования | EN 894-4, 5.2.2, 5.3.1.1 ([iTeh, образец](https://cdn.standards.iteh.ai/samples/31157/d3ae585dd86e43f8bec89d654ab05012/SIST-EN-894-4-2010.pdf)) |
| Зона досягаемости | Лучшая зона для частого ≤ 36 см, допустимая ≤ 51 см | [Silver Lining](https://www.thesilverlining.com/hubfs/LC1533%20Ergo%20in%20Design_Workstation%20Reach%2011-25.pdf) |
| Предел досягаемости (ISO 14738) | 402 мм для 5-го процентиля женщин, 485 мм для 50-го процентиля мужчин | [3DS](https://blog.3ds.com/brands/delmia/the-ergonomic-answer-to-how-far-to-place-an-object/) |
| Обзор экрана сидя | Линия взгляда 15° ниже горизонтали, расстояние до экрана 400–700 мм | EN 894-4, 5.3.1.2 |
| Наклон неподвижного сенсорного экрана | 30–45° от горизонтали | FAA, 6.4.6 ([HFCC](https://hfcc.dot.gov/publications/docs/GeneralGuidance/zz_FAA_GeneralGuidanceDoc_Chapter_06_Section_04.html)) |
| Шаг ручек (центр–центр) | Минимум 25 мм, лучше 51 мм | FAA, табл. 6.4.1.1 |
| Шаг кнопок | По горизонтали ≥ 19 мм, по вертикали ≥ 16 мм | FAA, табл. 6.4.2.1 |
| Ручка и экран | Ручка снизу или справа от экрана: по часовой — курсор вверх или вправо | FAA, 6.4.1 |
| Не закрывать информацию | Органы управления и активные зоны так, чтобы рука не закрывала важное | FAA, 6.4.5–6.4.6 |
| Против ошибок | Взаимное расположение продумано; необратимые действия — с защитой | FAA, 6.4.4 |
| Кнопки | Диаметр 12–15 мм под палец, ход 3–10 мм | [Roymech](https://roymech.org/Useful_Tables/Human/Human_controls.html) |
| Ручки | Под пальцы диаметр 10–30 мм; разница диаметров для различения на ощупь ≥ 13 мм | Roymech; FAA 6.1.1.4.6 (документ 13) |

Для музыкальных устройств добавляем правило: **одна рука — одна роль** (вывод). Пользователь правша (R17): правая рука на значениях и навигации, левая на времени (транспорт, захват, правка); пэды играют обе руки.

## 2. Аудит макета v3

**Допущение:** расстояние меряем от передней кромки устройства; устройство стоит у края стола. Глубина v3 ≈ 480 мм.

| Проблема v3 | Где | Почему плохо | Норма |
|---|---|---|---|
| Колесо навигации у экрана | ≈ 400 мм от края | Самый частый орган управления — у предела досягаемости (402 мм) | EN 894-4: частое — в зону A |
| Блок «Захват» у экрана | ≈ 400 мм | Ядро концепции (R9) — далеко, на вытянутой руке | То же |
| Блок «Захват» перегружен | 11 элементов на ≈ 110 × 130 мм | Важное (Capture) рядом с редким (фантом, усиление) | Группировка по частоте |
| 5 кнопок источника | Блок «Захват» | После R37 входов около 14, 5 кнопок их уже не покрывают | Логика: «вход — тоже дорожка» (P2) |
| Нет копирования, удаления, темпа | — | Частые операции уходят в меню | Частота использования |
| Справа от экрана только колесо | Дальний правый угол | После переноса колеса — пустое пятно | Просьба пользователя |
| Передняя полоса под сеткой | 515 × 45 мм | Пустая, кроме громкостей слева | То же |

## 3. Макет v4

### 3.1 Принцип

- **По глубине — по частоте:** у пользователя то, что играют руками; у экрана то, что настраивают один раз.
- **По ширине — по роли руки:** слева время (транспорт, захват, правка), по центру игра (сетка, дорожки), справа значения и навигация.
- **Линия управления экраном:** страницы, 8 энкодеров параметров и колесо стоят в одну линию под экраном. Страница меняет то, что крутят энкодеры, а колесо листает экран.
- **Симметрия с задней панелью:** слева у экрана входы (сзади слева — гнёзда входов), справа у экрана выходной индикатор и система (сзади справа — питание и управление).

### 3.2 Раскладка (вид сверху; x — от левого края, y — от передней кромки, мм)

| Группа | Состав | x | y (центр) | Зона | Рука |
|---|---|---|---|---|---|
| Громкости | Мониторы, Наушники, Cue/Mix (потенциометры, другая форма колпачка); гнёзда наушников на переднем торце под ними | 15–115 | ≈ 38 | A | Левая, вслепую |
| Транспорт | Rec, Play, Stop, Tap (удержание Tap — метроном, видно на экране) | 15–115 | ≈ 88 | A | Левая |
| Захват | Capture, Freeze — крупные, 28 мм | 15–115 | ≈ 162 | A | Левая |
| Правка | Undo, Копия, Удалить, Save | 15–115 | ≈ 248 | A | Левая |
| Страницы | Взять, Лепить, Играть, Собрать — в линию с энкодерами | 15–125 | ≈ 318 | A | Левая |
| Входы | Вход (список входов на экране), 2 энкодера усиления, 2 P48 с индикаторами, индикаторы перегруза | 15–135 | ≈ 405 | B | Редко |
| Сцены | 8 кнопок под сеткой | 125–325 | ≈ 75 | A | Обе |
| Сетка | 8 × 8, шаг 25 мм | 125–325 | ≈ 190 | A | Обе |
| Дорожки | 8 кнопок + 8 энкодеров уровня по строкам, внизу Mute и Solo | 330–385 | ≈ 175 | A | Правая |
| Параметры | 8 энкодеров, шаг 30 мм, прямо под экраном | 135–375 | ≈ 318 | A | Правая |
| Перформанс | Кроссфейдер у передней кромки, кнопки A/B | 395–500 | ≈ 55 | A | Правая |
| Макро | 6 энкодеров, 3 × 2, шаг 32 мм | 395–500 | ≈ 145 | A | Правая |
| Навигация | Колесо ⌀ 45 мм, Назад, 4 стрелки | 395–500 | ≈ 262 | A | Правая |
| Система | Выходной индикатор Main, Браузер, Настройки, Питание (утоплено, удержание 2 с), углубление с USB-A и SD для флешек и индикатором записи (R81) | 375–500 | ≈ 405 | B | Редко |
| Передняя полоса под сеткой | Подставка под запястья; место под сенсорную полосу второй фазы (P41) | 125–385 | ≈ 38 | — | — |
| Передний торец справа | Пусто: SD и USB-A перенесены в блок System (R81) | 395–500 | торец | — | — |

Габариты: ≈ 515 × 480 мм; после проверки объёма корпус стал 515 × 500 мм, высота 68 мм спереди и 143 мм сзади, плюс съёмная подставка под запястья 70 мм (R44, документ 13, раздел 3.6). Расстояния от передней кромки корпуса не изменились.

### 3.3 Что изменилось относительно v3

| Что | v3 | v4 | Почему |
|---|---|---|---|
| Колесо навигации | У экрана, ≈ 400 мм | Справа на уровне энкодеров, ≈ 262 мм | Самое частое — в зону A |
| Capture, Freeze | У экрана, ≈ 400 мм | Слева посередине, ≈ 162 мм | Ядро концепции — под левую руку |
| 5 кнопок источника | Блок «Захват» | Одна кнопка «Вход» и список на экране; вход — дорожка (P2) | После R37 входов около 14 |
| Усиление и фантом | В блоке «Захват» | Слева у экрана, зона B | Настраивают один раз; индикаторы перегруза у экрана (≤ 15° от взгляда) |
| Правка | Только Undo, Save справа | Undo, Копия, Удалить, Save слева | Частые операции без меню; левая рука правит, правая выбирает |
| Tap | Нет | В транспорте | Темп — частая операция |
| Справа от экрана | Колесо | Выходной индикатор, Браузер, Настройки, Питание | Редкое — далеко; питание защищено от случайного нажатия |
| Передняя полоса | Пустая | Подставка под запястья + место под полосу второй фазы | Пустота стала функцией |

### 3.4 Проверка по нормам (вывод)

- **Досягаемость:** все частые группы ≤ 330 мм от края (зона A, ≤ 36 см). В зоне B (≈ 405 мм) только «Входы» и «Система» — редкие.
- **Плотность:** по краевым колонкам 0,2–0,8 элемента на 1000 мм², игровая зона (сетка, дорожки, сцены) 1,3–1,6. Плотно только там, где это сетка по замыслу. Левая колонка — 22 элемента, правая — 18: баланс.
- **Шаги:** энкодеры параметров 30 мм, макро 32 мм (≥ 25); энкодеры дорожек 25 мм — ровно минимум, это цена совпадения со строками сетки; кнопки страниц 22 мм, сцен 25 мм (≥ 19).
- **Различение на ощупь:** колесо ⌀ 45 мм против колпачков энкодеров ≈ 18 мм (разница ≥ 13 мм); громкости — другой формы.
- **Экран:** наклон 30° совпадает с нормой 30–45°; до глаз ≈ 450–600 мм (норма 400–700).
- **Рука не закрывает экран:** всё управление ниже или сбоку от экрана.
- **Направление колеса:** по FAA ручка справа от экрана при вращении по часовой двигает курсор вверх. В музыкальных списках «по часовой» обычно значит «следующий», то есть вниз. Решение: по умолчанию по часовой — вниз по дорожкам и вправо по времени, направление переключается в настройках.

### 3.5 Подсчёт для v4

| Что | v3 | v4 |
|---|---|---|
| Энкодеры | 25 | 25 (8 параметров, 6 макро, 8 уровней, колесо, 2 усиления) |
| Потенциометры | 3 | 3 |
| Пэды | 64 | 64 |
| Кнопки | 43 | 45: страницы 4, захват 2, Вход 1, транспорт 4, правка 4, A/B 2, навигация 5, дорожки 8, Mute/Solo 2, сцены 8, P48 2, Браузер, Настройки, Питание |
| Ползунок | 1 | 1 |

RGB-светодиодов станет на несколько больше, чем ≈ 427 (документ 10); пересчитать при разводке.

## 4. Ограничения

- Полные тексты EN 894-4, ISO 14738 и MIL-STD-1472 платные; разделы о группировке (EN 894-4, 5.4) в доступном образце отсутствуют. Использованы открытые выдержки.
- Расстояния до пользователя приблизительные: зависят от стола, стула и роста. Проверить на картонном макете в натуральную величину.

## Решено (31.10.2026)

1. Разделение «левая рука — время, правая — значения» — да (R41).
2. Копия и Удалить — отдельные кнопки (R42).
3. Картонный макет 1:1 перед платами — делаем (R43).
