MitjaGrecky/Shtuka-druka/docs/ru/22_buttons_navigation_research.md

# Штука Дрюка: кнопки и навигация — как у других и что непонятно у нас

*31.10.2026. Исследование без изменений в макете (просьба пользователя: «в этот раз не вносим изменения, а глубоко изучаем эргономику и логичность кнопок»). **Факт** — из источника, **вывод** — моя логика.*

## 0. Что сказал пользователь

- Большая часть кнопок макета v4 «не даёт никакой информации взаимодействия»; не видно банальных Старт/Стоп/Rec. Push и любая MIDI-клавиатура понятнее.
- Блоки понятны, но в блок System могли бы попасть громкости и гейны, а также переключение каналов, если оно нужно.
- Индикатор уровня один, а работаем в стерео: нужны два (L/R мастера). Остальные уровни — на экране.
- Часть идей — «гибриды Электронов и прочих зверей», не все знакомы. «Потерялся в навигации».

## 1. Как устроены известные устройства

| Устройство | Группы кнопок | Подписи | Навигация | Источник |
|---|---|---|---|---|
| NI Maschine MK3 / Maschine+ | Слева сверху блок «Control» (2 × 6): Channel, Plug-In, Arranger, Mixer, Browser, Sampling, Page ◄ ►, File, Settings, Auto, Macro. Под ним блок «Edit»: 4-D энкодер (крутится и наклоняется в 4 стороны) + Volume, Swing, Tempo. **Транспорт — внизу слева, рядом с пэдами, 2 ряда по 4:** Restart, Erase, Tap, Follow / **Play, Rec, Stop, Shift**. Справа колонка режимов пэдов: Scene, Pattern, Events, Variation, Duplicate, Select, Solo, Mute | Текст; второе действие (через Shift) — в квадратных скобках на той же кнопке | Кнопки-режимы называются **по тому, что откроется** (Mixer, Browser, Sampling) | [NI](https://docs.native-instruments.com/online-guides/maschine-accessibility/en/maschine-hardware-layout) |
| Akai MPC One / Live | Транспорт и запись: Rec, Overdub, Stop, Play, Play Start, Tap Tempo, Erase. Режимы: Track Mute, Next Seq, Step Seq, Sampler, Sample Edit, Program Edit. Почти у каждой кнопки второе действие через Shift | Текст + второе действие под кнопкой | Main (главный экран), Menu (все режимы), колесо | [Akai, MPC One](https://www.manualslib.com/manual/1855574/Akai-Mpc-One.html?page=5) |
| MPC Live III (обзор) | Выделенные кнопки режимов — «хорошая новость»; 16 шаговых кнопок перед пэдами | — | «Навигация в Matrix неуклюжая, через стрелки на экране»; новичок «может растеряться», MPC — как зрелая DAW, где функции добавлялись слоями | [SoS](https://www.soundonsound.com/reviews/akai-mpc-live-iii) |
| Ableton Push 3 | Режимы: Session / Note, Clip, Device, Mix, Add (Browse), Swap, Layout, Scale. Транспорт: Play, Record, Fixed Length, Metronome, Tap Tempo, Capture. Правка: Shift, Undo, Delete, Duplicate, Quantize, New, Select, Mute, Solo. Навигация: D-pad (4 стрелки + центр), джог-колесо; энкодер Volume слева от экрана; Tempo/Swing; кнопки над и под экраном; **Learn — уроки прямо на устройстве** | Текст | Две оси: **что делают пэды** (Session — клипы, Note — ноты) и **что на экране** (Device, Mix, Clip); кнопки «Back» нет | [Ableton](https://www.ableton.com/en/push/manual/), [Magnetic](https://magneticmag.com/2024/01/features-of-the-push-3-you-probably-dont-know/) |
| Novation Launchpad Pro MK3 | Сверху режимы: Session, Note, Chord, Custom, Sequencer. Внизу ряд «что делают кнопки дорожек»: Record Arm, Mute, Solo, Volume, Pan, Sends, Device, Stop Clip; над ним 8 кнопок дорожек. Справа — запуск сцен «>» | Текст; стрелки ▲▼◄►, «>» и [O] — символы; Shift-функции мелким текстом снизу | Стрелки двигают окно сетки | [Novation](https://userguides.novationmusic.com/hc/en-gb/articles/25494530115346-Launchpad-Pro-MK3-interface) |
| Novation Circuit Tracks | Транспорт: Play ▶, Record ●, Shift, Tempo/Swing, Clear, Duplicate, Save/Projects. 8 кнопок дорожек с названиями по сути: Synth 1, Synth 2, MIDI 1, MIDI 2, Drum 1–4. Кнопки видов: Note, Velocity, Gate, Probability, Mixer, FX, Patterns, Preset. Всегда работают Master Filter и Master Volume | Текст, ▶ и ● — символы | Кнопка вида = что увидишь на сетке | [Novation](https://userguides.novationmusic.com/hc/en-gb/articles/25494476280850-Circuit-Tracks-hardware-overview) |
| Elektron Digitakt II | 16 trig-кнопок, Play/Stop/Record, FUNC (оранжевые подписи = второе действие), кнопки страниц параметров (FLTR, FX…), Yes/No, стрелки, 8 энкодеров | Текст и значки (шестерня — настройки, нота — пресеты, волна — сэмплирование) | Комбинации FUNC + кнопка; Record + Play — запись; двойной Stop — полная остановка | [Sweetwater](https://www.sweetwater.com/sweetcare/articles/elektron-digitakt-ii-quickstart-guide/) |
| Akai Force | Сверху экран, транспорт, навигация и режимы, кроссфейдер; снизу сетка клипов 8 × 9; слева колонка режимов пэдов и функций дорожек | — | «Вижу, где я, и легко запускаю другие клипы»; минусы: Copy/Delete не работают с клипами на экране, дублировать сцену — три нажатия | [SoS](https://www.soundonsound.com/reviews/akai-force) |

**Общие факты о значках:**
- Треугольник ▶ (Play), квадрат ■ (Stop) пришли с магнитофонов и стандартизированы ISO и IEC именно потому, что понятны без языка ([AUT](https://www.aut.ac.nz/news/stories/where-do-universal-media-symbols-come-from)).
- Кроме этого, почти все значки неоднозначны; «у значка должна быть видимая текстовая подпись»; «непонятный значок — потерянная функция» ([NN/g](https://www.nngroup.com/articles/icon-usability/)).

## 2. Общий «язык кнопок» (вывод)

| Правило | У кого видно | У нас в v4 |
|---|---|---|
| **Транспорт — отдельная компактная группа с ▶ ■ ● и цветом** | Maschine (внизу слева у пэдов), MPC, Circuit, Push | Есть (Rec, Play, Stop, Tap), но кнопки того же размера и цвета, что и все, мелкие подписи — глаз их не находит |
| **Кнопка режима называется существительным — тем, что откроется** | Mixer, Browser, Sampling (Maschine); Session, Note, Mix, Device (Push); Mixer, FX, Note (Circuit) | Глаголы Grab, Shape, Perform, Arrange — придуманы мной, нигде не встречаются, не говорят, что будет на экране |
| **Две оси: что делают пэды и что на экране** | Push (Session/Note против Device/Mix/Clip); Launchpad (режимы сверху, ряд «что делают кнопки дорожек» снизу) | Одна ось «страница меняет всё сразу» — экран, ручки, сетку, свет. Прост в теории, но непрозрачен: не видно, что делает сетка |
| **Кнопка «домой»** | MPC Main | Нет; есть только Back |
| **Shift и второе действие подписано на кнопке** | Maschine [скобки], Elektron оранжевым, Circuit мелким текстом | Отказались от скрытых комбинаций (документ 08, правило 7) — поэтому кнопок больше |
| **Главная громкость — всегда под рукой** | Circuit Master Volume, Push Volume, Maschine Volume | Есть (Monitor, Phones, Cue/Mix спереди слева) — понятно |
| **Ряд «что делают кнопки дорожек»: Mute, Solo, Rec Arm, Volume…** | Launchpad Pro | Есть Mute и Solo под колонкой дорожек — идея та же, но спрятана |
| **Запуск сцен — колонка справа от сетки** | Launchpad, Push (Scene) | Ряд 8 кнопок под сеткой — непривычно |
| **Темп/Tap рядом с транспортом** | Maschine (Tap в транспорте), Circuit (Tempo/Swing) | Tap есть в транспорте — хорошо |
| **Обучение на устройстве** | Push 3 Learn | Нет |

## 3. Разбор кнопок v4: понятно ли и откуда взялось

| Кнопка | Понятно без объяснений? | Откуда идея | Что не так (вывод) |
|---|---|---|---|
| Rec, Play, Stop, Tap | Да, по смыслу | Все | Не выделены: размер, цвет и значки ▶ ■ ● как у всех |
| Undo, Copy, Delete, Save | Да | Все | — |
| Grab, Shape, Perform, Arrange | **Нет** | Моя модель «четыре страницы-глагола» (документ 08) | Абстрактные слова; не говорят, что откроется |
| Capture | **Нет** | Skip Back у SP-404 MK2 (запись последних секунд игры), Capture у Push 3 (последние сыгранные ноты в клип) | Слово знакомо пользователям Push, но смысл «забрать то, что только что звучало» не очевиден |
| Freeze | **Нет** | Ресэмплинг у Octatrack, Freeze дорожки в DAW | Для неведающего — «заморозить что?» |
| Input | **Нет** | Замена 5 кнопок источника | Неясно, что выбирает |
| Gain 1/2, P48 | Да (для звукорежиссёра) | Звуковые карты | Стоят далеко от громкостей — громкости спереди, гейны у экрана |
| Browser, Menu | Да | Maschine, MPC | — |
| Back | Частично | Телефоны | Нет «домой»; непонятно, куда «назад» |
| Стрелки ▲▼◄► | Да | Launchpad, Push | Что именно двигают (окно сетки) — не видно |
| Колесо | Да | MPC, Force, Push | — |
| Scenes ×8 под сеткой | **Нет** | Force (ряд под сеткой), шаги у MPC | Не подписано, что это сцены; у Push/Launchpad сцены справа |
| 8 кнопок + 8 ручек дорожек справа | Частично | Launchpad (кнопки дорожек), микшер | Непонятно, что ручки — громкость дорожек |
| Mute, Solo | Да | Launchpad | Не видно, что меняют смысл кнопок дорожек |
| 8 ручек под экраном | Да | Push, Maschine | — |
| 6 Macro | **Нет** | Q-Link у MPC, макро у Push | Назначаемые — без подписи на экране бесполезны |
| Кроссфейдер, A/B | Частично | Octatrack (смешивание сцен), диджейские пульты | Для не-диджея: что смешивается? |
| Один индикатор Main | — | — | **Моно-столбик при стерео — ошибка** |
| Monitor, Phones, Cue/Mix | Да | Force, звуковые карты | — |

**Итог (вывод):** понятны кнопки с «общими» словами (Play, Stop, Undo, Browser, Mute). Непонятны кнопки с моими концепциями (Grab/Shape/Perform/Arrange, Capture, Freeze, Input, Macro, сцены под сеткой) — пользователь прав, это «гибриды», и я не объяснил их ни подписью, ни местом.

## 4. Навигация: как устроена у других (вывод по источникам раздела 1)

| Модель | Как | Плюсы | Минусы |
|---|---|---|---|
| **Push: две оси** | Пэды: Session (клипы) / Note (ноты). Экран: Device / Mix / Clip / Browse. Кнопки «назад» нет: нажал другой режим — ушёл туда | Всегда понятно, что делают пэды и что на экране | Нужно помнить два состояния |
| **MPC: дом + список** | Main — главный экран; Menu — все режимы на экране; колесо; режимы ещё и кнопками; Shift | Всегда можно вернуться «домой» | Слои функций — новичок теряется (SoS) |
| **Elektron: страницы + FUNC** | Кнопки страниц параметров, FUNC + кнопка | Компактно, быстро для знающего | Крутая кривая обучения, комбинации |
| **Maschine: режимы-существительные** | Mixer, Browser, Arranger, Sampling…; Page ◄ ►; 4-D энкодер | Название = что увидишь | Много кнопок |
| **v4 (наша): одна ось-страница** | Grab / Shape / Perform / Arrange меняют сразу экран, ручки, сетку, свет; окно сетки двигают стрелки и колесо; Back | Мало состояний | Названия не говорят, что будет; не видно, что делает сетка; нет «домой» |

## 5. Варианты для обсуждения (ничего не меняем)

**A. «Как Push» — две оси, всё названо существительными.**
- Ряд режимов сетки: **Clips** (клипы дорожек × сцены), **Notes** (играть нотами), **Steps** (шаги), **FX** (перформанс-эффекты).
- Ряд экранов: **Sound** (источник и эффекты дорожки), **Mixer**, **Sampler** (захват и нарезка), **Song** (сцены и аранжировка), **Browser**.
- Плюс кнопка **Home**.

**B. «Как MPC» — дом и список.** Home + Menu со списком режимов на экране, колесо выбирает. Кнопок меньше, но больше экрана.

**C. Оставить одну ось, но переименовать.** Grab → **Sampler**, Shape → **Sound**, Perform → **Live**, Arrange → **Song**; добавить Home и надпись на экране «что сейчас делает сетка».

**По частным пожеланиям пользователя (вывод):**
- **Транспорт:** крупные кнопки с ▶ ■ ● и цветом (зелёный Play, красный Rec), отдельной группой, которую видно с первого взгляда.
- **Индикаторы:** два столбика L/R мастера; остальные уровни — на экране.
- **Громкости и гейны вместе:** блок «Уровни» — Monitor, Phones, Cue/Mix, Gain 1/2, P48 и, при необходимости, выбор входа. Сейчас громкости спереди, гейны у экрана.
- **Capture/Freeze:** подписать по смыслу: «Last 30s» / «Resample» или «Grab» / «Bounce» — обсудить.
- **Сцены:** колонка справа от сетки, как у Launchpad и Push, с подписью «Scenes».
- **Learn:** подсказка на экране при удержании любой кнопки — что она делает (идея Push 3 Learn).

## Открытые вопросы

1. Какая модель навигации ближе: A (две оси, как Push), B (дом и список, как MPC) или C (одна ось, но понятные названия)?
2. Собирать ли громкости, гейны и выбор входа в один блок «Уровни»?
3. Какие слова на кнопках захвата понятнее тебе: Capture/Freeze, Last 30s/Resample, Grab/Bounce или свои?
