MitjaGrecky/Shtuka-druka/docs/ru/19_panel_protocol.md

# Штука Дрюка: протокол между платами и вычислителем (SDP v0)

*31.10.2026. **Факт** — из источника, **вывод** — моя инженерная логика, **решено** — решение пользователя. Основа: R31 (протокол панели документирован, есть симулятор на ПК), R29 (устройство нельзя «окирпичить»), R36 (вычислитель x86 на Mini-ITX). Код-заготовка: `firmware/protocol/sdp.h` и `tools/sdp.py` в репозитории.*

## 0. Коротко

- Внутри устройства **две платы с микроконтроллерами**, обе подключены к вычислителю по USB через внутренний хаб: **плата панели** (пэды, кнопки, энкодеры, громкости, кроссфейдер, светодиоды) и **плата управления** за задней стенкой (MIDI, CV, синхро, ключи отключения выходов). Аудиоплата — отдельно, по USB Audio Class 2.
- У каждой платы два канала: **стандартный USB MIDI** (совместимость, отладка любым MIDI-монитором) и **свой двоичный протокол SDP** (высокое разрешение, метки времени, кадры подсветки, настройки).
- Оба микроконтроллера — **RP2350**: розничный (R28), с загрузчиком в ПЗУ (R29), 12 программируемых блоков ввода-вывода для лишних UART и опроса кнопок.
- Задержка от удара по пэду до звука по расчёту ≈ 7–8 мс, разброс ≤ 0,1 мс — в пределах нормы 10 мс и 1 мс.
- **Найдена проблема:** плата Mini-ITX не умеет быть USB-устройством, поэтому функция «USB-C к компьютеру» (Штука как звуковая карта для ПК, документ 11) требует отдельного решения — см. раздел 9.

## 1. Как это сделано у других

| Устройство | Как панель говорит с компьютером | Источник |
|---|---|---|
| Ableton Push 2 | USB 2.0: два MIDI-порта и отдельный интерфейс для экрана (кадры 960 × 160, 16 бит, 60 кадр/с, массовая передача) | [Push 2 Interface Manual](https://github.com/Ableton/push-interface) |
| Push 2: энкодеры | Относительное значение 7 бит в дополнительном коде, ≈ 210 шагов на оборот | там же |
| Push 2: светодиоды | Note On / CC с номером цвета из палитры; канал MIDI задаёт анимацию (мигание, пульс), чтобы компьютер не слал сообщения непрерывно; ШИМ по умолчанию 100 Гц, максимум 116 Гц | там же |
| Behringer Kick | Свой пакетный протокол по USB: 2 стартовых байта, тип, направление, номер, длина, данные, CRC-8 (полином 0x31, начальное 0xFF). Типы пакетов: система, кнопка, светодиод, пэд, ручки, MIDI, CV, слайдер | [GitHub, ComProtocol](https://github.com/MusicTribeOpenSource/0700-AAM) (AGPL-3.0) |
| Linux | С ядра 6.5 есть драйвер USB MIDI 2.0 (UMP); при необходимости откат на MIDI 1.0 параметром `midi2_enable=0` | [kernel.org](https://docs.kernel.org/6.5/sound/designs/midi-2.0.html) |

**Нормы и физика:**
- Кадр USB Full-Speed — 1 мс, High-Speed — 125 мкс ([Microchip](https://developerhelp.microchip.com/xwiki/bin/view/applications/usb/how-it-works/frame/)).
- Допустимая задержка реакции на жест — до 10 мс, разброс — не больше 1 мс ([Wessel & Wright, NIME](https://arxiv.org/pdf/2010.01570)).
- RP2350: 2 ядра до 150 МГц, 520 КБ ОЗУ, USB 1.1 (устройство и хост), 2 UART, 12 машин состояний PIO ([Tom's Hardware](https://www.tomshardware.com/raspberry-pi/raspberry-pi-pico/whats-inside-the-raspberry-pi-pico-2s-rp2350)).

**Вывод.** Берём лучшее от обоих: от Push — стандартный MIDI как запасной путь и анимации светодиодов на стороне платы; от Kick — компактный пакет с типом и контрольной суммой. Экран по USB, как у Push, нам не нужен: он подключён к вычислителю напрямую (eDP/HDMI).

## 2. Архитектура

| Узел | Что делает | Связь |
|---|---|---|
| Вычислитель (Mini-ITX) | Звуковой движок, интерфейс, экран | USB-хост |
| Внутренний USB-хаб | Панель, плата управления, аудиоплата | USB 2.0 |
| USB-A (флешки и прошивки) | Отдельно, прямо в порт Mini-ITX, не через хаб (R79) | USB |
| Плата панели (RP2350) | 64 пэда (сила удара и давление), 45 кнопок, 25 энкодеров (+ нажатие, касание), 3 громкости, кроссфейдер, ≈ 430 RGB через 4 драйвера IS31FL3741 | USB Full-Speed: MIDI + SDP |
| Плата управления (RP2350) | MIDI DIN 2 вх / 4 вых и TRS 1 вх / 2 вых (R32, R34), 8 CV/Gate (ЦАП 16 бит), 4 CV-входа, блок «Синхро» (R33), ключи отключения выходов (R66) | USB Full-Speed: MIDI + SDP |
| Аудиоплата | АЦП/ЦАП ≈ 16 входов, выходы | USB Audio Class 2, High-Speed |

**Почему две платы, а не одна (вывод):** у панели и у разъёмов разные места в корпусе (верх и задняя стенка, документ 13, раздел 3.6), а длинные шлейфы с MIDI и CV рядом с аудио — источник наводок. Один и тот же микроконтроллер на обеих платах — одна прошивочная база и один загрузчик.

**Почему RP2350 справится (вывод):**
- Плата управления: нужно 9 MIDI-портов (3 входа + 6 выходов). Два аппаратных UART дают 2 входа и 2 выхода, остальные 1 вход + 4 выхода — 5 машин PIO из 12. Ещё PIO — на точные импульсы клока.
- Плата панели: 25 энкодеров × 2 линии + 25 нажатий + 45 кнопок = 120 входов → 15 сдвиговых регистров 74HC165 в цепочке, PIO читает их с частотой 10 кГц. 64 пэда — через аналоговые мультиплексоры на АЦП (опрос 1 кГц × 64 = 64 000 замеров/с).

## 3. Транспорт

| Канал | Что идёт | Зачем |
|---|---|---|
| USB MIDI 1.0 (класс, без драйверов) | Панель: ноты пэдов, CC кнопок, относительные энкодеры как у Push 2. Плата управления: каждый DIN/TRS — отдельный MIDI-порт | Работает «из коробки» в Linux и любой программе; отладка; режим MIDI-контроллера |
| SDP поверх CDC-ACM (виртуальный последовательный порт) | Всё с высоким разрешением, метками времени и настройками | `/dev/ttyACM*` открывается как файл из C++ и Python; драйвер не нужен |
| Загрузчик в ПЗУ RP2350 | Прошивка по USB | R29: перепрошить можно всегда |

**MIDI 2.0** (32-битные значения) — следующая версия: Linux его уже поддерживает (с 6.5), но SDP закрывает высокое разрешение уже сейчас, а MIDI 1.0 надёжнее для совместимости.

## 4. Кадр SDP

| Поле | Байт | Описание |
|---|---|---|
| version | 1 | Версия протокола: старшие 4 бита — major, младшие — minor. Сейчас 0x00 |
| type | 1 | Тип сообщения (раздел 5) |
| seq | 1 | Номер по кругу 0–255; ответ повторяет номер запроса |
| payload | 0–1536 | Данные, little-endian (полный кадр подсветки — 1290 байт) |
| crc16 | 2 | CRC-16/CCITT-FALSE (полином 0x1021, начальное 0xFFFF) по version…payload |

Кадр кодируется **COBS** и заканчивается байтом 0x00. Это значит: потерянный байт портит только один кадр, приёмник сам находит начало следующего по нулю. CRC-16 вместо CRC-8 у Kick, потому что кадры подсветки длинные (до ≈ 1,3 КБ), а CRC-8 для них слабоват (вывод).

## 5. Сообщения

### 5.1 Общие (обе платы)

| type | Направление | Данные | Смысл |
|---|---|---|---|
| 0x01 HELLO | плата → хост | board (1 = панель, 2 = управление), fw major/minor/patch, hw rev, serial (8 байт), capabilities (бит-маска) | При подключении и по запросу. Хост отказывается работать при другом major |
| 0x02 PING | хост → плата | t_host (u64, мкс) | Синхронизация часов |
| 0x03 PONG | плата → хост | t_host (u64), t_board (u32, мкс) | Хост вычисляет смещение и дрейф часов платы |
| 0x04 ACK / 0x05 NACK | плата → хост | seq, код ошибки | Подтверждение команд настройки |
| 0x06 LOG | плата → хост | уровень, текст | Отладка |
| 0x0F HEARTBEAT | хост → плата | — | Каждые 100 мс; нет 500 мс — плата переходит в безопасный режим (раздел 8) |
| 0x7F BOOTLOADER | хост → плата | «магия» 0x53445042 | Перезагрузка в загрузчик ПЗУ |

### 5.2 Панель → хост

| type | Данные | Смысл |
|---|---|---|
| 0x10 PAD | pad (0–63), event (1 = удар, 0 = отпускание), velocity (u16), t (u32, мкс) | Удар с силой 0–65535 вместо 1–127 у MIDI |
| 0x11 PAD_PRESSURE | count, затем count × [pad, pressure u16]; t (u32) | Пакетом раз в 2 мс, только изменившиеся пэды |
| 0x12 BUTTON | id, state (1/0), t | Кнопки |
| 0x13 ENCODER | id, delta (i16, «сырые» отсчёты), t | Ускорение и точный режим считает хост (документ 09, раздел 1.4) — одинаково для всех ручек |
| 0x14 ENC_PUSH | id, state, t | Нажатие энкодера |
| 0x15 ENC_TOUCH | id, state, t | Касание: только показать значение или писать автоматизацию (R12, документ 09) |
| 0x16 ANALOG | id (0–2 громкости, 3 кроссфейдер), value (u16), t | Только при изменении больше порога |

### 5.3 Хост → панель

| type | Данные | Смысл |
|---|---|---|
| 0x20 LED_SET | first (u16), count (u16), count × RGB | Изменить часть светодиодов |
| 0x21 LED_FRAME | все ≈ 430 × RGB | Полный кадр (после подключения и смены страницы) |
| 0x22 LED_ANIM | led (u16), mode (мигание / пульс / вспышка), color2 (RGB), period (мс или доля такта) | Анимация на стороне платы, как у Push 2: мигание в темп без потока сообщений |
| 0x23 LED_BRIGHTNESS | 0–255 | Общая яркость |
| 0x24 TEMPO | bpm (u32, ×1000), phase (u32), t_board (u32) | Чтобы анимации в такт шли от часов платы |
| 0x28 CONFIG_PADS | кривая (табл. 16 точек), порог, чувствительность давления | Настройка пэдов |
| 0x29 CONFIG_ENC | id, отсчётов на оборот, направление | Настройка энкодеров |

### 5.4 Плата управления ↔ хост

| type | Направление | Данные | Смысл |
|---|---|---|---|
| 0x30 CV_SET | хост → плата | ch (0–7), value (u16), t_board (u32) | Значение ЦАП в заданный момент по часам платы (без разброса USB) |
| 0x31 GATE | хост → плата | ch, state, t_board | Gate/триггер |
| 0x32 CV_MODE | хост → плата | ch, режим (CV ±10 В, 1 В/окт, Gate, Trig, Clock), калибровка | R35 |
| 0x33 CV_IN | плата → хост | 4 × u16, t | Входы CV, 1 кГц |
| 0x34 CLOCK_CFG | хост → плата | out (0–1), PPQN или деление, ширина импульса | R33: у каждого клок-выхода своя частота |
| 0x35 TRANSPORT | хост → плата | bpm (×1000), phase, run/stop, t_board | Клок и Reset генерирует плата сама — разброс микросекунды |
| 0x36 CLOCK_IN | плата → хост | event (clock / reset / run), t | Внешний клок с меткой времени |
| 0x37 MIDI_TRS_TYPE | хост → плата | port, тип A/B | R32: переключение из меню |
| 0x38 MUTE | хост → плата | маска выходов, state | Ключи отключения выходов (R66) |
| 0x39 MIDI_OUT_TS | хост → плата | port, t_board, байты MIDI | Отправка MIDI в точный момент (для клока и нот без разброса) |
| 0x3A PREAMP_GAIN | хост → плата | ch, gain (0 или 10–65 дБ) | Усиление PGA2500 на аудиоплате (документ 21) |
| 0x3B PHANTOM | хост → плата | ch, on/off, время нарастания (мс) | Фантом P48 по каналу |
| 0x3C INPUT_MODE | хост → плата | вход, режим | Фоно/линия |
| 0x3D CLIP | плата → хост | ch, пик, t | Перегруз входа — для кольца энкодера и защиты (документ 11) |

## 6. Время и задержка (расчёт)

**Без меток времени:** событие попадает в ближайший блок звука, разброс = период опроса USB Full-Speed = 1 мс — ровно на границе нормы.

**С метками времени:** хост знает момент события по часам платы (синхронизация PING/PONG) и ставит его в нужный отсчёт следующего блока. Разброс определяется точностью синхронизации: ≈ 0,1 мс и лучше (вывод).

**Цепочка «удар по пэду → звук»:**

| Звено | Время | Как получено |
|---|---|---|
| Опрос пэдов | ≤ 1 мс | 1 кГц |
| USB Full-Speed | ≤ 1 мс | кадр 1 мс |
| Ожидание следующего блока | ≤ 2,67 мс | 128 / 48 000 |
| Обработка блока + выходной буфер | 2,67 мс | ещё один блок |
| ЦАП | ≈ 0,5 мс | типичная задержка фильтров ЦАП (оценка) |
| **Итого** | **≈ 7,8 мс в худшем случае** | 1 + 1 + 2,67 + 2,67 + 0,5 |

Это меньше 10 мс. С метками времени задержка постоянная (худший случай), зато без разброса.

## 7. Пропускная способность (расчёт)

- Предел USB Full-Speed для массовой передачи: 19 пакетов × 64 байта за кадр 1 мс = 1 216 000 байт/с ≈ 1,2 МБ/с (вывод из спецификации USB 2.0).
- Полный кадр подсветки: 430 × 3 = 1290 байт + 7 байт заголовка и CRC + COBS (≈ 0,4 %) ≈ 1,3 КБ. При 60 кадр/с: 1,3 × 60 ≈ 78 КБ/с — 6,4 % канала.
- Давление пэдов «в лоб» (64 пэда × 1 кГц × 10 байт) = 640 КБ/с — больше половины канала. Поэтому PAD_PRESSURE идёт пакетом раз в 2 мс и только с изменившимися пэдами: худший случай 64 × 3 байта × 500 = 96 КБ/с.
- Шина I²C к драйверам светодиодов на 1 МГц: полный кадр 1290 байт × 9 бит ≈ 11,6 мс → до ≈ 85 полных кадров/с; на практике меняются доли кадра.

## 8. Безопасность

| Событие | Панель | Плата управления |
|---|---|---|
| Нет HEARTBEAT 500 мс (вычислитель завис) | Светодиоды показывают «нет связи» | Отключает выходы ключами (R66), гасит Gate, держит CV, останавливает клок |
| Пропадание питания | — | Ключи размыкаются мгновенно (R66) |
| Ошибка CRC | Кадр отбрасывается, счётчик ошибок в HELLO/LOG | То же |
| Другая major-версия протокола | Хост показывает «обновите прошивку» и предлагает перепрошить | То же |
| Неудачная прошивка | Загрузчик в ПЗУ остаётся (R29) | То же |

## 9. Найденная проблема: «USB-C к компьютеру»

- **Факт (документ 11):** функция «Штука как USB-звуковая карта для компьютера» планировалась через режим USB-гаджета Linux (UAC2), как на Raspberry Pi.
- **Вывод:** платы Mini-ITX (R36) обычно имеют только порты USB-хоста, режима устройства у них нет. Значит, этот режим нужно делать отдельно. Варианты:
  1. **Аудиоплата с двумя USB:** один порт к вычислителю, второй — к внешнему компьютеру (как у микшеров с двумя USB). Сложнее аудиоплата.
  2. **Отдельный мост USB-устройство** (свой микроконтроллер с High-Speed USB), который пересылает звук и MIDI по внутренней шине.
  3. **Отказаться** от звуковой карты для ПК в первой версии; USB-C сзади — только питание; обмен файлами — по сети и через флешку.

## 10. Проверка заготовки кода

- `firmware/protocol/sdp.h` (C, для прошивок и хоста) и `tools/sdp.py` (Python, эталон и отладка) собирают и разбирают одинаковые кадры: кадр PAD из C и из Python совпал байт в байт.
- Самопроверка: CRC-16 даёт контрольное значение 0x29B1 на строке «123456789» (стандарт CRC-16/CCITT-FALSE); COBS проходит туда-обратно на пустых, нулевых и длинных данных; поток восстанавливается после мусора (1 испорченный кадр отброшен, следующие приняты).
- Полный кадр подсветки 1290 байт занимает на проводе 1302 байта. Тест выявил, что первоначальный предел данных 1024 байта мал для полного кадра, — предел поднят до 1536.

## 11. Симулятор (R31)

Протокол позволяет сделать программную панель: программа на ПК создаёт виртуальный последовательный порт (pty в Linux) и шлёт те же кадры SDP, что и плата. Звуковой движок не отличает её от настоящей панели. Так софт можно писать, пока плат нет.

## Решено

- Две платы на RP2350 — R85; протокол SDP v0 — R86 (31.10.2026).
- «USB-C к компьютеру» — решено в документе 20 (R78, R82).

## Открытые вопросы

1. MIDI 2.0 — во второй версии протокола или сразу?
