MitjaGrecky/Shtuka-druka/docs/ru/20_usb_audio_interface.md

# Штука Дрюка: звуковая карта для внешнего компьютера

*31.10.2026. **Факт** — из источника, **вывод** — моя инженерная логика, **решено** — решение пользователя.*

## 0. Решение

- **Решено (R78):** Штука работает как USB-звуковая карта для внешнего компьютера уже в первой версии, «по максимуму». Пользователь: «с учётом железа, что мы впихиваем, не делать карту даже в первой версии — кощунство».
- Задача, которую это решает: плата Mini-ITX не умеет быть USB-устройством (документ 19, раздел 9), поэтому порт «к компьютеру» должна дать аудиоплата.

## 1. Как это сделано у других

| Устройство | Как | Источник |
|---|---|---|
| Allen & Heath Xone:96 | Два независимых USB-порта со звуковыми картами 32 бит: два диджея подключают два компьютера и переключаются | [DJ Mag](https://djmag.com/content/allen-heath-xone96-revealed) |
| MPC Live III | 24 канала в каждую сторону через USB-C | документ 11 |
| Push 3 | 10 × 12 каналов | документ 11 |

**Вывод.** Схема «два USB на одной аудиоплате» проверена в серийных устройствах: у Xone:96 — для двух компьютеров снаружи, у нас — для внутреннего вычислителя и внешнего компьютера.

## 2. Схема (R82, было P46)

| Узел | Что делает |
|---|---|
| Аудиоплата | АЦП (≈ 14 входов + 2 в запасе), ЦАП (Main, Aux, Cue), один тактовый генератор на всё |
| USB-порт A (внутренний) | Звуковая карта для вычислителя Mini-ITX, через внутренний хаб |
| USB-порт B (наружу, USB-C сзади) | Звуковая карта и MIDI для внешнего компьютера |
| Маршрутизатор | Цифровая шина TDM между портами, АЦП и ЦАП: любой канал можно отправить в любую сторону |

**Чип-кандидат: XMOS xcore.ai** — по одному на каждый USB-порт.
- **Факт:** готовая эталонная прошивка USB Audio Class 2.0 и 1.0, High-Speed, частоты до 384 кГц, асинхронный режим по умолчанию, MIDI и обновление прошивки по USB (DFU) включаются настройками; число каналов задаётся параметрами `NUM_USB_CHAN_IN/OUT` ([XMOS](https://www.xmos.com/documentation/XM-008854-UG/html/doc/rst/sw_usb_audio.html)).
- **Факт:** лицензия прошивки — XMOS Public Licence v1: исходники открыты, изменять и распространять можно; в коммерческих целях — только на чипах XMOS ([GitHub](https://github.com/xmos/sw_usb_audio)). Это не AGPL, но прошивка работает на отдельном чипе как отдельная программа, поэтому с лицензией проекта (R20, R69) не смешивается (вывод; не юридическая консультация).
- **Не проверено:** максимальное число каналов на один чип в эталонной прошивке — проверить на отладочной плате xcore.ai до разводки.
- **Запасной вариант (полностью открытый):** микроконтроллер с High-Speed USB и стеком TinyUSB (класс UAC2). Многоканальная работа там проверена хуже — рискованнее.

## 3. Тактирование: никаких пересчётов частоты

- **Факт:** в асинхронном режиме UAC2 устройство задаёт темп, а компьютер подстраивается по отдельной «конечной точке обратной связи»; встроенный драйвер Windows поддерживает асинхронный режим только с такой явной обратной связью, драйвер есть в Windows начиная с Windows 10 1703 ([Microsoft](https://learn.microsoft.com/en-us/windows-hardware/drivers/audio/usb-2-0-audio-drivers)).
- **Вывод:** оба порта работают от одного генератора аудиоплаты в асинхронном режиме. Тогда и Mini-ITX, и внешний компьютер подстраиваются под часы Штуки, и пересчёт частоты (который портит звук и добавляет задержку) внутри не нужен.

## 4. Каналы «по максимуму» (R83, было P47, расчёт)

**Внешний компьютер видит Штуку как карту 32 × 16:**
- 32 канала записи (из Штуки в компьютер): любые входы, дорожки (стемы), шины, Main — что выбрано в матрице маршрутизации. Например, 16 физических входов + 8 стерео-дорожек.
- 16 каналов воспроизведения (из компьютера в Штуку): каждая пара — источник дорожки («USB 1–2» и т. д.), как вход.
- Плюс MIDI в обе стороны: компьютер может играть синтами Штуки и принимать её клок.

**Внутренний канал (Mini-ITX ↔ аудиоплата) должен пропустить всё, что идёт через вычислитель:**

| Направление | Состав | Каналов |
|---|---|---|
| В вычислитель | 16 физических входов + 16 от внешнего компьютера | 32 |
| Из вычислителя | 6 на ЦАП (Main, Aux, Cue) + 32 во внешний компьютер | 38 → 40 с запасом |

**Пропускная способность:** 40 каналов × 48 000 × 32 бита = 61,4 Мбит/с в одну сторону. Для USB 2.0 High-Speed (480 Мбит/с) это ≈ 13 %. При 96 кГц — 122,9 Мбит/с, ≈ 26 %: тоже проходит.

## 5. USB-A — только накопители и прошивка (R79, R80)

- **Решено:** USB-A — только для накопителей и обновления прошивки; контроллерами и звуком его не нагружаем.
- **Решено:** два USB-A. **Сзади** — для постоянного накопителя (например, внешний SSD с библиотекой сэмплов) и прошивки. **Второй USB-A и слот SD — в блоке System** у экрана (R81), а не на переднем торце: на торце флешку «снесут вместе с портом до первого лайвсета».
- **Вывод:**
  - оба USB-A подключаются прямо к Mini-ITX, а не к внутреннему хабу с панелью и аудиоплатой: медленная или сбойная флешка не мешает звуку и ручкам;
  - порт в блоке System — через обычный внутренний разъём USB 3 на плате и стандартный кабель, как у передних портов корпусов ПК (наличие разъёма у N100DC-ITX проверить по руководству);
  - USB-A и SD стоят в общем углублении в блоке System: короткая флешка почти не торчит, место далеко от рук (зона B, документ 17) и не мешает обзору экрана;
  - выдернуть флешку можно в любой момент: по решению R57 проекты живут на внутреннем SSD, а с флешек материал копируется, поэтому звук ничего не читает с флешки напрямую;
  - рядом с USB-A и SD — индикатор «идёт запись»: пока горит, вынимать не стоит, иначе на флешке окажется недописанный файл;
  - защита питания портов от короткого замыкания (ограничитель тока) — на плате.
- Компьютер подключается по USB-C сзади (порт B аудиоплаты), внешние инструменты — по MIDI DIN/TRS.

## 6. 48 или 96 кГц (обсуждение 31.10.2026)

**Главное:** у аудиоплаты один генератор (раздел 3), поэтому частота одна на всё устройство. «96 только для внешнего компьютера» означает либо всё устройство на 96 кГц, либо пересчёт частоты на аудиоплате — а от него мы отказались.

| | 48 кГц | 96 кГц |
|---|---|---|
| Слышимый диапазон | До 24 кГц — выше слуха (20 кГц) | До 48 кГц |
| Слышно ли разницу | Мета-анализ 18 опытов (> 400 слушателей, > 12 500 проб): разницу различают слабо, но статистически значимо; заметно лучше — после долгой тренировки ([JAES, Reiss 2016](https://www.aes.org/e-lib/browse.cfm?elib=18296)). В двойном слепом тесте Meyer & Moran на музыке при обычной громкости значимых различий не нашли; заметен был только шум на сильно завышенной громкости ([BAS](https://bostonaudiosociety.org/explanation.htm)) | |
| Нагрузка на процессор | 1× | ≈ 2×: на облачной машине 16 эталонных дорожек на 1 ядре — 14 % против 31 % (замер `--rate 96000 --block 256`) |
| Дорожек на том же процессоре | N | ≈ N / 2 |
| Буфер захвата 16 каналов × 60 с (32 бит) | 16 · 60 · 48 000 · 4 = 184 МБ | 369 МБ |
| Сэмплы на SSD | 1× | 2× |
| Внутренний USB, 40 каналов | 61,4 Мбит/с (13 %) | 122,9 Мбит/с (26 %) |
| Задержка при блоке 128 | 2,67 мс | 1,33 мс (но нагрузка ещё выше) |
| Транспонирование сэмплов вниз | Октава вниз — верх обрезается на 12 кГц | Октава вниз — верх до 24 кГц: полевые записи и «добыча звука» с последующим замедлением звучат ярче |
| Искажения в эффектах (алиасинг) | Решается передискретизацией внутри эффекта (2–4×) | Меньше без передискретизации |

**Решено (R84, было P48):** «закладываем в основу 96, работаем на 48, даём пользователю включить режим».
1. **Железо сразу под 96 кГц:** АЦП и ЦАП, чипы XMOS, расчёт USB (26 %) — это почти ничего не стоит, и возвращаться к плате не придётся.
2. **Работаем на 48 кГц по умолчанию:** максимум дорожек — главная ценность для импровизации (R11).
3. **96 кГц — режим проекта:** выбирается при создании проекта, всё устройство переключается целиком, экран честно показывает, что дорожек станет примерно вдвое меньше. Для внешнего компьютера в этом режиме карта тоже работает на 96 кГц.
4. **Захват на 96 кГц для «добычи звука»** — тот же режим проекта: записал на 96, замедлил — верх не пропал.
5. Замер M93 дополнен прогоном 96 кГц (документ 18), он покажет точную цену.

## 7. Ограничения, о которых надо знать

- **Windows:** встроенный драйвер в общем (shared) режиме не поддерживает произвольное число каналов больше восьми ([Microsoft](https://learn.microsoft.com/en-us/windows-hardware/drivers/audio/usb-2-0-audio-drivers)). Для 32 каналов в DAW на Windows нужен ASIO-драйвер или монопольный режим. macOS и Linux работают с такой картой без драйверов (вывод по классу UAC2; проверить на прототипе).
- **Два чипа XMOS и маршрутизатор** — это самая сложная плата устройства. Сначала отладочная плата xcore.ai и проверка числа каналов, потом своя разводка.
- **Земля:** порт B соединяет землю Штуки с землёй компьютера. Документ 11 уже отмечал гул через USB-хаб монитора. Нужна гальваническая развязка порта B или хотя бы отдельный путь земли (проверить на прототипе).

## Открытые вопросы

1. Сколько каналов на чип реально даёт эталонная прошивка XMOS при 96 кГц — проверить на отладочной плате xcore.ai.
2. Развязка земли порта B — предложен изолятор ADuM4166 (документ 21), проверить на прототипе.
