MitjaGrecky/Shtuka-druka/docs/ru/13_enclosure_layout_research.md

# Штука Дрюка: корпус, компоновка и макет v3

*28.10.2026. **Факт** — из источника, **вывод** — моя инженерная логика, **решено** — решение пользователя. Макет v3 собран под решения 28.10: сетка 8×8 с окном дорожек, которое двигается в обе стороны; усиление на энкодерах; колесо справа (правша); экран с фиксированным наклоном ≈30°.*

## 1. Габариты конкурентов

| Устройство | Ш × Г × В, мм | Масса | Экран |
|---|---|---|---|
| Torso S-4 | 242 × 156 × 39 | 0,82 кг | 3,5″ ([SoS](https://www.soundonsound.com/reviews/torso-electronics-s-4)) |
| MPC Sample | 236 × 194 × 50 | — | 2,4″ ([MusicRadar](https://www.musicradar.com/music-tech/samplers/the-closest-thing-akai-has-released-to-a-vintage-mpc-in-decades-akai-mpc-sample-review)) |
| Launchpad Pro MK3 | 268 × 268 × 18 | 1 кг | — ([Kirstein](https://www.kirstein.de/en/Live-Studio/Studio/Controllers/DAW-Controllers/Novation-Launchpad-PRO-MK3.html)) |
| Elektron Tonverk | — | 1,85 кг | OLED 128 × 64 ([MusicRadar](https://www.musicradar.com/music-tech/samplers/elektron-tonverk-review)) |
| Ableton Push 3 standalone | 380 × 318 × 44,5 | 3,95 кг | LCD ([Thomann](https://www.thomann.de/be/ableton_push_3_standalone_live_std.htm)) |
| MPC Live III | 436 × 256 × 67 | 3,9 кг | ≈7″ ([Thomann](https://www.thomannmusic.com/akai_professional_mpc_live_iii_case_bundle.htm)) |
| Akai Force | — | почти 4 кг | 7″, не наклоняется ([Bonedo](https://www.bonedo.de/artikel/akai-force-test/)) |
| MPC XL | 543 × 488 × 94 | 7,2 кг | 10,1″ ([Perfect Circuit](https://www.perfectcircuit.com/m2e/akai-mpc-xl.html)) |
| **Штука Дрюка v3 (оценка, раздел 4)** | **≈515 × 480 × 35 спереди / ≈105 сзади** | **5–6 кг** | **10,1″, наклон 30°** |

**Вывод.** С 10-дюймовым экраном мы в классе MPC XL по площади. Для настольного прибора это нормально, и ты это уже решил.

## 2. Нормы эргономики, которые применимы

Из FAA Human Factors Design Standard ([гл. 6](https://hf.tc.faa.gov/hfds/download-hfds/hfds_pdfs/Ch6_Controls_and_visual_indicators.pdf), [гл. 9](https://hf.tc.faa.gov/hfds/download-hfds/hfds_pdfs/Ch9_Input_devices.pdf)):

| Норма | Значение | Как применяем |
|---|---|---|
| Наклон клавиатуры (9.1.11) | 0–25°, лучше меньше 15° | Основная панель 5–10° к пользователю |
| Шаг клавиш (9.1.8–9.1.9) | 18–19 мм по горизонтали, 18–21 мм по вертикали | Шаг кнопок не меньше 19 мм |
| Усилие клавиш (9.1.10) | 0,25–1,5 Н, лучше 0,5–0,6 Н | Подбор переключателей |
| Сенсорные зоны (9.4.2.4) | 19–38 мм, промежуток 3–6 мм; отклик ≤ 0,25 с | Колонки экрана 27 мм |
| Направление (6.1.1.2.1) | По часовой — увеличение | Все энкодеры и потенциометры |
| Кодирование размером (6.1.1.4.6) | Разница диаметров ≥ 13 мм | Навигационное колесо заметно крупнее |
| Работа вслепую (6.1.1.5.3) | Разная форма или ≥ 125 мм | Громкости — отдельной формы, у края |
| Важные индикаторы (6.2.2.1.8) | В пределах 15° от линии взгляда | Rec, перегруз, фантом — рядом с экраном |
| Мигание (6.2.2.1.29) | 3–5 Гц, только для срочного | Прошивка |

Практика:
- Для ручек около 25 мм между центрами — минимум, при котором ещё можно работать ([Ableton forum](https://forum.ableton.com/viewtopic.php?p=1306090)).
- Подставку под запястья у MPC Sample хвалят ([MusicRadar](https://www.musicradar.com/music-tech/samplers/the-closest-thing-akai-has-released-to-a-vintage-mpc-in-decades-akai-mpc-sample-review)).
- Устройства, лежащие плашмя, связывают с болью в спине ([Elektronauts](https://www.elektronauts.com/t/elektron-ergonomics/36812)).

## 3. Разъёмы: где что

**Факты.**
- У Force наушники, ручки громкости и cue-mix и слот SD спереди, всё остальное сзади ([Bonedo](https://www.bonedo.de/artikel/akai-force-test/)).
- У EP-133 все разъёмы сверху ([SoS](https://www.soundonsound.com/reviews/teenage-engineering-ep-133-ko-ii?amp)); для маленького переносного устройства это удобно, для настольного с десятком кабелей — нет.
- У Kick наушники спереди, остальное сзади ([GitHub](https://github.com/MusicTribeOpenSource/0700-AAM/blob/main/README.md)).
- Гнёзда лучше отделять от ручек, чтобы не задевать кабели ([LMNC](https://lookmumnocomputer.discourse.group/t/panel-layout-best-practices/6780)).

*Обновление 31.10.2026: USB-A — только накопители и прошивка, без контроллеров и звука. Сзади — для постоянного накопителя; второй USB-A и SD — в блоке System у экрана, а не на переднем торце (R80, R81, документ 20).*

**Вывод: ответ на старый открытый вопрос «где USB-A и SD».**

| Место | Что |
|---|---|
| Сзади | Всё постоянное: комбо-входы, гитара, фоно с клеммой земли, выходы, MIDI DIN, CV/Gate, Clock, USB-C (компьютер и питание), USB-A для постоянных контроллеров, Ethernet, вход питания, замок Kensington (есть у Force) |
| Спереди слева | Два выхода наушников 6,3 мм, потенциометры «Мониторы», «Наушники», «Cue/Mix» |
| Передний торец справа | Слот SD и один USB-A для флешки. Это то, что вставляют и вынимают часто |
| Сверху | Только органы управления, без гнёзд |

### 3.1 Что берём у AudioFuse (решено: задняя панель разграничена по типу и направлению, «идея как у AudioFuse»)

**Факты об AudioFuse:**
- По SoS, у AudioFuse микрофонные входы, инсерты и линейные/фоно-входы сгруппированы по функции и типу сигнала. Большинство разъёмов сзади. MIDI на мини-джеках с переходниками «из-за места». Разъёмы питания и USB без фиксации. Корпус назван тесноватым ([SoS](https://www.soundonsound.com/reviews/arturia-audiofuse)).
- По руководству ([Arturia](https://dl.arturia.net/products/audiofuse/manual/AudioFuse_Manual_1_2_3_EN.pdf)):
  - инсерты на TRS (кончик — посыл, кольцо — возврат, линейный уровень, +18 dBu = 0 dBFS);
  - входы 3–4 фоно/линия — RCA с клеммой земли и балансные 6,3 мм, одновременно использовать нельзя;
  - Speakers A и B — две балансные пары;
  - выход реампинга с переключаемым импедансом;
  - USB-хаб на 3 порта, ADAT, S/PDIF, word clock.
- TapeOp: плотно, но «легко просматривается». На серебристом корпусе подписи малоконтрастны. Штекер питания без фиксации ([TapeOp](https://tapeop.com/reviews/gear/123/audiofuse-desktop-usb-interface)).

**Вывод.**
- **Берём:** подписанные блоки «по функции и типу сигнала», вход и выход не перемешаны.
- **Не берём:** мини-джеки для MIDI, малоконтрастную печать, нефиксируемое питание.
- **Бонус для прототипа:** у твоего AudioFuse есть выход реампинга, им можно проверить педальную петлю (документ 15) до своих плат.

### 3.2 Правила против ошибочного подключения (вывод с опорой на источники)

1. **Четыре зоны:** «Питание, USB» → «Управление» (MIDI, CV, клок) → «Аудиовыходы» → «Аудиовходы». Между зонами промежуток не меньше 10 мм и рамка, напечатанная на панели. Зонирование и логическая группировка снижают риск перекрёстных подключений, так делают у Boeing 787 и Airbus A350 ([EWIS](https://sassofia.com/wp-content/uploads/2025/06/Human-Factors-in-Electrical-Wiring-Interconnection-Systems-EWIS-Design-Integration.pdf)).
2. **Один графический язык на всё устройство:** выход — залитый прямоугольник, вход — рамка. Так поступает участник форума LMNC: выходы выделены чёрными прямоугольниками с белыми подписями ([LMNC](https://lookmumnocomputer.discourse.group/t/panel-layout-best-practices/6780)). Внутри зоны «Управление» MIDI и CV тоже разделены на вход и выход.
3. **Разные разъёмы для разных функций, где возможно:**
   - комбо XLR/TRS — только мик/линия;
   - DIN — только MIDI;
   - RJ45 и USB уникальны.

   Где тип совпадает, разносим по разным зонам и концам панели:
   - 6,3 мм TRS на выходах и TS на гитарном входе;
   - RCA на фоно-входе и RCA-выходе;
   - 3,5 мм на CV и клоке.

   Цветовая маркировка нужна там, где разъёмы похожи ([Avnet](https://www.avnet.com/americas/resources/article/what-is-polarization-keying-and-color-coding-for-interconnect/)).
4. **Электрическая защита от ошибки:** любое гнездо переживает любой наш кабель.
   - Выходы — с последовательными резисторами и защитой от короткого замыкания.
   - CV- и клок-входы выдерживают ±12 В.
   - Фоно и Hi-Z на линейном уровне только перегружаются, без повреждений.
   - MIDI-входы на оптронах (как требует стандарт MIDI).
   - Фантом подаётся только на контакты XLR комбо-разъёма, не на TRS.
5. **Питание без ошибок:**
   - основной вход — USB-C PD;
   - если есть гнездо DC — с фиксацией (у AudioFuse её отсутствие ругают), диапазон 12–24 В, защита от переполюсовки и перенапряжения. Тогда подходящий по разъёму чужой блок ничего не сожжёт.
6. **Подписи:**
   - тёмная панель и белая печать, а не малоконтрастная, как у серебристого AudioFuse;
   - над каждым гнездом — подпись, над зоной — название;
   - те же подписи продублировать на верхней панели у заднего края, чтобы читать их спереди, не заглядывая за устройство.
7. **Порядок совпадает с лицевой панелью.** Если смотреть спереди: входы слева, прямо за блоком «Захват»; выходы посередине; управление и питание справа, за навигацией.
8. **Защита в софте (идея, проверить на прототипе):** если выход случайно соединён со входом (например, Main воткнули в гитарный вход) и началась обратная связь, вход приглушается, а на экране появляется предупреждение.

### 3.3 Состав задней панели (вид сзади, слева направо)

| Зона | Что в ней |
|---|---|
| Питание, USB | DC с фиксацией и выключатель; USB-C (компьютер и питание); USB-A — постоянный накопитель и прошивка, без контроллеров (R80); Ethernet; замок Kensington |
| Управление | Вход: MIDI 1–2 (DIN), CV 1–4, клок. Выход: MIDI 1–2 (DIN, второй переключается в Thru), CV/Gate 1–8, клок |
| Аудиовыходы | Main L/R (балансные TRS); Aux L/R (балансные TRS, переключатель «линия/педали»); RCA L/R (копия Main) |
| Аудиовходы | Фоно L/R (RCA) с клеммой земли и переключателем «фоно/линия»; Гитара 1–2 (Hi-Z, TS); Мик/линия 1–2 (комбо XLR/TRS) |

Спереди: 2 выхода наушников 6,3 мм, слот SD, USB-A для флешки.

### 3.4 Помещается ли (оценка)

- Зоны: питание ≈74 мм, управление ≈169 мм, выходы ≈111 мм, входы ≈130 мм; итого ≈484 мм.
- Плюс 3 промежутка по 10 мм ≈ 514 мм при ширине корпуса ≈515 мм. Впритык.
- Запас даёт высота задней стенки ≈105 мм (из-за наклона экрана): в зонах «Питание, USB» и «Управление» гнёзда уже стоят в два ряда, а при нужде так же можно разложить и аудио.

### 3.5 Задняя панель после решений R32–R37 (31.10.2026, оценка)

Добавились: MIDI DIN выходы 3–4, MIDI 3,5 мм (1 вх, 2 вых), блок «Синхро» (5), CV-входы 4, 8 линейных входов. Таблица 3.3 устарела в зонах «Управление» и «Аудиовходы».

| Зона | Состав | Раскладка | Ширина ≈ |
|---|---|---|---|
| Питание, USB | Как в 3.3 | 2 ряда | 74 мм |
| Управление | MIDI DIN 2 вх + 4 вых (6 гнёзд); мини-джеки: MIDI TRS 3, Синхро 5, CV-вх 4, CV/Gate-вых 8 = 20 | DIN 2 ряда × 3 (≈66 мм); мини-джеки 3 ряда × 7 при шаге ≈14 мм (≈98 мм) + промежуток | 174 мм |
| Аудиовыходы | Main L/R, Aux L/R, RCA L/R | 2 ряда × 3 | 70 мм |
| Аудиовходы | Комбо 2, Hi-Z 2, фоно L/R + земля + переключатель; линейные 1–8 | старые входы 2 ряда (≈70 мм); линейные 2 ряда × 4 (≈88 мм) | 158 мм |
| Промежутки между зонами | 3 × 10 мм | | 30 мм |
| **Итого** | | | **≈506 мм из ≈515** |

**Вывод.** Помещается за счёт высоты задней стенки ≈105 мм: всё в 2 ряда, мини-джеки управления в 3 ряда. Запаса почти нет. Если на прототипе станет тесно — корпус можно расширить: размер не ограничен (R6).

Правила R26 сохраняются: внутри «Управления» MIDI-блок (DIN и TRS) отдельно от CV/Синхро; входы в рамке, выходы с заливкой.

### 3.6 Проверка объёма: помещаются ли гнёзда и плата (31.10.2026)

Вопрос пользователя: «физически возможно всандалить разъёмы в этот треугольник?» **Вывод: в корпусе v4 (перед 32 мм, зад 107 мм) — нет.**

Допущения (оценки, уточнить по чертежам деталей): верхняя обшивка 3 мм; под наклонной частью слой экрана и ручек ≈ 18 мм; под плоской панелью слой пэдов и энкодеров ≈ 15 мм; гнездо 6,3 мм или комбо XLR уходит вглубь ≈ 40 мм и занимает ≈ 26 мм по высоте; Mini-ITX с памятью стоя ≈ 45 мм высотой.

Формула: верх гнезда на глубине d ≤ H_зад − 3 − 18 − tan 30° · (d − полка).

| | v4 | Предложение |
|---|---|---|
| Высота спереди | 32 мм | 68 мм (MPC Live III — 67 мм) |
| Плоская полка за экраном | 10 мм | 30 мм |
| Высота сзади | 107 мм | 143 мм |
| Глубина | 480 мм | 500 мм |
| Предел верха гнезда глубиной 40 мм | ≈ 69 мм → только 2 ряда | ≈ 116 мм → 3 ряда (до 98 мм) |
| Свободно под панелью | ≈ 11 мм → Mini-ITX не влезает | ≈ 47 мм → Mini-ITX лёжа |

**Вывод.** Раскладка задней панели в 3 ряда (раздел 3.5) требует корпус толще. Плата Mini-ITX (R36) тоже требует ≈ 45–47 мм под панелью. Подставка под запястья при высоте 68 мм становится обязательной (её хвалят у MPC Sample).

## 4. Макет v3

*Обновление 31.10.2026: раскладка верхней панели пересмотрена по нормам эргономики — см. документ 17 (макет v4). Габариты и задняя панель (раздел 3.5) прежние.*

### 4.1 Что изменилось относительно v2 (документ 07)

| Что | v2 | v3 | Почему |
|---|---|---|---|
| 8 энкодеров параметров | Над экраном | Под экраном | Руки закрывают экран (жалоба на Push 3); у Force и Maschine энкодеры ниже экрана (документ 09, раздел 7) |
| Экран | Плоский | **Фиксированный наклон 30° (решено)** | Расчёт угла обзора (документ 10, раздел 6.4) |
| Колесо навигации | Слева | **Справа от экрана (решено: правша)**, рядом «Назад» и 4 стрелки | Force, MPC One, Push 3 (документ 09, раздел 2) |
| Дорожки | 8 кнопок и 8 ручек справа от сетки | То же место, но это **окно из 8 дорожек**, которое двигается стрелками и колесом; мини-карта на экране | Решение «16 минимум» и навигация построчно (документ 09, раздел 6.3) |
| Ряд под экраном | 5 кнопок режимов сетки | Энкодеры параметров; 4 кнопки страниц перенесены влево | Документ 08 |
| Под сеткой | — | Ряд из 8 кнопок: запуск сцены в виде клипов, страницы шагов в шаговом режиме | Как у Force и Push |
| Усиление входов | Не было | **2 энкодера с цифровым предусилителем (решено)**, кольцо = усиление + уровень | Документ 11, раздел 2.2 |
| Громкости | Ручки слева | **Потенциометры (решено)** спереди слева у гнёзд наушников + Cue/Mix | Документ 11, раздел 3 |
| SD и USB-A | Не решено | Передний торец справа | Раздел 3 |
| Фейдеры | 4 справа | Нет, только кроссфейдер | Документы 06, 09 |

### 4.2 Зоны (от дальнего края к пользователю)

1. **Тыл:** разъёмы (раздел 3).
2. **Дальняя зона:**
   - по центру экран 10,1″ на скошенной части корпуса под 30°;
   - слева от экрана блок «Захват»: Capture, Freeze, 5 кнопок источника (микрофон, линия, фоно, гитара, внутренний), 2 энкодера усиления с кольцами, 2 кнопки фантома с индикаторами;
   - справа от экрана навигация: главное колесо с нажатием, «Назад», 4 стрелки, Undo, Save.
3. **Средняя зона:**
   - прямо под экраном 8 энкодеров параметров, шаг 30 мм;
   - слева 4 кнопки страниц (Взять, Лепить, Играть, Собрать) и транспорт (Play, Stop, Rec);
   - справа «Перформанс»: кроссфейдер, кнопки A/B, 6 макро-энкодеров.
4. **Зона сетки:**
   - по центру 8×8 RGB-пэдов, шаг 25 мм (200 × 200 мм);
   - справа по строкам 8 кнопок дорожек и 8 энкодеров уровня, шаг 25 мм совпадает со строками;
   - под сеткой ряд из 8 кнопок (сцены или страницы шагов), рядом Mute и Solo.
5. **Передняя зона:**
   - слева у края потенциометры «Мониторы», «Наушники», «Cue/Mix», под ними на торце два гнезда наушников;
   - справа на торце SD и USB-A;
   - место под запястья вдоль всей кромки.

### 4.3 Навигация по сетке (решено пользователем)

- Окно 8×8 двигается вниз и вверх по дорожкам, вправо и влево — по времени: сценам, шагам, тактам.
- Стрелками: нажатие — на одну строку или столбец, удержание — на 8.
- Главным колесом: поворот — по вертикали, нажать и крутить — по горизонтали.
- Банк по 8 остаётся быстрым прыжком, но основной способ — построчный сдвиг, потому что банк «сразу лист целый меняет».
- На экране мини-карта всех дорожек и всего времени с рамкой текущего окна.

### 4.4 Оценка габаритов (вывод)

Ширина:
- левый блок ≈110 мм;
- центр = сетка 200 мм + столбец дорожек ≈55 мм = 255 мм (экран 217,5 мм и рамка укладываются в эту ширину);
- правый блок ≈120 мм;
- поля 2 × 15 мм;
- **итого ≈515 мм**.

Глубина:
- поле сзади 15 мм;
- проекция наклонного экрана: модуль ≈150 мм · cos 30° ≈ 130 мм;
- ряд энкодеров 45 мм;
- сетка 200 мм;
- ряд под сеткой 30 мм;
- передняя зона 45 мм;
- поле 15 мм;
- **итого ≈480 мм**.

Высота: спереди ≈35 мм; сзади ≈30 + 150 · sin 30° ≈ 105 мм.

### 4.5 Подсчёт для v3

| Что | Количество |
|---|---|
| Энкодеры | 25: 8 параметров, 6 макро, 8 уровней, 1 колесо, 2 усиления |
| Потенциометры | 3: мониторы, наушники, Cue/Mix |
| Пэды | 64 |
| Кнопки | 43 (документ 09, раздел 3.3) |
| Ползунок | 1 (кроссфейдер) |
| RGB-светодиоды | ≈427 (документ 10) |

Если позже захочется прямого доступа ко всем 16 дорожкам сразу (вариант B), полосу из 16 каналов можно сделать отдельным модулем у передней кромки, не переделывая остальное.

## 5. Если когда-нибудь Kickstarter: что решать уже сейчас

Ты делаешь устройство для себя, но допускаешь краудфандинг. Несколько решений дешевле принять сразу, чем потом переделывать.

| Тема | Факт | Вывод |
|---|---|---|
| Лицензии кода | Код Kick — AGPL-3.0 ([GitHub](https://github.com/MusicTribeOpenSource/0700-AAM/blob/main/README.md)); JUCE — AGPLv3 или коммерческая ([Wikipedia](https://en.wikipedia.org/wiki/JUCE)); Ableton Link — GPLv2+ или проприетарная ([GitHub](https://www.Github.com/Ableton/link)) | Если берём код Kick или JUCE по AGPL, наша прошивка тоже должна быть открытой. Решить заранее: открытый проект или закрытый |
| Долгая доступность | CM5 выпускают минимум до января 2036 года ([CM5 brief](https://pip-assets.raspberrypi.com/categories/944-raspberry-pi-compute-module-5/documents/RP-008181-DS-10-cm5-product-brief.pdf)) | Выбирать компоненты с объявленным сроком выпуска |
| Радио | Wi-Fi и Bluetooth требуют радио-сертификации (Директива ЕС RED) | Только готовые сертифицированные модули |
| Аккумулятор | ЕС: с 18.02.2027 батарея снимается и меняется пользователем, запчасти 5 лет ([ComplianceGate](https://www.compliancegate.com/removable-and-replaceable-battery-requirements-european-union/)) | Съёмный модуль (документ 11) |
| Питание от сети | — | Внешний сертифицированный блок или USB-C PD, чтобы не сертифицировать сетевую часть самим |
| Деньги | Краудфандинг подходит, чтобы проверить спрос и выпустить продукт, но доходом становится только при очень большом успехе ([Hackaday](https://hackaday.com/2021/09/12/successfully-crowdfunded-hardware-everything-behind-the-scenes)); Aodyo с синтами Loom Omega оказалась на грани банкротства, производство встало ([Synthtopia](https://www.synthtopia.com/content/2024/09/26/aodyo-says-production-of-loom-omega-synths-in-limbo-bankruptcy-coming-if-they-cant-raise-additional-funds/)) | Сначала рабочий прототип и видео, потом кампания |
| Видео | ШИМ WS2812 мерцает на камере (документ 10) | Матричные драйверы светодиодов |

## Открытые вопросы

1. Проект открытый (совместим с AGPL) или оставляем возможность закрытого?
2. Подставка под запястья — встроенная часть корпуса или съёмная?
3. Встроенные динамики: нужны ли? Если да, им нужно место в корпусе.
