MitjaGrecky/Shtuka-druka/docs/ru/11_io_formats_research.md

# Штука Дрюка: входы, выходы, форматы, синхронизация, хранилище, питание

*28.10.2026. **Факт** — из источника, **вывод** — моя инженерная логика, **решено** — решение пользователя. Типовые значения уровней (+4 dBu и т.п.) — общеизвестные стандарты, помечены как «типично».*

## 0. Что уже решено

- **Решено:** standalone, настольное устройство.
- **Решено:** входы — микрофон с фантомом, фоно для винила, гитара, линия; CV и синхронизация с внешними синтами; много входов и выходов.
- **Решено:** громкость мониторов и наушников — потенциометры; два выхода наушников 6,3 мм спереди (документ 04).
- **Концепция:** «добыча звука любыми способами» — значит, источников звука должно быть больше, чем у типичного грувбокса.

---

## 1. Как это сделано у других

| Устройство | Входы | Выходы | MIDI | CV/Gate | USB, сеть |
|---|---|---|---|---|---|
| MPC XL | 6: 2 комбо с предусилителями и фантомом, 2 инструментальных, фоно | 8 линейных | 2 вх / 4 вых | 16 (8 стерео-гнёзд 3,5 мм) | 3×USB-A, USB-C (24 канала аудио) ([Perfect Circuit](https://www.perfectcircuit.com/m2e/akai-mpc-xl.html)) |
| MPC Live III | 2 комбо XLR/TRS с фантомом; стерео-фоно (по MusicTech; Gearnews называет их RCA-входами); встроенный микрофон | 3 стереопары | 2 комплекта вх/вых | 4 гнезда TRS = 8 сигналов | USB-C (24 канала), 2×USB-A, Wi-Fi, BT, без Ethernet ([Gearnews](https://www.gearnews.com/akai-mpc-live-iii-review/), [MusicTech](https://musictech.com/reviews/studio-recording-gear/akai-mpc-live-iii-review/), [Thomann](https://www.thomannmusic.com/akai_professional_mpc_live_iii_case_bundle.htm)) |
| Akai Force | 2 комбо с фантомом и режимом инструмента | 4 | Мини-джеки 3,5 мм с переходниками | 4 | 3×USB, Ethernet, Wi-Fi, BT; SD и наушники спереди ([Bonedo](https://www.bonedo.de/artikel/akai-force-test/)) |
| Push 3 | 2 линейных/инструментальных; ADAT | 2 + наушники; ADAT | Мини-джеки | 4 + 2 гибких (педаль или CV) | USB-C (10 × 12 каналов, до 96 кГц) ([Thomann](https://www.thomann.de/be/ableton_push_3_standalone_live_std.htm)) |
| Elektron Tonverk | 2 | 4 + наушники | Вх/вых/thru | — | 2×USB-C, SD ([MusicRadar](https://www.musicradar.com/music-tech/samplers/elektron-tonverk-review)) |
| Behringer Kick | Стерео | Стерео + наушники спереди | DIN вх/вых | 4 | USB-C, USB-A, LINK (RJ45), SD, 12 В ([GitHub](https://github.com/MusicTribeOpenSource/0700-AAM/blob/main/README.md)) |
| Torso S-4 | Стерео 6,3 мм + встроенный микрофон | Стерео + наушники | Мини-джеки + аналоговый клок | — | USB-C, 4 ГБ внутри, без SD ([SoS](https://www.soundonsound.com/reviews/torso-electronics-s-4)) |
| MPC Sample | 2 TRS, USB-аудио, встроенный микрофон | 2 TRS + наушники 3,5 мм | Вх/вых + Sync Out | — | USB-C, microSD; постоянный буфер 25 с ([MusicRadar](https://www.musicradar.com/music-tech/samplers/the-closest-thing-akai-has-released-to-a-vintage-mpc-in-decades-akai-mpc-sample-review)) |

**Что из этого следует:**
- Фоно-вход есть у двух старших MPC (XL и Live III). Наше решение про фоно совпадает с тем, куда идёт рынок.
- Встроенный микрофон стал нормой у устройств «захвата» (S-4, MPC Sample, Live III).
- Постоянный буфер записи тоже стал нормой (MPC Sample — 25 с, SP-404 MK2 — Skip Back).
- Отличаться будем широтой источников и тем, что буфер есть у каждой дорожки, а также заморозкой (Freeze) выхода (документ 08).

---

## 2. Входы

### 2.1 Предлагаемый набор (вывод)

| Вход | Разъём | Зачем | Ключевые параметры |
|---|---|---|---|
| Микрофон/линия ×2 | Комбо XLR/TRS 6,3 мм, сзади | Микрофоны, линейные источники, стереопара | Фантом P48 на каждый канал отдельно; цифровое или аналоговое усиление (2.2) |
| Гитара (Hi-Z) ×1–2 | TS 6,3 мм | Гитара, бас, контактный пьезомикрофон | Не меньше 1 МОм (2.4) |
| Фоно (MM) | RCA L/R + клемма заземления | Винил | RIAA, 47 кОм, переключатель фоно/линия (2.5) |
| Встроенный микрофон | Внутри корпуса | Мгновенный захват без кабелей | У Live III хватает для инструментов и идей ([MusicTech](https://musictech.com/reviews/studio-recording-gear/akai-mpc-live-iii-review/)) |
| USB-аудио (вход с компьютера или телефона) | USB-C | Сэмплить телефон, компьютер, YouTube | Класс UAC2 (5.1) |
| Bluetooth-аудио (приём A2DP) | Радио | Сэмплить с телефона без проводов | **Идея:** у конкурентов не нашёл; качество ограничено кодеком, для идей достаточно |
| CV-входы ×2–4 | 3,5 мм | Модуляция параметров от модульных систем | Постоянный ток, ±5 В (4.2) |

### 2.2 Усиление входа: потенциометр или энкодер с цифровым предусилителем

| | Потенциометр | Энкодер + цифровой предусилитель |
|---|---|---|
| Схема | Классический малошумящий предусилитель | Микросхема с цифровым управлением: TI PGA2500 — активна, 10–65 дБ шагом 1 дБ, собственный шум −128 dBu, THD+N 0,0004%, питание ±5 В ([TI](https://www.ti.com/product/pga2500)). Есть и четырёхканальный THAT 6263 |
| Запоминание | Нет: положение ручки | Да: в проекте, в сцене, в пресете захвата |
| Автоматика | Нет | Возможны авто-подстройка усиления и защита от перегруза, как Auto Gain и Clip Safe у Scarlett 4-го поколения. В тесте Production Expert защита «не пере- и не недокорректирует» ([Production Expert](https://www.production-expert.com/production-expert-1/how-safe-is-focusrite-clip-safe)) |
| Кольцо | Не нужно | Кольцо показывает усиление и одновременно уровень сигнала |
| Сложность | Низкая | Выше: SPI-управление, двуполярное питание, тихий старт |
| Отказ софта | Не влияет | Нужна безопасная установка по умолчанию при старте |

**Решено (28.10.2026):** энкодер с цифровым предусилителем.

Что из этого следует для схемы (вывод):
- **Энкодер с фиксацией:** 1 щелчок = 1 дБ; кольцо показывает усиление и уровень сигнала (метр).
- **Тихий старт:** при включении предусилитель на минимуме и заглушен, фантом выключен. Сохранённое значение софт выставляет, только когда тракт готов. Так сбой софта не может ударить по ушам или по микрофону.
- **Auto (авто-подстройка):** играешь несколько секунд, устройство ставит усиление с запасом.
- **Защита от перегруза (как Clip Safe):** при резком пике усиление уменьшается на лету. Режим по желанию, видно на экране.
- **Кандидаты:** 2 × PGA2500 (±5 В, управление по последовательному интерфейсу, можно цепочкой) или четырёхканальный THAT 6263. Окончательный выбор — по наличию и цене.

### 2.3 Фантомное питание

**Факты** ([Wikipedia: Phantom power](https://en.wikipedia.org/wiki/Phantom_power), со ссылкой на IEC 61938):
- P48 = 48 В через два согласованных резистора 6,81 кОм (точность 0,1% или лучше) на контакты 2 и 3 XLR.
- Максимум 10 мА на микрофон. Многие дешёвые устройства дают только 1–2 мА, и современные микрофоны (4–10 мА) теряют на них запас по уровню.
- Риски: ленточные микрофоны без трансформатора; неисправный кабель; несимметричные источники; коммутация под нагрузкой.

**Вывод:**
- Отдельный выключатель фантома на каждый канал с индикатором.
- Плавное включение и выключение. Блок держит 10 мА на канал: 2 · 48 В · 10 мА ≈ 0,96 Вт плюс потери преобразователя.
- Предупреждение на экране при включении.

### 2.4 Гитарный вход

Нагрузка должна быть хотя бы в 10 раз выше импеданса источника; у большинства усилителей около 1 МОм. При низком входном сопротивлении теряются высокие и сустейн ([Guitar World](https://www.guitarworld.com/features/how-impedance-affects-your-guitar-tone)).

**Вывод:** буфер на ОУ с входом 1 МОм. Этот же вход подходит для пьезомикрофонов — ещё один способ добычи звука, например контактная запись с предметов.

### 2.5 Фоно

**Типично:** MM-головка выдаёт несколько милливольт на 1 кГц, вход 47 кОм. Чтобы получить линейный уровень, нужно около 35–48 дБ на 1 кГц (5 мВ → 0,316 В = 36 дБ; до +4 dBu = 1,228 В — 47,8 дБ). Нужны RIAA-коррекция и инфразвуковой фильтр.

**Два варианта (вывод):**
1. Классический аналоговый RIAA-корректор: проверенно и просто.
2. Линейный малошумящий усилитель плюс RIAA в цифре: гибче (можно переключать кривые), но нужен запас динамического диапазона АЦП, потому что ВЧ в записи подняты. Требует проверки на макете.

Для первой версии беру первый вариант, плюс переключатель фоно/линия и клемма заземления.

### 2.6 Запись по порогу и предзапись

У MPC запись начинается, когда сигнал превышает порог; слишком высокий порог обрезает начало ([руководство MPC](https://www.manualslib.com/manual/724425/Akai-Mpc.html?page=68)).

**Вывод:** у нас буфер пишет всегда, поэтому предзапись бесплатна. Порог только отмечает начало, и начало звука не теряется: берём 50–500 мс до срабатывания из буфера.

---

## 3. Выходы

*Обновление: подробное исследование выходов — в документе 15, итоговый набор там в разделе 6. Таблица ниже — первоначальная прикидка.*

| Выход | Предложение (вывод) | Опора |
|---|---|---|
| Главный L/R | Балансный TRS 6,3 мм, +4 dBu | Типично |
| Отдельные выходы | Минимум 2 стереопары (всего 6), лучше 4 пары (8) | MPC XL — 8, Live III — 6, Force — 4; отдельные выходы хвалят (документ 04) |
| Наушники | 2 × 6,3 мм спереди, своя громкость (потенциометр) | Решено |
| Предпрослушивание в наушниках (Cue) | Отдельная шина «слушать до включения» + потенциометр Cue/Mix | У Force есть ручка cue-mix спереди ([Bonedo](https://www.bonedo.de/artikel/akai-force-test/)); у S-4 нет предпрослушивания, и это ругают ([SoS](https://www.soundonsound.com/reviews/torso-electronics-s-4)) |
| Встроенные динамики | Опция | Динамики Live III хвалят ([MusicTech](https://musictech.com/reviews/studio-recording-gear/akai-mpc-live-iii-review/)); динамик Move слабый ([MusicTech](https://musictech.com/reviews/controllers/ableton-move-review/)) |

**Вывод:** часть отдельных выходов сделать с открытым входом по постоянному току (DC-coupled), чтобы они могли выдавать CV, как аудиоинтерфейсы Expert Sleepers. Это дешёвый способ получить больше CV.

---

## 4. MIDI, CV и синхронизация

### 4.1 MIDI

- **DIN 5-pin:** Force с мини-джеками и переходниками критикуют, переходники легко потерять ([Bonedo](https://www.bonedo.de/artikel/akai-force-test/)).
- **TRS-MIDI:** тип A входит в стандарт MIDI Association с 2018 года (Korg, Akai, Teenage Engineering). Тип B используют Arturia, Novation, Polyend. Выглядят одинаково, но несовместимы ([Bonedo](https://www.bonedo.de/artikel/midi-wirrwarr-entschlusselt-ueber-midi-klinke-trs-a-und-trs-b)).
- **MIDI 2.0 на Linux:** UMP в ядре с 6.5, зрелая база к 6.12; PipeWire 1.2+; выигрыш в разрешении, не в задержке. Советуют считать поддержку бонусом ([kernel.org](https://www.kernel.org/doc/html/v6.5/sound/designs/midi-2.0.html), [обзор 2026](https://linuxdj-project.pages.dev/notes/midi-2-0-on-linux-2026-pipewire-ump-kernel-support-and-safe-fallbacks/)).

**Вывод:**
- DIN: 2 входа и 2–4 выхода (у MPC XL 2/4), один выход переключается в Thru.
- USB-MIDI в обе стороны: как устройство для компьютера и как хост для MPD218, Push, Launchpad.
- MIDI 2.0 включаем, когда стек стабилен, железо этого не требует.

### 4.2 CV/Gate

| Стандарт | Что значит | Кто |
|---|---|---|
| 1 В/окт | 1 В = октава | Roland, Moog, Sequential, Oberheim, ARP, Eurorack ([Wikipedia](https://en.wikipedia.org/wiki/CV/gate)) |
| Гц/В | Удвоение напряжения = октава | Большинство Korg и Yamaha |
| V-trig | Положительный импульс 2–10 В | Roland, Sequential |
| S-trig | Замыкание на землю | Ранние Moog |
| Уровни Eurorack | Аудио ±5 В; CV 0…10 В или ±5 В; триггер 10 В, 1 мс; порог входа около 0,1–2 В | [VCV Rack](https://vcvrack.com/manual/VoltageStandards) |

**Сколько у других:** Kick — 4, Force — 4, Push 3 — 4 + 2, Live III — 8 сигналов, APC64 — 8, MPC XL — 16, BCR32 — 4 и Sync.

**Расчёт точности ЦАП для 1 В/окт** (диапазон 10 В, 1 В = 1200 центов):
- 16 бит: 10 В / 65 536 ≈ 0,153 мВ ≈ 0,18 цента — с запасом.
- 12 бит: 10 В / 4096 ≈ 2,44 мВ ≈ 2,9 цента — на грани слышимой расстройки в аккордах.

**Вывод:**
- 8 CV/Gate-выходов на 3,5 мм (как у Live III), ЦАП 16 бит, калибровка в софте, защита выходов.
- Переключаемые режимы: 1 В/окт или Гц/В, V-trig или S-trig.
- 2–4 CV-входа для модуляции наших параметров. У конкурентов это редкость.

### 4.3 Синхронизация

| Способ | Детали |
|---|---|
| MIDI-клок | 24 импульса на четверть |
| Аналоговый клок | KeyStep поддерживает: 1 импульс на шаг, 4 PPQ, ≈2 PPQ (Korg Volca), 24 PPQ (Roland TR-808), 48 PPQ (Linn LM-2) ([Arturia](https://support.arturia.com/hc/en-us/articles/4405741335954)) |
| Ableton Link | Темп, фаза, старт/стоп по локальной сети. Двойная лицензия: GPLv2+ или проприетарная ([GitHub](https://www.Github.com/Ableton/link)) |

**Вывод:**
- Clock In/Out 3,5 мм с выбором PPQ из списка выше.
- Link по Ethernet и Wi-Fi. Для открытого проекта подходит GPLv2+, для закрытого коммерческого понадобится лицензия Ableton.

---

## 5. USB, сеть, радио

### 5.1 USB-аудио к компьютеру

*Обновление 31.10.2026: после перехода на x86 Mini-ITX (R36) режим USB-гаджета недоступен — варианты в документе 19, раздел 9.*

У MPC — 24 канала в каждую сторону через USB-C, у Push 3 — 10 × 12 ([Gearnews](https://www.gearnews.com/akai-mpc-live-iii-review/), [Thomann](https://www.thomann.de/be/ableton_push_3_standalone_live_std.htm)).

На Linux устройство-гаджет UAC2 долго было ограничено 27 каналами. Патч июля 2026 года добавляет явное число каналов, проверено до 96 каналов на Pi Zero 2 W ([LKML](https://lkml.iu.edu/2607.3/09667.html)).

**Пропускная способность** (32 канала × 48 кГц × 32 бита):
- 32 · 48 000 · 32 = 49,2 Мбит/с в одну сторону, туда и обратно ≈98 Мбит/с.
- USB 2.0 High-Speed (480 Мбит/с) хватает.

У CM5 есть порт USB 2.0 ([CM5 brief](https://pip-assets.raspberrypi.com/categories/944-raspberry-pi-compute-module-5/documents/RP-008181-DS-10-cm5-product-brief.pdf)); работу в режиме устройства нужно проверить.

### 5.2 Хост, сеть и радио (вывод)

- 2–3 порта USB-A под контроллеры и флешки.
- Ethernet для Link и переноса файлов.
- Wi-Fi и Bluetooth через готовый сертифицированный модуль (документ 13). Bluetooth MIDI на Linux пока нестабилен по таймингу, обзор 2026 года называет джиттер 8–20 мс ([обзор](https://linuxdj-project.pages.dev/notes/midi-2-0-on-linux-2026-pipewire-ump-kernel-support-and-safe-fallbacks/)).

---

## 6. Хранилище

**Факты.**
- У Force частая причина потерянных файлов — извлечение накопителя без безопасного отключения (документ 04).
- NVMe на Pi 5 — 855 МБ/с, на N100 — 3,2 ГБ/с ([CNX](https://www.cnx-software.com/2024/04/29/raspberry-pi-5-intel-n100-mini-pc-comparison-features-benchmarks-price/)).

**Расчёты.**
- Запись 32 стереодорожек (48 кГц, 32 бит float): 32 · 2 · 4 Б · 48 000 ≈ 12,3 МБ/с — NVMe с огромным запасом.
- Буфер «всегда пишет» для входов (10 каналов, 60 с): 10 · 4 Б · 48 000 · 60 ≈ 115 МБ ОЗУ.
- Буфер Freeze для 16 стереодорожек по 30 с: 16 · 2 · 4 · 48 000 · 30 ≈ 184 МБ.
- При 8 ГБ ОЗУ это не проблема.

**Вывод:**
- Проекты всегда на внутреннем NVMe SSD.
- SD спереди и USB-флешки — только импорт и экспорт, с явной кнопкой «Извлечь».
- Журналируемая файловая система для внутреннего диска и сброс кэша перед извлечением съёмных.

---

## 7. Форматы

| Что | Формат | Комментарий |
|---|---|---|
| Внутренняя обработка | 48 кГц, 32 бит float | Zynthian оптимизирован под 48 кГц; на 96 кГц у Pi 5 резко растёт нагрузка ([Zynthian](https://discourse.zynthian.org/t/expected-latency-with-raspberry-pi-5-raspberry-pi-dac-pro-pianoteq-for-live-playing/13397)) |
| Импорт аудио | WAV, AIFF, FLAC, MP3, OGG | Типично |
| Экспорт аудио | WAV, FLAC; стемы по дорожкам | Отсутствие стемов и переноса в DAW ругают у MPC Sample ([MusicRadar](https://www.musicradar.com/music-tech/samplers/the-closest-thing-akai-has-released-to-a-vintage-mpc-in-decades-akai-mpc-sample-review)) |
| Перенос проекта в DAW | **DAWproject** — открытый формат; поддерживают Bitwig, PreSonus, Cubase 14; Pro Tools нет ([Production Expert](https://www.production-expert.com/production-expert-1/steinberg-joins-dawproject-support-can-avid-ignore-it)) | Сильный довод «DAW в железе». Формат Ableton Live закрытый; Move работает с проектами Live ([MusicTech](https://musictech.com/reviews/controllers/ableton-move-review/)), Force экспорт в Live обещал ещё на анонсе ([CDM](https://cdm.link/akai-force-hands-on-preview/)) |
| MIDI | Standard MIDI File | Типично |
| Вейвтейблы | WAV с кадрами по 2048 отсчётов (де-факто у Serum и Vital) | По общим знаниям; уточнить по документации синтов. 2048 при 48 кГц — это кадр 42,7 мс (основной тон ≈23,4 Гц) |
| Плагины | LV2 (как у Zynthian), CLAP (есть сборки под aarch64, например LSP), VST3 под Linux | LV2 и CLAP открытые и без лицензионных сложностей ([Alpine](https://pkgs.alpinelinux.org/package/v3.23/community/aarch64/lsp-plugins-clap)) |

**Вывод про вейвтейблы.** Чтобы сделать таблицу из захваченного звука, нужны:
1. определение высоты тона;
2. вырезание периодов;
3. пересэмплирование каждого периода в 2048 отсчётов.

Это ещё один аргумент за 48 кГц внутри и float без потерь.

---

## 8. Питание и земля

### 8.1 Бюджет мощности (оценка)

| Потребитель | Типично | Пик | Источник |
|---|---|---|---|
| Pi 5 / CM5 | ≈5 Вт | 8,8 Вт | [CNX](https://www.cnx-software.com/2024/04/29/raspberry-pi-5-intel-n100-mini-pc-comparison-features-benchmarks-price/) |
| Или x86 N100 | ≈10 Вт | 17–20 Вт | [CNX](https://www.cnx-software.com/2024/04/29/raspberry-pi-5-intel-n100-mini-pc-comparison-features-benchmarks-price/) |
| Экран 10,1″ | ≈4 Вт | ≈6 Вт | Оценка, уточнить по даташиту |
| Светодиоды (вариант A, ≈427 RGB) | ≈3,6 Вт | ≈24 Вт | Расчёт в документе 10 |
| Аналоговая часть, фантом, ЦАП CV | ≈4 Вт | ≈6 Вт | Оценка (фантом ≈1 Вт плюс потери) |
| NVMe SSD | ≈2 Вт | ≈4 Вт | Оценка |
| USB-устройства (контроллеры) | ≈3 Вт | 9 Вт | 2 × 900 мА × 5 В |
| Плата контроллера панели | ≈0,5 Вт | ≈1 Вт | Оценка |
| **Итого с Pi 5** | **≈22 Вт** | **≈59 Вт** | |
| **Итого с N100** | **≈27 Вт** | **≈70 Вт** | |

**Вывод:**
- Вход USB-C PD минимум 65 Вт, лучше 100 Вт (20 В × 5 А) и запасной разъём DC.
- Пик светодиодов ограничиваем в прошивке, тогда реальный пик заметно ниже.

### 8.2 Аккумулятор

**Расчёт.**
- Pi 5: 22 Вт × 3 ч ≈ 66 Вт·ч; N100: 27 Вт × 3 ч ≈ 81 Вт·ч.
- С запасом на пики и старение аккумулятора (× 1,2): 79–97 Вт·ч.
- Авиаправила (IATA) пропускают в ручной клади без согласования аккумуляторы до 100 Вт·ч (общеизвестное правило, уточнить перед поездкой). Значит, 3 часа укладываются в лимит, только если не раздувать потребление.

**Факт.** Регламент ЕС 2023/1542, статья 11: с 18 февраля 2027 года портативные батареи в изделиях должны сниматься и заменяться пользователем стандартным инструментом; запасные батареи — не меньше 5 лет после выпуска последнего изделия ([ComplianceGate](https://www.compliancegate.com/removable-and-replaceable-battery-requirements-european-union/)). Про музыкальные устройства отдельно не сказано.

**Вывод.**
- Аккумулятор — съёмный модуль до 99 Вт·ч, на 2,5–3 часа.
- Устройство полностью работает и без него, от USB-C PD или от внешнего пауэрбанка, как делают владельцы Force.

### 8.3 Земля и наводки

**Факты.**
- Гул MPC One при горящих пэдах и подключённом USB-устройстве (документ 10, раздел 4).
- Изоляторы от петель земли убирают гул, но, по словам пользователя, стоят 3–6 дБ уровня ([MPC-forums](https://www.mpc-forums.com/viewtopic.php?p=1810138)).
- Гул у пользователя Elektronauts давал встроенный USB-хаб монитора ([Elektronauts](https://www.elektronauts.com/t/ground-loop-on-usb-audio-interface/83459)).

**Вывод.**
- Балансные выходы.
- Раздельные ветки питания: цифра, светодиоды, аналог; общая точка земли.
- Подумать об изоляции USB-порта для подключения к компьютеру.
- Обязательный тест «ноутбук + контроллеры + всё горит» на макете.

## Открытые вопросы

1. ~~Усиление входа~~ — решено: энкодер с цифровым предусилителем.
2. ~~Сколько отдельных выходов~~ — см. документ 15: Main, Aux, RCA, 2 наушника.
3. Нужны ли встроенные динамики?
4. Bluetooth-аудиовход — интересно или лишнее?
5. Аккумулятор в первой версии или позже?
