MitjaGrecky/Shtuka-druka/docs/ru/03_doc_open_source_analysis.md

# Штука Дрюка: анализ открытых проектов

*27.10.2026. Основано на описаниях репозиториев и документации. Исходный код OTTO и Zynthian построчно не просматривался: GitHub закрыл автоматический доступ к дереву исходников. Код Behringer Kick (архив от пользователя) прочитан, но не собирался и не запускался.*

## Коротко

Целиком такого устройства (рабочий процесс как у MPC + студийные входы + фоно + CV + батарея) в открытом виде нет. Есть три близких проекта, у каждого можно взять отдельные части: OTTO (groovebox на Raspberry Pi, питание и архитектура), Zynthian (платформа для синтезаторов, управление энкодерами и кнопками), SamplerBox (минимальный сэмплер). Всё, что касается микрофонных преампов с фантомом, фонокорректора и CV, придётся делать самим. Дополнение: после появления Behringer Kick (ниже) открытая основа класса MPC всё же существует.

## OTTO

**Что это.** Открытый цифровой синтезатор, groovebox и процессор эффектов: сэмплер, секвенсор, мультидвижковый синтезатор и эффекты в одном корпусе. Статус: в разработке (WIP).

**Репозиторий (bitfieldaudio/OTTO).**
- около 2,8 тыс. звёзд, 151 форк, 1241 коммит, основная ветка develop, 19 открытых задач;
- язык C++ (примерно 97%), сборка CMake, каталоги boards, src, test, data, resources, scripts, cmake, external;
- активность в последнее время не проверял.

**Железо (отдельный репозиторий cester-ino/OTTO-hardware, KiCad, лицензия GPL-3.0).**
- главная плата: TFT-экран 2,8 дюйма (ILI9341), 4 нажимных энкодера, 40 функциональных кнопок, микроконтроллер STM32F103VET6, разъём GPIO для Raspberry Pi;
- плата питания: зарядка одной Li-Po ячейки (MAX8903A с управлением путём питания), повышающий преобразователь на 5 В 2 А (TPS61090), стабилизатор 3,3 В (XC6210), датчик заряда (MAX17048, по I2C), схема pi_power для безопасного включения и выключения;
- аудиоплата: кодек SGTL5000, электретный микрофон, усилитель динамика LM4860, линейный вход и выход (TRS), выход для наушников;
- клавиатура: 2 октавы и 16 клавиш снизу, 16 адресуемых RGB-светодиодов.

**Что можно взять.** Схему питания от аккумулятора с зарядкой, измерителем заряда и управляемым выключением как референс для этапа 3; идею модульности (отдельные платы); организацию ПО на C++ с раздельными движками.

**Ограничения.** Raspberry Pi 3B+ (устарела); кодек SGTL5000 потребительского уровня: нет XLR, фантома, фонокорректора, CV; проект WIP, возможна низкая активность.

## Zynthian

**Что это.** Открытая платформа для синтезаторов на Raspberry Pi и Linux, мультидвижковая и многотембровая. Схемы и спецификации опубликованы на GitHub, есть официальные наборы для сборки.

**Канонические требования к железу.** Raspberry Pi 3/4; поддерживаемая звуковая карта (ZynADAC, HiFiBerry и др.); экран (PiScreen, PiTFT, Waveshare, HDMI); 4 энкодера с кнопками; расширитель GPIO MCP23017; MIDI IN/THRU/OUT на UART (по желанию).

**Программная часть.** Интерфейс: Python (около 77%) и C++ (около 18%); библиотека zyncoder (кнопки, энкодеры, бесконечные потенциометры, аналоговые входы ADS1115, выходы на MCP); движки ZynAddSubFX, FluidSynth, setBfree, LinuxSampler, Sfizz, Dexed, OB-Xd, MOD-HOST и многие другие.

**Что можно взять.** Готовый образ ОС для проверки идей на Raspberry Pi; библиотеку zyncoder для энкодеров и кнопок; подход к открытым спецификациям железа.

**Ограничения.** Ориентирован на синтезаторы и пресеты, не на пэды и сэмплер-секвенсор в стиле MPC; нет студийной входной части, батарея не входит в базовую спецификацию; наличие и качество встроенного секвенсора не проверял.

## SamplerBox

Открытый DIY-сэмплер на Raspberry Pi: принимает MIDI и проигрывает wav-файлы. Экрана с редактированием как у MPC нет, и в FAQ проекта этот вопрос обсуждается отдельно. Полезен как пример минимального пути до первого звука, но не как база для нашего устройства.

## Сравнение

| Проект | Платформа | Сэмплер | Секвенсор | Экран | Аудиовход | Батарея |
|---|---|---|---|---|---|---|
| OTTO | Pi 3B+ | да | да | TFT 2,8" | линейный + микрофон | да (Li-Po) |
| Zynthian | Pi 3/4 | через движки | не проверял | да | зависит от карты | не в базовой спецификации |
| SamplerBox | Pi | да | нет | нет (LCD по желанию) | нет | нет в описании |

## Выводы (рекомендации)

1. Софт: не форкать проекты целиком, а брать идеи. Свой движок сэмплера и секвенсора на C++ и при необходимости готовые движки воспроизведения (sfizz, FluidSynth) для звука.
2. Питание: схему из OTTO использовать как референс на этапе 3.
3. Звук: SGTL5000 слабоват для наших целей; для микрофона, гитары и фоно нужны отдельные платы преампов и АЦП/ЦАП.
4. Управление: библиотека zyncoder и расширитель MCP23017 подходят для энкодеров и кнопок.
5. Делаем сами: фантомное питание, фонокорректор, CV и синхронизацию: в этих проектах ничего готового нет.

## Дополнение: Behringer Kick (26–27.10.2026)

**Что это.** Прототип автономной станции в формате MPC One. Music Tribe (Behringer) показала его 26.10.2026 и опубликовала исходники на GitHub (организация MusicTribeOpenSource). Цена и дата выхода не объявлены.

**Заявленное железо (по описаниям в прессе).** Сенсорный экран 7 дюймов, 16 RGB-пэдов в 8 банках, сенсорная полоса, 4 назначаемых регулятора, джог-колесо, камера для управления жестами; сэмплер с редактированием, шаговый секвенсор, лупер, более 300 встроенных эффектов; стереовходы и выходы, наушники, MIDI In/Out (5-pin), USB-A, USB-C, Ethernet, слот SD, 4 разъёма CV/Gate.

**Что опубликовано.** Приложение KICK для сенсорного экрана, аудиодвижок, протокол связи с железом и система сборки Linux. Лицензия AGPL-3.0 или новее.

**Почему важно.** Это первый открытый проект класса MPC на Linux. CV/Gate на борту подтверждает, что такое сочетание реально. Микрофонных преампов с фантомом, фонокорректора и батареи в описаниях нет. AGPL: для личного использования ограничений нет; при распространении изменённой версии или сетевом доступе к ней исходники нужно публиковать (не юридическая консультация).

## Разбор кода Behringer Kick (архив 0700-AAM-main)

*Прочитан исходный код из присланного архива. Сборка и запуск не выполнялись.*

**Состав репозитория.**
- Kick: приложение на C++ с JUCE (около 1870 файлов): интерфейс сенсорного экрана, движок проекта, настройки, отдельный процесс управления железом;
- AudIO: аудиодвижок (около 1300 файлов);
- ComProtocol: небольшой протокол пакетов между приложением и устройством по USB (заголовок, тип, данные, контрольная сумма), 6 файлов;
- Linux: образ на Buildroot для процессора NXP i.MX8M Mini (плата Variscite), ядро 5.15 с реальным временем, aarch64.

**Как устроено.**
- Приложение разделено на части: интерфейс, аудиодвижок и процесс управления железом, который публикует события от пэдов, ручек и светодиодов.
- Пэды, светодиоды и ручки подключены через отдельный контроллер по USB и протокол ComProtocol.
- CV и Gate управляются напрямую по I2C (устройство /dev/i2c-3), запись похожа на 12-битный ЦАП. Есть логика: нота в напряжение, gate, velocity, колесо модуляции, режим «последняя, высшая или низшая нота», калибровка.
- Есть сборка-симулятор (опция KICK_SIMULATOR, приложение kickem) и сборка VST-плагина (KICK_VST_PLUGIN). Интерфейс симулятора простой: отправить сообщение на железо и получить событие от железа. Это удобное место, чтобы подставить свой MIDI-ввод (например, MPD218).

**Аудиодвижок AudIO.** Граф из объектов с шинами и цепочками: осцилляторы, ADSR, микшер, воспроизведение, рекордер, синтезатор SoundFont, более 300 эффектов Airwindows (лицензия MIT), небольшой слой DAW. В коде осцилляторов только синус и белый шум, есть фильтр и LFO. Программы приложения: барабанная, клавиатурная (keygroup), клип и CV.

**Для интереса к синтезаторам.** Полноценных синтез-движков (субтрактивного, FM, вейвтейбла, модульного) в коде нет. Это основа для сэмплера, секвенсора и CV. Хостинга сторонних плагинов не найдено: движки пришлось бы добавлять самим, либо как отдельные программы через JACK и MIDI, либо как новые объекты AudIO.

**Что можно взять.** Интерфейс сенсорного экрана и логику сэмплера и секвенсора; логику CV и Gate как образец; набор эффектов Airwindows; идею разделения на интерфейс, движок и управление железом.

**Риски.** Код привязан к i.MX8M Mini и их контроллеру; зависимости загружаются при сборке (CPM); JUCE с патчем для мультитача; лицензия AGPL; в образе разработки у root нет пароля; из репозитория удалены заводские сэмплы и встроенный General MIDI SoundFont.

**Следующий шаг.** Собрать симулятор (kickem) на M93 под Ubuntu и посмотреть интерфейс и работу. После этого решить: брать Kick как основу или брать из него только идеи и отдельные части.
