MitjaGrecky/Shtuka-druka/docs/ru/04_doc_groovebox_reviews.md

# Штука Дрюка: что говорят пользователи о грувбоксах

*28.10.2026. Сводка по форумам и отзывам в магазинах: Akai MPC и Force, Synthstrom Deluge, Roland MC-707, Ableton Move, Elektron Digitakt II, Novation Circuit, 1010music Blackbox. Это мнения отдельных людей, выборка небольшая и смещена в сторону жалоб; часть проблем уже исправлена обновлениями.*

## Коротко

- Чаще всего ругают не нехватку функций, а сырое ПО: недоделанные функции, ошибки, непонятные сроки обновлений.
- Вторая главная жалоба: маленькие экраны и бесконечные меню.
- Хвалят ручки и фейдеры на каждый трек, быстрое сэмплирование, автоматизацию параметров по шагам, много разъёмов и быстрый экспорт в DAW.
- По наушникам: жалуются на расположение разъёма, хрупкость, шум и положение регулятора громкости. Отдельные регуляторы для мониторов и наушников в отзывах на грувбоксы прямо не встретились, это обычный стандарт для аудиоинтерфейсов, и решение выглядит разумным.

## Что люди хвалят

1. **Ручки и фейдеры на канал.** У Roland MC-707 отдельные канальные полосы с ручками и фейдерами; людям приятно играть руками, а не смотреть в экран.
2. **Быстрый отклик и простота.** Про Ableton Move пишут, что работа идёт быстро, сэмплирование удачное, а звук для портативного устройства хорош.
3. **Без компьютера.** Владельцы Deluge хвалят батарею, качество сборки и сетку как быстрый способ превратить луп в трек; владельцы MPC Live 2 встроенный динамик и батарею.
4. **Много разъёмов.** Для MPC Live 2 ценят шесть отдельных выходов на микшер, два MIDI DIN выхода, два USB-A и Ethernet.
5. **Автоматизация по шагам.** Параметр-локи и вероятность у Elektron стали отраслевым стандартом; у Deluge хвалят изменяемое разрешение шагов до 128 долей.
6. **Внешний вход в сэмплер.** MC-707 умеет сэмплировать и обрабатывать внешний стереовход; эффекты у него тоже хвалят.
7. **Вывод проекта в DAW.** У Move экспорт в Live называют одной из сильных сторон.
8. **Качество сборки и экран.** У Force хвалят материалы, сенсорный экран и разрешение.
9. **Регулярные обновления и отзывчивое сообщество.** По Roland, Ableton и Deluge это отмечают отдельно, а по MPC наоборот жалуются, что непонятно, когда и что добавят.

## Что считают лишним или раздражающим

- **Меню и маленькие экраны.** У MC-707 это главная жалоба, люди пишут, что хотели бы экран побольше или выход на монитор. У Digitakt II отмечают, что новая версия добавила меню, а не упростила.
- **Недоделанные функции.** У Force говорят, что функций много, но многие не доведены до конца и нестабильны. У MPC обсуждают недоделанные возможности автоматизации в автономном режиме и удалённые в последней версии функции.
- **Сложный вход и плохая документация.** Про Force и Deluge пишут о крутой кривой обучения, у Force отдельно ругают руководство.
- **Вес и размер.** Force весит около 4,5 кг, и ещё при запуске отмечали, что он не портативнее ноутбука с Push.
- **Цена премиум-моделей.** Владельцы старых поколений MPC пишут, что разница с новой моделью не оправдывает доплату.
- **Батарея.** У Move жалуются на время работы. Один владелец Blackbox, наоборот, ценит отсутствие встроенного аккумулятора, чтобы устройство не стало неработающим через несколько лет. У Force некоторые владельцы используют внешний пауэрбанк.
- **Цифровой характер звука.** У Deluge иногда пишут, что синтезаторы звучат холодно, а реверб металлично. У MC-707 синтезатор широкий, но не самый впечатляющий.

## Чего не хватает

- **Автоматизация и редактирование.** У Force нельзя автоматизировать темп; у MPC нет копирования отдельных нот и полноценного редактирования автоматизации без компьютера на ранних версиях.
- **Базовые удобства.** У MC-707 в отзывах не хватает режима песни, отмены действия и отсчёта перед записью; у MPC Live 2 владельцы скучают по отдельной кнопке редактирования программы.
- **Панорама, аранжировка, паттерны.** У Circuit панорама была самой запрашиваемой функцией; у Force аранжировщик обещали позже срока.
- **Ёмкость и лимиты.** Мало памяти сэмплера, строк клипов и полифонии (MC-707), четыре трека у Move.
- **Модуляции на каждый пэд.** В списке пожеланий владельцев Blackbox: запись движений ручек, огибающая и LFO на пэд, дисторшн и эквалайзер на пэд, вероятность на пэд, микротайминг.
- **Внешние контроллеры.** У Force жалуются на недостаточную поддержку сторонних контроллеров.
- **Сохранность данных.** У Force частая причина потерянных файлов: выдёргивание накопителя без безопасного извлечения.

## Наушники и громкость

Что нашлось про MPC:
- у MPC Live разъём наушников сзади справа, мини-джек 3,5 мм вместо 6,3 мм, и люди пишут, что хотели бы его спереди; также жалуются на хрупкую встройку разъёма;
- у MPC One жалуются на шум и щёлки в выходе наушников, на надёжность переднего мини-джека и на то, что регулятор громкости убран на заднюю панель.

Отдельных регуляторов для мониторов и наушников на грувбоксах я прямо не встретил. Это стандарт у аудиоинтерфейсов (например, у Volt 476 регулятор наушников независим), а у моделей без него (вроде Scarlett Solo) люди сталкивались с неудобством. Для нашего устройства это разумное решение, но как довод я его не считаю доказанным.

## Что это значит для нашего дизайна (рекомендации)

1. **Лицевая панель, звук.** Два отдельных регулятора: мониторы и наушники. Прочный выход наушников спереди, закреплённый на корпусе, 6,3 мм (или оба размера). Чистый усилитель наушников без шума от цифровой части.
2. **Большой экран и кнопки.** Отдельные кнопки для частых действий (сохранить, отменить, отсчёт, редактирование программы), чтобы не лазить по меню. Выход HDMI на внешний монитор остаётся.
3. **Ручки на канал и фейдеры.** 16 ручек справа от сетки и 4 фейдера закрывают то, что хвалят у MC-707.
4. **Параметр-локи и автоматизация как основа программы**, вместе с вероятностью, микротаймингом, панорамой, отменой, режимом песни, а не добавлять позже.
5. **Питание.** Поддержать USB-C PD и работу от внешнего аккумулятора (так делают владельцы Force). Встроенный аккумулятор сделать съёмным или отложить: аккумуляторы стареют.
6. **Стабильность важнее объёма.** Лучше меньше функций, но доведённых до конца; публичный план развития; автосохранение и безопасное извлечение накопителей прямо в интерфейсе.
7. **Звук.** Холодный цифровой характер указывают как слабое место многих устройств; качество вейвтейбла, фильтров и эффектов считать одной из главных задач.
8. **Вес и размер** не критичны для настольного устройства.
9. **Документация и встроенная справка.** Крутая кривая обучения частая жалоба; стоит заложить подсказки прямо на экране.

## Ограничения анализа

Большинство источников форумы и отзывы в магазинах, поэтому это не статистика. Часть материалов старая (2017–2019), и многие замечания могли быть устранены позже. Для уверенных выводов стоит пройтись по Reddit и форумам отдельно.

## Источники

- MPC-forums: https://www.mpc-forums.com/viewtopic.php?p=1745102 , https://www.mpc-forums.com/viewtopic.php?p=1855586 , https://www.mpc-forums.com/viewtopic.php?p=1730241 , https://www.mpc-forums.com/viewtopic.php?p=1901132 , https://www.mpc-forums.com/viewtopic.php?p=1771476
- Elektronauts, MPC thread: https://www.elektronauts.com/t/mpc-thread-mpc-live-mpc-x-mpc-one-part-2/173139?page=432
- Elektronauts, Force: https://elektronauts.com/t/akai-force/70106?page=96
- MusicRadar: Force review https://www.musicradar.com/reviews/akai-professional-force ; Force hands-on https://musicradar.com/news/namm-2019-hands-on-akai-force-standalone-music-production-system ; MC-707 review https://www.musicradar.com/reviews/roland-mc-707 ; Ableton Move review https://www.musicradar.com/music-tech/daws/for-some-move-might-prove-to-be-a-gamechanger-but-others-will-likely-struggle-to-fit-it-into-their-creative-workflow-ablet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 ; Digitakt II review https://musicradar.com/music-tech/samplers/an-all-round-upgrade-to-the-formula-of-the-original-but-its-unlikely-to-convince-any-sceptics-elektron-digitakt-ii-review
- Thomann reviews: Force https://thomannmusic.com/akai_force_reviews.htm?rating=3 ; MC-707 https://www.thomannmusic.com/roland_mc_707_reviews.htm ; Deluge https://www.thomannmusic.com/synthstrom_audible_deluge_reviews.htm ; Move https://www.thomannmusic.com/ableton_move_reviews.htm
- Equipboard, Deluge: https://equipboard.com/items/synthstrom-audible-deluge-64-voice-desktop-synthesizer-with-numeric-display
- 1010music forum, Blackbox: https://forum.1010music.com/forum/products/blackbox/wish-list-blackbox/41915-groovebox-capabilities
- Novation Circuit, Adorama: https://www.adorama.com/nocircuit.html
- Universal Audio, Volt 476 manual: https://help.uaudio.com/hc/en-us/articles/4409238196884-Volt-476-Hardware-Manual
- Amazon Q&A, Scarlett Solo: https://www.amazon.com/ask/questions/TxBQMJHRZVLD76
