MitjaGrecky/Shtuka-druka/docs/ru/05_panel_layout_draft.md

# Штука Дрюка: черновик лицевой панели (на 28.10.2026)

Вид сверху, устройство настольное и автономное (standalone), формат по образцу Akai Force. Это текстовое описание нарисованной схемы; схемы были построены в чате.

## Общая раскладка

- **Тыльная сторона (разъёмы):** XLR/TRS входы (микрофон с фантомом), вход фонокорректора, Hi-Z вход для гитары, CV/Gate, MIDI, USB, HDMI. Все кабели сзади, чтобы не мешали рукам.
- **Над экраном:** ряд из 8 энкодеров с подсветкой (кольцо светодиодов).
- **По центру сверху:** сенсорный экран 10 дюймов, 1280×800.
- **Под экраном:** сетка пэдов 8×8 с RGB-подсветкой; справа от неё колонка из 8 кнопок сцен.
- **Справа от сетки:** по 2 ручки на каждую строку (16 ручек): громкость, панорама или назначаемые параметры; подсветка колец и подпись на экране.
- **Справа вверху:** 4 фейдера.
- **Слева:** кнопки транспорта, режимов, Undo/Save, навигации (колесо или энкодер).
- **Слева ниже:** две отдельные ручки: громкость мониторов и громкость наушников.
- **Передняя кромка слева:** два выхода наушников 6,3 мм (прочно закреплены на корпусе).

## Откуда что взято

- Сетка 8×8 вместо 64 + 16 пэдов: от пользователя и из логики использования (барабаны, ноты по тональности, шаговый секвенсор, запуск клипов).
- Ручки по строкам, энкодеры и фейдеры: пожелание пользователя (по образцу Launch Control XL 3 и BCR32).
- Отдельные громкости мониторов и наушников, выходы наушников спереди, кнопки Undo/Save: из анализа отзывов о грувбоксах (документ 04).

## Архитектура управления

- Все ручки, кнопки, фейдеры, сетка и светодиоды обслуживаются отдельной платой на микроконтроллере (RP2040, STM32 или Teensy), которая определяется как USB-MIDI устройство. Главный компьютер видит MIDI и не зависит от конкретной модели контроллера (тот же принцип у Behringer Kick). Внешние MPD218, Push, Launchpad подключаются тем же путём.
- Энкодеры и кнопки через расширители портов (например, MCP23017), светодиоды через драйверы.
- На первом этапе сетку лучше брать готовую внешнюю (у пользователя есть Push и Circuit), свою сетку делать позже: это самое трудоёмкое место по железу.

## Открытые вопросы по панели

- Нужны ли фейдеры справа (4 шт.) или заменить их клавишами/полосой для игры мелодий?
- Сколько ручек в минимальной версии: 8 или 16?
- Где размещать USB-A и слот SD (на боку или спереди)?
