MitjaGrecky/Shtuka-druka/docs/ru/06_ergonomics_research.md

# Штука Дрюка: эргономика грувбоксов — что нужно, что полезно, что лишнее

*28.10.2026. Дополняет документ 04 (отзывы). Здесь только новый материал: SP-404 MK2, Octatrack, EP-133, Polyend Play/Play+, MPC XL и Live III, Digitakt II, Model:Samples, Push 3, Maschine+, Deluge. Фактами считаются пересказы обзоров и постов; пометка «вывод» означает мой вывод, а не слова источника.*

## Ограничения исследования

- Большинство источников это обзоры изданий (MusicRadar, Sound on Sound, MusicTech, Attack, Audiofanzine, Engadget) и блоги музыкантов (Loopop, Sunwarper). Голос практикующих исполнителей прямо слышен в немногих местах: пост Sunwarper про SP-404 MK2 «через пять лет», обзор Octatrack «на восьмом году» (Loopop), отдельные посты на Elektronauts, мнение пользователя в обзоре Audiofanzine.
- Reddit и Gearspace через мои инструменты не открылись. Часть веток Elektronauts подгрузилась только первым постом. Так что статистики нет, есть повторяющиеся наблюдения.
- Цифры (время работы, секунды Skip Back, число пэдов) взяты из обзоров на момент написания и могут отличаться после обновлений прошивок.

## Сводка по устройствам

| Устройство | Что хвалят | Что ругают | Что берём себе (вывод) |
|---|---|---|---|
| Roland SP-404 MK2 | Looper без заданного BPM; Skip Back (запись последних секунд игры в пэд); шесть кнопок прямых эффектов; OLED с волной упрощает нарезку; Sound generator и ресэмплинг в поздних прошивках; «не лучший в чём-то одном, но всё делает достаточно хорошо» | «Почти всё завязано на комбинации кнопок»; вложенные меню; нет параметр-локов по шагам, нет фильтра на пэд; эффекты «не тонкие» | Всегда включённый буфер Skip Back, looper, эффекты на отдельных кнопках; комбинации кнопок избегать |
| Elektron Octatrack | Кроссфейдер между 16 сценами (уровни, фильтры, скорости, глубина LFO); запись, ресэмплинг и зацикливание встроены в процесс; два эффекта на трек | Высокая кривая обучения («цена гибкости — сложность»); путаница между ручкой Level и энкодером A | Сцены + кроссфейдер как главный инструмент импровизации; органы управления группировать и подписывать |
| Teenage Engineering EP-133 | Быстрый результат; 12 мгновенных перформанс-эффектов (реагируют на силу нажатия, комбинируются, режим Loop); режим Commit; все разъёмы сверху | Сэмплирование требует двух рук (пэд + гейн); нельзя сэмплировать во время воспроизведения и ресэмплить внутри; один мастер-эффект; трёхсимвольный экран | Захват одной рукой, ресэмплинг без остановки, перформанс-эффекты по силе нажатия |
| Polyend Play / Play+ | Режим Perform: сетка пэдов превращается в панель эффектов (моментально или с защёлкой); низкопрофильные RGB-пэды удобно «гладить» пальцем | Сенсорные энкодеры с двумя функциями легко переключаются случайным касанием; пэды без velocity; у Play+ нет аудиовхода, у синтов «нет настоящего тактильного управления», параметры на экране не подписаны | Перформанс-режим на сетке; сенсорность энкодера использовать для подсветки значения, а не для смены режима; подписи параметров на экране |
| Akai MPC XL / Live III | Q-Link-ручки над шаговыми кнопками; пэды MPCe (3D: положение и давление) «a joy to play»; 16 физических шаговых кнопок; предусилители, фантом 48 В, CV/Gate | «Много сочетаний клавиш»; непоследовательная логика экранов (Main, Grid, Program Edit, Mixer); сенсорная правка не всегда удобна; навигационный энкодер XL без клика | Давление и положение пальца на пэдах; одна логика во всех экранах; энкодер с кликом |
| Elektron Digitakt II | Классика: 8 энкодеров справа от экрана, ряд кнопок снизу; «очень playable»; запись через линейный вход | «Самые дребезжащие кнопки на свете»; выбор модуляции из длинного списка; нельзя выбрать вход при сэмплировании | Раскладка «экран + 8 энкодеров» проверена; качество механики кнопок важно |
| Elektron Model:Samples | Около 12 выделенных ручек, подписанных по функции; быстрый доступ к основному | Часть параметров под второй страницей; кнопки слабо чувствительны к давлению; нет огибающей | Выделенные ручки на базовые параметры звука |
| Ableton Push 3 | Пэды MPE (скорость, давление, X/Y); большое джог-колесо; ручки темпа и громкости с вторым назначением (swing, наушники) | Браузер лупов неудобен без избранного; перенос сэмплов между режимами; аккумулятор около 2–2,5 ч; нет предусилителя | Джог-колесо; удобный браузер сэмплов с избранным |
| Synthstrom Deluge | Контекстная панель ручек; сетка 8×16 как «играешь, а не программируешь» | Абстрактный рабочий процесс, порог входа | Контекстные ручки: допустимо, но подсказки обязательны |
| NI Maschine+ | Энкодеры под экранами, приятная механика | Беден вводом-выводом; правка некоторых движков вслепую («blind knob-twiddling») | Если ручка управляет непонятным параметром, она бесполезна |

## Что показало исследование (по темам)

### 1. Ручки против меню

- Практики сходятся в одном: главное не количество ручек, а чтобы часто нужные параметры не прятались. Пример: Model:Samples с ~12 подписанными ручками хвалят за быстрый доступ.
- Раздражают меню и неподписанные комбинации кнопок: «Anything with too many menus and options is an automatic no» (Elektronauts), «Almost everything is tied to button combinations» (Sunwarper про SP-404).
- Ручка без видимой подписи бесполезна: у Play+ параметры синтов на экране не подписаны, у Maschine+ правка идёт «вслепую».
- Вывод: ручки группировать по смыслу, подписывать на экране и на подсветке; частые действия выносить на кнопки.

### 2. Энкодеры и потенциометры

- Для всего, что автоматизируется или меняется страницами, нужны энкодеры (с кольцом светодиодов): потенциометр не показывает значение после смены страницы. В Elektron и Push 3 так и сделано. Источников с аргументами «за потенциометр» нашёл мало: на форуме Renoise пишут, что потенциометры хороши для постоянных параметров вроде громкости.
- Вывод: энкодеры с кольцами для всего «страничного»; потенциометры или фейдеры только для того, что всегда делает одно и то же (мастер, мониторы, наушники, вход).
- Сенсорность энкодера: у Polyend Play случайное касание переключает режим, и автор отключил жест. Вывод: касание только подсвечивает значение, но не меняет режим.

### 3. Перформанс-эффекты — самое ценное для нашей концепции

- SP-404 MK2: шесть кнопок прямых эффектов (переназначаемые), Skip Back, looper.
- EP-133: 12 «punch-in» эффектов на кнопках, реагируют на силу нажатия, режим Loop; SoS: чаще всего вернулся бы именно к нему.
- Polyend Play: Perform-режим на сетке, в Play+ MusicRadar назвал его одной из лучших функций.
- Octatrack: сцены и кроссфейдер, плавное смешивание двух наборов настроек.
- Вывод: для идеи «добыть звук и играть фильтрами и эффектами» это ядро интерфейса. Достаточно небольшого числа хороших эффектов (Engadget: большинство эффектов SP-404 «не тонкие»). У EP-133 всего один мастер-эффект с двумя параметрами, и SoS называет это ограничением, но при этом именно к нему рецензент вернулся бы чаще всего: быстрота и перформанс-эффекты перевесили.

### 4. Захват звука

- SP-404 MK2: запись последних секунд игры «в пэд» (Skip Back: 25 с по Engadget на запуске, до 40 с по Sunwarper после обновлений), looper, ресэмплинг, эффекты на входе (вокодер, автотюн, усилитель).
- Octatrack: встроенные запись и ресэмплинг. Автор называет это ключевым преимуществом.
- Слабые места: EP-133 не умеет сэмплировать во время воспроизведения и ресэмплить, нужны две руки; Digitakt II не даёт выбрать вход, моно пишется в стерео; Play+ без аудиовхода; Push 3 без предусилителя.
- Вывод: нужен буфер, который пишет всегда; захват одной кнопкой; выбор источника отдельной кнопкой; ресэмплинг без остановки игры.

### 5. Пэды

- Хвалят: давление и положение пальца (MPCe, Push 3 MPE). Ругают: отсутствие velocity (Play), слабая чувствительность кнопок (Model:Samples).
- Вывод: если сетка собственная, она должна различать силу нажатия; давление (aftertouch) желательно.

### 6. Фейдеры и кроссфейдер

- Прямых отзывов о пользе четырёх фейдеров на грувбоксах в найденном почти нет. У EP-133 один фейдер на отправку группы в эффект; у MC-707 (документ 04) канальные ручки и фейдеры хвалят.
- Единственный хорошо задокументированный ползунок для импровизации — кроссфейдер Octatrack.
- Вывод: 4 фейдера из черновика ничем не подтверждены; один кроссфейдер между сценами подтверждён лучше.

### 7. Экран

- Волна на экране сильно упрощает нарезку (Engadget про SP-404). Сенсорный экран хорош для выбора и волны, но не для точной правки (Audiofanzine про Live III).
- Вывод: сенсор для навигации, волны и браузера; параметры в реальном времени только руками.

### 8. Механика и сборка

- Digitakt II ругают за дребезжащие кнопки, Push 3 и MPC хвалят за прочность и хорошие пэды.
- Вывод: качество кнопок и пэдов закладывать в бюджет; на прототипе брать готовые.

### 9. Простота

- «Не лучший сэмплер, секвенсор или лупер, но всё делает достаточно хорошо» (Sunwarper про SP-404 MK2) — и он купил бы снова.
- Автор Elektronauts: «more options = better — иллюзия», любит 303/707 за ограничения.
- Вывод: лучше меньше функций, но доведённых; вместе с документом 04 это ключевой урок.

## Классификация (вывод)

| Класс | Элементы |
|---|---|
| Нужно (подтверждено несколькими источниками) | Экран + ряд из 8 энкодеров с кольцами; клик у навигационного энкодера; кнопки Undo, Save, Capture; захват всегда включённым буфером; looper; перформанс-эффекты на кнопках или сетке; ресэмплинг; отдельные громкости мониторов и наушников; velocity на пэдах; подписи параметров на экране |
| Полезно | Кроссфейдер и сцены; джог-колесо; 4–6 выделенных ручек «звука» (фильтр, резонанс, drive, delay, reverb); давление на пэдах; сенсорная полоса; браузер сэмплов с избранным; автосохранение |
| Спорно (мало подтверждений) | 16 ручек по строкам сетки; 4 фейдера; сенсорные энкодеры с жестами; встроенный аккумулятор |
| Лишнее для нас | Сетка 64+16 пэдов; сотни эффектов вместо десятка хороших; режимы, зависящие от неподписанных комбинаций кнопок; несколько экранов с разной логикой |
| Нет данных | Влияние числа ручек на скорость работы; реальная польза панорамы на каждую строку |

## Что это значит для «импровизации из всего вокруг»

1. Устройство должно уметь слушать: микрофон, линия, фонокорректор, гитара, внутренние осцилляторы и собственный выход, всё выбирается одной кнопкой.
2. Буфер Skip Back пишет всегда: сыграл, понравилось, нажал Capture, и это уже сэмпл или цикл.
3. Дальше звук идёт в перформанс-слой: фильтр, delay, reverb, drive, статтеры; сцены с кроссфейдером для плавных переходов.
4. Секвенсор, пэды и сетка вторичны: они нужны, чтобы повторить найденное, а не чтобы его добывать.

## Открытые вопросы

- Один мастер-эффект с punch-in (как EP-133) или два эффекта на трек (как Octatrack): нужна проба.
- Сколько ручек «звука» нужно постоянно под рукой: 4, 6 или 8.
- Нужны ли панорама и громкость на каждую строку, или хватит режима микшера на энкодерах.
- Нужен ли кроссфейдер, или сцены переключаются кнопками.

## Источники

- [SP-404 MK2, Engadget](https://www.engadget.com/roland-sp-404-mkii-hands-on-dragging-an-iconic-sampler-into-the-modern-age-070043439.html) · [SP-404 MK2 через пять лет, Sunwarper](https://www.sunwarper.com/post/sp404-mk2-almost-5-years-later-still-worth-it)
- [Octatrack на восьмом году, Loopop](https://loopopmusic.com/?p=545) · [Octatrack MKII, Micro Genre](https://microgenremusic.com/elektron-octatrack-mkii-manual-and-overview/)
- [EP-133, Sound on Sound](https://www.soundonsound.com/reviews/teenage-engineering-ep-133-ko-ii?amp)
- [Polyend Play, Sound on Sound](https://www.soundonsound.com/reviews/polyend-play) · [Polyend Play+, MusicRadar](https://www.musicradar.com/reviews/polyend-play-review)
- [MPC XL, MusicRadar](https://www.musicradar.com/music-tech/samplers/a-machine-worthy-of-building-your-whole-workflow-around-akai-mpc-xl-review) · [MPC Live III, Audiofanzine](https://en.audiofanzine.com/sampling-sequencer/akai/mpc-live-3/editorial/reviews/review-of-the-akai-mpc-live-iii.html)
- [Digitakt II, Sound on Sound](https://www.soundonsound.com/reviews/elektron-digitakt-ii) · [Digitakt II, MusicTech](https://musictech.com/reviews/hardware-instruments/elektron-digitakt-ii-review)
- [Model:Samples, Attack Magazine](https://www.attackmagazine.com/reviews/gear-software/elektron-modelsamples/)
- [Push 3 standalone, Magnetic](https://magneticmag.com/2024/02/push-3-standalone-review/) · [Push 3, MusicRadar](https://www.musicradar.com/reviews/ableton-push-3)
- [Deluge, CDM](https://cdm.link/in-deep-with-the-synthstrom-deluge-synth-sampler-sequencer/)
- [Maschine+, MusicRadar](https://www.musicradar.com/reviews/native-instruments-maschine)
- Elektronauts: [I Hate Fiddly Instruments](https://www.elektronauts.com/t/i-hate-fiddly-instruments/194286) · [Elektron interfaces are unnecessarily difficult](https://www.elektronauts.com/t/elektron-interfaces-are-unnecessarily-difficult/168607?page=9)
- Renoise: [энкодеры и потенциометры](https://forum.renoise.com/t/midi-controller-knobs-encoders-vs-potentiometers/46870)
