MitjaGrecky/Shtuka-druka/docs/ru/07_panel_layout_v2.md

# Штука Дрюка: макет лицевой панели v2 («захват и перформанс»)

*Дополнение: в документе 08 уточнены кнопки (колонка справа от сетки — кнопки дорожек, а не сцен; Commit → Freeze; четыре страницы вместо ряда режимов). Черновик следующей версии макета (v3) — в документе 13, текущие решения — в журнале 14.*

*28.10.2026. Заменяет черновик v1 (документ 05) после исследования эргономики (документ 06). Концепция: добыть звук любым способом, потом играть с фильтрами и эффектами. Строки с пометкой «вывод» — мои решения из выводов исследования, их можно оспаривать.*

## Что изменилось по сравнению с v1

| Блок | v1 | v2 | Почему |
|---|---|---|---|
| Захват звука | не было отдельного блока | Отдельный блок слева: кнопка Capture (буфер пишет всегда), 5 кнопок источника, ручка входного усиления, кнопка Commit (ресэмплинг) | Skip Back и ресэмплинг подтверждены как самые ценные функции для импровизации (SP-404 MK2, Octatrack, EP-133); захват одной рукой закрывает жалобу на EP-133 |
| Перформанс | 4 фейдера справа | Кроссфейдер между сценами + 6 выделенных ручек звука (фильтр, резонанс, драйв, дилей, реверб, питч) | Подтверждений пользы 4 фейдеров почти нет; кроссфейдер Octatrack и выделенные ручки (Model:Samples) подтверждены |
| Ручки по строкам | 16 (2 на строку) | 8 (уровень на строку) в фазе 1; вторая колонка (панорама) в фазе 2 | Нет данных, что 16 нужны; 8 закрывают микшер |
| Энкодеры над экраном | 8 с подсветкой | 8 с кольцами, подписи на экране; касание только показывает значение | Раскладка «экран + 8 энкодеров» проверена; в Polyend случайное касание переключало режим |
| Навигация | «колесо или энкодер» | Колесо с кликом | Push 3 хвалят за колесо; у MPC XL энкодер без клика ругают |
| Сетка | 8×8 | 8×8, нужны velocity и давление; режимы: Pads, FX (Perform), Step, Notes, Slice | Perform на сетке у Polyend и пэды MPCe/MPE хвалят |
| Звук | мониторы и наушники отдельно | без изменений | Остаётся из документа 04 |

## Раскладка (вид сверху)

- **Тыл:** все разъёмы: XLR/TRS (микрофон с фантомом), фоно, Hi-Z гитара, CV/Gate, MIDI, USB, HDMI.
- **Передняя кромка слева:** два выхода наушников 6,3 мм, прочно закреплённые.
- **Над экраном:** 8 энкодеров с кольцами.
- **По центру:** сенсорный экран 10″ (волна, браузер сэмплов с избранным, подписи параметров).
- **Под экраном:** ряд режимов сетки (Pads, FX, Step, Note, Slice), под ним сетка 8×8.
- **Справа от сетки:** колонка из 8 кнопок сцен и 8 ручек уровня.
- **Слева:** блок «Захват» (Capture, источник, усиление, Commit), под ним транспорт, Undo/Save, колесо с кликом, ручки мониторов и наушников.
- **Справа сверху:** блок «Перформанс» (кроссфейдер, 6 ручек звука).

## Поток сигнала (вывод)

1. Источники: микрофон, линия, фоно, гитара, внутренние генераторы, ресэмплинг собственного выхода. Выбор одной кнопкой.
2. Буфер пишет всегда (как Skip Back у SP-404 MK2; длина 25–40 с в разных обзорах, мы выберем сами).
3. Capture сохраняет последние секунды в сэмпл, цикл или заготовку вейвтейбла.
4. Звук идёт на сетку (играть) и в перформанс-слой: фильтр, дилей, реверб, драйв, питч; сцены и кроссфейдер переключают наборы настроек.
5. Commit записывает результат обратно в сэмпл (ресэмплинг без остановки игры).

## Прототип на имеющейся базе

Предположения: модель Push и особенности его работы с Linux нужно проверить; AudioFuse используем как временный тракт.

| Блок v2 | Чем заменить сейчас | Что проверить |
|---|---|---|
| Хост (софт, буфер, эффекты) | Lenovo M93 | Нагрузка при буфере + эффектах + пара движков |
| Входы и предусилители | Arturia AudioFuse (запас: Steinberg CI2) | Какие входы доступны, задержка под Linux |
| Сетка 8×8 + 8 энкодеров | Ableton Push (если подходит) | Работает ли с M93 без Live; иначе MPD218 как временная замена |
| Сцены, кроссфейдер, макро-ручки | MPD218 (16 пэдов, ручки с банками) | Хватит ли ручек; кроссфейдер эмулировать ручкой |
| Внешний источник звука и такт | Novation Circuit | Синхронизация по MIDI |
| Фоно, наушники, свои платы | Фаза 2–3 | После выбора платформы |

## Последовательность работ (вывод)

1. Фаза 1: софт-прототип «Capture + буфер + 3 эффекта + сцены» на M93 с имеющимися контроллерами. Это проверяет идею, не требуя железа.
2. Фаза 2: Pi 5 или x86 мини-ПК, экран 10″, контроллерная плата (RP2040/STM32/Teensy) с 8 энкодерами и 6 ручками звука, сетка внешняя.
3. Фаза 3: свои платы (преампы, фоно, CV, питание) и собственная сетка с давлением.

## Открытые вопросы

- Кроссфейдер нужен физически или достаточно кнопок сцен?
- 6 ручек звука: это фиксированный набор или переназначаемый?
- Какие 3 эффекта делаем первыми: фильтр, дилей, реверб или драйв?
- Какая модель Push и подходит ли она для прототипа?
- Сколько секунд буфера нужно?
