MitjaGrecky/Shtuka-druka/docs/ru/09_controls_research.md

# Штука Дрюка: органы управления — энкодеры, навигация, кнопки, сетка, 16 дорожек

*28.10.2026. Исследование по запросу «цепляться за всё». Опирается на документы 04, 06, 08. Обозначения: **факт** — из источника (ссылка рядом), **вывод** — моя инженерная логика, **решено** — решение пользователя. Журнал всех решений — документ 14.*

## Решения пользователя, от которых здесь отталкиваемся

- **Решено:** бесконечные энкодеры везде, кроме громкостей.
- **Решено:** громкость мониторов и наушников — обычные потенциометры с упорами («конечные и понятные»).
- **Решено:** отдельная ручка навигации по меню и экрану обязательна.
- **Решено:** дорожек не меньше 16; вычисления закладываем на 32, цель 64.
- **Решено:** подсветка RGB везде на уровне железа (подробно в документе 10).
- **Решено (28.10, после этого исследования):** усиление входов — энкодеры с цифровым предусилителем; пользователь правша, колесо навигации справа; экран с фиксированным наклоном около 30°.
- **Решено предварительно:** сетка 8×8, вариант A: окно из 8 дорожек, которое стрелки сдвигают по одной дорожке (раздел 6.3).

---

## 1. Энкодеры

### 1.1 Почему бесконечные — правильно (вывод, с опорой на источники)

У нас ручки меняют смысл при смене страницы и дорожки. Потенциометр помнит физическое положение, и после переключения его значение «прыгает». Энкодер с кольцом светодиодов показывает реальное значение параметра. На форуме Renoise это сформулировано так: потенциометры хороши для параметров, которые не меняются динамически, например для громкости в миксере ([Renoise](https://forum.renoise.com/t/midi-controller-knobs-encoders-vs-potentiometers/46870)). Это ровно наше разделение: громкости — потенциометры, всё остальное — энкодеры.

### 1.2 Типы энкодеров

| Тип | Как работает | Ресурс | Ощущение | Риски | Где встречается |
|---|---|---|---|---|---|
| Механический инкрементальный (Alps EC11/EC12, Bourns PEC11/PEC16) | Контакты скользят по дорожкам | Alps EC12E: 15 000 оборотов ([atosynth](https://atosynth.blogspot.com/2020/03/uifront-panel-design-living-post.html?m=1)). Grayhill: при интенсивной нагрузке механические могут отказать около 30 000 циклов ([Grayhill](https://grayhill.com/blog/does-a-1-million-cycle-encoder-really-last-a-million-cycles/)) | С фиксацией или гладкий | Износ контактов → «прыжки» и пропуски значений | Elektron, большинство контроллеров |
| Оптический (Grayhill 62A/62S) | Свет через светопровод, без трения | 1 млн циклов, где цикл — полный оборот туда и обратно ([Grayhill](https://grayhill.com/blog/does-a-1-million-cycle-encoder-really-last-a-million-cycles/)) | Стабильное весь срок | Цена, размер | Промышленность |
| Магнитный (датчик Холла класса AS5600, 12 бит) | Магнит на валу и датчик под ним | Контактного износа нет, ресурс определяет подшипник | Любое, обычно без фиксации | Своя механика и калибровка | Самодельные контроллеры |
| Бесконечный потенциометр (Alpha RV112FF) | Две резистивные дорожки со сдвигом | 15 000 оборотов ([atosynth](https://atosynth.blogspot.com/2020/03/uifront-panel-design-living-post.html?m=1)) | Гладкое, высокое разрешение | Износ дорожек, нужен АЦП | Некоторые синтезаторы |

Оговорка: у Grayhill это маркетинговый текст, и производители считают «цикл» по-разному. Одни считают один щелчок, Grayhill считает полный оборот туда и обратно. Поэтому цифры разных производителей напрямую сравнивать нельзя.

**Факты об отказах в реальных устройствах:**
- Octatrack MK1: чаще всего ломаются самые используемые энкодеры. Внутри изгибаются контакты, и значения начинают прыгать. Чинят подгибанием контактов или заменой на Bourns PEC16-4020F-S0024 (около $1,38). Выпаивать старые трудно ([Elektronauts](https://www.elektronauts.com/t/octatrack-mki-encoder-issue-jumping-values/65573?page=2)).
- Octatrack MK2: пропуски значений после недель простоя, которые проходят после пары минут вращения ([Elektronauts](https://www.elektronauts.com/t/occasionally-skipping-encoder-values-on-mk2/255985)).
- Model:Samples: энкодер начал тормозить и пропускать значения, Elektron прислала замену (январь 2026, [Matrixsynth](https://www.matrixsynth.com/2026/01/elektron-model-samples-encoder-repair.html)).
- Push 2: ручки сами меняли параметры. Пользователи связали это с заземлением и сенсором касания; помогали резиновый коврик под ногами и замена переходника USB-C ([Ableton forum](https://forum.ableton.com/viewtopic.php?p=1758502)).
- BCR2000: у одного пользователя энкодеры быстро ломались ([Ableton forum](https://forum.ableton.com/viewtopic.php?p=1306090)).

**Вывод.** При 25–33 энкодерах механический износ — главный риск надёжности всего устройства. Что из этого следует:
1. Энкодеры ставим на небольшие сменные платы по группам (по 4–8 штук), а не на одну большую. Изношенную группу можно поменять, не выпаивая всё.
2. Для самых нагруженных (8 под экраном и навигация) рассматриваем оптические или магнитные. Для остальных — механические с ресурсом, проверенным по даташиту. При выборе спрашиваем у поставщика, как он определяет цикл.
3. В прошивке: правильная машина состояний для квадратуры, фильтр дребезга, защита от одиночных ложных шагов.
4. Заземление и экранирование сенсоров касания проектируем сразу, чтобы не получить эффект Push 2.

### 1.6 Цены и выбор после R28 (31.10.2026)

- Оптический Grayhill 62A11-02-040C: от ≈$48 за штуку в TME до ≈$91–128 у других дистрибьюторов ([Octopart](https://octopart.com/part/grayhill/62A11-02-040C)). На 9 энкодеров ≈$430 и больше.
- Готовый магнитный энкодер Bourns EMS22A (абсолютный, 10 бит) продаётся в рознице ([DigiKey](https://www.digikey.com/en/products/detail/bourns-inc/EMS22A30-C28-MS6/3693518)); цену уточнить.
- Самодельный магнитный на датчике AS5600 — дешёвый, но нужна своя механика (вал, подшипник, магнит).

**Вывод (P40).** Для некоммерческого проекта (R28): механические гладкие энкодеры на сменных платах по группам (P11), колесо навигации — магнитное на AS5600 (оно самое нагруженное и большое, своя механика оправдана). Магнитная плата для 8 главных — апгрейд позже с тем же разъёмом и крепежом.

### 1.3 Щелчки (фиксация): по ролям

| Роль | Фиксация | Почему |
|---|---|---|
| 8 энкодеров параметров (под экраном) | Без фиксации | Щелчковые энкодеры OP-XY, по SoS, делают настройку синтезатора ступенчатой ([SoS](https://www.soundonsound.com/reviews/teenage-engineering-op-xy?amp)). Практики на DJ TechTools: для фильтров и эффектов лучше гладкие ([DJTT](https://forum.djtechtools.com/t/am-i-the-only-one-who-hates-notched-encoders/45779)) |
| 6 макро-энкодеров звука | Без фиксации | Перформанс, плавные свипы |
| 16 энкодеров уровня | Без фиксации, с режимом точной настройки | Уровни ставят точно, но плавно |
| Навигация | С фиксацией (около 24 на оборот) | Списки дискретны; щелчки уместны для навигации и выбора ([DJTT](https://forum.djtechtools.com/t/am-i-the-only-one-who-hates-notched-encoders/45779)) |
| Усиление входа (если будет энкодер) | С фиксацией, 1 щелчок = 1 дБ | Цифровой предусилитель PGA2500 меняет усиление шагами по 1 дБ ([TI](https://www.ti.com/product/pga2500)), щелчок совпадает с шагом |

Тугость тоже важна. Энкодеры LCXL3 обозреватель назвал слишком тугими для живого управления фильтром ([Attack](https://www.attackmagazine.com/reviews/gear-software/novation-launch-control-xl-3/)). Жёсткие конические колпачки Force неудобно вращать ([Bonedo](https://www.bonedo.de/artikel/akai-force-test/)).

### 1.4 Разрешение и ускорение

**Факт.** Пользователи Push жалуются на 128 шагов: значения отправки скачут примерно на 0,3 дБ. Просят регулировку чувствительности, ускорение по скорости вращения и точный режим (по моду Shift + поворот, примерно в 10 раз точнее) ([Ableton forum](https://forum.ableton.com/viewtopic.php?p=1610286)).

**Вывод: правило для всех энкодеров.**
- Внутреннее разрешение параметра не меньше 1024 шагов, а лучше хранить значение в float. MIDI-ограничение в 128 шагов внутри устройства не нужно.
- Скорость: N_об = S / (C · k), где S — шагов на весь диапазон, C — отсчётов на оборот, k — коэффициент ускорения.
  - Пример: энкодер 24 импульса/оборот в квадратуре даёт C = 96. При S = 1024 и k = 1 получаем 1024 / 96 ≈ 10,7 оборота — медленно.
  - С ускорением до k = 8 при быстром вращении: 1024 / (96 · 8) ≈ 1,3 оборота — удобно.
- Точный режим: нажать энкодер и крутить, тогда k = 1/4. Экран это показывает. Это не «скрытая комбинация» в смысле документа 08: удержание видно на экране.

### 1.5 Касание (сенсорные энкодеры)

**Факты.**
- Сенсорные энкодеры есть у Push, Maschine, Force и Move: у Move 9 штук высокого разрешения ([MusicTech](https://musictech.com/reviews/controllers/ableton-move-review/)), у Force 8 ([bboytech](https://www.bboytechreport.com/2019/01/17/akai-pro-force-first-impressions-and-initial-thoughts)).
- У Polyend Play касание энкодера переключало режим. Автор SoS отключил этот жест из-за случайных срабатываний ([SoS](https://www.soundonsound.com/reviews/polyend-play)).
- У Push 2 сенсорная часть подвержена проблемам заземления ([Ableton forum](https://forum.ableton.com/viewtopic.php?p=1758502)).

**Вывод.** Касание делает две вещи и больше ничего:
1. Показывает крупно значение и имя параметра на экране.
2. При включённой записи автоматизации касание начинает запись движения, отпускание её заканчивает.

Менять режим касанием нельзя. Аппаратно: проводящий колпачок или металлический вал и ёмкостный контроллер (например, класса MPR121, 12 каналов). Нужна чистая земля.

### 1.6 Размер колпачков и шаг между энкодерами

| Источник | Что говорит |
|---|---|
| Опрос на форуме Ableton (2011) | 73% (22 из 30) считают ручки контроллеров расположенными слишком близко. Около 25 мм между центрами — минимум, при котором ещё можно работать ([Ableton forum](https://forum.ableton.com/viewtopic.php?p=1306090)) |
| Форум LMNC | 25 мм тесновато для крупных ручек с юбкой; для ручек 12 мм обсуждают шаг 18–20 мм ([LMNC](https://lookmumnocomputer.discourse.group/t/panel-layout-best-practices/6780)) |
| Обзор LCXL3 | Людям с крупными пальцами тесновато ([Attack](https://www.attackmagazine.com/reviews/gear-software/novation-launch-control-xl-3/)) |
| FAA HFDS 6.1.1.4.6 | Если размер кодирует функцию, диаметры должны отличаться минимум на 13 мм ([FAA](https://hf.tc.faa.gov/hfds/download-hfds/hfds_pdfs/Ch6_Controls_and_visual_indicators.pdf)) |
| FAA HFDS 6.1.1.5.3 | Для работы вслепую — разная форма или не менее 125 мм между органами |
| FAA HFDS 6.1.1.2.1 | По часовой стрелке — увеличение |

Таблицы размеров ручек из MIL-STD-1472 через доступные копии получить не удалось: они там в картинках. Если понадобятся точные военные нормы, нужна полная версия стандарта.

**Вывод.**
- 8 энкодеров параметров: шаг 30 мм, колпачок 14–18 мм с прорезиненной боковиной и меткой. Ряд займёт 8 · 30 = 240 мм.
- Плотные группы (16 уровней): шаг не меньше 25 мм. 16 · 25 = 400 мм.
- Навигационный энкодер заметно крупнее остальных (колпачок 35–45 мм), чтобы находить его на ощупь. Разница диаметров больше 13 мм выполняет правило FAA.

### 1.7 Сколько получается энкодеров

| Группа | Вариант A (8 + банки) | Варианты B и C (16 каналов) |
|---|---|---|
| Параметры под экраном | 8 | 8 |
| Макро-звук (фильтр, резонанс, драйв, дилей, реверб, питч) | 6 | 6 |
| Уровни дорожек | 8 | 16 |
| Навигация | 1 | 1 |
| Усиление входов (решено: энкодеры) | 2 | 2 |
| **Итого** | **25** | **33** |

Для сравнения: BCR32 — 32 энкодера с кольцами ([MusicTech](https://musictech.com/news/gear/behringer-bcr32-available-to-pre-order-features/)), LCXL3 — 24 бесконечных энкодера ([Attack](https://www.attackmagazine.com/reviews/gear-software/novation-launch-control-xl-3/)), MPC XL — 16 Q-Link с OLED-дисплеями на каждой ([Perfect Circuit](https://www.perfectcircuit.com/m2e/akai-mpc-xl.html)).

---

## 2. Ручка навигации

### 2.1 Что это и как называется у других

- **Q-Link у Akai** — это назначаемые ручки параметров, а не навигация. У MPC XL их 16, каждая со своим OLED ([Perfect Circuit](https://www.perfectcircuit.com/m2e/akai-mpc-xl.html)).
- **Data Dial у MPC One** — навигационный энкодер. Прокручивает меню и меняет значение выбранного поля, нажатие работает как Enter. Рядом кнопки −/+ ([руководство MPC One](https://www.manualslib.com/manual/1855574/Akai-Mpc-One.html?page=3)).
- **Force**: крупный энкодер данных с фиксацией и нажатием, кнопки −/+, справа от экрана. Обозреватели хвалят логику, но сам энкодер называют дешёвым на ощупь ([Bonedo](https://www.bonedo.de/artikel/akai-force-test/), [bboytech](https://www.bboytechreport.com/2019/01/17/akai-pro-force-first-impressions-and-initial-thoughts)).
- **MPC XL**: навигационный энкодер без нажатия; для выбора нужна отдельная кнопка, и это ругают ([MusicRadar](https://www.musicradar.com/music-tech/samplers/a-machine-worthy-of-building-your-whole-workflow-around-akai-mpc-xl-review)).
- **Push 3**: большое джог-колесо с нажатием и наклоном. Наклон вправо у части устройств срабатывал плохо, Ableton подтверждала брак ([форум Ableton](https://forum.ableton.com/viewtopic.php?p=1813864)). Пользователи хотят прокрутку в обе стороны и полное дублирование колеса стрелками ([форум Ableton](https://forum.ableton.com/viewtopic.php?p=1812509)). Один пользователь хвалит 4D-энкодер Maschine.
- **Move**: колесо с нажатием; прокручивать им длинные списки звуков обозреватель назвал «утомительным занятием» ([MusicTech](https://musictech.com/reviews/controllers/ableton-move-review/)).
- **Behringer Kick**: джог-колесо и 4 назначаемых ручки, как у MPC One ([Time To House](https://timetohouse.com/en/articles/behringer-kick-open-source-firmware), [Synth Anatomy](https://synthanatomy.com/2026/10/behringer-kick-an-mpc-one-clone-with-open-source-firmware.html)).

### 2.2 Требования (вывод)

1. Крупный энкодер с фиксацией, около 24 щелчков на оборот, колпачок 35–45 мм.
2. Нажатие = «ОК». Рядом отдельная кнопка «Назад».
3. Никаких наклонов: у Push 3 это источник брака.
4. Четыре стрелки, полностью дублирующие колесо: так просят пользователи Push, и стрелки выручают при поломке колеса.
5. Ускорение по скорости вращения для длинных списков. Плюс поиск, избранное и теги в браузере, потому что одной прокруткой длинные списки «утомительны».
6. **«Фокус-ручка»:** колесо меняет значение того, что выбрано или последним тронуто на экране, как Data Dial у MPC. Тронул параметр пальцем на экране — крутишь колесо. Думаю, это та самая «ручка для сёрфа», о которой ты говоришь.
7. **Место (решено: пользователь правша):** справа от экрана, как у Force, MPC One и Push 3. В v2 колесо стояло слева.

---

## 3. Кнопки

### 3.1 Что известно

- **FAA HFDS 6.1.5.8.4–5:** у кнопки должна быть вогнутая или нескользкая поверхность и явная обратная связь (щелчок, звук или подсветка) ([FAA, гл. 6](https://hf.tc.faa.gov/hfds/download-hfds/hfds_pdfs/Ch6_Controls_and_visual_indicators.pdf)).
- **FAA HFDS 9.1.7–9.1.10 (клавиатуры):** ширина клавиши от 12 мм, шаг 18–19 мм, усилие 0,25–1,5 Н, предпочтительно 0,5–0,6 Н ([FAA, гл. 9](https://hf.tc.faa.gov/hfds/download-hfds/hfds_pdfs/Ch9_Input_devices.pdf)).
- **Digitakt II:** кнопки дребезжат — «самые дребезжащие кнопки, какие можно представить» ([MusicTech](https://musictech.com/reviews/hardware-instruments/elektron-digitakt-ii-review)).
- **MPC Live III:** широкие шаговые кнопки нажимаются только по центру и шатаются, если промахнуться ([MusicTech](https://musictech.com/reviews/studio-recording-gear/akai-mpc-live-iii-review/)).
- **Force:** резиновые функциональные кнопки быстро собирают пыль и грязь ([bboytech](https://www.bboytechreport.com/2019/01/17/akai-pro-force-first-impressions-and-initial-thoughts)).
- **Force:** хвалят, что всё подписано, а большинство кнопок делают одно действие, без переключения режимов как на Push ([CDM](https://cdm.link/akai-force-hands-on-preview/)).
- **Move:** символы под Shift обозреватель назвал «громоздкими иероглифами», часть пришлось смотреть в мануале ([MusicTech](https://musictech.com/reviews/controllers/ableton-move-review/)).
- **Deluge:** 174 мембранные кнопки и 146 RGB-светодиодов ([Matrixsynth](https://www.matrixsynth.com/2018/07/whats-inside-synthstrom-deluge.html)).
- Разработчик синтезатора на atosynth рассматривает Cherry ML и Cherry MX Low Profile ([atosynth](https://atosynth.blogspot.com/2020/03/uifront-panel-design-living-post.html?m=1)).

### 3.2 Вывод

- Один тип кнопки на всё устройство: низкопрофильный механический переключатель с полупрозрачным колпачком и RGB-светодиодом под ним. Тихий вариант, без дребезга колпачка. Колпачок 13–15 мм, шаг не меньше 19 мм.
- Широкие кнопки, если будут, — со стабилизатором, чтобы не было эффекта MPC Live III.
- Подписи текстом на панели рядом с кнопкой, без иероглифов. Одна кнопка — одно действие. Второе действие по удержанию допустимо, но экран показывает его в момент удержания.

### 3.3 Примерный список кнопок

| Группа | Количество | Состав |
|---|---|---|
| Страницы | 4 | Взять, Лепить, Играть, Собрать |
| Захват | 2 | Capture, Freeze |
| Выбор входа | 5 | Микрофон, Линия, Фоно, Гитара, Внутренний |
| Транспорт | 3 | Play, Stop, Rec |
| Правка | 2 | Undo, Save |
| Сцены для кроссфейдера | 2 | A, B |
| Навигация | 5 | Назад и 4 стрелки |
| Дорожки | 8 (вариант A) или 16 (B, C) | Выбор дорожки; в A окно сдвигается стрелками, кнопка банка не нужна |
| Режимы дорожек | 2 | Mute, Solo (переключают смысл кнопок дорожек) |
| Ряд под сеткой | 8 | Запуск сцены в виде клипов, выбор страницы шагов в шаговом режиме |
| Фантом | 2 | Включение P48 по каналам, с индикатором |
| **Итого** | **43 (A) или 51 (B, C)** | |

---

## 4. Кроссфейдер, сенсорные полосы, фейдеры

**Кроссфейдер.**
- У Force есть кроссфейдер с кнопками назначения A/B ([Bonedo](https://www.bonedo.de/artikel/akai-force-test/)); у Octatrack он смешивает две из 16 сцен ([Loopop](https://loopopmusic.com/?p=545)).
- Механический кроссфейдер Korg handytraxx play ругают за износ и мёртвую зону около 2 мм в начале хода ([Bonedo](https://www.bonedo.de/?p=2567978)).
- Бесконтактные варианты: Innofader — 4 млн циклов ([Innofader](https://musicredone.com/products/reloop-rmx-innofader)), Ecler Eternal (индуктивный) — более 20 млн операций ([Ecler](https://avlgear.com/collections/professional-audio-mixers/products/ecler-eter-fader-eternal-inductive-dj-crossfader)).
- **Вывод:** ставим бесконтактный или долговечный ползунок, кривую задаём в софте.

**Сенсорные полосы.**
- APC64 заменил ручки 8 сенсорными полосами. Плюсы: их можно найти на ощупь, можно сразу выставить значение, можно двигать больше двух параметров одновременно. Минусы: случайные касания меняли громкость (пришлось делать режим Off), значение прыгает при касании, энкодеры дают лучшую точность ([SoS](https://www.soundonsound.com/reviews/akai-apc64)).
- У MPC Live III полоса для Touch FX и note repeat ([Gearnews](https://www.gearnews.com/akai-mpc-live-iii-review/)); у Push 3 полосу питча улучшили ([Magnetic](https://magneticmag.com/2024/02/push-3-standalone-review/)).
- **Вывод:** одна полоса для Touch FX и питча — хорошая опция второй фазы, но не ядро.

**Фейдеры** (кроме кроссфейдера) не нужны: подтверждений их пользы в найденном нет (документы 06, 07).

---

## 5. Сетка пэдов

### 5.1 Датчики

- **Velocity обязательно:** у Polyend Play и Deluge его нет, и обозреватели это ругают ([SoS](https://www.soundonsound.com/reviews/polyend-play), [Waveform](https://waveformmagazine.com/waveform-reviews/synthstrom-audible-deluge/)).
- **Что умеют лучшие:**
  - MPCe: сила удара, полифоническое послекасание и положение пальца X/Y; пэд делится на 4 квадранта ([Gearnews](https://www.gearnews.com/akai-mpc-live-iii-review/)).
  - Push 3: скорость, полифоническое давление и X/Y ([MusicRadar](https://www.musicradar.com/reviews/ableton-push-3)).
  - Launchpad Pro MK3: velocity и давление ([Kirstein](https://www.kirstein.de/en/Live-Studio/Studio/Controllers/DAW-Controllers/Novation-Launchpad-PRO-MK3.html)).
- **Опыт самодельных пэдов на FSR из Velostat:**
  - бывают ложные срабатывания при движении пальца;
  - чувствительность теряется, если основание гнётся;
  - нужна калибровка;
  - вывод автора: жёсткая опора и плотная печатная матрица важнее самой идеи датчика ([Hackaday.io](https://hackaday.io/project/1601-diy-usb-midi-controller-mpc-style)).
- Пьезодатчики дают перекрёстные срабатывания между соседними пэдами. Для чувствительности советуют переплетённые дорожки с покрытием ENIG и хороший внешний АЦП ([MIDIbox](https://forum.midibox.org/t/integrating-akai-mpc-mpd-like-pads-in-midibox/19561)).

**Вывод:** 8×8 RGB, velocity и полифоническое давление на FSR. Положение X/Y — не в первой версии. На прототипе сетку берём внешнюю: Push или Launchpad.

### 5.2 Размер

- Launchpad Pro MK3 — 268 × 268 мм на поле 10 × 10 позиций, то есть около 27 мм на ячейку с рамкой (оценка, [Kirstein](https://www.kirstein.de/en/Live-Studio/Studio/Controllers/DAW-Controllers/Novation-Launchpad-PRO-MK3.html)).
- У Push пэды меньше, чем у Maschine, но их вчетверо больше. Maschine удобнее для пальцевого барабанинга, Push — для мелодий и шагов ([MusicRadar](https://musicradar.com/news/head-to-head-ableton-push-vs-native-instruments-maschine-mk3)).
- **Вывод:** шаг 25 мм, сетка 8 · 25 = 200 мм в квадрате. Тогда энкодеры уровня справа от сетки стоят ровно по строкам и не теснее практического минимума 25 мм.

---

## 6. Как жить с 16+ дорожками

### 6.1 Как делают другие

| Устройство | Дорожек | Как выбирают | Банки |
|---|---|---|---|
| Ableton Move | 4 | Пэды и кнопки | Нет; 4 дорожки из-за CPU, Ableton отказалась добавлять ([MusicRadar](https://musicradar.com/music-tech/no-we-do-not-intend-to-add-four-more-instrument-tracks-to-move-ableton-responds-to-critics-of-moves-limited-track-count)) |
| Torso S-4 | 4 стерео | Кнопки | Нет ([SoS](https://www.soundonsound.com/reviews/torso-electronics-s-4)) |
| Akai Force | 8 стерео-аудио, до 128 всего | Ряд из 8 кнопок дорожек под сеткой и ряд mute/solo/rec-arm/clip-stop | Банки по 8 ([Bonedo](https://www.bonedo.de/artikel/akai-force-test/), [CDM](https://cdm.link/akai-force-hands-on-preview/)) |
| APC64 | Ableton | 8 кнопок внизу, курсоры сдвигают по 1 или по 8 | Да; нет отдельных Mute/Solo ([SoS](https://www.soundonsound.com/reviews/akai-apc64)) |
| OP-XY | 16 = 8 инструментов + 8 служебных | Кнопки | Два блока по 8 ([SoS](https://www.soundonsound.com/reviews/teenage-engineering-op-xy?amp)) |
| Elektron Tonverk | 16 = 8 аудио + 4 шины + 3 посыла + микс | Удержание Track + одна из 8 кнопок ([MusicRadar](https://www.musicradar.com/music-tech/samplers/elektron-tonverk-review)) | Нет |
| Polyend Play+ | 16 = 8 сэмплов + 8 синтов/MIDI | Страницы Audio/MIDI | Пользователи просят 16 MIDI; Polyend отказала. Один готов на банки по 8, если переключение такое же простое ([Polyend](https://backstage.polyend.com/t/more-midi-tracks-16-perhaps/8397)) |
| MPC Live III | до 16 аудио + 32 плагина | Экран, 16 шаговых кнопок | ([Gearnews](https://www.gearnews.com/akai-mpc-live-iii-review/)) |
| MPC XL | многодорожечный MPC | 16 Q-Link с OLED, 16 шаговых кнопок | ([Perfect Circuit](https://www.perfectcircuit.com/m2e/akai-mpc-xl.html)) |
| Deluge | ограничено объёмом RAM | Строки сетки 16×8, в Song view каждая дорожка сжата в одну строку | Прокрутка ([Waveform](https://waveformmagazine.com/waveform-reviews/synthstrom-audible-deluge/)) |

**Что из этого следует:**
- 4 дорожки воспринимаются как сильное ограничение (Move).
- 8 + 8 — частый компромисс (OP-XY, Play+, Tonverk).
- Прямой доступ без банков ценят. Банки терпимы, если переключение простое и видимое.

### 6.2 Три варианта для нас

| | **A. 8 + банки** | **B. 16 каналов спереди** | **C. Сетка 16×8** |
|---|---|---|---|
| Сетка | 8×8, строки или столбцы = 8 видимых дорожек | 8×8, показывает банк 1–8 или 9–16, следует за выбранной дорожкой | 16 столбцов × 8 строк, столбец = дорожка |
| Кнопки дорожек | 8 + кнопка банка | 16 в ряд по передней кромке | 16 в ряд, ровно под столбцами |
| Энкодеры уровня | 8 | 16 в ряд над кнопками | 16, ровно под столбцами |
| Все 16 видны сразу | Нет | Да (выбор, mute, уровень) | Да, везде |
| Шаговый режим | 8 шагов в строке или 64 на всю сетку | То же | 16 шагов в строке, как у классических драм-машин |
| Пэдов | 64 | 64 | 128 |
| Энкодеров | 23–25 | 31–33 | 31–33 |
| RGB-светодиодов (оценка, документ 10) | ≈394 | ≈497 | ≈561 |
| Ширина зоны дорожек | ≈260 мм | ≈400 мм | ≈400 мм |
| Риски | Банки, «16 минимум» видно только частично | Сетка (8) и полоса (16) разной ширины, нужна подсветка видимого банка | Вдвое больше пэдов: цена, питание, сборка; ты раньше считал большие сетки избыточными |
| Масштаб на 32–64 | Банки по 8 | Полоса банками по 16 | Полоса и сетка банками по 16 |

**Вывод (до решения):** я склонялся к **B**. Все 16 дорожек доступны напрямую (выбор, mute, уровень), сетка остаётся 64 пэда, а 32–64 дорожки раскладываются банками по 16. C самый логичный («сессия DAW шириной в 16 дорожек»), но удваивает пэды. A дешевле всех, но с банками.

### 6.3 Решение: A с окном, которое сдвигается построчно (28.10.2026, предварительно)

Ты выбрал сетку 8×8 и вариант A, причём с навигацией построчно, а не банками: «банком сразу лист целый меняешь, это не всегда удобно». Построчный сдвиг сохраняет контекст, соседние дорожки остаются на виду. Банк остаётся быстрым прыжком на 8 по удержанию стрелки. Это лучше исходного A. Так работают курсоры у APC64: сдвиг по одной строке, с Shift — по восемь ([SoS](https://www.soundonsound.com/reviews/akai-apc64)).

Как это работает (вывод):
- **Строки сетки = дорожки.** На сетке видно окно из 8 дорожек подряд, например 1–8, 2–9, 3–10.
- **Кнопки и энкодеры справа от сетки** принадлежат строкам окна. Сдвинул окно — они следуют за ним.
- **Окно двигается в обе стороны** (уточнение пользователя): вниз и вверх — по дорожкам, вправо и влево — по времени.
  - Вид клипов: столбцы — сцены.
  - Шаговый режим: столбцы — шаги, 8 видимых из 16, 32 или 64.
  - Режим нот: вверх и вниз — высота (октава или полутон), вправо и влево — сдвиг лада.
- **Стрелки** у колеса навигации, все четыре: одно нажатие — сдвиг на одну строку или столбец; удержание — сдвиг на 8. Экран показывает, что произойдёт.
- **Главное колесо** делает то же самое, когда фокус на сетке:
  - поворот — по вертикали (дорожки);
  - нажать и крутить — по горизонтали (время);
  - быстрое вращение ускоряет прокрутку.
  - Наклонов у колеса нет (документ 09, раздел 2), поэтому второе направление — через нажатие с поворотом. Экран показывает текущую ось.
- **Мини-карта на экране:** все дорожки и всё время песни в виде сетки цветных полосок, рамка показывает, какой участок 8×8 сейчас на сетке.
- **Цвет кольца и кнопки = цвет дорожки** (документ 08). Так видно, что окно сдвинулось, даже без взгляда на экран.
- Кнопка банка больше не нужна, её место занимают стрелки, которые и так есть в блоке навигации.

Что это значит для железа:
- 25 энкодеров (раздел 1.7), 43 кнопки (раздел 3.3), ≈427 RGB-светодиодов (документ 10).
- Корпус уже, чем в варианте B, полосы спереди нет (документ 13).
- Если позже захочется прямого доступа ко всем 16 дорожкам, полосу варианта B можно добавить отдельным модулем, не трогая остальное.

---

## 7. Где ставить 8 энкодеров относительно экрана

**Факты.**
- Владелец Push 3: энкодеры над экраном — плохое решение, потому что при вращении руки закрывают экран ([Elektronauts](https://www.elektronauts.com/t/push-3-users-thread/194831?page=43)).
- **Force:** восемь OLED-дисплеев на скошенной грани между экраном и сеткой, энкодеры перед ними. Привязку ручек к экрану обозреватель хвалит особо ([Bonedo](https://www.bonedo.de/artikel/akai-force-test/)). Дисплеи наклонены, чтобы читать их и стоя, и сидя ([CDM](https://cdm.link/akai-force-hands-on-preview/)).
- **Maschine MK3:** энкодеры под экранами (по общим знаниям, без отдельного источника).

**Вывод.** Переносим 8 энкодеров под экран, в зону между экраном и сеткой. Колонки параметров на экране ставим у его нижнего края, ровно над энкодерами. Это меняет макет v2, где энкодеры стояли над экраном (см. документ 13).

## Открытые вопросы этого документа

1. ~~Вариант компоновки дорожек~~ — предварительно A с окном, сдвигаемым построчно (6.3).
2. ~~Правша или левша~~ — правша, колесо справа.
3. Нужна ли сенсорная полоса во второй фазе?
4. Оптические или магнитные энкодеры для 8 главных — готовы ли платить за надёжность?
