MitjaGrecky/Shtuka-druka/docs/ru/10_rgb_and_screen_research.md

# Штука Дрюка: RGB-подсветка и экран

*28.10.2026. **Факт** — из источника, **вывод** — моя инженерная логика, **решено** — решение пользователя. Количества светодиодов и энкодеров берутся из документа 09.*

## Решение

- **Решено:** RGB везде на уровне железа — пэды, кольца энкодеров, кнопки. Смысл цвета задаётся в софте и меняется без переделки плат. Поэтому вопрос «цвет по типу источника или по блоку цепочки» из документа 08 больше не требует решения на уровне электроники.

---

## 1. Требования к подсветке (вывод)

1. **Частота ШИМ выше 20 кГц.** Тогда пульсации тока светодиодов лежат выше звукового диапазона и меньше попадают в аудио.
2. **Не мерцать на видео.** Это пригодится для роликов, в том числе для возможного Kickstarter.
3. **Укладываться в бюджет питания.** Сотни светодиодов на полной яркости — это десятки ватт.
4. **Плавно тускнеть до низкой яркости** для тёмной сцены и ярко гореть днём.
5. **Обновлять кадр быстрее 30–60 раз в секунду**, чтобы кольца и пэды двигались плавно.

## 2. Какие бывают светодиоды и драйверы

| Вариант | Частота ШИМ | Интерфейс и скорость | Ток | Особенности |
|---|---|---|---|---|
| WS2812B | ≈400 Гц, типичное измерение ([Enttec](https://support.enttec.com/pixel/pixel-general-knowledge/why-do-leds-flicker-on-camera)) | Один провод, ≈30 мкс на светодиод; 300 штук ≈9 мс ([applied-ee](https://applied-ee.github.io/embedded/docs/led-systems/addressable-led-architectures/apa102-and-sk9822/)) | 10–20 мА на цвет, до ≈60 мА на светодиод; в покое ≈0,5 мА ([EEVblog](https://www.eevblog.com/forum/projects/ws2812b-leds-power-consumption/)) | Дёшево, но ШИМ попадает в звуковой диапазон и мерцает на камере |
| SK6812 | ≈1,2 кГц ([Enttec](https://support.enttec.com/pixel/pixel-general-knowledge/why-do-leds-flicker-on-camera)) | Как у WS2812 | Сопоставимо | Лучше, но всё ещё в звуковом диапазоне |
| APA102 | Часто называют ≈19 кГц, данные расходятся ([Enttec](https://support.enttec.com/pixel/pixel-general-knowledge/why-do-leds-flicker-on-camera)) | SPI с тактом, 1–8 МГц; 300 штук ≈1,5 мс при 8 МГц ([applied-ee](https://applied-ee.github.io/embedded/docs/led-systems/addressable-led-architectures/apa102-and-sk9822/)) | Не указан | 5-битная глобальная яркость, всего около 13 бит на канал; в 1,5–2 раза дороже WS2812 |
| SK9822 | Глобальная яркость сделана отдельным ШИМ | Как у APA102 | — | На камере даёт биения и полосы; для съёмки советуют настоящий APA102 ([applied-ee](https://applied-ee.github.io/embedded/docs/led-systems/addressable-led-architectures/apa102-and-sk9822/)) |
| Матричный драйвер IS31FL3741 + обычные RGB-светодиоды | 29 кГц ([даташит](https://www.mouser.com/datasheet/2/198/IS31FL3741-1275466.pdf)) | I²C до 1 МГц; до 117 RGB (351 светодиод) на микросхему | Максимум 38 мА на линию; в среднем до ≈3,75 мА на светодиод | Есть подавление «призраков», питание 2,7–5,5 В, 256 ступеней тока и ШИМ |

**Вывод.** WS2812/SK6812 для звукового прибора не подходят: их ШИМ лежит в звуковом диапазоне, на видео они мерцают, и даже погашенные потребляют ток. Выбираем матричные драйверы (класса IS31FL3741) с дискретными RGB-светодиодами: 29 кГц, низкий ток, управление по I²C от платы контроллера. APA102 — запасной вариант для отдельных мест вроде длинной ленты.

## 3. Расчёты для варианта B (≈497 RGB)

Состав: кольца 8 × 16 + 6 × 12 + 16 × 12 = 392, пэды 64, кнопки ≈41. Итого ≈497 (документ 09, раздел 6.2).

**Если бы это были WS2812:**
- Максимум: I = 497 · 60 мА ≈ 29,8 А; P = 29,8 А · 5 В ≈ 149 Вт.
- В покое, всё погашено: 497 · 0,5 мА ≈ 0,25 А, то есть ≈1,2 Вт впустую.
- Кадр на одной линии: 497 · 30 мкс ≈ 14,9 мс, не больше ≈65 кадров в секунду.

**На матричных драйверах:**
- Микросхем: ⌈497 / 117⌉ = 5.
- Максимум: в среднем 3,75 мА на светодиод, то есть 11,25 мА на RGB; I = 497 · 11,25 мА ≈ 5,6 А, P ≈ 5,6 А · 5 В ≈ 28 Вт. Это всё белым на полную, на практике не бывает.
- Типично: при средней загрузке около 15% от максимума I ≈ 0,84 А, P ≈ 4,2 Вт (оценка).
- Обновление: на одну микросхему 351 байт ШИМ · 9 бит / 1 МГц ≈ 3,2 мс; 5 микросхем на одной шине ≈16 мс (≈60 кадров/с). Две-три шины I²C или обновление только изменившихся светодиодов дают 120+ кадров/с.

Яркость: ток на светодиод у матричного драйвера ниже, поэтому нужны эффективные светодиоды. Яркость днём надо проверить на макете, это пока не измерено.

**Для выбранного варианта A (≈427 RGB).** Состав: кольца 8 × 16 + 6 × 12 + 8 × 12 + 2 × 12 (усиление) = 320, пэды 64, кнопки 43 (документ 09).
- Микросхем: ⌈427 / 117⌉ = 4.
- Максимум: 427 · 11,25 мА ≈ 4,8 А, P ≈ 24 Вт.
- Типично: ≈0,72 А, P ≈ 3,6 Вт.
- Обновление: 4 · 3,2 мс ≈ 12,8 мс на одной шине, ≈78 кадров/с.

## 4. Подсветка и шум в звуке

**Факты.**
- MPC One: гул 150–164 Гц на главных выходах, когда горят пэды и подключено USB-устройство. На выходе наушников гула нет; пропадал, если подключать контроллеры по MIDI, а не по USB ([MPC-forums](https://www.mpc-forums.com/viewtopic.php?p=1810138)).
- Arduino-проект: гул ≈490 Гц на частоте ШИМ светодиодной ленты. На батарее оставался. Пропал после переноса ШИМ выше 20 кГц ([Arduino forum](https://forum.arduino.cc/t/audio-buzz-from-pwm-driving-led-string/1087402)).
- STM32: при включении светодиодов проседает шина 3,3 В, и микрофонный усилитель на той же шине даёт выбросы. Советы: отдельный стабилизатор для аналога, сплошная земля, не переключать много светодиодов одновременно, мягкие фронты ([ST Community](https://community.st.com/stm32-mcus-products-25/led-microphone-noise-interference-102959)).

**Вывод: правила разводки с первого дня.**
1. Отдельная ветка питания для светодиодов (свой DC-DC) и своя возвратная земля, соединённая с аналоговой в одной точке.
2. ШИМ светодиодов выше 20 кГц (матричные драйверы это дают).
3. Светодиодные токи не текут через землю аудио.
4. На макете обязательный тест: всё белым на полную плюс подключённые USB-устройства, меряем шум на всех выходах.

## 5. Светопроводы и читаемость

- Кольца разработчик на atosynth делает из акрила слоями по 3 мм, по сегменту на светодиод, с рассеивателем сверху шириной 2–4 мм. Утечки между сегментами почти нет, но стыки видны; лучше скрывает рассеиватель сверху ([atosynth](https://atosynth.blogspot.com/2020/04/led-dial-light-pipes.html)).
- Чёрный на чёрном дизайн Torso S-4 обозреватель SoS называет неудобным в тёмной студии ([SoS](https://www.soundonsound.com/reviews/torso-electronics-s-4)). Пастельные цвета клипов Force плохо читаются на ярком солнце ([Bonedo](https://www.bonedo.de/artikel/akai-force-test/)).
- FAA HFDS ([гл. 6](https://hf.tc.faa.gov/hfds/download-hfds/hfds_pdfs/Ch6_Controls_and_visual_indicators.pdf)):
  - значение цветов индикаторов: красный — ошибка или остановка, жёлтый — внимание, зелёный — норма или работает, белый — выбрано, синий — справка;
  - мигание 3–5 раз в секунду и только для того, что требует немедленного действия;
  - индикатор должен показывать реакцию устройства, а не только положение кнопки.

**Вывод: язык цвета (софт).**
- Цвет типа дорожки (документ 08) — для всего, что относится к дорожке.
- Системные цвета FAA — для транспорта и состояний: Rec красный, Play зелёный, предупреждение жёлтое.
- Палитра насыщенная, не пастель. Регулировка общей яркости есть.
- Цвет никогда не единственный признак: дублируем яркостью, миганием или положением. Около 8% мужчин плохо различают красный и зелёный.

---

## 6. Экран

### 6.1 Размер и разрешение

| Устройство | Экран |
|---|---|
| MPC XL | 10,1″, мультитач ([Perfect Circuit](https://www.perfectcircuit.com/m2e/akai-mpc-xl.html)) |
| MPC Live III | ≈7″ (6,9″ по MusicTech) ([MusicTech](https://musictech.com/reviews/studio-recording-gear/akai-mpc-live-iii-review/)) |
| Force | 7″, 150 × 98 мм, не наклоняется ([Bonedo](https://www.bonedo.de/artikel/akai-force-test/)) |
| Behringer Kick | 7″ сенсорный ([Time To House](https://timetohouse.com/en/articles/behringer-kick-open-source-firmware)) |
| Push 3 | Длинный узкий LCD |

Кандидат для Pi 5 / CM5: Waveshare 10,1″ DSI LCD (C) — 1280 × 800, IPS, углы обзора 178°, ёмкостный тач на 10 касаний, закалённое стекло 6H с оптической склейкой, 0,552 кг ([Waveshare](https://www.waveshare.com/product/raspberry-pi/displays/10.1inch-dsi-lcd-c.htm)). Яркость в спецификации не указана, её нужно уточнить.

**Геометрия 10,1″ при 16:10:**
- Диагональ 256,5 мм; ширина = 256,5 · 16 / √(16² + 10²) ≈ 217,5 мм; высота ≈ 135,9 мм.
- Шаг пикселя = 217,5 мм / 1280 ≈ 0,170 мм.

### 6.2 Размер шрифта (расчёт)

Норма MIL-PRF-87268 в пересказе Activu: минимум для лёгкого чтения 16 угловых минут, оптимум 20 угловых минут ([Activu](https://activu.com/uploads/Optimal-Font-Size.pdf)).

Формула: h = 2 · D · tg(θ / 2). При расстоянии D = 550 мм:
- оптимум θ = 20′: h = 2 · 550 · tg(0,1667°) ≈ 3,2 мм, то есть ≈19 пикселей высоты заглавной буквы, кегль ≈26–28 px;
- минимум θ = 16′: h ≈ 2,56 мм, то есть ≈15 пикселей, кегль ≈22 px.

**Вывод:** основной текст 26–28 px, ничего мельче 22 px. В колонку шириной 160 px (8 колонок на 1280) помещается 10–12 знаков такого шрифта. Длинные названия параметров нужно сокращать заранее.

### 6.3 Касание

- FAA HFDS 9.4.2.4: сенсорная зона от 19 до 38 мм, промежуток 3–6 мм; отклик на касание не позднее 0,25 с ([FAA, гл. 9](https://hf.tc.faa.gov/hfds/download-hfds/hfds_pdfs/Ch9_Input_devices.pdf)). Это нормы для авиации, бытовые рекомендации мягче.
- **Проверка нашей сетки:** колонка 160 px · 0,170 мм ≈ 27 мм — укладывается даже в авиационный минимум 19 мм.
- MPC Live III: сенсорная правка не всегда удобна для точных изменений ([Audiofanzine](https://en.audiofanzine.com/sampling-sequencer/akai/mpc-live-3/editorial/reviews/review-of-the-akai-mpc-live-iii.html)). Это подтверждает правило документа 08: сенсор для выбора и перетаскивания, точные значения — руками.

### 6.4 Наклон экрана (расчёт)

**Факты.**
- Экран Force не наклоняется; обозреватели и фанаты MPC разочарованы и пользуются подставками ([Bonedo](https://www.bonedo.de/artikel/akai-force-test/), [bboytech](https://www.bboytechreport.com/2019/01/17/akai-pro-force-first-impressions-and-initial-thoughts)).
- Для MPC Live продают ножки-подставки для наклона ([MPCstuff](https://www.mpcstuff.com/akai-mpc-live-ii-iii-feet-risers-tilted-angle-foot-stand-extensions-mpcstuff/)).
- Пользователь Elektron жалуется на боль в середине и верху спины, когда устройства лежат плашмя ([Elektronauts](https://www.elektronauts.com/t/elektron-ergonomics/36812)).

**Расчёт.** Глаз сидящего на H ≈ 45 см выше стола, горизонтальное расстояние до центра экрана L ≈ 45–60 см.
- Угол взгляда ниже горизонта: α = arctg(H / L) ≈ 37–45°.
- Плоский экран смотрит вверх, поэтому взгляд отклонён от нормали на 90° − α ≈ 45–53°.
- Стоя (H ≈ 70 см, L ≈ 45 см): α ≈ 57°, отклонение ≈33°.
- Чтобы экран смотрел прямо в глаза, его нужно наклонить на 30–50° к пользователю. IPS сохраняет цвета при таком угле, но растут блики и параллакс касания.

**Вывод:** идеально — шарнир с ходом 0–60° и рабочим углом 30–45°; проще — фиксированный наклон ≈30°.

**Решено:** фиксированный наклон около 30°.

Проверка этого угла по тому же расчёту:
- Стоя нужно ≈33°, при 30° отклонение от нормали всего ≈3°.
- Сидя нужно 45–53°, при 30° остаётся 15–23°. Для IPS с углами обзора 178° это приемлемо.

Оптическая склейка уменьшает блики, это особенно важно при фиксированном угле.

### 6.5 Где энкодеры относительно экрана

Под экраном (подробно в документе 09, раздел 7). Колонки параметров у нижнего края экрана, ровно над энкодерами. Экран стоит на скошенной части корпуса под 30°, энкодеры — на основной панели прямо перед его нижним краем.

### 6.6 Маленькие дисплеи у ручек

У Force 8 OLED над энкодерами, наклонённые для чтения стоя и сидя ([CDM](https://cdm.link/akai-force-hands-on-preview/)). У MPC XL OLED на каждой из 16 Q-Link ([Perfect Circuit](https://www.perfectcircuit.com/m2e/akai-mpc-xl.html)). LCXL3 — один маленький OLED, читаемый под любым углом ([Attack](https://www.attackmagazine.com/reviews/gear-software/novation-launch-control-xl-3/)).

**Вывод:** для 8 энкодеров под экраном отдельные дисплеи не нужны, их заменяет нижняя полоса экрана. Для полосы из 16 дорожек (вариант B) полезна узкая полоса-дисплей с именами дорожек над энкодерами. Это опция второй фазы.

## Открытые вопросы

1. ~~Шарнир экрана или фиксированный наклон?~~ Решено: фиксированный ≈30°.
2. Нужна ли полоса-дисплей с именами дорожек над 16 энкодерами?
3. Яркость панели: нужен ли запас для работы днём у окна или на улице?
