MitjaGrecky/Shtuka-druka/docs/ru/15_outputs_research.md

# Штука Дрюка: аудиовыходы — что нужно, что пригодится, в каком исполнении

*28.10.2026. **Факт** — из источника, **вывод** — моя инженерная логика, **решено** — решение пользователя. Уровни +4 dBu и −10 dBV — общеизвестные стандарты; пересчёт в вольты сделан по формулам ниже.*

## 0. С чего начали

- **Решено ранее:** два выхода наушников 6,3 мм спереди; громкость мониторов и наушников — потенциометры с упорами.
- **Предложение пользователя (28.10.2026):** «RCA, TRS две пары, балансные выходы и наушники». Либо исследовать, что необходимо и что может пригодиться. Ниже второе, и оно в основном подтверждает первое.

## 1. Сколько выходов у других

| Устройство | Выходы | Особенности |
|---|---|---|
| MPC XL | 8 линейных | 16 CV/Gate отдельно ([Perfect Circuit](https://www.perfectcircuit.com/m2e/akai-mpc-xl.html)) |
| MPC Live III | 3 стереопары | ([Gearnews](https://www.gearnews.com/akai-mpc-live-iii-review/)) |
| MPC Live II | 6 отдельных | Владельцы ценят их для вывода на микшер (документ 04) |
| Roland MC-707 | Mix 2 + Assignable 2 + наушники | Есть гнездо Send/Return для внешнего эффекта ([Perfect Circuit](https://www.perfectcircuit.com/roland-mc-707.html)) |
| Akai Force | 4 | ([Bonedo](https://www.bonedo.de/artikel/akai-force-test/)) |
| Elektron Tonverk | 4 + наушники | Посыл можно отправить во внешний процессор и вернуть на вход ([MusicRadar](https://www.musicradar.com/music-tech/samplers/elektron-tonverk-review)) |
| Ableton Push 3 | 2 + наушники + ADAT | ADAT для расширения до 8 каналов ([Thomann](https://www.thomann.de/be/ableton_push_3_standalone_live_std.htm)) |
| Roland SP-404 MK2 | 2 | Переход с RCA на балансные 6,3 мм ([Engadget](https://www.engadget.com/roland-sp-404-mkii-hands-on-dragging-an-iconic-sampler-into-the-modern-age-070043439.html)) |

**Что из этого следует:**
- Средний «большой» грувбокс — 4–8 аналоговых выходов.
- Отдельные выходы покупатели ценят (MPC Live II).
- Тренд: RCA уходит, балансные 6,3 мм становятся нормой (SP-404 MK2).
- Многоканальный USB к компьютеру (у MPC — 24 канала) взял на себя запись дорожек по отдельности. Поэтому аналоговых выходов нужно меньше, чем во времена, когда всё писали через пульт.

## 2. Зачем вообще нужны дополнительные выходы

| Задача | Что нужно | Чем закрываем у нас |
|---|---|---|
| Слушать на мониторах | Главная балансная пара | Main L/R |
| Записать дорожки по отдельности в DAW | Много каналов | USB-аудио: 16+ каналов (документ 11, раздел 5.1) |
| Живой сет: барабаны и бас отдельно на пульт звукорежиссёру | 1–2 дополнительные пары | Aux L/R |
| Подключиться к DJ-микшеру или домашнему усилителю | Несимметричный −10 dBV | RCA L/R |
| Прогнать звук через гитарные педали и вернуть | Посыл педального уровня и вход Hi-Z | Aux в режиме «Педали» + гитарные входы |
| Предпрослушка в наушниках | Отдельная шина Cue | Наушники с выбором Main/Cue |
| Расширить входы и выходы внешним интерфейсом | Цифровой порт | ADAT — опция фазы 2 |

## 3. Стандарты, уровни, исполнение

### 3.1 Уровни

- **Профессиональный +4 dBu:** U = 0,775 · 10^(4/20) ≈ 1,228 В rms.
- **Бытовой −10 dBV:** U = 1 · 10^(−10/20) ≈ 0,316 В rms.
- Разница: 20 · lg(1,228 / 0,316) ≈ 11,8 дБ, то есть около 12 дБ.
- По DJ TechTools: RCA — несимметричный разъём, распространён на микшерах и звуковых картах, но сильнее подвержен помехам; симметричный нужен для длинных линий; на колонки и балансные входы — +4 ([DJTT](https://djtechtools.com/2010/04/04/cable-pizza/)).

### 3.2 Какой балансный выход

Sound Devices ([тех. заметка](https://www.sounddevices.com/tech-notes/output-balancing-topologies)):

| Тип | Плюсы | Минусы |
|---|---|---|
| Импедансный (сигнал только на «горячей» жиле, «холодная» — через такой же импеданс на землю) | Подавление помех как у остальных балансных; нет проблем устойчивости; при несимметричной нагрузке нет потери уровня; меньше деталей — надёжнее | Нельзя перевернуть полярность |
| Активный (cross-coupled, обе жилы) | Удвоенный размах сигнала | Теряет 6 дБ на несимметричной нагрузке; бывают проблемы устойчивости |
| Трансформаторный | Гальваническая развязка, лучшее подавление помех | Цена, вес, размер |

**Расчёт запаса по уровню.** При номинале +4 dBu и запасе 14 дБ максимум +18 dBu: U = 0,775 · 10^(18/20) ≈ 6,16 В rms, пик ≈ 8,7 В.
- Импедансному выходу (весь размах на одной жиле) нужны шины не меньше ±10–12 В.
- Активному с двумя жилами по 4,35 В пика хватает примерно ±6 В, но с потерей 6 дБ на несимметричной нагрузке.

**Вывод.**
- Главные и Aux — импедансно-балансные, шины ±12 В. Это надёжно и одинаково работает с балансными и небалансными кабелями.
- Если в пути есть трансформаторы, то только на Main, и только если гул от петель земли на тестах окажется проблемой (документ 11, раздел 8.3).

### 3.3 Защита от щелчков при включении и выключении

**Факты.**
- Самый надёжный способ — реле с задержкой: медленно включается, мгновенно отключается при пропадании питания ([GroupDIY](https://groupdiy.com/threads/power-on-off-thumps-and-plops.77677/page-2)).
- Твердотельные MOSFET-ключи Coto для выхода на наушники: сопротивление ≈50 мОм, подавление ≈−70 dBV на 32 Ом. RC-задержка держит выход заглушённым 1–2 с, пока шины устанавливаются ([Coto](https://www.rhopointcomponents.com/image/catalog/Manufacturers/Coto/AudioOutput1_ProductSheet-1.pdf)).

**Вывод.**
- На всех выходах (Main, Aux, RCA, наушники) — ключ отключения: при включении держит 1–2 с, при пропадании питания отключает мгновенно.
- Управляет ключом плата панели (микроконтроллер), а не главный компьютер: тогда зависание софта не щёлкает в мониторы.

### 3.4 Наушники

**Факты.**
- Владелец Scarlett 2i2 жалуется, что наушники Beyerdynamic DT 990 на 250 Ом звучат тихо даже на 100%; другие пользователи с другими интерфейсами проблем не видят ([DnB Forum](https://dnbforum.com/threads/beyerdynamic-dt990-250ohms-question.195739/)).
- У MPC One жаловались на шум и щелчки в наушниках (документ 04).

**Расчёт (допущение: чувствительность 96 дБ SPL / 1 мВт, типично для студийных Beyerdynamic на 250 Ом; цель — пики 110 дБ SPL):**
- P = 10^((110 − 96) / 10) мВт ≈ 25 мВт.
- 250 Ом: U = √(P · R) = √(0,025 · 250) ≈ 2,5 В rms.
- 600 Ом: U = √(0,025 · 600) ≈ 3,9 В rms.
- 32 Ом: I = √(P / R) = √(0,025 / 32) ≈ 28 мА rms.

**Вывод: требование к усилителю наушников.**
- Не меньше 4 В rms на 600 Ом и не меньше 30 мА на 32 Ом, то есть шины ±12 В и выходной каскад с запасом по току.
- Выходное сопротивление низкое, чтобы не окрашивать звук.
- Отдельный ключ отключения (3.3).
- Источник выбирается: Main или Cue (предпрослушка).

### 3.5 Громкость мониторов конечной ручкой: два исполнения

| Исполнение | Плюсы | Минусы |
|---|---|---|
| a) Сдвоенный потенциометр прямо в тракте Main | Предельно просто и «понятно»; работает при любом состоянии софта | Со временем может трещать; на малой громкости каналы расходятся |
| b) Потенциометр как датчик → микроконтроллер панели → аттенюатор с цифровым управлением | Чисто, без треска и рассогласования каналов; можно ограничить максимум | Сложнее; нужен тихий старт |

**Вывод:** на прототипе — a). В «чистовом» железе — b), но управление держит микроконтроллер панели, а не главный процессор. Ручка в обоих случаях остаётся конечной: положение = громкость.

## 4. Педальная петля (внешние эффекты)

**Факты.**
- Владелец MPC Live 2 пускает выход 3/4 в педаль и обратно на вход, но не понимает, как согласовать уровни и импедансы (линейный выход против гитарного входа педали 1 МОм) и нужен ли реамп-бокс ([MPC-forums](https://www.mpc-forums.com/viewtopic.php?p=1832929)).
- Отдельные коробки решают именно это: Radial EXTC переводит балансный линейный сигнал в уровень педалей и обратно, с регулировкой send/return и wet/dry ([Thomann](https://www.thomann.co.uk/radial_engineering_extc_sa.htm)).
- Befaco Pedal S/R для модульных систем: переключатель LINE/INST на посыле и LINE/Hi-Z на возврате, потому что драйвы и фуззы звучат по-разному в зависимости от нагрузки ([Schneidersladen](https://schneidersladen.de/en/befaco-pedal-s-r)).
- У MC-707 есть Send/Return ([Perfect Circuit](https://www.perfectcircuit.com/roland-mc-707.html)); Tonverk умеет отправлять посыл во внешний процессор и возвращать ([MusicRadar](https://www.musicradar.com/music-tech/samplers/elektron-tonverk-review)).

**Вывод.** Для идеи «играть фильтрами и эффектами» встроенная педальная петля — сильная и редкая вещь. Дополнительных гнёзд для неё не нужно:
1. **Aux L/R** с переключателем «Линия / Педали»: в режиме «Педали» уровень опускается примерно на 20 дБ, выход несимметричный, с низким выходным сопротивлением.
2. **Возврат** — гитарные входы Hi-Z (1 МОм, документ 11), а для фуззов можно сделать отдельную нагрузку.
3. **В софте** — эффект «Внешняя педаль» в слоте цепочки: компенсирует задержку и даёт регулировки Dry/Wet и уровня возврата, как у Radial.

## 5. Цифровые выходы

**ADAT.**
- Пользователи Push 3 подключают внешние интерфейсы, чтобы получить больше входов и выходов или использовать Push как микшер на концертах.
- Проблемы: часть интерфейсов нужно настраивать с компьютера; у Behringer ADA8200 шумели выходы; на 96 кГц каналов вдвое меньше ([форум Ableton](https://forum.ableton.com/viewtopic.php?p=1817104)).
- **Вывод:** полезное расширение «на вырост», но не для первой версии. Если делать — на 48 кГц (8 каналов) и с явной настройкой источника клока.

**S/PDIF:** с USB-аудио почти не нужен. Не закладываем.

## 6. Итог: предлагаемый набор выходов

| Класс | Выход | Разъём | Исполнение |
|---|---|---|---|
| Необходимо | **Main L/R** (мониторы) | 2 × TRS 6,3 мм, сзади | Импедансно-балансный, +4 dBu, максимум ≥ +18 dBu, ключ отключения, громкость конечной ручкой |
| Необходимо | **Наушники ×2** | 2 × 6,3 мм, спереди | ≥4 В на 600 Ом, ≥30 мА на 32 Ом; источник Main/Cue; своя громкость |
| Необходимо | **USB-аудио** | USB-C | 16+ каналов в компьютер (документ 11) |
| Полезно | **Aux L/R** | 2 × TRS 6,3 мм, сзади | Импедансно-балансный; назначаемый (дорожки, шины, Cue, посыл на педали); переключатель «Линия / Педали» |
| Полезно | **RCA L/R** | 2 × RCA, сзади | −10 dBV, несимметричный; по умолчанию копия Main, источник назначаемый; для DJ-микшеров и бытовых усилителей |
| Фаза 2 | ADAT in/out | TOSLINK | +8 каналов на 48 кГц |
| Не нужно | XLR-выходы | — | Балансный TRS делает то же; на сцене — кабель TRS–XLR |
| Не нужно | S/PDIF, выходы на колонки, саб | — | — |

Это совпадает с твоим предложением «RCA, две пары TRS, наушники». Добавлены режим педалей на Aux, Cue в наушниках и ключи против щелчков.

**Решено (28.10.2026):**
- RCA — копия Main, для удобства: многие DJ-мониторы подключаются «тюльпанами». Значит, RCA берёт тот же сигнал после ручки громкости мониторов, через свой буфер с понижением примерно на 12 дБ (+4 dBu → −10 dBV) и свой ключ отключения. Отдельные каналы ЦАП не нужны.
- Для старта одна пара Aux; больше — если понадобится позже.

**Каналы ЦАП:** Main 2 + Aux 2 + Cue 2 = 6. Удобно взять 8-канальный ЦАП: два свободных канала остаются на второй Aux, если он когда-нибудь понадобится.

## Открытые вопросы

1. ~~RCA~~ — решено: копия Main.
2. ~~Второй Aux~~ — решено: пока одна пара.
3. Громкость мониторов в «чистовом» железе: потенциометр в тракте или потенциометр-датчик и цифровой аттенюатор?
