MitjaGrecky/Shtuka-druka/docs/ru/16_effects_and_open_source.md

# Штука Дрюка: назначаемые эффекты и открытый проект

*28.10.2026. **Факт** — из источника, **вывод** — моя инженерная логика, **решено** — решение пользователя. Это не юридическая консультация: лицензии нужно сверять с текстами в репозиториях на момент использования.*

## 0. Решения

- **Решено:** эффекты назначаемые: любой эффект в любой слот, а не фиксированный набор.
- **Решено:** проект открытый, «без вариантов».

## 1. Как сделать эффекты назначаемыми и не потерять «ручки на своих местах»

### 1.1 Как у других

| Устройство | Схема эффектов |
|---|---|
| Octatrack | Два слота эффектов на дорожку, эффект в слоте выбирается ([Loopop](https://loopopmusic.com/?p=545)) |
| MPC | 4 посыла и 4 инсерта на дорожку, плюс 8 слотов Drum FX на пэд ([Elektronauts](https://www.elektronauts.com/t/your-favourite-sampler-workflow/204575?page=4)) |
| Tonverk | 4 шины и 3 посыла на общие эффекты ([MusicRadar](https://www.musicradar.com/music-tech/samplers/elektron-tonverk-review)) |
| EP-133 | Один мастер-эффект и 12 мгновенных перформанс-эффектов ([SoS](https://www.soundonsound.com/reviews/teenage-engineering-ep-133-ko-ii?amp)) |
| Torso S-4 | Фиксированная цепочка: Material → Granular → Filter → Color → Space, любой блок можно обойти ([SoS](https://www.soundonsound.com/reviews/torso-electronics-s-4)) |
| Digitakt | Фиксированные посылы на общие Delay и Reverb; это считают ограничением по сравнению с MPC ([Elektronauts](https://www.elektronauts.com/t/your-favourite-sampler-workflow/204575?page=4)) |

### 1.2 Предложение: места фиксированные, содержимое назначаемое (вывод)

Это меняет предложение P2 из документа 08 («фиксированная цепочка»). Фиксированными остаются только **места**, а что в них стоит, выбираешь ты.

**Дорожка (одинакова для всех источников):**

Источник → Фильтр → Слот 1 → Слот 2 → Посылы A, B, C, D → Уровень и панорама

- **Фильтр всегда первый** после источника, только тип назначаемый (ФНЧ, ФВЧ, полосовой, режекторный, формантный и т.д.). Фильтр — самое частое, что крутят руками (документы 06, 09), поэтому его место не меняется.
- **Слоты 1 и 2:** любой эффект из библиотеки, в том числе «Внешняя педаль» (документ 15, раздел 4).

**Шины посылов A–D:** в каждой 1–2 назначаемых слота. По умолчанию A — реверб, B — дилей, C и D пустые. Общие шины дешевле по процессору, чем реверб на каждой дорожке (документ 12, раздел 3).

**Мастер-шина:** 1–2 слота (например, компрессор и лимитер) плюс перформанс-эффекты по нажатию: повтор, остановка ленты, свип фильтра, понижение разрядности.

**Как это ложится на ручки:**
- 8 энкодеров под экраном — параметры выбранного блока (фильтр, слот 1, слот 2, шина).
- 6 макро-энкодеров по умолчанию: частота фильтра, резонанс, главный параметр слота 1, главный параметр слота 2, посыл A, посыл B. Назначение меняется, подписи видны на экране.
- В любом эффекте у каждого параметра есть «главный» флаг, поэтому макро-энкодеры знают, что крутить.

### 1.3 Стартовая библиотека для прототипа (вывод)

Ты не хочешь выбирать заранее, и не нужно. Для прототипа предлагаю набор, который закрывает основные жанры и «добычу звука». Всё назначаемое, библиотеку можно расширять.

| Эффект | Зачем | Откуда взять (открытый код) |
|---|---|---|
| Мультирежимный фильтр | Главный инструмент живой игры | Свой или из Surge XT |
| Драйв / сатурация | Тепло, плотность | Airwindows (MIT) |
| Дилей (стерео, пинг-понг, ленточный) | Пространство, ритм | Surge XT, LSP |
| Реверб | Пространство | Dragonfly Reverb (GPL-3.0) |
| Понижение разрядности и частоты (lo-fi) | Характер | Airwindows, Surge XT |
| Гранулярный процессор | Главный для захваченного звука | Алгоритм Mutable Instruments Clouds (MIT) |
| Резонатор | Делает из шума и стуков тональные звуки | Mutable Instruments Rings (MIT) |
| Компрессор / сайдчейн | Сведение, «качание» | LSP (LGPL-3.0+) |
| Внешняя педаль | Реальные педали в цепочке | Свой (документ 15) |
| Перформанс: повтор, стоп ленты, свип | Живая игра | Свои |

## 2. Открытый проект: лицензии

### 2.1 Что можно брать и под какой лицензией

| Компонент | Лицензия | Что это нам даёт |
|---|---|---|
| Behringer Kick (приложение, аудиодвижок AudIO, протокол панели) | AGPL-3.0-or-later; образ Linux — GPL-2.0 ([GitHub](https://github.com/MusicTribeOpenSource/0700-AAM/blob/main/README.md)) | Идеи и код протокола панели, симулятор, 300+ эффектов Airwindows в движке (документ 03) |
| JUCE | AGPLv3 или коммерческая ([Wikipedia](https://en.wikipedia.org/wiki/JUCE)) | Каркас приложения, если пойдём путём Kick |
| Airwindows | MIT ([порт LV2](https://code.volse.net/audio/plugins/airwindows-lv2-port.git/tree/README.md)) | Огромная библиотека эффектов без ограничений |
| Surge XT | GPL-3.0 ([FAQ Surge](https://surge-synthesizer.github.io/faq)) | Синтез (субтрактив, вейвтейбл, FM) и эффекты. LV2 разработчики не распространяют, потому что сохранение состояния в нём ненадёжно; лучше CLAP/VST3 или встраивать код напрямую |
| Mutable Instruments (Clouds, Plaits, Rings) | Код STM32 — MIT; код AVR — GPL-3.0; железо — CC BY-SA 3.0. «Mutable Instruments» — торговая марка: названия модулей не использовать ([ecosyste.ms](https://awesome.ecosyste.ms/projects/github.com%2Fpichenettes%2Feurorack)) | Гранулярка, макро-осциллятор, резонатор |
| LSP Plugins | LGPL-3.0+ ([Debian](https://metadata.ftp-master.debian.org/changelogs/main/l/lsp-plugins/stable_copyright)) | Эквалайзеры, компрессоры, дилеи |
| Dragonfly Reverb | GPL-3.0 ([ecosyste.ms](https://awesome.ecosyste.ms/projects/github.com%2Fmichaelwillis%2Fdragonfly-reverb)) | Реверберация |
| Zynthian (интерфейс) | GPL-3.0 ([kandi](https://kandi.openweaver.com/python/zynthian/zynthian-ui)) | Опыт хостинга движков на Pi |
| Ableton Link | GPLv2+ или проприетарная ([GitHub](https://www.Github.com/Ableton/link)) | Синхронизация; GPLv2+ подходит |

### 2.2 Какую лицензию взять нам (вывод)

- **Код устройства — AGPL-3.0.**
  - Тогда можно брать код Kick и JUCE под AGPL.
  - GPLv3 и AGPLv3 содержат согласованный раздел 13, который разрешает объединять код под этими двумя лицензиями ([Wikipedia](https://en.wikipedia.org/wiki/GNU_Affero_General_Public_License)). Значит, Surge XT, Dragonfly и Zynthian совместимы.
  - MIT, LGPL-3.0+ и GPLv2-or-later тоже совместимы.
- **Чего избегать:**
  - компоненты «только GPLv2» (без «or later»): по позиции FSF они несовместимы с GPLv3 (общеизвестно, проверять у каждого компонента);
  - закрытые движки (например, Pianoteq) — только как отдельные программы пользователя, не в нашей прошивке.
- **Сетевая оговорка AGPL:** если у устройства будет веб-интерфейс по Wi-Fi, пользователям сети нужно предлагать исходники. Для открытого проекта это просто ссылка на репозиторий.
- **Железо (схемы, платы, корпус) — CERN-OHL-S-2.0.** Строго взаимная лицензия для железа: кто выпускает изделие, обязан дать полные исходники, а изменённые версии остаются под той же лицензией ([choosealicense](https://choosealicense.com/licenses/cern-ohl-s-2.0/)). Если заимствуем аналоговые схемы Mutable Instruments, их лицензия CC BY-SA 3.0 требует указать авторство.
- **Kickstarter и открытость совместимы:** продавать устройство можно, исходники просто должны быть доступны.

## 3. Урок волны самодельных прошивок (31.10.2026)

**Факты.**
- Осенью 2026 года энтузиасты с помощью ИИ разбирают и переписывают заводские прошивки: Octatrack получил многоканальное аудио по USB (OctaMod / Modwerk), Model:Cycles — сэмплер и многоканальный USB, SP-404MKII — теневую ОС DOOM OS, есть моды для Digitakt, Blackbox, MPC500 ([Gearnews](https://www.gearnews.com/custom-firmware-is-booming-synths/), [Synthtopia](https://www.synthtopia.com/?p=155076)).
- Elektron 16 сентября запретила на форуме Elektronauts файлы, инструменты и ссылки на модифицированные прошивки, ссылаясь на риск повредить устройства и на интеллектуальную собственность ([Gearnews](https://www.gearnews.com/custom-firmware-is-booming-synths/)).
- Главные риски модов: «кирпич», потеря гарантии, сырые альфа-версии ([Gearnews](https://www.gearnews.com/custom-firmware-is-booming-synths/)).
- M-VAVE поступила наоборот: открыла прошивку FM-1 (FM1 Open), выпустила браузерный workbench и SDK на GitHub ([Synthtopia](https://synthtopia.com/content/2026/10/20/m-vave-officially-opens-fm-1-firmware-to-developers-with-new-workbench-sdk)).
- Ableton Move запускает софт сообщества вторым слоем рядом с заводской прошивкой ([Gearnews](https://www.gearnews.com/custom-firmware-is-booming-synths/)).

**Вывод для Штуки (P37–P39).**
1. Открытость у нас уже решена (R20), поэтому важнее сделать её безопасной: устройство нельзя «окирпичить» (две копии системы A/B с откатом, безопасный режим, ПЗУ-загрузчик у микроконтроллера панели).
2. Два слоя софта: база + пользовательские движки, эффекты и приложения через SDK; сторож отключает модуль, который мешает звуку.
3. Документированный протокол панели и симулятор на ПК, чтобы писать и пробовать софт без железа.

## Открытые вопросы

1. Устраивает ли схема «места фиксированные, содержимое назначаемое» (раздел 1.2)?
2. Сколько шин посылов: 2 или 4?
3. ~~Куда выкладывать проект~~ — решено: GitHub.
