MitjaGrecky/Shtuka-druka/docs/ru/decisions/08_boards.md

# Решения: Платы и электроника

*Карта плат, микроконтроллеры, протокол, светодиоды, модули ручек M1–M5, W1, сборка и разводка.*

Общие правила ведения и приоритеты — в [README](README.md).

## Ждёт «да» или «нет»

| № | Предложение | Почему | Где |
|---|---|---|---|
| P75 | Кто разводит платы: схемы, расчёты, BOM под JLCPCB и проверки делает Claude — схемы кодом в формате KiCad в репозитории, ERC/DRC и картинки плат автоматически на GitHub при каждом изменении. Простые платы (разъёмы, питание, панель, плата управления) Claude раскладывает скриптом (места органов — из `layout_v7.json`) и трассирует автороутером Freerouting, пользователь смотрит в бесплатном KiCad. Аудиоплату (USB 480 Мбит/с, тихий аналог, 48 В) трассирует сервис — Quilter или разводка JLCPCB (от 100 $) — по схеме, расстановке и правилам от Claude, затем проверка Claude. Первый прототип звучит через AudioFuse, так что аудиоплата не на критическом пути | Автороутер годится для медленной цифры, но не для USB High-Speed и малошумящего аналога; сервисы берут готовую схему и отдают исходники платы | 28 |
| P82 | W1 Levels подключается к P1 той же шиной 2 × 7, что модули энкодеров (R123), и сам оцифровывает громкости (ADS1115 по I²C) — вместо шлейфа 2 × 5 с аналоговыми линиями | Один разъём на все модули; аналог не идёт по шлейфу через сгиб | 31 |
| P83 | Огни Clip 1 и Clip 2 — на модуле M5, а не на W1 | По раскладке v7 они попадают в окно M5 | 31 |
| P84 | Кнопки P48: тактовая кнопка + прозрачный толкатель-колпачок + 2 RGB по бокам | Общая конструкция кнопок панели | 31 |
| P85 | W1 на 8,5 мм под обшивкой (модули энкодеров — 6,5 мм) | Корпусу потенциометра RK09K нужна высота | 31 |
| P97 | Крепление M1: латунные вставки M2 (запрессовка нагревом) в световоде, винт снизу через плату. К угловым H1–H4 добавить 3 отверстия в задней полосе, в зазорах между энкодерами 2–3, 4–5, 6–7 (x ≈ 56, 112, 168 мм), шаг креплений ≈ 56 мм. Отверстия ставятся до финальной разводки | Пользователь: «каждый второй энкодер надо ставить крепление», крепление — «второе после расположения исполнительных элементов». Световод 6,4 мм уже стоит между платой и обшивкой, отдельные стойки не нужны; прижим рядом с огнями держит юстировку; головки снизу не мешают верхним полосам SMD; вставки есть в рознице (R28). Координаты проверить по генератору | 30, `hardware/m1-screen-knobs` |
| P98 | M1 — две одинаковые ячейки по 4 ручки на одной плате 224 × 34 мм: у каждой свой драйвер огней IS31FL3741A (52 RGB, адреса перемычкой), свой 74HC165-хвост цепочки; разводится одна ячейка, вторая — копия из генератора. Прототип R121 — сначала одна ячейка 112 × 34 мм. Открыто: касание (один CY8CMBR3108 у стыка на обе половины, или два со сменой адреса 0x37 в регистре I2C_ADDR, или мультиплексор I²C) | Пользователь: «Может сделать две копии на одной плате рациональнее чем на 20% работающая плата». *(уточнено 06.11 по замеру ПК: щели между энкодерами не переполнены, запас в 2–4 раза; тесно у выводов U1 — 45 линий на QFN 0,4 мм. Деление помогает тем, что на драйвер 27 линий вместо 45. Есть вариант 4 драйверов — документ 33, раздел 5)*. Freerouting и Quilter оба оставили 4–12 открытых у U1; +1 драйвер ≈ 3,7 $ | 30, `hardware/m1-screen-knobs` |
| P101 | Кнопки дек и W3 светят двумя RGB (слева и справа от кнопки, как P84) → по 2 LP5864 на деку | 19–21 кнопка × 2 = 38–42 RGB; один LP5864 — 24 RGB | там же |
| P102 | Модули M3, M4, M5 без касания (касание только у M1 и M2) | Проще и дешевле; касание проверяем на M1 (R121) | там же |
| P103 | M5: кольца по 11 огней + 2 огня Clip — всё на одном LP5864 (24 RGB) | Clip перенесены на M5 (P83); один драйвер на модуль | там же |
| P104 | Кроссфейдер оцифровывает сама P4 (ADS1115 0x48, как громкости на W1), колесо — AS5600 (0x36) на P4 | Тихий аналог не идёт по шлейфу (как P82) | там же |
| P105 | Карман USB-A + SD на W3 — розничный модуль-удлинитель с кардридером, к W3 электрически не подключён | Кардридер на своей плате — лишняя сложная схема (USB 480 Мбит/с) | там же |

## Действует

| № | Дата | Решение | Где подробно |
|---|---|---|---|
| R51 | 31.10.2026 | Светодиоды на матричных драйверах (≈29 кГц ШИМ), не WS2812 (было P8) | 10 |
| R54 | 31.10.2026 | Энкодеры на сменных платах по группам (было P11) | 09 |
| R85 | 31.10.2026 | Две платы с микроконтроллером RP2350: панель (пэды, кнопки, энкодеры, громкости, кроссфейдер, подсветка) и плата управления за задней стенкой (MIDI, CV, синхро, ключи выходов); обе по USB через внутренний хаб (было P44) | 19 |
| R86 | 31.10.2026 | Протокол SDP v0: стандартный USB MIDI для совместимости + свой двоичный протокол по CDC-ACM (COBS, CRC-16, метки времени), анимации светодиодов и клок генерируются на платах; сторож 500 мс отключает выходы (было P45) | 19 |
| R115 | 01.11.2026 | Платы собираются на заводе (JLCPCB, PCBWay и подобные): «Сборка на заводе меня устраивает» — корпуса QFN не ограничение | 28 |
| R119 | 01.11.2026 | Карта плат (документ 29): панель режется по полосам — P1 Left, P2 Сетка с единственным RP2350 панели, P3 Tracks, P4 Right; на наклоне W1 Levels, W2 Meters, W3 System; ручки — на сменных модулях M1–M5 с одинаковым разъёмом. «Да, пока так подходит. Если что, будем править» (предварительно) | 29 *(изменено R128: ручки Level (M2) — на плате P3)* |
| R120 | 01.11.2026 | Задняя стенка — две вертикальные платы: R1 аудио (гнёзда и входные каскады, к ней под прямым углом стыкуется аудиоплата A1) и R2 управление (RP2350 платы управления, MIDI, CV, синхро, питание, USB, внутренний хаб); наушники — своя плата F1 у переднего торца (предварительно) | 29 |
| R121 | 01.11.2026 | Первая плата — модуль 8 ручек экрана M1: проверяем ручку, касание, кольцо огней и общий разъём модулей | 29 (раздел 5) |
| R122 | 01.11.2026 | Кольца огней ручек — по 13 RGB на дуге 270° (8 × 13 = 104 RGB — укладываются в одну микросхему IS31FL3741A на 117). «Хорошо. Меня устраивает, работаем дальше» | 30 (раздел 2) |
| R123 | 01.11.2026 | Общий разъём модулей энкодеров — 2 × 7, шаг 1,27 мм: +5 В × 2, +3,3 В, земля × 4, I²C, INT, цепочка сдвиговых регистров. «Хорошо. Меня устраивает, работаем дальше» | 30 (раздел 5) |
| R124 | 01.11.2026 | На каждом модуле энкодеров — свой драйвер огней и, где нужно, контроллер касания; модули с касанием — на разных шинах I²C; у P2 один драйвер огней. «Хорошо. Меня устраивает, работаем дальше» | 30 (раздел 6) |
| R125 | 01.11.2026 | M1: плата 224 × 28 мм, 4 слоя; сверху только энкодеры и огни, электроника снизу; двусторонняя сборка на заводе. «Хорошо. Меня устраивает, работаем дальше» | 30 (раздел 7) *(уточнено: размер платы уточнён R127: 224 × 34 мм)* |
| R126 | 01.11.2026 | Световод колец: чёрная проставка между платой и обшивкой с отверстием под каждый огонь (3D-печать) и молочная вставка в обшивке. «Хорошо. Меня устраивает, работаем дальше» | 30 (раздел 8) |
| R127 | 01.11.2026 | M1: плата 224 × 34 мм (задний край на y 297, сгиб на 300); драйвер огней — в полосе за кольцами. «Хорошо, продолжай» | 30 (раздел 7) |
| R128 | 13.11.2026 | Ручки Level 1–8 (бывший модуль M2) — на одной плате с P3 Tracks: одна 4-слойная плата 67,5 × 258 мм (x 339–406,5) вместо P3 с вырезом + M2 со шлейфом; блок ручек на канале 1 мультиплексора P3, цепочка P3 → ручки → M4. Закрывает вопрос В5; для M2 отменяет «сменный модуль» из R119. «Да и пусть она будет 4 слойная, но одна. Две двуслойные мне кажется дешевле не будет, шлейфы, разъёмы... сливай» | `hardware/p3-tracks/README.md` |
| R129 | 13.11.2026 | (было P99) I²C на деках — через мультиплексор TCA9546A (P1 0x70, P3 0x71, P4 0x72): канал 0 — своя деталь деки, каналы 1–3 — модули (на P3 канал 1 — блок ручек Level, R128). Ответ на вопрос В4: «Принять оба» | `hardware/for-routing/SPEC_boards.md` |
| R130 | 13.11.2026 | (было P100) Шина дек P2 ↔ P1, P3, P4 — шлейф 2 × 8, 1,27 мм: выводы 1–14 как у шины модулей (R123), 15 — резерв, 16 — GND. Ответ на вопрос В4: «Принять оба» | там же |
| R131 | 13.11.2026 | Радиус колец огней — по макету: r = поле `ring` в `layout_v7.json` / 2, а не формула ТЗ ⌀/2 + 3 (M3, M4 — 15 мм; M5 и Level — 10,5 мм). Ответ на вопрос В2 | `hardware/common/gen/kit.py` (`ring_r`) |
| R132 | 13.11.2026 | M5 шире: до x 99 (84 мм), окно в W1 — до W1 x 89; огонь Clip 2 остаётся на x 96 по макету. Ответ на вопрос В1 | `hardware/m5-gain/README.md` |
| R133 | 13.11.2026 | Power на W3 — панельная кнопка ⌀ 14 на проводе прямо к PWR_SW Mini-ITX, без платы. Ответ на вопрос В9 | `hardware/w3-system/README.md` |
| R134 | 13.11.2026 | Нажатие колеса P4: задел (вход регистра, подтяжка, разъём JST PH 2 вывода) остаётся; механизм выбрать позже. Ответ на вопрос В10 | `hardware/p4-right/README.md` |
| R138 | 13.11.2026 | Платы задней стенки начинаем с **R2 (управление)**: цифровая, без риска для звука. «Ну давай с управления начнём» | 34 |
| ~~R139~~ | 14.11.2026 | Угловые разъёмы R2 (DIN-5, USB-C × 2, USB-A, DC) — на нижней горизонтальной плате-«полке» **R2b**, в один ряд; R2b соединена с вертикальной R2 гребёнкой. Всё паяется на заводе, USB-C PD на 5 А. Ответ на вопрос В12: (а) | `hardware/r2-control/README.md`, handoff #20 |
| ~~R140~~ | 14.11.2026 | Задняя панель: за основу берётся предложение v1 (`docs/ru/img/rear_panel_v1.png`): слева направо питание/USB, MIDI, CV/синхро (R2), выходы, входы (R1); подписи CLK/RESET. Ряды гнёзд R2 меняются под R139. Ответ на вопрос В13 | `tools/rear_panel.py` |
| R141 | 14.11.2026 | (заменяет R139) Задняя стенка — **гнёзда на гайках**: MIDI DIN × 6, USB-C (PC), USB-A, LAN и запирающее DC крепятся к стенке и идут короткими кабелями к R2 (DIN), A1, Mini-ITX и PW. Полки R2b нет. На вертикальной R2 — все мини-джеки. Ответ на вопрос «как ставим DIN, USB, LAN и DC» | `hardware/r2-control/README.md` |
| R142 | 14.11.2026 | (заменяет R140) Раскладка задней стенки — **как в 3D-модели панели v7** (`model3d/index.html`): блоки Power/USB, Control (DIN 3 × 2, под ними TRS In/O1/O2; справа синхро, CV In 1–4, CV 1–8 с шагом 17 мм), Audio Out, Audio In. «В артефакте мне блоки разъёмов больше нравятся» | `tools/rear_panel.py` (v3) |
| R143 | 14.11.2026 | Гнёзда MIDI TRS — стерео 3,5 мм со склада JLC (главное — доступность; другой вид даже подсказывает другую функцию): **Hroparts PJ-3920-3A** (C707259), вертикальное, под гайку. Тип A/B — программно (R32). «Скорее нужно более простой вариант подбирать… доступ деталей» | `hardware/r2-control/README.md` |
| R148 | 14.11.2026 | Единственный исходник M1 — **rev 0.5**: четыре LP5864 (по одному на пару колец), 12 огней на кольцо, крепёж 4 угловых + 3 отверстия в зазорах (x 56, 112, 168 мм, как в P97). Основной файл KiCad `hardware/m1-screen-knobs` перегенерирован из этого же генератора (`M1_LP=1` теперь по умолчанию, `M1_LP=0` — старая rev 0.3 с двумя IS31FL3741A и восемью отверстиями); пакет для EasyEDA и основной файл совпадают (163 детали, 7 отверстий). Оформляет принятую практику: так сделаны M3, M4, M5, P3 и так разводит пользователь. Закрывает расхождение из обзора codex; P98 (IS31FL3741A) и 13 огней по R122 остаются в истории для M1 | `hardware/m1-screen-knobs/README.md` |
