MitjaGrecky/Shtuka-druka/docs/ru/decisions/07_compute_power.md

# Решения: Вычислитель, питание, стенд

*Mini-ITX, стенд разработки, аккумулятор и питание.*

Общие правила ведения и приоритеты — в [README](README.md).

## Действует

| № | Дата | Решение | Где подробно |
|---|---|---|---|
| R19 | 28.10.2026 | Стенд разработки — Lenovo ThinkCentre M93 Tiny (тип 10A5, модель S01900, 65 Вт). Уточнено 31.10.2026: Intel Core i3-4150T 3,0 ГГц (2 ядра / 4 потока), 8 ГБ DDR3, SSD 238 ГБ, Windows 11 Pro — уровень Pi 5 | 12 |
| R36 | 31.10.2026 | Базовый вычислитель — x86 на плате Mini-ITX (общедоступный стандарт с 2001 года, крепёж и размер 170 × 170 мм не меняются). Старт: ASRock N100DC-ITX (N100, без вентилятора, питание DC). Апгрейд: любая Mini-ITX с 8-ядерным Ryzen, лимит мощности 35–45 Вт в BIOS. Компактная альтернатива — LattePanda Mu. COM Express — только если дойдёт до Kickstarter. Экран через плату-контроллер HDMI → панель. Уточняет P16 (было P36) | 12 (раздел 6) |
| R40 | 31.10.2026 | Аккумулятор — позже; в первой версии закладываем отсек и разъём под съёмный аккумулятор до 99 Вт·ч (уточняет P17) | 11 |
| R58 | 31.10.2026 | Сменный вычислительный модуль (CM5 → x86/ARM мощнее) (было P16) | 12 *(уточнено: вычислитель уточнён R36 (Mini-ITX))* |
| R59 | 31.10.2026 | Аккумулятор съёмный, до 99 Вт·ч; работа без него от USB-C PD 65–100 Вт (было P17) | 11 *(уточнено: отсек — R109)* |
| R76 | 31.10.2026 | На M93 ставим Linux начисто (Windows там нет, стоял Home Assistant); система для замера — Ubuntu Studio 26.04 LTS | 18 |
| R146 | 14.11.2026 | Сколько можно на огни, прошивка узнаёт по факту: датчик **INA226** на шунте 5 мОм в общей шине питания (после выключателя) меряет весь вход от любого источника и аккумулятора; читает его по I²C хаб панели **P2**, который и управляет огнями (у RP2350 на R2 свободных выводов нет). Ответ на В14: вариант (а) | `hardware/pw-power/README.md` |
| R147 | 14.11.2026 | Адаптер DC — **19–24 В** (так в инструкции); от 12 В (гнездо 5 А = 60 Вт) — работа с урезанной яркостью огней по R146. Позже, когда будет выбран процессор, можно ограничить и его частоту. Ответ на В15: «Да. Согласен по огням» | `hardware/pw-power/README.md` |
