MitjaGrecky/Shtuka-druka/docs/ru/decisions/06_audio.md

# Решения: Аудиотракт и звуковая карта

*Электрика звука: преобразователи, предусилители, выходные каскады, генераторы, USB-аудио.*

Общие правила ведения и приоритеты — в [README](README.md).

## Действует

| № | Дата | Решение | Где подробно |
|---|---|---|---|
| R16 | 28.10.2026 | Усиление входов — энкодеры с цифровым предусилителем (запоминание, авто-подстройка, защита от перегруза) | 11 |
| R64 | 31.10.2026 | Main и Aux — импедансно-балансные, шины ±12 В, максимум ≥ +18 dBu (было P22) | 15 |
| R65 | 31.10.2026 | Aux с режимом «Педали» (около −20 дБ, несимметричный) + возврат через гитарные входы Hi-Z + эффект «Внешняя педаль» (было P23) | 15 |
| R66 | 31.10.2026 | Ключи отключения на всех выходах (1–2 с при включении, мгновенно при пропадании питания), управляет плата панели (было P24) | 15 |
| R67 | 31.10.2026 | Наушники: ≥4 В на 600 Ом, ≥30 мА на 32 Ом, источник Main/Cue (было P25) | 15 |
| R82 | 31.10.2026 | Аудиоплата с двумя USB High-Speed: порт A — внутренний вычислитель, порт B — внешний компьютер (USB-C сзади); по чипу xcore.ai на порт, общая шина TDM и один генератор, асинхронный режим без пересчёта частоты (было P46) | 20 |
| R83 | 31.10.2026 | Каналы: внешний компьютер видит карту 32 × 16 + MIDI; внутренний канал 32 × 40 (было P47) | 20 |
| R84 | 31.10.2026 | Частота: железо сразу рассчитано на 96 кГц; по умолчанию устройство работает на 48 кГц; 96 кГц — режим проекта для всего устройства (дорожек ≈ вдвое меньше), включая карту для внешнего компьютера Пользователь: «закладываем в основу 96, работаем на 48, даём пользователю включить режим». (было P48) | 20 (раздел 6) |
| R87 | 31.10.2026 | Громкость Main и наушников — софтом: потенциометры с упорами читает панель, громкость ставит аттенюатор AK4458. Условие пользователя: потенциометр «конечный и понятный человеку и машине» — положение ручки однозначно равно громкости, без скрытых состояний (было P52) | 21 (раздел 5) *(уточнено: чип ЦАП теперь CS4308P (R116), аттенюатор — в нём)* |
| R88 | 31.10.2026 | Два запасных канала АЦП остаются свободными и назначаемыми: «если оставить, степень импровизации вырастает» | 21 (раздел 3) |
| R114 | 01.11.2026 | Два генератора: 24,576 МГц (48/96 кГц) и 22,5792 МГц (44,1/88,2 кГц); частота — настройка проекта, по умолчанию 48 кГц (было P50): «мы договорились о том, что ничего не стоит, поэтому ставим» | 21 (раздел 4) |
| R116 | 01.11.2026 | Преобразователи — Cirrus Logic Pro (2024–2025): АЦП CS5308P × 2 + CS5304P × 1 (20 каналов, 123 дБА, одно питание 3,3 В), ЦАП CS4308P (8 каналов, 123 дБА, THD+N −115 дБ); операционные усилители, xcore.ai, ADuM4166, PDM-микрофон — как в документе 21. Заменяет P49 (AKM 2016 года) (было P73): «Принимаю» | 28 |
| R117 | 01.11.2026 | Входы Mic/Line 1–2 и Hi-Z 1–2 — без микросхемы-предусилителя: постоянное усиление на OPA1612 и два канала АЦП на вход («тихий» и «громкий» путь), склейка в xcore.ai A с запасом ≈ 150 дБ, как в рекордерах с 32-bit float; ручка Gain (R16) — точное цифровое усиление; два запасных канала (R88) сохраняются (было P74): «Принимаю» | 28 |
| R118 | 01.11.2026 | Плата управления (RP2350) ведёт фантом 48 В по каналам, фоно/линия и ключи выходов со сторожем (R86); склейка путей и цифровое усиление входов — в xcore.ai A (было P51): «Принимаю» | 21 (раздел 9.2), 28 (раздел 5) |
| R135 | 13.11.2026 | Линейные входы 1–8 — запас до **+24 dBu** (ослабление в драйвере АЦП под полную шкалу CS5308P): «+24» | 34 (раздел 2.2) |
| R136 | 13.11.2026 | ЦАП — **Cirrus CS4308P** (выход по напряжению, 123 дБА, как у АЦП); его нет в библиотеке EasyEDA — символ и посадочное место рисуем сами. ESS ES9039PRO и AKM AK4499EX рассмотрены: токовый выход, нужны преобразователи ток–напряжение на каждый канал, выигрыш съедают аналоговые каскады. Пользователь: «Берём или cs4308p или можешь поискать схожие альтернативы или лучше» **Уточнение 14.11.2026 (ПК):** по заметке Cirrus AN0679 у CS4308P тоже **токовый выход** — нужен преобразователь ток–напряжение на ОУ (1,2 кОм ∥ 620 пФ на плечо, полная шкала 2 Vrms) на A1; довод против ES9039PRO / AK4499EX («токовый выход») поэтому неверен, выбор CS4308P держится на 123 дБА и одном семействе с АЦП. | 34 (раздел 3) |
| R137 | 13.11.2026 | Ключи отключения выходов (R66) — **реле** с нормально разомкнутым контактом: размыкаются сами при пропадании питания. «Реле. Весь уважающий себя хайфай и прочий хай энд построен на реле» | 34 (раздел 3) |
