MitjaGrecky/Shtuka-druka/docs/ru/decisions/05_io.md

# Решения: Входы, выходы, разъёмы

*Какие гнёзда есть, сколько и где: аудио, MIDI, CV, синхро, USB, задняя панель.*

Общие правила ведения и приоритеты — в [README](README.md).

## Действует

| № | Дата | Решение | Где подробно |
|---|---|---|---|
| R3 | 27.10.2026 | Входы: микрофон (динамический и с фантомом), фоно, гитара; балансные входы и выходы; CV и синхронизация | 02, 11 |
| R8 | 28.10.2026 | Отдельные громкости мониторов и наушников, выходы наушников спереди | 04 |
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
