MitjaGrecky/Shtuka-druka/docs/ru/img/rear_panel_render.png

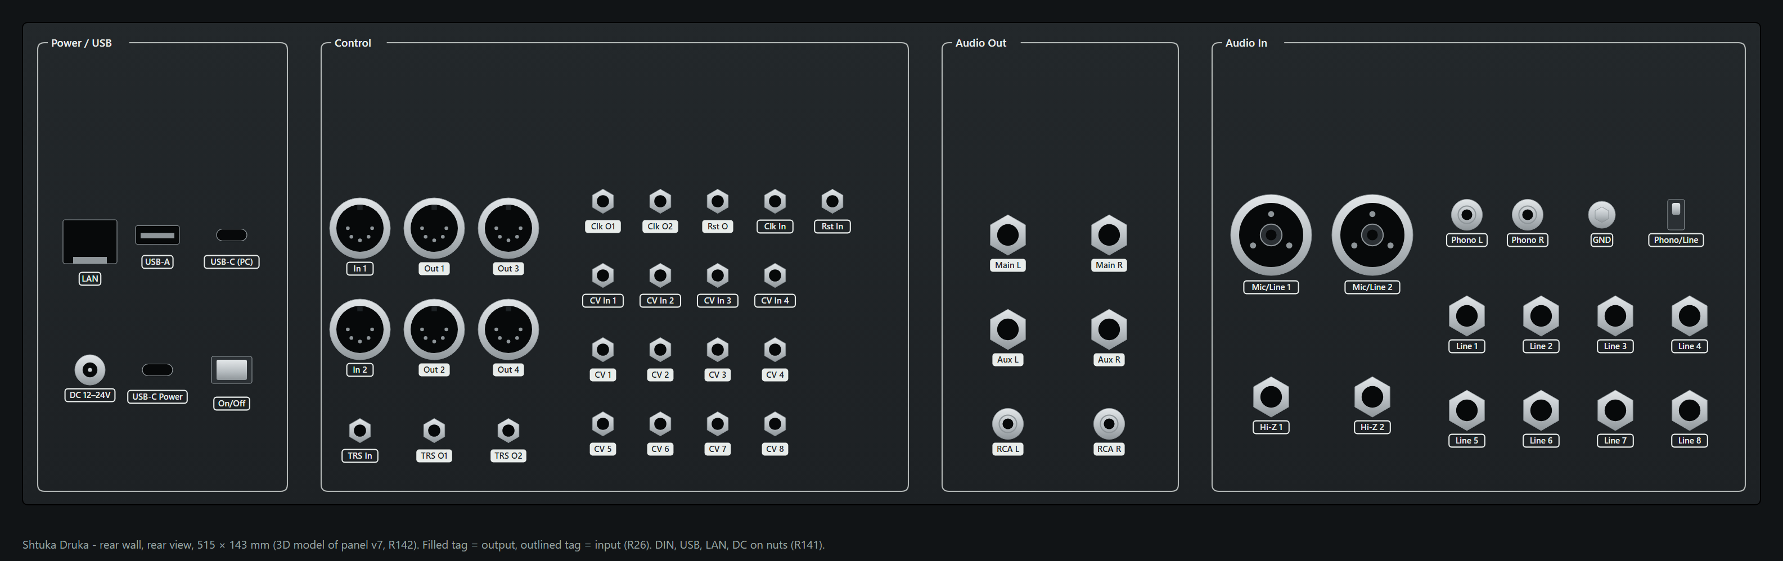
docs/ru/img/rear_panel_render.png
