MitjaGrecky/Shtuka-druka/docs/ru/img/rear_panel_v1.png

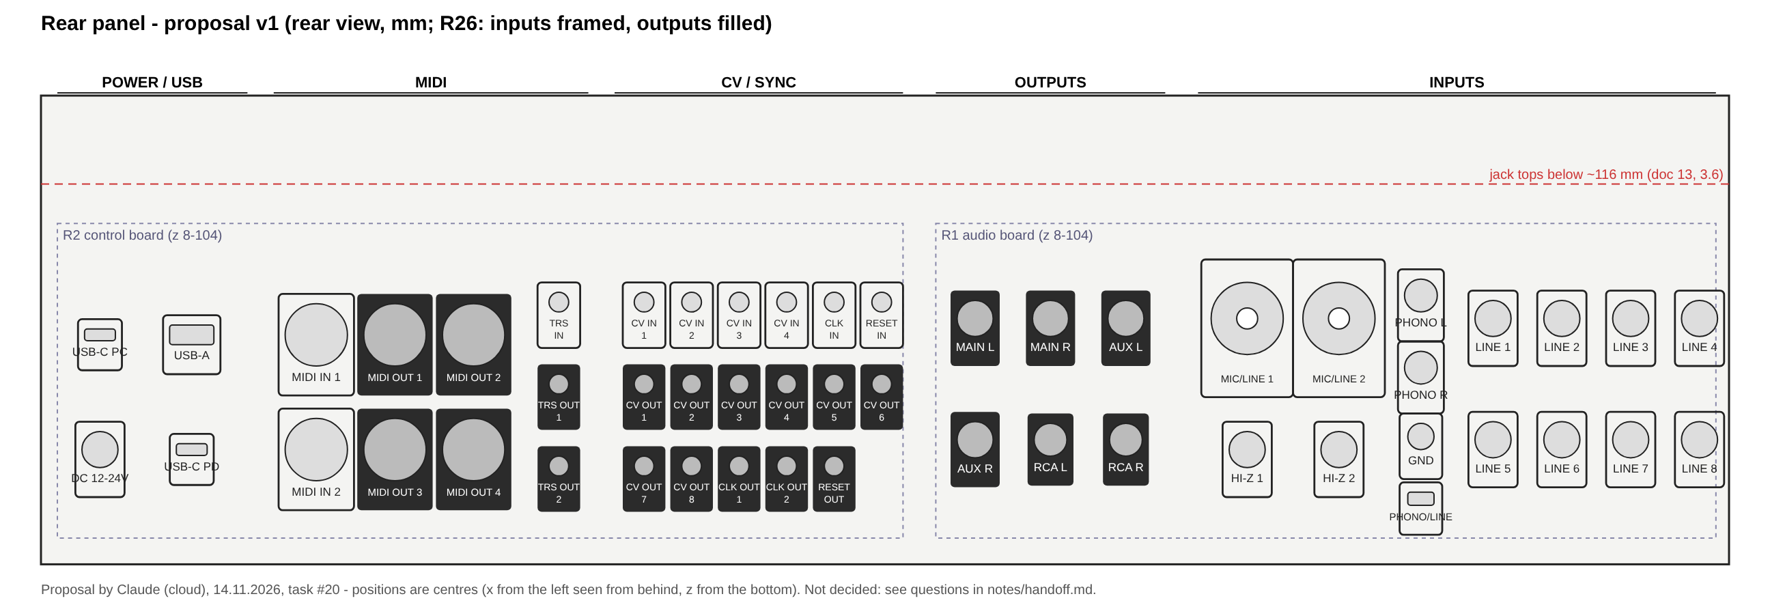
docs/ru/img/rear_panel_v1.png
