MitjaGrecky/Shtuka-druka/docs/ru/img/rear_panel_v2.png

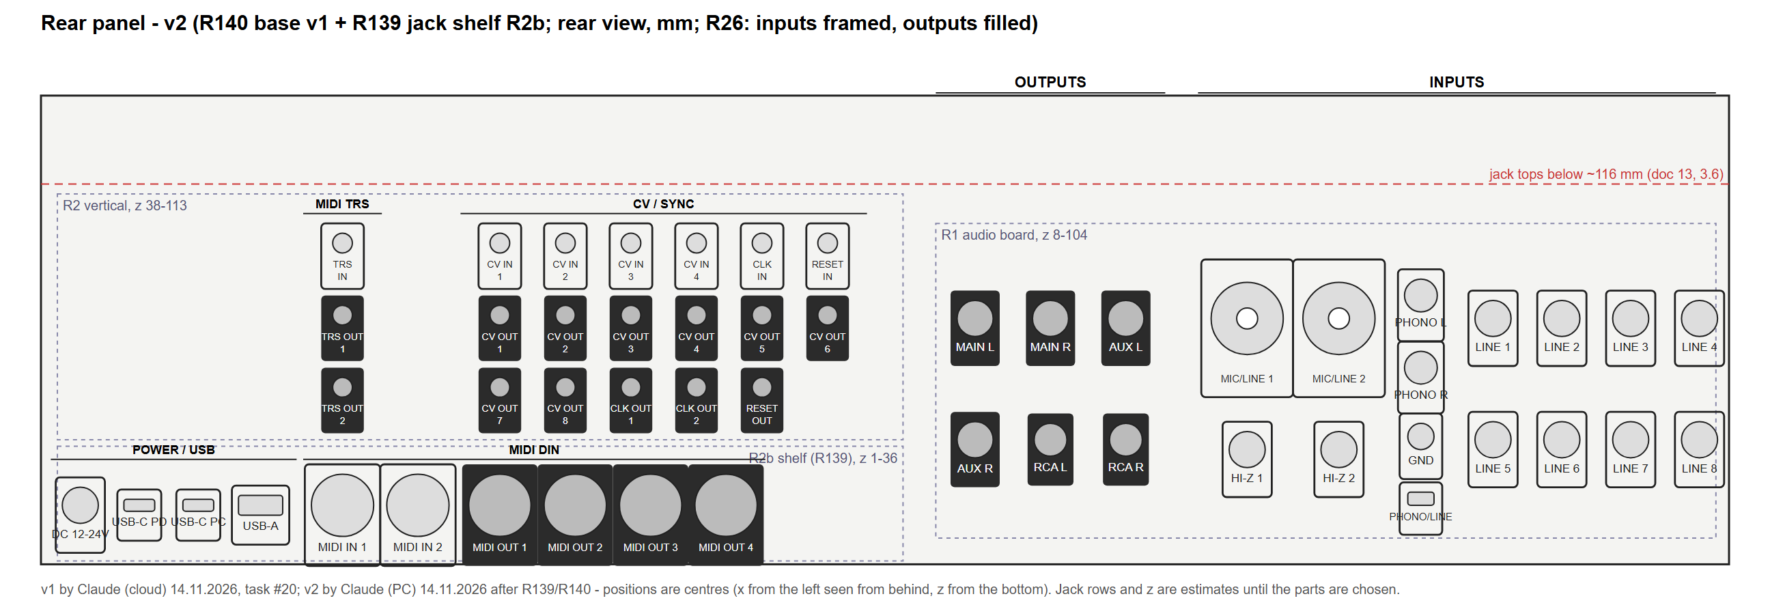
docs/ru/img/rear_panel_v2.png
