MitjaGrecky/Shtuka-druka/docs/ru/img/rear_panel_v3.png

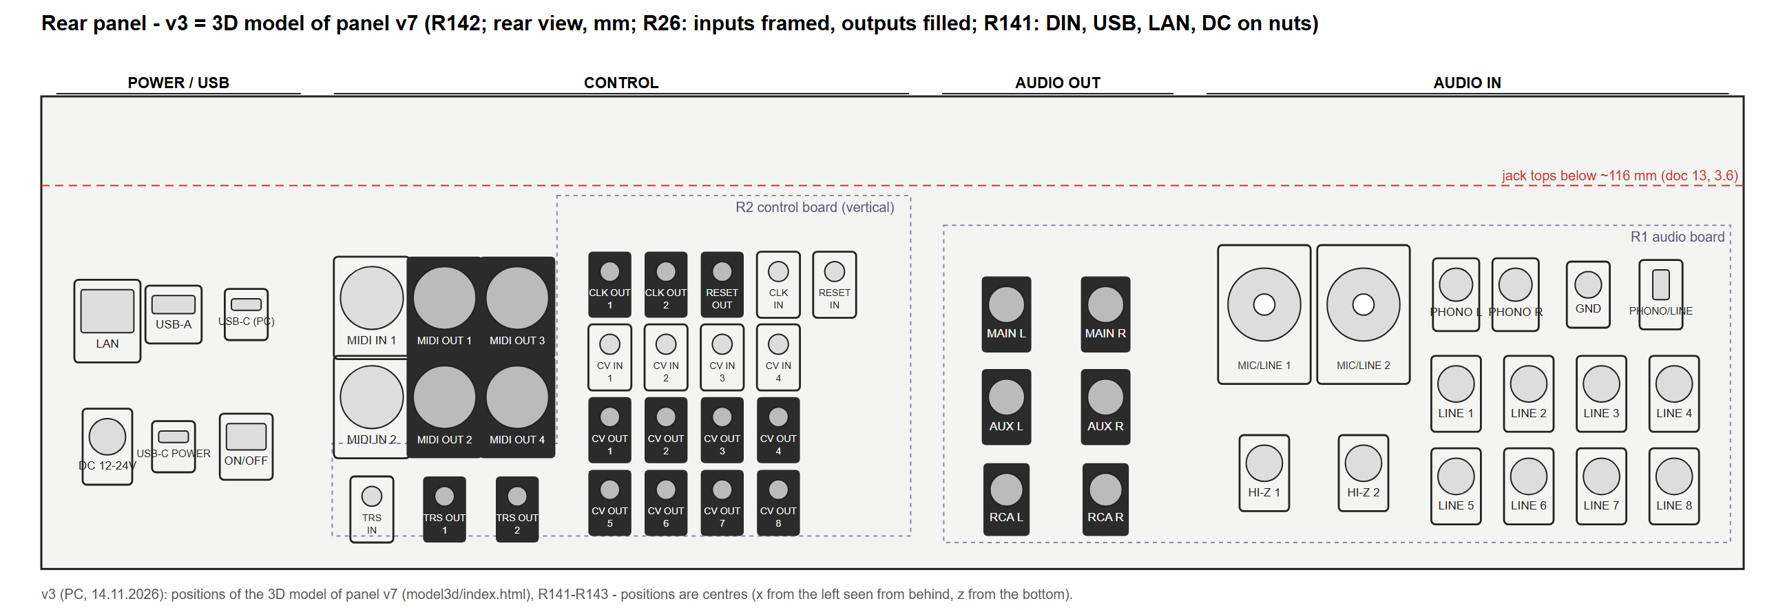
docs/ru/img/rear_panel_v3.png
