MitjaGrecky/Shtuka-druka/docs/ru/panel_v7_grid.png

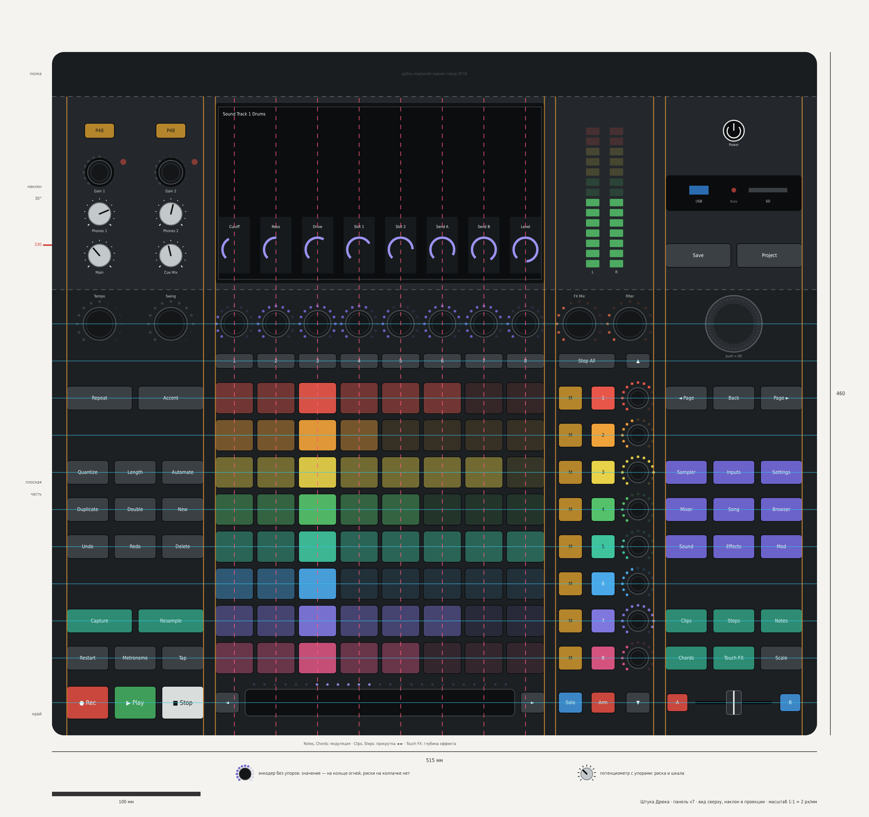
docs/ru/panel_v7_grid.png
