MitjaGrecky/Shtuka-druka/hardware/for-routing/M3/preview_bottom.png

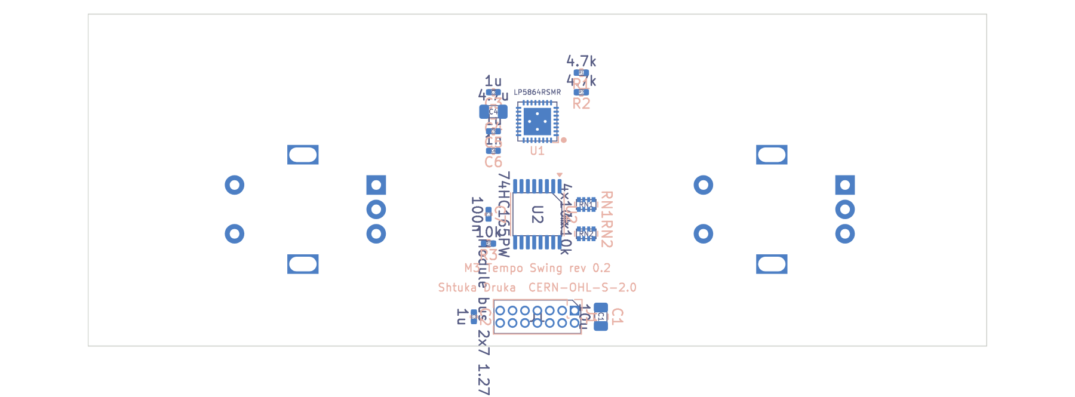
hardware/for-routing/M3/preview_bottom.png
