MitjaGrecky/Shtuka-druka/hardware/for-routing/M3/preview_easyeda.jpg

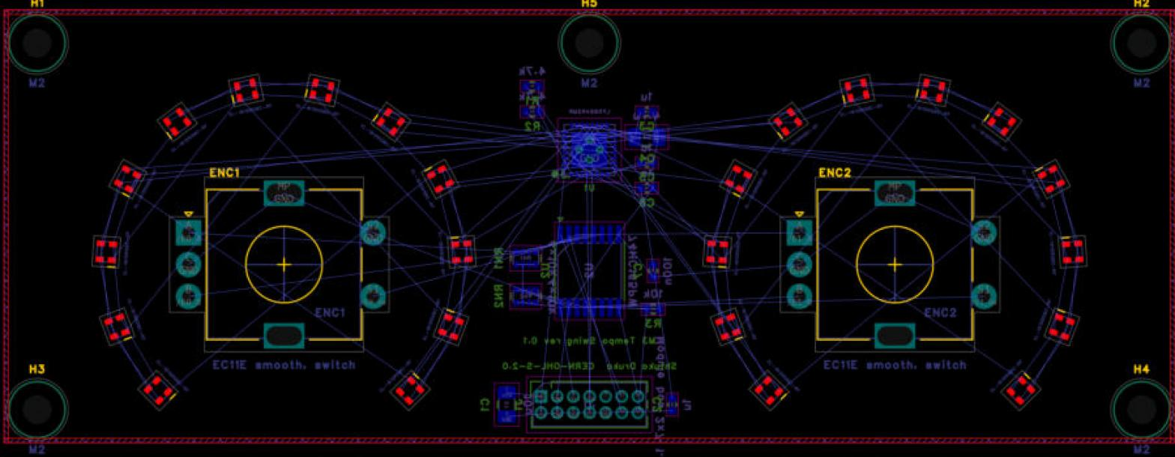
hardware/for-routing/M3/preview_easyeda.jpg
