MitjaGrecky/Shtuka-druka/hardware/for-routing/M3/preview_top.png

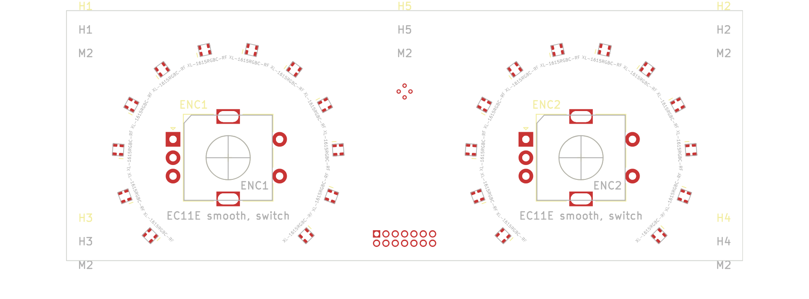
hardware/for-routing/M3/preview_top.png
