MitjaGrecky/Shtuka-druka/hardware/for-routing/M4/preview_bottom.png

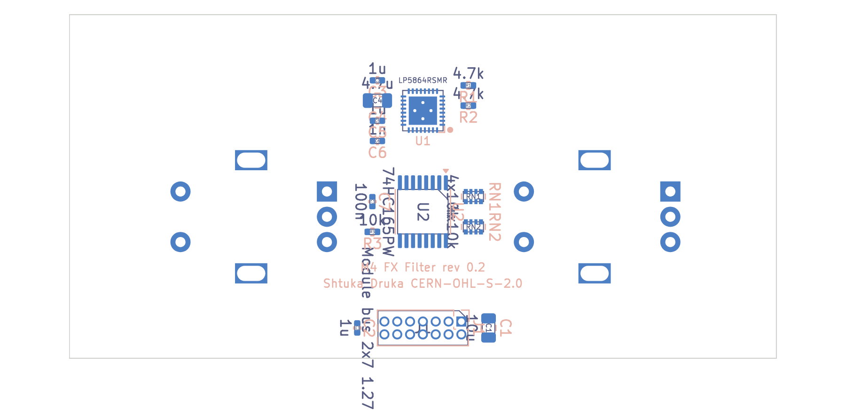
hardware/for-routing/M4/preview_bottom.png
