MitjaGrecky/Shtuka-druka/hardware/for-routing/M4/preview_easyeda.jpg

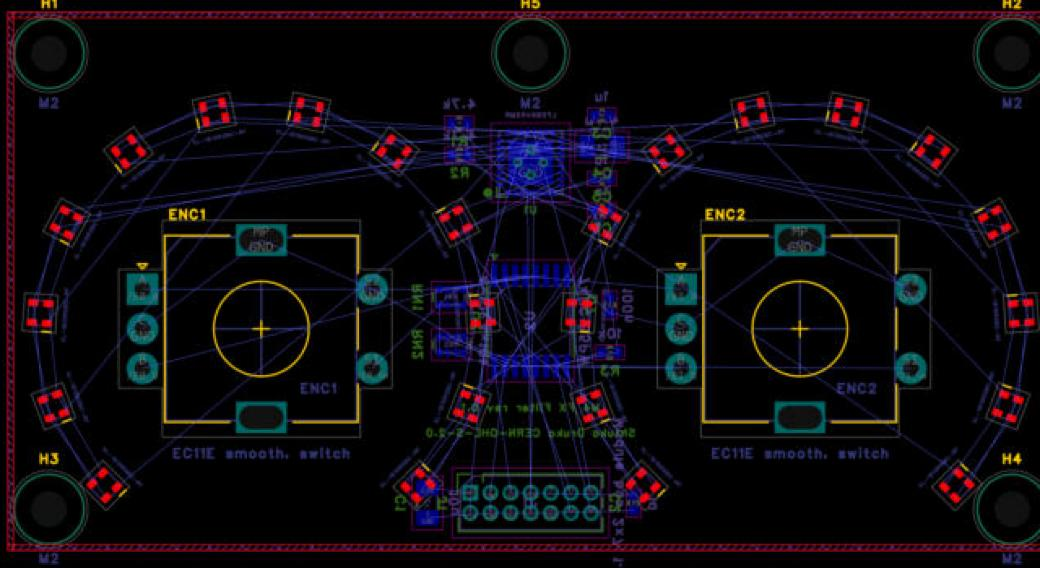
hardware/for-routing/M4/preview_easyeda.jpg
