MitjaGrecky/Shtuka-druka/hardware/for-routing/M4/preview_top.png

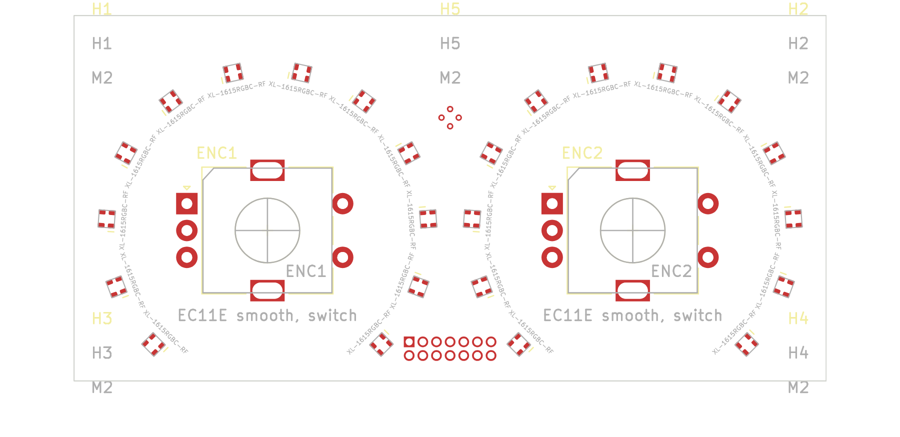
hardware/for-routing/M4/preview_top.png
