MitjaGrecky/Shtuka-druka/hardware/for-routing/M5/preview_bottom.png

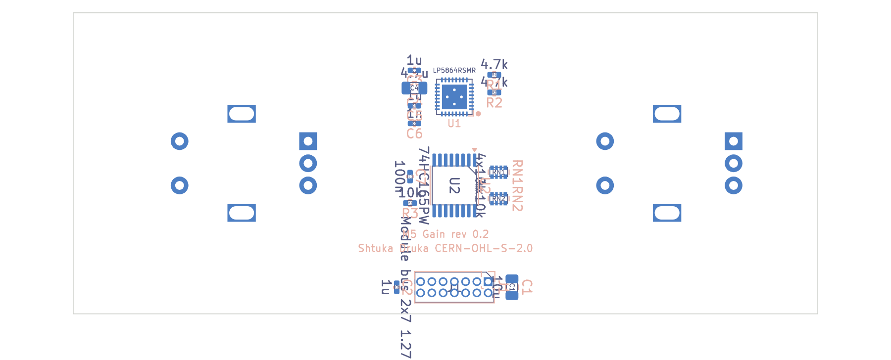
hardware/for-routing/M5/preview_bottom.png
