MitjaGrecky/Shtuka-druka/hardware/for-routing/M5/preview_easyeda.jpg

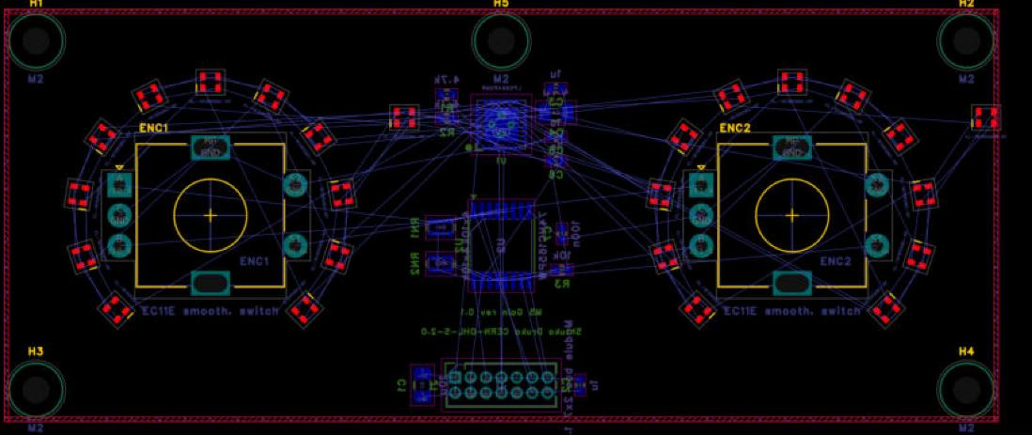
hardware/for-routing/M5/preview_easyeda.jpg
