MitjaGrecky/Shtuka-druka/hardware/for-routing/M5/preview_top.png

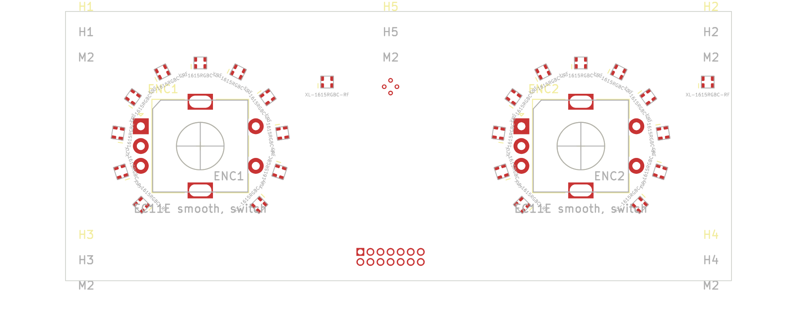
hardware/for-routing/M5/preview_top.png
