MitjaGrecky/Shtuka-druka/hardware/for-routing/P1/preview_bottom.png

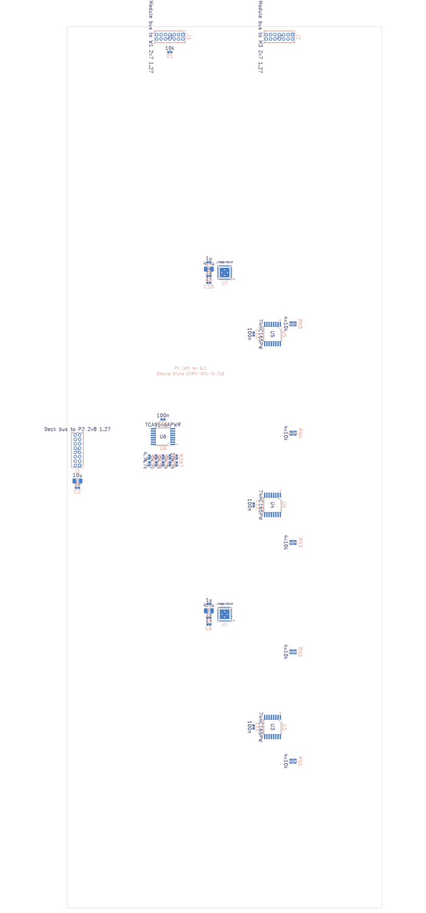
hardware/for-routing/P1/preview_bottom.png
