MitjaGrecky/Shtuka-druka/hardware/for-routing/P1/preview_easyeda.jpg

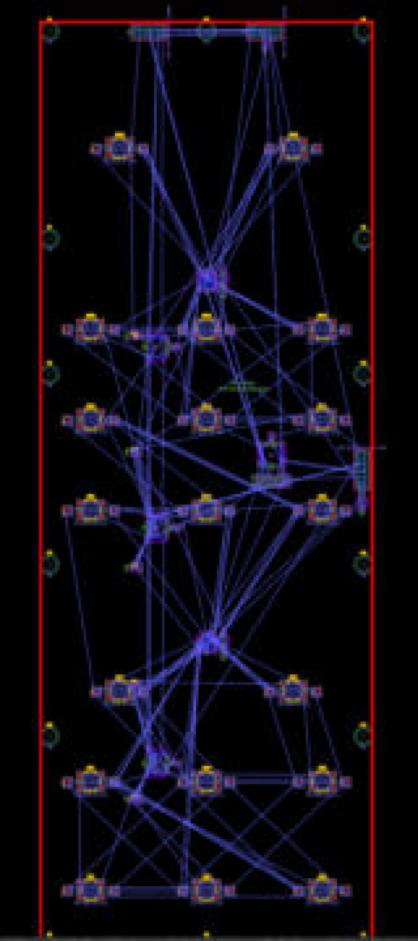
hardware/for-routing/P1/preview_easyeda.jpg
