MitjaGrecky/Shtuka-druka/hardware/for-routing/P1/preview_top.png

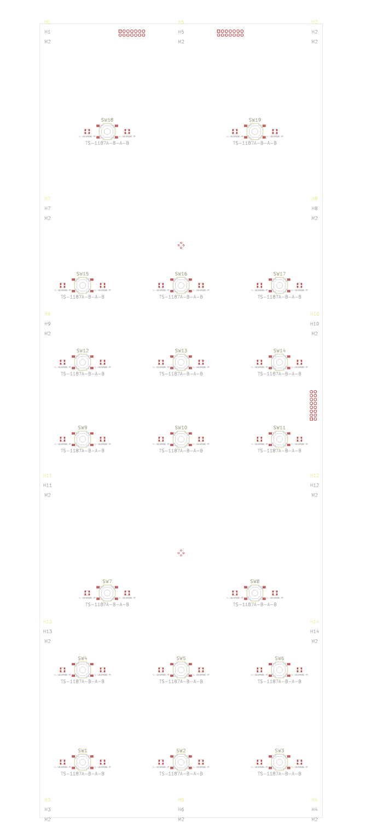
hardware/for-routing/P1/preview_top.png
