MitjaGrecky/Shtuka-druka/hardware/for-routing/P3/preview_bottom.png

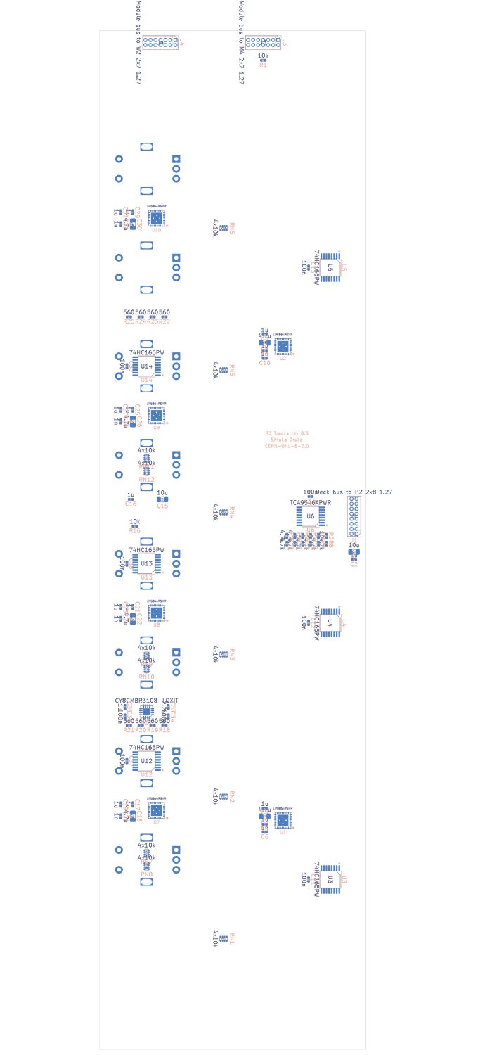
hardware/for-routing/P3/preview_bottom.png
