MitjaGrecky/Shtuka-druka/hardware/for-routing/P3/preview_easyeda.jpg

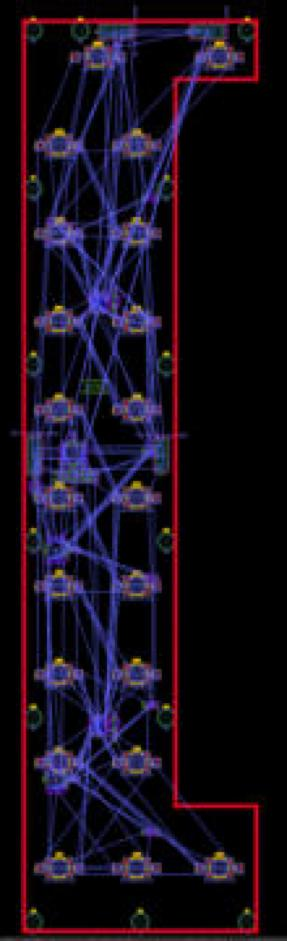
hardware/for-routing/P3/preview_easyeda.jpg
