MitjaGrecky/Shtuka-druka/hardware/for-routing/P3/preview_top.png

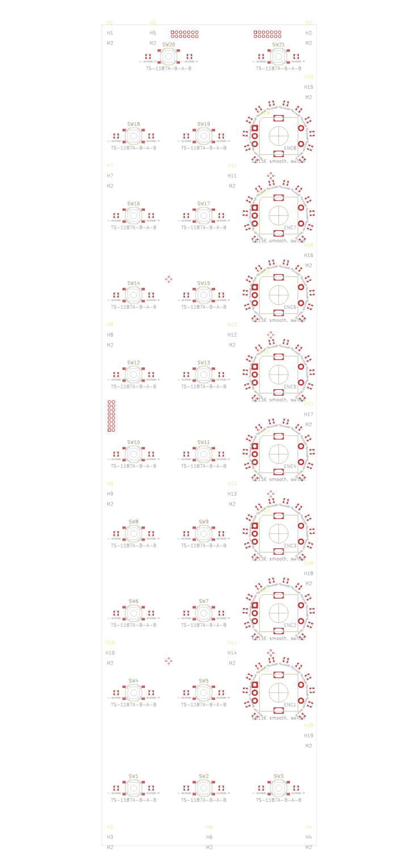
hardware/for-routing/P3/preview_top.png
