MitjaGrecky/Shtuka-druka/hardware/for-routing/P4/preview_bottom.png

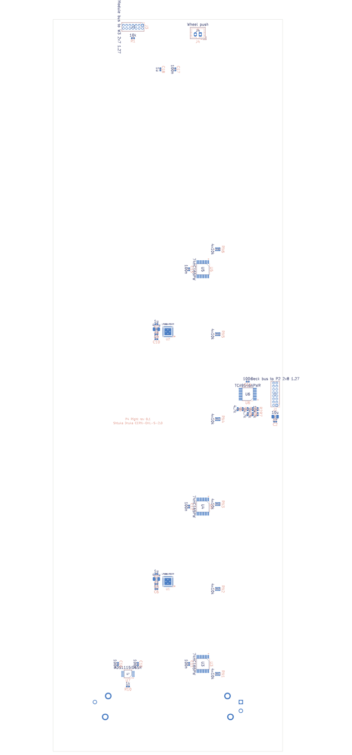
hardware/for-routing/P4/preview_bottom.png
