MitjaGrecky/Shtuka-druka/hardware/for-routing/P4/preview_easyeda.jpg

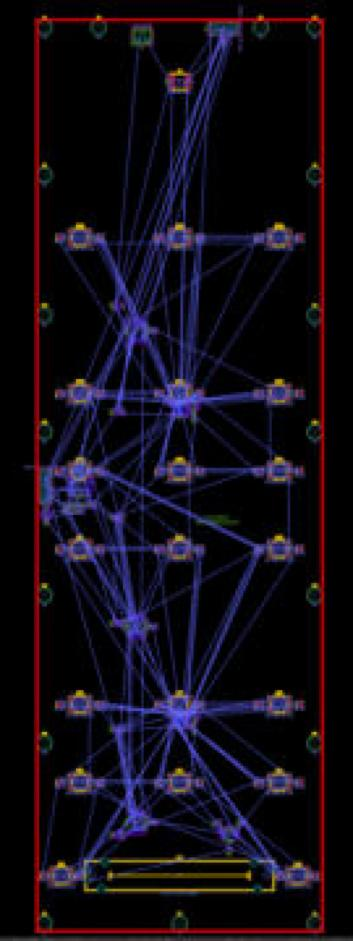
hardware/for-routing/P4/preview_easyeda.jpg
