MitjaGrecky/Shtuka-druka/hardware/for-routing/P4/preview_top.png

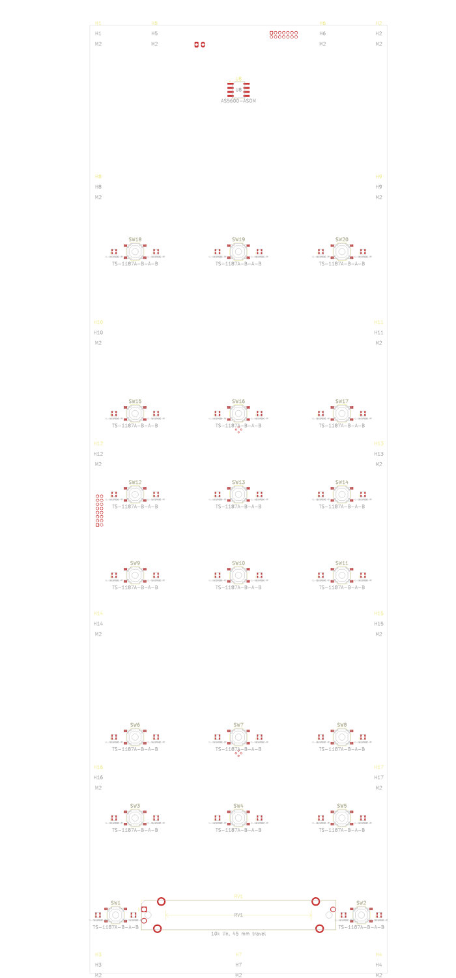
hardware/for-routing/P4/preview_top.png
