MitjaGrecky/Shtuka-druka/hardware/for-routing/W1/preview_bottom.png

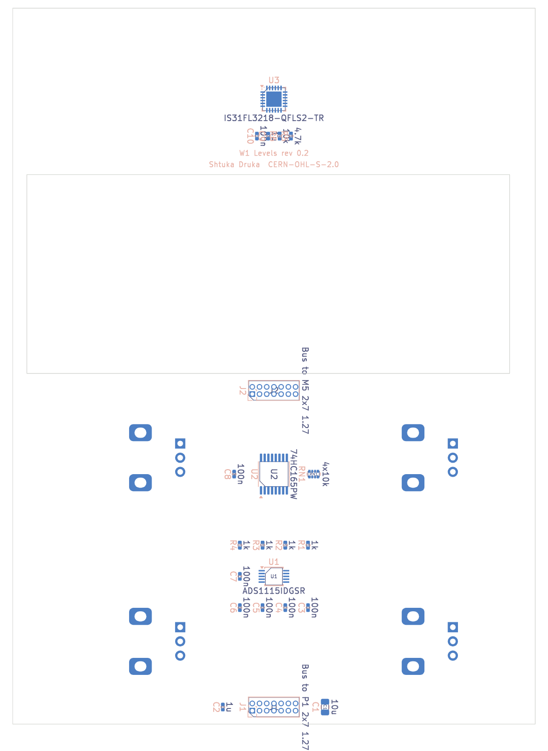
hardware/for-routing/W1/preview_bottom.png
