MitjaGrecky/Shtuka-druka/hardware/for-routing/W1/preview_top.png

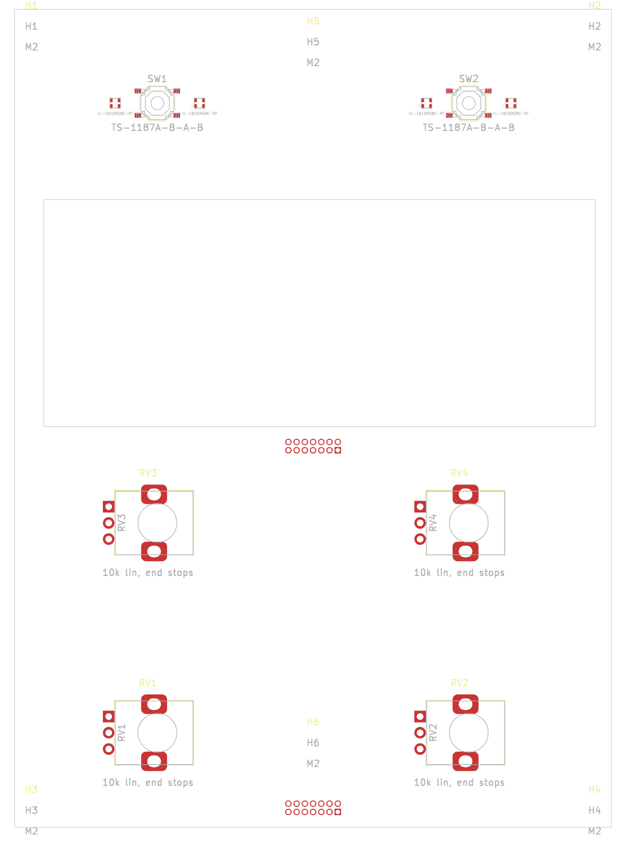
hardware/for-routing/W1/preview_top.png
