MitjaGrecky/Shtuka-druka/hardware/for-routing/W2/preview_bottom.png

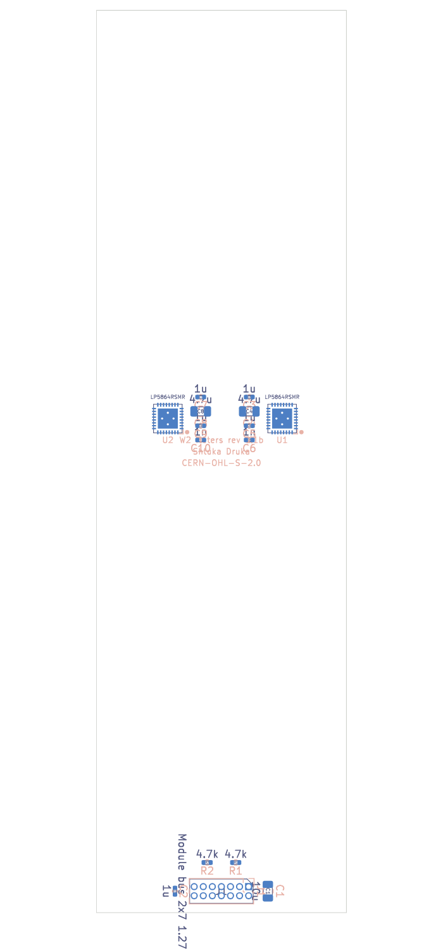
hardware/for-routing/W2/preview_bottom.png
