MitjaGrecky/Shtuka-druka/hardware/for-routing/W2/preview_easyeda.jpg

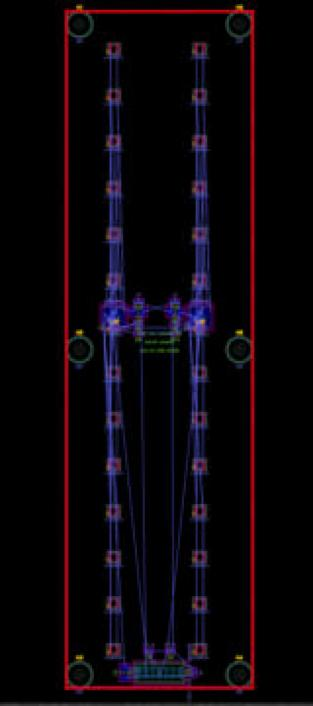
hardware/for-routing/W2/preview_easyeda.jpg
