MitjaGrecky/Shtuka-druka/hardware/for-routing/W2/preview_top.png

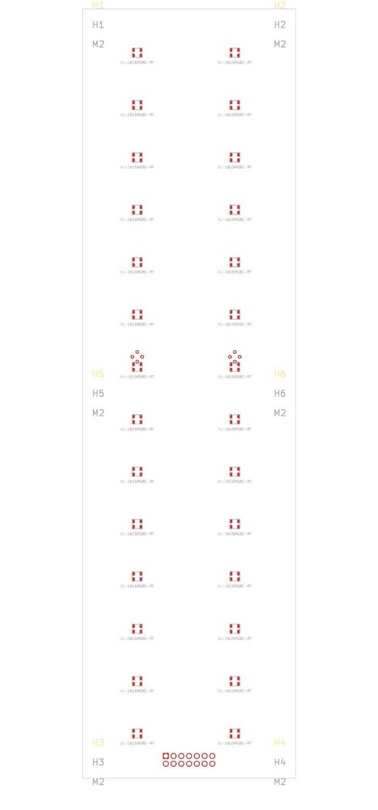
hardware/for-routing/W2/preview_top.png
