MitjaGrecky/Shtuka-druka/hardware/for-routing/W3/preview_bottom.png

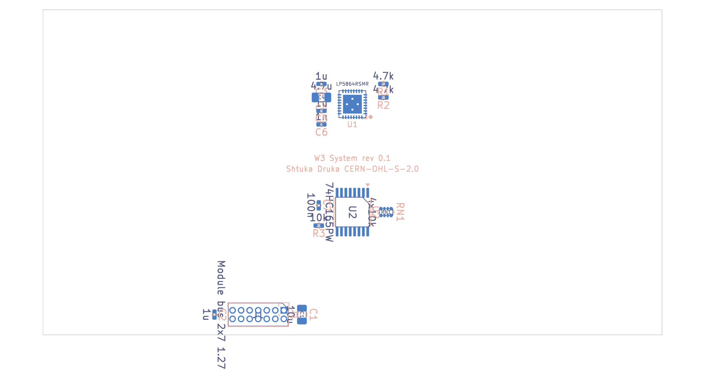
hardware/for-routing/W3/preview_bottom.png
