MitjaGrecky/Shtuka-druka/hardware/for-routing/W3/preview_easyeda.jpg

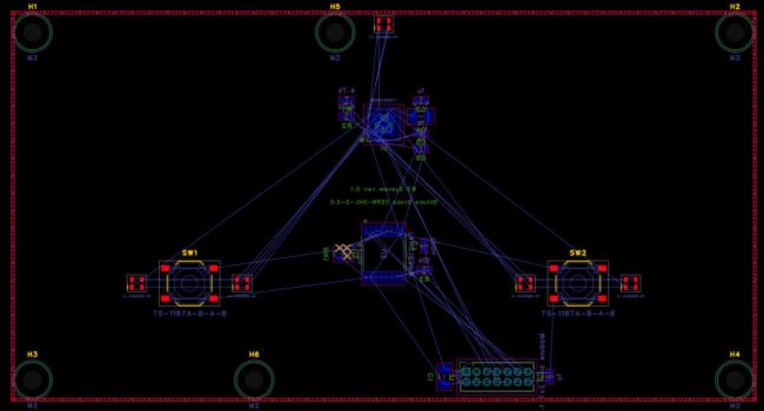
hardware/for-routing/W3/preview_easyeda.jpg
