MitjaGrecky/Shtuka-druka/hardware/for-routing/W3/preview_top.png

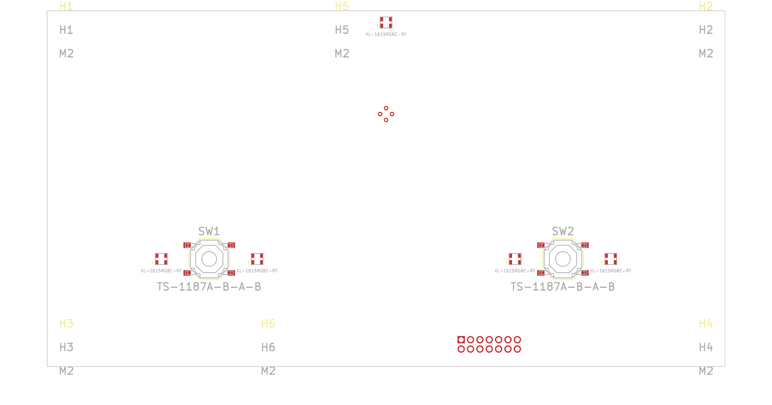
hardware/for-routing/W3/preview_top.png
