MitjaGrecky/Shtuka-druka/hardware/m1-screen-knobs/mech/m1_fixed_vs_movable.png

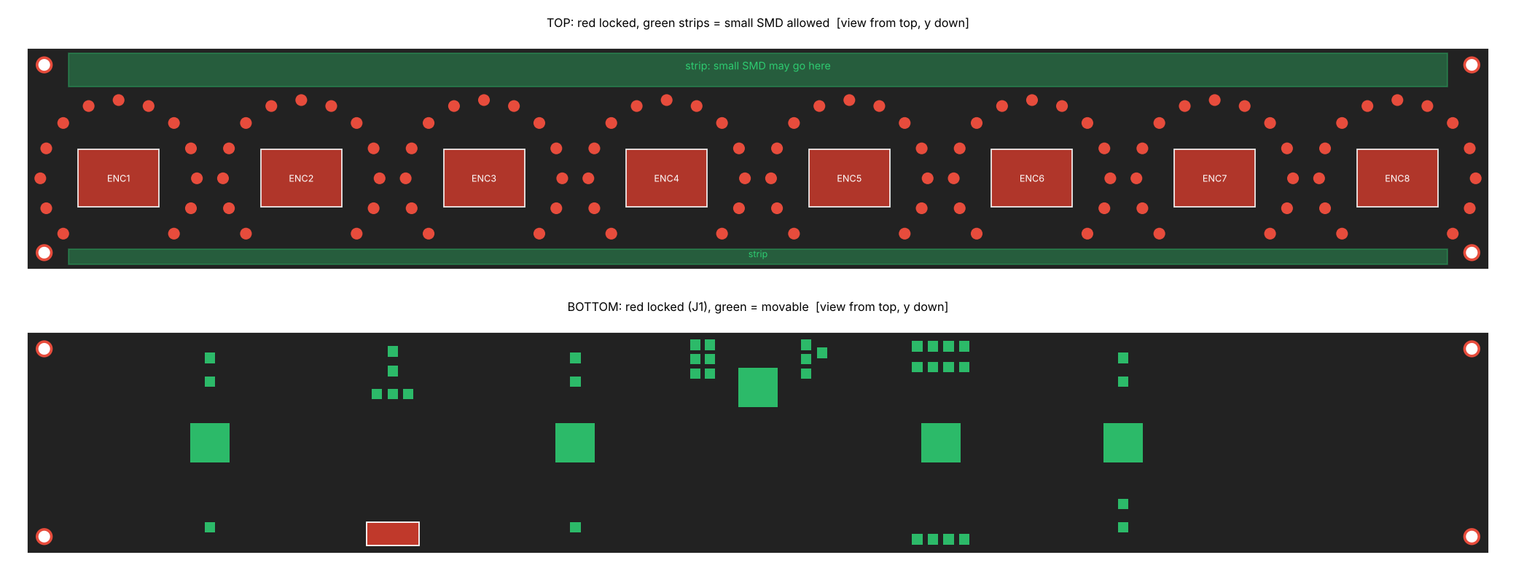
hardware/m1-screen-knobs/mech/m1_fixed_vs_movable.png
