MitjaGrecky/Shtuka-druka/hardware/for-routing/R2/BOM.csv

Comment | Designator | Footprint | LCSC Part #
Power from PW | J1 | JST_PH_B5B-PH-K_1x05_P2.00mm_Vertical
AP2112K-3.3 | U1 | SOT-23-5 | C51118
1u | C1,C2,C8,C29 | C_0402_1005Metric | C52923
100n | C3,C4,C5,C6,C11,C12,C13,C14,C15,C16,C17,C18,C19,C20,C21,C24,C25,C26,C30,C31,C32,C33,C34,C35,C37,C38,C39,C40,C41,C42,C43,C44,C45,C46,C47,C48,C49,C50,C51,C52,C53,C54 | C_0402_1005Metric | C1525
RP2350A | U2 | QFN-60-1EP_7x7mm_P0.4mm_EP3.4x3.4mm | C42411118
3.3uH | L1 | L_Abracon_AOTA-B201610S | C42411119
33 | R1,R2 | R_0402_1005Metric
4.7u | C7,C9,C10,C36 | C_0805_2012Metric | C1779
10k | R3,R5,R10,R12,R15,R39,R40,R41,R43,R46,R48,R51,R53,R56,R58,R61,R63,R66,R68,R71,R73,R76,R78,R82,R85,R88,R104,R107 | R_0402_1005Metric | C25744
12MHz | Y1 | Crystal_SMD_3225-4Pin_3.2x2.5mm | C20625731
1k | R4,R6,R9,R45,R50,R55,R60,R65,R70,R75,R80,R83,R86,R89 | R_0402_1005Metric | C11702
15p | C22,C23 | C_0402_1005Metric
W25Q128JVSIQ | U3 | SOIC-8_5.3x5.3mm_P1.27mm | C97521
BOOTSEL | SW1 | SW_Push_1P1T_XKB_TS-1187A | C318884
27 | R7,R8 | R_0402_1005Metric
SWD | J2 | JST_PH_B3B-PH-K_1x03_P2.00mm_Vertical
green | D1 | LED_0603_1608Metric
USB2514B | U4 | QFN-36-1EP_6x6mm_P0.5mm_EP3.7x3.7mm | C220679
12k | R11 | R_0402_1005Metric
24MHz | Y2 | Crystal_SMD_3225-4Pin_3.2x2.5mm | C70590
18p | C27,C28 | C_0402_1005Metric
100k | R13,R14,R16,R17,R18,R19,R20,R21,R22,R90,R93,R96,R99,R103,R106 | R_0402_1005Metric
USB up | J3 | JST_PH_B4B-PH-K_1x04_P2.00mm_Vertical
USB down | J4,J5,J6 | JST_PH_B4B-PH-K_1x04_P2.00mm_Vertical
DIN OUT 1 | J7 | JST_PH_B3B-PH-K_1x03_P2.00mm_Vertical
DIN OUT 2 | J8 | JST_PH_B3B-PH-K_1x03_P2.00mm_Vertical
DIN OUT 3 | J9 | JST_PH_B3B-PH-K_1x03_P2.00mm_Vertical
DIN OUT 4 | J10 | JST_PH_B3B-PH-K_1x03_P2.00mm_Vertical
DIN IN 1 | J11 | JST_PH_B2B-PH-K_1x02_P2.00mm_Vertical
DIN IN 2 | J12 | JST_PH_B2B-PH-K_1x02_P2.00mm_Vertical
to A1/R1 | J13 | PinHeader_2x07_P2.54mm_Vertical
74HC595 | U5 | SOIC-16_3.9x9.9mm_P1.27mm | C5947
33 | R23,R25,R27,R29 | R_1206_3216Metric
10 | R24,R26,R28,R30 | R_0402_1005Metric
220 | R31,R32,R37,R38 | R_0402_1005Metric
1N4148W | D2,D3,D8,D9 | D_SOD-123
TLP2361 | U6,U7,U8,U9 | SO-5-6_4.55x3.7mm_P1.27mm | C107626
PJ-3920-3A | J14,J15,J16 | Jack_3.5mm_Hroparts_PJ-3920-3A_Vertical | C707259
22 | R33,R34,R35,R36 | R_0402_1005Metric
DAC80504 | U10,U11 | Texas_RTE0016D_WQFN-16-1EP_3x3mm_P0.5mm_EP0.8x0.8mm_ThermalVias | C2862796
80.6k | R42,R44,R47,R49,R52,R54,R57,R59,R62,R64,R67,R69,R72,R74,R77,R79 | R_0402_1005Metric
PJ398SM | J17,J18,J19,J20,J21,J22,J23,J24,J25,J26,J27,J28,J29,J30,J31,J32,J33 | Jack_3.5mm_QingPu_WQP-PJ398SM_Vertical_CircularHoles | C9900009788
5.1k | R81,R84,R87 | R_0402_1005Metric
OPA4197 | U12,U13,U14 | TSSOP-14_4.4x5mm_P0.65mm | C2057327
33k | R91,R94,R97,R100 | R_0402_1005Metric
39k | R92,R95,R98,R101 | R_0402_1005Metric
10n | C55,C56,C57,C58 | C_0402_1005Metric
BAT54S | D4,D5,D6,D7 | SOT-23
22k | R102,R105 | R_0402_1005Metric
MMBT3904 | Q1,Q2 | SOT-23
