MitjaGrecky/Shtuka-druka/hardware/for-routing/P3/BOM.csv

Comment | Designator | Footprint | LCSC Part #
Deck bus to P2 2x8 1.27 | J1 | PinHeader_2x08_P1.27mm_Vertical | C5372812
Module bus to M4 2x7 1.27 | J3 | PinHeader_2x07_P1.27mm_Vertical | C5372811
Module bus to W2 2x7 1.27 | J4 | PinHeader_2x07_P1.27mm_Vertical | C5372811
10u | C1,C15 | C_0805_2012Metric | C15850
1u | C2,C3,C5,C7,C9,C16,C17,C19,C21,C23,C25,C27,C29,C31,C35 | C_0402_1005Metric | C52923
10k | R1,R2,R16 | R_0402_1005Metric | C25744
TCA9546APWR | U6 | TSSOP-16_4.4x5mm_P0.65mm | C201653
100n | C11,C12,C13,C14,C34,C36,C37,C38,C39 | C_0402_1005Metric | C1525
0 | R3,R4,R5 | R_0402_1005Metric | C17168
4.7k | R6,R7,R8,R9,R10,R11,R12,R13 | R_0402_1005Metric | C25900
LP5864RSMR | U1,U2,U7,U8,U9,U10 | VQFN-32-1EP_4x4mm_P0.4mm_EP2.8x2.8mm | C5220564
4.7u | C4,C8,C18,C22,C26,C30 | C_0805_2012Metric | C1779
1n | C6,C10,C20,C24,C28,C32 | C_0402_1005Metric | C1523
TS-1187A-B-A-B | SW1,SW2,SW3,SW4,SW5,SW6,SW7,SW8,SW9,SW10,SW11,SW12,SW13,SW14,SW15,SW16,SW17,SW18,SW19,SW20,SW21 | SW_Push_1P1T_XKB_TS-1187A | C318884
XL-1615RGBC-RF | D1,D2,D3,D4,D5,D6,D7,D8,D9,D10,D11,D12,D13,D14,D15,D16,D17,D18,D19,D20,D21,D22,D23,D24,D25,D26,D27,D28,D29,D30,D31,D32,D33,D34,D35,D36,D37,D38,D39,D40,D41,D42,D43,D44,D45,D46,D47,D48,D49,D50,D51,D52,D53,D54,D55,D56,D57,D58,D59,D60,D61,D62,D63,D64,D65,D66,D67,D68,D69,D70,D71,D72,D73,D74,D75,D76,D77,D78,D79,D80,D81,D82,D83,D84,D85,D86,D87,D88,D89,D90,D91,D92,D93,D94,D95,D96,D97,D98,D99,D100,D101,D102,D103,D104,D105,D106,D107,D108,D109,D110,D111,D112,D113,D114,D115,D116,D117,D118,D119,D120,D121,D122,D123,D124,D125,D126,D127,D128,D129,D130,D131,D132,D133,D134,D135,D136,D137,D138 | LED_RGB_XL-1615RGBC_1.6x1.5mm | C965840
74HC165PW | U3,U4,U5,U12,U13,U14 | TSSOP-16_4.4x5mm_P0.65mm | C80696
4x10k | RN1,RN2,RN3,RN4,RN5,RN6,RN7,RN8,RN9,RN10,RN11,RN12 | R_Array_Convex_4x0402 | C25725
CY8CMBR3108-LQXIT | U11 | QFN-16-1EP_3x3mm_P0.5mm_EP1.7x1.7mm | C462528
560 | R18,R19,R20,R21,R22,R23,R24,R25 | R_0402_1005Metric | C25126
2.2n | C33 | C_0402_1005Metric | C1531
EC11E smooth, switch | ENC1,ENC2,ENC3,ENC4,ENC5,ENC6,ENC7,ENC8 | RotaryEncoder_Alps_EC11E-Switch_Vertical_H20mm_Ring | C361165
