MitjaGrecky/Shtuka-druka/hardware/for-routing/P4/BOM_notes.csv

Designator | Value | Footprint | LCSC | Status of the LCSC number
J1 | Deck bus to P2 2x8 1.27 | PinHeader_2x08_P1.27mm_Vertical | C5372812 | найден в библиотеке EasyEDA 13.11.2026 (ПК, tools/eda/eda_parts.py): HCTL PZ127-2-08-Z, штыри 2x8 1,27 выводные, Extended; наличие и цена не смотрелись
J3 | Module bus to W3 2x7 1.27 | PinHeader_2x07_P1.27mm_Vertical | C5372811 | найден в библиотеке EasyEDA 13.11.2026 (ПК, tools/eda/eda_parts.py): HCTL PZ127-2-07-Z, штыри 2x7 1,27 выводные, Extended; наличие и цена не смотрелись
C1 | 10u | C_0805_2012Metric | C15850 | найден в библиотеке EasyEDA 13.11.2026 (ПК, tools/eda/eda_parts.py): Samsung CL21A106KAYNNNE 10 мкФ 25 В X5R 0805, Basic; наличие и цена не смотрелись
C2,C3,C5,C7,C9,C18 | 1u | C_0402_1005Metric | C52923 | найден в библиотеке EasyEDA 13.11.2026 (ПК, tools/eda/eda_parts.py): Samsung CL05A105KA5NQNC 1 мкФ 25 В X5R 0402, Basic; наличие и цена не смотрелись
R1,R2 | 10k | R_0402_1005Metric | C25744 | найден в библиотеке EasyEDA 13.11.2026 (ПК, tools/eda/eda_parts.py): UNI-ROYAL 0402WGF1002TCE 10 кОм 1% 0402, Basic; наличие и цена не смотрелись
U6 | TCA9546APWR | TSSOP-16_4.4x5mm_P0.65mm | C201653 | найден в библиотеке EasyEDA 13.11.2026 (ПК, tools/eda/eda_parts.py): TI TCA9546APWR, TSSOP-16, Extended; наличие и цена не смотрелись
C11,C12,C13,C14,C15,C16,C17 | 100n | C_0402_1005Metric | C1525 | найден в библиотеке EasyEDA 13.11.2026 (ПК, tools/eda/eda_parts.py): Samsung CL05B104KO5NNNC 100 нФ 16 В X7R 0402, Basic; наличие и цена не смотрелись
R3,R4,R5 | 0 | R_0402_1005Metric | C17168 | найден в библиотеке EasyEDA 13.11.2026 (ПК, tools/eda/eda_parts.py): UNI-ROYAL 0402WGF0000TCE 0 Ом 0402, Basic; наличие и цена не смотрелись
R6,R7,R8,R9 | 4.7k | R_0402_1005Metric | C25900 | найден в библиотеке EasyEDA 13.11.2026 (ПК, tools/eda/eda_parts.py): UNI-ROYAL 0402WGF4701TCE 4,7 кОм 1% 0402, Basic; наличие и цена не смотрелись
U1,U2 | LP5864RSMR | VQFN-32-1EP_4x4mm_P0.4mm_EP2.8x2.8mm | C5220564 | проверено 12.11.2026: 55 шт., 0,92 $ (LCSC)
C4,C8 | 4.7u | C_0805_2012Metric | C1779 | найден в библиотеке EasyEDA 13.11.2026 (ПК, tools/eda/eda_parts.py): Samsung CL21A475KAQNNNE 4,7 мкФ 25 В X5R 0805, Basic; наличие и цена не смотрелись
C6,C10 | 1n | C_0402_1005Metric | C1523 | найден в библиотеке EasyEDA 13.11.2026 (ПК, tools/eda/eda_parts.py): FH 0402B102K500NT 1 нФ 50 В X7R 0402, Basic; наличие и цена не смотрелись
SW1,SW2,SW3,SW4,SW5,SW6,SW7,SW8,SW9,SW10,SW11,SW12,SW13,SW14,SW15,SW16,SW17,SW18,SW19,SW20 | TS-1187A-B-A-B | SW_Push_1P1T_XKB_TS-1187A | C318884 | проверено 06.11.2026 (док. 31)
D1,D2,D3,D4,D5,D6,D7,D8,D9,D10,D11,D12,D13,D14,D15,D16,D17,D18,D19,D20,D21,D22,D23,D24,D25,D26,D27,D28,D29,D30,D31,D32,D33,D34,D35,D36,D37,D38,D39,D40 | XL-1615RGBC-RF | LED_RGB_XL-1615RGBC_1.6x1.5mm | C965840 | проверено 01.11.2026 (док. 30)
U3,U4,U5 | 74HC165PW | TSSOP-16_4.4x5mm_P0.65mm | C80696 | проверено 06.11.2026 (док. 31)
RN1,RN2,RN3,RN4,RN5,RN6 | 4x10k | R_Array_Convex_4x0402 | C25725 | проверено 06.11.2026 (док. 31)
J4 | Wheel push | JST_PH_B2B-PH-K_1x02_P2.00mm_Vertical | C20504437 | найден в библиотеке EasyEDA 13.11.2026 (ПК, tools/eda/eda_parts.py): JST B2B-PH-K-S, Extended; наличие и цена не смотрелись
RV1 | 10k lin, 45 mm travel | Potentiometer_Bourns_PTA4543_Single_Slide | C17444183 | найден в библиотеке EasyEDA 13.11.2026 (ПК, tools/eda/eda_parts.py): Bourns PTA4543-2015DPB103 (заглушка кроссфейдера, P90), Extended; наличие и цена не смотрелись
R10 | 1k | R_0402_1005Metric | C11702 | найден в библиотеке EasyEDA 13.11.2026 (ПК, tools/eda/eda_parts.py): UNI-ROYAL 0402WGF1001TCE 1 кОм 1% 0402, Basic; наличие и цена не смотрелись
U7 | ADS1115IDGSR | TSSOP-10_3x3mm_P0.5mm | C37593 | проверено 06.11.2026 (док. 31)
U8 | AS5600-ASOM | SOIC-8_3.9x4.9mm_P1.27mm | C79815 | найден в библиотеке EasyEDA 13.11.2026 (ПК, tools/eda/eda_parts.py): ams AS5600-ASOM, SOIC-8, Extended; наличие и цена не смотрелись
