MitjaGrecky/Shtuka-druka/hardware/for-routing/COMPONENTS.md

# Компонентная база

*Только розничные, покупаемые детали (R28), сборка на заводе (R115). Номера LCSC: «проверено» — страница открыта и читалась (источник и дата указаны), «проверить» — номер взят из генератора прошлых сессий, сессия не может открыть произвольные страницы LCSC; проверьте в поиске EasyEDA.*

| Деталь | Модель | Корпус | LCSC | Где | Статус |
|---|---|---|---|---|---|
| Драйвер огней | TI LP5864RSMR (24 RGB, 4 SW × 18 CS, I²C, 4 адреса) | VQFN-32, 4 × 4 мм, шаг 0,4 | C5220564 | M1 и модули | проверено 12.11.2026: 55 шт., 0,92 $ (малый запас: брать с запасом сразу) |
| Огонь | XINGLIGHT XL-1615RGBC-RF | 1,6 × 1,5 мм | C965840 | везде | проверено 01.11.2026 |
| Касание | Infineon CY8CMBR3108-LQXIT | QFN-16 3 × 3 | C462528 | M1, M2 | проверено 01.11.2026 |
| Регистр | 74HC165PW | TSSOP-16 | C80696 | везде | проверено 06.11.2026 |
| Сборка 4 × 10 кОм | (для подтяжек) | 4 × 0402 | C25725 | везде | проверено 06.11.2026 |
| Разъём шины | HCTL PZ127-2-07-Z, штыри 2 × 7, шаг 1,27 | выводной | C5372811 | везде | найден в библиотеке EasyEDA 13.11.2026 (Extended). **C3975190 — SMD-вариант PZ127-2-07-S, к выводному посадочному месту не подходит** (в пакетах M1, W1 ещё стоит он) |
| Разъём шины деки (P100) | HCTL PZ127-2-08-Z, штыри 2 × 8, шаг 1,27 | выводной | C5372812 | P1, P3, P4 | найден в библиотеке EasyEDA 13.11.2026 (Extended) |
| Датчик колеса | ams AS5600-ASOM (12 бит, I²C 0x36) | SOIC-8 | C79815 | P4 | найден в библиотеке EasyEDA 13.11.2026 (Extended) |
| Кроссфейдер (P90, не выбран) | Bourns PTA4543-2015DPB103, ход 45 мм, 10 кОм лин. — заглушка | выводной | C17444183 | P4 | найден в библиотеке EasyEDA 13.11.2026 (Extended); деталь уточнить |
| Разъём кнопки колеса | JST B2B-PH-K-S, 2 вывода, шаг 2 | выводной | C20504437 | P4 (V10) | найден в библиотеке EasyEDA 13.11.2026 (Extended) |
| Мультиплексор I²C (P99) | TI TCA9546APWR | TSSOP-16 | C201653 | P1, P3, P4 | найден в библиотеке EasyEDA 13.11.2026 (Extended); аналог UMW C42420613 |
| Энкодер | Alps EC11E1834403 или другой гладкий EC11 с кнопкой и металлическим валом | выводной | C361165 | M1–M5, панель | в библиотеке EasyEDA 13.11.2026 есть: EC11E1834403, 0 щелчков / 18 импульсов, с кнопкой (Extended); прежде: выбрать у розницы (Mouser: 30 шт., поставка 1 200 шт. 23.12.2026, по данным 01.11.2026) |
| Потенциометр | Alps RK09K 10 кОм, линейный | выводной | C209770 | W1 | проверено 06.11.2026 (в каталоге: суффикс характеристики не расшифрован) |
| АЦП | TI ADS1115IDGSR | TSSOP-10 | C37593 | W1 | проверено 06.11.2026 |
| Драйвер огней P48 | IS31FL3218-QFLS2-TR | QFN-24 | C2940546 | W1 | проверено 06.11.2026 |
| Кнопка | TS-1187A-B-A-B | SMD | C318884 | W1 | проверено 06.11.2026 |

Пассивные (0402/0805 резисторы и конденсаторы): по BOM каждой платы; где в BOM пусто, номера нет, надо выбрать в EasyEDA (`BOM_notes.csv` показывает такие строки).

Найдены в библиотеке EasyEDA 13.11.2026 (ПК, `tools/eda/eda_parts.py`; наличие и цену библиотека не показывает): 4,7 мкФ 25 В X5R 0805 C1779 (Basic),
1 нФ 50 В X7R 0402 C1523 (Basic), 0 Ом 0402 C17168 (Basic), 560 Ом 1 % 0402 C25126 (Extended), 2,2 нФ 50 В X7R 0402 C1531 (Extended, CMOD касания M2); подтверждены: 100 нФ C1525, 1 мкФ C52923, 10 мкФ C15850,
10 кОм C25744, 4,7 кОм C25900, 1 кОм C11702 (все Basic). Генераторы новых плат берут их из `hardware/common/gen/kit.py`.
