MitjaGrecky/Shtuka-druka/docs/ru/32_fit_real_parts.md

# Штука Дрюка: проверка корпуса на реальных деталях

*06.11.2026. Продолжение раздела 9 документа 30. Модель — `model3d/fit/fit_model.py`, сцена Blender — `build_blend.py`. **Факт** — из источника, **вывод** — моя логика, **решено** — решение пользователя. Предложения P90–P96 ждут твоего «да» или «нет».*

> **Обновлено 06.11.2026:** экран — по 3D-модели Waveshare, которую ты прислал (раздел 3); твои ответы: флешки бывают и длинные, карта — полноразмерная SD, «делай как удобнее» → USB-A по варианту C, SD — полноразмерный слот (раздел 4).

## 0. Коротко

- В первой проверке были одно столкновение (USB-A в кармане System, 9 мм) и три места впритык (кроссфейдер, колесо, стекло экрана у полки). Три из них держались на прикидках.
- Теперь кроссфейдер и колесо посчитаны по даташитам, экран — по 3D-модели производителя, USB-A — по четырём вариантам, SD — полноразмерный слот. **Результат: 372 детали, 0 столкновений, 0 зазоров меньше 1 мм** — при изменениях P91–P96 (датчик колеса снизу P4, экран на 1 мм ниже, USB-A на плате кармана, разъёмы экрана к сгибу и угловые вилки, SD справа в кармане).
- 3D-модели деталей из облака я скачать не могу (сайты производителей и LCSC закрыты для моего окружения). Модель экрана прислал ты; остальные детали построены коробками по даташитам. Что осталось прикидкой — в разделе 6.

## 1. Кроссфейдер

**Факт.** Bourns PTA4543 — ползунковый потенциометр с ходом 45 мм: длина корпуса 60 мм (размер A в таблице PTA), на чертеже ширина 9,0 и высота 6,5 мм, сверху две резьбы M2 для крепления к панели; рычаг 15 мм (коды DP и CP) ([Bourns PTA, даташит](https://www.meditronik.com.pl/doc/bourns/ptaser.pdf); [PTA, чертёж](https://pdf.icgoo.net/productinfo/allpdf/6efcfe55-21e1-3312-910a-2efa0bfd5247.pdf)). У LCSC есть вариант с рычагом DP: PTA4543-2015DPA103, C17328789, ≈ 3,17 $ ([LCSC](https://lcsc.com/product-detail/Potentiometers-Variable-Resistors_BOURNS-PTA4543-2015DPA103_C17328789.html)); на складе было 18 шт.

**Вывод.**
- Размер в модели (60 × 9 × 6,5) совпал с прикидкой. «Зазор 0» с обшивкой — не ошибка: корпус фейдера и должен прижиматься к обшивке снизу двумя винтами M2. Это крепление «к панели», а не к плате; плата P4 только держит выводы.
- Щель в обшивке 52 мм (`layout_v7.json`) = ход 45 + ширина рычага около 4 + запас. Сходится.
- В документе 09 стоит «бесконтактный или долговечный ползунок». PTA — обычный резистивный, на нём быстрее появится износ. Бесконтактные DJ-фейдеры (Innofader и подобные) — отдельные модули под свой корпус микшера, под наши 6,5 мм между платой и обшивкой они не рассчитаны. Поэтому для первого прототипа предлагаю PTA, а бесконтактный вариант — позже, своей платой той же высоты (P90).

## 2. Колесо навигации (R74: магнитный датчик AS5600)

**Факт (даташит AS5600):** магнит ⌀ 6 мм с диаметральной намагниченностью на оси; типичный зазор 0,5–3 мм в зависимости от магнита; поле по оси 30–90 мТл; корпус SOIC-8 высотой до 1,75 мм ([AS5600, даташит](https://www.digikey.hk/htmldatasheets/production/1647438/0/0/1/as5600-datasheet.html)). **Факт:** подшипник 6700ZZ — 10 × 15 × 4 мм ([VXB](https://vxb.com/products/10x15-bearing-6700zz-10x15x4-shielded)).

**Расчёт.** Между верхом P4 и низом обшивки 6,5 мм (z 58,5–65). Если датчик стоит сверху платы, то датчик (1,75) + зазор (≥ 0,5) + магнит (2,5) + подшипник (4) = 8,75 мм — не помещается, подшипник вылезает в обшивку на 2,25 мм.

**Вывод — схема, которая помещается (P91):**

| Деталь | Где, z, мм |
|---|---|
| AS5600 | на **нижней** стороне P4, под магнитом (55,2–56,9) |
| Магнит 6 × 2,5, диаметральный | на конце вала, 0,5 мм над P4 (59,0–61,5) |
| Подшипник 6700ZZ | в печатном стакане ⌀ 21, привинченном к обшивке снизу; на 0,5 мм заходит в зенковку обшивки (61,5–65,5) |
| Колесо ⌀ 38 | над обшивкой, вал ⌀ 10 через отверстие |

Расстояние магнит → кристалл ≈ 0,5 + 1,6 (плата) + ≈ 0,4 (корпус) ≈ 2,5 мм — внутри диапазона 0,5–3 мм, но ближе к верхнему краю. На первом образце проверить по флагам MD/ML/MH датчика, что поле в норме; если слабое — магнит толще (⌀ 6 × 3) или вырез в P4 под датчиком.

## 3. Экран: настоящая 3D-модель

**Факт (3D-модель STP и чертёж Waveshare, прислал пользователь):**
- стекло 239 × 147 мм, за ним матрица 228,6 × 143 мм; от лица стекла до тыла матрицы — **7,4 мм**;
- плата управления 108 × 72 мм стоит на тыле матрицы на стойках 4 мм; самые высокие детали (HDMI) — **8,9 мм** от лица стекла, общая толщина модуля 13,7 мм;
- плата сдвинута от центра: по длинной стороне 56 и 64,6 мм до краёв матрицы, по короткой 40,5 и 30,5 мм (чертёж);
- HDMI и USB-C (питание и тач) выходят на один длинный край платы и смотрят наружу, к длинному краю экрана; гнездо 3,5 мм — в вырезе платы; к матрице идёт гибкий шлейф;
- **ось гнезда HDMI — в 2,1 мм от тыла матрицы** (z −4,7 против −2,6 в координатах модели).

STEP-файл в репозиторий не кладу (лицензия Waveshare неясна). В `fit_model.py` — только габариты, снятые с него скриптом на OpenCascade: стекло, матрица, плата, шлейф.

**Вывод.**
- **Прямая HDMI-вилка не встанет.** Литая часть обычной вилки толщиной 8–11 мм упрётся в тыл матрицы: от оси гнезда до тыла всего 2,1 мм. Нужен угловой переходник HDMI 90°, который уводит кабель от экрана, или тонкий шлейфовый HDMI-кабель. То же для USB-C — угловая вилка.
- **Куда смотрят разъёмы (P95).** Экран ставим так, чтобы край платы с HDMI и USB-C смотрел вниз по наклону, к сгибу. Тогда кабели сразу уходят вниз, в пустой объём под наклоном, и дальше к Mini-ITX: его задние разъёмы стоят на y 215, ниже и ближе. Если развернуть экран наоборот, кабели пойдут к задним платам R1/R2, а до них от экрана и так всего 7–9 мм. Поворот изображения на 180° — настройка системы.
- **Зазоры (скрипт).** Стекло — полка 1,04 мм (со сдвигом P92); матрица — полка 3,6 мм, матрица — верхняя обшивка 4,7 мм; матрица — W1 7,2 мм, — W2 17,2 мм; плата экрана — задняя плата R2 7,2 мм. Угловые вилки и место под изгиб кабеля (радиус ≈ 25 мм) — 30 мм до платы M1, 63 мм до аудиоплаты A1; под ними пусто до дна.

**Сдвиг экрана (P92) остаётся в силе:** без него стекло у полки 0,37 мм; со сдвигом на 1,0 мм вниз по наклону — 1,04 мм. Обшивка по-прежнему заходит на стекло: 2 мм сверху и 4 мм снизу вместо 3 и 3.

## 4. USB-A в кармане System (R81)

**Как считаю.** Карман — проём в обшивке 92 × 24 мм (вид сверху) до платы W3. От внешней поверхности наклона до верха W3 — 9,5 мм. Гнездо не должно торчать над поверхностью: иначе его снесут вместе с флешкой — ровно то, от чего уходили в R81.

**Факты о деталях:**
- Kycon KUSBVLPX — вертикальное USB-A высотой 10 мм ([EDN](https://edn.com/usb-receptacle-addresses-pcb-space-concerns); [chipdip, KUSBVLPX-AS1N-B](https://static.chipdip.ru/lib/690/DOC011690108.pdf)).
- LCSC: SHOU HAN «AF 180° ZJB13.7», C456015, ≈ 0,03 $, 52 тыс. шт. на складе ([LCSC](https://www.lcsc.com/product-detail/C456015.html)), и «10.0 180° ZCJB-HJ», C2681562, 24 тыс. шт. ([LCSC](https://www.lcsc.com/product-detail/C2681562.html)). **Вывод:** у этих деталей 180° — вертикальная установка, а число — высота; поле «высота» у LCSC пустое, поэтому высоту сверить по даташиту при заказе.

| Вариант | Деталь | Верх гнезда против поверхности | Столкновения | Что значит |
|---|---|---|---|---|
| A | Обычное вертикальное 13,7 мм прямо на W3 | **+4,2 мм** (торчит) | нет | Флешку легко задеть и сломать гнездо |
| B | Низкое вертикальное 10 мм на W3 | +0,5 мм (вровень) | нет | Почти вровень, но защиты нет; у LCSC такая деталь одна |
| **C** | Обычное 13,7 мм на маленькой плате кармана, через вырез в W3 | **−1,5 мм** (внутри) | нет | Гнездо утоплено; под платой кармана 3 мм на выводы и разъём кабеля |
| D | Горизонтальное ≈ 7 мм на W3, флешка лежит в кармане | −2,5 мм (внутри) | нет | Короткая флешка целиком в кармане; длинная вылезет за карман (92 мм вместе с SD) |

**Вывод (P93):** вариант **C** — флешки бывают и длинные, поэтому D (флешка лежит в кармане) отпадает. Плата кармана 30 × 20 мм висит под W3 на двух стойках и кабелем идёт к внутреннему разъёму USB на Mini-ITX (как и задумано в R80). В W3 — вырез 17 × 9 мм под гнездо. Деталь самая ходовая и дешёвая, а глубину утопления задают стойки, а не высота гнезда. Длинная флешка будет торчать над карманом, гнездо — нет. Гнездо стоит у левого края кармана (x ≈ 428), чтобы справа осталось место для SD.

**SD — полноразмерная (P96).** Слот push-push класса Hirose DM1AA / Kyocera 5638 — около 29 × 29 × 3 мм (прикидка до выбора детали). Он лежит на W3 у правого края кармана (x 474–503), устьем влево. Карта 24 × 32 мм входит вдоль кармана: проём кармана по наклону 27,7 мм, карта 24 мм проходит, а сам слот шире и прячется под обшивку с обеих сторон (до обшивки 3,5 мм). Между гнездом USB-A и устьем слота — 36 мм свободного кармана: карту длиной 32 мм можно вставить, держа её ровно. Вставленная карта выступает из слота на ≈ 2,5 мм — чтобы нажать и вынуть. Столкновений нет.

## 5. Таблица итогов

| Что | Результат | Что делать |
|---|---|---|
| Кроссфейдер Bourns PTA4543 | Помещается, прижат к обшивке винтами M2 — так и задумано | P90 |
| Колесо на AS5600 | Помещается, только если датчик снизу P4 | P91; проверить поле на образце |
| Стекло экрана у полки | 0,37 → 1,04 мм при сдвиге экрана на 1 мм вниз | P92 |
| Экран по 3D-модели: матрица, плата 108 × 72, кабели | Всё помещается; прямая HDMI-вилка упирается в тыл матрицы | P95: разъёмы к сгибу, угловые вилки HDMI и USB-C |
| USB-A в кармане | Вариант C: гнездо на 1,5 мм ниже поверхности, столкновений нет | P93 |
| SD полноразмерная | Слот справа в кармане, 36 мм свободно для карты, столкновений нет | P96 |
| Наушники Neutrik NMJ6HCD2 | **Факт:** ширина 18,2 мм, высота корпуса 15,67 мм ([LCSC](https://www.lcsc.com/product-detail/C368502.html)) — меньше прикидки 20 × 16 | Это гнездо для горизонтальной платы; в модели F1 вертикальная — решить ориентацию F1 (P94) |
| Потенциометры уровней | **Факт:** у Alps RK09K ширина 9,8 мм ([Alps RK09K](https://www.electronshik.ru/pdf/r/RK09K_RK09D.pdf)); высоту вертикального варианта в тексте даташита не нашёл | Сверить на образце или по 3D-модели |

**Итог прогона:** 372 детали, 0 столкновений, 0 мест тоньше 1 мм. Картинки — `fit_iso.png`, `fit_iso_open.png`, `fit_side_section.png` (собираются `build_blend.py OUT --render`).

## 6. Что осталось прикидкой

| Деталь | Почему | Как закрыть |
|---|---|---|
| Угловые вилки HDMI и USB-C, изгиб кабеля | Деталь ещё не выбрана; в модели место 22 × 20 мм и изгиб радиусом ≈ 25 мм | Выбрать переходники и сверить по их чертежам |
| Слот SD | Деталь не выбрана, в модели 29 × 29 × 3 | Выбрать слот у LCSC и сверить |
| Высота Mini-ITX N100DC-ITX (радиатор, задние разъёмы) | В описаниях магазинов высоты нет | Руководство ASRock или замер; в модели 34,4 мм над платой |
| Гнёзда наушников по глубине, задние гнёзда | Зависит от выбора деталей платы F1 и R1/R2 | При проектировании этих плат |
| Выводы энкодеров M1 и штекер шлейфа J1 снизу | Длина выводов EC11E и высота штекера 2 × 7 | По даташиту Alps и выбранному штекеру; запас под M1 большой (до 49 мм) |
| Огибающие «parts below» под платами панели и наклона | Детали ещё не расставлены | Заменятся платами, когда они будут разведены |

## 7. Предложения и вопросы

| № | Предложение |
|---|---|
| P90 | Кроссфейдер первого прототипа — Bourns PTA4543 (ход 45 мм, высота 6,5 мм), крепится к обшивке двумя винтами M2. Бесконтактный фейдер — позже, своей платой той же высоты |
| P91 | Колесо: AS5600 на нижней стороне P4, магнит 6 × 2,5 мм на конце вала в 0,5 мм над платой, подшипник 6700ZZ в печатном стакане под обшивкой |
| P92 | Экран и его окно в обшивке — на 1,0 мм ниже по наклону (до полки 1,04 мм вместо 0,37) |
| P93 | USB-A в кармане System — обычное вертикальное гнездо (LCSC C456015) на маленькой плате под вырезом в W3, у левого края кармана, утоплено на 1,5 мм ниже поверхности |
| P94 | Плата наушников F1 — горизонтальная, гнёзда Neutrik NMJ6HCD2 (18,2 × 15,67 мм, есть у LCSC) |
| P95 | Экран ставим разъёмами платы вниз по наклону, к сгибу (изображение повёрнуто программно); HDMI и USB-C — через угловые вилки 90°, уводящие кабель от экрана; кабели идут вниз к Mini-ITX |
| P96 | Полноразмерный слот SD push-push лежит на W3 у правого края кармана, устьем влево; карта входит вдоль кармана |

## Открытые вопросы

1. ~~SD или microSD~~ — полноразмерная SD (ответ 06.11.2026), P96.
2. ~~Только короткие флешки?~~ — бывают и длинные → вариант C (P93).
3. ~~3D-модель экрана~~ — получена, раздел 3.
4. Угловой переходник HDMI: взять готовый 90° «вниз/вверх» или тонкий шлейфовый кабель HDMI? Выберу деталь и сверю по чертежу, если ты не против готового переходника.

Sources: Waveshare 10.1DP-CAPLCD — 3D-модель STP и чертёж (присланы пользователем, со страницы wiki); [Bourns PTA, даташит](https://www.meditronik.com.pl/doc/bourns/ptaser.pdf); [Bourns PTA, чертёж](https://pdf.icgoo.net/productinfo/allpdf/6efcfe55-21e1-3312-910a-2efa0bfd5247.pdf); [LCSC PTA4543-2015DPA103](https://lcsc.com/product-detail/Potentiometers-Variable-Resistors_BOURNS-PTA4543-2015DPA103_C17328789.html); [AS5600, даташит](https://www.digikey.hk/htmldatasheets/production/1647438/0/0/1/as5600-datasheet.html); [6700ZZ, VXB](https://vxb.com/products/10x15-bearing-6700zz-10x15x4-shielded); [Waveshare 10.1DP-CAPLCD](https://www.waveshare.com/wiki/10.1DP-CAPLCD); [EDN, Kycon KUSBVLPX](https://edn.com/usb-receptacle-addresses-pcb-space-concerns); [Kycon KUSBVLPX-AS1N-B](https://static.chipdip.ru/lib/690/DOC011690108.pdf); [LCSC C456015](https://www.lcsc.com/product-detail/C456015.html); [LCSC C2681562](https://www.lcsc.com/product-detail/C2681562.html); [LCSC Neutrik NMJ6HCD2](https://www.lcsc.com/product-detail/C368502.html); [Alps RK09K](https://www.electronshik.ru/pdf/r/RK09K_RK09D.pdf)
