MitjaGrecky/Shtuka-druka/hardware/for-routing/M3/outline.dxf

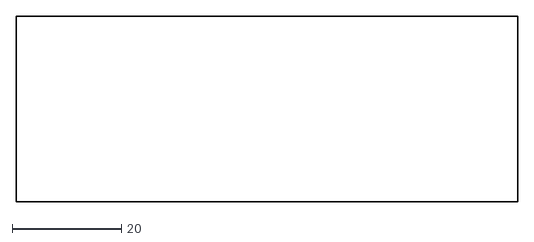
[picture p45: CAD file, 2026-11-13]
hardware/for-routing/M3/outline.dxf
92.0 x 34.0
