MitjaGrecky/Shtuka-druka/hardware/for-routing/M4/outline.dxf

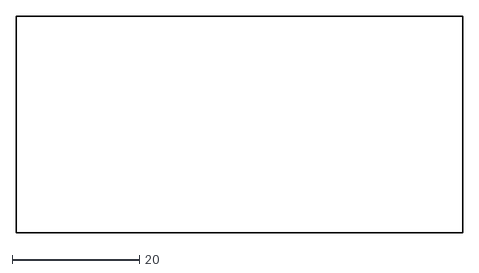
[picture p46: CAD file, 2026-11-13]
hardware/for-routing/M4/outline.dxf
70.0 x 34.0
