MitjaGrecky/Shtuka-druka/hardware/for-routing/M5/outline.dxf

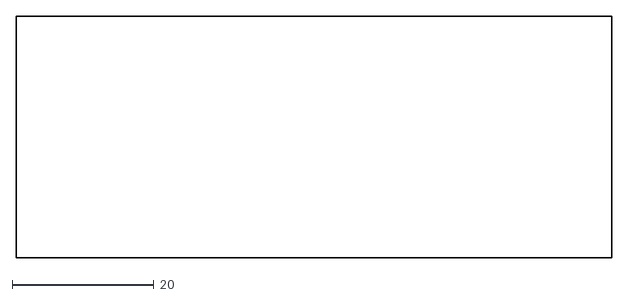
[picture p47: CAD file, 2026-11-13]
hardware/for-routing/M5/outline.dxf
84.0 x 34.0
