MitjaGrecky/Shtuka-druka/hardware/for-routing/P1/outline.dxf

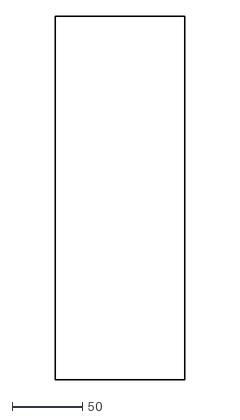
[picture p48: CAD file, 2026-11-13]
hardware/for-routing/P1/outline.dxf
92.0 x 258.0
