MitjaGrecky/Shtuka-druka/hardware/for-routing/P3/outline.dxf

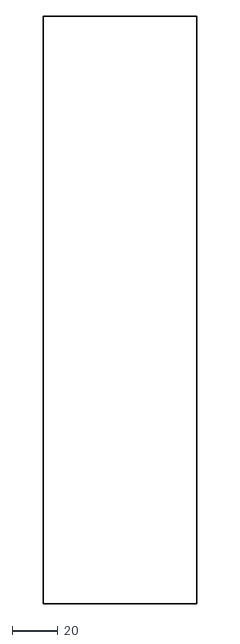
[picture p49: CAD file, 2026-11-13]
hardware/for-routing/P3/outline.dxf
67.5 x 258.0
