MitjaGrecky/Shtuka-druka/hardware/for-routing/P4/outline.dxf

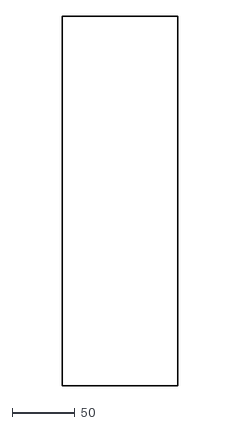
[picture p50: CAD file, 2026-11-13]
hardware/for-routing/P4/outline.dxf
92.0 x 293.0
