MitjaGrecky/Shtuka-druka/hardware/for-routing/W1/outline.dxf

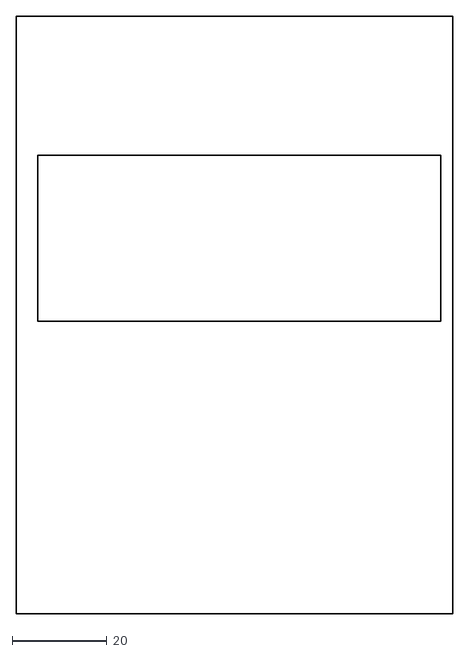
[picture p51: CAD file, 2026-11-13]
hardware/for-routing/W1/outline.dxf
92.0 x 126.0
