MitjaGrecky/Shtuka-druka/hardware/for-routing/W2/outline.dxf

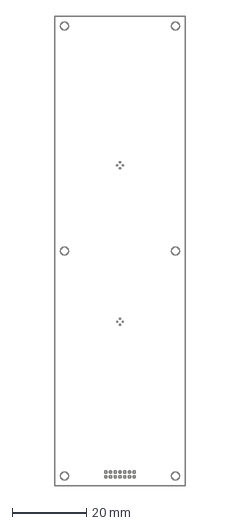
[picture p52: CAD file, 2026-11-13]
hardware/for-routing/W2/outline.dxf
35.0 x 126.0 mm
