MitjaGrecky/Shtuka-druka/hardware/for-routing/W3/outline.dxf

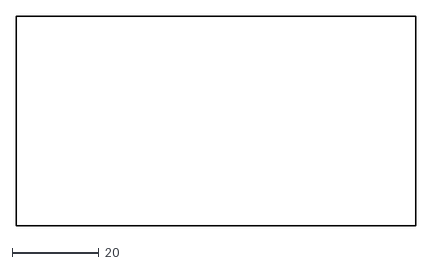
[picture p53: CAD file, 2026-11-13]
hardware/for-routing/W3/outline.dxf
92.0 x 48.2
