MitjaGrecky/Shtuka-druka/hardware/m1-screen-knobs/mech/m1_light_guide.stl

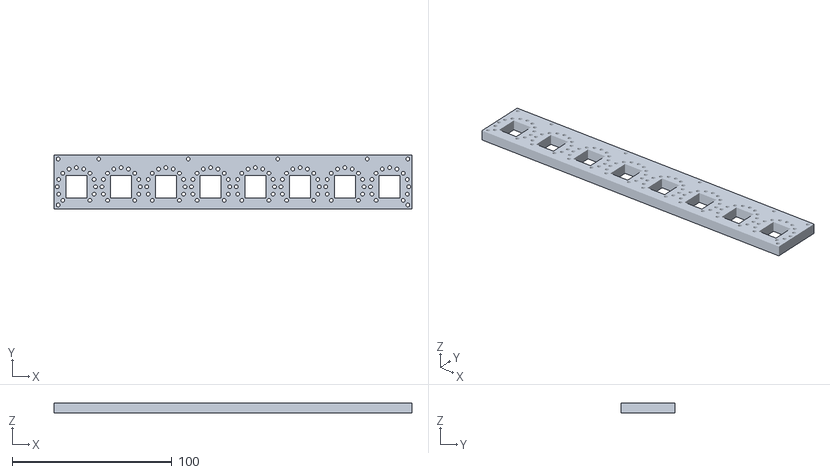
[picture p54: CAD file, 2026-11-06]
hardware/m1-screen-knobs/mech/m1_light_guide.stl
224.0 x 34.0 x 6.40
