MitjaGrecky/Shtuka-druka/hardware/for-routing/M1/outline.dxf

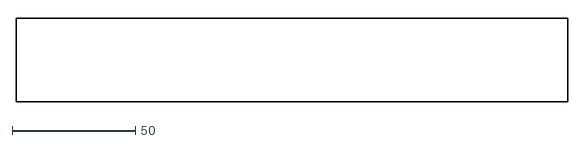
[picture p55: CAD file, 2026-11-12, an earlier design]
hardware/for-routing/M1/outline.dxf
224.0 x 34.0
