MitjaGrecky/Shtuka-druka/hardware/m1-screen-knobs/mech/m1_light_guide.png

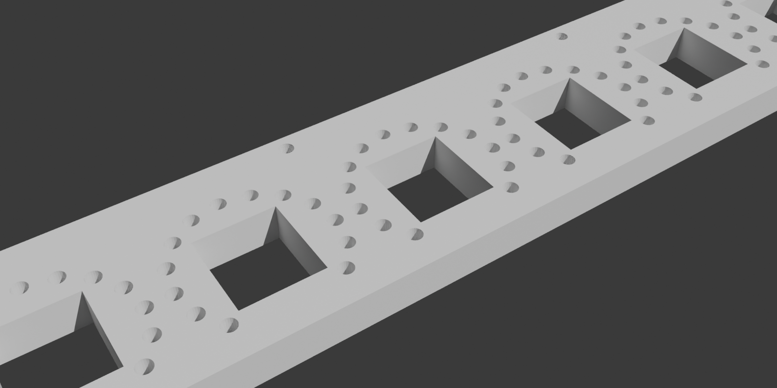
hardware/m1-screen-knobs/mech/m1_light_guide.png
