MitjaGrecky/Shtuka-druka/hardware/m1-screen-knobs/mech/ring1_arcs_test.png

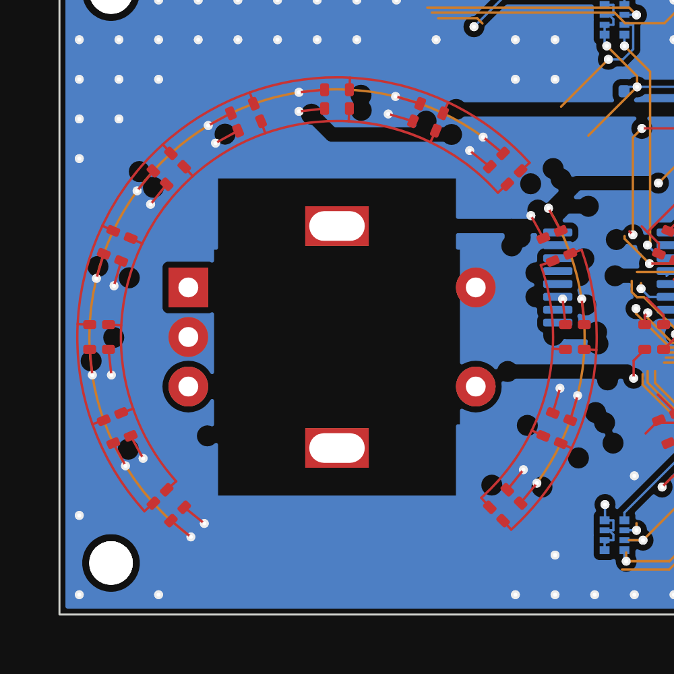
hardware/m1-screen-knobs/mech/ring1_arcs_test.png
