MitjaGrecky/Shtuka-druka/hardware/m1-screen-knobs/quilter/results/I2_rev031_cand1_1/fixed.png

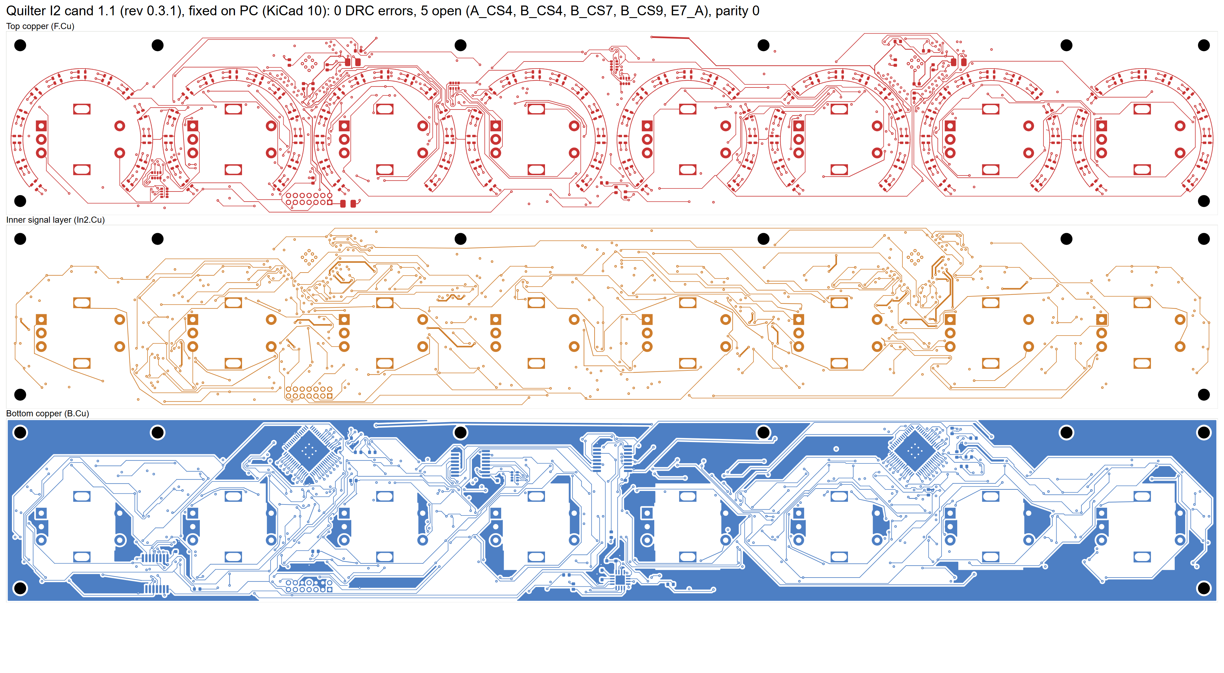
hardware/m1-screen-knobs/quilter/results/I2_rev031_cand1_1/fixed.png
