MitjaGrecky/Shtuka-druka/hardware/for-routing/M5/schematic.pdf

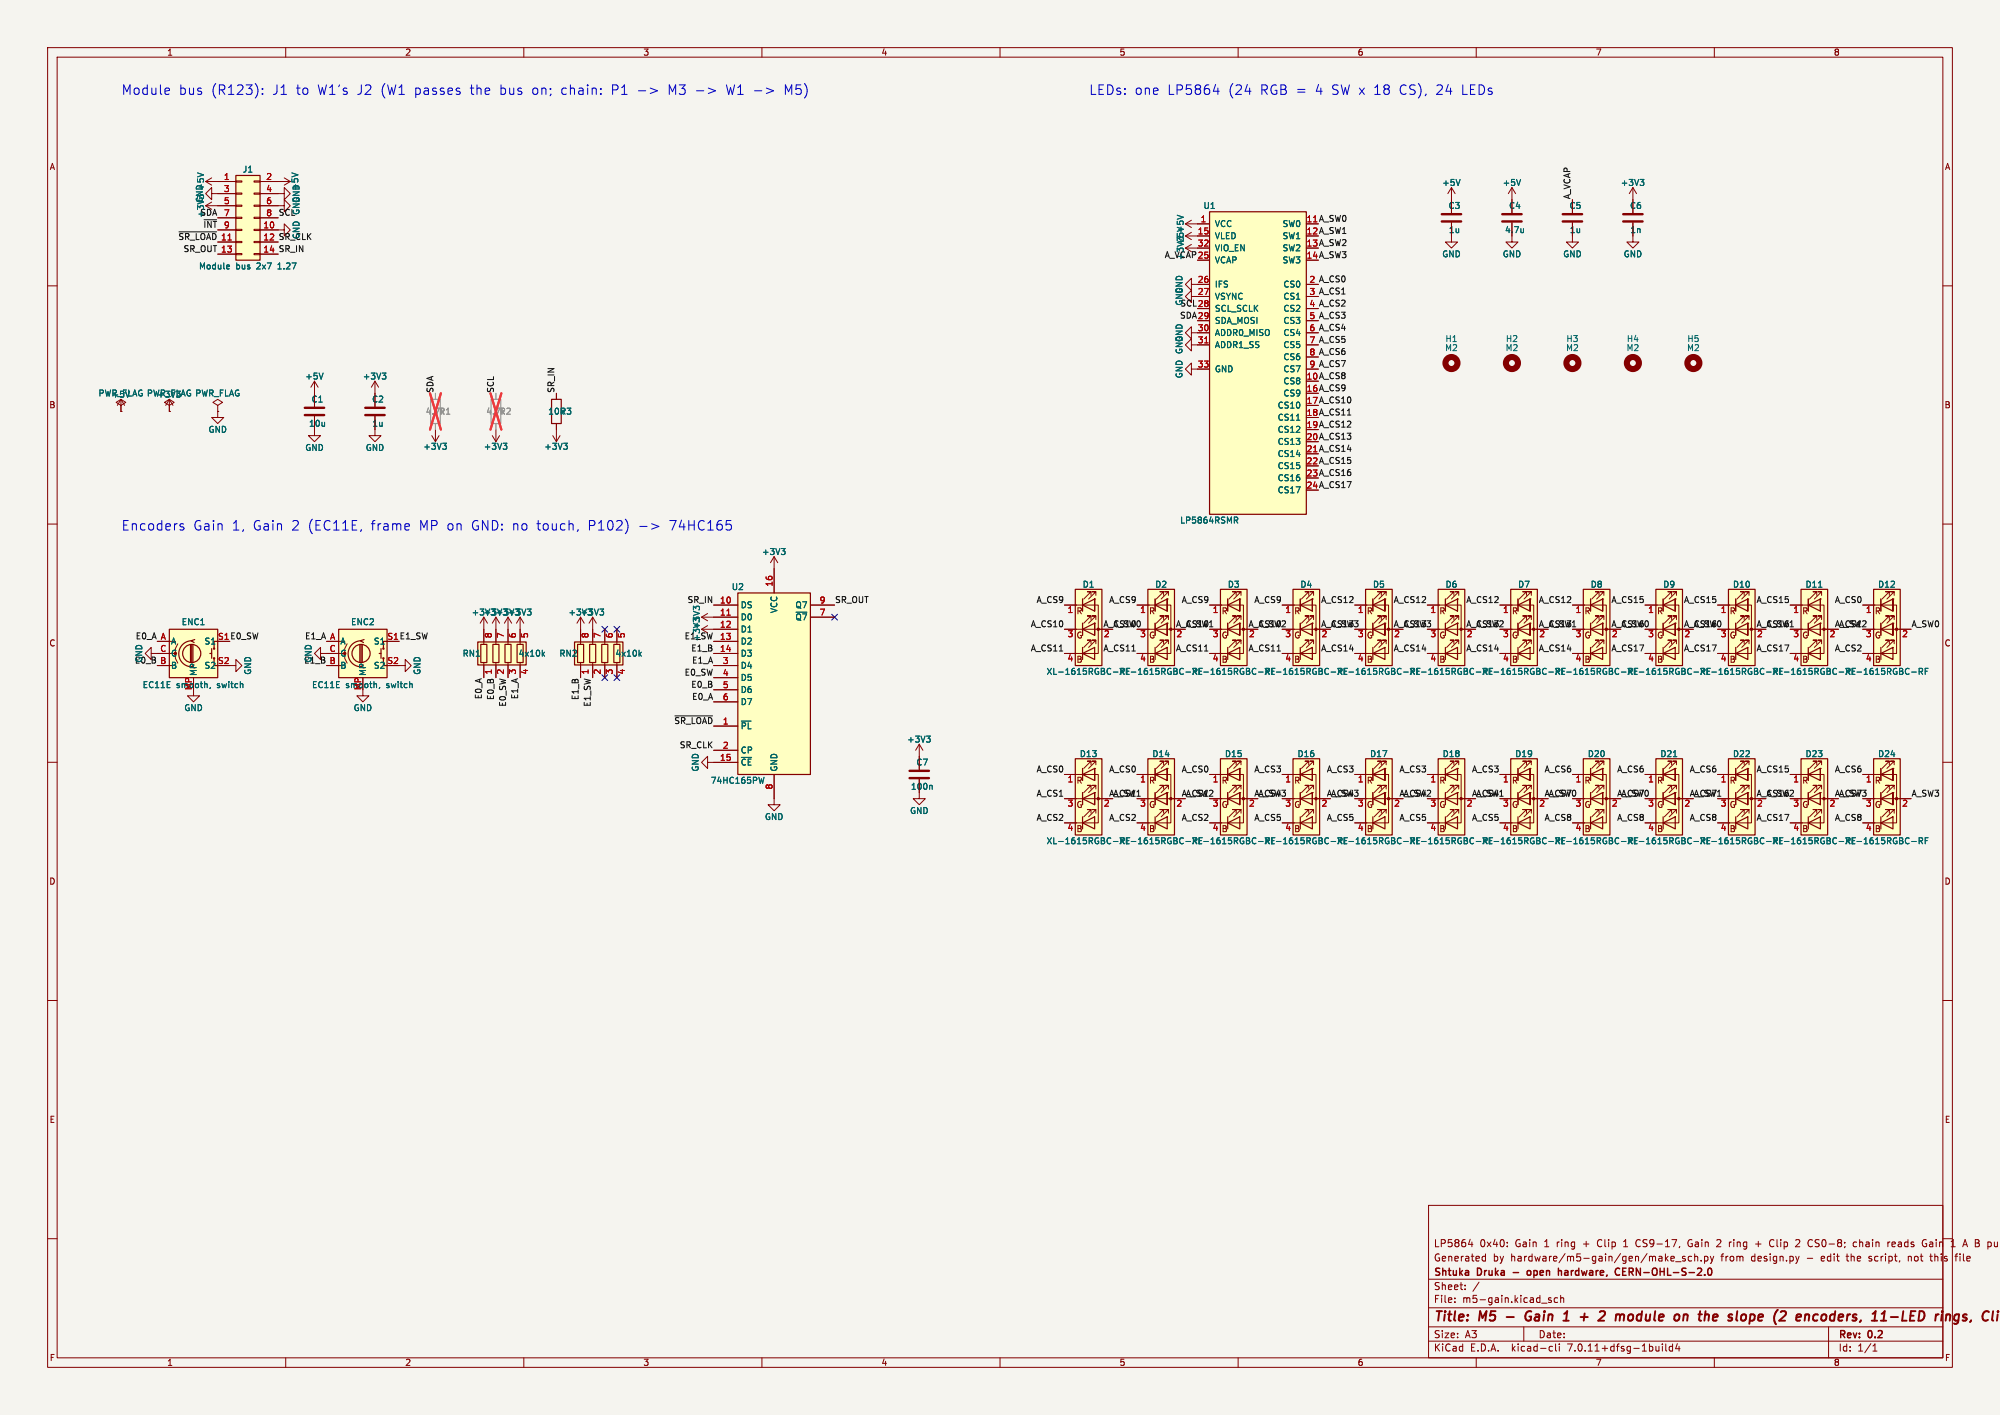
[picture p59: page 1]

LEDs: one LP5864 (24 RGB = 4 SW x 18 CS), 24 LEDs
