MitjaGrecky/Shtuka-druka/hardware/for-routing/P3/schematic.pdf

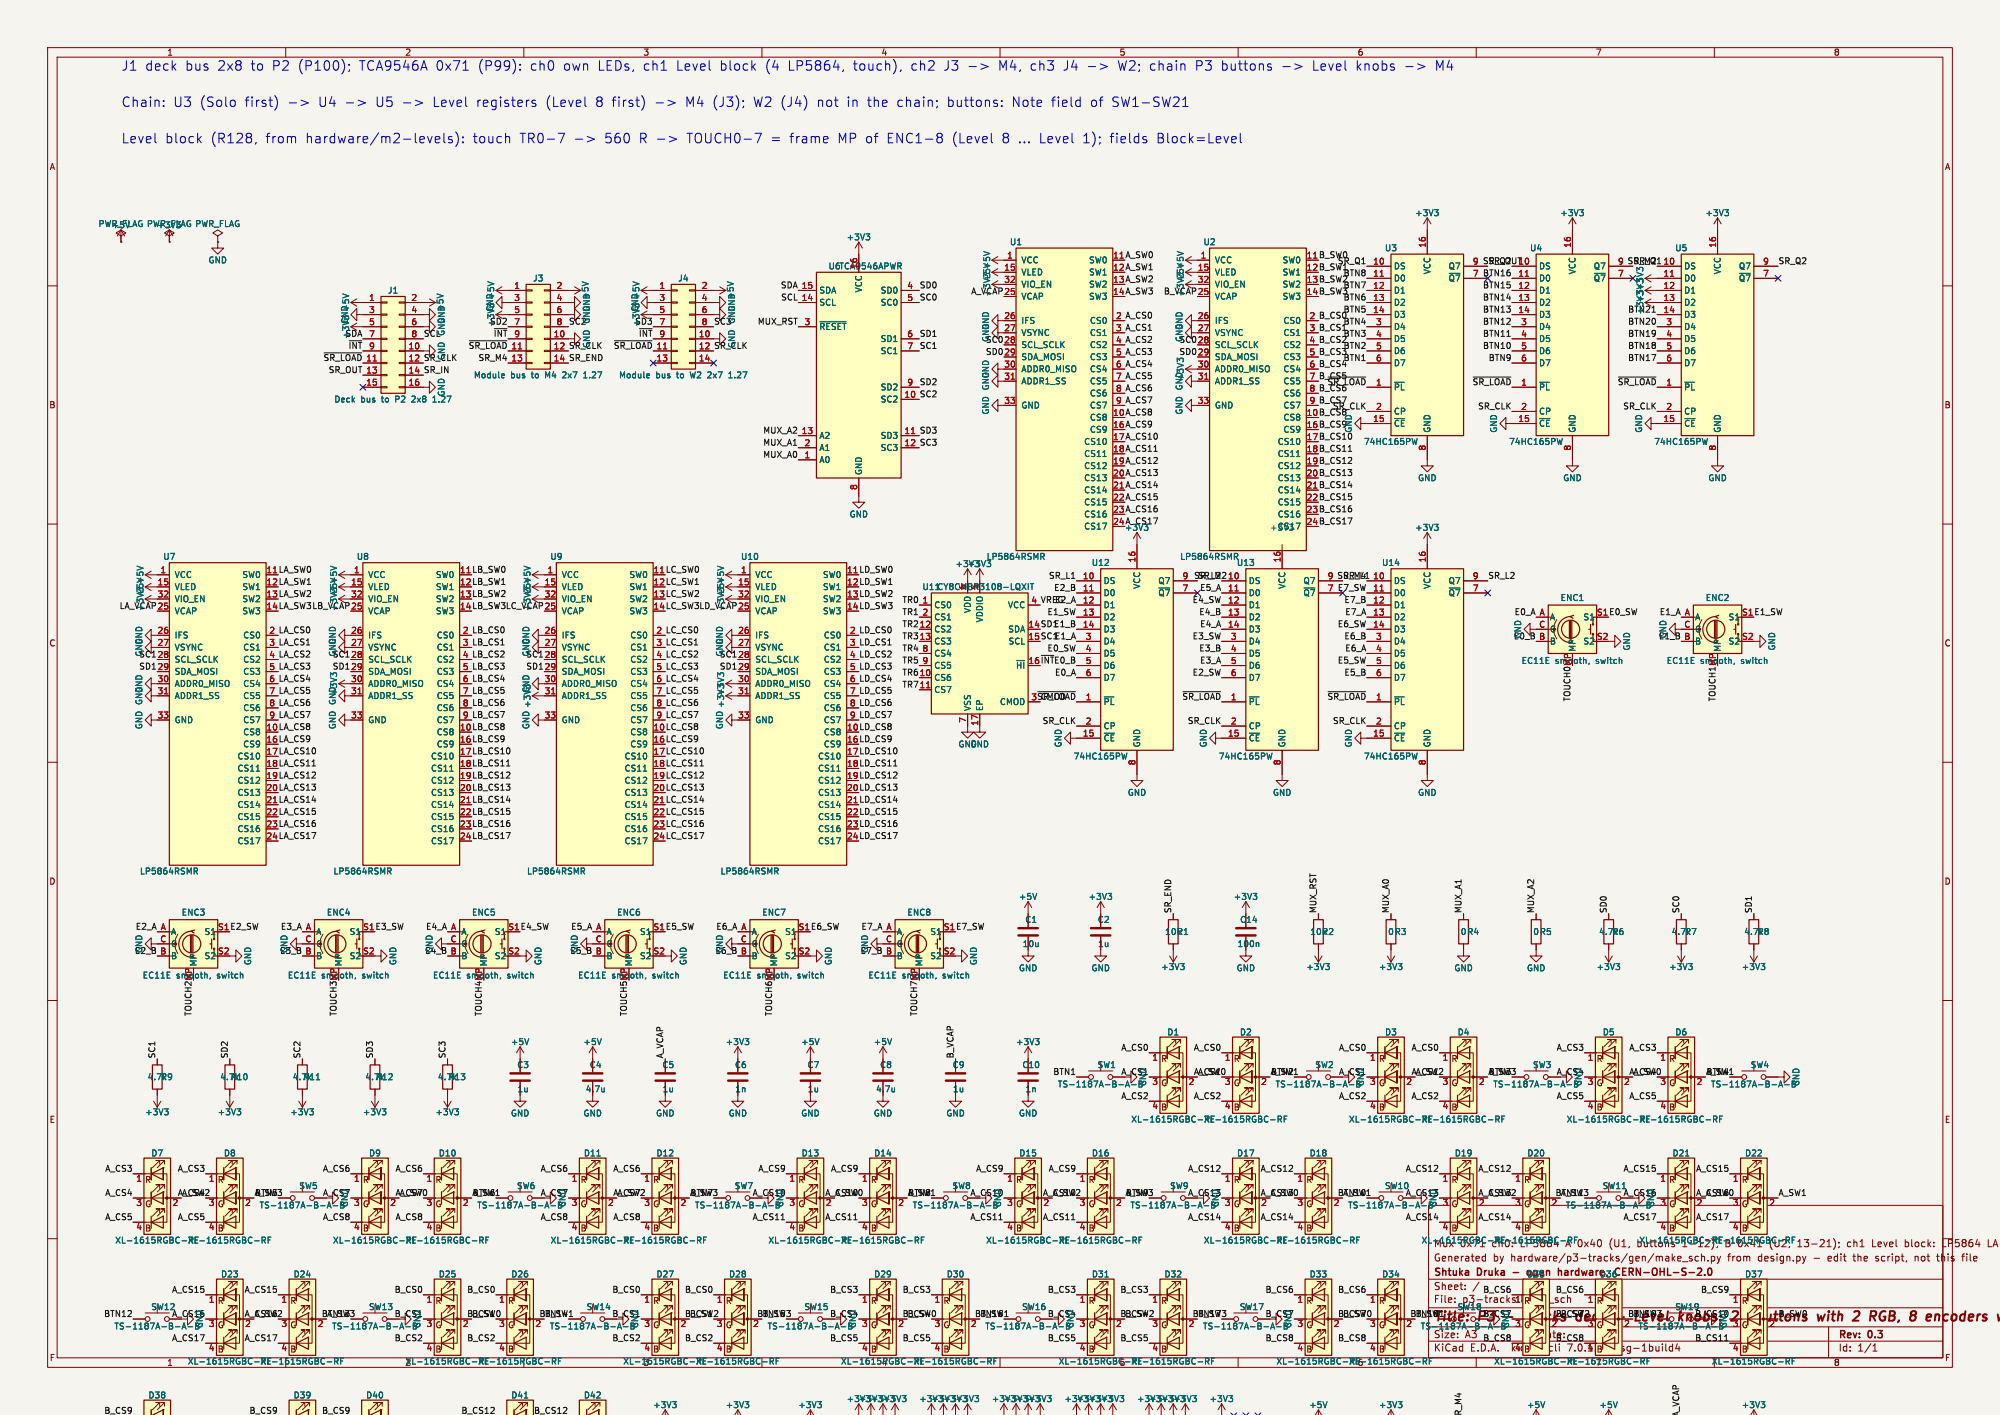
[picture p60: page 1]

4 D53 XL-1615RGBC-RF GND GND

J3 Module bus to M4 2x7 1.27 GND
4 D65 XL-1615RGBC-RF GND+5V
LP5864RSMR +3V3
LB_SW2 ~{INT}

8 SD2 9 GND +5V GND +3V3 GND GND GND +3V3

4 D22 XL-1615RGBC-RF SW19 TS-1187A-B-A-B GND

7 CS4 8 CS5 9 GND GND GND GND

ENC6 EC11E smooth, switch A
4 D3 XL-1615RGBC-RF GND GND

4 D5 XL-1615RGBC-RF GNDSW14 TS-1187A-B-A-B GND
