MitjaGrecky/Shtuka-druka/hardware/for-routing/P4/schematic.pdf

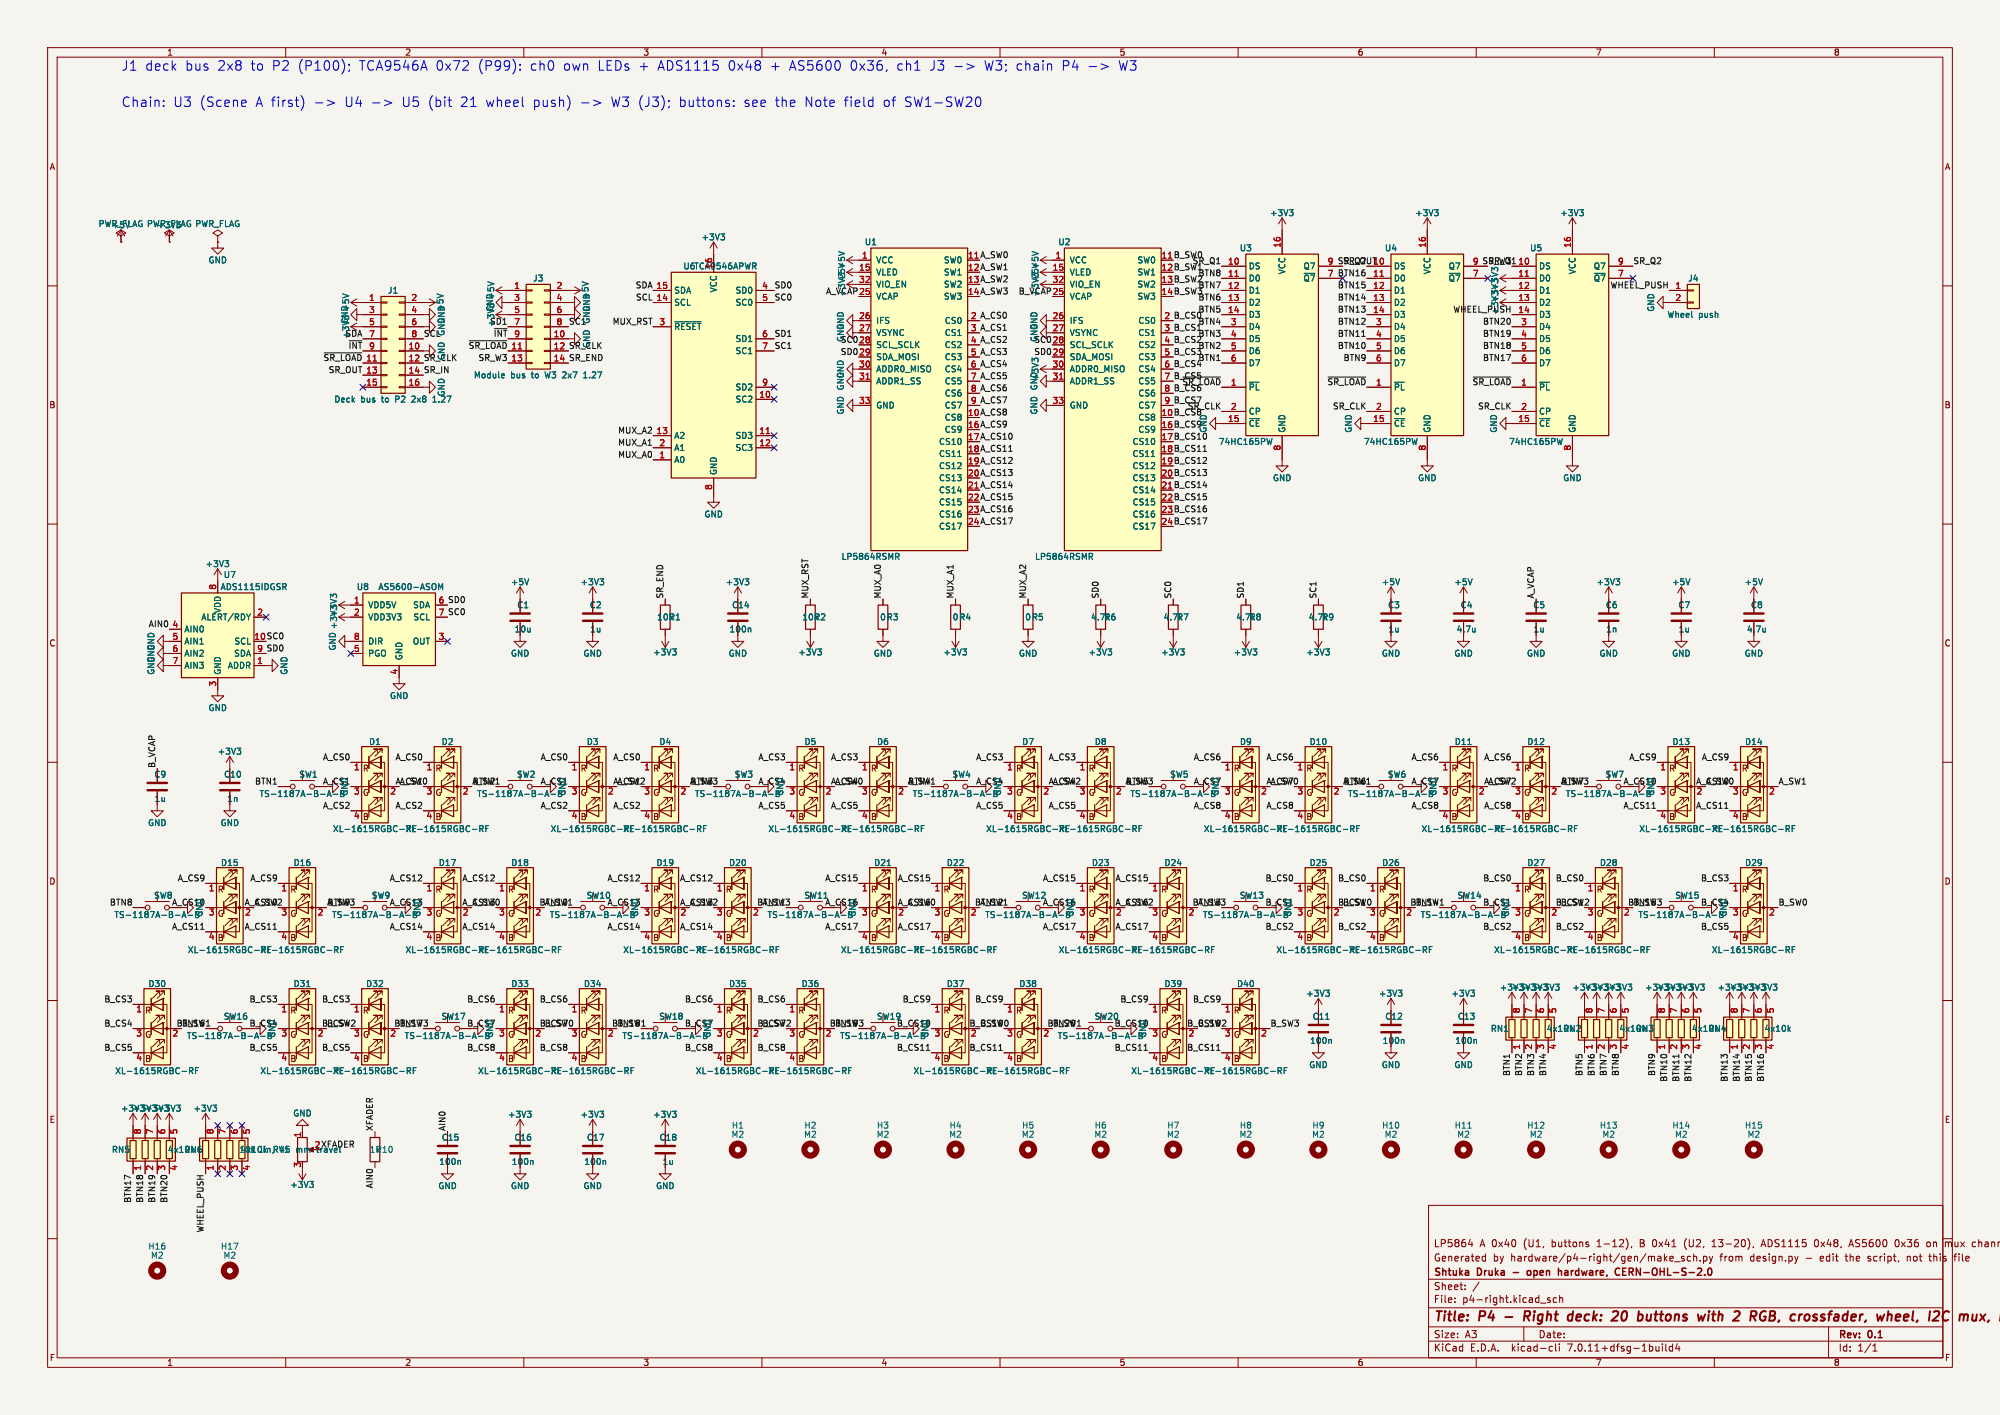
[picture p61: page 1]

4 PGO 5 SDA 6 SCL 7 DIR 8U8 AS5600-ASOM +3V3 GND GND

3 AIN0 4 AIN1 5 AIN2 6 AIN3 7 VDD
0 R5 ADDR 1 SCL 10 ALERT/RDY 2 GND

ADDR 1 SCL 10 ALERT/RDY 2 GND

4 PGO 5 SDA 6 SCL 7 DIR 8 +3V3 GND GND GND

Id: 1/1 Title: P4 - Right deck: 20 buttons with 2 RGB, crossfader, wheel, I2C mux, bus to P2 and W3
