MitjaGrecky/Shtuka-druka/hardware/for-routing/P1/schematic.pdf

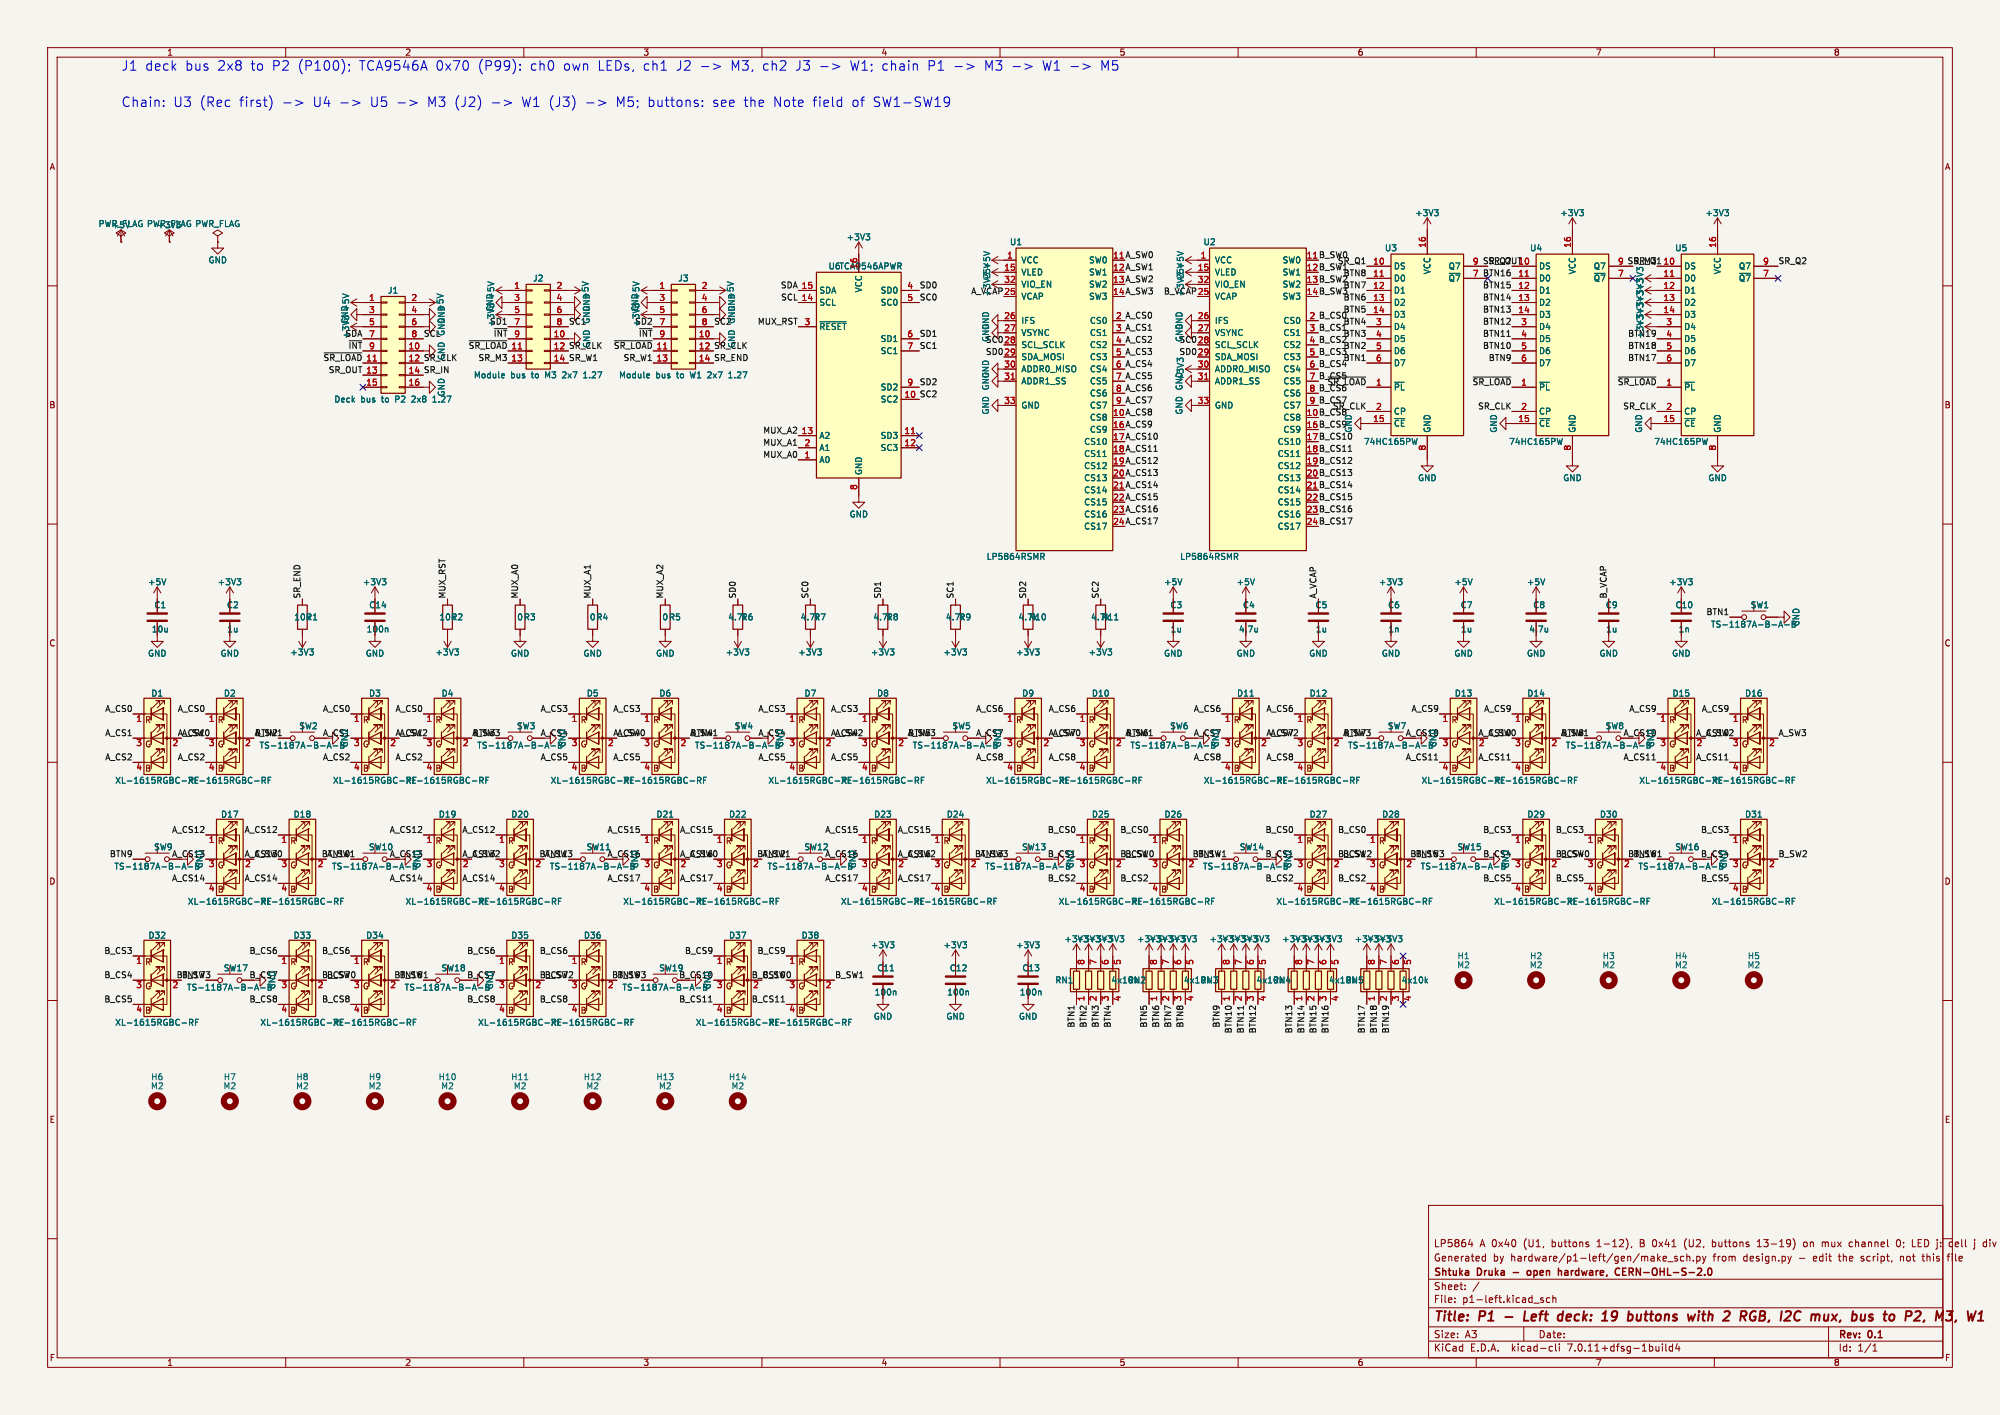
[picture p62: page 1]

8 SD2 9 U6TCA9546APWR GND GND +3V3GND+5V +5V GND GND +5V GND
J1 Deck bus to P2 2x8 1.27

J3 Module bus to W1 2x7 1.27 GND GND GND +5V1
