MitjaGrecky/Shtuka-druka/hardware/for-routing/W3/schematic.pdf

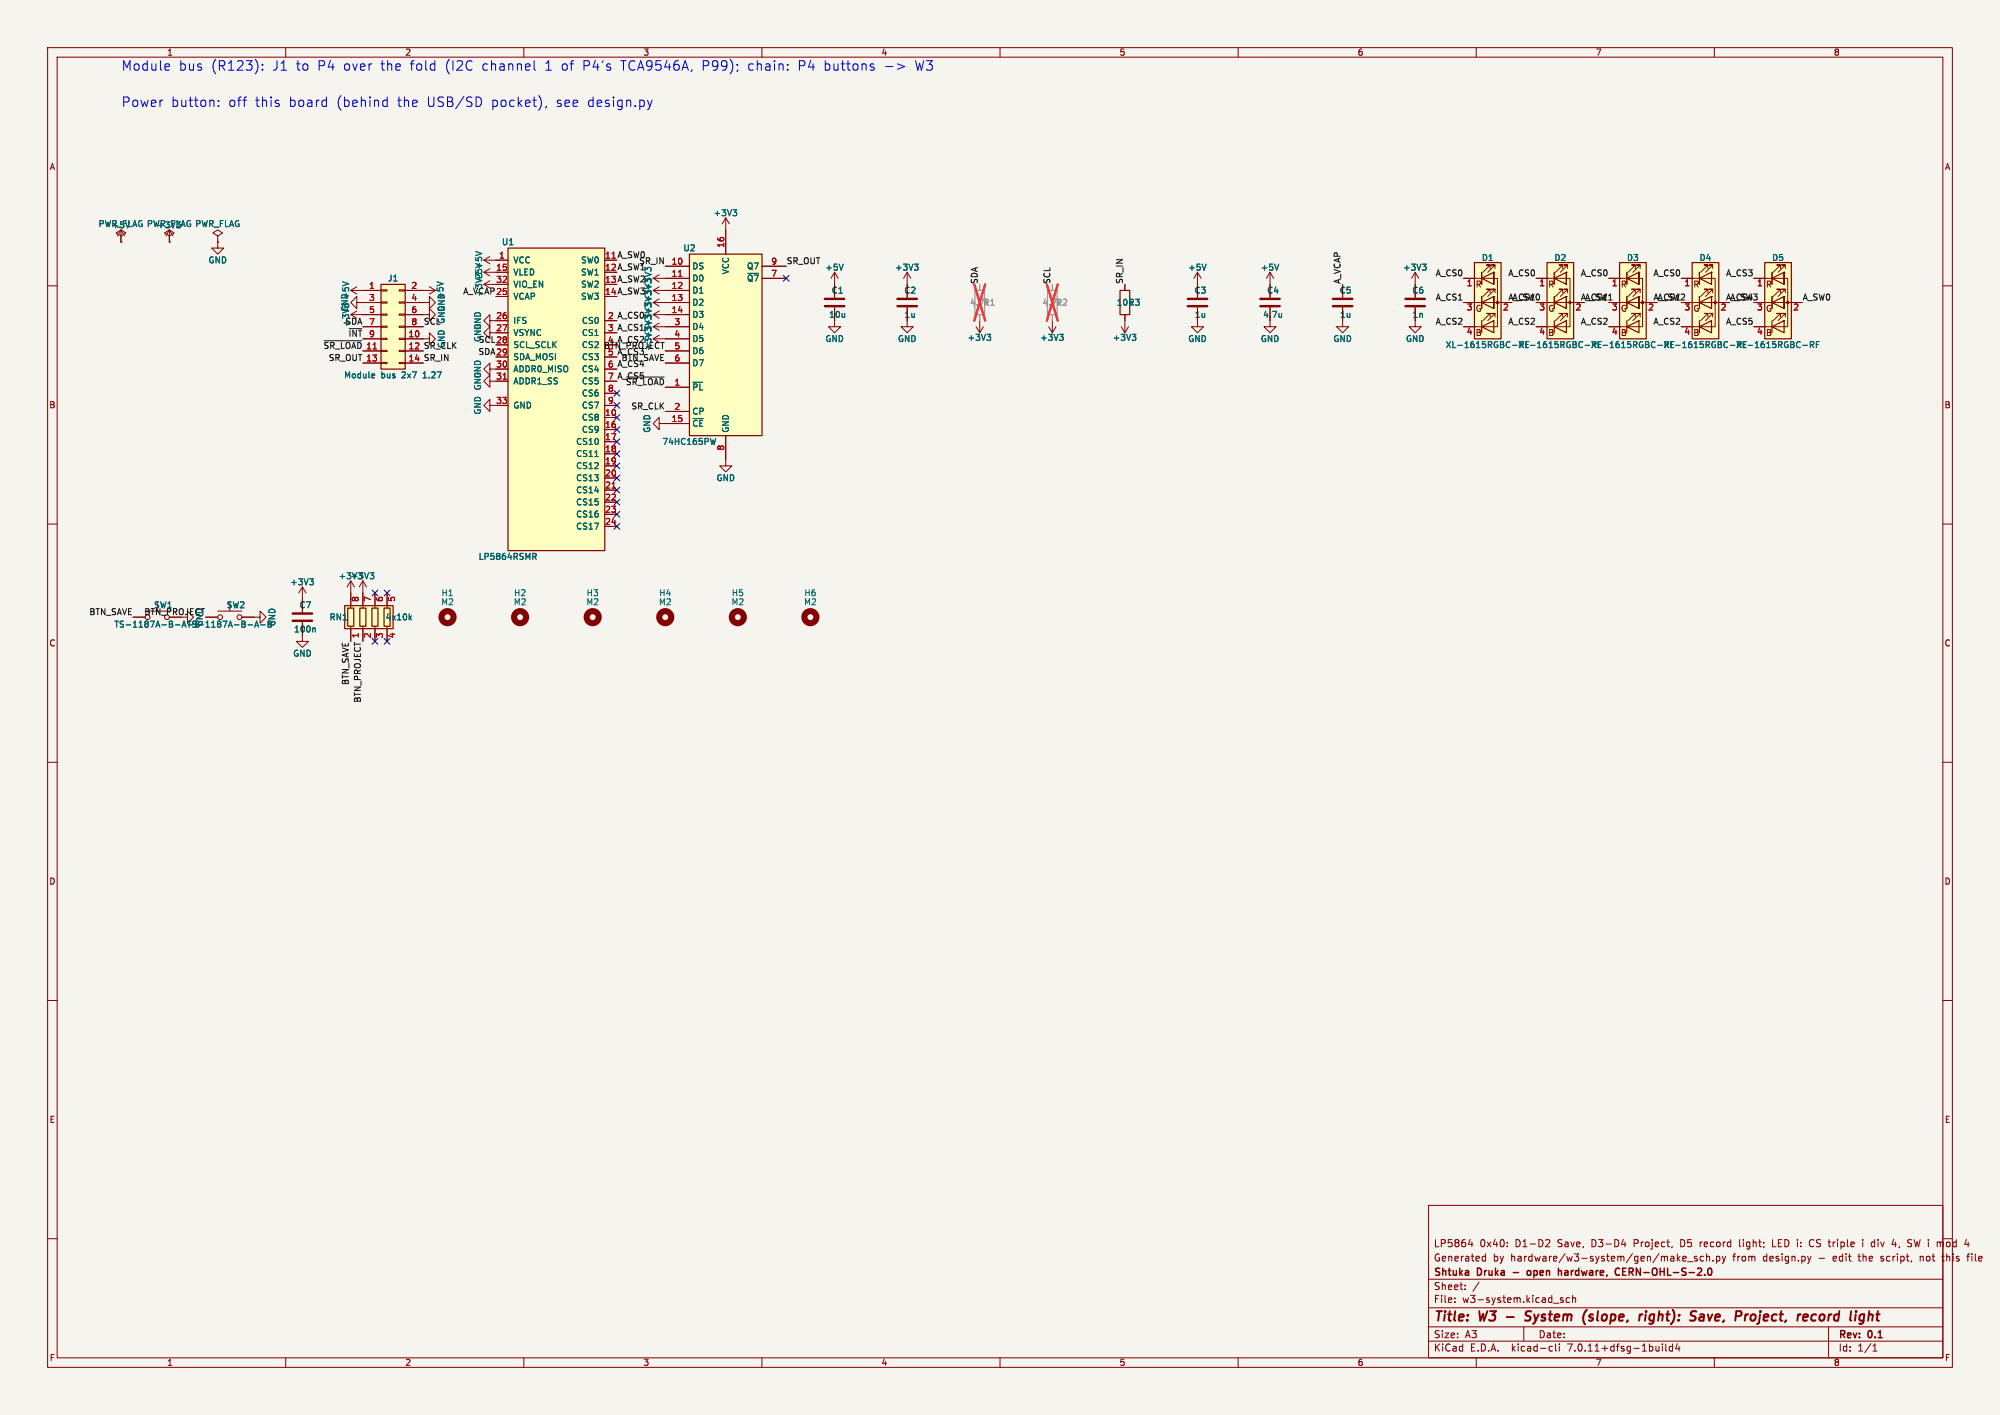
[picture p63: page 1]

Power button: off this board (behind the USB/SD pocket), see design.py

74HC165PW GND +3V3+5V GND GND GND
A_VCAP
