MitjaGrecky/Shtuka-druka/hardware/for-routing/W2/schematic.pdf

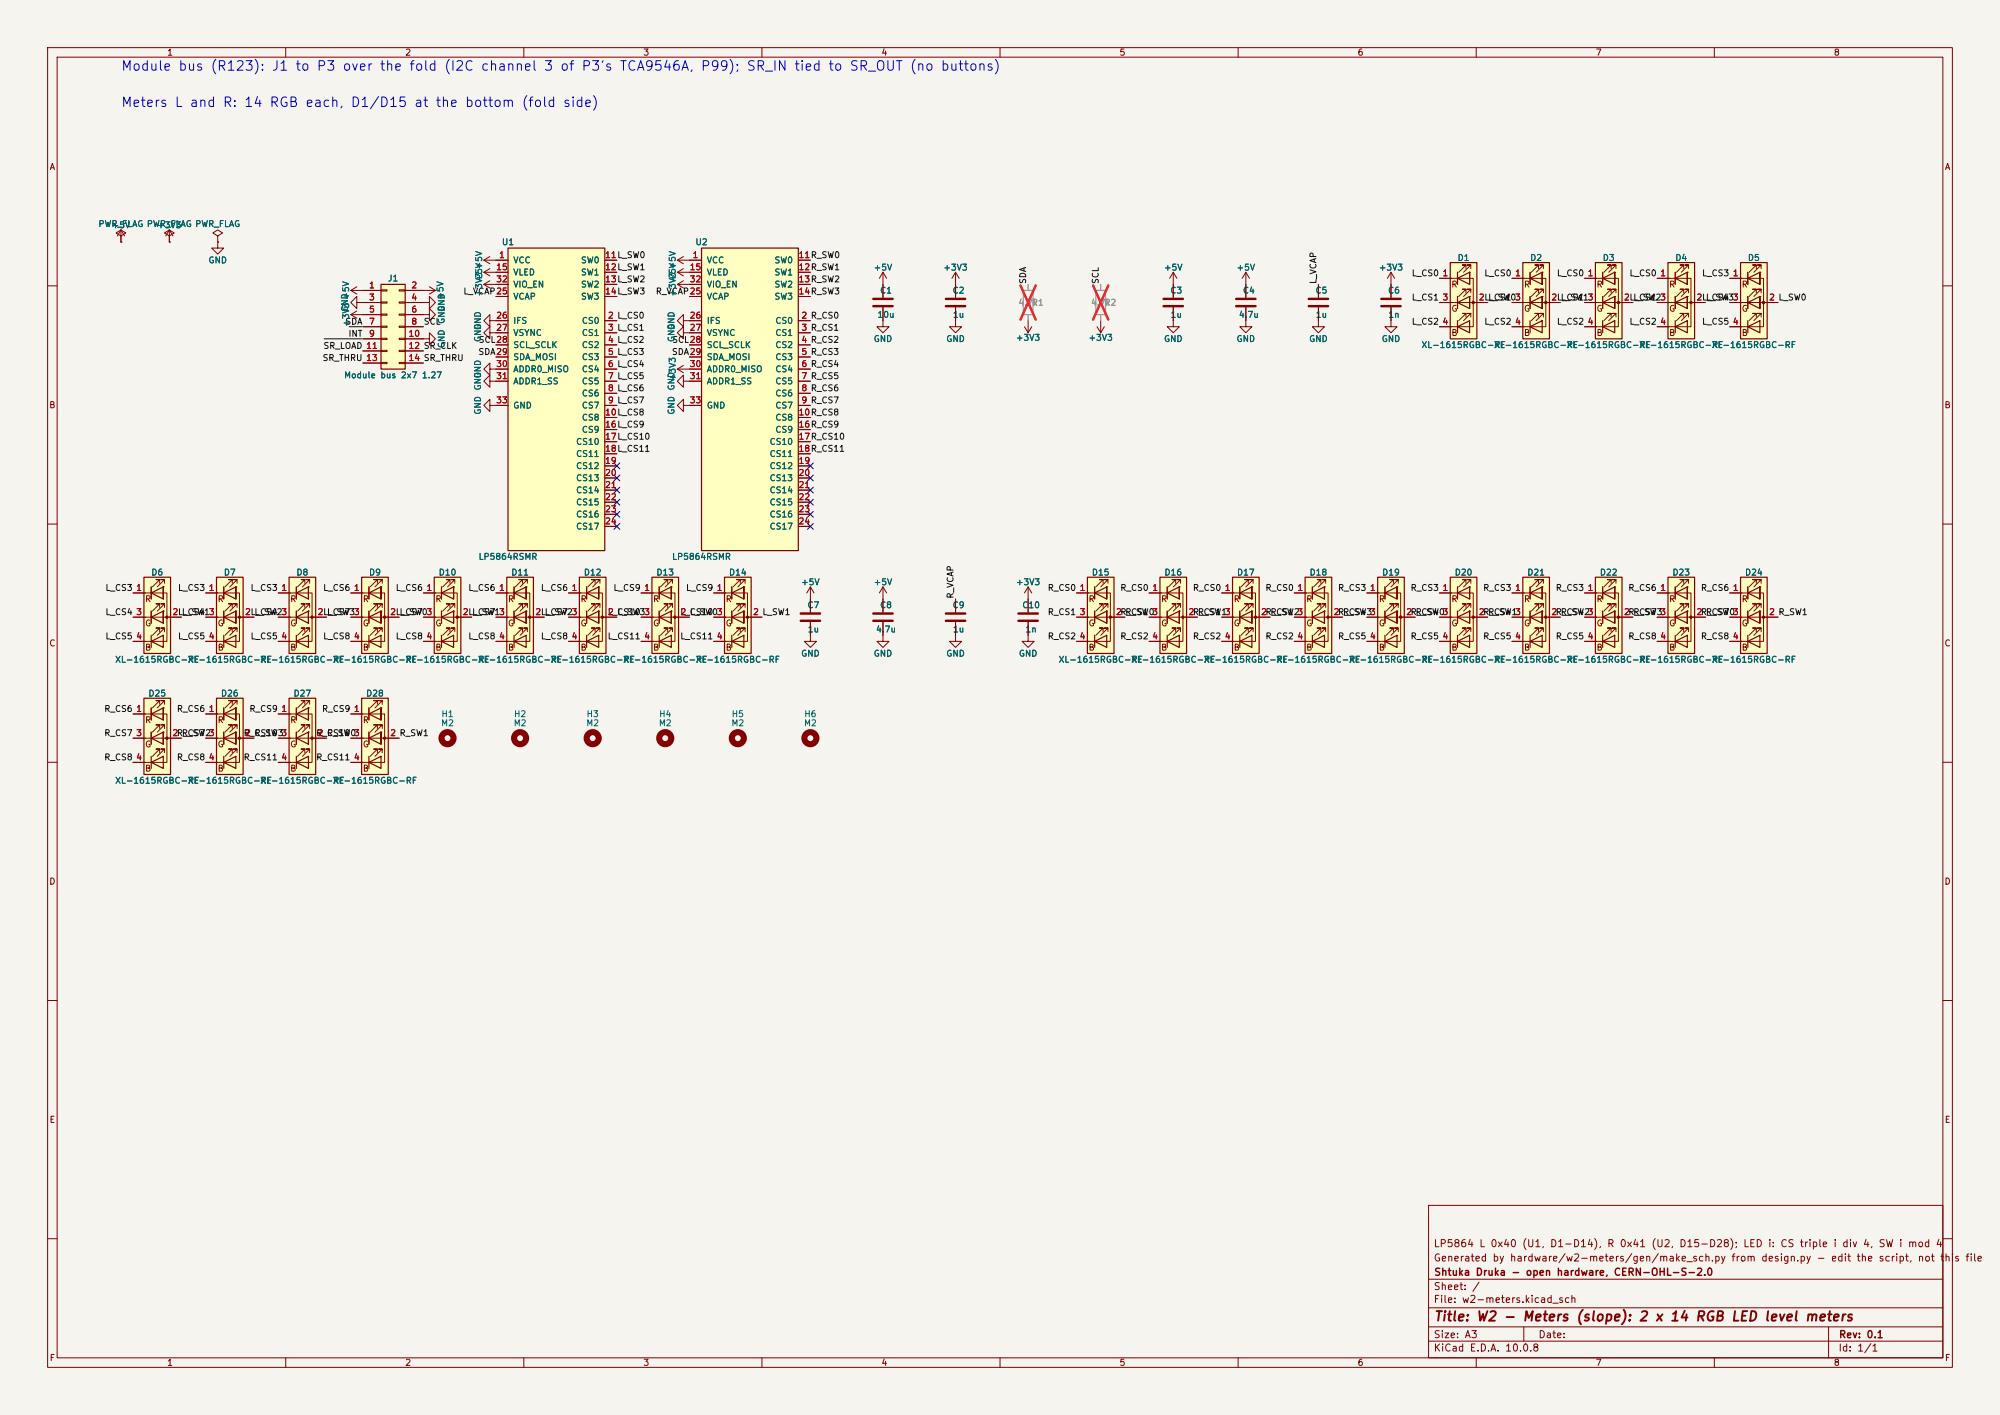
[picture p64: page 1]

L_SW3 Module bus (R123): J1 to P3 over the fold (I2C channel 3 of P3's TCA9546A, P99); SR_IN tied to SR_OUT (no buttons)

Meters L and R: 14 RGB each, D1/D15 at the bottom (fold side)

LP5864 L 0x40 (U1, D1-D14), R 0x41 (U2, D15-D28); LED i: CS triple i div 4, SW i mod 4
Generated by hardware/w2-meters/gen/make_sch.py from design.py - edit the script, not this file
Shtuka Druka - open hardware, CERN-OHL-S-2.0
Sheet: /
File: w2-meters.kicad_sch
Title: W2 - Meters (slope): 2 x 14 RGB LED level meters

Size: A3 | Rev: 0.1 | F Date:
KiCad E.D.A. 10.0.8 | Id: 1/1
