MitjaGrecky/Shtuka-druka/hardware/for-routing/W1/schematic.pdf

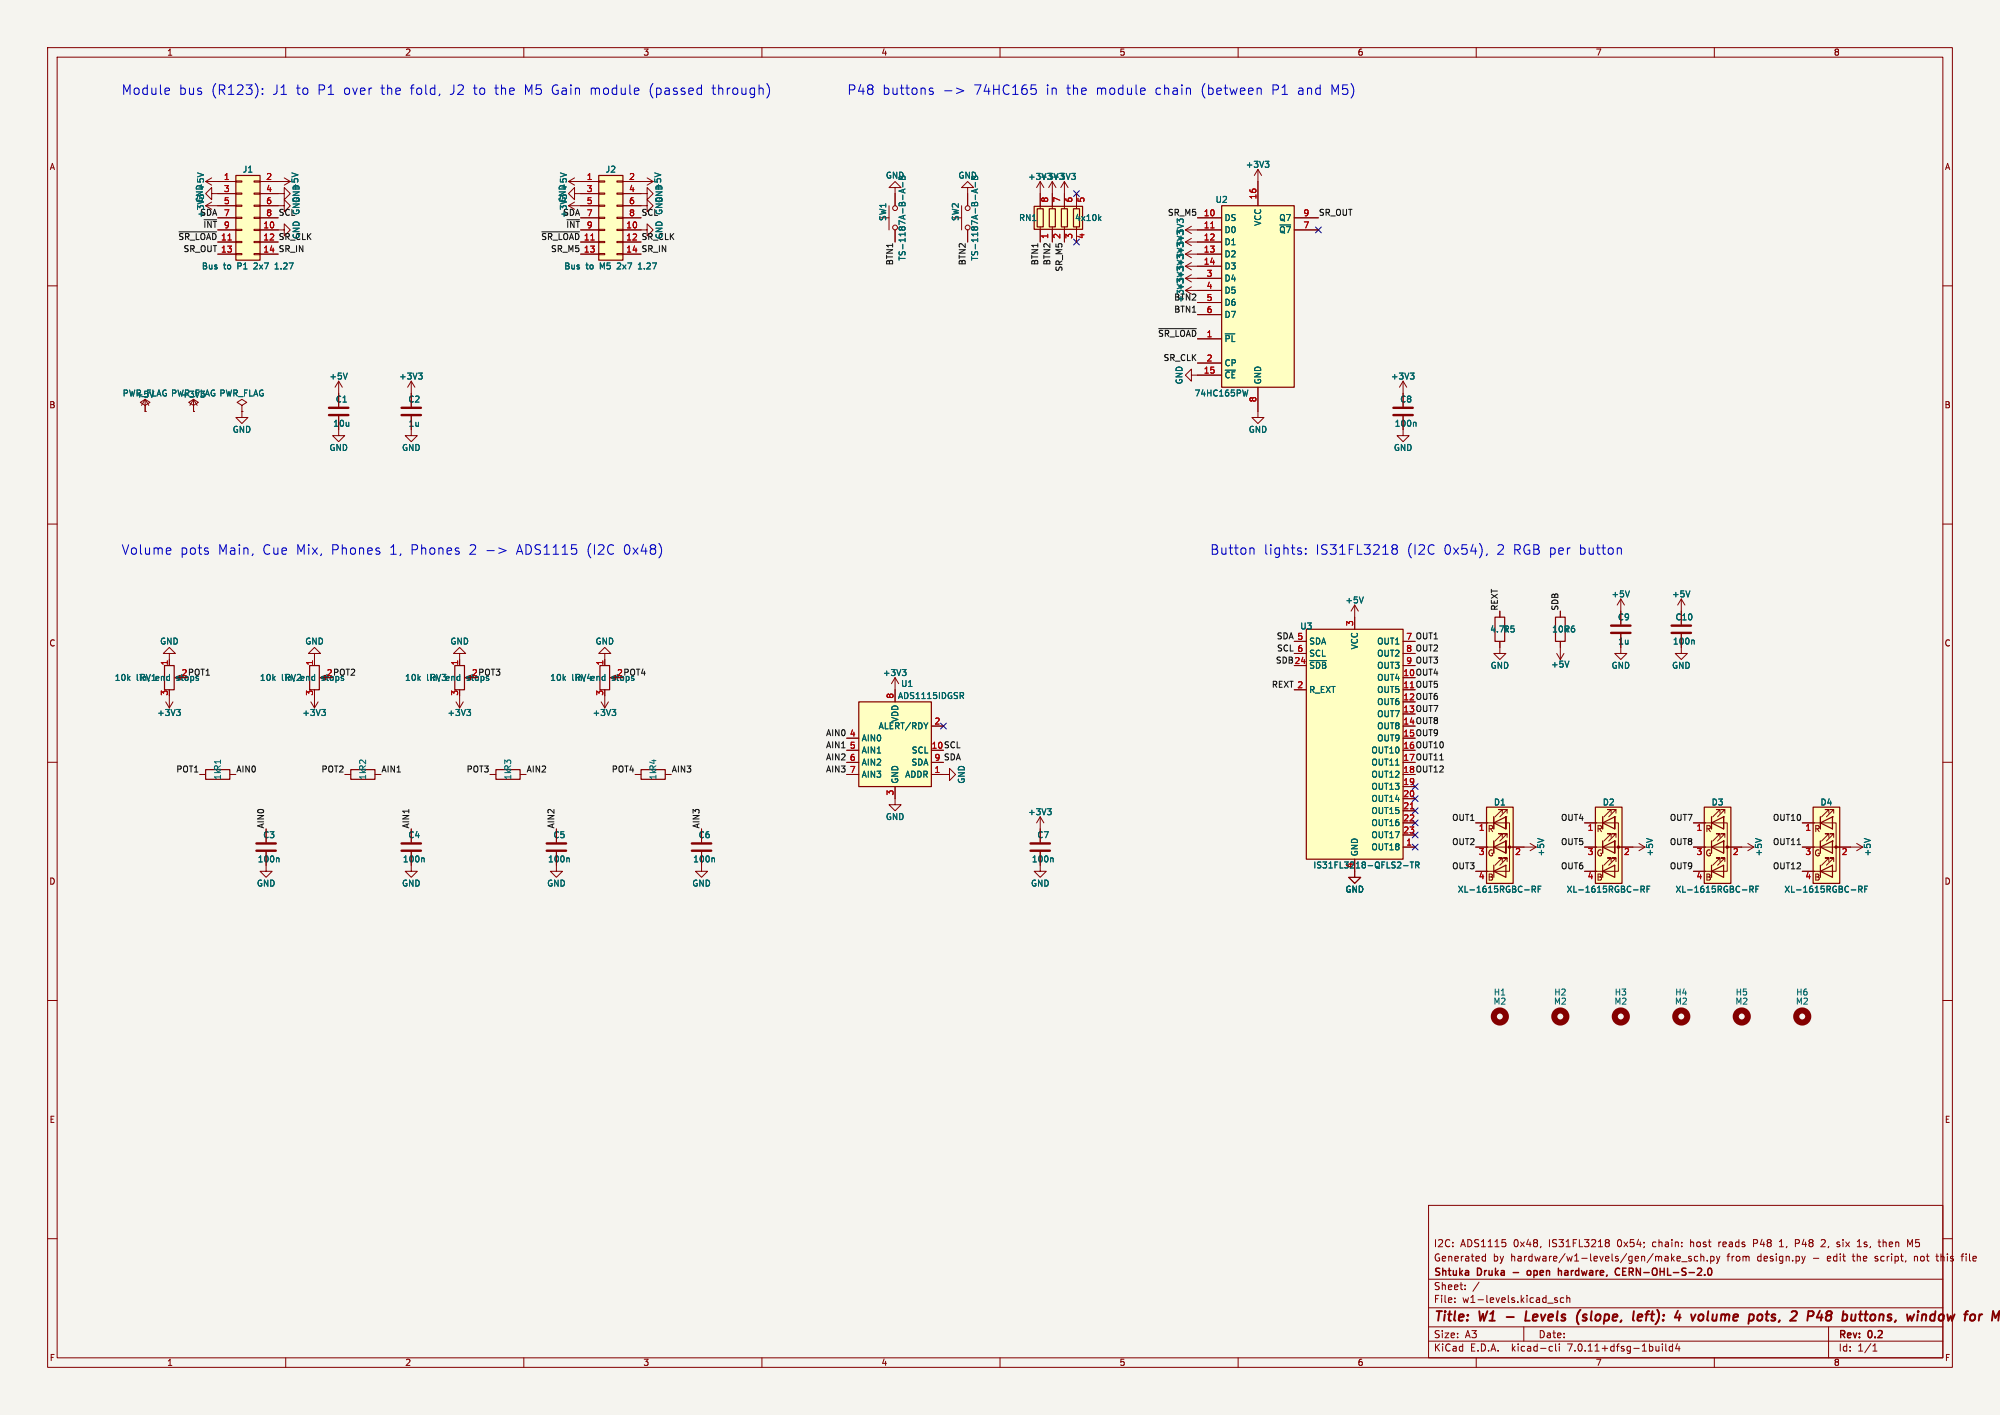
[picture p65: page 1]
