MitjaGrecky/Shtuka-druka/hardware/for-routing/M3/schematic.pdf

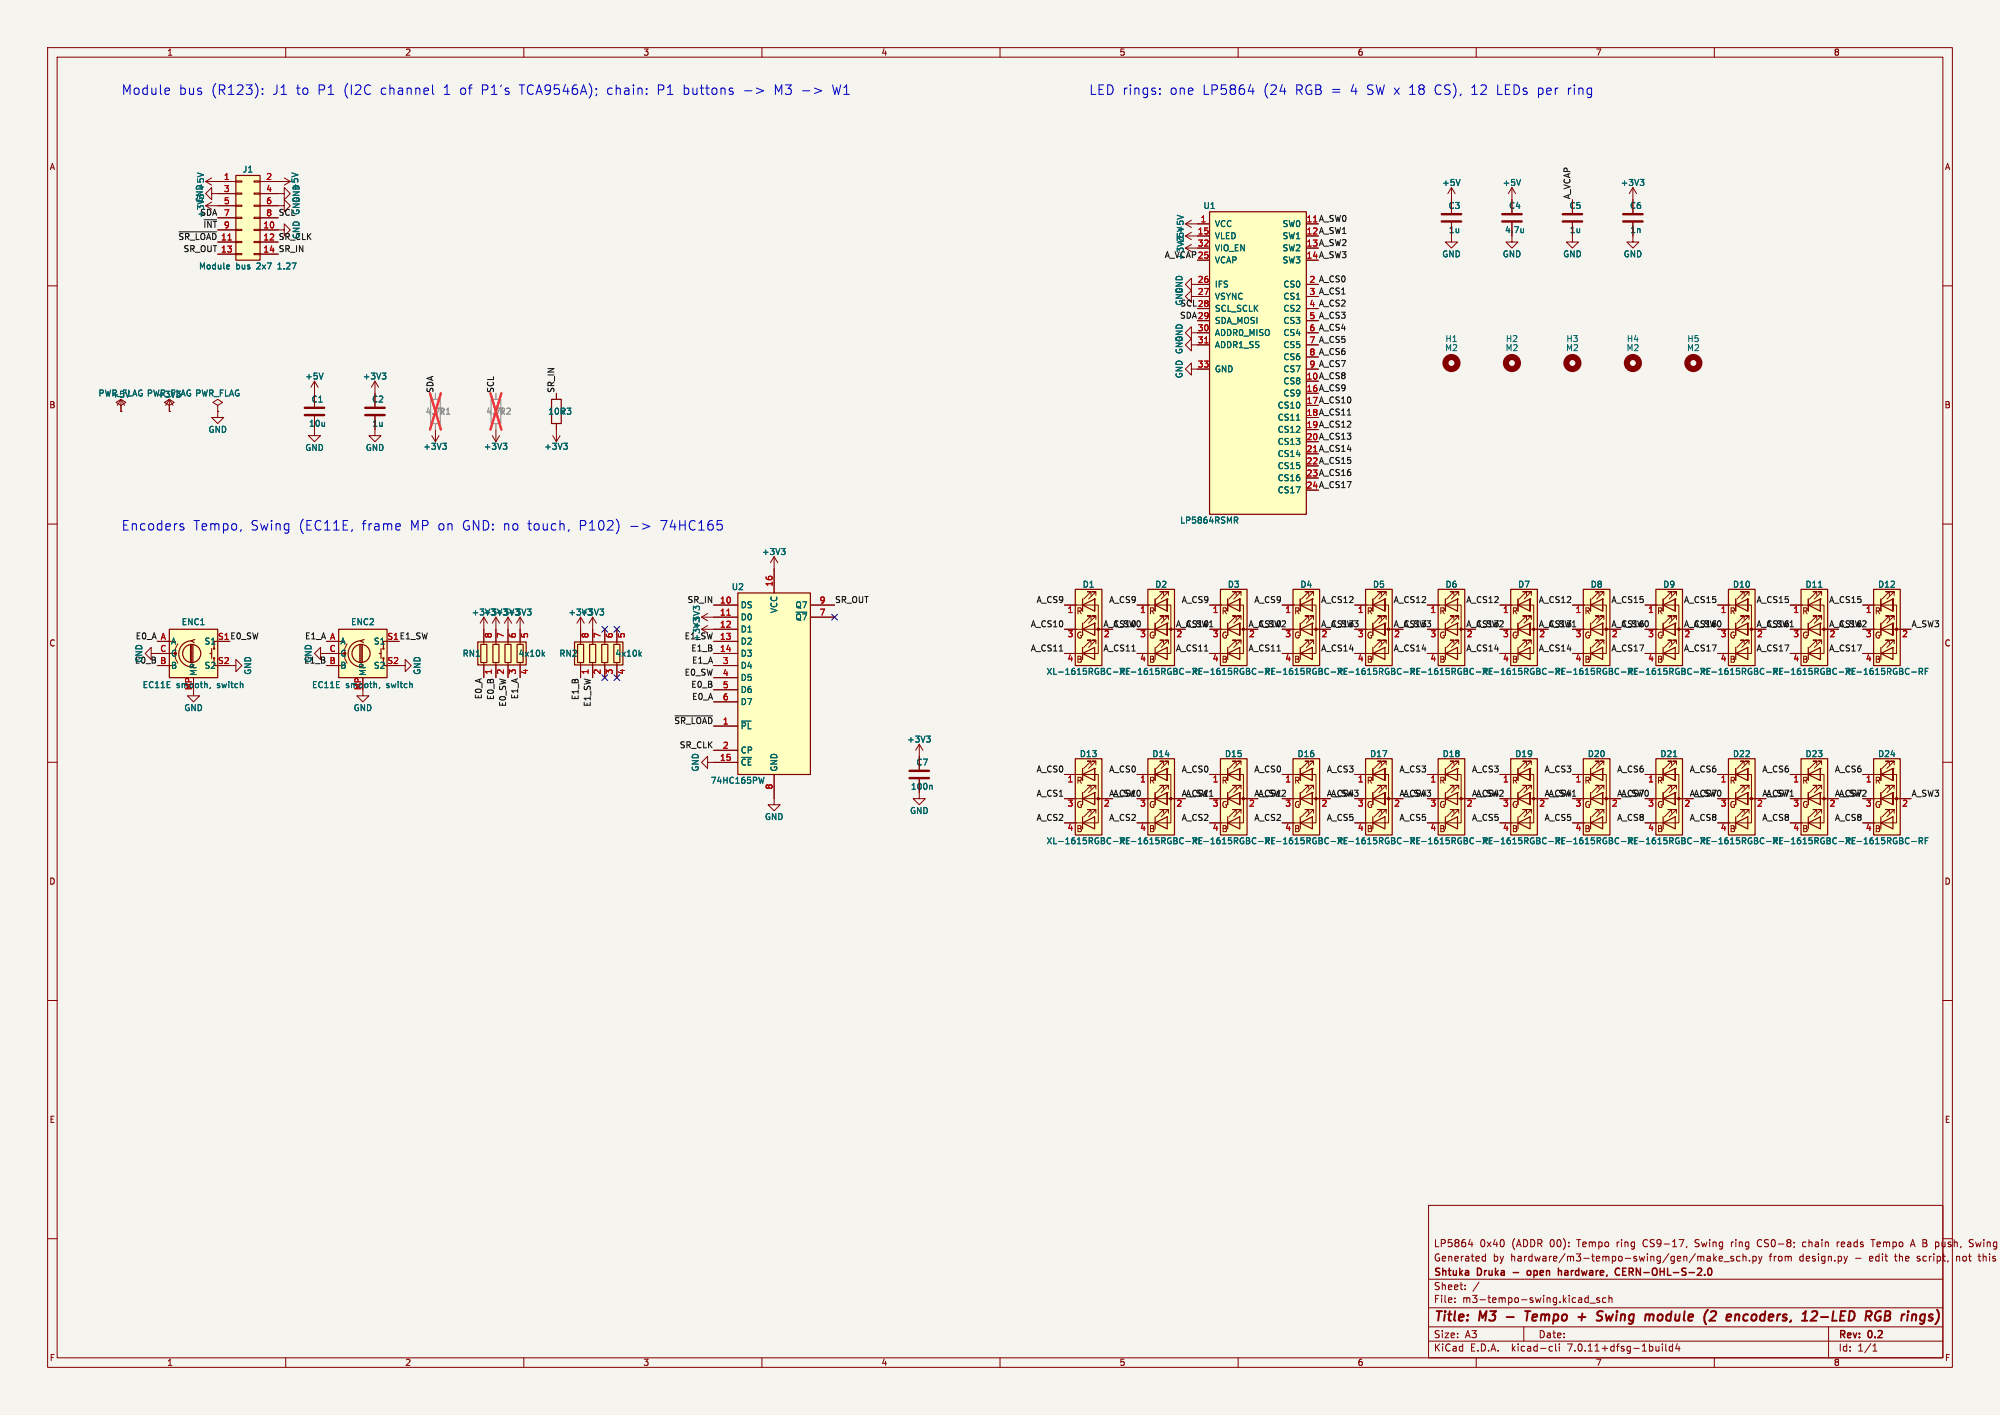
[picture p66: page 1]
