MitjaGrecky/Shtuka-druka/hardware/for-routing/M4/schematic.pdf

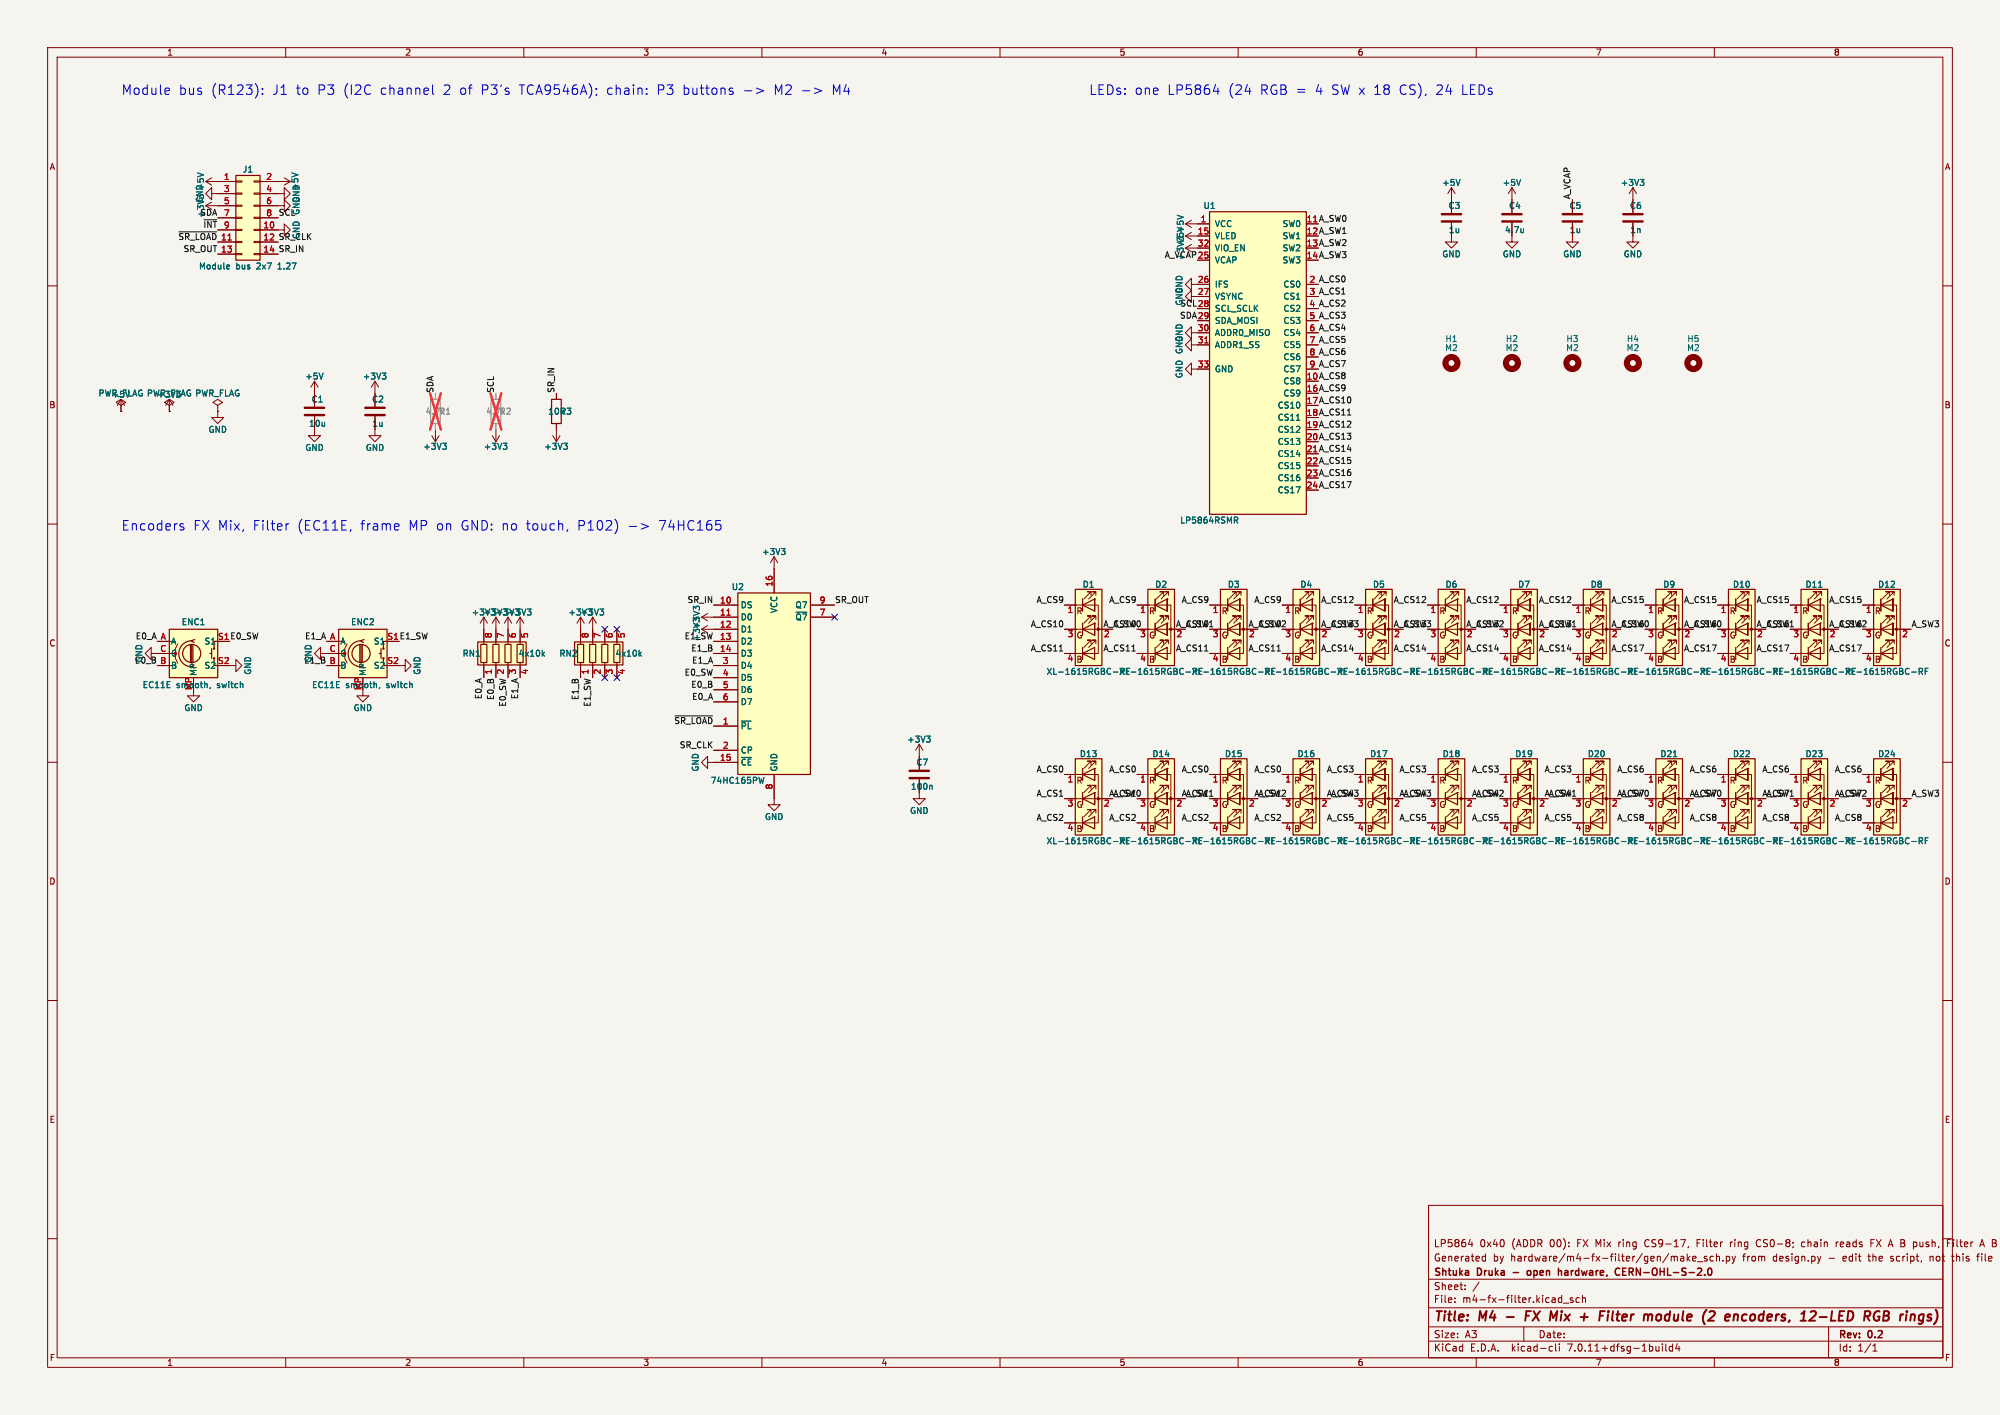
[picture p67: page 1]
