MitjaGrecky/Shtuka-druka/hardware/for-routing/M1/schematic.pdf

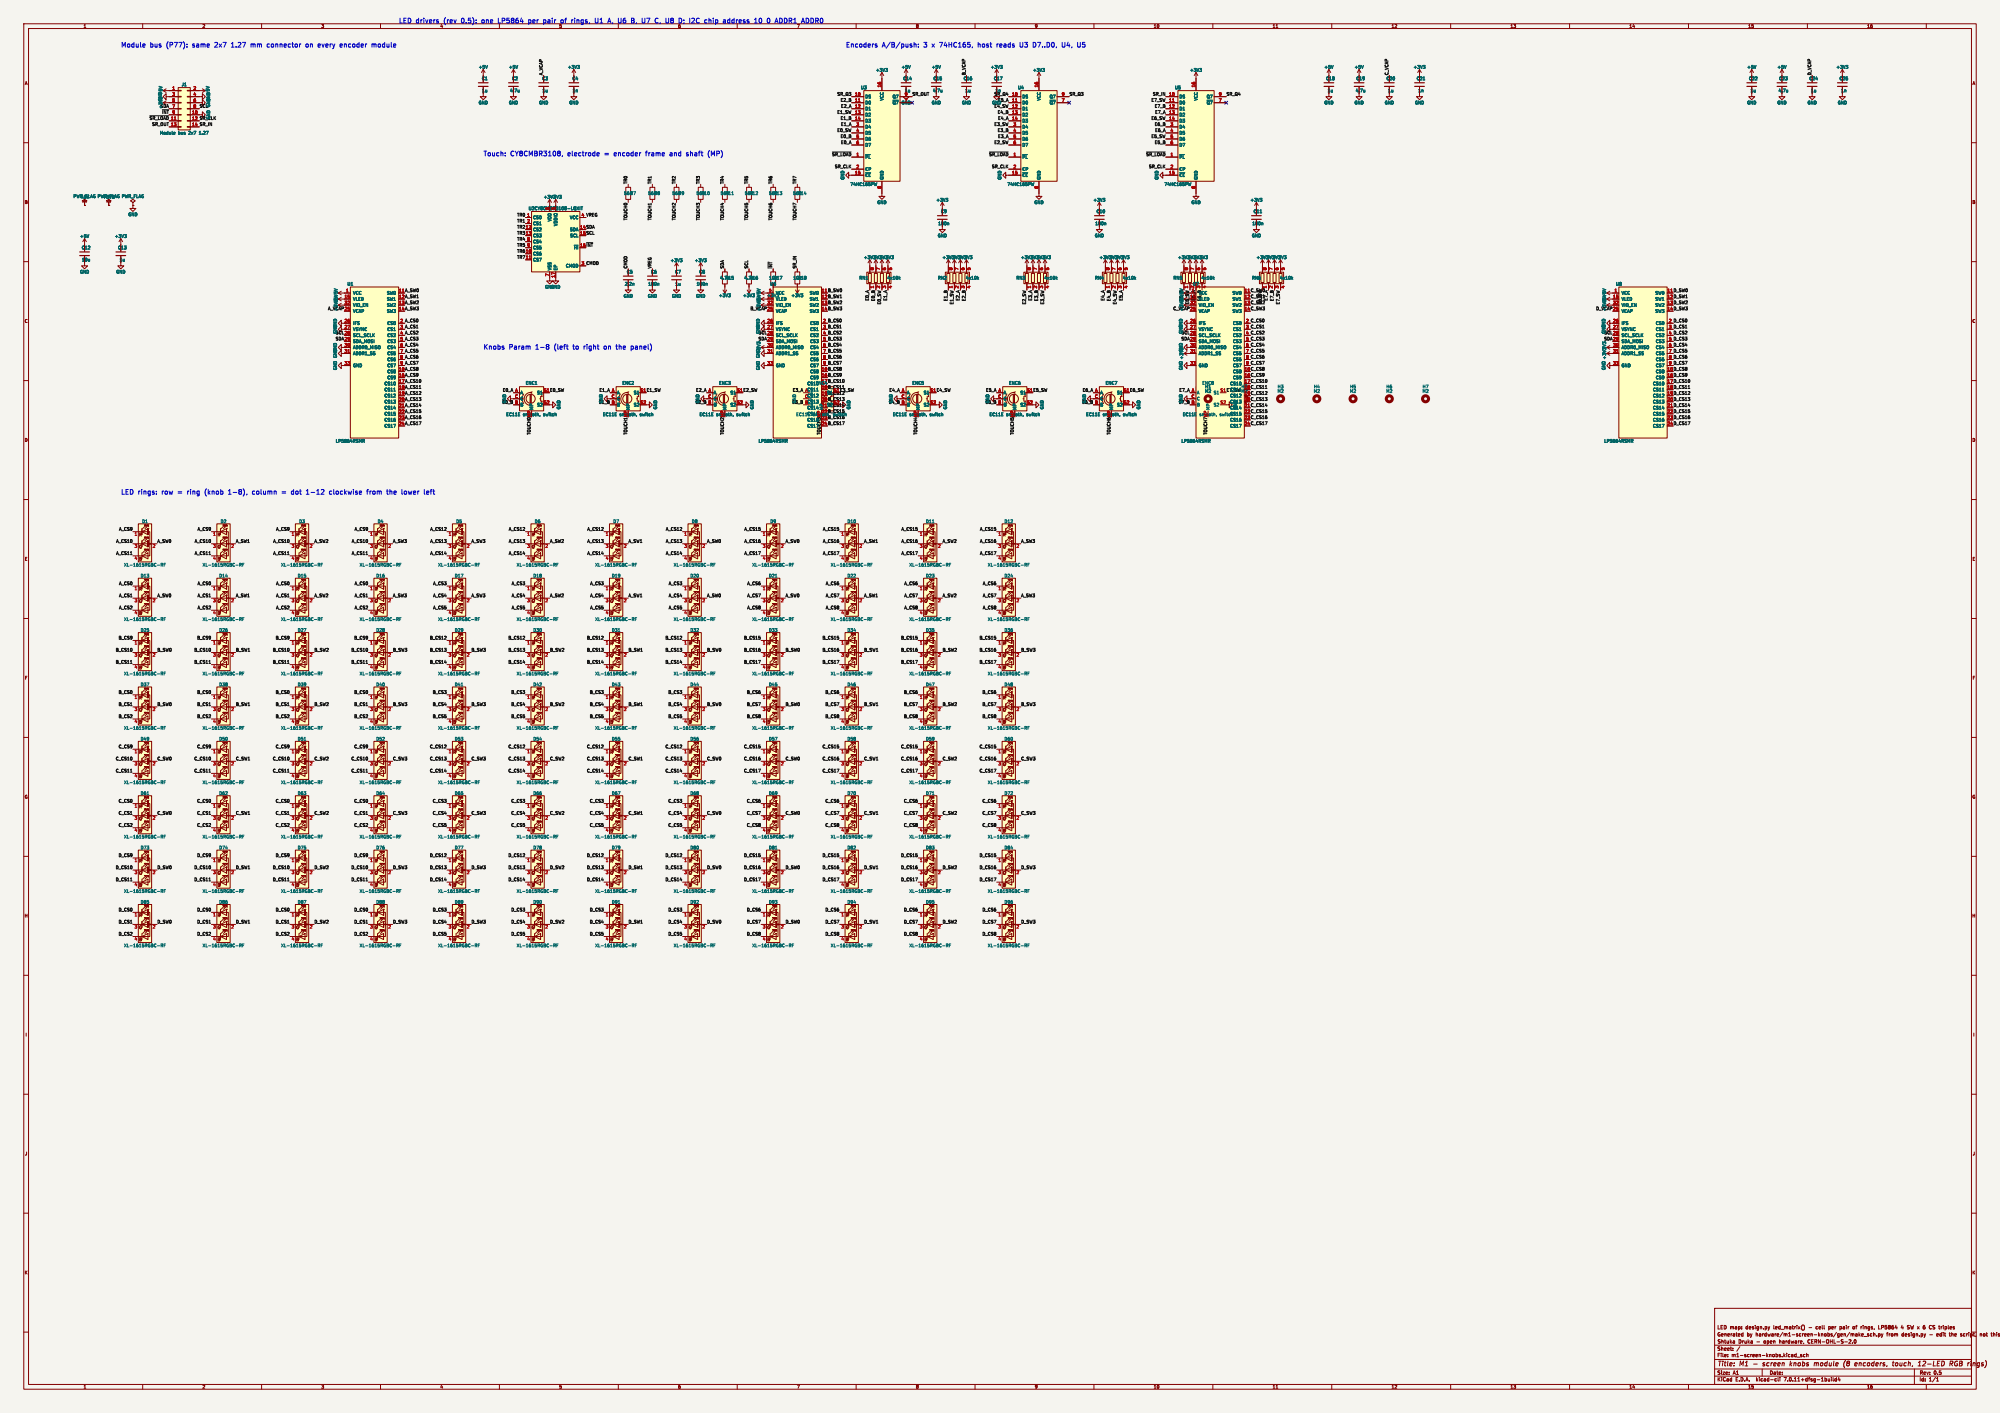
[picture p68: page 1]

LED drivers (rev 0.5): one LP5864 per pair of rings, U1 A, U6 B, U7 C, U8 D; I2C chip address 10 0 ADDR1 ADDR0

Knobs Param 1-8 (left to right on the panel)
