MitjaGrecky/Shtuka-druka/hardware/r2-control/r2-control.kicad_pcb

## KiCad design hardware/r2-control/r2-control.kicad_pcb (2026-11-14)

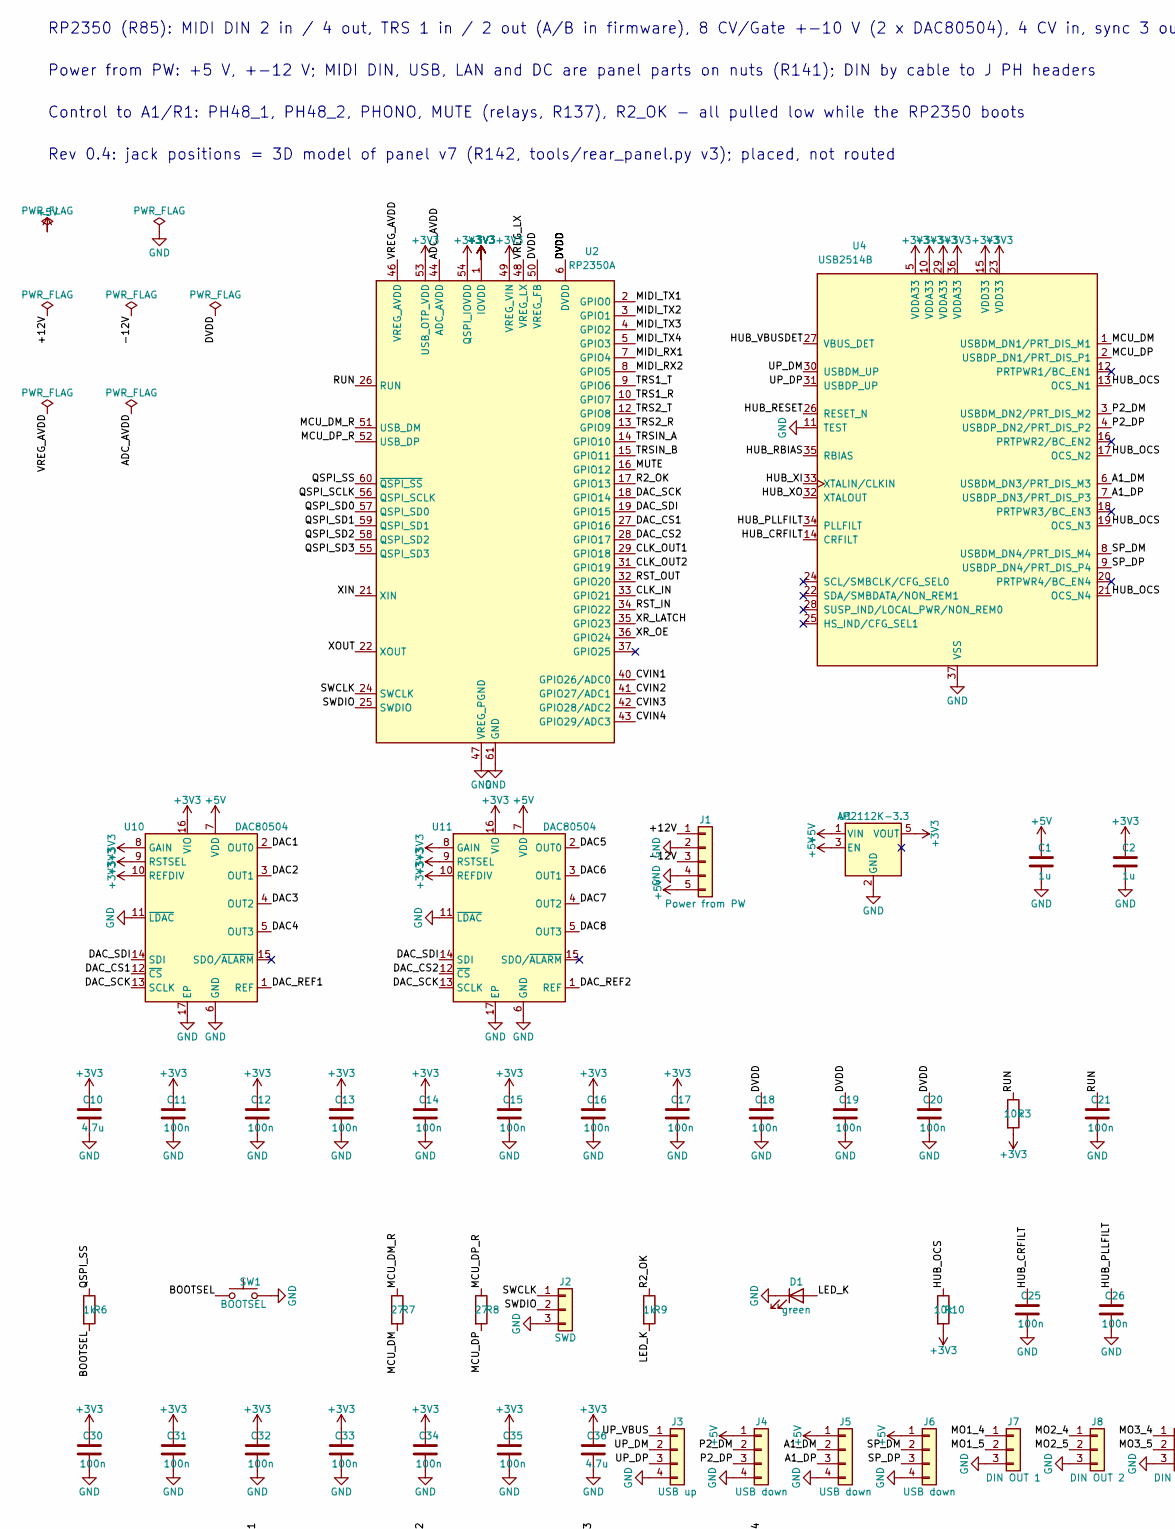
[picture p69: schematic r2-control.kicad_sch, R2 - Control board (rear wall): RP2350, USB hub, MIDI, CV/G…, part in row 1, column 1]

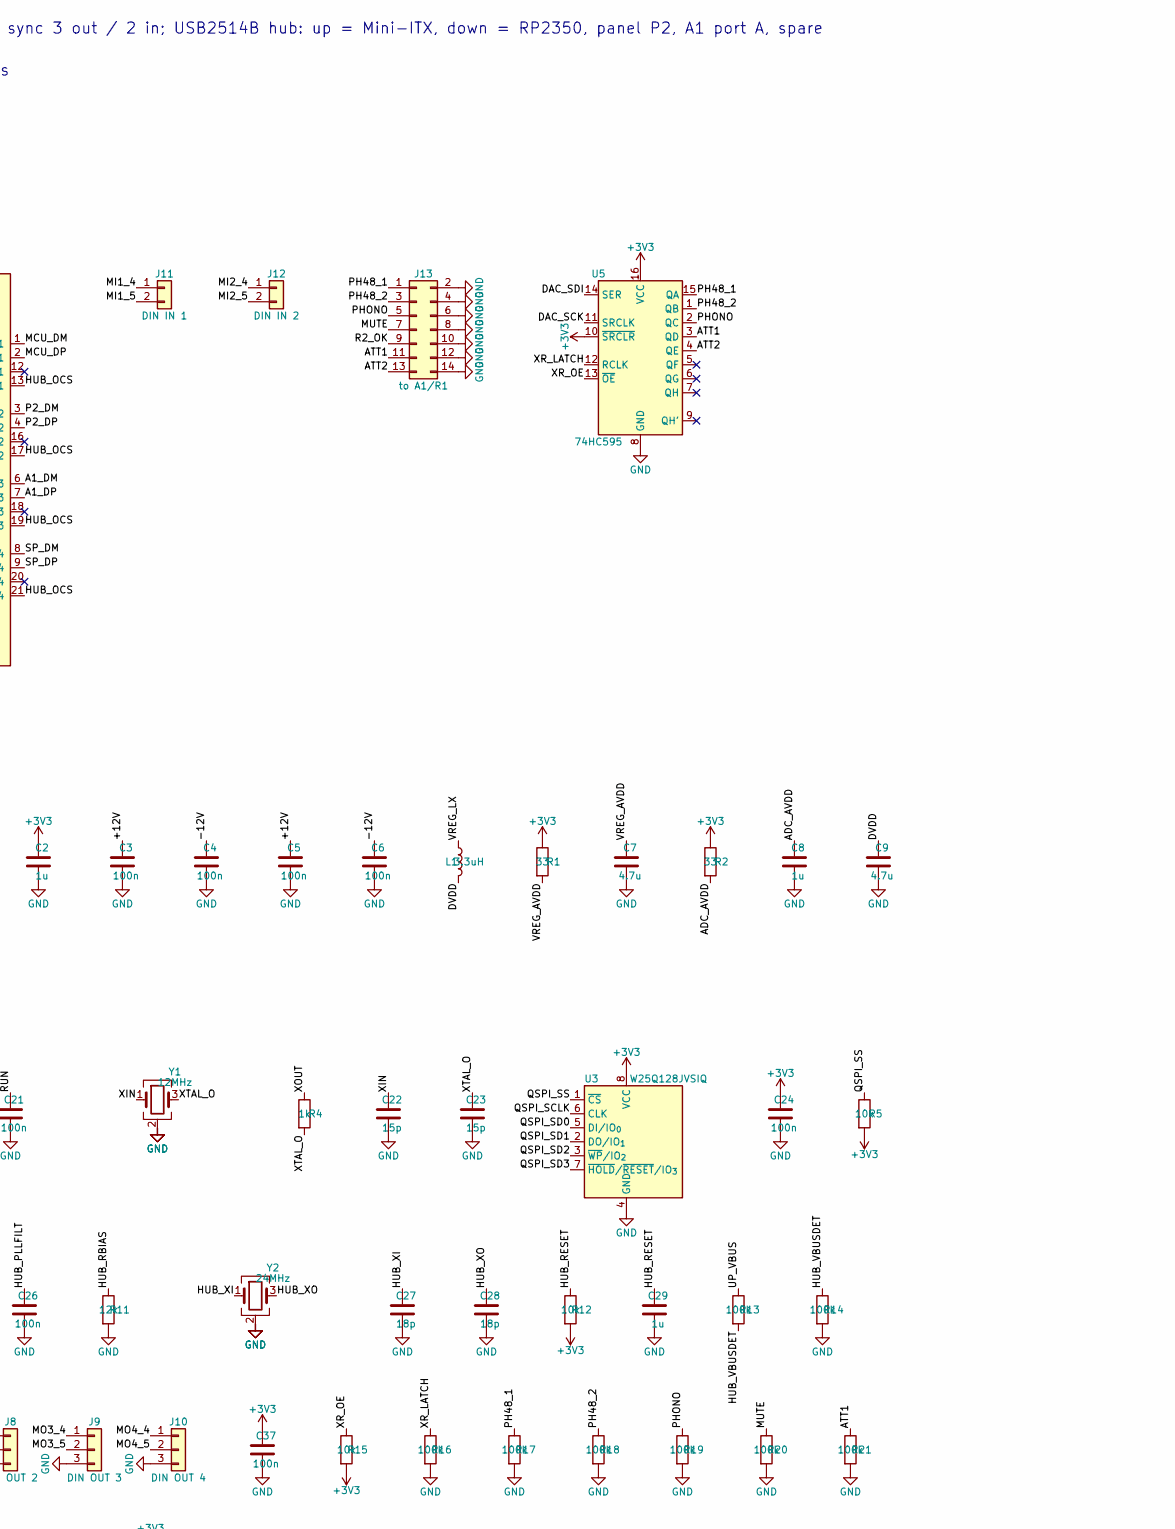
[picture p70: schematic r2-control.kicad_sch, R2 - Control board (rear wall): RP2350, USB hub, MIDI, CV/G…, part in row 1, column 2]

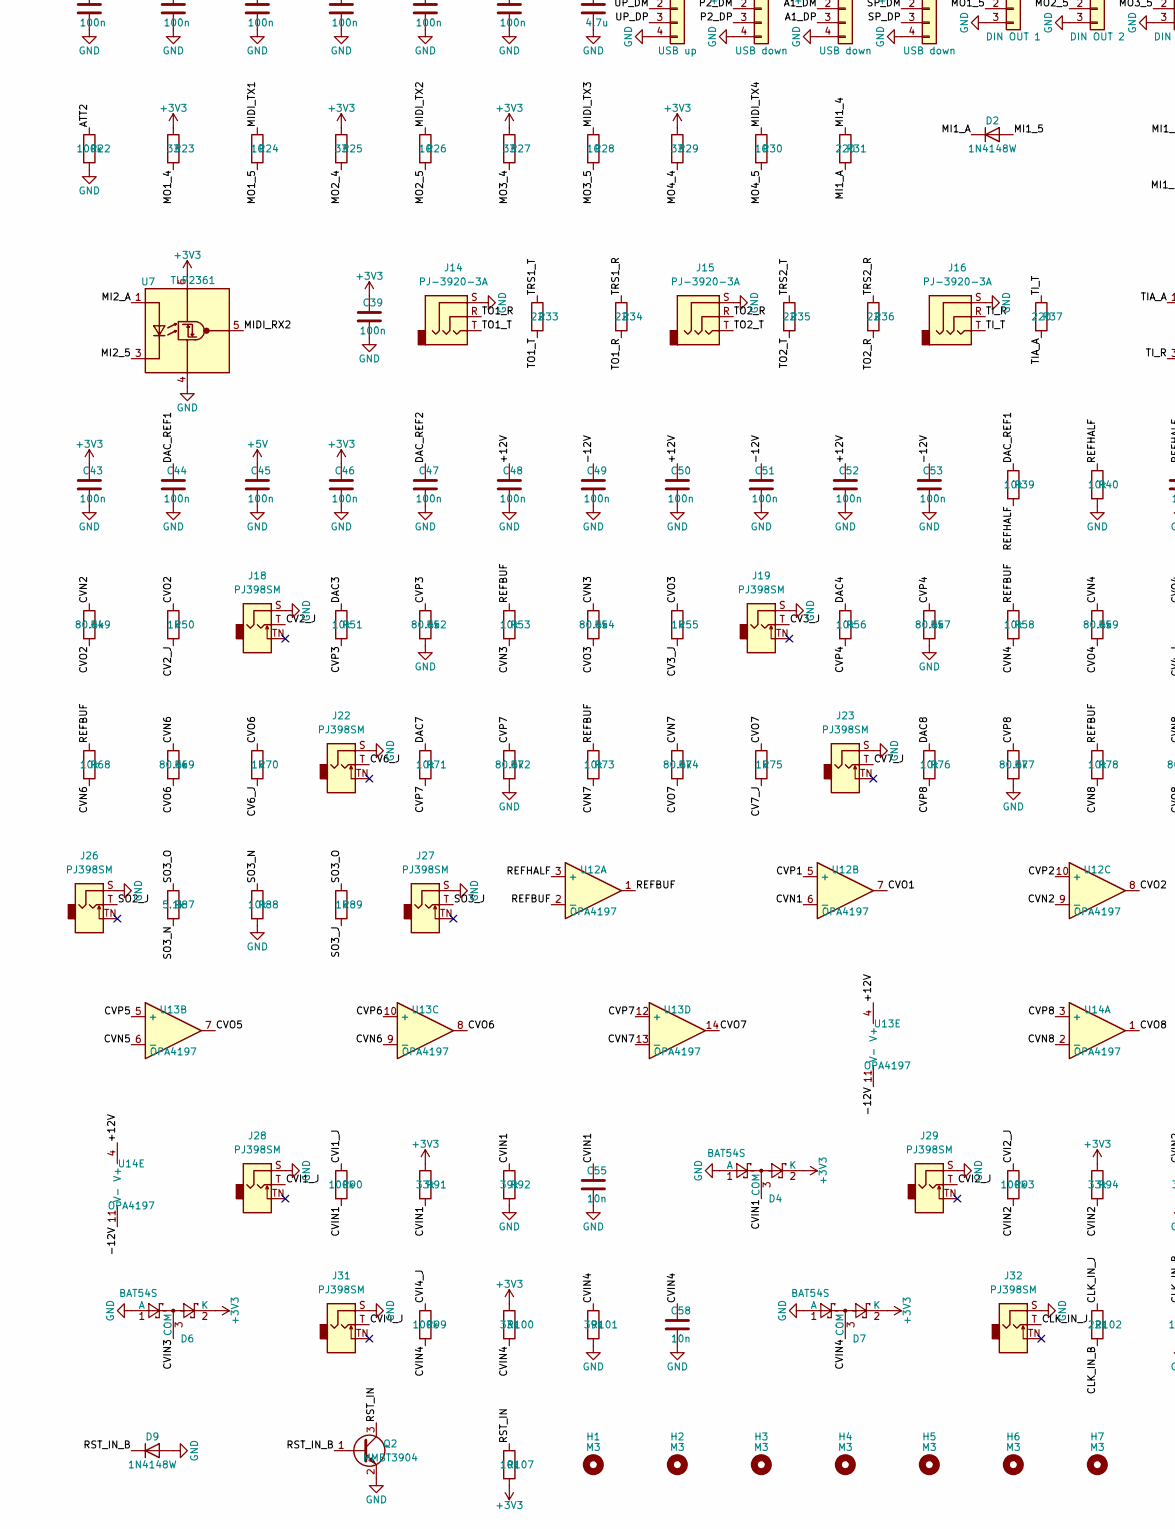
[picture p71: schematic r2-control.kicad_sch, R2 - Control board (rear wall): RP2350, USB hub, MIDI, CV/G…, part in row 2, column 1]

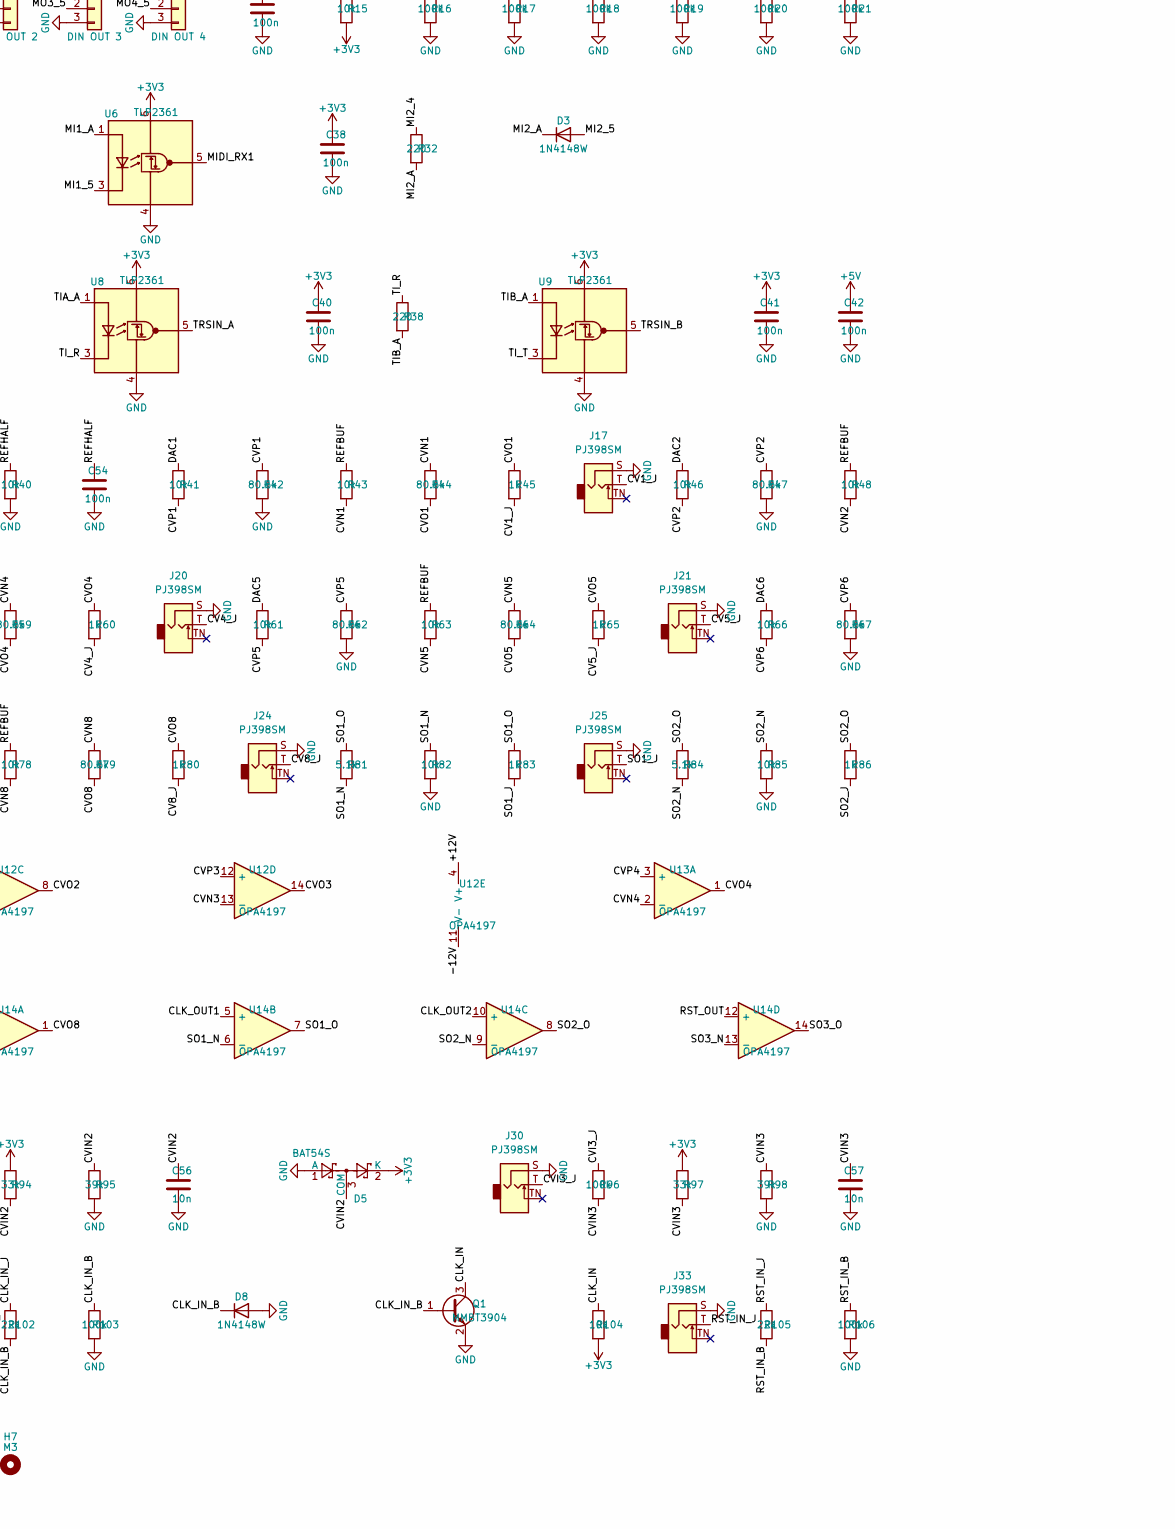
[picture p72: schematic r2-control.kicad_sch, R2 - Control board (rear wall): RP2350, USB hub, MIDI, CV/G…, part in row 2, column 2]

Parts:
C1, C2, C8, C29: 1u; C_0402_1005Metric; LCSC C52923
C3, C4, C5, C6, C11, C12, C13, C14, C15, C16, C17, C18, C19, C20, C21, C24, C25, C26, C30, C31, C32, C33, C34, C35, C37, C38, C39, C40, C41, C42, C43, C44, C45, C46, C47, C48, C49, C50, C51, C52, C53, C54: 100n; C_0402_1005Metric; LCSC C1525
C7, C9, C10, C36: 4.7u; C_0805_2012Metric; LCSC C1779
C22, C23: 15p; C_0402_1005Metric
C27, C28: 18p; C_0402_1005Metric
C55, C56, C57, C58: 10n; C_0402_1005Metric
D1: green; LED_0603_1608Metric
D2, D3, D8, D9: 1N4148W; D_SOD-123
D4, D5, D6, D7: BAT54S; SOT-23
H1, H2, H3, H4, H5, H6, H7: M3; MountingHole_3.2mm_M3_ISO7380
J1: Power from PW; JST_PH_B5B-PH-K_1x05_P2.00mm_Vertical
J2: SWD; JST_PH_B3B-PH-K_1x03_P2.00mm_Vertical
J3: USB up; JST_PH_B4B-PH-K_1x04_P2.00mm_Vertical
J4, J5, J6: USB down; JST_PH_B4B-PH-K_1x04_P2.00mm_Vertical
J7: DIN OUT 1; JST_PH_B3B-PH-K_1x03_P2.00mm_Vertical
J8: DIN OUT 2; JST_PH_B3B-PH-K_1x03_P2.00mm_Vertical
J9: DIN OUT 3; JST_PH_B3B-PH-K_1x03_P2.00mm_Vertical
J10: DIN OUT 4; JST_PH_B3B-PH-K_1x03_P2.00mm_Vertical
J11: DIN IN 1; JST_PH_B2B-PH-K_1x02_P2.00mm_Vertical
J12: DIN IN 2; JST_PH_B2B-PH-K_1x02_P2.00mm_Vertical
J13: to A1/R1; PinHeader_2x07_P2.54mm_Vertical
J14, J15, J16: PJ-3920-3A; Jack_3.5mm_Hroparts_PJ-3920-3A_Vertical; LCSC C707259
J17, J18, J19, J20, J21, J22, J23, J24, J25, J26, J27, J28, J29, J30, J31, J32, J33: PJ398SM; Jack_3.5mm_QingPu_WQP-PJ398SM_Vertical_CircularHoles; LCSC C9900009788
L1: 3.3uH; L_Abracon_AOTA-B201610S; LCSC C42411119
Q1, Q2: MMBT3904; SOT-23
R1, R2: 33; R_0402_1005Metric
R3, R5, R10, R12, R15, R39, R40, R41, R43, R46, R48, R51, R53, R56, R58, R61, R63, R66, R68, R71, R73, R76, R78, R82, R85, R88, R104, R107: 10k; R_0402_1005Metric; LCSC C25744
R4, R6, R9, R45, R50, R55, R60, R65, R70, R75, R80, R83, R86, R89: 1k; R_0402_1005Metric; LCSC C11702
R7, R8: 27; R_0402_1005Metric
R11: 12k; R_0402_1005Metric
R13, R14, R16, R17, R18, R19, R20, R21, R22, R90, R93, R96, R99, R103, R106: 100k; R_0402_1005Metric
R23, R25, R27, R29: 33; R_1206_3216Metric
R24, R26, R28, R30: 10; R_0402_1005Metric
R31, R32, R37, R38: 220; R_0402_1005Metric
R33, R34, R35, R36: 22; R_0402_1005Metric
R42, R44, R47, R49, R52, R54, R57, R59, R62, R64, R67, R69, R72, R74, R77, R79: 80.6k; R_0402_1005Metric
R81, R84, R87: 5.1k; R_0402_1005Metric
R91, R94, R97, R100: 33k; R_0402_1005Metric
R92, R95, R98, R101: 39k; R_0402_1005Metric
R102, R105: 22k; R_0402_1005Metric
SW1: BOOTSEL; SW_Push_1P1T_XKB_TS-1187A; LCSC C318884
U1: AP2112K-3.3; SOT-23-5; LCSC C51118
U2: RP2350A; QFN-60-1EP_7x7mm_P0.4mm_EP3.4x3.4mm; LCSC C42411118
U3: W25Q128JVSIQ; SOIC-8_5.3x5.3mm_P1.27mm; LCSC C97521
U4: USB2514B; QFN-36-1EP_6x6mm_P0.5mm_EP3.7x3.7mm; LCSC C220679
U5: 74HC595; SOIC-16_3.9x9.9mm_P1.27mm; LCSC C5947
U6, U7, U8, U9: TLP2361; SO-5-6_4.55x3.7mm_P1.27mm; LCSC C107626
U10, U11: DAC80504; Texas_RTE0016D_WQFN-16-1EP_3x3mm_P0.5mm_EP0.8x0.8mm_Thermal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; LCSC C2862796
U12, U13, U14: OPA4197; TSSOP-14_4.4x5mm_P0.65mm; LCSC C2057327
Y1: 12MHz; Crystal_SMD_3225-4Pin_3.2x2.5mm; LCSC C20625731
Y2: 24MHz; Crystal_SMD_3225-4Pin_3.2x2.5mm; LCSC C70590

Connections:
+3V3: C2.1, C10.1, C11.1, C12.1, C13.1, C14.1, C15.1, C16.1, C17.1, C24.1, C30.1, C31.1, C32.1, C33.1, C34.1, C35.1, C36.1, C37.1, C38.1, C39.1, C40.1, C41.1, C43.1, C46.1, D4.2 (K), D5.2 (K), D6.2 (K), D7.2 (K), R1.1, R2.1, R3.2, R5.2, R10.2, R12.2, R15.2, R23.1, R25.1, R27.1, R29.1, R91.1, R94.1, R97.1, R100.1, R104.2, R107.2, U1.5 (VOUT), U2.1 (IOVDD), U2.11 (IOVDD), U2.20 (IOVDD), U2.30 (IOVDD), U2.38 (IOVDD), U2.45 (IOVDD), U2.49 (VREG_VIN), U2.53 (USB_OTP_VDD), U2.54 (QSPI_IOVDD), U3.8 (VCC), U4.5 (VDDA33), U4.10 (VDDA33), U4.15 (VDD33), U4.23 (VDD33), U4.29 (VDDA33), U4.36 (VDDA33), U5.10 (~SRCLR), U5.16 (VCC), U6.6 (VDD), U7.6 (VDD), U8.6 (VDD), U9.6 (VDD), U10.8 (GAIN), U10.9 (RSTSEL), U10.10 (REFDIV), U10.16 (VIO), U11.8 (GAIN), U11.9 (RSTSEL), U11.10 (REFDIV), U11.16 (VIO)
+5V: C1.1, C42.1, C45.1, J1.5, J4.1, J5.1, J6.1, U1.1 (VIN), U1.3 (EN), U10.7 (VDD), U11.7 (VDD)
/+12V: C3.1, C5.1, C48.1, C50.1, C52.1, J1.1, U12.4 (V+), U13.4 (V+), U14.4 (V+)
/-12V: C4.1, C6.1, C49.1, C51.1, C53.1, J1.3, U12.11 (V-), U13.11 (V-), U14.11 (V-)
/A1_DM: J5.2, U4.6 (USBDM_DN3/PRT_DIS_M3)
/A1_DP: J5.3, U4.7 (USBDP_DN3/PRT_DIS_P3)
/ADC_AVDD: C8.1, R2.2, U2.44 (ADC_AVDD)
/ATT1: J13.11, R21.1, U5.3 (QD)
/ATT2: J13.13, R22.1, U5.4 (QE)
/BOOTSEL: R6.2, SW1.1
/CLK_IN: Q1.3 (C), R104.1, U2.33 (GPIO21)
/CLK_IN_B: D8.1 (K), Q1.1 (B), R102.2, R103.1
/CLK_IN_J: J32.T, R102.1
/CLK_OUT1: U2.29 (GPIO18), U14.5 (+)
/CLK_OUT2: U2.31 (GPIO19), U14.10 (+)
/CV1_J: J17.T, R45.2
/CV2_J: J18.T, R50.2
/CV3_J: J19.T, R55.2
/CV4_J: J20.T, R60.2
/CV5_J: J21.T, R65.2
/CV6_J: J22.T, R70.2
/CV7_J: J23.T, R75.2
/CV8_J: J24.T, R80.2
/CVI1_J: J28.T, R90.1
/CVI2_J: J29.T, R93.1
/CVI3_J: J30.T, R96.1
/CVI4_J: J31.T, R99.1
/CVIN1: C55.1, D4.3 (COM), R90.2, R91.2, R92.1, U2.40 (GPIO26/ADC0)
/CVIN2: C56.1, D5.3 (COM), R93.2, R94.2, R95.1, U2.41 (GPIO27/ADC1)
/CVIN3: C57.1, D6.3 (COM), R96.2, R97.2, R98.1, U2.42 (GPIO28/ADC2)
/CVIN4: C58.1, D7.3 (COM), R99.2, R100.2, R101.1, U2.43 (GPIO29/ADC3)
/CVN1: R43.2, R44.1, U12.6 (-)
/CVN2: R48.2, R49.1, U12.9 (-)
/CVN3: R53.2, R54.1, U12.13 (-)
/CVN4: R58.2, R59.1, U13.2 (-)
/CVN5: R63.2, R64.1, U13.6 (-)
/CVN6: R68.2, R69.1, U13.9 (-)
/CVN7: R73.2, R74.1, U13.13 (-)
/CVN8: R78.2, R79.1, U14.2 (-)
/CVO1: R44.2, R45.1, U12.7
/CVO2: R49.2, R50.1, U12.8
/CVO3: R54.2, R55.1, U12.14
/CVO4: R59.2, R60.1, U13.1
/CVO5: R64.2, R65.1, U13.7
/CVO6: R69.2, R70.1, U13.8
/CVO7: R74.2, R75.1, U13.14
/CVO8: R79.2, R80.1, U14.1
/CVP1: R41.2, R42.1, U12.5 (+)
/CVP2: R46.2, R47.1, U12.10 (+)
/CVP3: R51.2, R52.1, U12.12 (+)
/CVP4: R56.2, R57.1, U13.3 (+)
/CVP5: R61.2, R62.1, U13.5 (+)
/CVP6: R66.2, R67.1, U13.10 (+)
/CVP7: R71.2, R72.1, U13.12 (+)
/CVP8: R76.2, R77.1, U14.3 (+)
/DAC1: R41.1, U10.2 (OUT0)
/DAC2: R46.1, U10.3 (OUT1)
/DAC3: R51.1, U10.4 (OUT2)
/DAC4: R56.1, U10.5 (OUT3)
/DAC5: R61.1, U11.2 (OUT0)
/DAC6: R66.1, U11.3 (OUT1)
/DAC7: R71.1, U11.4 (OUT2)
/DAC8: R76.1, U11.5 (OUT3)
/DAC_CS1: U2.27 (GPIO16), U10.12 (~CS)
/DAC_CS2: U2.28 (GPIO17), U11.12 (~CS)
/DAC_REF1: C44.1, R39.1, U10.1 (REF)
/DAC_REF2: C47.1, U11.1 (REF)
/DAC_SCK: U2.18 (GPIO14), U5.11 (SRCLK), U10.13 (SCLK), U11.13 (SCLK)
/DAC_SDI: U2.19 (GPIO15), U5.14 (SER), U10.14 (SDI), U11.14 (SDI)
/DVDD: C9.1, C18.1, C19.1, C20.1, L1.2, U2.6 (DVDD), U2.23 (DVDD), U2.39 (DVDD), U2.50 (VREG_FB)
/HUB_CRFILT: C25.1, U4.14 (CRFILT)
/HUB_OCS: R10.1, U4.13 (OCS_N1), U4.17 (OCS_N2), U4.19 (OCS_N3), U4.21 (OCS_N4)
/HUB_PLLFILT: C26.1, U4.34 (PLLFILT)
/HUB_RBIAS: R11.1, U4.35 (RBIAS)
/HUB_RESET: C29.1, R12.1, U4.26 (RESET_N)
/HUB_VBUSDET: R13.2, R14.1, U4.27 (VBUS_DET)
/HUB_XI: C27.1, U4.33 (XTALIN/CLKIN), Y2.1
/HUB_XO: C28.1, U4.32 (XTALOUT), Y2.3
/LED_K: D1.2 (A), R9.2
/MCU_DM: R7.2, U4.1 (USBDM_DN1/PRT_DIS_M1)
/MCU_DM_R: R7.1, U2.51 (USB_DM)
/MCU_DP: R8.2, U4.2 (USBDP_DN1/PRT_DIS_P1)
/MCU_DP_R: R8.1, U2.52 (USB_DP)
/MI1_4: J11.1, R31.1
/MI1_5: D2.2 (A), J11.2, U6.3 (K)
/MI1_A: D2.1 (K), R31.2, U6.1 (A)
/MI2_4: J12.1, R32.1
/MI2_5: D3.2 (A), J12.2, U7.3 (K)
/MI2_A: D3.1 (K), R32.2, U7.1 (A)
/MIDI_RX1: U2.7 (GPIO4), U6.5 (VO)
/MIDI_RX2: U2.8 (GPIO5), U7.5 (VO)
/MIDI_TX1: R24.1, U2.2 (GPIO0)
/MIDI_TX2: R26.1, U2.3 (GPIO1)
/MIDI_TX3: R28.1, U2.4 (GPIO2)
/MIDI_TX4: R30.1, U2.5 (GPIO3)
/MO1_4: J7.1, R23.2
/MO1_5: J7.2, R24.2
/MO2_4: J8.1, R25.2
/MO2_5: J8.2, R26.2
/MO3_4: J9.1, R27.2
/MO3_5: J9.2, R28.2
/MO4_4: J10.1, R29.2
/MO4_5: J10.2, R30.2
/MUTE: J13.7, R20.1, U2.16 (GPIO12)
/P2_DM: J4.2, U4.3 (USBDM_DN2/PRT_DIS_M2)
/P2_DP: J4.3, U4.4 (USBDP_DN2/PRT_DIS_P2)
/PH48_1: J13.1, R17.1, U5.15 (QA)
/PH48_2: J13.3, R18.1, U5.1 (QB)
/PHONO: J13.5, R19.1, U5.2 (QC)
/QSPI_SCLK: U2.56 (QSPI_SCLK), U3.6 (CLK)
/QSPI_SD0: U2.57 (QSPI_SD0), U3.5 (DI/IO_{0})
/QSPI_SD1: U2.59 (QSPI_SD1), U3.2 (DO/IO_{1})
/QSPI_SD2: U2.58 (QSPI_SD2), U3.3 (~WP/IO_{2})
/QSPI_SD3: U2.55 (QSPI_SD3), U3.7 (~HOLD/~RESET/IO_{3})
/QSPI_SS: R5.1, R6.1, U2.60 (~QSPI_SS), U3.1 (~CS)
/R2_OK: J13.9, R9.1, U2.17 (GPIO13)
/REFBUF: R43.1, R48.1, R53.1, R58.1, R63.1, R68.1, R73.1, R78.1, U12.1, U12.2 (-)
/REFHALF: C54.1, R39.2, R40.1, U12.3 (+)
/RST_IN: Q2.3 (C), R107.1, U2.34 (GPIO22)
/RST_IN_B: D9.1 (K), Q2.1 (B), R105.2, R106.1
/RST_IN_J: J33.T, R105.1
/RST_OUT: U2.32 (GPIO20), U14.12 (+)
/RUN: C21.1, R3.1, U2.26 (RUN)
/SO1_J: J25.T, R83.2
/SO1_N: R81.2, R82.1, U14.6 (-)
/SO1_O: R81.1, R83.1, U14.7
/SO2_J: J26.T, R86.2
/SO2_N: R84.2, R85.1, U14.9 (-)
/SO2_O: R84.1, R86.1, U14.8
/SO3_J: J27.T, R89.2
/SO3_N: R87.2, R88.1, U14.13 (-)
/SO3_O: R87.1, R89.1, U14.14
/SP_DM: J6.2, U4.8 (USBDM_DN4/PRT_DIS_M4)
/SP_DP: J6.3, U4.9 (USBDP_DN4/PRT_DIS_P4)
/SWCLK: J2.1, U2.24 (SWCLK)
/SWDIO: J2.2, U2.25 (SWDIO)
/TIA_A: R37.2, U8.1 (A)
/TIB_A: R38.2, U9.1 (A)
/TI_R: J16.R, R38.1, U8.3 (K)
/TI_T: J16.T, R37.1, U9.3 (K)
/TO1_R: J14.R, R34.2
/TO1_T: J14.T, R33.2
/TO2_R: J15.R, R36.2
/TO2_T: J15.T, R35.2
/TRS1_R: R34.1, U2.10 (GPIO7)
/TRS1_T: R33.1, U2.9 (GPIO6)
/TRS2_R: R36.1, U2.13 (GPIO9)
/TRS2_T: R35.1, U2.12 (GPIO8)
/TRSIN_A: U2.14 (GPIO10), U8.5 (VO)
/TRSIN_B: U2.15 (GPIO11), U9.5 (VO)
/UP_DM: J3.2, U4.30 (USBDM_UP)
/UP_DP: J3.3, U4.31 (USBDP_UP)
/UP_VBUS: J3.1, R13.1
/VREG_AVDD: C7.1, R1.2, U2.46 (VREG_AVDD)
/VREG_LX: L1.1, U2.48 (VREG_LX)
/XIN: C22.1, U2.21 (XIN), Y1.1
/XOUT: R4.1, U2.22 (XOUT)
/XR_LATCH: R16.1, U2.35 (GPIO23), U5.12 (RCLK)
/XR_OE: R15.1, U2.36 (GPIO24), U5.13 (~OE)
/XTAL_O: C23.1, R4.2, Y1.3
GND: C1.2, C2.2, C3.2, C4.2, C5.2, C6.2, C7.2, C8.2, C9.2, C10.2, C11.2, C12.2, C13.2, C14.2, C15.2, C16.2, C17.2, C18.2, C19.2, C20.2, C21.2, C22.2, C23.2, C24.2, C25.2, C26.2, C27.2, C28.2, C29.2, C30.2, C31.2, C32.2, C33.2, C34.2, C35.2, C36.2, C37.2, C38.2, C39.2, C40.2, C41.2, C42.2, C43.2, C44.2, C45.2, C46.2, C47.2, C48.2, C49.2, C50.2, C51.2, C52.2, C53.2, C54.2, C55.2, C56.2, C57.2, C58.2, D1.1 (K), D4.1 (A), D5.1 (A), D6.1 (A), D7.1 (A), D8.2 (A), D9.2 (A), J1.2, J1.4, J2.3, J3.4, J4.4, J5.4, J6.4, J7.3, J8.3, J9.3, J10.3, J13.2, J13.4, J13.6, J13.8, J13.10, J13.12, J13.14, J14.S, J15.S, J16.S, J17.S, J18.S, J19.S, J20.S, J21.S, J22.S, J23.S, J24.S, J25.S, J26.S, J27.S, J28.S, J29.S, J30.S, J31.S, J32.S, J33.S, Q1.2 (E), Q2.2 (E), R11.2, R14.2, R16.2, R17.2, R18.2, R19.2, R20.2, R21.2, R22.2, R40.2, R42.2, R47.2, R52.2, R57.2, R62.2, R67.2, R72.2, R77.2, R82.2, R85.2, R88.2, R92.2, R95.2, R98.2, R101.2, R103.2, R106.2, SW1.2, U1.2 (GND), U2.47 (VREG_PGND), U2.61 (GND), U3.4 (GND), U4.11 (TEST), U4.37 (VSS), U5.8 (GND), U6.4 (GND), U7.4 (GND), U8.4 (GND), U9.4 (GND), U10.6 (GND), U10.11 (~LDAC), U10.17 (EP), U11.6 (GND), U11.11 (~LDAC), U11.17 (EP), Y1.2 (G), Y1.4 (G), Y2.2 (G), Y2.4 (G)

Notes on the sheet:
RP2350 (R85): MIDI DIN 2 in / 4 out, TRS 1 in / 2 out (A/B in firmware), 8 CV/Gate +-10 V (2 x DAC80504), 4 CV in, sync 3 out / 2 in; USB2514B hub: up = Mini-ITX, down = RP2350, panel P2, A1 port A, spare
Power from PW: +5 V, +-12 V; MIDI DIN, USB, LAN and DC are panel parts on nuts (R141); DIN by cable to J PH headers
Control to A1/R1: PH48_1, PH48_2, PHONO, MUTE (relays, R137), R2_OK - all pulled low while the RP2350 boots
Rev 0.4: jack positions = 3D model of panel v7 (R142, tools/rear_panel.py v3); placed, not routed

Board: 4 copper layers, 234 parts (207 on the bottom side), 161 nets, no tracks yet.
