MitjaGrecky/Shtuka-druka/hardware/m1-screen-knobs/m1-screen-knobs.kicad_pcb

## KiCad design hardware/m1-screen-knobs/m1-screen-knobs.kicad_pcb (2026-11-14)

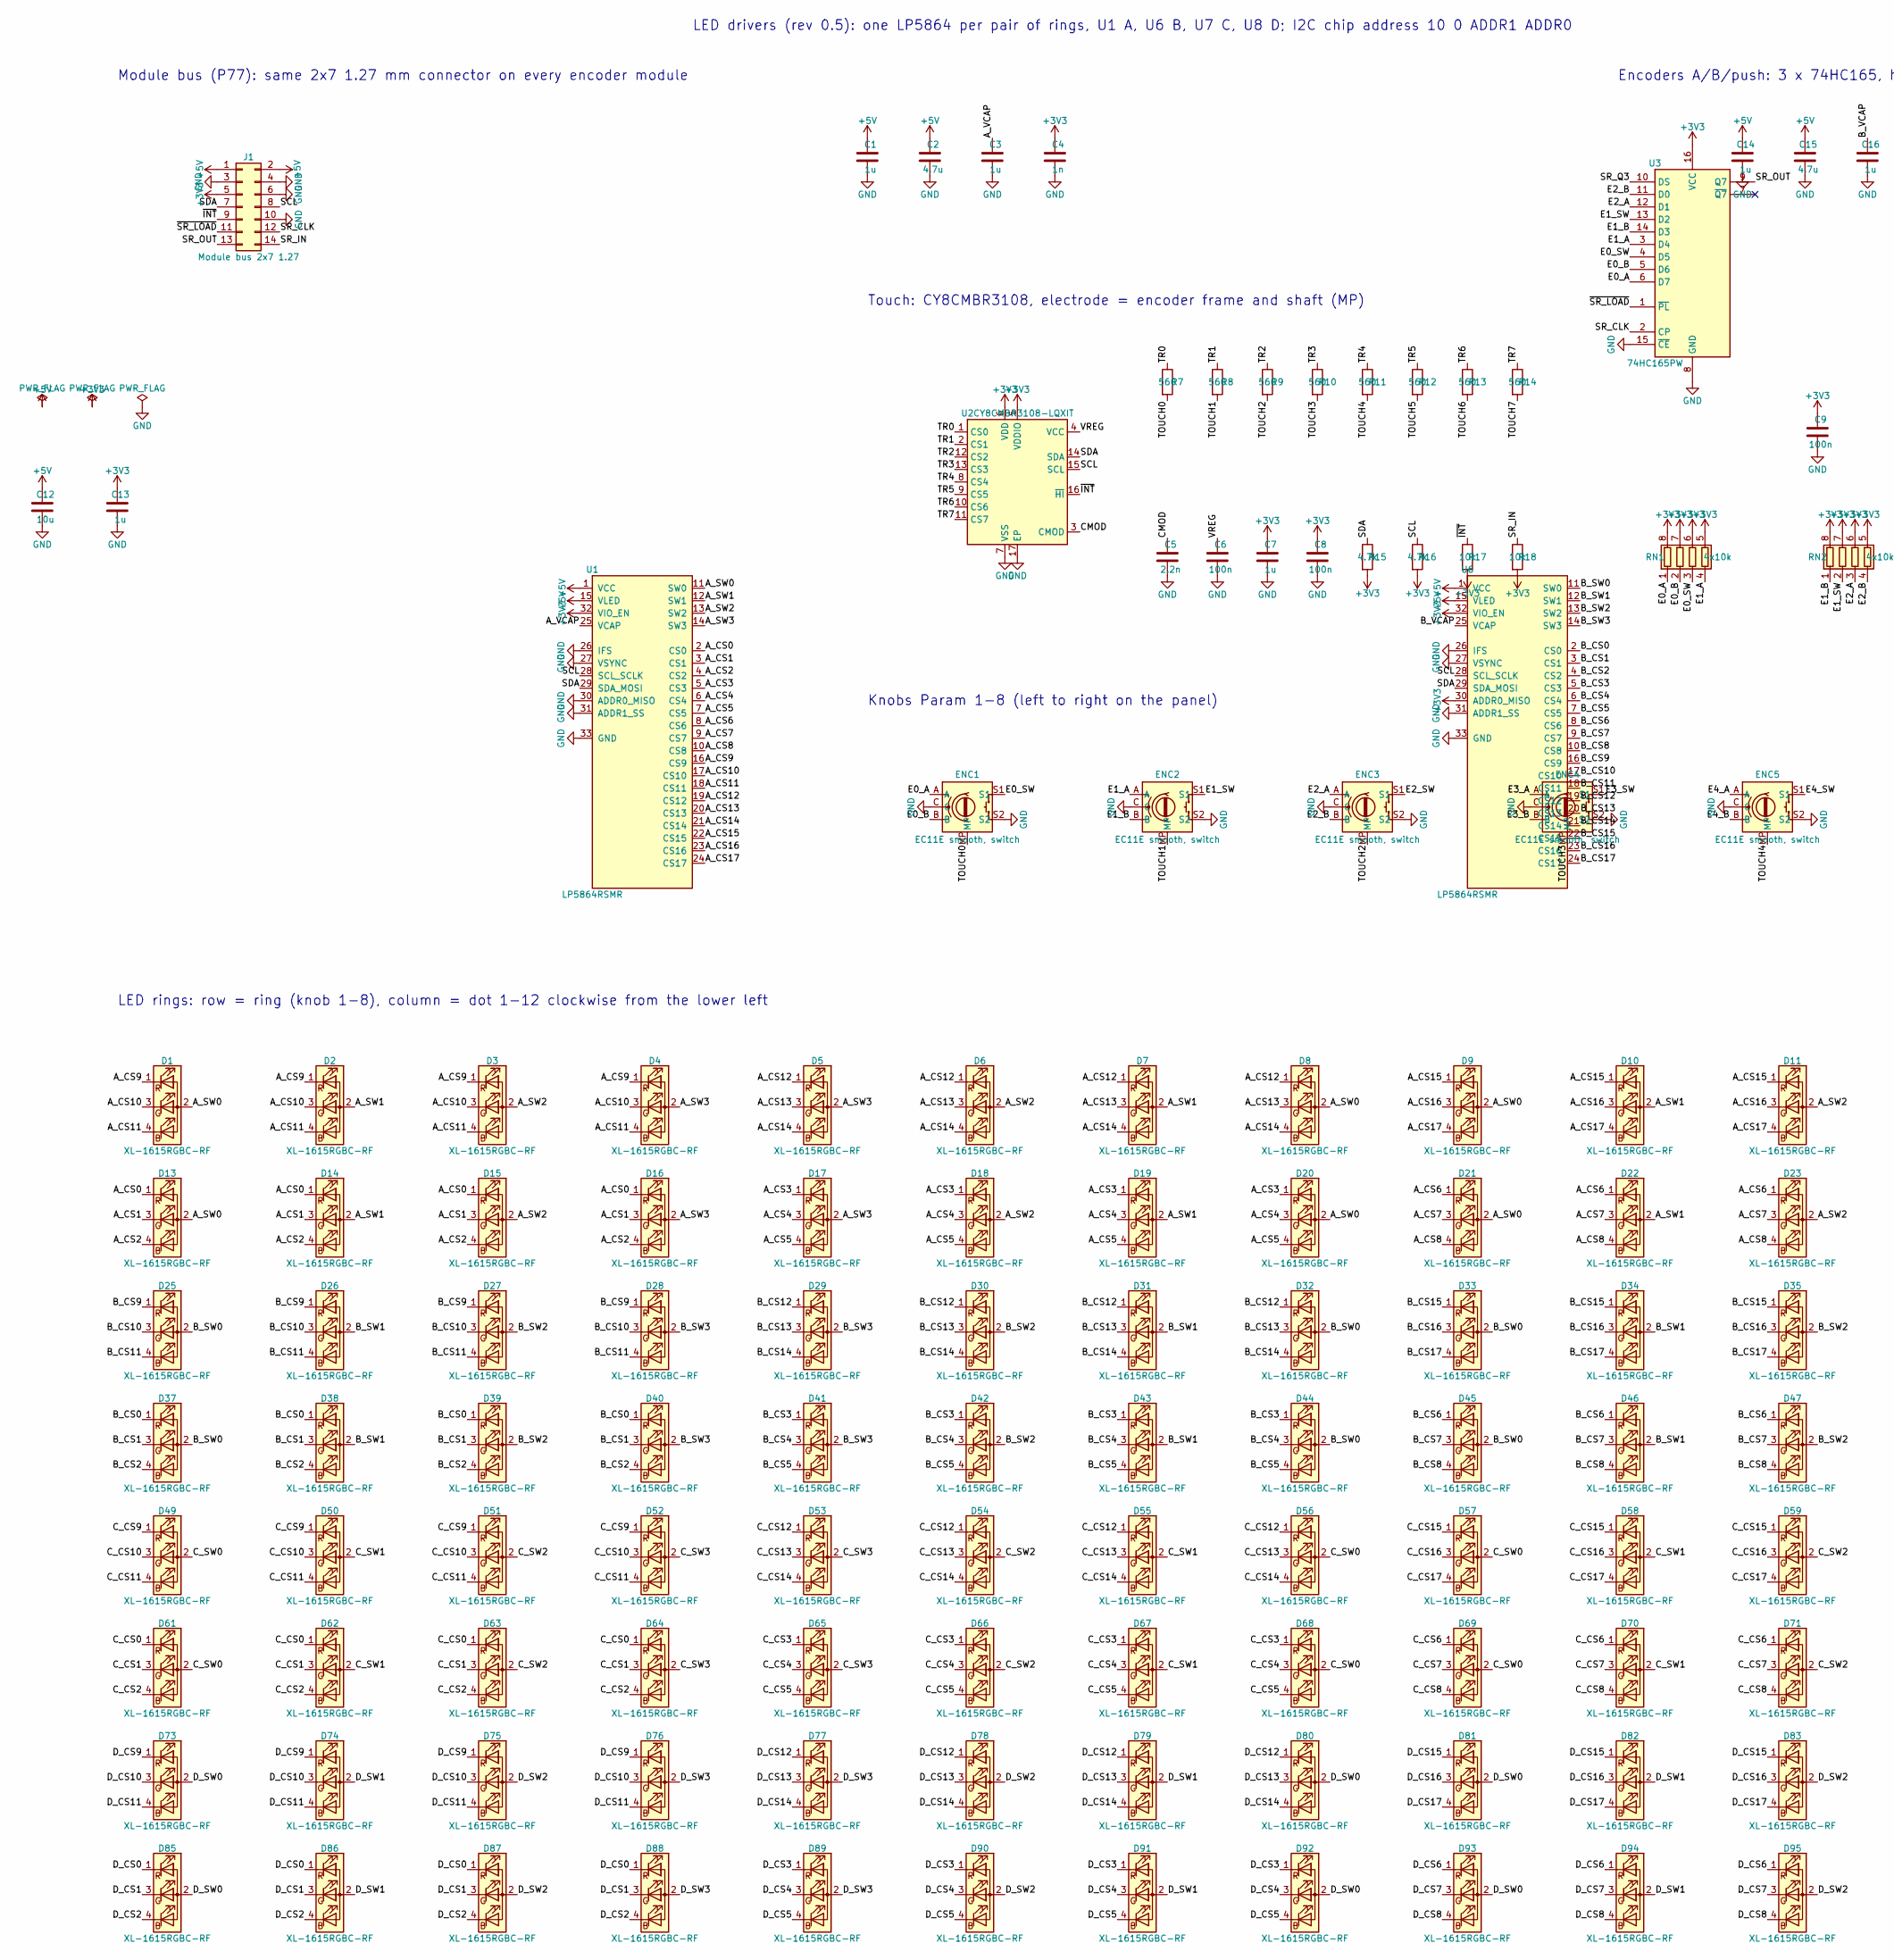
[picture p73: schematic m1-screen-knobs.kicad_sch, M1 - screen knobs module (8 encoders, touch, 12-LED RGB rin…, part in row 1, column 1]

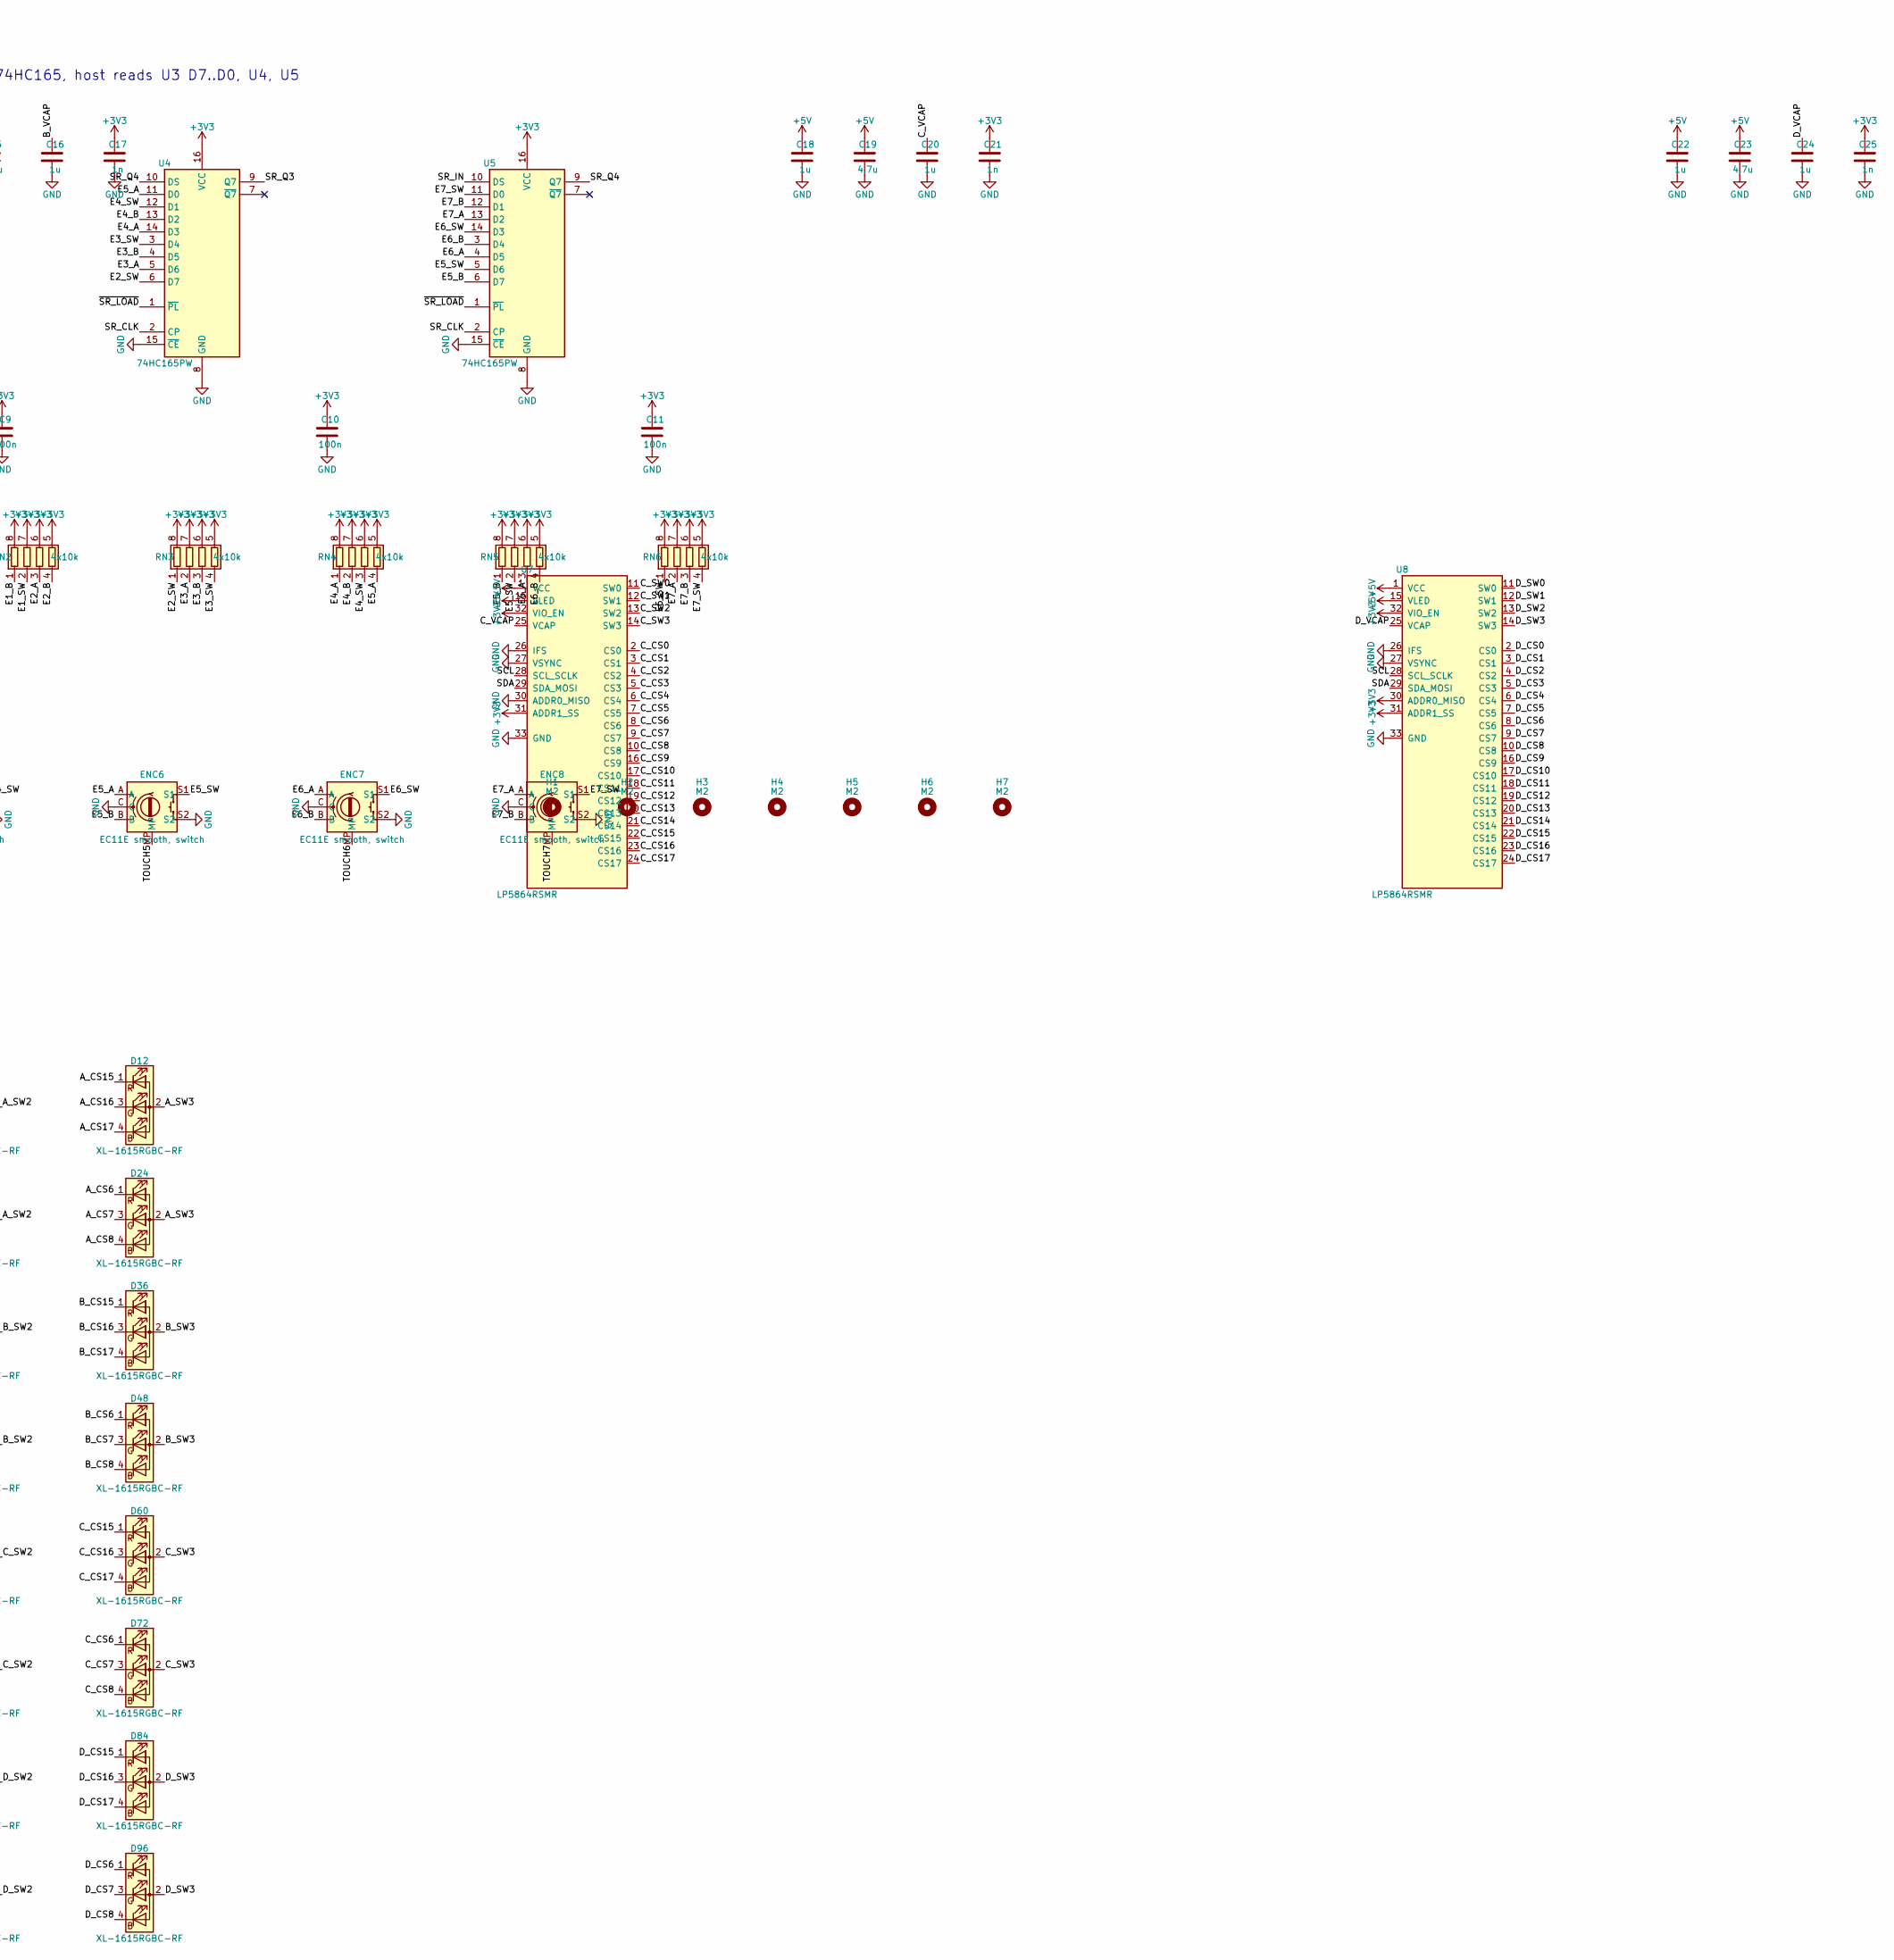
[picture p74: schematic m1-screen-knobs.kicad_sch, M1 - screen knobs module (8 encoders, touch, 12-LED RGB rin…, part in row 1, column 2]

Parts:
C1, C3, C7, C13, C14, C16, C18, C20, C22, C24: 1u; C_0402_1005Metric
C2, C15, C19, C23: 4.7u; C_0805_2012Metric
C4, C17, C21, C25: 1n; C_0402_1005Metric
C5: 2.2n; C_0402_1005Metric
C6, C8, C9, C10, C11: 100n; C_0402_1005Metric
C12: 10u; C_0805_2012Metric
D1, D2, D3, D4, D5, D6, D7, D8, D9, D10, D11, D12, D13, D14, D15, D16, D17, D18, D19, D20, D21, D22, D23, D24, D25, D26, D27, D28, D29, D30, D31, D32, D33, D34, D35, D36, D37, D38, D39, D40, D41, D42, D43, D44, D45, D46, D47, D48, D49, D50, D51, D52, D53, D54, D55, D56, D57, D58, D59, D60, D61, D62, D63, D64, D65, D66, D67, D68, D69, D70, D71, D72, D73, D74, D75, D76, D77, D78, D79, D80, D81, D82, D83, D84, D85, D86, D87, D88, D89, D90, D91, D92, D93, D94, D95, D96: XL-1615RGBC-RF; LED_RGB_XL-1615RGBC_1.6x1.5mm; LCSC C965840
ENC1, ENC2, ENC3, ENC4, ENC5, ENC6, ENC7, ENC8: EC11E smooth, switch; RotaryEncoder_Alps_EC11E-Switch_Vertical_H20mm_Ring
H1, H2, H3, H4, H5, H6, H7: M2; MountingHole_2.2mm_M2
J1: Module bus 2x7 1.27; PinHeader_2x07_P1.27mm_Vertical
R7, R8, R9, R10, R11, R12, R13, R14: 560; R_0402_1005Metric
R15, R16: 4.7k; R_0402_1005Metric
R17, R18: 10k; R_0402_1005Metric
RN1, RN2, RN3, RN4, RN5, RN6: 4x10k; R_Array_Convex_4x0402
U1, U6, U7, U8: LP5864RSMR; VQFN-32-1EP_4x4mm_P0.4mm_EP2.8x2.8mm; LCSC C5220564
U2: CY8CMBR3108-LQXIT; QFN-16-1EP_3x3mm_P0.5mm_EP1.7x1.7mm; LCSC C462528
U3, U4, U5: 74HC165PW; TSSOP-16_4.4x5mm_P0.65mm

Connections:
+3V3: C4.1, C7.1, C8.1, C9.1, C10.1, C11.1, C13.1, C17.1, C21.1, C25.1, J1.5, R15.2, R16.2, R17.2, R18.2, RN1.5 (R4.2), RN1.6 (R3.2), RN1.7 (R2.2), RN1.8 (R1.2), RN2.5 (R4.2), RN2.6 (R3.2), RN2.7 (R2.2), RN2.8 (R1.2), RN3.5 (R4.2), RN3.6 (R3.2), RN3.7 (R2.2), RN3.8 (R1.2), RN4.5 (R4.2), RN4.6 (R3.2), RN4.7 (R2.2), RN4.8 (R1.2), RN5.5 (R4.2), RN5.6 (R3.2), RN5.7 (R2.2), RN5.8 (R1.2), RN6.5 (R4.2), RN6.6 (R3.2), RN6.7 (R2.2), RN6.8 (R1.2), U1.32 (VIO_EN), U2.5 (VDDIO), U2.6 (VDD), U3.16 (VCC), U4.16 (VCC), U5.16 (VCC), U6.30 (ADDR0_MISO), U6.32 (VIO_EN), U7.31 (ADDR1_SS), U7.32 (VIO_EN), U8.30 (ADDR0_MISO), U8.31 (ADDR1_SS), U8.32 (VIO_EN)
+5V: C1.1, C2.1, C12.1, C14.1, C15.1, C18.1, C19.1, C22.1, C23.1, J1.1, J1.2, U1.1 (VCC), U1.15 (VLED), U6.1 (VCC), U6.15 (VLED), U7.1 (VCC), U7.15 (VLED), U8.1 (VCC), U8.15 (VLED)
/A_CS0: D13.1 (RK), D14.1 (RK), D15.1 (RK), D16.1 (RK), U1.2 (CS0)
/A_CS1: D13.3 (GK), D14.3 (GK), D15.3 (GK), D16.3 (GK), U1.3 (CS1)
/A_CS2: D13.4 (BK), D14.4 (BK), D15.4 (BK), D16.4 (BK), U1.4 (CS2)
/A_CS3: D17.1 (RK), D18.1 (RK), D19.1 (RK), D20.1 (RK), U1.5 (CS3)
/A_CS4: D17.3 (GK), D18.3 (GK), D19.3 (GK), D20.3 (GK), U1.6 (CS4)
/A_CS5: D17.4 (BK), D18.4 (BK), D19.4 (BK), D20.4 (BK), U1.7 (CS5)
/A_CS6: D21.1 (RK), D22.1 (RK), D23.1 (RK), D24.1 (RK), U1.8 (CS6)
/A_CS7: D21.3 (GK), D22.3 (GK), D23.3 (GK), D24.3 (GK), U1.9 (CS7)
/A_CS8: D21.4 (BK), D22.4 (BK), D23.4 (BK), D24.4 (BK), U1.10 (CS8)
/A_CS9: D1.1 (RK), D2.1 (RK), D3.1 (RK), D4.1 (RK), U1.16 (CS9)
/A_CS10: D1.3 (GK), D2.3 (GK), D3.3 (GK), D4.3 (GK), U1.17 (CS10)
/A_CS11: D1.4 (BK), D2.4 (BK), D3.4 (BK), D4.4 (BK), U1.18 (CS11)
/A_CS12: D5.1 (RK), D6.1 (RK), D7.1 (RK), D8.1 (RK), U1.19 (CS12)
/A_CS13: D5.3 (GK), D6.3 (GK), D7.3 (GK), D8.3 (GK), U1.20 (CS13)
/A_CS14: D5.4 (BK), D6.4 (BK), D7.4 (BK), D8.4 (BK), U1.21 (CS14)
/A_CS15: D9.1 (RK), D10.1 (RK), D11.1 (RK), D12.1 (RK), U1.22 (CS15)
/A_CS16: D9.3 (GK), D10.3 (GK), D11.3 (GK), D12.3 (GK), U1.23 (CS16)
/A_CS17: D9.4 (BK), D10.4 (BK), D11.4 (BK), D12.4 (BK), U1.24 (CS17)
/A_SW0: D1.2 (A), D8.2 (A), D9.2 (A), D13.2 (A), D20.2 (A), D21.2 (A), U1.11 (SW0)
/A_SW1: D2.2 (A), D7.2 (A), D10.2 (A), D14.2 (A), D19.2 (A), D22.2 (A), U1.12 (SW1)
/A_SW2: D3.2 (A), D6.2 (A), D11.2 (A), D15.2 (A), D18.2 (A), D23.2 (A), U1.13 (SW2)
/A_SW3: D4.2 (A), D5.2 (A), D12.2 (A), D16.2 (A), D17.2 (A), D24.2 (A), U1.14 (SW3)
/A_VCAP: C3.1, U1.25 (VCAP)
/B_CS0: D37.1 (RK), D38.1 (RK), D39.1 (RK), D40.1 (RK), U6.2 (CS0)
/B_CS1: D37.3 (GK), D38.3 (GK), D39.3 (GK), D40.3 (GK), U6.3 (CS1)
/B_CS2: D37.4 (BK), D38.4 (BK), D39.4 (BK), D40.4 (BK), U6.4 (CS2)
/B_CS3: D41.1 (RK), D42.1 (RK), D43.1 (RK), D44.1 (RK), U6.5 (CS3)
/B_CS4: D41.3 (GK), D42.3 (GK), D43.3 (GK), D44.3 (GK), U6.6 (CS4)
/B_CS5: D41.4 (BK), D42.4 (BK), D43.4 (BK), D44.4 (BK), U6.7 (CS5)
/B_CS6: D45.1 (RK), D46.1 (RK), D47.1 (RK), D48.1 (RK), U6.8 (CS6)
/B_CS7: D45.3 (GK), D46.3 (GK), D47.3 (GK), D48.3 (GK), U6.9 (CS7)
/B_CS8: D45.4 (BK), D46.4 (BK), D47.4 (BK), D48.4 (BK), U6.10 (CS8)
/B_CS9: D25.1 (RK), D26.1 (RK), D27.1 (RK), D28.1 (RK), U6.16 (CS9)
/B_CS10: D25.3 (GK), D26.3 (GK), D27.3 (GK), D28.3 (GK), U6.17 (CS10)
/B_CS11: D25.4 (BK), D26.4 (BK), D27.4 (BK), D28.4 (BK), U6.18 (CS11)
/B_CS12: D29.1 (RK), D30.1 (RK), D31.1 (RK), D32.1 (RK), U6.19 (CS12)
/B_CS13: D29.3 (GK), D30.3 (GK), D31.3 (GK), D32.3 (GK), U6.20 (CS13)
/B_CS14: D29.4 (BK), D30.4 (BK), D31.4 (BK), D32.4 (BK), U6.21 (CS14)
/B_CS15: D33.1 (RK), D34.1 (RK), D35.1 (RK), D36.1 (RK), U6.22 (CS15)
/B_CS16: D33.3 (GK), D34.3 (GK), D35.3 (GK), D36.3 (GK), U6.23 (CS16)
/B_CS17: D33.4 (BK), D34.4 (BK), D35.4 (BK), D36.4 (BK), U6.24 (CS17)
/B_SW0: D25.2 (A), D32.2 (A), D33.2 (A), D37.2 (A), D44.2 (A), D45.2 (A), U6.11 (SW0)
/B_SW1: D26.2 (A), D31.2 (A), D34.2 (A), D38.2 (A), D43.2 (A), D46.2 (A), U6.12 (SW1)
/B_SW2: D27.2 (A), D30.2 (A), D35.2 (A), D39.2 (A), D42.2 (A), D47.2 (A), U6.13 (SW2)
/B_SW3: D28.2 (A), D29.2 (A), D36.2 (A), D40.2 (A), D41.2 (A), D48.2 (A), U6.14 (SW3)
/B_VCAP: C16.1, U6.25 (VCAP)
/CMOD: C5.1, U2.3 (CMOD)
/C_CS0: D61.1 (RK), D62.1 (RK), D63.1 (RK), D64.1 (RK), U7.2 (CS0)
/C_CS1: D61.3 (GK), D62.3 (GK), D63.3 (GK), D64.3 (GK), U7.3 (CS1)
/C_CS2: D61.4 (BK), D62.4 (BK), D63.4 (BK), D64.4 (BK), U7.4 (CS2)
/C_CS3: D65.1 (RK), D66.1 (RK), D67.1 (RK), D68.1 (RK), U7.5 (CS3)
/C_CS4: D65.3 (GK), D66.3 (GK), D67.3 (GK), D68.3 (GK), U7.6 (CS4)
/C_CS5: D65.4 (BK), D66.4 (BK), D67.4 (BK), D68.4 (BK), U7.7 (CS5)
/C_CS6: D69.1 (RK), D70.1 (RK), D71.1 (RK), D72.1 (RK), U7.8 (CS6)
/C_CS7: D69.3 (GK), D70.3 (GK), D71.3 (GK), D72.3 (GK), U7.9 (CS7)
/C_CS8: D69.4 (BK), D70.4 (BK), D71.4 (BK), D72.4 (BK), U7.10 (CS8)
/C_CS9: D49.1 (RK), D50.1 (RK), D51.1 (RK), D52.1 (RK), U7.16 (CS9)
/C_CS10: D49.3 (GK), D50.3 (GK), D51.3 (GK), D52.3 (GK), U7.17 (CS10)
/C_CS11: D49.4 (BK), D50.4 (BK), D51.4 (BK), D52.4 (BK), U7.18 (CS11)
/C_CS12: D53.1 (RK), D54.1 (RK), D55.1 (RK), D56.1 (RK), U7.19 (CS12)
/C_CS13: D53.3 (GK), D54.3 (GK), D55.3 (GK), D56.3 (GK), U7.20 (CS13)
/C_CS14: D53.4 (BK), D54.4 (BK), D55.4 (BK), D56.4 (BK), U7.21 (CS14)
/C_CS15: D57.1 (RK), D58.1 (RK), D59.1 (RK), D60.1 (RK), U7.22 (CS15)
/C_CS16: D57.3 (GK), D58.3 (GK), D59.3 (GK), D60.3 (GK), U7.23 (CS16)
/C_CS17: D57.4 (BK), D58.4 (BK), D59.4 (BK), D60.4 (BK), U7.24 (CS17)
/C_SW0: D49.2 (A), D56.2 (A), D57.2 (A), D61.2 (A), D68.2 (A), D69.2 (A), U7.11 (SW0)
/C_SW1: D50.2 (A), D55.2 (A), D58.2 (A), D62.2 (A), D67.2 (A), D70.2 (A), U7.12 (SW1)
/C_SW2: D51.2 (A), D54.2 (A), D59.2 (A), D63.2 (A), D66.2 (A), D71.2 (A), U7.13 (SW2)
/C_SW3: D52.2 (A), D53.2 (A), D60.2 (A), D64.2 (A), D65.2 (A), D72.2 (A), U7.14 (SW3)
/C_VCAP: C20.1, U7.25 (VCAP)
/D_CS0: D85.1 (RK), D86.1 (RK), D87.1 (RK), D88.1 (RK), U8.2 (CS0)
/D_CS1: D85.3 (GK), D86.3 (GK), D87.3 (GK), D88.3 (GK), U8.3 (CS1)
/D_CS2: D85.4 (BK), D86.4 (BK), D87.4 (BK), D88.4 (BK), U8.4 (CS2)
/D_CS3: D89.1 (RK), D90.1 (RK), D91.1 (RK), D92.1 (RK), U8.5 (CS3)
/D_CS4: D89.3 (GK), D90.3 (GK), D91.3 (GK), D92.3 (GK), U8.6 (CS4)
/D_CS5: D89.4 (BK), D90.4 (BK), D91.4 (BK), D92.4 (BK), U8.7 (CS5)
/D_CS6: D93.1 (RK), D94.1 (RK), D95.1 (RK), D96.1 (RK), U8.8 (CS6)
/D_CS7: D93.3 (GK), D94.3 (GK), D95.3 (GK), D96.3 (GK), U8.9 (CS7)
/D_CS8: D93.4 (BK), D94.4 (BK), D95.4 (BK), D96.4 (BK), U8.10 (CS8)
/D_CS9: D73.1 (RK), D74.1 (RK), D75.1 (RK), D76.1 (RK), U8.16 (CS9)
/D_CS10: D73.3 (GK), D74.3 (GK), D75.3 (GK), D76.3 (GK), U8.17 (CS10)
/D_CS11: D73.4 (BK), D74.4 (BK), D75.4 (BK), D76.4 (BK), U8.18 (CS11)
/D_CS12: D77.1 (RK), D78.1 (RK), D79.1 (RK), D80.1 (RK), U8.19 (CS12)
/D_CS13: D77.3 (GK), D78.3 (GK), D79.3 (GK), D80.3 (GK), U8.20 (CS13)
/D_CS14: D77.4 (BK), D78.4 (BK), D79.4 (BK), D80.4 (BK), U8.21 (CS14)
/D_CS15: D81.1 (RK), D82.1 (RK), D83.1 (RK), D84.1 (RK), U8.22 (CS15)
/D_CS16: D81.3 (GK), D82.3 (GK), D83.3 (GK), D84.3 (GK), U8.23 (CS16)
/D_CS17: D81.4 (BK), D82.4 (BK), D83.4 (BK), D84.4 (BK), U8.24 (CS17)
/D_SW0: D73.2 (A), D80.2 (A), D81.2 (A), D85.2 (A), D92.2 (A), D93.2 (A), U8.11 (SW0)
/D_SW1: D74.2 (A), D79.2 (A), D82.2 (A), D86.2 (A), D91.2 (A), D94.2 (A), U8.12 (SW1)
/D_SW2: D75.2 (A), D78.2 (A), D83.2 (A), D87.2 (A), D90.2 (A), D95.2 (A), U8.13 (SW2)
/D_SW3: D76.2 (A), D77.2 (A), D84.2 (A), D88.2 (A), D89.2 (A), D96.2 (A), U8.14 (SW3)
/D_VCAP: C24.1, U8.25 (VCAP)
/E0_A: ENC1.A, RN1.1 (R1.1), U3.6 (D7)
/E0_B: ENC1.B, RN1.2 (R2.1), U3.5 (D6)
/E0_SW: ENC1.S1, RN1.3 (R3.1), U3.4 (D5)
/E1_A: ENC2.A, RN1.4 (R4.1), U3.3 (D4)
/E1_B: ENC2.B, RN2.1 (R1.1), U3.14 (D3)
/E1_SW: ENC2.S1, RN2.2 (R2.1), U3.13 (D2)
/E2_A: ENC3.A, RN2.3 (R3.1), U3.12 (D1)
/E2_B: ENC3.B, RN2.4 (R4.1), U3.11 (D0)
/E2_SW: ENC3.S1, RN3.1 (R1.1), U4.6 (D7)
/E3_A: ENC4.A, RN3.2 (R2.1), U4.5 (D6)
/E3_B: ENC4.B, RN3.3 (R3.1), U4.4 (D5)
/E3_SW: ENC4.S1, RN3.4 (R4.1), U4.3 (D4)
/E4_A: ENC5.A, RN4.1 (R1.1), U4.14 (D3)
/E4_B: ENC5.B, RN4.2 (R2.1), U4.13 (D2)
/E4_SW: ENC5.S1, RN4.3 (R3.1), U4.12 (D1)
/E5_A: ENC6.A, RN4.4 (R4.1), U4.11 (D0)
/E5_B: ENC6.B, RN5.1 (R1.1), U5.6 (D7)
/E5_SW: ENC6.S1, RN5.2 (R2.1), U5.5 (D6)
/E6_A: ENC7.A, RN5.3 (R3.1), U5.4 (D5)
/E6_B: ENC7.B, RN5.4 (R4.1), U5.3 (D4)
/E6_SW: ENC7.S1, RN6.1 (R1.1), U5.14 (D3)
/E7_A: ENC8.A, RN6.2 (R2.1), U5.13 (D2)
/E7_B: ENC8.B, RN6.3 (R3.1), U5.12 (D1)
/E7_SW: ENC8.S1, RN6.4 (R4.1), U5.11 (D0)
/SCL: J1.8, R16.1, U1.28 (SCL_SCLK), U2.15 (SCL), U6.28 (SCL_SCLK), U7.28 (SCL_SCLK), U8.28 (SCL_SCLK)
/SDA: J1.7, R15.1, U1.29 (SDA_MOSI), U2.14 (SDA), U6.29 (SDA_MOSI), U7.29 (SDA_MOSI), U8.29 (SDA_MOSI)
/SR_CLK: J1.12, U3.2 (CP), U4.2 (CP), U5.2 (CP)
/SR_IN: J1.14, R18.1, U5.10 (DS)
/SR_OUT: J1.13, U3.9 (Q7)
/SR_Q3: U3.10 (DS), U4.9 (Q7)
/SR_Q4: U4.10 (DS), U5.9 (Q7)
/TOUCH0: ENC1.MP, R7.2
/TOUCH1: ENC2.MP, R8.2
/TOUCH2: ENC3.MP, R9.2
/TOUCH3: ENC4.MP, R10.2
/TOUCH4: ENC5.MP, R11.2
/TOUCH5: ENC6.MP, R12.2
/TOUCH6: ENC7.MP, R13.2
/TOUCH7: ENC8.MP, R14.2
/TR0: R7.1, U2.1 (CS0)
/TR1: R8.1, U2.2 (CS1)
/TR2: R9.1, U2.12 (CS2)
/TR3: R10.1, U2.13 (CS3)
/TR4: R11.1, U2.8 (CS4)
/TR5: R12.1, U2.9 (CS5)
/TR6: R13.1, U2.10 (CS6)
/TR7: R14.1, U2.11 (CS7)
/VREG: C6.1, U2.4 (VCC)
/~INT: J1.9, R17.1, U2.16 (~HI)
/~SR_LOAD: J1.11, U3.1 (~PL), U4.1 (~PL), U5.1 (~PL)
GND: C1.2, C2.2, C3.2, C4.2, C5.2, C6.2, C7.2, C8.2, C9.2, C10.2, C11.2, C12.2, C13.2, C14.2, C15.2, C16.2, C17.2, C18.2, C19.2, C20.2, C21.2, C22.2, C23.2, C24.2, C25.2, ENC1.C, ENC1.S2, ENC2.C, ENC2.S2, ENC3.C, ENC3.S2, ENC4.C, ENC4.S2, ENC5.C, ENC5.S2, ENC6.C, ENC6.S2, ENC7.C, ENC7.S2, ENC8.C, ENC8.S2, J1.3, J1.4, J1.6, J1.10, U1.26 (IFS), U1.27 (VSYNC), U1.30 (ADDR0_MISO), U1.31 (ADDR1_SS), U1.33 (GND), U2.7 (VSS), U2.17 (EP), U3.8 (GND), U3.15 (~CE), U4.8 (GND), U4.15 (~CE), U5.8 (GND), U5.15 (~CE), U6.26 (IFS), U6.27 (VSYNC), U6.31 (ADDR1_SS), U6.33 (GND), U7.26 (IFS), U7.27 (VSYNC), U7.30 (ADDR0_MISO), U7.33 (GND), U8.26 (IFS), U8.27 (VSYNC), U8.33 (GND)

Notes on the sheet:
Module bus (P77): same 2x7 1.27 mm connector on every encoder module
LED drivers (rev 0.5): one LP5864 per pair of rings, U1 A, U6 B, U7 C, U8 D; I2C chip address 10 0 ADDR1 ADDR0
Touch: CY8CMBR3108, electrode = encoder frame and shaft (MP)
Encoders A/B/push: 3 x 74HC165, host reads U3 D7..D0, U4, U5
Knobs Param 1-8 (left to right on the panel)
LED rings: row = ring (knob 1-8), column = dot 1-12 clockwise from the lower left

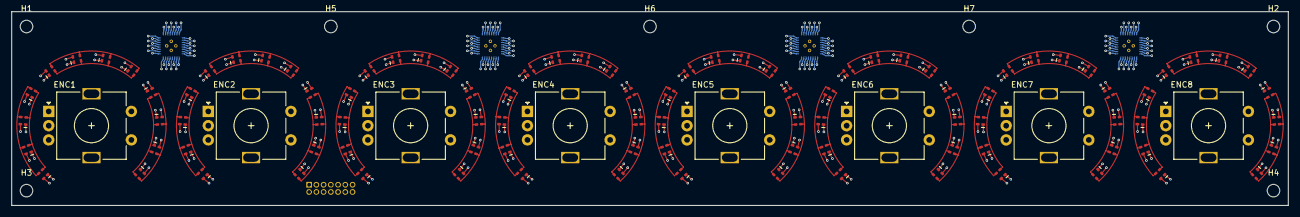
[picture p75: board m1-screen-knobs.kicad_pcb from above]

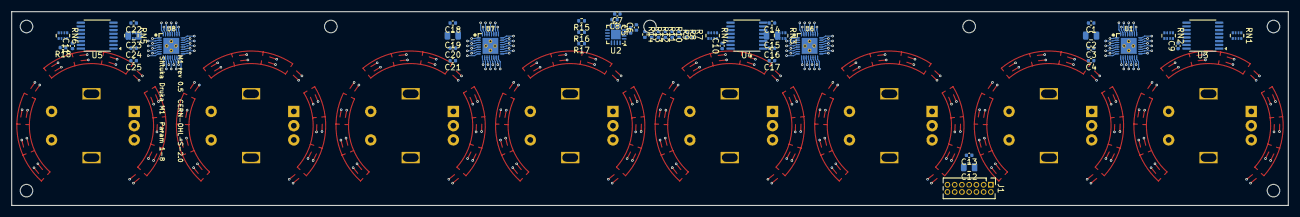
[picture p76: board m1-screen-knobs.kicad_pcb from below]

Board: 4 copper layers, 224.0 x 34.0 mm, 163 parts (52 on the bottom side), 146 nets.
