MitjaGrecky/Shtuka-druka/hardware/p3-tracks/p3-tracks.kicad_pcb

## KiCad design hardware/p3-tracks/p3-tracks.kicad_pcb (2026-11-13)

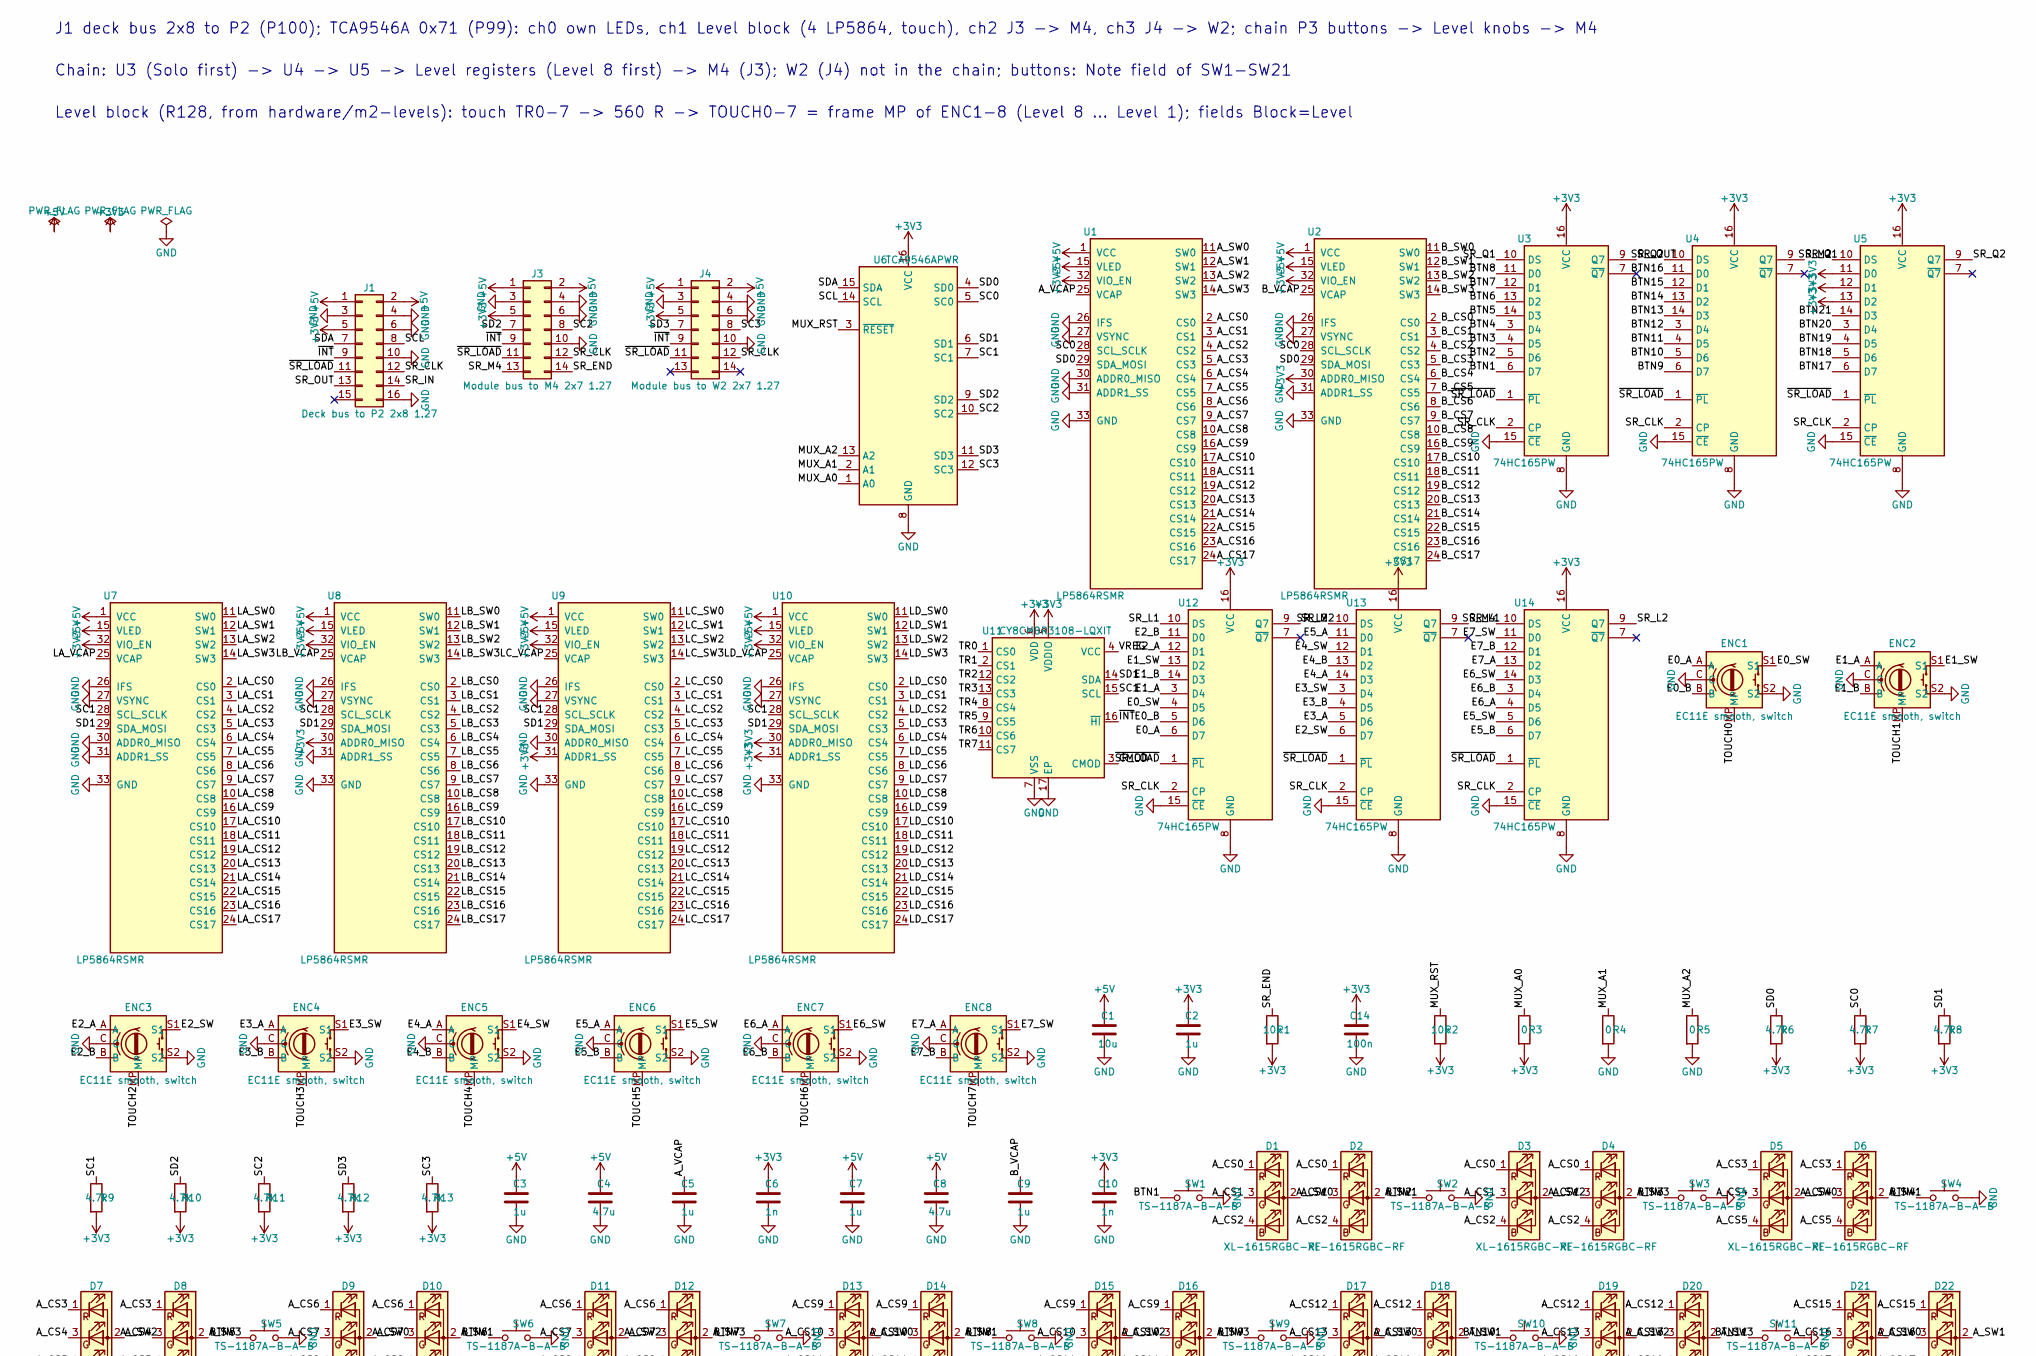
[picture p77: schematic p3-tracks.kicad_sch, P3 - Tracks deck + Level knobs: 21 buttons with 2 RGB, 8 en…, part in row 1, column 1]

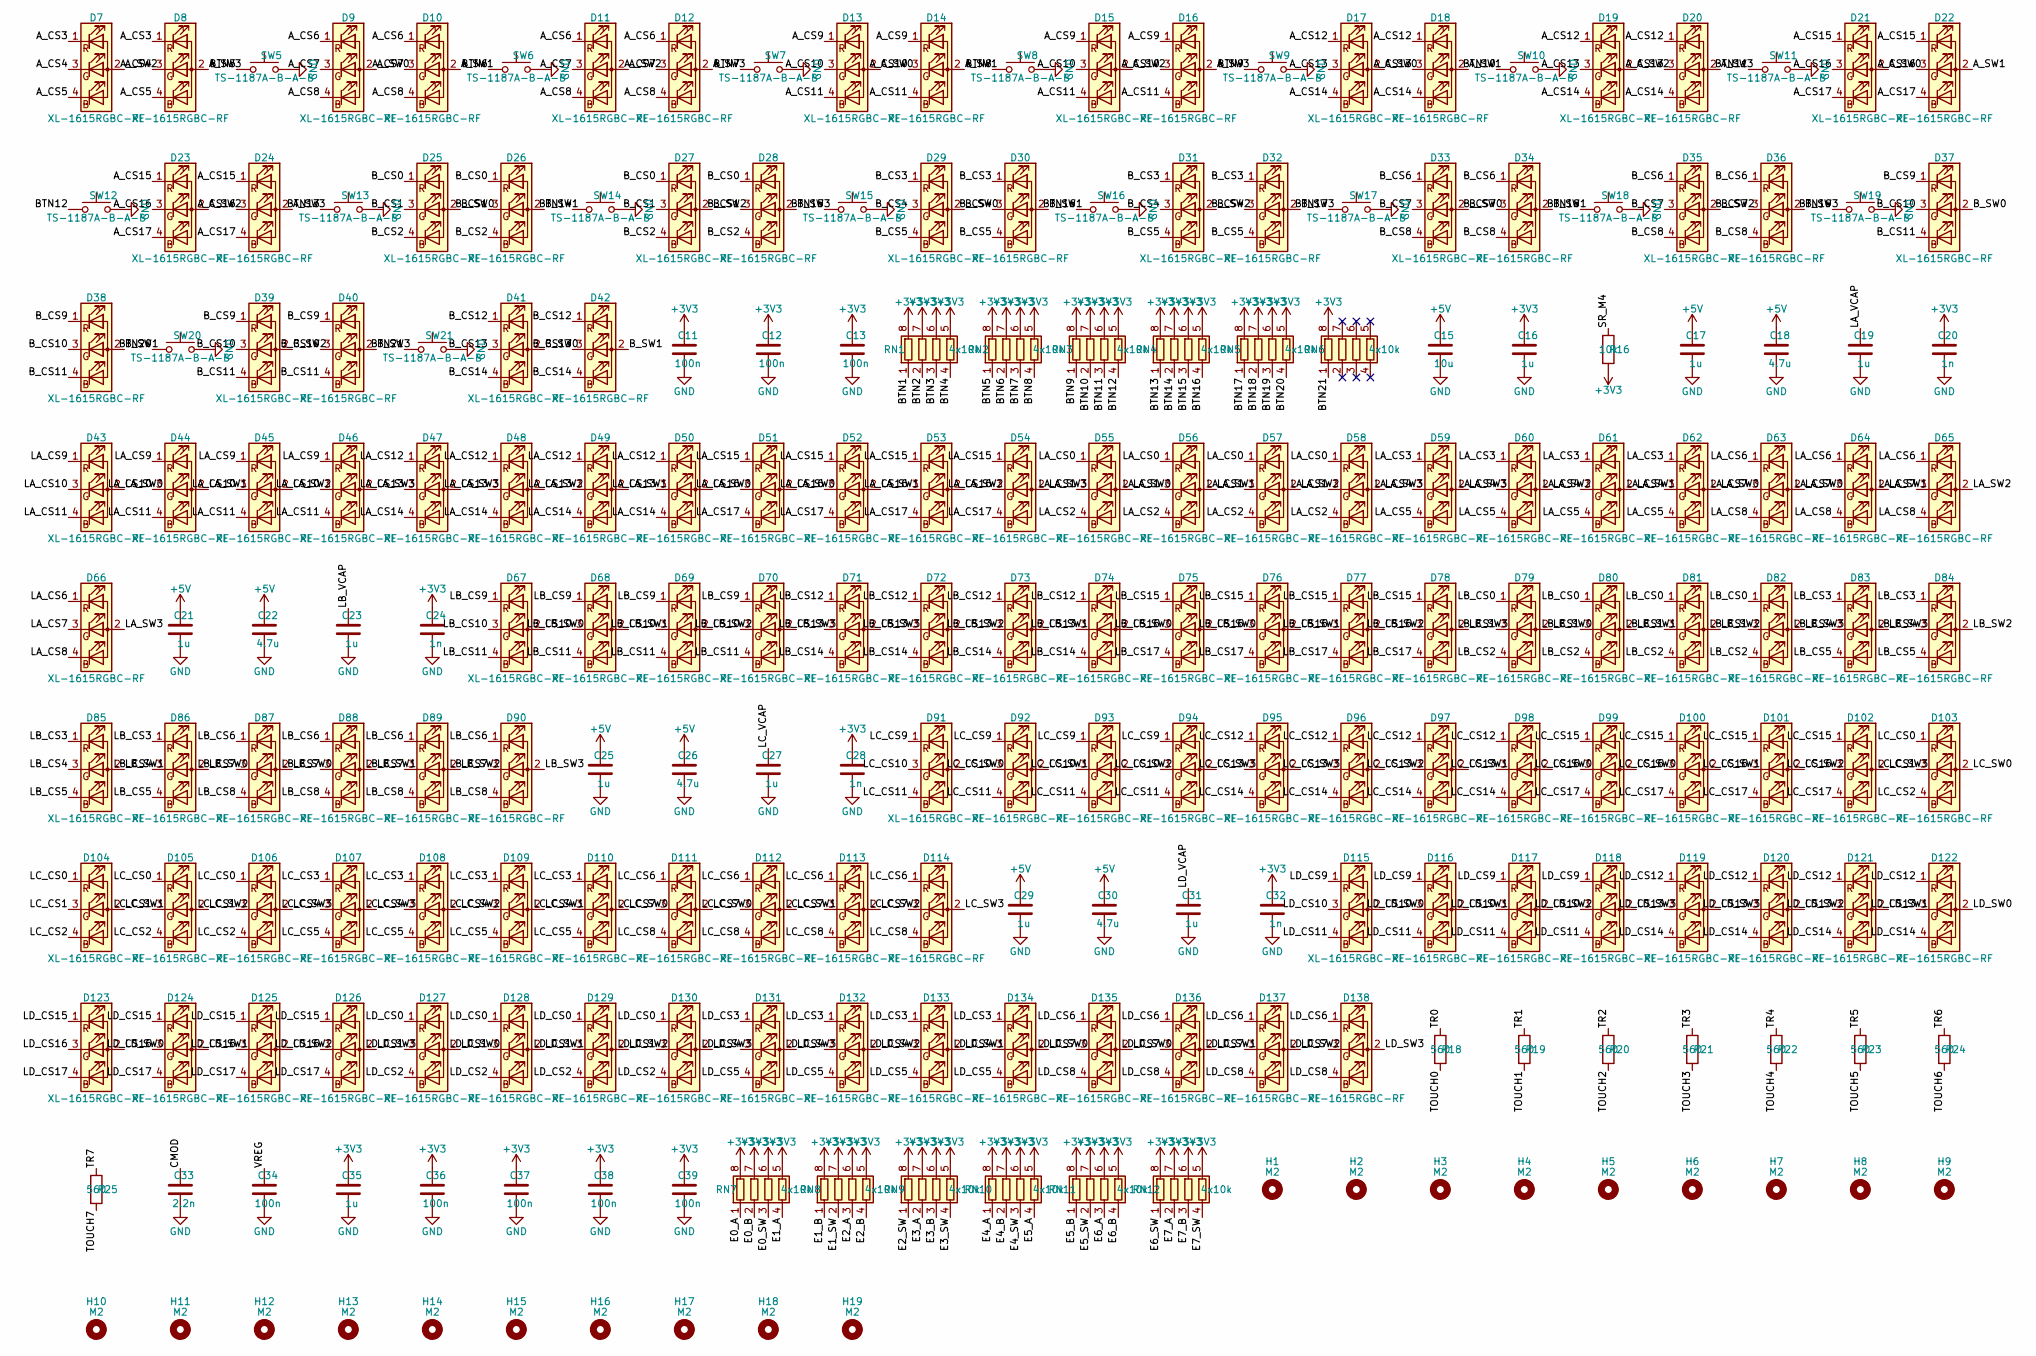
[picture p78: schematic p3-tracks.kicad_sch, P3 - Tracks deck + Level knobs: 21 buttons with 2 RGB, 8 en…, part in row 2, column 1]

Parts:
C1, C15: 10u; C_0805_2012Metric; LCSC C15850
C2, C3, C5, C7, C9, C16, C17, C19, C21, C23, C25, C27, C29, C31, C35: 1u; C_0402_1005Metric; LCSC C52923
C4, C8, C18, C22, C26, C30: 4.7u; C_0805_2012Metric; LCSC C1779
C6, C10, C20, C24, C28, C32: 1n; C_0402_1005Metric; LCSC C1523
C11, C12, C13, C14, C34, C36, C37, C38, C39: 100n; C_0402_1005Metric; LCSC C1525
C33: 2.2n; C_0402_1005Metric; LCSC C1531
D1, D2, D3, D4, D5, D6, D7, D8, D9, D10, D11, D12, D13, D14, D15, D16, D17, D18, D19, D20, D21, D22, D23, D24, D25, D26, D27, D28, D29, D30, D31, D32, D33, D34, D35, D36, D37, D38, D39, D40, D41, D42, D43, D44, D45, D46, D47, D48, D49, D50, D51, D52, D53, D54, D55, D56, D57, D58, D59, D60, D61, D62, D63, D64, D65, D66, D67, D68, D69, D70, D71, D72, D73, D74, D75, D76, D77, D78, D79, D80, D81, D82, D83, D84, D85, D86, D87, D88, D89, D90, D91, D92, D93, D94, D95, D96, D97, D98, D99, D100, D101, D102, D103, D104, D105, D106, D107, D108, D109, D110, D111, D112, D113, D114, D115, D116, D117, D118, D119, D120, D121, D122, D123, D124, D125, D126, D127, D128, D129, D130, D131, D132, D133, D134, D135, D136, D137, D138: XL-1615RGBC-RF; LED_RGB_XL-1615RGBC_1.6x1.5mm; LCSC C965840
ENC1, ENC2, ENC3, ENC4, ENC5, ENC6, ENC7, ENC8: EC11E smooth, switch; RotaryEncoder_Alps_EC11E-Switch_Vertical_H20mm_Ring; LCSC C361165
H1, H2, H3, H4, H5, H6, H7, H8, H9, H10, H11, H12, H13, H14, H15, H16, H17, H18, H19: M2; MountingHole_2.2mm_M2
J1: Deck bus to P2 2x8 1.27; PinHeader_2x08_P1.27mm_Vertical; LCSC C5372812
J3: Module bus to M4 2x7 1.27; PinHeader_2x07_P1.27mm_Vertical; LCSC C5372811
J4: Module bus to W2 2x7 1.27; PinHeader_2x07_P1.27mm_Vertical; LCSC C5372811
R1, R2, R16: 10k; R_0402_1005Metric; LCSC C25744
R3, R4, R5: 0; R_0402_1005Metric; LCSC C17168
R6, R7, R8, R9, R10, R11, R12, R13: 4.7k; R_0402_1005Metric; LCSC C25900
R18, R19, R20, R21, R22, R23, R24, R25: 560; R_0402_1005Metric; LCSC C25126
RN1, RN2, RN3, RN4, RN5, RN6, RN7, RN8, RN9, RN10, RN11, RN12: 4x10k; R_Array_Convex_4x0402; LCSC C25725
SW1, SW2, SW3, SW4, SW5, SW6, SW7, SW8, SW9, SW10, SW11, SW12, SW13, SW14, SW15, SW16, SW17, SW18, SW19, SW20, SW21: TS-1187A-B-A-B; SW_Push_1P1T_XKB_TS-1187A; LCSC C318884
U1, U2, U7, U8, U9, U10: LP5864RSMR; VQFN-32-1EP_4x4mm_P0.4mm_EP2.8x2.8mm; LCSC C5220564
U3, U4, U5, U12, U13, U14: 74HC165PW; TSSOP-16_4.4x5mm_P0.65mm; LCSC C80696
U6: TCA9546APWR; TSSOP-16_4.4x5mm_P0.65mm; LCSC C201653
U11: CY8CMBR3108-LQXIT; QFN-16-1EP_3x3mm_P0.5mm_EP1.7x1.7mm; LCSC C462528

Connections:
+3V3: C2.1, C6.1, C10.1, C11.1, C12.1, C13.1, C14.1, C16.1, C20.1, C24.1, C28.1, C32.1, C35.1, C36.1, C37.1, C38.1, C39.1, J1.5, J3.5, J4.5, R1.2, R2.2, R3.2, R6.2, R7.2, R8.2, R9.2, R10.2, R11.2, R12.2, R13.2, R16.2, RN1.5 (R4.2), RN1.6 (R3.2), RN1.7 (R2.2), RN1.8 (R1.2), RN2.5 (R4.2), RN2.6 (R3.2), RN2.7 (R2.2), RN2.8 (R1.2), RN3.5 (R4.2), RN3.6 (R3.2), RN3.7 (R2.2), RN3.8 (R1.2), RN4.5 (R4.2), RN4.6 (R3.2), RN4.7 (R2.2), RN4.8 (R1.2), RN5.5 (R4.2), RN5.6 (R3.2), RN5.7 (R2.2), RN5.8 (R1.2), RN6.8 (R1.2), RN7.5 (R4.2), RN7.6 (R3.2), RN7.7 (R2.2), RN7.8 (R1.2), RN8.5 (R4.2), RN8.6 (R3.2), RN8.7 (R2.2), RN8.8 (R1.2), RN9.5 (R4.2), RN9.6 (R3.2), RN9.7 (R2.2), RN9.8 (R1.2), RN10.5 (R4.2), RN10.6 (R3.2), RN10.7 (R2.2), RN10.8 (R1.2), RN11.5 (R4.2), RN11.6 (R3.2), RN11.7 (R2.2), RN11.8 (R1.2), RN12.5 (R4.2), RN12.6 (R3.2), RN12.7 (R2.2), RN12.8 (R1.2), U1.32 (VIO_EN), U2.30 (ADDR0_MISO), U2.32 (VIO_EN), U3.16 (VCC), U4.16 (VCC), U5.11 (D0), U5.12 (D1), U5.13 (D2), U5.16 (VCC), U6.16 (VCC), U7.32 (VIO_EN), U8.30 (ADDR0_MISO), U8.32 (VIO_EN), U9.31 (ADDR1_SS), U9.32 (VIO_EN), U10.30 (ADDR0_MISO), U10.31 (ADDR1_SS), U10.32 (VIO_EN), U11.5 (VDDIO), U11.6 (VDD), U12.16 (VCC), U13.16 (VCC), U14.16 (VCC)
+5V: C1.1, C3.1, C4.1, C7.1, C8.1, C15.1, C17.1, C18.1, C21.1, C22.1, C25.1, C26.1, C29.1, C30.1, J1.1, J1.2, J3.1, J3.2, J4.1, J4.2, U1.1 (VCC), U1.15 (VLED), U2.1 (VCC), U2.15 (VLED), U7.1 (VCC), U7.15 (VLED), U8.1 (VCC), U8.15 (VLED), U9.1 (VCC), U9.15 (VLED), U10.1 (VCC), U10.15 (VLED)
/A_CS0: D1.1 (RK), D2.1 (RK), D3.1 (RK), D4.1 (RK), U1.2 (CS0)
/A_CS1: D1.3 (GK), D2.3 (GK), D3.3 (GK), D4.3 (GK), U1.3 (CS1)
/A_CS2: D1.4 (BK), D2.4 (BK), D3.4 (BK), D4.4 (BK), U1.4 (CS2)
/A_CS3: D5.1 (RK), D6.1 (RK), D7.1 (RK), D8.1 (RK), U1.5 (CS3)
/A_CS4: D5.3 (GK), D6.3 (GK), D7.3 (GK), D8.3 (GK), U1.6 (CS4)
/A_CS5: D5.4 (BK), D6.4 (BK), D7.4 (BK), D8.4 (BK), U1.7 (CS5)
/A_CS6: D9.1 (RK), D10.1 (RK), D11.1 (RK), D12.1 (RK), U1.8 (CS6)
/A_CS7: D9.3 (GK), D10.3 (GK), D11.3 (GK), D12.3 (GK), U1.9 (CS7)
/A_CS8: D9.4 (BK), D10.4 (BK), D11.4 (BK), D12.4 (BK), U1.10 (CS8)
/A_CS9: D13.1 (RK), D14.1 (RK), D15.1 (RK), D16.1 (RK), U1.16 (CS9)
/A_CS10: D13.3 (GK), D14.3 (GK), D15.3 (GK), D16.3 (GK), U1.17 (CS10)
/A_CS11: D13.4 (BK), D14.4 (BK), D15.4 (BK), D16.4 (BK), U1.18 (CS11)
/A_CS12: D17.1 (RK), D18.1 (RK), D19.1 (RK), D20.1 (RK), U1.19 (CS12)
/A_CS13: D17.3 (GK), D18.3 (GK), D19.3 (GK), D20.3 (GK), U1.20 (CS13)
/A_CS14: D17.4 (BK), D18.4 (BK), D19.4 (BK), D20.4 (BK), U1.21 (CS14)
/A_CS15: D21.1 (RK), D22.1 (RK), D23.1 (RK), D24.1 (RK), U1.22 (CS15)
/A_CS16: D21.3 (GK), D22.3 (GK), D23.3 (GK), D24.3 (GK), U1.23 (CS16)
/A_CS17: D21.4 (BK), D22.4 (BK), D23.4 (BK), D24.4 (BK), U1.24 (CS17)
/A_SW0: D1.2 (A), D5.2 (A), D9.2 (A), D13.2 (A), D17.2 (A), D21.2 (A), U1.11 (SW0)
/A_SW1: D2.2 (A), D6.2 (A), D10.2 (A), D14.2 (A), D18.2 (A), D22.2 (A), U1.12 (SW1)
/A_SW2: D3.2 (A), D7.2 (A), D11.2 (A), D15.2 (A), D19.2 (A), D23.2 (A), U1.13 (SW2)
/A_SW3: D4.2 (A), D8.2 (A), D12.2 (A), D16.2 (A), D20.2 (A), D24.2 (A), U1.14 (SW3)
/A_VCAP: C5.1, U1.25 (VCAP)
/BTN1: RN1.1 (R1.1), SW1.1, U3.6 (D7)
/BTN2: RN1.2 (R2.1), SW2.1, U3.5 (D6)
/BTN3: RN1.3 (R3.1), SW3.1, U3.4 (D5)
/BTN4: RN1.4 (R4.1), SW4.1, U3.3 (D4)
/BTN5: RN2.1 (R1.1), SW5.1, U3.14 (D3)
/BTN6: RN2.2 (R2.1), SW6.1, U3.13 (D2)
/BTN7: RN2.3 (R3.1), SW7.1, U3.12 (D1)
/BTN8: RN2.4 (R4.1), SW8.1, U3.11 (D0)
/BTN9: RN3.1 (R1.1), SW9.1, U4.6 (D7)
/BTN10: RN3.2 (R2.1), SW10.1, U4.5 (D6)
/BTN11: RN3.3 (R3.1), SW11.1, U4.4 (D5)
/BTN12: RN3.4 (R4.1), SW12.1, U4.3 (D4)
/BTN13: RN4.1 (R1.1), SW13.1, U4.14 (D3)
/BTN14: RN4.2 (R2.1), SW14.1, U4.13 (D2)
/BTN15: RN4.3 (R3.1), SW15.1, U4.12 (D1)
/BTN16: RN4.4 (R4.1), SW16.1, U4.11 (D0)
/BTN17: RN5.1 (R1.1), SW17.1, U5.6 (D7)
/BTN18: RN5.2 (R2.1), SW18.1, U5.5 (D6)
/BTN19: RN5.3 (R3.1), SW19.1, U5.4 (D5)
/BTN20: RN5.4 (R4.1), SW20.1, U5.3 (D4)
/BTN21: RN6.1 (R1.1), SW21.1, U5.14 (D3)
/B_CS0: D25.1 (RK), D26.1 (RK), D27.1 (RK), D28.1 (RK), U2.2 (CS0)
/B_CS1: D25.3 (GK), D26.3 (GK), D27.3 (GK), D28.3 (GK), U2.3 (CS1)
/B_CS2: D25.4 (BK), D26.4 (BK), D27.4 (BK), D28.4 (BK), U2.4 (CS2)
/B_CS3: D29.1 (RK), D30.1 (RK), D31.1 (RK), D32.1 (RK), U2.5 (CS3)
/B_CS4: D29.3 (GK), D30.3 (GK), D31.3 (GK), D32.3 (GK), U2.6 (CS4)
/B_CS5: D29.4 (BK), D30.4 (BK), D31.4 (BK), D32.4 (BK), U2.7 (CS5)
/B_CS6: D33.1 (RK), D34.1 (RK), D35.1 (RK), D36.1 (RK), U2.8 (CS6)
/B_CS7: D33.3 (GK), D34.3 (GK), D35.3 (GK), D36.3 (GK), U2.9 (CS7)
/B_CS8: D33.4 (BK), D34.4 (BK), D35.4 (BK), D36.4 (BK), U2.10 (CS8)
/B_CS9: D37.1 (RK), D38.1 (RK), D39.1 (RK), D40.1 (RK), U2.16 (CS9)
/B_CS10: D37.3 (GK), D38.3 (GK), D39.3 (GK), D40.3 (GK), U2.17 (CS10)
/B_CS11: D37.4 (BK), D38.4 (BK), D39.4 (BK), D40.4 (BK), U2.18 (CS11)
/B_CS12: D41.1 (RK), D42.1 (RK), U2.19 (CS12)
/B_CS13: D41.3 (GK), D42.3 (GK), U2.20 (CS13)
/B_CS14: D41.4 (BK), D42.4 (BK), U2.21 (CS14)
/B_CS15: U2.22 (CS15)
/B_CS16: U2.23 (CS16)
/B_CS17: U2.24 (CS17)
/B_SW0: D25.2 (A), D29.2 (A), D33.2 (A), D37.2 (A), D41.2 (A), U2.11 (SW0)
/B_SW1: D26.2 (A), D30.2 (A), D34.2 (A), D38.2 (A), D42.2 (A), U2.12 (SW1)
/B_SW2: D27.2 (A), D31.2 (A), D35.2 (A), D39.2 (A), U2.13 (SW2)
/B_SW3: D28.2 (A), D32.2 (A), D36.2 (A), D40.2 (A), U2.14 (SW3)
/B_VCAP: C9.1, U2.25 (VCAP)
/CMOD: C33.1, U11.3 (CMOD)
/E0_A: ENC1.A, RN7.1 (R1.1), U12.6 (D7)
/E0_B: ENC1.B, RN7.2 (R2.1), U12.5 (D6)
/E0_SW: ENC1.S1, RN7.3 (R3.1), U12.4 (D5)
/E1_A: ENC2.A, RN7.4 (R4.1), U12.3 (D4)
/E1_B: ENC2.B, RN8.1 (R1.1), U12.14 (D3)
/E1_SW: ENC2.S1, RN8.2 (R2.1), U12.13 (D2)
/E2_A: ENC3.A, RN8.3 (R3.1), U12.12 (D1)
/E2_B: ENC3.B, RN8.4 (R4.1), U12.11 (D0)
/E2_SW: ENC3.S1, RN9.1 (R1.1), U13.6 (D7)
/E3_A: ENC4.A, RN9.2 (R2.1), U13.5 (D6)
/E3_B: ENC4.B, RN9.3 (R3.1), U13.4 (D5)
/E3_SW: ENC4.S1, RN9.4 (R4.1), U13.3 (D4)
/E4_A: ENC5.A, RN10.1 (R1.1), U13.14 (D3)
/E4_B: ENC5.B, RN10.2 (R2.1), U13.13 (D2)
/E4_SW: ENC5.S1, RN10.3 (R3.1), U13.12 (D1)
/E5_A: ENC6.A, RN10.4 (R4.1), U13.11 (D0)
/E5_B: ENC6.B, RN11.1 (R1.1), U14.6 (D7)
/E5_SW: ENC6.S1, RN11.2 (R2.1), U14.5 (D6)
/E6_A: ENC7.A, RN11.3 (R3.1), U14.4 (D5)
/E6_B: ENC7.B, RN11.4 (R4.1), U14.3 (D4)
/E6_SW: ENC7.S1, RN12.1 (R1.1), U14.14 (D3)
/E7_A: ENC8.A, RN12.2 (R2.1), U14.13 (D2)
/E7_B: ENC8.B, RN12.3 (R3.1), U14.12 (D1)
/E7_SW: ENC8.S1, RN12.4 (R4.1), U14.11 (D0)
/LA_CS0: D55.1 (RK), D56.1 (RK), D57.1 (RK), D58.1 (RK), U7.2 (CS0)
/LA_CS1: D55.3 (GK), D56.3 (GK), D57.3 (GK), D58.3 (GK), U7.3 (CS1)
/LA_CS2: D55.4 (BK), D56.4 (BK), D57.4 (BK), D58.4 (BK), U7.4 (CS2)
/LA_CS3: D59.1 (RK), D60.1 (RK), D61.1 (RK), D62.1 (RK), U7.5 (CS3)
/LA_CS4: D59.3 (GK), D60.3 (GK), D61.3 (GK), D62.3 (GK), U7.6 (CS4)
/LA_CS5: D59.4 (BK), D60.4 (BK), D61.4 (BK), D62.4 (BK), U7.7 (CS5)
/LA_CS6: D63.1 (RK), D64.1 (RK), D65.1 (RK), D66.1 (RK), U7.8 (CS6)
/LA_CS7: D63.3 (GK), D64.3 (GK), D65.3 (GK), D66.3 (GK), U7.9 (CS7)
/LA_CS8: D63.4 (BK), D64.4 (BK), D65.4 (BK), D66.4 (BK), U7.10 (CS8)
/LA_CS9: D43.1 (RK), D44.1 (RK), D45.1 (RK), D46.1 (RK), U7.16 (CS9)
/LA_CS10: D43.3 (GK), D44.3 (GK), D45.3 (GK), D46.3 (GK), U7.17 (CS10)
/LA_CS11: D43.4 (BK), D44.4 (BK), D45.4 (BK), D46.4 (BK), U7.18 (CS11)
/LA_CS12: D47.1 (RK), D48.1 (RK), D49.1 (RK), D50.1 (RK), U7.19 (CS12)
/LA_CS13: D47.3 (GK), D48.3 (GK), D49.3 (GK), D50.3 (GK), U7.20 (CS13)
/LA_CS14: D47.4 (BK), D48.4 (BK), D49.4 (BK), D50.4 (BK), U7.21 (CS14)
/LA_CS15: D51.1 (RK), D52.1 (RK), D53.1 (RK), D54.1 (RK), U7.22 (CS15)
/LA_CS16: D51.3 (GK), D52.3 (GK), D53.3 (GK), D54.3 (GK), U7.23 (CS16)
/LA_CS17: D51.4 (BK), D52.4 (BK), D53.4 (BK), D54.4 (BK), U7.24 (CS17)
/LA_SW0: D43.2 (A), D50.2 (A), D51.2 (A), D55.2 (A), D62.2 (A), D63.2 (A), U7.11 (SW0)
/LA_SW1: D44.2 (A), D49.2 (A), D52.2 (A), D56.2 (A), D61.2 (A), D64.2 (A), U7.12 (SW1)
/LA_SW2: D45.2 (A), D48.2 (A), D53.2 (A), D57.2 (A), D60.2 (A), D65.2 (A), U7.13 (SW2)
/LA_SW3: D46.2 (A), D47.2 (A), D54.2 (A), D58.2 (A), D59.2 (A), D66.2 (A), U7.14 (SW3)
/LA_VCAP: C19.1, U7.25 (VCAP)
/LB_CS0: D79.1 (RK), D80.1 (RK), D81.1 (RK), D82.1 (RK), U8.2 (CS0)
/LB_CS1: D79.3 (GK), D80.3 (GK), D81.3 (GK), D82.3 (GK), U8.3 (CS1)
/LB_CS2: D79.4 (BK), D80.4 (BK), D81.4 (BK), D82.4 (BK), U8.4 (CS2)
/LB_CS3: D83.1 (RK), D84.1 (RK), D85.1 (RK), D86.1 (RK), U8.5 (CS3)
/LB_CS4: D83.3 (GK), D84.3 (GK), D85.3 (GK), D86.3 (GK), U8.6 (CS4)
/LB_CS5: D83.4 (BK), D84.4 (BK), D85.4 (BK), D86.4 (BK), U8.7 (CS5)
/LB_CS6: D87.1 (RK), D88.1 (RK), D89.1 (RK), D90.1 (RK), U8.8 (CS6)
/LB_CS7: D87.3 (GK), D88.3 (GK), D89.3 (GK), D90.3 (GK), U8.9 (CS7)
/LB_CS8: D87.4 (BK), D88.4 (BK), D89.4 (BK), D90.4 (BK), U8.10 (CS8)
/LB_CS9: D67.1 (RK), D68.1 (RK), D69.1 (RK), D70.1 (RK), U8.16 (CS9)
/LB_CS10: D67.3 (GK), D68.3 (GK), D69.3 (GK), D70.3 (GK), U8.17 (CS10)
/LB_CS11: D67.4 (BK), D68.4 (BK), D69.4 (BK), D70.4 (BK), U8.18 (CS11)
/LB_CS12: D71.1 (RK), D72.1 (RK), D73.1 (RK), D74.1 (RK), U8.19 (CS12)
/LB_CS13: D71.3 (GK), D72.3 (GK), D73.3 (GK), D74.3 (GK), U8.20 (CS13)
/LB_CS14: D71.4 (BK), D72.4 (BK), D73.4 (BK), D74.4 (BK), U8.21 (CS14)
/LB_CS15: D75.1 (RK), D76.1 (RK), D77.1 (RK), D78.1 (RK), U8.22 (CS15)
/LB_CS16: D75.3 (GK), D76.3 (GK), D77.3 (GK), D78.3 (GK), U8.23 (CS16)
/LB_CS17: D75.4 (BK), D76.4 (BK), D77.4 (BK), D78.4 (BK), U8.24 (CS17)
/LB_SW0: D67.2 (A), D74.2 (A), D75.2 (A), D79.2 (A), D86.2 (A), D87.2 (A), U8.11 (SW0)
/LB_SW1: D68.2 (A), D73.2 (A), D76.2 (A), D80.2 (A), D85.2 (A), D88.2 (A), U8.12 (SW1)
/LB_SW2: D69.2 (A), D72.2 (A), D77.2 (A), D81.2 (A), D84.2 (A), D89.2 (A), U8.13 (SW2)
/LB_SW3: D70.2 (A), D71.2 (A), D78.2 (A), D82.2 (A), D83.2 (A), D90.2 (A), U8.14 (SW3)
/LB_VCAP: C23.1, U8.25 (VCAP)
/LC_CS0: D103.1 (RK), D104.1 (RK), D105.1 (RK), D106.1 (RK), U9.2 (CS0)
/LC_CS1: D103.3 (GK), D104.3 (GK), D105.3 (GK), D106.3 (GK), U9.3 (CS1)
/LC_CS2: D103.4 (BK), D104.4 (BK), D105.4 (BK), D106.4 (BK), U9.4 (CS2)
/LC_CS3: D107.1 (RK), D108.1 (RK), D109.1 (RK), D110.1 (RK), U9.5 (CS3)
/LC_CS4: D107.3 (GK), D108.3 (GK), D109.3 (GK), D110.3 (GK), U9.6 (CS4)
/LC_CS5: D107.4 (BK), D108.4 (BK), D109.4 (BK), D110.4 (BK), U9.7 (CS5)
/LC_CS6: D111.1 (RK), D112.1 (RK), D113.1 (RK), D114.1 (RK), U9.8 (CS6)
/LC_CS7: D111.3 (GK), D112.3 (GK), D113.3 (GK), D114.3 (GK), U9.9 (CS7)
/LC_CS8: D111.4 (BK), D112.4 (BK), D113.4 (BK), D114.4 (BK), U9.10 (CS8)
/LC_CS9: D91.1 (RK), D92.1 (RK), D93.1 (RK), D94.1 (RK), U9.16 (CS9)
/LC_CS10: D91.3 (GK), D92.3 (GK), D93.3 (GK), D94.3 (GK), U9.17 (CS10)
/LC_CS11: D91.4 (BK), D92.4 (BK), D93.4 (BK), D94.4 (BK), U9.18 (CS11)
/LC_CS12: D95.1 (RK), D96.1 (RK), D97.1 (RK), D98.1 (RK), U9.19 (CS12)
/LC_CS13: D95.3 (GK), D96.3 (GK), D97.3 (GK), D98.3 (GK), U9.20 (CS13)
/LC_CS14: D95.4 (BK), D96.4 (BK), D97.4 (BK), D98.4 (BK), U9.21 (CS14)
/LC_CS15: D99.1 (RK), D100.1 (RK), D101.1 (RK), D102.1 (RK), U9.22 (CS15)
/LC_CS16: D99.3 (GK), D100.3 (GK), D101.3 (GK), D102.3 (GK), U9.23 (CS16)
/LC_CS17: D99.4 (BK), D100.4 (BK), D101.4 (BK), D102.4 (BK), U9.24 (CS17)
/LC_SW0: D91.2 (A), D98.2 (A), D99.2 (A), D103.2 (A), D110.2 (A), D111.2 (A), U9.11 (SW0)
/LC_SW1: D92.2 (A), D97.2 (A), D100.2 (A), D104.2 (A), D109.2 (A), D112.2 (A), U9.12 (SW1)
/LC_SW2: D93.2 (A), D96.2 (A), D101.2 (A), D105.2 (A), D108.2 (A), D113.2 (A), U9.13 (SW2)
/LC_SW3: D94.2 (A), D95.2 (A), D102.2 (A), D106.2 (A), D107.2 (A), D114.2 (A), U9.14 (SW3)
/LC_VCAP: C27.1, U9.25 (VCAP)
/LD_CS0: D127.1 (RK), D128.1 (RK), D129.1 (RK), D130.1 (RK), U10.2 (CS0)
/LD_CS1: D127.3 (GK), D128.3 (GK), D129.3 (GK), D130.3 (GK), U10.3 (CS1)
/LD_CS2: D127.4 (BK), D128.4 (BK), D129.4 (BK), D130.4 (BK), U10.4 (CS2)
/LD_CS3: D131.1 (RK), D132.1 (RK), D133.1 (RK), D134.1 (RK), U10.5 (CS3)
/LD_CS4: D131.3 (GK), D132.3 (GK), D133.3 (GK), D134.3 (GK), U10.6 (CS4)
/LD_CS5: D131.4 (BK), D132.4 (BK), D133.4 (BK), D134.4 (BK), U10.7 (CS5)
/LD_CS6: D135.1 (RK), D136.1 (RK), D137.1 (RK), D138.1 (RK), U10.8 (CS6)
/LD_CS7: D135.3 (GK), D136.3 (GK), D137.3 (GK), D138.3 (GK), U10.9 (CS7)
/LD_CS8: D135.4 (BK), D136.4 (BK), D137.4 (BK), D138.4 (BK), U10.10 (CS8)
/LD_CS9: D115.1 (RK), D116.1 (RK), D117.1 (RK), D118.1 (RK), U10.16 (CS9)
/LD_CS10: D115.3 (GK), D116.3 (GK), D117.3 (GK), D118.3 (GK), U10.17 (CS10)
/LD_CS11: D115.4 (BK), D116.4 (BK), D117.4 (BK), D118.4 (BK), U10.18 (CS11)
/LD_CS12: D119.1 (RK), D120.1 (RK), D121.1 (RK), D122.1 (RK), U10.19 (CS12)
/LD_CS13: D119.3 (GK), D120.3 (GK), D121.3 (GK), D122.3 (GK), U10.20 (CS13)
/LD_CS14: D119.4 (BK), D120.4 (BK), D121.4 (BK), D122.4 (BK), U10.21 (CS14)
/LD_CS15: D123.1 (RK), D124.1 (RK), D125.1 (RK), D126.1 (RK), U10.22 (CS15)
/LD_CS16: D123.3 (GK), D124.3 (GK), D125.3 (GK), D126.3 (GK), U10.23 (CS16)
/LD_CS17: D123.4 (BK), D124.4 (BK), D125.4 (BK), D126.4 (BK), U10.24 (CS17)
/LD_SW0: D115.2 (A), D122.2 (A), D123.2 (A), D127.2 (A), D134.2 (A), D135.2 (A), U10.11 (SW0)
/LD_SW1: D116.2 (A), D121.2 (A), D124.2 (A), D128.2 (A), D133.2 (A), D136.2 (A), U10.12 (SW1)
/LD_SW2: D117.2 (A), D120.2 (A), D125.2 (A), D129.2 (A), D132.2 (A), D137.2 (A), U10.13 (SW2)
/LD_SW3: D118.2 (A), D119.2 (A), D126.2 (A), D130.2 (A), D131.2 (A), D138.2 (A), U10.14 (SW3)
/LD_VCAP: C31.1, U10.25 (VCAP)
/MUX_A0: R3.1, U6.1 (A0)
/MUX_A1: R4.1, U6.2 (A1)
/MUX_A2: R5.1, U6.13 (A2)
/MUX_RST: R2.1, U6.3 (~RESET)
/SC0: R7.1, U1.28 (SCL_SCLK), U2.28 (SCL_SCLK), U6.5 (SC0)
/SC1: R9.1, U6.7 (SC1), U7.28 (SCL_SCLK), U8.28 (SCL_SCLK), U9.28 (SCL_SCLK), U10.28 (SCL_SCLK), U11.15 (SCL)
/SC2: J3.8, R11.1, U6.10 (SC2)
/SC3: J4.8, R13.1, U6.12 (SC3)
/SCL: J1.8, U6.14 (SCL)
/SD0: R6.1, U1.29 (SDA_MOSI), U2.29 (SDA_MOSI), U6.4 (SD0)
/SD1: R8.1, U6.6 (SD1), U7.29 (SDA_MOSI), U8.29 (SDA_MOSI), U9.29 (SDA_MOSI), U10.29 (SDA_MOSI), U11.14 (SDA)
/SD2: J3.7, R10.1, U6.9 (SD2)
/SD3: J4.7, R12.1, U6.11 (SD3)
/SDA: J1.7, U6.15 (SDA)
/SR_CLK: J1.12, J3.12, J4.12, U3.2 (CP), U4.2 (CP), U5.2 (CP), U12.2 (CP), U13.2 (CP), U14.2 (CP)
/SR_END: J3.14, R1.1
/SR_IN: J1.14
/SR_L1: U12.10 (DS), U13.9 (Q7)
/SR_L2: U13.10 (DS), U14.9 (Q7)
/SR_M2: U5.10 (DS), U12.9 (Q7)
/SR_M4: J3.13, R16.1, U14.10 (DS)
/SR_OUT: J1.13, U3.9 (Q7)
/SR_Q1: U3.10 (DS), U4.9 (Q7)
/SR_Q2: U4.10 (DS), U5.9 (Q7)
/TOUCH0: ENC1.MP, R18.2
/TOUCH1: ENC2.MP, R19.2
/TOUCH2: ENC3.MP, R20.2
/TOUCH3: ENC4.MP, R21.2
/TOUCH4: ENC5.MP, R22.2
/TOUCH5: ENC6.MP, R23.2
/TOUCH6: ENC7.MP, R24.2
/TOUCH7: ENC8.MP, R25.2
/TR0: R18.1, U11.1 (CS0)
/TR1: R19.1, U11.2 (CS1)
/TR2: R20.1, U11.12 (CS2)
/TR3: R21.1, U11.13 (CS3)
/TR4: R22.1, U11.8 (CS4)
/TR5: R23.1, U11.9 (CS5)
/TR6: R24.1, U11.10 (CS6)
/TR7: R25.1, U11.11 (CS7)
/VREG: C34.1, U11.4 (VCC)
/~INT: J1.9, J3.9, J4.9, U11.16 (~HI)
/~SR_LOAD: J1.11, J3.11, J4.11, U3.1 (~PL), U4.1 (~PL), U5.1 (~PL), U12.1 (~PL), U13.1 (~PL), U14.1 (~PL)
GND: C1.2, C2.2, C3.2, C4.2, C5.2, C6.2, C7.2, C8.2, C9.2, C10.2, C11.2, C12.2, C13.2, C14.2, C15.2, C16.2, C17.2, C18.2, C19.2, C20.2, C21.2, C22.2, C23.2, C24.2, C25.2, C26.2, C27.2, C28.2, C29.2, C30.2, C31.2, C32.2, C33.2, C34.2, C35.2, C36.2, C37.2, C38.2, C39.2, ENC1.C, ENC1.S2, ENC2.C, ENC2.S2, ENC3.C, ENC3.S2, ENC4.C, ENC4.S2, ENC5.C, ENC5.S2, ENC6.C, ENC6.S2, ENC7.C, ENC7.S2, ENC8.C, ENC8.S2, J1.3, J1.4, J1.6, J1.10, J1.16, J3.3, J3.4, J3.6, J3.10, J4.3, J4.4, J4.6, J4.10, R4.2, R5.2, SW1.2, SW2.2, SW3.2, SW4.2, SW5.2, SW6.2, SW7.2, SW8.2, SW9.2, SW10.2, SW11.2, SW12.2, SW13.2, SW14.2, SW15.2, SW16.2, SW17.2, SW18.2, SW19.2, SW20.2, SW21.2, U1.26 (IFS), U1.27 (VSYNC), U1.30 (ADDR0_MISO), U1.31 (ADDR1_SS), U1.33 (GND), U2.26 (IFS), U2.27 (VSYNC), U2.31 (ADDR1_SS), U2.33 (GND), U3.8 (GND), U3.15 (~CE), U4.8 (GND), U4.15 (~CE), U5.8 (GND), U5.15 (~CE), U6.8 (GND), U7.26 (IFS), U7.27 (VSYNC), U7.30 (ADDR0_MISO), U7.31 (ADDR1_SS), U7.33 (GND), U8.26 (IFS), U8.27 (VSYNC), U8.31 (ADDR1_SS), U8.33 (GND), U9.26 (IFS), U9.27 (VSYNC), U9.30 (ADDR0_MISO), U9.33 (GND), U10.26 (IFS), U10.27 (VSYNC), U10.33 (GND), U11.7 (VSS), U11.17 (EP), U12.8 (GND), U12.15 (~CE), U13.8 (GND), U13.15 (~CE), U14.8 (GND), U14.15 (~CE)

Notes on the sheet:
J1 deck bus 2x8 to P2 (P100); TCA9546A 0x71 (P99): ch0 own LEDs, ch1 Level block (4 LP5864, touch), ch2 J3 -> M4, ch3 J4 -> W2; chain P3 buttons -> Level knobs -> M4
Chain: U3 (Solo first) -> U4 -> U5 -> Level registers (Level 8 first) -> M4 (J3); W2 (J4) not in the chain; buttons: Note field of SW1-SW21
Level block (R128, from hardware/m2-levels): touch TR0-7 -> 560 R -> TOUCH0-7 = frame MP of ENC1-8 (Level 8 ... Level 1); fields Block=Level

Board: 4 copper layers, 276 parts (90 on the bottom side), 226 nets, no tracks yet.
