MitjaGrecky/Shtuka-druka/hardware/m5-gain/m5-gain.kicad_pcb

## KiCad design hardware/m5-gain/m5-gain.kicad_pcb (2026-11-13)

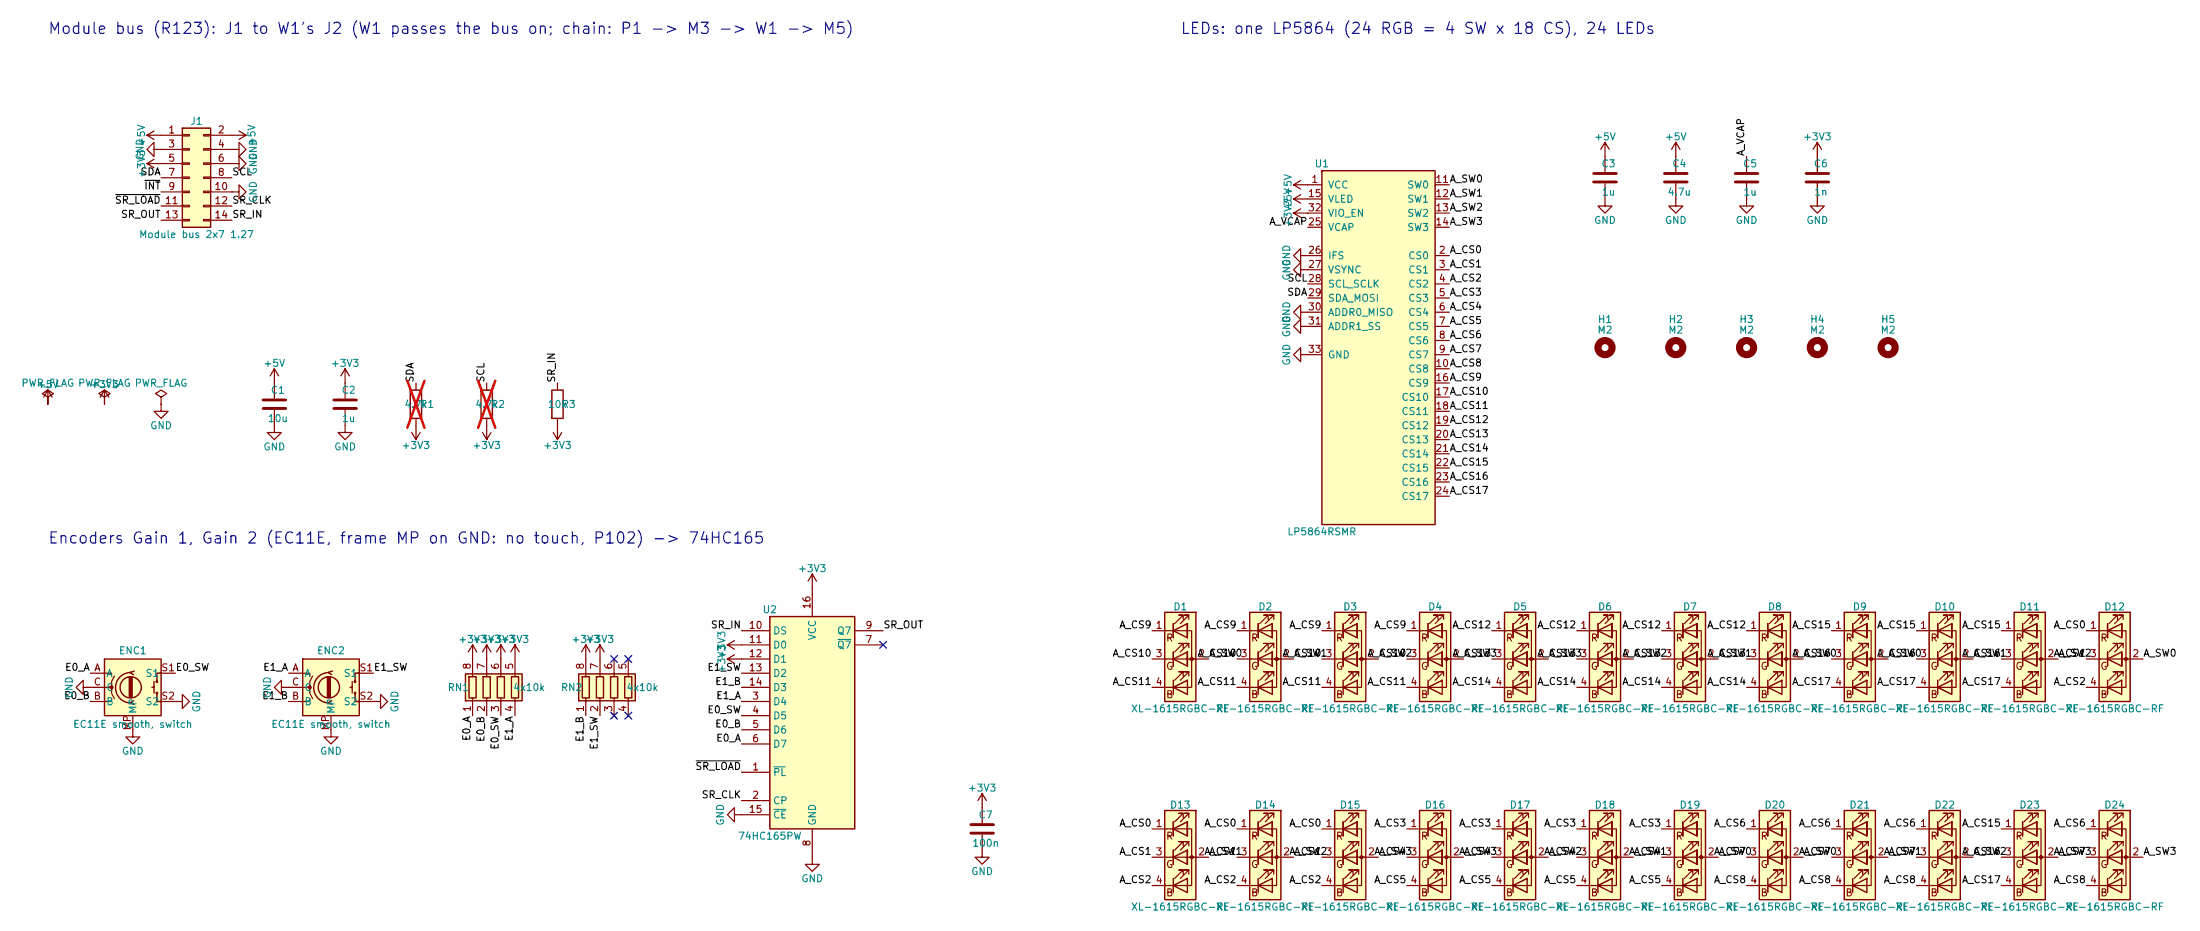
[picture p79: schematic m5-gain.kicad_sch, M5 - Gain 1 + 2 module on the slope (2 encoders, 11-LED rin…]

Parts:
C1: 10u; C_0805_2012Metric; LCSC C15850
C2, C3, C5: 1u; C_0402_1005Metric; LCSC C52923
C4: 4.7u; C_0805_2012Metric; LCSC C1779
C6: 1n; C_0402_1005Metric; LCSC C1523
C7: 100n; C_0402_1005Metric; LCSC C1525
D1, D2, D3, D4, D5, D6, D7, D8, D9, D10, D11, D12, D13, D14, D15, D16, D17, D18, D19, D20, D21, D22, D23, D24: XL-1615RGBC-RF; LED_RGB_XL-1615RGBC_1.6x1.5mm; LCSC C965840
ENC1, ENC2: EC11E smooth, switch; RotaryEncoder_Alps_EC11E-Switch_Vertical_H20mm_Ring; LCSC C361165
H1, H2, H3, H4, H5: M2; MountingHole_2.2mm_M2
J1: Module bus 2x7 1.27; PinHeader_2x07_P1.27mm_Vertical; LCSC C5372811
R1, R2: 4.7k; R_0402_1005Metric; LCSC C25900; not fitted
R3: 10k; R_0402_1005Metric; LCSC C25744
RN1, RN2: 4x10k; R_Array_Convex_4x0402; LCSC C25725
U1: LP5864RSMR; VQFN-32-1EP_4x4mm_P0.4mm_EP2.8x2.8mm; LCSC C5220564
U2: 74HC165PW; TSSOP-16_4.4x5mm_P0.65mm; LCSC C80696

Connections:
+3V3: C2.1, C6.1, C7.1, J1.5, R1.2, R2.2, R3.2, RN1.5 (R4.2), RN1.6 (R3.2), RN1.7 (R2.2), RN1.8 (R1.2), RN2.7 (R2.2), RN2.8 (R1.2), U1.32 (VIO_EN), U2.11 (D0), U2.12 (D1), U2.16 (VCC)
+5V: C1.1, C3.1, C4.1, J1.1, J1.2, U1.1 (VCC), U1.15 (VLED)
/A_CS0: D12.1 (RK), D13.1 (RK), D14.1 (RK), D15.1 (RK), U1.2 (CS0)
/A_CS1: D12.3 (GK), D13.3 (GK), D14.3 (GK), D15.3 (GK), U1.3 (CS1)
/A_CS2: D12.4 (BK), D13.4 (BK), D14.4 (BK), D15.4 (BK), U1.4 (CS2)
/A_CS3: D16.1 (RK), D17.1 (RK), D18.1 (RK), D19.1 (RK), U1.5 (CS3)
/A_CS4: D16.3 (GK), D17.3 (GK), D18.3 (GK), D19.3 (GK), U1.6 (CS4)
/A_CS5: D16.4 (BK), D17.4 (BK), D18.4 (BK), D19.4 (BK), U1.7 (CS5)
/A_CS6: D20.1 (RK), D21.1 (RK), D22.1 (RK), D24.1 (RK), U1.8 (CS6)
/A_CS7: D20.3 (GK), D21.3 (GK), D22.3 (GK), D24.3 (GK), U1.9 (CS7)
/A_CS8: D20.4 (BK), D21.4 (BK), D22.4 (BK), D24.4 (BK), U1.10 (CS8)
/A_CS9: D1.1 (RK), D2.1 (RK), D3.1 (RK), D4.1 (RK), U1.16 (CS9)
/A_CS10: D1.3 (GK), D2.3 (GK), D3.3 (GK), D4.3 (GK), U1.17 (CS10)
/A_CS11: D1.4 (BK), D2.4 (BK), D3.4 (BK), D4.4 (BK), U1.18 (CS11)
/A_CS12: D5.1 (RK), D6.1 (RK), D7.1 (RK), D8.1 (RK), U1.19 (CS12)
/A_CS13: D5.3 (GK), D6.3 (GK), D7.3 (GK), D8.3 (GK), U1.20 (CS13)
/A_CS14: D5.4 (BK), D6.4 (BK), D7.4 (BK), D8.4 (BK), U1.21 (CS14)
/A_CS15: D9.1 (RK), D10.1 (RK), D11.1 (RK), D23.1 (RK), U1.22 (CS15)
/A_CS16: D9.3 (GK), D10.3 (GK), D11.3 (GK), D23.3 (GK), U1.23 (CS16)
/A_CS17: D9.4 (BK), D10.4 (BK), D11.4 (BK), D23.4 (BK), U1.24 (CS17)
/A_SW0: D1.2 (A), D8.2 (A), D9.2 (A), D12.2 (A), D19.2 (A), D20.2 (A), U1.11 (SW0)
/A_SW1: D2.2 (A), D7.2 (A), D10.2 (A), D13.2 (A), D18.2 (A), D21.2 (A), U1.12 (SW1)
/A_SW2: D3.2 (A), D6.2 (A), D11.2 (A), D14.2 (A), D17.2 (A), D22.2 (A), U1.13 (SW2)
/A_SW3: D4.2 (A), D5.2 (A), D15.2 (A), D16.2 (A), D23.2 (A), D24.2 (A), U1.14 (SW3)
/A_VCAP: C5.1, U1.25 (VCAP)
/E0_A: ENC1.A, RN1.1 (R1.1), U2.6 (D7)
/E0_B: ENC1.B, RN1.2 (R2.1), U2.5 (D6)
/E0_SW: ENC1.S1, RN1.3 (R3.1), U2.4 (D5)
/E1_A: ENC2.A, RN1.4 (R4.1), U2.3 (D4)
/E1_B: ENC2.B, RN2.1 (R1.1), U2.14 (D3)
/E1_SW: ENC2.S1, RN2.2 (R2.1), U2.13 (D2)
/SCL: J1.8, R2.1, U1.28 (SCL_SCLK)
/SDA: J1.7, R1.1, U1.29 (SDA_MOSI)
/SR_CLK: J1.12, U2.2 (CP)
/SR_IN: J1.14, R3.1, U2.10 (DS)
/SR_OUT: J1.13, U2.9 (Q7)
/~INT: J1.9
/~SR_LOAD: J1.11, U2.1 (~PL)
GND: C1.2, C2.2, C3.2, C4.2, C5.2, C6.2, C7.2, ENC1.C, ENC1.MP, ENC1.S2, ENC2.C, ENC2.MP, ENC2.S2, J1.3, J1.4, J1.6, J1.10, U1.26 (IFS), U1.27 (VSYNC), U1.30 (ADDR0_MISO), U1.31 (ADDR1_SS), U1.33 (GND), U2.8 (GND), U2.15 (~CE)

Notes on the sheet:
Module bus (R123): J1 to W1's J2 (W1 passes the bus on; chain: P1 -> M3 -> W1 -> M5)
Encoders Gain 1, Gain 2 (EC11E, frame MP on GND: no touch, P102) -> 74HC165
LEDs: one LP5864 (24 RGB = 4 SW x 18 CS), 24 LEDs

Board: 2 copper layers, 46 parts (15 on the bottom side), 38 nets, no tracks yet.
