MitjaGrecky/Shtuka-druka/hardware/w1-levels/w1-levels.kicad_pcb

## KiCad design hardware/w1-levels/w1-levels.kicad_pcb (2026-11-13)

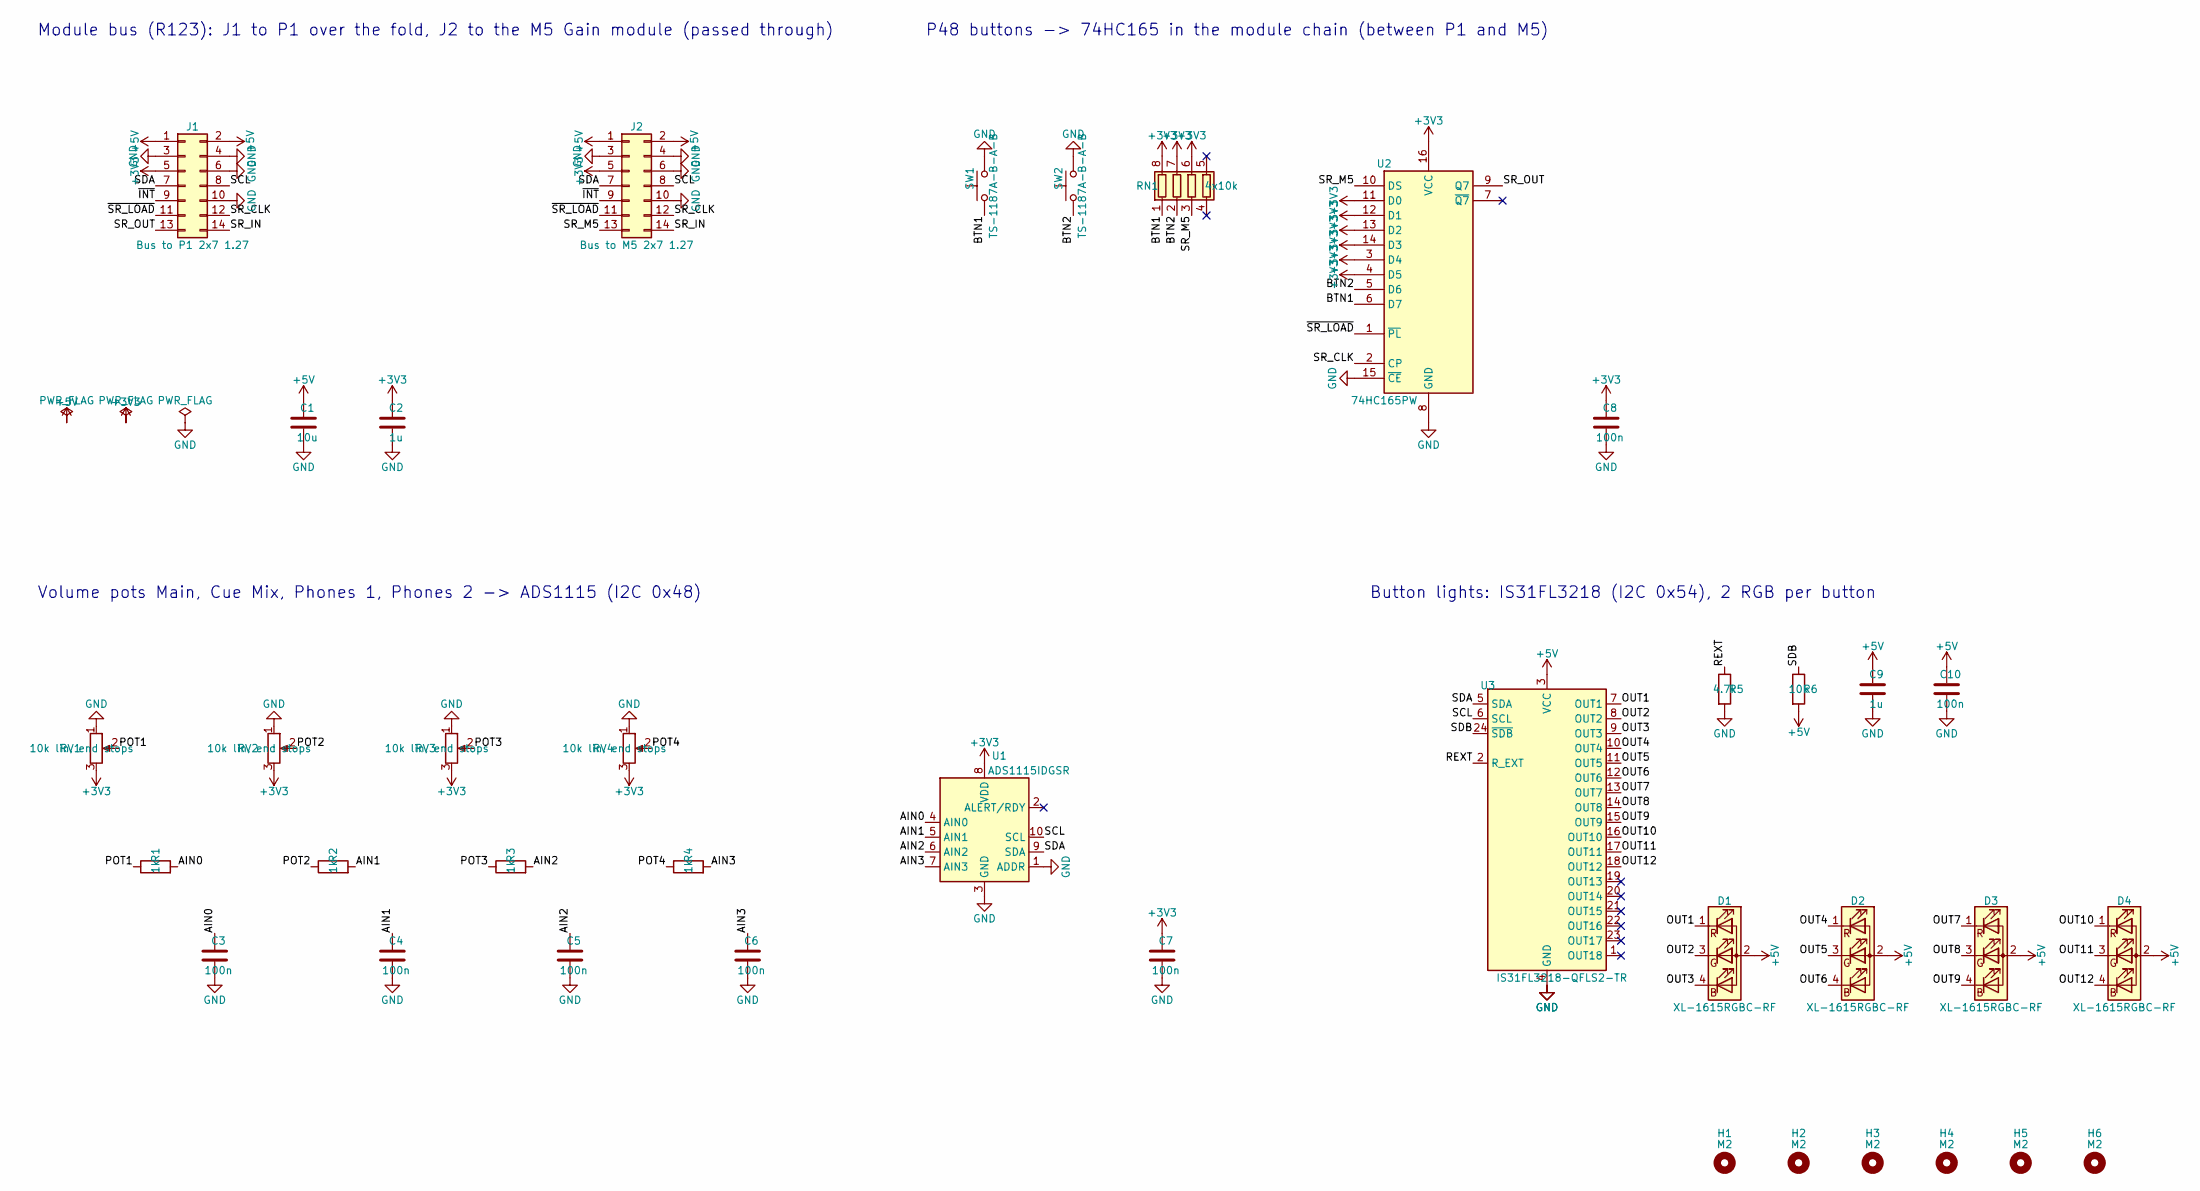
[picture p80: schematic w1-levels.kicad_sch, W1 - Levels (slope, left): 4 volume pots, 2 P48 buttons, wi…]

Parts:
C1: 10u; C_0805_2012Metric; LCSC C15850
C2, C9: 1u; C_0402_1005Metric; LCSC C52923
C3, C4, C5, C6, C7, C8, C10: 100n; C_0402_1005Metric; LCSC C1525
D1, D2, D3, D4: XL-1615RGBC-RF; LED_RGB_XL-1615RGBC_1.6x1.5mm; LCSC C965840
H1, H2, H3, H4, H5, H6: M2; MountingHole_2.2mm_M2
J1: Bus to P1 2x7 1.27; PinHeader_2x07_P1.27mm_Vertical; LCSC C5372811
J2: Bus to M5 2x7 1.27; PinHeader_2x07_P1.27mm_Vertical; LCSC C5372811
R1, R2, R3, R4: 1k; R_0402_1005Metric; LCSC C11702
R5: 4.7k; R_0402_1005Metric; LCSC C25900
R6: 10k; R_0402_1005Metric; LCSC C25744
RN1: 4x10k; R_Array_Convex_4x0402; LCSC C25725
RV1, RV2, RV3, RV4: 10k lin, end stops; Potentiometer_Alps_RK09K_Single_Vertical; Part Alps RK09K1130A6S or another RK09K 10k 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; LCSC C209770
SW1, SW2: TS-1187A-B-A-B; SW_Push_1P1T_XKB_TS-1187A; LCSC C318884
U1: ADS1115IDGSR; TSSOP-10_3x3mm_P0.5mm; LCSC C37593
U2: 74HC165PW; TSSOP-16_4.4x5mm_P0.65mm; LCSC C80696
U3: IS31FL3218-QFLS2-TR; QFN-24-1EP_4x4mm_P0.5mm_EP2.7x2.7mm; LCSC C2940546

Connections:
+3V3: C2.1, C7.1, C8.1, J1.5, J2.5, RN1.6 (R3.2), RN1.7 (R2.2), RN1.8 (R1.2), RV1.3, RV2.3, RV3.3, RV4.3, U1.8 (VDD), U2.3 (D4), U2.4 (D5), U2.11 (D0), U2.12 (D1), U2.13 (D2), U2.14 (D3), U2.16 (VCC)
+5V: C1.1, C9.1, C10.1, D1.2 (A), D2.2 (A), D3.2 (A), D4.2 (A), J1.1, J1.2, J2.1, J2.2, R6.2, U3.3 (VCC)
/AIN0: C3.1, R1.2, U1.4 (AIN0)
/AIN1: C4.1, R2.2, U1.5 (AIN1)
/AIN2: C5.1, R3.2, U1.6 (AIN2)
/AIN3: C6.1, R4.2, U1.7 (AIN3)
/BTN1: RN1.1 (R1.1), SW1.1, U2.6 (D7)
/BTN2: RN1.2 (R2.1), SW2.1, U2.5 (D6)
/OUT1: D1.1 (RK), U3.7 (OUT1)
/OUT2: D1.3 (GK), U3.8 (OUT2)
/OUT3: D1.4 (BK), U3.9 (OUT3)
/OUT4: D2.1 (RK), U3.10 (OUT4)
/OUT5: D2.3 (GK), U3.11 (OUT5)
/OUT6: D2.4 (BK), U3.12 (OUT6)
/OUT7: D3.1 (RK), U3.13 (OUT7)
/OUT8: D3.3 (GK), U3.14 (OUT8)
/OUT9: D3.4 (BK), U3.15 (OUT9)
/OUT10: D4.1 (RK), U3.16 (OUT10)
/OUT11: D4.3 (GK), U3.17 (OUT11)
/OUT12: D4.4 (BK), U3.18 (OUT12)
/POT1: R1.1, RV1.2
/POT2: R2.1, RV2.2
/POT3: R3.1, RV3.2
/POT4: R4.1, RV4.2
/REXT: R5.1, U3.2 (R_EXT)
/SCL: J1.8, J2.8, U1.10 (SCL), U3.6 (SCL)
/SDA: J1.7, J2.7, U1.9 (SDA), U3.5 (SDA)
/SDB: R6.1, U3.24 (~SDB)
/SR_CLK: J1.12, J2.12, U2.2 (CP)
/SR_IN: J1.14, J2.14
/SR_M5: J2.13, RN1.3 (R3.1), U2.10 (DS)
/SR_OUT: J1.13, U2.9 (Q7)
/~INT: J1.9, J2.9
/~SR_LOAD: J1.11, J2.11, U2.1 (~PL)
GND: C1.2, C2.2, C3.2, C4.2, C5.2, C6.2, C7.2, C8.2, C9.2, C10.2, J1.3, J1.4, J1.6, J1.10, J2.3, J2.4, J2.6, J2.10, R5.2, RV1.1, RV2.1, RV3.1, RV4.1, SW1.2, SW2.2, U1.1 (ADDR), U1.3 (GND), U2.8 (GND), U2.15 (~CE), U3.4 (GND), U3.25 (GND)

Notes on the sheet:
Module bus (R123): J1 to P1 over the fold, J2 to the M5 Gain module (passed through)
Volume pots Main, Cue Mix, Phones 1, Phones 2 -> ADS1115 (I2C 0x48)
P48 buttons -> 74HC165 in the module chain (between P1 and M5)
Button lights: IS31FL3218 (I2C 0x54), 2 RGB per button

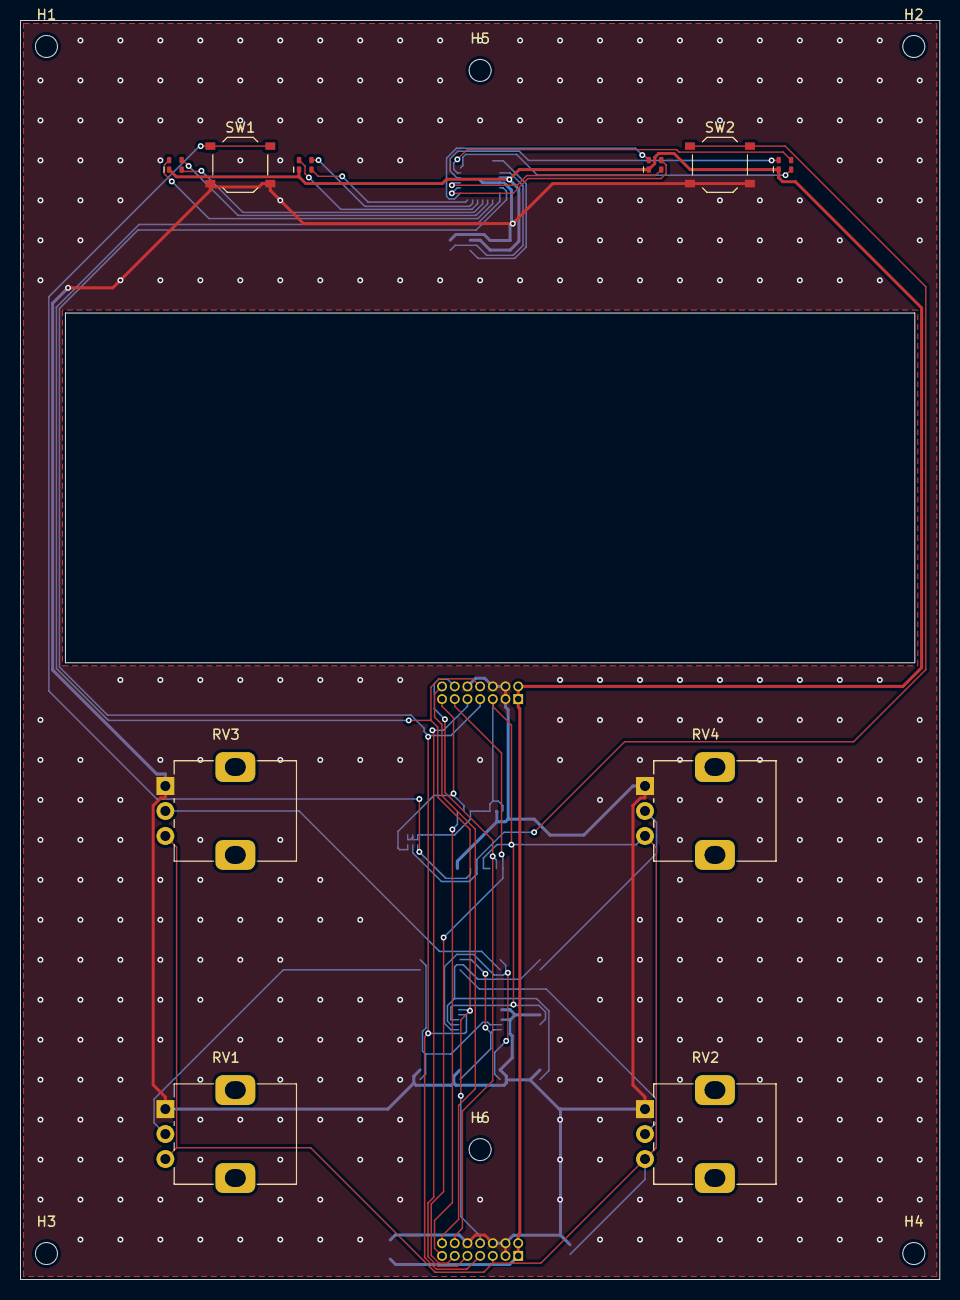
[picture p81: board w1-levels.kicad_pcb from above]

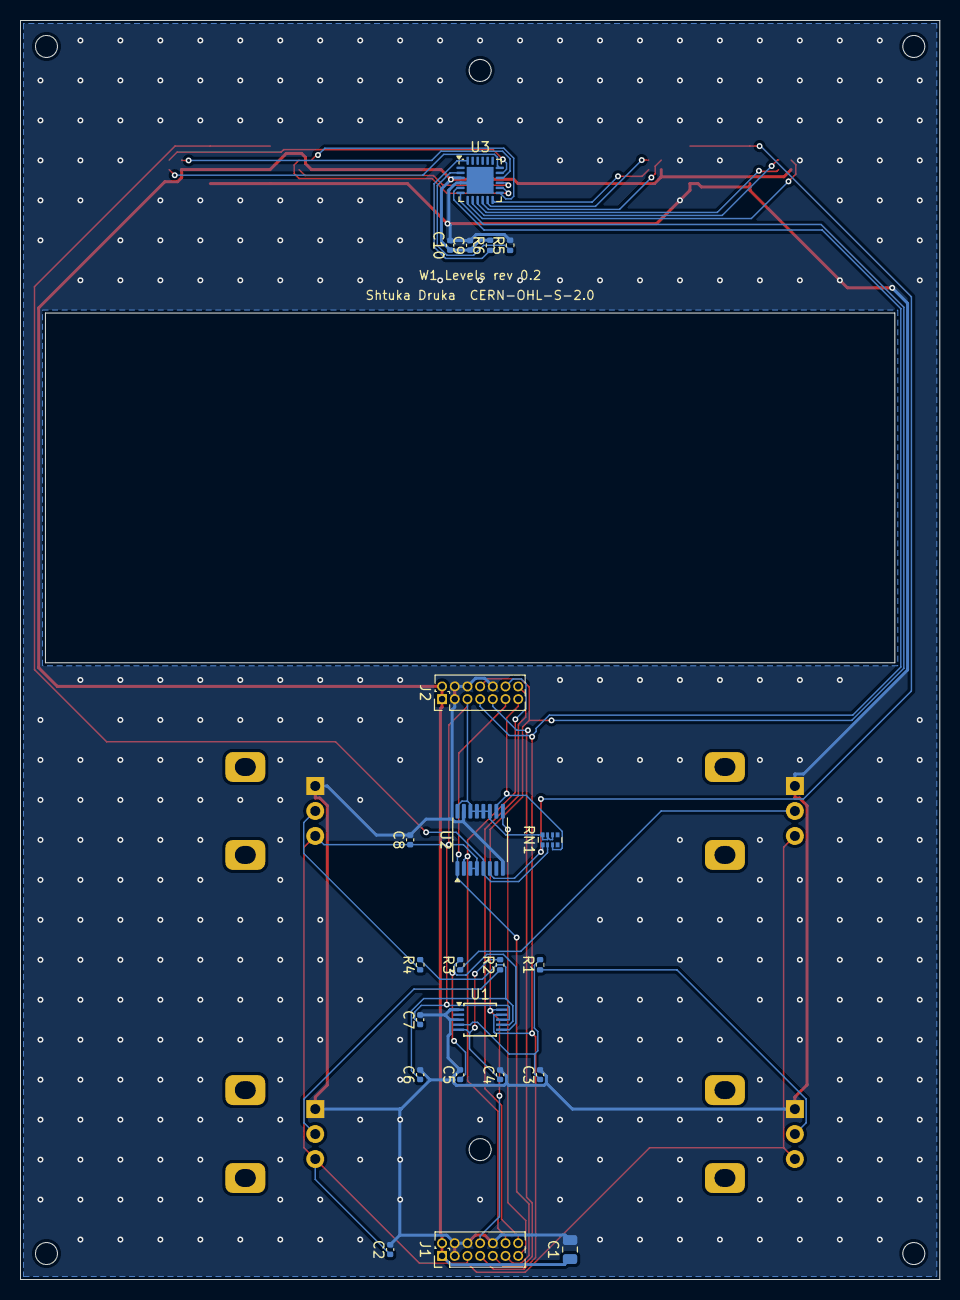
[picture p82: board w1-levels.kicad_pcb from below]

Board: 2 copper layers, 92.0 x 126.0 mm, 38 parts (22 on the bottom side), 35 nets.
