MitjaGrecky/Shtuka-druka/hardware/w2-meters/w2-meters.kicad_pcb

## KiCad design hardware/w2-meters/w2-meters.kicad_pcb (2026-11-13)

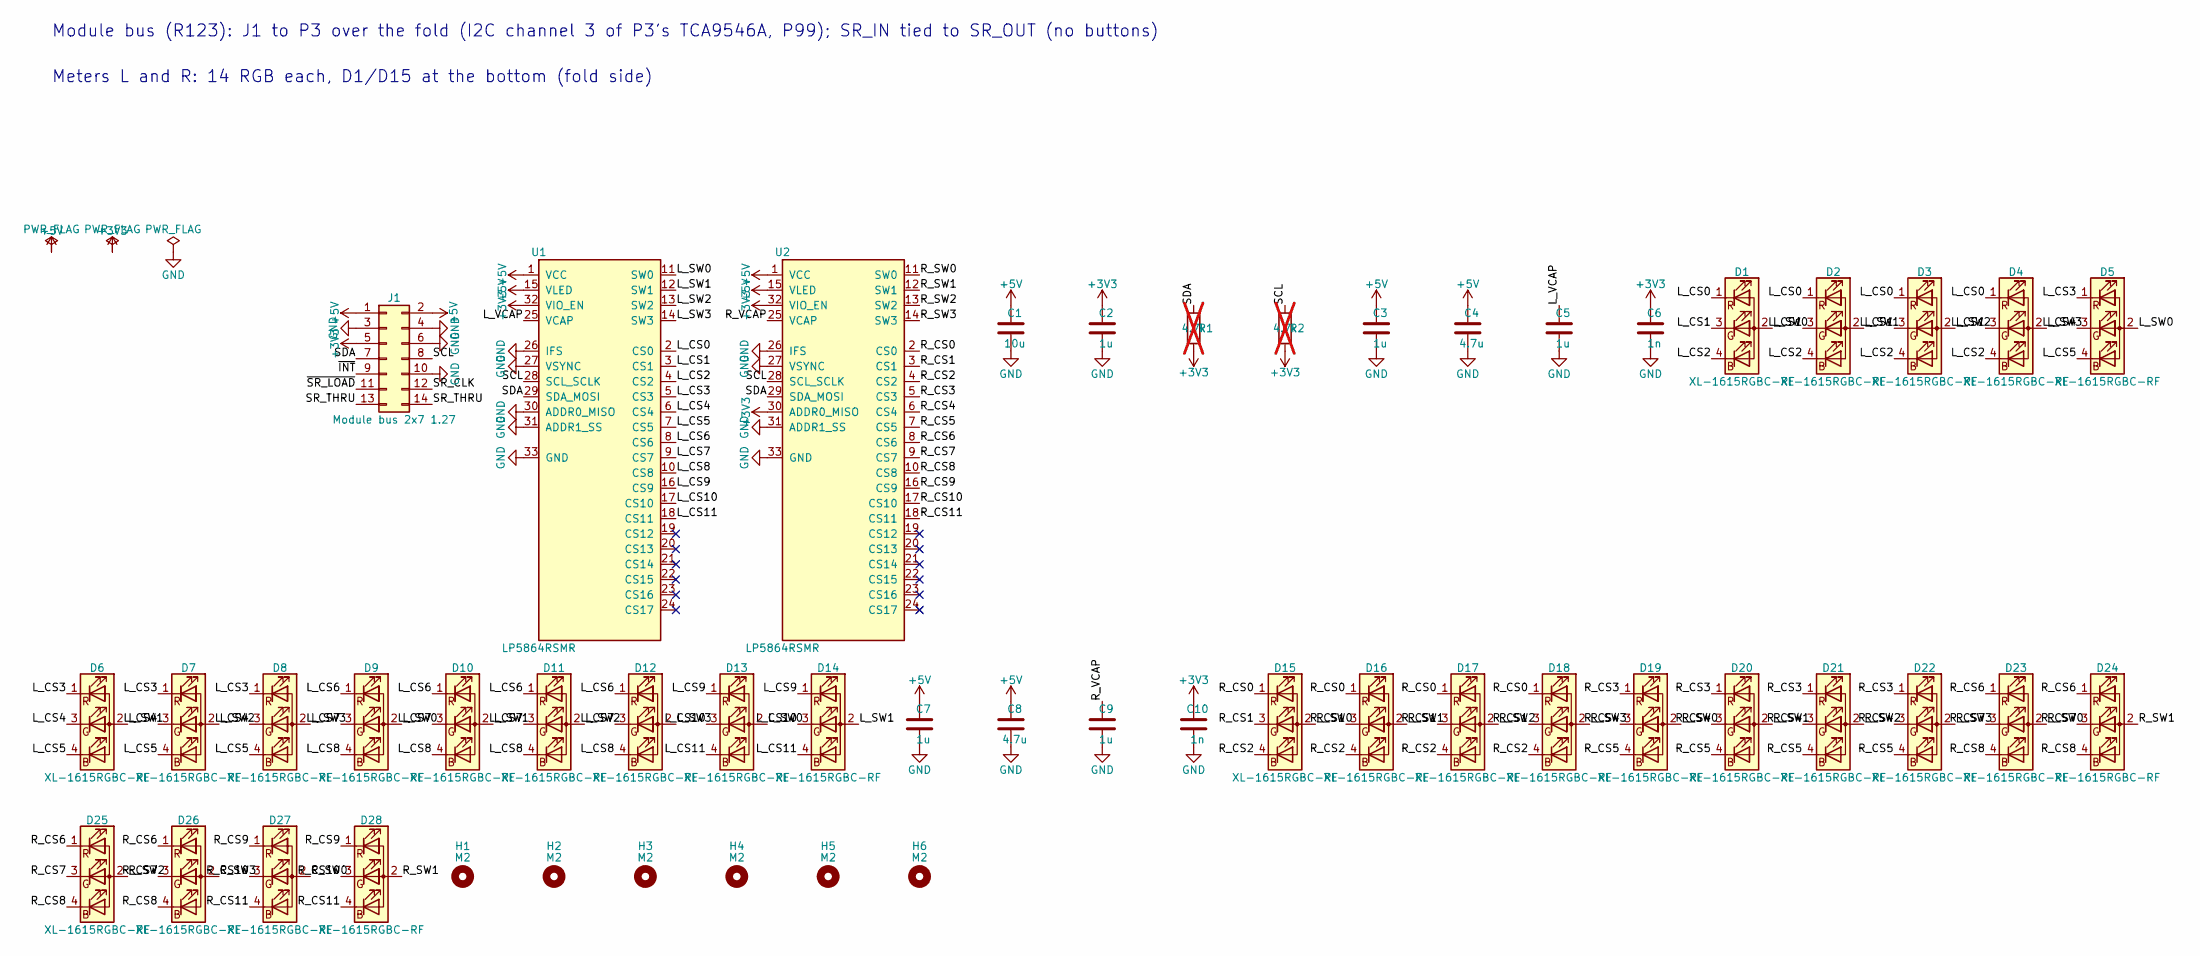
[picture p83: schematic w2-meters.kicad_sch, W2 - Meters (slope): 2 x 14 RGB LED level meters]

Parts:
C1: 10u; C_0805_2012Metric; LCSC C15850
C2, C3, C5, C7, C9: 1u; C_0402_1005Metric; LCSC C52923
C4, C8: 4.7u; C_0805_2012Metric; LCSC C1779
C6, C10: 1n; C_0402_1005Metric; LCSC C1523
D1, D2, D3, D4, D5, D6, D7, D8, D9, D10, D11, D12, D13, D14, D15, D16, D17, D18, D19, D20, D21, D22, D23, D24, D25, D26, D27, D28: XL-1615RGBC-RF; LED_RGB_XL-1615RGBC_1.6x1.5mm; LCSC C965840
H1, H2, H3, H4, H5, H6: M2; MountingHole_2.2mm_M2
J1: Module bus 2x7 1.27; PinHeader_2x07_P1.27mm_Vertical; LCSC C5372811
R1, R2: 4.7k; R_0402_1005Metric; LCSC C25900; not fitted
U1, U2: LP5864RSMR; VQFN-32-1EP_4x4mm_P0.4mm_EP2.8x2.8mm; LCSC C5220564

Connections:
+3V3: C2.1, C6.1, C10.1, J1.5, R1.2, R2.2, U1.32 (VIO_EN), U2.30 (ADDR0_MISO), U2.32 (VIO_EN)
+5V: C1.1, C3.1, C4.1, C7.1, C8.1, J1.1, J1.2, U1.1 (VCC), U1.15 (VLED), U2.1 (VCC), U2.15 (VLED)
/L_CS0: D1.1 (RK), D2.1 (RK), D3.1 (RK), D4.1 (RK), U1.2 (CS0)
/L_CS1: D1.3 (GK), D2.3 (GK), D3.3 (GK), D4.3 (GK), U1.3 (CS1)
/L_CS2: D1.4 (BK), D2.4 (BK), D3.4 (BK), D4.4 (BK), U1.4 (CS2)
/L_CS3: D5.1 (RK), D6.1 (RK), D7.1 (RK), D8.1 (RK), U1.5 (CS3)
/L_CS4: D5.3 (GK), D6.3 (GK), D7.3 (GK), D8.3 (GK), U1.6 (CS4)
/L_CS5: D5.4 (BK), D6.4 (BK), D7.4 (BK), D8.4 (BK), U1.7 (CS5)
/L_CS6: D9.1 (RK), D10.1 (RK), D11.1 (RK), D12.1 (RK), U1.8 (CS6)
/L_CS7: D9.3 (GK), D10.3 (GK), D11.3 (GK), D12.3 (GK), U1.9 (CS7)
/L_CS8: D9.4 (BK), D10.4 (BK), D11.4 (BK), D12.4 (BK), U1.10 (CS8)
/L_CS9: D13.1 (RK), D14.1 (RK), U1.16 (CS9)
/L_CS10: D13.3 (GK), D14.3 (GK), U1.17 (CS10)
/L_CS11: D13.4 (BK), D14.4 (BK), U1.18 (CS11)
/L_SW0: D1.2 (A), D5.2 (A), D9.2 (A), D13.2 (A), U1.11 (SW0)
/L_SW1: D2.2 (A), D6.2 (A), D10.2 (A), D14.2 (A), U1.12 (SW1)
/L_SW2: D3.2 (A), D7.2 (A), D11.2 (A), U1.13 (SW2)
/L_SW3: D4.2 (A), D8.2 (A), D12.2 (A), U1.14 (SW3)
/L_VCAP: C5.1, U1.25 (VCAP)
/R_CS0: D15.1 (RK), D16.1 (RK), D17.1 (RK), D18.1 (RK), U2.2 (CS0)
/R_CS1: D15.3 (GK), D16.3 (GK), D17.3 (GK), D18.3 (GK), U2.3 (CS1)
/R_CS2: D15.4 (BK), D16.4 (BK), D17.4 (BK), D18.4 (BK), U2.4 (CS2)
/R_CS3: D19.1 (RK), D20.1 (RK), D21.1 (RK), D22.1 (RK), U2.5 (CS3)
/R_CS4: D19.3 (GK), D20.3 (GK), D21.3 (GK), D22.3 (GK), U2.6 (CS4)
/R_CS5: D19.4 (BK), D20.4 (BK), D21.4 (BK), D22.4 (BK), U2.7 (CS5)
/R_CS6: D23.1 (RK), D24.1 (RK), D25.1 (RK), D26.1 (RK), U2.8 (CS6)
/R_CS7: D23.3 (GK), D24.3 (GK), D25.3 (GK), D26.3 (GK), U2.9 (CS7)
/R_CS8: D23.4 (BK), D24.4 (BK), D25.4 (BK), D26.4 (BK), U2.10 (CS8)
/R_CS9: D27.1 (RK), D28.1 (RK), U2.16 (CS9)
/R_CS10: D27.3 (GK), D28.3 (GK), U2.17 (CS10)
/R_CS11: D27.4 (BK), D28.4 (BK), U2.18 (CS11)
/R_SW0: D15.2 (A), D19.2 (A), D23.2 (A), D27.2 (A), U2.11 (SW0)
/R_SW1: D16.2 (A), D20.2 (A), D24.2 (A), D28.2 (A), U2.12 (SW1)
/R_SW2: D17.2 (A), D21.2 (A), D25.2 (A), U2.13 (SW2)
/R_SW3: D18.2 (A), D22.2 (A), D26.2 (A), U2.14 (SW3)
/R_VCAP: C9.1, U2.25 (VCAP)
/SCL: J1.8, R2.1, U1.28 (SCL_SCLK), U2.28 (SCL_SCLK)
/SDA: J1.7, R1.1, U1.29 (SDA_MOSI), U2.29 (SDA_MOSI)
/SR_CLK: J1.12
/SR_THRU: J1.13, J1.14
/~INT: J1.9
/~SR_LOAD: J1.11
GND: C1.2, C2.2, C3.2, C4.2, C5.2, C6.2, C7.2, C8.2, C9.2, C10.2, J1.3, J1.4, J1.6, J1.10, U1.26 (IFS), U1.27 (VSYNC), U1.30 (ADDR0_MISO), U1.31 (ADDR1_SS), U1.33 (GND), U2.26 (IFS), U2.27 (VSYNC), U2.31 (ADDR1_SS), U2.33 (GND)

Notes on the sheet:
Module bus (R123): J1 to P3 over the fold (I2C channel 3 of P3's TCA9546A, P99); SR_IN tied to SR_OUT (no buttons)
Meters L and R: 14 RGB each, D1/D15 at the bottom (fold side)

Board: 2 copper layers, 49 parts (15 on the bottom side), 40 nets, no tracks yet.
