MitjaGrecky/Shtuka-druka/hardware/w3-system/w3-system.kicad_pcb

## KiCad design hardware/w3-system/w3-system.kicad_pcb (2026-11-13)

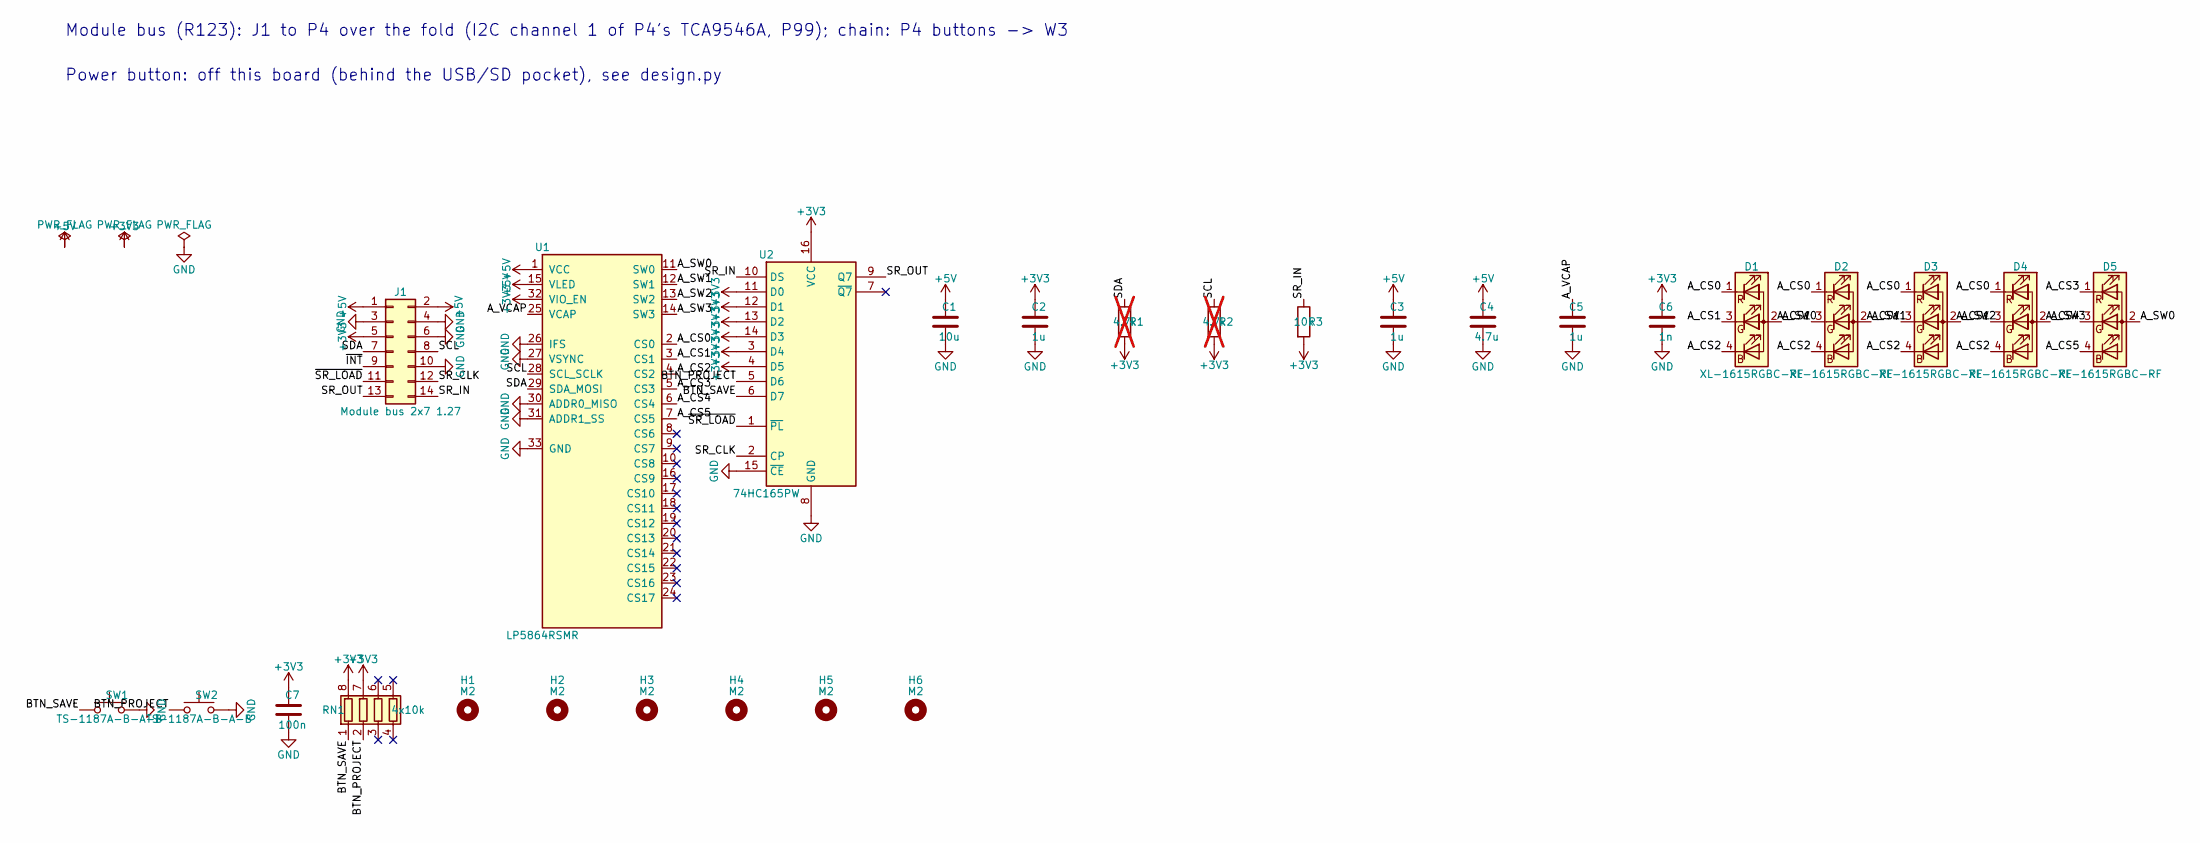
[picture p84: schematic w3-system.kicad_sch, W3 - System (slope, right): Save, Project, record light]

Parts:
C1: 10u; C_0805_2012Metric; LCSC C15850
C2, C3, C5: 1u; C_0402_1005Metric; LCSC C52923
C4: 4.7u; C_0805_2012Metric; LCSC C1779
C6: 1n; C_0402_1005Metric; LCSC C1523
C7: 100n; C_0402_1005Metric; LCSC C1525
D1, D2, D3, D4, D5: XL-1615RGBC-RF; LED_RGB_XL-1615RGBC_1.6x1.5mm; LCSC C965840
H1, H2, H3, H4, H5, H6: M2; MountingHole_2.2mm_M2
J1: Module bus 2x7 1.27; PinHeader_2x07_P1.27mm_Vertical; LCSC C5372811
R1, R2: 4.7k; R_0402_1005Metric; LCSC C25900; not fitted
R3: 10k; R_0402_1005Metric; LCSC C25744
RN1: 4x10k; R_Array_Convex_4x0402; LCSC C25725
SW1, SW2: TS-1187A-B-A-B; SW_Push_1P1T_XKB_TS-1187A; LCSC C318884
U1: LP5864RSMR; VQFN-32-1EP_4x4mm_P0.4mm_EP2.8x2.8mm; LCSC C5220564
U2: 74HC165PW; TSSOP-16_4.4x5mm_P0.65mm; LCSC C80696

Connections:
+3V3: C2.1, C6.1, C7.1, J1.5, R1.2, R2.2, R3.2, RN1.7 (R2.2), RN1.8 (R1.2), U1.32 (VIO_EN), U2.3 (D4), U2.4 (D5), U2.11 (D0), U2.12 (D1), U2.13 (D2), U2.14 (D3), U2.16 (VCC)
+5V: C1.1, C3.1, C4.1, J1.1, J1.2, U1.1 (VCC), U1.15 (VLED)
/A_CS0: D1.1 (RK), D2.1 (RK), D3.1 (RK), D4.1 (RK), U1.2 (CS0)
/A_CS1: D1.3 (GK), D2.3 (GK), D3.3 (GK), D4.3 (GK), U1.3 (CS1)
/A_CS2: D1.4 (BK), D2.4 (BK), D3.4 (BK), D4.4 (BK), U1.4 (CS2)
/A_CS3: D5.1 (RK), U1.5 (CS3)
/A_CS4: D5.3 (GK), U1.6 (CS4)
/A_CS5: D5.4 (BK), U1.7 (CS5)
/A_SW0: D1.2 (A), D5.2 (A), U1.11 (SW0)
/A_SW1: D2.2 (A), U1.12 (SW1)
/A_SW2: D3.2 (A), U1.13 (SW2)
/A_SW3: D4.2 (A), U1.14 (SW3)
/A_VCAP: C5.1, U1.25 (VCAP)
/BTN_PROJECT: RN1.2 (R2.1), SW2.1, U2.5 (D6)
/BTN_SAVE: RN1.1 (R1.1), SW1.1, U2.6 (D7)
/SCL: J1.8, R2.1, U1.28 (SCL_SCLK)
/SDA: J1.7, R1.1, U1.29 (SDA_MOSI)
/SR_CLK: J1.12, U2.2 (CP)
/SR_IN: J1.14, R3.1, U2.10 (DS)
/SR_OUT: J1.13, U2.9 (Q7)
/~INT: J1.9
/~SR_LOAD: J1.11, U2.1 (~PL)
GND: C1.2, C2.2, C3.2, C4.2, C5.2, C6.2, C7.2, J1.3, J1.4, J1.6, J1.10, SW1.2, SW2.2, U1.26 (IFS), U1.27 (VSYNC), U1.30 (ADDR0_MISO), U1.31 (ADDR1_SS), U1.33 (GND), U2.8 (GND), U2.15 (~CE)

Notes on the sheet:
Module bus (R123): J1 to P4 over the fold (I2C channel 1 of P4's TCA9546A, P99); chain: P4 buttons -> W3
Power button: off this board (behind the USB/SD pocket), see design.py

Board: 2 copper layers, 27 parts (14 on the bottom side), 22 nets, no tracks yet.
