MitjaGrecky/Shtuka-druka/tools/rear_panel.py

#!/usr/bin/env python3
"""Rear panel v3 (R142): the layout of the 3D model of panel v7 (model3d/index.html), taken over position by position -
rear view, x from the left edge as seen from behind, z from the bottom. R26 (inputs framed, outputs filled), R44 (rear wall
143 mm), R45 (English labels). R141: DIN, USB, LAN, DC and the power switch are panel parts on nuts with short cables;
the 3.5 mm jacks stand on the vertical control board R2 (outline drawn), the audio jacks on R1.
Writes docs/ru/img/rear_panel_v3.svg (v1, v2 kept for history) and prints the R2 jack table (markdown).

  python3 tools/rear_panel.py

License: AGPL-3.0-or-later.
"""
import os

HERE = os.path.dirname(os.path.abspath(__file__))
OUT = os.path.join(HERE, "..", "docs", "ru", "img")
W, H = 515.0, 143.0          # rear wall: panel width, height (R44)
# R2 outline in the rear view: Control block x 88-263, z 10-113, without the window behind the panel DIN sockets
R2_POLY = [(156, 113), (263, 113), (263, 10), (88, 10), (88, 38), (156, 38)]
R1_X = (273.0, 511.0)

# kind: mini (3.5 mm, hole 6), mini3 (stereo 3.5 mm PJ-3920-3A), din (5-pin DIN on nuts), usbc, usba, lan, dc, onoff,
# trs (6.3 mm), combo, rca, gnd, sw
SIZE = {"mini": (6, 6), "mini3": (6, 6), "din": (19, 19), "usbc": (9, 3.5), "usba": (13, 5.5), "lan": (16, 13), "dc": (11, 11),
        "onoff": (12, 8), "trs": (11, 11), "combo": (24, 30), "rca": (10, 10), "gnd": (8, 8), "sw": (5, 9)}
J = []      # (board, zone, label, kind, x, z, direction)


def jack(board, zone, label, kind, x, z, d):
    J.append((board, zone, label, kind, x, z, d))


# ---------------------------------------------------------------- Power / USB: panel parts on nuts (R141)
jack("panel", "POWER / USB", "LAN", "lan", 20, 78, "io")
jack("panel", "POWER / USB", "USB-A", "usba", 40, 80, "io")
jack("panel", "POWER / USB", "USB-C (PC)", "usbc", 62, 80, "io")
jack("panel", "POWER / USB", "DC 12-24V", "dc", 20, 40, "in")
jack("panel", "POWER / USB", "USB-C POWER", "usbc", 40, 40, "in")
jack("panel", "POWER / USB", "ON/OFF", "onoff", 62, 40, "in")
# ---------------------------------------------------------------- Control: MIDI DIN 3 x 2 on nuts, TRS under them (R2)
for lab, x, z, d in (("MIDI IN 1", 100, 82, "in"), ("MIDI OUT 1", 122, 82, "out"), ("MIDI OUT 3", 144, 82, "out"),
                     ("MIDI IN 2", 100, 52, "in"), ("MIDI OUT 2", 122, 52, "out"), ("MIDI OUT 4", 144, 52, "out")):
    jack("panel", "CONTROL", lab, "din", x, z, d)
jack("R2", "CONTROL", "TRS IN", "mini3", 100, 22, "in")
jack("R2", "CONTROL", "TRS OUT 1", "mini3", 122, 22, "out")
jack("R2", "CONTROL", "TRS OUT 2", "mini3", 144, 22, "out")
# ---------------------------------------------------------------- Control: sync, CV in, CV out (R2), pitch 17 x 22
for i, (lab, d) in enumerate((("CLK OUT 1", "out"), ("CLK OUT 2", "out"), ("RESET OUT", "out"), ("CLK IN", "in"), ("RESET IN", "in"))):
    jack("R2", "CONTROL", lab, "mini", 172 + 17 * i, 90, d)
for i in range(4):
    jack("R2", "CONTROL", f"CV IN {i + 1}", "mini", 172 + 17 * i, 68, "in")
for i in range(8):
    jack("R2", "CONTROL", f"CV OUT {i + 1}", "mini", 172 + 17 * (i % 4), 46 if i < 4 else 24, "out")
# ---------------------------------------------------------------- Audio Out (R1)
for lab, x, z in (("MAIN L", 292, 80), ("MAIN R", 322, 80), ("AUX L", 292, 52), ("AUX R", 322, 52)):
    jack("R1", "AUDIO OUT", lab, "trs", x, z, "out")
jack("R1", "AUDIO OUT", "RCA L", "rca", 292, 24, "out")
jack("R1", "AUDIO OUT", "RCA R", "rca", 322, 24, "out")
# ---------------------------------------------------------------- Audio In (R1)
jack("R1", "AUDIO IN", "MIC/LINE 1", "combo", 370, 80, "in")
jack("R1", "AUDIO IN", "MIC/LINE 2", "combo", 400, 80, "in")
jack("R1", "AUDIO IN", "HI-Z 1", "trs", 370, 32, "in")
jack("R1", "AUDIO IN", "HI-Z 2", "trs", 400, 32, "in")
jack("R1", "AUDIO IN", "PHONO L", "rca", 428, 86, "in")
jack("R1", "AUDIO IN", "PHONO R", "rca", 446, 86, "in")
jack("R1", "AUDIO IN", "GND", "gnd", 468, 86, "in")
jack("R1", "AUDIO IN", "PHONO/LINE", "sw", 490, 86, "in")
for i in range(8):
    jack("R1", "AUDIO IN", f"LINE {i + 1}", "trs", 428 + 22 * (i % 4), 56 if i < 4 else 28, "in")

# (board, name, x0, x1, z of the band top or None = header above the panel): the frames of the model
ZONES = [("panel", "POWER / USB", 4.5, 78.5, None), ("R2", "CONTROL", 88.5, 262.5, None),
         ("R1", "AUDIO OUT", 272.5, 342.5, None), ("R1", "AUDIO IN", 352.5, 510.5, None)]


def svg():
    s = 2.4                                            # px per mm
    pad = 30
    w, h = W * s + 2 * pad, H * s + 2 * pad + 40
    X = lambda x: pad + x * s                          # noqa: E731
    Z = lambda z: pad + 40 + (H - z) * s               # noqa: E731
    o = [f'<svg xmlns="http://www.w3.org/2000/svg" width="{w:.0f}" height="{h:.0f}" viewBox="0 0 {w:.0f} {h:.0f}" '
         'font-family="Helvetica, Arial, sans-serif">',
         f'<rect width="100%" height="100%" fill="#ffffff"/>',
         f'<text x="{pad}" y="22" font-size="15" font-weight="bold">Rear panel - v3 = 3D model of panel v7 (R142; rear view, mm; R26: inputs framed, outputs filled; R141: DIN, USB, LAN, DC on nuts)</text>',
         f'<rect x="{X(0)}" y="{Z(H)}" width="{W * s}" height="{H * s}" fill="#f4f4f2" stroke="#222" stroke-width="1.5"/>']
    # usable band: jack tops below ~116 mm at 40 mm depth (doc 13, 3.6)
    o.append(f'<line x1="{X(0)}" y1="{Z(116)}" x2="{X(W)}" y2="{Z(116)}" stroke="#c33" stroke-dasharray="6 4"/>'
             f'<text x="{X(W) - 4}" y="{Z(116) - 4}" font-size="10" fill="#c33" text-anchor="end">jack tops below ~116 mm (doc 13, 3.6)</text>')
    pts = " ".join(f"{X(x):.1f},{Z(z):.1f}" for x, z in R2_POLY)
    o.append(f'<polygon points="{pts}" fill="none" stroke="#88a" stroke-dasharray="3 3"/>'
             f'<text x="{X(258)}" y="{Z(113) + 12}" font-size="10" fill="#557" text-anchor="end">R2 control board (vertical)</text>')
    x0, x1 = R1_X
    o.append(f'<rect x="{X(x0)}" y="{Z(104)}" width="{(x1 - x0) * s}" height="{96 * s}" fill="none" stroke="#88a" '
             f'stroke-dasharray="3 3"/><text x="{X(x1) - 4}" y="{Z(104) + 12}" font-size="10" fill="#557" text-anchor="end">R1 audio board</text>')
    for b, name, x0, x1, zt in ZONES:
        y = Z(H) - 2 if zt is None else Z(zt)
        o.append(f'<text x="{X((x0 + x1) / 2)}" y="{y - 4}" font-size="{11 if zt is None else 9}" font-weight="bold" '
                 f'text-anchor="middle">{name}</text>'
                 f'<line x1="{X(x0)}" y1="{y}" x2="{X(x1)}" y2="{y}" stroke="#222"/>')
    for b, zone, lab, kind, x, z, d in J:
        sw, sh = SIZE[kind]
        fill = "#2b2b2b" if d == "out" else "#ffffff"
        tcol = "#ffffff" if d == "out" else "#222"
        bw, bh = max(sw + 4, 13), sh + (14 if kind in ("mini", "mini3") else 12)
        # R26 marking: output = filled plate, input = frame
        o.append(f'<rect x="{X(x - bw / 2)}" y="{Z(z + sh / 2 + 3)}" width="{bw * s}" height="{bh * s}" rx="3" '
                 f'fill="{fill if d == "out" else "none"}" stroke="#222" stroke-width="{1.4 if d != "out" else 0}"/>')
        hole = "#bbbbbb" if d == "out" else "#dddddd"
        if kind in ("usbc", "usba", "sw", "lan", "onoff"):
            o.append(f'<rect x="{X(x - sw / 2)}" y="{Z(z + sh / 2)}" width="{sw * s}" height="{sh * s}" rx="2" fill="{hole}" stroke="#222"/>')
        elif kind == "combo":
            o.append(f'<circle cx="{X(x)}" cy="{Z(z)}" r="{11 * s}" fill="{hole}" stroke="#222"/>'
                     f'<circle cx="{X(x)}" cy="{Z(z)}" r="{3.2 * s}" fill="#fff" stroke="#222"/>')
        else:
            o.append(f'<circle cx="{X(x)}" cy="{Z(z)}" r="{sw / 2 * s}" fill="{hole}" stroke="#222"/>')
        lines = lab.rsplit(" ", 1) if kind in ("mini", "mini3") and " " in lab else [lab]
        fs = (6.0 if len(lines[0]) > 7 else 7.0) if kind in ("mini", "mini3") else (7.5 if len(lab) > 9 else 8.5)
        for k, t in enumerate(lines):
            o.append(f'<text x="{X(x)}" y="{Z(z - sh / 2 - 4.5) + k * 9}" font-size="{fs}" text-anchor="middle" fill="{tcol}">{t}</text>')
    o.append(f'<text x="{pad}" y="{h - 8}" font-size="10" fill="#555">v3 (PC, 14.11.2026): positions of the 3D model of panel v7 (model3d/index.html), R141-R143 - '
             f'positions are centres (x from the left seen from behind, z from the bottom). </text>')
    o.append("</svg>")
    return "\n".join(o), w, h


def main():
    os.makedirs(OUT, exist_ok=True)
    text, w, h = svg()
    p = os.path.join(OUT, "rear_panel_v3.svg")
    open(p, "w").write(text)
    try:
        from playwright.sync_api import sync_playwright
        with sync_playwright() as pw:
            b = pw.chromium.launch()
            pg = b.new_page(viewport={"width": int(w), "height": int(h)}, device_scale_factor=2)
            pg.goto("file://" + os.path.abspath(p))
            pg.screenshot(path=p[:-4] + ".png")
            b.close()
    except ImportError:
        print("playwright missing: PNG not written")
    print("| Jack | Board | Zone | Kind | x (rear view) | z | Panel x | Direction |")
    print("|---|---|---|---|---|---|---|---|")
    for b, zone, lab, kind, x, z, d in J:
        if b in ("R2", "panel") and zone in ("CONTROL", "POWER / USB"):
            print(f"| {lab} | {b} | {zone} | {kind} | {x:g} | {z:g} | {W - x:g} | {d} |")


if __name__ == "__main__":
    main()
