MitjaGrecky/Shtuka-druka/(commit log)

2026-10-31 Add SDP v0 board protocol: spec, C header, Python codec with self-test
    Claude-Session: https://claude.ai/code/session_01NJ9VLrgY2mHKQhwcNUndr6
2026-10-31 USB audio interface for an external computer (doc 20); USB-A only for flash drives
    - docs: 20_usb_audio_interface (two USB HS ports on the audio board, 32x16 to PC)
    - decisions R78, R79; rear USB-A for controllers removed
    - 3D model and mockup: rear USB-A removed, USB-C labelled (PC)
    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
2026-10-31 Accept dual-USB audio board, 32x16 channel plan, 96 kHz-ready hardware with 48 kHz default (R82-R84)
    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
2026-10-31 Audio board concept (doc 21): ADC/DAC/preamp selection, clocking, control; SDP front-end messages
    - docs: 21_audio_board; decisions R85-R86 accepted, proposals P49-P52
    - SDP: PREAMP_GAIN, PHANTOM, INPUT_MODE, CLIP (0x3A-0x3D)
    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
2026-10-31 Buttons and navigation research (doc 22); volume and spare ADC channels decided (R87, R88)
    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
2026-10-31 Docs: explain layout v4, v5 button proposals (R89, P53-P55)
    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
2026-10-31 Docs: height filter (R91, P57), Push 2/3 lessons (R92), sketch v5.2
    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
2026-10-31 Docs: panel from scratch, step 1 - list of needed buttons (R95, P58-P59)
    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
2026-10-31 Panel v5: arrows at grid edges, page buttons at knob-row ends, wheel away from crossfader (P64)
    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
2026-10-31 Panel v5: page buttons next to Back, touch strip under pads (R103-R105, P64-P65)
    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
2026-10-31 Panel v7: one grid for the whole panel (P69, P70)
    - Four column bands run the full depth; each wedge block sits over its deck column.
    - Screen window as wide as the pad grid; pad column = scene = screen knob = screen column (28 mm).
    - Side columns mirror each other row for row; three key sizes, 4 mm gutters, no frames.
    - Fold at 300 mm, body depth 460 mm; layout script checks pass (0 problems).
    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
2026-10-31 Accept panel v7 (R107): 3D model and 1:1 templates from the layout file
    - model3d/index.html is now generated from mockup/layout/layout_v7.json
    (build_model3d_v7.py + template); rear panel, internals, battery bay (P71).
    - mockup/make_templates.py draws every part from the same layout; 16 A4 sheets,
    printed rear shelf with jack labels (R73), body 515 x 460 mm.
    - Doc 27: internal fit at 460 mm depth; journal R107, P71.
    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
2026-10-31 Touch screen (R108), battery bay under System (R109), screen module candidate (P72)
    - Waveshare 10.1DP-CAPLCD: touch glass 239 x 147 mm fits the 150 mm slope
    behind the 223 x 141 mm panel window; HDMI from the N100DC-ITX, touch over USB.
    - 3D model and 1:1 templates show the glass outline; doc 27 and journal updated.
    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
2026-11-01 Doc 28: dual-path inputs without a preamp IC, Cirrus Logic Pro converters (P73, P74); factory assembly (R115)
    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
2026-11-01 Accept Cirrus converters, dual-path inputs, control-board phantom (R116-R118); PCB workflow proposal (P75)
    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
2026-11-01 CI: KiCad checks (ERC, DRC, PDF, BOM, pictures, Gerbers) for projects under hardware/
    Adds a minimal test project to prove the pipeline.
    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
    [ci-test.kicad_pcb, ci-test.kicad_sch]
2026-11-01 CI: single-file SVG export; workflow to pack KiCad 10 libraries
    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
2026-11-01 Doc 29: board map draft; drop the library-packing workflow (artifacts are not reachable from the work environment)
    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
2026-11-01 M1 screen knobs module: schematic, placement, project library; enclosure fit check
    - hardware/m1-screen-knobs: generated KiCad project (rev 0.1): 8 encoders with touch,
    104 RGB LEDs on IS31FL3741A, CY8CMBR3108, 3 x 74HC165; 4-layer 224 x 28 mm board,
    all electronics on the bottom. Routing in progress (UNROUTED marker).
    - model3d/fit: box model of the enclosure and internals, collision check, Blender scene builder.
    - CI: DRC with schematic parity and zone refill; unrouted boards keep the report without failing.
    - Docs: 30 (M1 spec), journal P76-P80, board map note. Drop the CI test project.
    Claude-Session: https://claude.ai/code/ses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
    [ci-test.kicad_pcb, ci-test.kicad_sch, m1-screen-knobs.kicad_pcb, m1-screen-knobs.kicad_sch]
2026-11-01 M1: own Specctra session importer (pcbnew's needs the GUI)
    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
2026-11-01 M1: routed board (4 connections left), light guide, 13-dot rings
    - LED matrix remapped: all 9 SW lines run along the board, CS triples stay local
    (n = 13 ring + dot; SW = n mod 9 + 1, CS = 3 (n div 9) + 1..3).
    - Board 224 x 34 mm (R127), LED driver in the rear strip, keep-outs under the encoder
    bodies, encoder footprint with an accurate courtyard, rules in the project file
    (0.12/0.13 mm, vias 0.45/0.2, power 0.3), GND plane on In1 and stitched bottom pour.
    - Freerouting 1.9 integration (xvfb), session importer, local maze finisher;
    4 connections around U1 still open (UNROUTED).
    - Light guide spacer STL (R126) generated with bpy; Blender fit scene imports it.
    - Rings drawn with 13 dot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
    [m1-screen-knobs.kicad_pcb, m1-screen-knobs.kicad_sch, m1_light_guide.stl]
2026-11-04 M1: lock panel-fixed parts, hand-off rules for a layout service, finisher with rip-up option
    The 4 open connections around U1 stay: a CS29 pin swap and local rip-up both made the
    routing worse, so the board is prepared for Quilter instead.
    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
    [m1-screen-knobs.kicad_pcb]
2026-11-06 M1: Quilter job B adds a top-side footprint keep-out
    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
2026-11-06 Fit check on real parts: crossfader, wheel, screen, USB-A pocket variants (doc 32)
    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
2026-11-06 Fit check: real Waveshare screen sizes, USB-A variant C, full-size SD slot
    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
2026-11-06 W1 Levels board: schematic, 2-layer routed board, generators
    Four volume pots read by an ADS1115, two P48 buttons with RGB lights
    (IS31FL3218) on the module shift chain, a window for the M5 Gain module,
    module bus 2x7 to P1 and to M5. Reuses M1's schematic writer and board
    helpers. Local DRC: 0 errors, 0 unconnected.
    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
    [w1-levels.kicad_pcb, w1-levels.kicad_sch]
2026-11-06 W1 Levels: doc 31 and the fit check from W1's design data
    The fit model builds W1 (board with the M5 window, pots, bottom parts,
    bus plugs) and an estimated M5 module from hardware/w1-levels; the whole
    enclosure: 0 collisions, 0 gaps under 1 mm.
    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
2026-11-06 M1: Quilter job C (small parts movable, bottom only) and fixed-vs-movable map
    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
    [make_quilter.py]
2026-11-06 M1 Quilter job C: top strips for small SMD parts, fixed/movable map
    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
    [make_quilter.py]
2026-11-06 M1 Quilter job C: ICs anchor, passives start off-board (Quilter treats parts inside the outline as placed)
    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
2026-11-06 notes: report DRC check and GND island cause for m1-screen-knobs (#1)
2026-11-06 Split decisions log into topic blocks, add document map and archive
    - docs/ru/decisions/: short index with priorities plus nine topic files;
    R/P ids unchanged, rows copied verbatim (tools/split_decisions.py --verify)
    - P97 (M1 mounting) added as a pending proposal
    - docs/ru/README.md: map of all documents with status and current sections
    - docs 05, 07, 17, 26 (superseded panel layouts) moved to docs/ru/archive/
    - CLAUDE.md, README.md, notes/handoff.md point to the new structure
    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
    [split_decisions.py]
2026-11-06 Refresh README and hardware index, point Copilot to the shared rules
    - README: status (panel v7, M1 routing), CI badge, body 515 x 460 mm,
    converters and MCU facts, hardware/notes/CI folders
    - hardware/README.md: table of boards with status and spec links
    - .github/copilot-instructions.md: Copilot follows CLAUDE.md and decisions
    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
2026-11-06 notes: M1 congestion analysis before P98 (#4)
    Gap counts confirmed; gaps have 2-4x spare capacity, the bottleneck is U1 fan-out.
2026-11-06 notes: M1 design review - LED rotation, SW width, decoupling, driver split options
2026-11-06 notes: record user feedback on M1 review (no 90 deg LED rotation)
2026-11-06 docs: M1 review - root cause at the LED driver, design issues, 1/2/4 driver options (doc 33)
    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
2026-11-06 M1: one-ring experiment - generated cathode arcs, 2 vias per LED, DRC clean around the ring
    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
2026-11-06 WIP M1 rev 0.2: two LED driver cells, ring-aligned CS map, rear-strip placement, 8 holes
    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
2026-11-06 M1 rev 0.2: two LED driver cells (P98), generated ring arcs, decoupling at pins, 8 holes, Quilter job D
    - design.py: U1 (rings 1-4, 0x30) and U6 (rings 5-8, 0x31), CS triples stay on their rings,
    bottom parts in the rear strip, HUG list, HOLES (corners + gaps 1, 3, 5, 7)
    - make_pcb.py: hug() puts decoupling caps at their pins (1.1-2.1 mm), ring_arcs() draws the
    cathode arcs and ring vias (2 per LED, locked), LED_SW net class 0.25 mm, arc-aware stitching
    - make_sch.py: U6 and its passives, A1 sheet; parity with the board 750/750 pads
    - make_quilter.py: job D route-only with new bypass and SW current tables
    - pcbnew 7 DRC of the unrouted board: no clearance errors (only unconnected and dan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
    [m1-screen-knobs.kicad_pcb, m1-screen-knobs.kicad_sch]
2026-11-06 M1 rev 0.2: regenerate light guide (8 holes, 104 LED holes) with bpy
    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
    [m1_light_guide.stl]
2026-11-06 Handoff: overnight fallback task for PC if all Quilter jobs fail; chord jobs F/G generator
    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
    [make_quilter.py]
2026-11-07 M1 rev 0.2: Quilter job F candidate 1.1 (97% routed), handoff for DRC on PC
    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
    [m1-screen-knobs.kicad_pcb]
2026-11-07 M1 rev 0.2: check Quilter job F candidate 1.1 on PC, close #5 and #7
    DRC with schematic parity, fixed-part comparison, list of 20 unrouted
    connections, GND zone and layer names restored in a separate copy
    (F_chords_cand1_1_pc), one connection (TR0) closed there.
    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
    [m1-screen-knobs.kicad_pcb]
2026-11-07 M1: screenshots and boards of routing passes 01-07 (Quilter, Freerouting, free placement)
    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
2026-11-07 M1: routing passes 08-12 (one driver diamond 45 deg bottom is best: 37 open), handoff summary
    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
2026-11-07 M1 rev 0.2: Quilter job H inputs (all non-panel parts free, off-board region any side, chords)
    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
2026-11-07 M1: Quilter job I inputs - forbid parts under encoders on B.Cu (job H put U2 under ENC4)
    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
2026-11-07 M1 rev 0.3: diamond LED drivers with scripted locked fan-out, CS map turned to the fan-out, schematic parity (net names, fields, BOM), Quilter job I inputs (parts free, no parts under encoders, In2 k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
    [m1-screen-knobs.kicad_pcb, m1-screen-knobs.kicad_sch]
2026-11-07 M1 rev 0.3: Quilter job I candidate 2.1 (99% routed, 4 unrouted), cloud DRC, PC task #10
    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
    [m1-screen-knobs.kicad_pcb]
2026-11-07 M1: one-driver experiment (M1_ONE_CHIP=1, Quilter job J): one IS31FL3741A diamond at gap 4, fan-out on all sides, CS1-18 right half, CS20-37 left half
    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
2026-11-07 notes: Quilter job J (one driver diamond) started
    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
2026-11-07 M1 rev 0.3: fix Quilter job I candidate 2.1 on PC (fixed.kicad_pcb), close #9 and #10
    Layer names and GND zones restored (bottom GND pour re-created), parity
    nets for unconnected pins, GND stubs at free pads 52-54 removed, In2
    tracks moved out from under the encoders except the TOUCH lines to their
    own frame, A_SW3 and A_CS1 routed. Left open: +5V pin 25 of U1/U6 (no
    room inside the locked fan-out) and A_ADDR to the DNP resistors R4/R5.
    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
    [fixed.kicad_pcb]
2026-11-07 M1 rev 0.3.1 generator: fan-out for +5V pins, implicit unconnected nets (parity), encoder front frame lug unnumbered
    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
    [m1-screen-knobs.kicad_pcb]
2026-11-07 M1: collect best board (Quilter I 2.1 + PC fix) into hardware/m1-screen-knobs/almost
    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
    [m1-screen-knobs.kicad_pcb, m1-screen-knobs.kicad_sch, quilter_I_cand2_1.kicad_pcb]
2026-11-07 M1: Quilter I2 cand 1.1 (two drivers, 99%) and J2 cand 5.1 (one driver, 98%) with KiCad DRC; PC task #11
    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
    [m1-screen-knobs.kicad_pcb]
2026-11-08 M1 rev 0.3.1: fix Quilter I2 candidate 1.1 on PC (fixed.kicad_pcb), close #11
    Layer names and GND zones restored (bottom pour re-created), In2 tracks
    moved out from under the encoders, 31 connections rerouted, +5V at power
    width, GND pin 12 stubs into the exposed pads, dangling stubs removed.
    KiCad 10: 0 DRC errors, 5 unconnected (A_CS4, B_CS4, B_CS7, B_CS9, E7_A),
    parity 0. Router: junction fix no longer moves existing tracks.
    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
    [fixed.kicad_pcb]
2026-11-08 notes: PC task #12, finish I2 1.1 board (5 open nets, GND islands, shorter detours)
    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
2026-11-12 M1 rev 0.4/0.5 generator: one LED driver per ring pair, LP5864 option, board_stats
    - M1_FOUR=1: four IS31FL3741A, matrix local to ring pairs (job K).
    - M1_LP=1: four TI LP5864 (VQFN-32), 12 LEDs per ring, serpentine
    SW/CS map, fan-out for 8-pad sides (job L).
    - tools/board_stats.py: copper length, detour and vias per net family.
    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
2026-11-12 Add K rev0.4 candidates comparison and handoff note
    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
    [m1-screen-knobs.kicad_pcb]
2026-11-12 Add hand-routing package folder for EasyEDA Pro (M1 rev 0.5, W1), packers and docs
    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
    [BOM.csv, BOM_notes.csv, outline.dxf]
2026-11-12 Record EasyEDA Pro import check of M1 (power nets merged) and PC-side task
    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
2026-11-12 Report EasyEDA Pro net check of M1 and W1 (PC side)
    PCB documents match netlist.net in both boards (M1 146/146, W1 35/35).
    Power rails are merged only in the schematic: the three PWR_FLAG symbols
    import as net flags with one shared name, shorting GND, +3V3 and +5V.
2026-11-12 Strip PWR_FLAG from EasyEDA packages (it shorts power rails on import); rebuild M1, W1
    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
    [outline.dxf]
2026-11-12 Report EasyEDA re-import of M1 and W1 without PWR_FLAG (PC side)
    New projects M1_v2 and W1_v2: schematic and PCB nets match netlist.net
    (M1 146/146, W1 35/35 multi-pin nets); power rails stay separate.
2026-11-12 Add spec for remaining digital board schematics (M2-M5, P1, P3, P4, W2, W3) and proposals P99-P105
    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
2026-11-12 Add PC check scripts: DRC/parity summary, Quilter intake, EasyEDA net check
    - tools/pc_check.py: kicad-cli DRC + schematic parity + copper/vias in one table,
    board never modified; --sch-from for Quilter results without a schematic
    - tools/quilter_intake.py: Quilter zips from Downloads into quilter/results,
    md5 de-duplication, then pc_check
    - tools/eda/: one-command check of an EasyEDA Pro project (PCB pads and
    geometric schematic nets) against for-routing netlist.net via the API bridge
    - K_rev04 candidates 1_1 and 2_1 added; #13 (L_rev05 parity 0) closed
    - .gitignore: KiCad lock files, .history, /logs
    [m1-screen-knobs.kicad_pcb]
2026-11-12 Add tools/pc_start.py: start-of-session summary for the PC side
    Pulls, shows branch, recent commits, uncommitted files, open PC tasks from
    notes/handoff.md and the state of kicad-cli, the EasyEDA bridge and markitdown.
2026-11-12 Add nightly PC check (tools/night_check.py) and tools/README.md
    night_check.py: safe pull (ff-only, no local edits), pc_check on boards changed
    since the last run, parity against the matching Quilter inputs; report in
    logs/night/. Runs daily at 03:30 from Windows Task Scheduler on the PC.
    pc_start.py now shows the last night report.
2026-11-12 Add M3 Tempo + Swing board (schematic, placed board, EasyEDA package)
    - hardware/m3-tempo-swing: 2 encoders with 12-LED rings, one LP5864,
    one 74HC165, no touch (P102); ERC 0 errors, netlist 202/202, DRC 0,
    parity 0; imported into EasyEDA Pro as M3_v3, PCB and schematic 38/38
    - hardware/common/gen: shared kit (bus, LP5864, 74HC165, encoder, rings),
    board helpers, netlist checker; m1compat and sym7 let the cloud's
    generators run on the PC (Python 3.11, KiCad 10)
    - pcb_netnums + tools/pack_easyeda.py: KiCad 9/10 boards lose all nets in
    EasyEDA unless nets are numbered as in KiCad 7
    - netlist parsers accept the multi-line KiCad 10 netlist format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
    [BOM.csv, BOM_notes.csv, m3-tempo-swing.kicad_pcb, m3-tempo-swing.kicad_sch, outline.dxf]
2026-11-12 Add M4 FX Mix + Filter and M5 Gain boards (schematic, placed board, EasyEDA package)
    - common/gen: knob_pair() for two-encoder modules, shared schematic and
    board writers, run_board.ps1 to build and check a board on the PC
    - M4 (66 x 34): ERC 0 errors, netlist 202/202, DRC 0, parity 0;
    EasyEDA M4_v1 PCB and schematic 38/38
    - M5 (82 x 34, slope, 11-LED rings + Clip LEDs on one LP5864, P103):
    ERC 0, netlist 202/202, parity 0, EasyEDA M5_v1 38/38; DRC 2 errors:
    Clip 2 sits 0.15 mm from the board edge (open question in handoff)
    [BOM.csv, BOM_notes.csv, m4-fx-filter.kicad_pcb, m4-fx-filter.kicad_sch, m5-gain.kicad_pcb, m5-gain.kicad_sch, outline.dxf]
2026-11-13 Add W2 Meters board (schematic, placed board, EasyEDA package)
    - hardware/w2-meters: 2 x 14 RGB LED level meters on the slope, two LP5864
    (0x40, 0x41), 35 x 126 mm; ERC 0 errors, netlist 204/204
    - common/gen: grid schematic writer for boards without knobs; LP5864 unused
    CS lines left open
    - handoff: question stack for the user; the PC crashes during kicad-cli runs,
    so DRC/parity for W2 is left to CI; BOM.csv rewritten after a crash
    [BOM.csv, BOM_notes.csv, outline.dxf, w2-meters.kicad_pcb, w2-meters.kicad_sch]
2026-11-13 W2: verified in EasyEDA Pro (W2_v1, PCB and schematic 40/40); CI note
    - for-routing/W2: EasyEDA preview, README row
    - handoff: CI fails on Quilter result folders (each holds a .kicad_pro),
    not on the new boards; proposal to exclude */quilter/* in kicad.yml
    - tools/eda/eda_import.py: API import attempt (the beta API creates no
    project yet), kept as a starting point
    [eda_import.py]
2026-11-13 W2 rev 0.1b: each LP5864 under its own meter column
    The two drivers sat between the columns, staggered (U1 high for the left
    column, U2 low for the right), so the lower left LEDs had long diagonal
    links to U1. Now U1 sits under column L and U2 under column R at mid-height
    on the bottom side: two independent identical buses, no crossings.
    Netlist unchanged; EasyEDA W2_v2 PCB and schematic 40/40.
    - pack_easyeda.py --no-cli: rebuild zip, BOM, board.json without kicad-cli
    - eda_check.py retries while just-opened documents are still loading
    [w2-meters.kicad_pcb, w2-meters.kicad_sch]
2026-11-13 Add W3 System board (schematic, placed board, EasyEDA package)
    - hardware/w3-system: Save and Project buttons with 2 RGB each, record
    light at the USB/SD pocket, one LP5864, one 74HC165, J1 to P4; the board
    ends before the full-width pocket, Power button off-board (question V9)
    - EasyEDA W3_v1: PCB and schematic 22/22 against a reference netlist written
    from design.py (pack_easyeda.py --no-cli), no kicad-cli on the PC
    - eda_check.py retries while the board is still loading
    [BOM.csv, BOM_notes.csv, w3-system.kicad_pcb, w3-system.kicad_sch]
2026-11-13 Add P1 Left deck (schematic, placed board, EasyEDA package)
    - hardware/p1-left: 19 buttons with 2 RGB each (P101), two LP5864 on mux
    channel 0, three 74HC165, TCA9546A 0x70 (P99), J1 2x8 to P2 (P100),
    J2/J3 to M3 and W1; chain P1 -> M3 -> W1 -> M5
    - EasyEDA P1_v1: PCB and schematic 83/83, 110/110 parts (reference netlist
    from design.py, no kicad-cli on the PC)
    - common/gen: deck_inputs, i2c_mux, deck_bus; sym7.py converts the needed
    KiCad 10 symbols (TCA9546APW, Conn_02x08) to the KiCad 7 format;
    layout_v7 read through kit.layout_elements()
    [BOM.csv, BOM_notes.csv, p1-left.kicad_pcb, p1-left.kicad_sch]
2026-11-13 Check part numbers against the EasyEDA library; fix the bus header part
    - tools/eda/eda_parts.py: look parts up in EasyEDA Pro's system library
    (LCSC number, package, JLCPCB class) through the API bridge
    - the module bus header C3975190 is the SMD variant (PZ127-2-07-S) while the
    footprint is through-hole: use PZ127-2-07-Z C5372811; deck bus 2x8 C5372812
    (M1 and W1 packages still carry C3975190 - noted for the cloud)
    - new numbers: TCA9546APWR C201653, 4.7u 0805 C1779, 1n 0402 C1523,
    0R C17168, 560R C25126, encoder EC11E1834403 C361165 (COMPONENTS.md,
    lcsc_status.json, kit.py)
    - M3, M4, M5, W2, W3, P1 rebuilt and repacked: no BOM line without a number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
    [BOM.csv, BOM_notes.csv, m3-tempo-swing.kicad_pcb, m3-tempo-swing.kicad_sch, m4-fx-filter.kicad_pcb, m4-fx-filter.kicad_sch, m5-gain.kicad_pcb, m5-gain.kicad_sch]
2026-11-13 handoff #14: kicad-cli work for the PC boards goes to the cloud
    The PC blue-screens on kicad-cli. CI (KiCad 10) shows no ERC errors on
    M3, M4, M5, W2, W3, P1; the cloud reads their DRC reports and completes
    the packages (pdf, dxf, previews) without replacing the verified files.
2026-11-13 CI: skip downloaded Quilter candidates; print full ERC/DRC reports (without unconnected items) into the log
    The kicad-out artifact cannot be fetched from the cloud session (blob storage
    is blocked there), so the reports go into grouped log sections as well.
    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
2026-11-13 CI: print reports without head (the job shell runs with pipefail; exit 141)
    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
2026-11-13 Packages: previews for M3, M4, M5, W2, W3, P1; schematic PDF and outline for W3, P1; through-hole bus header C5372811 in M1, W1
    - previews and outlines come from KiCad 7 rebuilds of the PC boards (gen/make_pcb.py)
    turned into the KiCad 10 geometry (KiCad 9+ flips bottom parts top-bottom);
    every pad checked against the committed KiCad 10 boards
    - zip, BOM and netlist of the six PC boards untouched
    - M1, W1: C3975190 is the SMD variant; W1 design and schematic, packer fallback
    (2x7 C5372811, 2x8 C5372812) changed, packages rebuilt (same parts, nets, places)
    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
    [BOM.csv, BOM_notes.csv, outline.dxf, w1-levels.kicad_sch]
2026-11-13 Add P4 Right deck (schematic, placed board, EasyEDA package)
    - hardware/p4-right: 20 buttons with 2 RGB each, two LP5864, three 74HC165,
    crossfader digitised on the board (ADS1115 0x48, P104), wheel sensor
    AS5600 0x36 under the wheel axis, TCA9546A 0x72, J1 2x8 to P2, J3 to W3,
    J4 reserved for a wheel push switch (question V10)
    - EasyEDA P4_v1: PCB and schematic 84/84, 123/123 parts
    - common/lib/Common.kicad_sym with an AS5600 symbol (none in KiCad's
    library), resolved through m1compat; slide pots centred like connectors
    - LCSC numbers from the EasyEDA library: AS5600 C79815, PTA4543 C17444183
    (crossfader placeholder, P90), JST PH 2-pin C20504437
    - eda_check retries also when the b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
    [BOM.csv, BOM_notes.csv, p4-right.kicad_pcb, p4-right.kicad_sch]
2026-11-13 handoff: #14 done (CI reports of the six PC boards, packages, M1/W1 bus header); PC task #15
    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
    [outline.dxf]
2026-11-13 Add P3 Tracks deck (schematic, placed board with M2 notch, EasyEDA package)
    - hardware/p3-tracks: 21 buttons with 2 RGB each, two LP5864, three
    74HC165, TCA9546A 0x71 (ch1 M2, ch2 M4, ch3 W2), J1 2x8 to P2, J2 to M2,
    J3 to M4, J4 to W2; chain P3 -> M2 -> M4
    - notch for the M2 knob strip open to the right edge (x 43-66, y 16.5-222.5);
    module_pcb draws any polygon outline (D.OUTLINE)
    - EasyEDA P3_v1: PCB and schematic 90/90, 120/120 parts
    [BOM.csv, BOM_notes.csv, p3-tracks.kicad_pcb, p3-tracks.kicad_sch]
2026-11-13 #15: W2 drivers between two LEDs; same bottom-side flip in every KiCad
    - W2 rev 0.1c: each LP5864 sits exactly between LEDs 7 and 8 of its column,
    so the exposed-pad vias are 3.08 mm from the LED pads (were 0.73 mm,
    6 DRC errors); EasyEDA W2_v3 PCB and schematic 40/40
    - boardkit.flip_bottom(): KiCad 9+ flips top-bottom explicitly, KiCad 7
    flips left-right and turns 180 degrees, the same result; KiCad 10 output
    unchanged (P1: all 110 footprints pad for pad)
    - handoff: P3 report, #15 closed
    [w2-meters.kicad_pcb, w2-meters.kicad_sch]
2026-11-13 M2 Levels: 8 knobs, 4 LP5864, touch, 3 x 74HC165; EasyEDA import checked
    Board 24 x 205, 4 layers, 166 parts; drivers in the bands between ring pairs, J1 opposite P3's J2. EasyEDA M2_v2: PCB and schematic 146/146 nets. Grid schematic writer: wider cell for the encoder symbol (pins at +-3 grid joined neighbours).
    [BOM.csv, BOM_notes.csv, m2-levels.kicad_pcb, m2-levels.kicad_sch]
2026-11-13 #16: escape / as {slash} in unconnected net names (P4 ALERT/RDY); P4 regenerated
    [BOM_notes.csv, p4-right.kicad_pcb]
2026-11-13 Clean up: drop old Quilter candidates and M1 routing experiments; rule: one current version in git
    - removed quilter/ (K_rev04, 4 candidates) and M1 quilter results F_chords (2), I_rev03,
    J2_rev031, K_rev04 (2) plus experiments/2026-11-07_routing_passes; all stay in git
    history (last at 55b40b0). Kept: I2_rev031_cand1_1 and almost/ (open task #12)
    - CLAUDE.md: new section on versions (overwrite in place, tags for milestones,
    experiments and candidates local); .gitignore for them
    - handoff: obsolete cloud items #3, #6, #8 closed
    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
    [fixed.kicad_pcb, m1-screen-knobs.kicad_pcb]
2026-11-13 Untrack almost/ (the user's local hand-work copy); ignore hardware/*/almost/
    The folder stays in history (last at 5f71d53). PC task #17 explains how to keep
    the local copy after pulling.
    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
    [m1-screen-knobs.kicad_pcb, m1-screen-knobs.kicad_sch, quilter_I_cand2_1.kicad_pcb]
2026-11-13 P3 rev 0.2: Level knobs on the P3 board (R128), 4 layers, no M2 module
    P3 takes the Level block from m2-levels/gen/design.py (parts and placement shifted by 43.5, 17; cells LA-LD; I2C on mux channel 1; chain P3 -> Level -> M4). Board 67.5 x 258, 276 parts; EasyEDA P3_v2: PCB and schematic 226/226 nets. Standalone M2 package removed. pack_easyeda --no-cli rewrites a netlist it wrote itself from design.py. Decision R128 recorded, V5 closed.
    [BOM.csv, BOM_notes.csv, p3-tracks.kicad_pcb, p3-tracks.kicad_sch]
2026-11-13 boards_extra: M2 is part of P3 now (R128)
2026-11-13 V1, V2: rings from the layout (r = ring/2), M3/M4 rev 0.2, M5 rev 0.2 to x 99, P3 rev 0.3; V9, V10 answered
    kit.ring_r: M3/M4 r 15, M5 and Level r 10.5. M4 widened to x 337-407 (rings reached the edge). M5 84 mm (Clip 2 3 mm from the edge); W1 window left to the cloud (#18). P3: Level rings 10.5, right hole at Level 8 moved to y 223.5. EasyEDA M5_v2, M4_v2, M3_v4 38/38, P3_v3 226/226.
    [m2-levels.kicad_pcb, m2-levels.kicad_sch, m3-tempo-swing.kicad_pcb, m3-tempo-swing.kicad_sch, m4-fx-filter.kicad_pcb, m4-fx-filter.kicad_sch, m5-gain.kicad_pcb, m5-gain.kicad_sch]
2026-11-13 #18 (2), (3): pdf, outline and previews of M3, M4, M5 rev 0.2 and P3 rev 0.3; spec updated to R128-R134
    Previews and outlines from KiCad 7 rebuilds, pad-for-pad equal to the KiCad 10 boards.
    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
    [outline.dxf]
2026-11-13 #18 (1): W1 rev 0.2 - M5 window to x 89.5 (R132), rerouted with Freerouting; report, PC task #19
    DRC (KiCad 7): 0 errors, 0 unconnected, parity 0; check_netlist 141 pins, 0 mismatches.
    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
    [outline.dxf, w1-levels.kicad_pcb, w1-levels.kicad_sch]
2026-11-13 W1: parity with the schematic as KiCad 10 reads it (net names with /, LCSC fields, holes out of BOM)
    CI run 43476720483 listed 127 parity warnings on W1 (also in rev 0.1). Same routing
    (rebuilt from last_route.ses), DRC 0 errors, 0 unconnected.
    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
    [w1-levels.kicad_pcb]
2026-11-13 W1: rest of the KiCad 10 parity warnings (single-pin nets, Note field, holes in BOM as the symbols)
    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
    [w1-levels.kicad_pcb]
2026-11-13 handoff: #18 done (CI 43477566859 green), PC task #19, question V11; W1 package rebuilt with schematic net names
    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
    [outline.dxf]
2026-11-13 #19 (V11 a): encoder courtyard follows the body and pins; M3, M4, M5, P3 regenerated; m2-levels is only the Level block
    Courtyard = F.Fab body 12.1 x 11.7 + 0.25 with tabs at pins and frame lugs (0.3 chamfer at A and C). Polygon courtyard check on the PC: 0 overlaps on M1, M3, M4, M5, P3 (was 16 on P3, 2 on M5). Pads unchanged. m2-levels board files and generators removed (rule: one current version), gen/design.py stays for P3. EasyEDA W1_v3 checked 35/35.
    [m2-levels.kicad_pcb, m2-levels.kicad_sch, m3-tempo-swing.kicad_pcb, m4-fx-filter.kicad_pcb, m5-gain.kicad_pcb, p3-tracks.kicad_pcb]
2026-11-13 EasyEDA packages: net names agree between schematic and board; import notes
    pack_for_routing: power symbols without the power: nickname (EasyEDA named their nets power_+5V), board nets without the / prefix and without unconnected-(...) nets, so EasyEDA's DRC has no Netlist Error (M3 test: 39/39 names). README for-routing: after import run Import Changes from Schematic (EasyEDA gives all parts of one footprint the first value: M3 C4, C6, C7, R3 were wrong) and fix the swapped via size rule. Repacked M3-M5, W1-W3, P1, P3, P4. Tools: eda_exec, PCB DRC/parts readers, routing.py (Freerouting), quilter_inputs.py.
    [eda_exec.py, pack_for_routing.py, quilter_inputs.py, routing.py]
2026-11-13 Doc 34: rear-wall boards research (R1, A1, R2, F1, PW)
    Live replacements for discontinued THAT parts (TI DRV134/135, INA1650, OPA1637, INA1620), differential ADC drive for CS5308P, 48 V phantom per TI PMP40871, MIDI 3.3 V per CA-033, CV with AD5676R, USB-C PD with TPS25730, 19 V for the Mini-ITX (ASRock states a 19 V adapter only), LCSC numbers from the EasyEDA library. Open: line input headroom, CS4308P footprint, output mute type, start order.
2026-11-13 R135-R138; EasyEDA reimport of 9 boards checked; P3 rev 0.4 (LED drivers clear of ring LEDs)
    Decisions: line inputs +24 dBu, DAC CS4308P, output mutes on relays, rear-wall boards start with R2. EasyEDA: all boards but M1 reimported with Import Changes and the via rule fix, verified by the new tools/eda/eda_verify.py (nets, LCSC/values, EasyEDA DRC). P3: U7-U10 centred in the LED-free gap between rings; EasyEDA DRC had their exposed-pad vias touching D48, D72, D96, D120.
    [p3-tracks.kicad_pcb, p3-tracks.kicad_sch]
2026-11-13 R2 control board rev 0.1: schematic (RP2350, USB hub, MIDI, CV/Gate, sync, jacks)
    225 parts, 168 nets; checked pin by pin with the new tools/sch_netcheck.py (no kicad-cli). Shared grid writer: multi-unit symbols placed unit by unit, cells sized from the pins, extra PWR_FLAG nets from design.py. Board follows the rear panel layout.
    [r2-control.kicad_sch]
2026-11-13 R2: no footprint link for the DIN-5 sockets until the board (ERC on CI)
    [r2-control.kicad_sch]
2026-11-14 R2: fix ERC - no lone +3V3 power symbol, PWR_FLAG on UA_VBUS
    The CI ERC report had two errors: the +3V3 power symbol kept without its
    flag was a dangling pin, and USB-A VBUS (fed from the Mini-ITX header)
    had no driver.
    [r2-control.kicad_sch]
2026-11-14 #20: R2 rev 0.2 checked against datasheets; rear jacks; rear panel proposal v1
    - RP2350 per Raspberry Pi's minimal design: AOTA-B201610S3R3 inductor, ABM8-272-T3
    crystal, BOOTSEL button, shared 100 nF of pins 53/54
    - DAC80504 REFDIV high (undivided 2.5 V ref needs VDD >= 5.0 V, else all outputs 0 V);
    CV amps 8.06 (Vdac - 1.25 V) around a buffered REF/2, 80.6k; LCSC C2862796
    - USB2514B: straps to the internal pull-downs (HS_IND/SUSP_IND were tied together),
    CRFILT/PLLFILT 100 nF, VBUS_DET 100k/100k, 12 pF 24 MHz crystal
    - rear panel sketch (tools/rear_panel.py -> docs/ru/img/rear_panel_v1.*), R2 jack table
    - report and questions V12, V13 in notes/handoff.md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
    [r2-control.kicad_sch]
2026-11-14 R139/R140: jack shelf R2b (rev 0.1 schematic), R2 rev 0.3 with a 2x7 comb, rear panel v2
    - hardware/r2b-jacks: MIDI DIN x 6, USB-C PC, USB-A, USB-C PD 5 A (GCT USB4105),
    DC; USB and power go by cable straight to A1, the Mini-ITX and PW
    - R2: jacks and their ESD moved out; MIDI parts stay; 2x7 comb socket to R2b
    - tools/rear_panel.py -> docs/ru/img/rear_panel_v2.*: shelf row at the bottom,
    R2 jacks above; jack table in the R2 README; board map row for R2b
    - sym7: USB_C_Receptacle_USB2.0_16P
    [r2-control.kicad_sch, r2b-jacks.kicad_sch]
2026-11-14 R2 rev 0.3 and R2b rev 0.2 placed (no routing); EasyEDA packages
    - R2b: jacks on the wall edge at the rear panel v2 positions; DIN-5 SDS-50J and
    locking DC Kycon KLDHCX-0202-BC-1 footprints converted from the LCSC library
    (tools/eda/lcsc_fp.py)
    - R2: jacks at panel v2, MCU/hub/headers on the left, channel parts packed on the
    bottom behind their jacks (hardware/common/gen/packer.py), comb socket on a tab
    - MIDI TRS jacks are stereo PJ366ST (same footprint, TN pin = ring); mono jacks on
    AudioJack2_SwitchT so pins and pads agree
    - tools/pcb_geomcheck.py: courtyard/pad/edge check without kicad-cli
    - hardware/for-routing/R2, R2b packages (--no-cli)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
    [BOM.csv, BOM_notes.csv, r2-control.kicad_pcb, r2-control.kicad_sch, r2b-jacks.kicad_pcb, r2b-jacks.kicad_sch]
2026-11-14 R141-R143: rear wall as the 3D model of panel v7; DIN, USB, LAN, DC on nuts; R2 rev 0.4; R2b dropped
    - tools/rear_panel.py v3: positions of model3d/index.html (rear_panel_v3.*)
    - R2: L-shaped Control block outline without the DIN window, 20 jacks at the model
    positions, six JST PH headers for the DIN cables, everything else on the B side
    - MIDI TRS: stereo Hroparts PJ-3920-3A (C707259) from JLC stock; footprint from the
    LCSC library (tools/eda/lcsc_fp.py: slot direction from the hole, round bodies)
    - hardware/r2b-jacks and its package removed (R139 superseded)
    [BOM.csv, BOM_notes.csv, r2-control.kicad_pcb, r2-control.kicad_sch, r2b-jacks.kicad_pcb, r2b-jacks.kicad_sch]
2026-11-14 R144: MIDI Thru in firmware on Out 3 and Out 4 (PIO); panel labels Out/Thru 3, Out/Thru 4
    [r2-control.kicad_pcb, r2-control.kicad_sch]
2026-11-14 R144 refined: Thru is a mode of any MIDI output; no Thru labels on the panel (Out 1-4 again)
    [r2-control.kicad_pcb, r2-control.kicad_sch]
2026-11-14 R145: separate USB-C Power; PW power board rev 0.1 schematic
    - rear wall: second row of Power/USB = DC 12-24V, USB-C Power, On/Off (model,
    renders); USB-C (PC) stays data-only and isolated
    - hardware/pw-power: DC / USB-C PD (TPS25730D, no I2C) / battery via LM74700 ideal
    diodes -> On/Off -> BUS -> 19 V 5 A (LM5176), +5V_PANEL and +5V (TPS54560B),
    +-14 V (LMR33640, one inverting) -> +-12 V (TPS7A4701 / TPS7A3301), +48 V
    (LM5156H + TPS7A4101); values after TI examples, 'check' notes for review
    - sym7: PW symbols; pin type patches (TPS7A4701 second OUT passive, LM5176 VOSNS input)
    - module_sch: PWR_FLAGs three per row left of the parts grid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
    [pw-power.kicad_sch, r2-control.kicad_sch]
2026-11-14 PW: LM5176 VOSNS patched as input in the base symbol LM5175PWP (ERC pin_to_pin)
    [pw-power.kicad_sch]
2026-11-14 #23: PW rev 0.2 checked against the datasheets
    - TPS25730: VIN_3V3 to GND (VBUS-powered only), +47 uF polymer on PPHV
    - LM5176: RMODE to AGND (to VCC disabled hiccup); notes on Rsense, slope, inductor Isat
    - TPS7A3301: thermal pad to GND (was IN), 10 nF FB-OUT, 47 uF out
    - LM5156H: DITHOFF to VCC (dithering off), 100 V FET IRLML0100 (C53658)
    - phantom: boost 48.5 V, LDO 46.1 V (TPS7A4101 input max 50 V, VREF 1.173 V)
    - report with the datasheet table, power budget, questions V14, V15
    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
    [pw-power.kicad_sch]
2026-11-14 R1 audio board rev 0.1 schematic; OPA1637 project symbol; R136 note (CS4308P is current output)
    - hardware/r1-audio: mic/line combo with per-channel phantom, OPA1612 front end and two
    OPA1637 paths (R117), Hi-Z two paths, phono with relay and RIAA, line 1-8 at +24 dBu,
    Main/Aux/RCA outputs on OPA1612 with NO relays (MUTE and R2_OK); every input leaves as
    a differential pair (FS 2 Vrms) for the Cirrus buffers on A1
    - make_lib.py: opa1637(); sym7: R1 symbols
    - cloud task #24: level and value review
    [r1-audio.kicad_sch]
2026-11-14 CI: DRC log groups list every violation type with its count and 3 examples
    A big board (R2: 547 violations) did not fit the 400-line cap, so the errors after
    the first types were lost.
    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
2026-11-14 4-layer boards: minimum hole 0.2 mm and via 0.45 mm as in RULES.md
    boardkit.write_project() took the 2-layer limits for every board, so the 0.2 mm thermal
    vias of the DAC80504 WQFN footprint on R2 (U9, U10) failed DRC (drill_out_of_range).
    The layer count now comes from design.LAYERS; R2, PW, P3 projects rewritten (only the
    two minimum values change).
    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
    [boardkit.py, make_pcb.py, make_sch.py]
2026-11-14 Single-pin net names without the empty pin name (KiCad: unconnected-(REF-PadN))
    R2 J17-J33 jacks have unnamed TN pins: the generator wrote unconnected-(J17--PadTN),
    the schematic unconnected-(J17-PadTN) - 17 parity warnings in CI. boardkit.unconnected_net()
    is used by module_pcb and the M3 generator; the R2 board file renamed in place.
    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
    [r2-control.kicad_pcb]
2026-11-14 R146, R147: INA226 input power monitor on PW (I2C to P2), DC adapter 19-24 V; PW rev 0.3
    [pw-power.kicad_sch]
2026-11-14 R1 rev 0.2: levels and values checked against the datasheets (ADC buffer FS 8 Vrms, computed RIAA, phantom Miller ramp)
    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
    [r1-audio.kicad_sch]
2026-11-14 R1 rev 0.3: -12 dB relay attenuator on the Mic/Line inputs, control connector 2x7 (ATT1/ATT2)
    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
    [r1-audio.kicad_sch]
2026-11-14 A1: plan and pinouts (Cirrus converters, XU316 QF60B, ADuM4166) before the schematic
2026-11-14 #25: R2 rev 0.5 - ATT1/ATT2 to R1, connector 2x7, slow control lines on a 74HC595
    All 30 GPIO of the RP2350A were in use: PH48_1, PH48_2, PHONO, ATT1, ATT2 now come
    from a 74HC595 on the DAC SPI clock and data (latch GPIO 23, /OE GPIO 24 pulled high
    so the lines stay low until the firmware enables them); GPIO 25 is free.
    [BOM.csv, BOM_notes.csv, r2-control.kicad_pcb, r2-control.kicad_sch]
2026-11-14 Review fixes: INA226 on its own 3.3 V (PW rev 0.4), A1 plan uses the Cirrus 1/4 buffer (R1 delivers 8 Vrms)
    [pw-power.kicad_sch]
2026-11-14 R148: M1 rev 0.5 is the single source (KiCad regenerated, generator fixed for KiCad 10); R2 rev 0.6 with 7 x M3 mounting holes
    [m1-screen-knobs.kicad_pcb, m1-screen-knobs.kicad_sch, r2-control.kicad_pcb, r2-control.kicad_sch]
2026-11-14 F1 headphone board rev 0.1 schematic; PW rev 0.5 (+5V on 'to F1'), R1 rev 0.4 (mute header to F1)
    [f1-phones.kicad_sch, pw-power.kicad_sch, r1-audio.kicad_sch]
2026-11-14 A1 digital audio board rev 0.1 schematic: 3 ADC, DAC, 2 xcore.ai, ADuM4166, clocks, supplies; new IC symbols and XU316 footprint
    [a1-digital.kicad_sch]
2026-11-14 A1: no lone +3V3 power symbol (ERC), as on R2
    [a1-digital.kicad_sch]
