MitjaGrecky/Shtuka-druka/(notices)

Notices in the files:
hardware/m1-screen-knobs/quilter/results/I2_rev031_cand1_1/m1-screen-knobs.kicad_pcb:
M1 rev 0.3 CERN-OHL-S-2.0
hardware/m1-screen-knobs/m1-screen-knobs.kicad_pcb:
M1 rev 0.5 CERN-OHL-S-2.0
